alpauna/TritonECU/hardware/scp-rig/README.md

# Phase 0 SCP capture rig

Receive-only J1850 PWM listener for the DLC. **No transmit stage** — the OEM PCM
is live on that bus. See [`../../docs/phase0-rig.md`](../../docs/phase0-rig.md)
for why, and [`../../docs/phase0-capture-protocol.md`](../../docs/phase0-capture-protocol.md)
for what to record.

**Micro: Raspberry Pi Pico (RP2040).** PIO gives deterministic sub-microsecond
edge timing on a ~24 µs bit, it is 3.3 V native so it shares the comparator's
rail with no level shifting, and this repo already runs PIO on an RP2040 in
`hardware/vr-test-rig/firmware`.

**The RX network below is the corrected one** from
[`../../docs/f150-1999-target.md`](../../docs/f150-1999-target.md) §5.3 — not the
upstream reference, which has two known traps (a 10 k : 100 k divider that puts
4.5 V on a 3.6 V input, and a bias resistor returned to 3.3 V instead of ground).
Building the rig with the shipping values means Phase 0 validates the board.

## Schematic

```
  DLC (OBD-II, under dash)                            RASPBERRY PI PICO
  ┌───────────────────────┐                        ┌────────────────────┐
  │ pin 2   SCP+  914 TAN/ORG ──┐                  │                    │
  │ pin 10  SCP−  915 PNK/LT BLU ─┐                │  GP2   RX in       │
  │ pin 4,5 GND ──────────────┐ │ │               │  GP3   loopback    │
  │ pin 16  +12V (variant B)  │ │ │               │  GP0/1 GPS (opt)   │
  └───────────────────────────┼─┼─┼───────────────│  3V3   OUT (pin36) │
                              │ │ │               │  GND               │
                              │ │ │               └────────────────────┘
        SCP+ ────[ R1 100k ]──┼─┼─┴──┬──────────┬─────────► IN+
                              │ │    │          │
                              │ │  [R2 100k]  [D1 MM3Z3V3BW]
                              │ │    │          │
                              │ │   GND        GND
                              │ │
        SCP− ────[ R3 100k ]──┼─┴───────┬──────────┬──────► IN−
                              │         │          │
                              │      [R4 100k]  [D2 MM3Z3V3BW]
                              │         │          │
                              │        GND        GND
                             GND
                                    ┌──────────────────┐
                              IN+ ──┤                  │
                              IN− ──┤    TLV7031       ├── OUT
                              3V3 ──┤  (SOT-23-5)      │
                              GND ──┤                  │
                                    └──────────────────┘
                                             │
              hysteresis  OUT ──[ R5 4.7M ]──┴──► IN+      ≈ ±35 mV

                    OUT ──[ R6 100R ]──┬───────────────────► Pico GP2
                                       │
                                   [D3 SMF3.3]
                                       │
                                      GND

              3V3 ──[ C1 100n ]── GND                 (at the TLV7031)

  BENCH LOOPBACK ONLY — remove before connecting to a vehicle:
        Pico GP3 ──[ R7 1k ]──► the SCP+ node, ahead of R1
        and SCP− ──[ 220k ]──► 3V3     (NOT to GND - see Build order, 2)
```

## Where to connect — DLC, not the 104-pin

The bus is the same net at both ends: EEC-V **pin 16 = SCP+ (914 `TAN/ORG`)** and
**pin 15 = SCP− (915 `PNK/LT BLU`)** are DLC **pins 2 and 10**. Back-probing
C174 would work. **Do not.**

| | DLC | Back-probe at C174 |
|---|---|---|
| Access | designed to be plugged into | behind the kick panel, awkward |
| Ground and 12 V | pins 4/5 and 16, right there | separate wires |
| Terminal risk | none | **a spread terminal causes intermittent faults later** — the worst kind to chase, and you will chase it believing it is your ECU |
| Neighbours | none that matter | **coil and injector drivers**. Pins 78 and 79 are coils 7 and 8 |
| Engine running | fine | coil driver pins carry clamped flyback spikes. Keep probes away from them |

**Both jobs exist and they are different measurements:**

- **Bus capture → the DLC.** It is a bus, not point-to-point, so everything the
  PCM, GEM and cluster say is visible there. Probing at the PCM adds risk and
  shows exactly the same traffic.
- **Pin identification → back-probe at C174.** Which pin sinks the MIL, or
  confirming the TCIL on pin 12 — those are pin-level questions the DLC cannot
  answer. This is the method that already settled pins 12 and 79.

### Check the connector before wiring it

⚠ **Many OBD-II cables and breakouts omit pins 2 and 10.** They are the J1850
PWM pair, and a CAN-era cable has no use for them — cheap ones populate only
4, 5, 6, 14 and 16. A bare connector shell is fine; a moulded cable may simply
not have the terminals. **Check before building anything around it**: continuity
from the pin-2 cavity to its wire, and the same for 10. A missing terminal looks
exactly like a quiet bus.

**Ground: use pin 5, not pin 4.** Pin 5 is *signal* ground and is the correct
reference for a bus measurement; pin 4 is *chassis* ground. If the rig is
powered from pin 16 (variant B), return that current on **pin 4** and keep the
comparator referenced to **pin 5** — otherwise the supply current shares a return
with the signal reference and puts its own drop into what you are measuring.

**Confirm the numbering with a meter before trusting it.** The 16-pin shell is
two rows and the numbering flips depending on which side you are looking at.
Find **+12 V — that is pin 16** — and orient from there. Ten minutes of checking
against an unplugged connector beats debugging a rig that was correct all along.

## Why each part is the value it is

| | | |
|---|--:|---|
| R1–R4 | **100 k : 100 k** | Symmetric 1:1. A 5 V bus HIGH lands at **2.5 V**, inside the TLV7031's V<sub>CC</sub>+0.3 ≈ 3.6 V limit. The reference's 10 k : 100 k puts 4.5 V there **during ordinary reception** |
| R2/R4 return | **to GND** | The reference returns the bias to 3.3 V. Harmless at 10:1, destructive at 1:1 — it pulls half the node |
| D1, D2 | MM3Z3V3BW | 3.3 V clamp, **after** the divider |
| R5 | **4.7 MΩ** | Hysteresis, ≈ ±35 mV against a 2.5 V swing — the bus idles at 0 V differential, so without it the comparator chatters on noise |
| R6 + D3 | 100 Ω + SMF3.3 | Output protection into the Pico |
| Bus loading | **200 kΩ per line** | Genuinely non-invasive — the rig is a voltmeter, not a node |

## Pico pin map

| Pin | Use |
|---|---|
| **GP2** | Comparator output — PIO edge capture |
| **GP3** | Loopback generator. **Set to INPUT whenever connected to a vehicle** |
| GP0 / GP1 | UART0 to the GPS — NMEA in |
| **GP4** | **GPS 1PPS** — the edge that ties GPS time to the capture timebase |
| **GP5** | **GPS ON/OFF** — with a **10 k pull-up to 3V3**. See below |
| **GP6** | **GPS nRESET** — with a **10 k pull-up to 3V3**. See below |
| GP16–19 | SPI0 to the SD card (variant B) |
| GP25 | Onboard LED, frame activity |
| 3V3 (pin 36) | Supplies the TLV7031 |
| GND (pin 38) | **Common with vehicle ground** |

## GPS — use the 1PPS, not the sentence timestamps

**ATGM336H-5NR32** (AT6558R) fits without an adapter: 2.7–3.6 V so it runs off
the Pico's 3V3, NMEA 0183 over UART, <26 mA at 3.3 V, TCXO, built-in LNA and SAW,
and — the part that matters — **1PPS with the rising edge aligned to UTC**
(§1.7).

### Why PPS rather than the NMEA timestamp

An NMEA sentence *describes* a fix that was taken at the second boundary, but it
**arrives late and by a variable amount** — the sentence has to be composed and
then clocked out of a UART. At 9600 baud a burst of sentences takes tens of
milliseconds, and the delay changes with how many satellites are in view.

Timestamping the *sentence arrival* therefore aligns GPS to the capture with an
error of tens to hundreds of milliseconds. At 45 mph that is **up to 10 m of
position error**, and worse, it is error that varies through the recording.

**PPS inverts the problem.** Capture the PPS rising edge with the *same*
microsecond counter used for bus frames, and let the NMEA sentence say only
*which second that edge was*. The sentence can then arrive whenever it likes.
Alignment goes from ~100 ms to **sub-millisecond**, and the drifting component
disappears.

### Practicalities

| | |
|---|---|
| Wiring | UART on GP0/GP1, **PPS on GP4** — treat PPS as another timestamped event and put it in the same log |
| Cold start | **TTFF 32 s**. Power it up a minute before recording, not as the engine starts |
| Antenna | See below. In a truck, on the dash or against the windscreen — a steel roof is a very good GNSS shield |
| Speed | Take it from RMC/VTG (Doppler-derived), not from differencing positions. 2.5 m CEP50 position does not imply poor speed |
| Rate | 1 Hz is plenty — the capture script marks speeds at held points rather than sweeping |

### Antenna — the module supplies the bias, you do not

**Do not inject 3.3 V into the RF path.** Pin **14 `VCC_RF` is an output**, 3.3 V,
made for exactly this — *"+3.3V，可给天线供电"*. It carries the module's antenna
diagnostics with it:

| | |
|---|--:|
| `VCC_RF` | 3.3 V typ |
| Antenna **short** protection | **50 mA** |
| Antenna **open** detection current | **1 mA** |
| Supported antenna gain | **15–30 dB** |

Feeding an external rail up the coax bypasses the short protection *and* defeats
the open/short detection, which is one of the few things that tells you the
antenna fell off the windscreen.

| Antenna | Wiring |
|---|---|
| **Passive patch** | RF_IN (pin 11) and ground. Leave `VCC_RF` unconnected. The module has its own LNA and SAW, and tracks to −162 dBm |
| **Active** | `VCC_RF` → the antenna side of the RF trace through a bias network (RF choke / ferrite, high-Z at 1.6 GHz), with a DC block ahead of RF_IN if the module does not provide one |

⚠ **Check the gain.** 15–30 dB is the supported window. A 40 dB active antenna
can overload the front end, and under 15 dB may read as *open* to the detector.

> **[CONFIRM]** whether RF_IN is internally DC-blocked, and whether the datasheet's
> later pages carry a reference bias network. Pages 1–9 do not.

### Control pins — ON/OFF is a shutdown input, active low

| Pin | Datasheet | Meaning | Wire it |
|--:|---|---|---|
| 5 `ON/OFF` | *模块关断控制，低电平有效* — shutdown control, **active low** | **LOW = shut down**, HIGH = running | **Tie HIGH**, or drive from a GPIO |
| 9 `nRESET` | *模块复位输入，低电平有效* — reset, active low, *不用时悬空* | LOW = reset | Leave floating — the datasheet says so explicitly |

The name reads like a switch; it is really a shutdown line. **LOW turns it off.**

**Do not float `ON/OFF`.** The datasheet says "leave floating when unused" for
`nRESET` and says **nothing of the kind** for `ON/OFF`, whose electrical column
is blank — so there is no documented internal pull-up to rely on. A floating CMOS
input is the classic works-on-the-bench, fails-in-a-truck fault, and here it
fails as "the GPS stopped logging somewhere on the highway".

#### The resistors set the safe state, not the firmware

**GP5 → ON/OFF with a 10 kΩ pull-up to 3V3. GP6 → nRESET with the same.**

A Pico GPIO comes out of reset as an **input with no pull**, so between power-on
and firmware configuring it, anything driven only by the MCU is floating. Strap
the safe state in copper and let the GPIO override it:

| | Resistor holds | GPIO as input | GPIO output LOW |
|---|---|---|---|
| ON/OFF | **HIGH — module runs** | runs | **shuts down** |
| nRESET | HIGH — not in reset | not in reset | **held in reset** |

The module is then alive from the instant it has power, whether or not the Pico
ever boots, and the GPIOs are pure overrides. This is the same discipline as the
DRV8837's `nSLEEP` being pulled **low** so the SCP bus is released before
firmware runs — a rig that holds a bus down or a GPS off while it boots is a rig
that fails in ways nobody thinks to look for.

Drive them **open-drain**: GPIO as input for the idle state, output-low to
assert. Never drive them high — the pull-up already does that, and it keeps the
lines safe if the Pico is removed.

The pin spend still earns itself, but **not for the reason first written here**
— see VBAT below. A commanded shutdown gives a **hot** start, not a cold one.

V<sub>IH</sub> is 0.7 × V<sub>CC</sub> = **2.31 V** at 3.3 V, so the pull-up
drives it with margin.

### VBAT — tied to 3V3, which forfeits warm starts by design

**As built: VBAT (pin 6) to 3V3 with a 100 nF cap.** In spec — the range is
1.5–3.6 V and it draws **8 µA** — and it is the simple, correct choice. It just
has one consequence worth knowing rather than discovering.

VBAT exists to keep the RTC and the ephemeris SRAM alive **when VCC is gone**,
which is what turns a 32 s cold start into a few-second hot one. Tied to the same
rail as VCC, it dies with it:

| Event | VBAT | Result |
|---|---|---|
| **ON/OFF shutdown** (GP5 low) | still powered | RTC + ephemeris retained → **hot start** |
| **Rig power cycle** | dies with VCC | everything lost → **cold start, 32 s** |

> **Correction to the ON/OFF note above.** Commanding a shutdown on GP5 and
> bringing the module back gives a **hot** start, not a cold one, precisely
> because VBAT survives it. To time a genuine 32 s cold TTFF, power-cycle the
> whole rig. The GPIO is still worth having — it is how you get a *fast*
> reacquisition mid-session without losing the fix.

**Is a backup source worth adding?** Probably not here. The capture protocol
already powers the rig up a minute before recording, and 32 s fits inside that.
For reference if it ever matters:

| Backup | Holds the RTC for |
|---|--:|
| CR2032 (220 mAh) | ~3 years |
| 1 F supercap, 3.3 → 1.5 V | ~62 hours |
| 0.1 F supercap | ~6 hours |

A supercap is the tidy version — no battery to replace, and hours of hot-start
capability covers several runs in one day.

### Antenna selection — three numbers to check

Candidate: **Bingfu vehicle waterproof active GPS antenna, SMA male**
([listing](https://www.amazon.com/Bingfu-Waterproof-Navigation-Connector-Tracking/dp/B07R7RC96G)).
Magnetic vehicle mount and waterproof is the right shape for this. Its being
**SMA male** — centre pin, internal-threaded nut — makes the connector check
below decisive rather than academic: the board side must be **standard SMA
female with a centre socket.**

Three numbers decide whether it works with this module, and none of them were
readable from the listing page:

| Check | Against | Wanted |
|---|---|---|
| **Gain** | module supports **15–30 dB** | ≤ 30 dB. These are sold at 28 dB (fine) and at 38 dB (over the window) |
| **Supply voltage** | `VCC_RF` is **3.3 V** | must accept 3.3 V — many automotive GPS antennas are 5 V-only |
| **Current** | short protection trips at **50 mA** | typically 10–20 mA, but confirm |

### ✅ The SMA connector is standard SMA female — checked

**BWSMA-KWE-Z001**, PCB-end right-angle, 0–6000 MHz. Electrically fine for
1.6 GHz GNSS, and **inspected on the bench: hole in the middle**, i.e. a centre
**socket**. Standard SMA female, which mates with the antenna's SMA male centre
pin. ✔

The datasheet's own wording — *"With External Thread and Internal Pin"* — reads
like RP-SMA female (external thread **plus a centre pin**), which would not have
mated: pin against pin. It was describing the contact being *recessed inside the
body*, not a reversed polarity.

> **Worth keeping as a habit rather than a scare.** Connector gender is the
> cheapest thing to verify and among the more annoying to discover late. Looking
> down the barrel takes two seconds; a mismating pair takes a return and a week.

## Powering it

| Source | Logging | Survives cranking? | Ground |
|---|---|---|---|
| Laptop USB | USB serial | n/a — engine off or idling | laptop ↔ vehicle |
| **Truck USB adapter** | **must be SD** — no host, so no serial | ⚠ **no** | second path to vehicle ground |
| **USB power bank** ⭐ | SD | ✅ **yes** | **single reference, through DLC pin 5 only** |
| DLC pin 16 + buck | SD | with holdup | single, if returned on pin 4 |

**The truck's USB adapter is fine for idle, the RPM sweep and the drive — and
wrong for two of the seven capture steps.** Step 1 is *key off → on* and step 2
is *crank*. Anything fed from vehicle 12 V sags during cranking, and a cheap
adapter will brown the Pico out at precisely the moment being recorded. If the
socket is switched rather than always-hot, step 1 cannot be captured at all.

**A USB power bank solves it outright**, and it is the cheapest answer:

- Immune to cranking sag, so the crank frames actually get recorded.
- No second path to vehicle ground — the rig then references the bus **only**
  through DLC pin 5, which is what the comparator wants.
- No mains-adjacent noise from a cheap switching adapter riding on the same 12 V
  the bus lives on.

**Also note: powering from a charger means no USB host, so there is no serial
log.** SD becomes mandatory the moment the laptop goes away. That is variant B's
logging with variant A's simplicity.

Whatever the source, put **bulk plus ceramic decoupling at the Pico** — a few
hundred µF and 100 nF. The rig is a measuring instrument sharing a vehicle with
injectors and coils.

## Logging to SD — yes, and throughput is not the problem

A decoded frame is small, so the card is never the bottleneck:

| Record | Rate at 500 frames/s | 10 min | 1 hour |
|---|--:|--:|--:|
| **Binary**, 8 B µs-timestamp + len + flags + 12 B payload = **22 B** | **10.7 KB/s** | 6.6 MB | 40 MB |
| CSV, ~60 B/line | 29 KB/s | 18 MB | 108 MB |

An SD card over SPI sustains hundreds of KB/s at worst, so there is roughly
**27× headroom**. Log **binary and convert offline** — a four-hour session is
158 MB, and CSV costs 3× that for nothing the converter cannot give back.

### The real risk is stall latency, not bandwidth

Cheap cards pause **100–250 ms** for internal housekeeping — wear levelling, block
erase — and during that pause the writer blocks. Without somewhere to put frames,
they are simply lost, and a dropped frame in the middle of a MIL transition is
the one you needed.

**Fix it with RAM, which the Pico has plenty of** (264 KB). Built and tested —
[`firmware/include/FrameRing.h`](firmware/include/FrameRing.h):

| | |
|---|--:|
| Frames arriving in a 250 ms stall, busy bus | **125** |
| Ring as built, 2048 slots × 24 B | **48 KB** |
| **Occupancy at that worst stall** | **6.1 %** |

The measured number is ~16× smaller than the earlier estimate, which had assumed
a longer stall. The margin stays anyway: it is nearly free on 264 KB, a tired
card can stall longer than its datasheet says, and a bursty bus can exceed 500
frames/s briefly.

Capture writes into the ring from the PIO side; a second loop drains it to the
card. **Count and log ring overflows** — a capture that silently dropped frames
is worse than no capture, because nothing tells you the gap is there. `highWater()`
reports the deepest it ever got, so the sizing is a measurement after the first
session rather than an article of faith.

### Four things that bite on a vehicle

- **Flush on a timer, not just on close.** The key gets cut, the plug gets
  pulled. Sync every second — 10 KB at this rate — and preallocate the file so
  FAT metadata is not being rewritten constantly.
- **DLC pin 16 is permanent 12 V**, unswitched. The rig runs whenever it is
  plugged in. Add a switch, or accept a flat battery.
- **That 12 V is vehicle 12 V**, with everything that implies — so the buck needs
  the same input protection as anything else on this truck: reverse-polarity
  diode and a TVS that stands off above 16 V and clamps below the buck's rating.
  See [`../../docs/harness-protection.md`](../../docs/harness-protection.md).
- **Log GPS time as well as the µs counter.** The µs timer restarts every boot,
  so a multi-session capture has no common timebase without it — and the GPS
  fix is what ties road speed to the frames.

### File naming

One file per session, rotated at a size that stays manageable, named from GPS
date/time when a fix is available and a boot counter when it is not. A directory
of `capture_0007.bin` with no timestamps is a capture you will not be able to
put back in order later.

## Reading the console

Use the helper, not `cat`:

```bash
./tools/read-rig.py            # follow
./tools/read-rig.py -s 20      # 20 seconds and stop
```

`cat /dev/ttyACM0` prints **nothing from a perfectly healthy rig**. The
arduino-pico USB-CDC stack throws away writes until the host asserts DTR, and
`cat` never asserts it. `stty` is worse: it can bounce DTR and reset the board
mid-read. Both look exactly like dead firmware.

The rig prints a report every 5 s *unconditionally*, with no bus activity
required. So if the helper shows nothing, the fault is in `setup()` — not in the
signal you are trying to capture.

## Build order

1. **Assemble RX only.** Confirm with a meter: 2.5 V at IN+ when SCP+ is held at
   5 V on the bench, and that both clamps are the right way round.
2. **Loopback.** Fit R7, tie **SCP− to 3V3 through 220 k**, generate PWM
   patterns on GP3, decode on GP2. *If the decoder cannot read a frame it just
   generated, it will not read the truck.*

   **Not SCP− to GND — that latches the comparator.** Found on the bench
   2026-10-07: one edge, then GP2 stuck at 3.3 V. With the Bus− divider grounded
   IN− is 0 V, and `R5`'s ±35 mV of hysteresis puts the *falling* threshold at
   IN+ < −35 mV — which GP3, swinging IN+ from 0 to 1.64 V, can never reach. The
   first pulse switches the output high and it stays there. The earlier
   8.000/16.000 µs validation jumpered GP3 straight to GP2, so it never went
   through the comparator and could not have caught this.

   220 k sets IN− = 3.3 × 100k / 420k = **0.79 V**, near the middle of the
   0–1.64 V swing: both thresholds clear by ~0.75 V. **The middle matters, not
   just "above zero":** the 1.15 µs front-end RC delays every edge, and only a
   crossing near 50 % delays rising and falling edges equally (RC·ln 2 each) so
   the delays cancel out of a pulse width. An off-centre reference would read
   the 8 µs pulses long or short.

   **Measured with 220 k, 2026-10-07 — PASS.** 2.9 M edges through the
   comparator, clusters balanced to 0.06 %:

   | | expected | measured | error | span |
   |---|---|---|---|---|
   | high | 8.000 µs | **8.058 µs** | +58 ns | 7.625–8.375 µs |
   | low | 16.000 µs | **15.877 µs** | −123 ns | 15.500–16.250 µs |

   8 FIFO overruns in 2.9 M edges (~3 ppm) under the loopback's continuous
   83 k edges/s — far denser than a real bus.

   **The ~90 ns bias is the reference sitting 34 mV under mid-swing**, and the
   model predicts it: with ±35 mV of hysteresis, 0.786 V puts the rising
   crossing at 50.0 % of the swing and the falling one at 45.8 %, which
   through the 1.15 µs RC delays the falling edge ~100 ns more — highs read
   long. Irrelevant to decoding (an 8-vs-16 µs decision with ~4 µs of margin);
   **a known offset for Phase 0 measurements**, so subtract it or use the
   alternative: **200 k sets IN− = 0.825 V, on the midpoint**, predicted within
   a count of 8.000/16.000. Kept at 220 k for the bench as good enough; 200 k
   is the value for the next board revision's `H1` reference.

   *On the truck none of this arises:* the bus idles with Bus− high and Bus+
   low, a large negative differential, so the output falls cleanly.
3. **Remove R7, the `H3` strap and the 220 k. Flash the vehicle image** —
   `pio run -t upload`, the default, which leaves GP3 an input. **Read the rig
   before the DLC:** every report must say `mode=VEHICLE   GP3 input`. The
   loopback image (`-e pico_loopback`) says `mode=LOOPBACK  GP3 DRIVING` and must
   never reach a vehicle. Then plug into the 2003.
4. Capture per [`phase0-capture-protocol.md`](../../docs/phase0-capture-protocol.md).

## BOM

| Ref | Part |
|---|---|
| U1 | Raspberry Pi Pico (RP2040) |
| U2 | TLV7031 comparator, SOT-23-5 — **check the pinout against the datasheet; this drawing labels by function** |
| R1–R4 | 100 kΩ 1 % |
| R5 | 4.7 MΩ |
| R6 | 100 Ω |
| R7 | 1 kΩ — bench only |
| D1, D2 | MM3Z3V3BW |
| D3 | SMF3.3 |
| C1 | 100 nF |
| J1 | OBD-II male connector or breakout — **verify pins 2 and 10 are populated**, see below |
| opt. | **ATGM336H-5NR32** GNSS module (AT6558R) — 2.7–3.6 V, UART NMEA 0183, **1PPS**, <26 mA at 3.3 V |
| opt. | microSD breakout |
| R8, R9 | 10 kΩ — pull-ups on GPS ON/OFF and nRESET |
