alpauna/TritonECU/hardware/fan-controller/README.md

# Enclosure fan controller — ATtiny

A thermostat for the [PSU enclosure](../psu-enclosure) fan. Sensor on the board
on a thermally isolated tongue, setpoint on a pot, and an OLED on a tail showing
the exhaust temperature.

**v1 closed out 2026-10-01** — built, flashed, fused (BOD level 7, 4.2 V typ.) and verified
on the bench: OLED, wake button, setpoint pot, fan switching, and the one- and
two-flash heartbeats all behave as specified. Two items stand before any
re-order: open the M2 holes, and the `Status` LED needs its series resistor
off-board (both under [As built](#as-built)). Next is [v2](#v2--3--and-4-wire-intel-fans).

`Schematic/` carries the EasyEDA schematic,
gerbers and BOM as fabricated: **54.86 × 16.13 mm**, 3 × M2. See
[As built](#as-built) for what differs from the sketch and why. Replaces the ESP32 bench rig in
[`../psu-enclosure/fan-controller`](../psu-enclosure/fan-controller), which
proved the control law and the driver but wants a whole dev board and a USB
cable to do it.

## Schematic

Logic runs on **5 V**, fed in on `H2`. The fan's 12 V never touches this board —
`Q1` only switches its low side out through `H1`.

```
   +5V o--+--[C2 10u]--[C1 100n]--+-- U1 VDD (ATTINY1614-SSN, SOIC-14)
          |                       |
       [R6 6k8]           [R3 NTC 10k B3950]      <- on the isolated tongue
          |                       |
        o 3 RV1 10k               +-- PA3  (pin 13)
        o 1 --+-- PA4 (pin 2)     |
        o 2 --+              [R4 10k 1%]
              |                   |
          [R7 20k]               GND
              |
             GND

   PA7 (pin 5) --[R1 220R]--+-- gate  Q1 AO3400A
                            |
                         [R2 10k]  PULL-UP, not pulldown - see As built
                            |
                           +5V

   H1  1 Load (drain)   2 Flyback   3 GND      D1 1N4148W: drain -> Flyback pin
   H2  GND  +5V  Status(PA6)  Wake(PA2)  UPDI(PA0)  SCL(PB0)  SDA(PB1)
```

`PA5`, `PA1`, `PB2`, `PB3` are deliberately unconnected. `PA5` is the one worth
keeping free — a fan tach input if a 3-wire fan is ever fitted.

### The flyback is opt-in, which is the right call

`D1` is fitted, but its cathode lands on `H1` pin 2 rather than on a supply. Wire
that pin to +12 V and the diode sits across the fan; leave it and it does nothing.

For this fan it does nothing worth having. A 2-wire brushless fan commutates its
windings internally behind its own input capacitor, so switching the supply does
not break inductive current the way a relay coil does. What is left is roughly
0.5 µH of lead inductance at 100 mA — about **2.5 nJ** — turned off over
microseconds by `R1`, into a 30 V part on a 12 V rail. Connect pin 2 if the load
ever becomes a relay, a solenoid or a brushed motor.

## The FET

`Q1` is an **AO3400A**: 30 V, 5.7 A, `Rds(on)` ~30 mΩ specified down to 2.5 V.
At 100 mA it drops 3 mV.

**Do not substitute a 2N7002.** It characterises `Rds(on)` at 10 V and 5 V and
**nothing below**, and `Id` falls from 115 mA to 75 mA at 100 °C — against a
~100 mA fan, in a box that is hot precisely when the fan is needed. `L2N7002LT1G`
is the same part; the leading `L` is Leshan Radio, the manufacturer, not a
logic-level suffix. See [`../2N7002 Driver`](../2N7002%20Driver/README.md).

## As built

The fabricated board differs from the sketch above it in three ways. Two are
improvements; one is a fault.

### ✅ R2 is a pull-up, and the board says why

`R2` 10 kΩ runs from the gate to **+5 V**, so a floating `PA7` — during reset,
during boot, after a watchdog trip — pulls the gate *high* and **runs the fan**.

V1.0 had it to GND, which is the same part in the same place doing the exact
opposite thing, and it would have passed any check that only asked whether a
10 k gate resistor was fitted. The schematic now carries the reason next to the
part:

> *Pull up not pull down — fan runs if something wrong*

That note is worth more than the fix. A pulldown is what a gate resistor
normally is, so without it written down this gets "corrected" back the next time
someone tidies the sheet.

The watchdog is part of the same chain: a hung MCU resets, reset floats `PA7`,
and the pull-up runs the fan.

### ⚠ The M2 mounting holes are 2.00 mm — open them before ordering

EasyEDA's stock `Screw-Hole-M2` footprint drills **2.00 mm**, and an M2 screw
will not pass it:

```
M2 major diameter      1.98 mm
2.00 drill, plated     finishes ~1.90
ISO 273 clearance      2.2 close / 2.4 normal
```

Read 2.00 as the finished size instead and it is 0.02 mm on a 1.98 screw — an
interference fit rather than a clearance hole.

**Open to 2.2 minimum before the order goes out.** Five boards is fifteen holes
to drill by hand otherwise, in a part that is 54 mm long and awkward to clamp.
The [SCP rig](../scp-rig/SCP-schematic-review.md) has the same footprint and the
same problem.

### ⚠ `Status` has no series resistor

`PA6` goes raw to `H2` pin 3 and there is no pad for one. An LED straight onto it
kills the pin or the LED. Put it in the tail or the LED module, and note it on
the silkscreen.

**v2 fixes this: `R12` 1 k sits between `PA6` and `H2` pin 3.**

**The LED is active-low: +5 V → resistor → LED → `Status`.** That is how both
built boards are wired, and the firmware sinks it. Through reset the pin floats,
so the LED is dark rather than lit.

### ✅ No LDO — and that is better

The board takes 5 V in rather than regulating 12 V down. The LDO would have been
the largest heat source on a board whose entire problem is self-heating beside
its own sensor, so removing it helps rather than hurts. The enclosure already has a fixed 5 V rail.

### ✅ AO3400A rather than the SS8050

An SS8050 NPN was the earlier plan, because a BJT is current-driven and the
gate-threshold question disappears. But that was the better answer to a *3.3 V
gate*, not the better part: the BJT needs continuous base current and drops
~0.15 V where the AO3400A drops 0.003 V. `R1` is now a gate resistor rather than
base drive, which is fine — it damps the edge and nothing here switches fast.

### ✅ The thermal tongue is real

Verified in the gerbers rather than assumed:

```
slot 1   x 18.50..19.16   y 0.40..4.54     0.66 x 4.14 mm
tongue         1.64 mm wide, NTC 0805 at x 19.94, y 1.29 / 3.29
slot 2   x 20.80..21.46   y 0.40..4.54
```

Nothing else sits on it — the next components are at y ≥ 6.1, past the slot ends.

One floor that no isolation removes: the NTC dissipates about **0.6 mW**, which
on an 0805 is 0.15–0.3 °C of self-heating. That is inside the thermistor's own
tolerance and not worth chasing, but it is the accuracy limit.

## The sensor is on the board, which decides two things

**The board lives in the exhaust, at END B.** The sensor's position *is* the
board's position. Intake air is room air and says nothing about the supply;
this has to sit where air has already crossed the heatsink.

**The board's own heat biases its own sensor.** An LDO dropping 7 V plus a
transistor plus an MCU is 50–70 mW on a small board, which is several °C of
local rise measured by the part whose job is measuring °C. Two answers, and the
second matters more than the first:

- **A routed thermal slot**, most of the way around `R1`, leaving a narrow neck.
  Free at fab, and it cuts the conduction path so the sensor sees air rather
  than copper. Put `U1` and `Q1` at the far end of the board from it.
- **No regulator.** The as-built board takes 5 V in, which removes what would
  have been the largest standing heat source of the lot.

> **The MCU does not sleep.** Sleeping between readings was the original plan,
> to cut self-heating further. The firmware waits awake instead (~10–15 mW at
> 5 MHz), at the far end of the board from the tongue. For an on/off enclosure
> fan with 6 °C of hysteresis that error does not matter, and in use it has not
> been a problem. Revisit only if this board ever has to measure rather than
> switch.

## Why an NTC and not a DHT22 or a DS18B20

Because **the ATtiny never needs to know what a degree is.** A bang-bang
thermostat only has to know which side of a line it is on, so the thresholds
live in ADC counts and the Beta equation is done here, once, at design time:

| T (°C) | R_ntc | ADC (10-bit) |
|---|---|---|
| 30 | 8037 | 567 |
| **32** | 7379 | **589** ← OFF |
| 35 | 6506 | 620 |
| **38** | 5749 | **650** ← ON |
| 50 | 3588 | 753 |

61 counts of hysteresis, and 10.1 counts/°C — one LSB is 0.10 °C, far finer
than the sensor is accurate. No float, no `log()`, no lookup table: two integer
comparisons on an 8-bit part.

**It is ratiometric, and that is not an accident.** The divider is fed from VCC
and the ADC references VCC, so a sagging rail moves both ends and cancels
exactly. Use VCC as the reference, **not** the internal 1.1 V bandgap — against
a bandgap, every millivolt of rail droop becomes a temperature error.

A 10 k 0805 NTC is about two cents, has almost no thermal mass, and needs no
2 s conversion floor like the DHT22.

## The display pushes the part up, and sits somewhere else

**The sensor wants the exhaust; the display wants your eye line.** Those are not
the same place. The board stays at END B with `R1` in the airstream, and the
OLED goes on a **4-wire I2C tail** to the front panel next to the DC-DC's
screen. 200 mm at 100 kHz is untroubled.

That split is not just ergonomics. At ~15 mA the OLED dissipates more than
everything else on this board combined, and sat next to the thermistor it would
undo the thermal tongue. On a tail, its heat goes to the panel.

**2 KB is not enough for a display.** An ATtiny202 has 2 KB of flash and any
SSD1306 driver with a font spends most of it before your code exists. So the
display forces the part up to an **ATtiny1614** — 16 KB, 2 KB RAM, same UPDI
toolchain, SOIC-14. Without a display the 202 is the right part and this BOM
would not need changing.

> Keeping the 202 is possible if the display is a **TM1637 4-digit** module
> instead: two wires, no font, a driver in a few hundred bytes. Less pleasant to
> read, much smaller to drive.

### The display converts. The control law does not.

Thresholds stay in raw ADC counts. Only the display turns counts into degrees,
through a 16-entry LUT at 5 °C spacing with integer interpolation:

```
  0 C -> 234      35 C -> 620      70 C -> 870
```

**32 bytes of flash, 0.09 °C worst-case interpolation error** — an order of
magnitude below what the thermistor is accurate to, and still no float and no
`log()`. Keeping the conversion on the display side means a presentation bug
cannot reach the thermostat.

### Blank it

The display times out after a few minutes and wakes on the button. An OLED left
showing a static number burns its pixels in, and an always-on 15 mA is 75 mW
that has to leave the box somehow.

## Setpoint pot — compared against the sensor, not converted

`RV1` on PA4 sets the trip temperature. **It is not mapped into degrees and it
is not calibrated.** The pot is simply another divider on the same ADC against
the same reference, so the firmware compares the two readings directly and the
fan trips wherever they cross:

```
    ntc >= pot          -> fan on
    ntc <= pot - HYST   -> fan off
```

No conversion, no constants, no LUT anywhere in the control path. And the
comparison is immune to the supply in a way a mapped setpoint would not be:
**both** dividers are ratiometric off VCC, so a sagging rail moves the sensor
and the setpoint together and the crossing does not shift.

### Wire it as a rheostat, and mind which end the wiper goes to

Specified part: **ALPS RK09K11300DR** — 9 mm vertical, 10 kΩ, taper `1B`
(linear), 280° travel, 3 × Ø1 mm pins on a 10.6 × 7 pattern.

```
   +5V --[R8 6k8]--o 3
                     RV1 10k        terminal 2 is the WIPER (datasheet p.315)
                   o 1 --+-- PA4    tie it to terminal 1, the ADC side
                   o 2 --+
                         |
        GND --[R9 20k]---+
```

Span is **556–763 counts, about 29–51 °C**, and clockwise **raises** the
setpoint. That falls out of feeding R8 into terminal 3 rather than 1: ALPS
increase R(1→2) clockwise, so R(3→2) *decreases* clockwise, the node rises, and
the knob reads the way a knob should.

### ±20 %, and why it does not matter

The pot is ±20 %, so the bottom of the span moves — 26.4 °C on a +20 % part,
31.9 °C on a −20 % one. The **top does not move at all**: at 0 Ω the pot
contributes nothing to the divider, so 51.4 °C is tolerance-free.

**For setting it, this is irrelevant.** You turn the knob watching the display,
not reading the dial — which is the dividend from putting the setpoint through
the same LUT as the measurement. A ±20 % part just shifts where in the travel a
given temperature lands.

It matters in exactly one place: the fault window has to clear 527, not 556.

**A rheostat beats a 3-terminal divider here, and the reason is the failure
mode.** If the wiper contact goes open, the track is still intact, so the
resistance goes to full scale and the node lands at 556 counts — the lowest
setpoint, fan earliest. It degrades *toward cooling by construction*, with
nothing to detect and no firmware involved. A 3-terminal pot would leave the
node floating and the reading anyone's guess.

**Tie the wiper to terminal 3, the ADC side.** On terminal 1 an open wiper
disconnects the node from the supply, it is pulled to ground through R9, reads
0 counts, and is caught by the fault window as a fallback to the compiled
default. Safe — but by detection rather than by construction, which is weaker.

It also spends the whole knob on settings worth having. A divider across the
same resistors would have reached 62 °C, and a third of the travel would have
been setpoints nobody would choose for this box.

**R8 and R9 still earn their place**, because the wiring cannot catch a broken
*lead*: R8 open pulls the node to ground, R9 open pulls it to the rail, and a
missing pot leaves it grounded through R9. All three land near 0 or 1023, so the
window sits at **450–850** — wide enough for a +20 % pot at full travel, and
still nowhere near a real fault. On that fault the firmware falls back to the compiled default rather
than to fan-on — a known-good threshold beats a fan that runs forever — and the
display flags that the pot is being ignored.

### One pot, not two

There is deliberately no second pot for the release point.

**Two independent pots can be set to a state that cannot work** — nothing stops
OFF being placed above ON, and a quarter turn gives you a fan that trips and
immediately releases, or never releases at all.

**And the hysteresis width is a property of the plant, not a preference.** The
thing being controlled is a box of air with a long time constant; a narrow band
only cycles the fan without moving the average temperature. A knob for it is a
control whose sole available use is to make the system worse. It stays fixed at
61 counts, which rides across the range as:

| setpoint | releases at | band |
|---|---|---|
| 30 °C | 24.5 | 5.5 |
| 38 °C | 32.0 | 6.0 |
| 45 °C | 38.3 | 6.7 |
| 60 °C | 50.7 | 9.3 |

A fixed count band widens in degrees as it gets hotter, because the NTC's
counts-per-degree falls. That is the right direction to drift: a higher setpoint
means a hotter box, where you want the fan to run on longer rather than trip
in and out.

**PA5 stays free** — a tach input if a 3-wire fan is ever fitted.

## Fail-safe

Same reasoning as the ESP32 version: this box's airflow depends entirely on this
fan and it holds a warm supply and a mains connection, so *off* is the expensive
way to be wrong.

- `R2` pulls the gate high, so a floating pin runs the fan — covering reset,
  boot, and a watchdog trip
- Boot drives the fan on before anything else, and exercises it for 3 s
- **An open NTC is the dangerous fault and is caught explicitly.** Open the top
  leg and the divider reads ~0 counts, which looks like *very cold* and would
  switch the fan off forever. A short reads ~1023, which looks like very hot and
  fails safe by luck. Only the first one needs catching, and it is.
- Brown-out at **BODLEVEL7: 4.2 V typical, 3.9–4.5 V across parts** (datasheet
  Table 36-10; PlatformIO calls the setting `4.3v`). A sagging rail stops the
  part rather than letting it run the comparison on a bad conversion. The
  4.5 V worst case still leaves 0.25 V under a 5 V rail at −5 %. Fuse byte
  `BODCFG = 0xF4`: level 7, enabled in active mode, **disabled in sleep** —
  which costs nothing, since the firmware never sleeps

What this still **cannot** cover is losing 12 V while the supply runs hot. That
wants a **KSD9700 60 °C normally-open** across `Q1`, which closes when hot
whatever the firmware is doing, including when it is unpowered.

## Silkscreen

**Back — the explanation.** Too long for the front of a 54.86 × 16.13 mm board,
and nothing here is needed while you are wiring:

- **Setpoint range `32–51 °C`**, and it is deliberately *not* the nominal 29–51.
  The top end cannot move — at 0 Ω the pot contributes nothing to the divider —
  but a **−20 % pot bottoms out at 31.9 °C**. Print 29 and one day a board that
  will not turn down that far gets diagnosed as faulty. 32 is true for every
  part that can be fitted.
- **`CW = HOTTER`**, which falls out of R6 feeding pot terminal 3 rather than 1
  and cannot be inferred by looking at the board.
- The pull-up note, mirroring the schematic: *pull up not pull down, fan runs if
  something wrong*.

**Front — what you need with your hands on the connector.** The back is
unreadable once the board is mounted face-up:

```
H1   1 LOAD   2 FLYBACK   3 GND
H2   GND  5V  STATUS  WAKE  UPDI  SCL  SDA
```

`H1` puts a live drain on pin 1 and ground on pin 3. The unlabelled two-pin
headers on [`../2N7002 Driver`](../2N7002%20Driver/README.md) are exactly what
produced a reversed In/GND that took an hour to find, on a board with no 12 V
anywhere near it. This one has.

## The 5 V rail is an interlock — if you wire it that way

The case firmware cannot cover is losing the MCU's power while the supply keeps
running hot. In this enclosure that case can be designed out instead of guarded
against, because **the same 5 V that runs this board can be the 5 V that holds
the 36 V supply on**:

```
mains ─► 5V always-on module ─► latch ─► relay coil ─► mains ─► 36 V PSU
                │                                                   │
                └──────────► THIS BOARD                      DC-DC ─► fixed 5V
```

Lose that rail and the relay drops, the supply dies, and there is nothing left
to cool. No thermal switch required.

**It only works under two conditions, and both are easy to get wrong.**

**1. An ordinary relay, not a bistable latching one.** See the table in
[`../latching-relay`](../latching-relay/README.md#or-use-an-ordinary-5-v-relay):
a latching relay's off position is *stable*, which is its whole appeal — zero
holding current — and it means a 5 V loss leaves the contacts exactly where they
were, with the supply still running. The fail-safe-off behaviour is free on an
ordinary relay and absent on a latching one. **Populating the latching version
silently removes this interlock**, and nothing in that folder currently says so.

**2. This board fed from the ALWAYS-ON module, not the DC-DC's 5 V.** The DC-DC
is fed *from* the 36 V, so its rail can fail while the always-on module keeps
the relay held and the supply running. Feeding this board from the rail that
holds the relay is what ties the two together; feeding it from the DC-DC leaves
the hole open and looks identical on the bench.

**Fit the KSD9700 if either condition is not met** — and fit it anyway if you
want cover for a failed-open `Q1` or a gate stuck low, which no rail interlock
reaches.

## v2 — 3- and 4-wire Intel fans

**Re-laid out and reviewed 2026-10-02 with the ATtiny1616-MNR and serial —
ready to order, not yet built.** Schematic checked pin for pin (`U2`, exposed
pad to GND with four vias into the pour); `H3` pins 8/9 reach `R13`/`R14`. See
[The MCU is an ATtiny1616](#the-mcu-is-an-attiny1616-vqfn-20) and
[`Schematic/ATTINY1616-MNR-Datasheet.pdf`](Schematic/ATTINY1616-MNR-Datasheet.pdf).

`Schematic/` carries the V2 schematic, gerbers
(`FanTempController-Gerber-V2.zip`) and BOM (`FanTempController-BOM-V2.csv`):
**56.26 × 20.45 mm**, 3 × M2 at **2.20 mm** (the v1 hole fixed). Checked on
the copper, not just the symbol: `CN2` pad 1 reaches `Q1`'s drain (Load), pad 2
reaches `H1` pin 2 (FAN+), pad 3 `R8`/`R9`, pad 4 `Q2`'s drain. Both fan-current
paths — `H1`→`CN2` FAN+ and `CN2`→`Q1` Load — are **1.0 mm**, ~2.5 A at a
10 °C rise on 1 oz; the return is the ground pour. The v2 firmware has still
never run on hardware.

The changes are larger than "add a PWM pin".

### The MCU is an ATtiny1616, VQFN-20

**Decided 2026-10-02:** cheaper and smaller than the 1614 in SOIC-14, and the
same part as far as anything here can tell. Same 16 KB / 2 KB, same
peripherals, and the datasheet's Table 5-1 gives **every pin the same
functions** and TCD0 still runs `millis()`. The `attiny1614_v2` environment
builds for `board = ATtiny1616`.

**Its spare pins bought a serial port (2026-10-02).** The PWM moves from PB2
to **PB5**, TCA0 WO2's *alternate* pin (`PORTMUX.CTRLC` bit `TCA02`; the
datasheet confirms it works in the normal 16-bit mode — only `TCA03`–`05` are
split-mode only). That hands USART0 its default pins, **TX on PB2 and RX on
PB3**, with no remapping. See [Serial status](#serial-status).

Pin numbers, v1 against v2:

| signal | port | SOIC-14 (v1) | **VQFN-20** |
|---|---|--:|--:|
| VDD | — | 1 | **4** |
| GND | — | 14 | **3** + exposed pad |
| Wake | PA2 | 12 | **1** |
| NTC | PA3 | 13 | **2** |
| Setpoint | PA4 | 2 | **5** |
| Tach | PA5 | 3 | **6** |
| Status | PA6 | 4 | **7** |
| Fan gate | PA7 | 5 | **8** |
| PWM | PB2 → **PB5** | 7 | **9** |
| Serial TX | PB2 | — | **12** |
| Serial RX | PB3 | — | **11** |
| SDA | PB1 | 8 | **13** |
| SCL | PB0 | 9 | **14** |
| UPDI | PA0 | 10 | **19** |

Unused on VQFN-20: PA1 (20), PB4 (10), PC0–PC3 (15–18).

**The exposed pad goes to GND.** The datasheet's package drawing shows a
1.7 mm pad but does not say where to connect it; ground is the standard
practice for these Microchip QFNs, and it is also the pad that anchors a 3 mm
part mechanically. Give it vias into the pour. The V2 sheet ties it (`U2`
pin 21) to GND.

**Hand assembly is the cost.** 0.4 mm pitch with no visible leads wants a
stencil and hot air, or fab assembly — the SOIC-14 could be done with an iron.
The thermal tongue is unaffected: the MCU sits at the far end of the board
either way.

### Q1 stops being the control element

A 3- or 4-wire fan keeps **+12 V and GND connected permanently**; its own
controller does the speed control. Switching the ground — which is all v1 does —
kills that controller and garbages the tach every time it opens. So `Q1` demotes
from *the* control to a **hard off**, held on whenever a 3/4-wire fan is fitted.

That is a topology change, not an addition, and it is why this is v2.

### The PWM output must be OPEN DRAIN — a second AO3400A

The fan pulls its PWM line up internally, to **3.3 V or 5 V depending on the
fan**, and Intel caps it at **5.25 V**. Drive it push-pull from a 5 V part and a
3.3 V-pull-up fan gets back-fed. The spec says open drain, so the MCU sinks the
line through a small N-FET and never sources it — the high level is always the
fan's own pull-up, inside its own rating by definition. **No pull-up on this
board's side**, ever.

**`Q2` is an AO3400A, the same part as `Q1`** — decided 2026-10-01, one part on
the BOM instead of two. A 2N7002 would have done this job (it sinks a few
milliamps, well inside the region its datasheet characterises), but nothing
about the job needs it:

| | need | AO3400A |
|---|---|---|
| `Vds` | ~13 V when the fan ground floats | 30 V |
| `Vgs(th)` | on from a 5 V pin | 0.65–1.45 V |
| gate charge at 25 kHz | edges ≪ 40 µs period | ~630 pF `Ciss`; 0.14 µs behind 220 Ω |

**It wants a 220 Ω gate resistor (`R10`), like `R1`.** `Ciss` is ~12× a 2N7002's, and
charging it straight from the pin is a current spike every edge, 50 000 times a
second. 220 Ω holds the peak to ~23 mA and still switches in a fraction of a
microsecond.

### `analogWrite()` cannot produce 25 kHz

Intel wants **25 kHz**, 21–28 acceptable. `analogWrite()` uses `PER = 255`:

| f_cpu | PER=255 | PER=199 |
|---|---|---|
| 5 MHz | 19.53 kHz ✗ | **25.000 kHz ✓** |
| 10 MHz | 39.06 kHz ✗ | 50.00 kHz ✗ |
| 20 MHz | 78.13 kHz ✗ | 100.0 kHz ✗ |

8-bit `analogWrite` misses the window at **every** clock — 255 is outside the
usable `PER` range each time:

| f_cpu | usable PER | `analogWrite` |
|---|---|---|
| 5 MHz | 177–237 | 255 ✗ |
| 10 MHz | 356–475 | 255 ✗ |
| 20 MHz | 713–951 | 255 ✗ |

`TCA0.PER = 199` at the existing 5 MHz gives exactly 25.000 kHz with 200 duty
steps — far more resolution than a thermostat can use, and no clock change.

**And no crystal.** The 21–28 kHz window is **±14 % wide**; the ATtiny's
internal oscillator is **±4 % worst case** over 0–70 °C (±2 % relative to its
factory-stored value; datasheet Table 36-12). That puts 25 kHz at
24.0–26.0 kHz, comfortably inside. Worth writing down before someone adds a crystal footprint
"to be safe" to a board with no room for one.

### The spec's fail-safe is already this project's

Intel requires that a fan with **its PWM line undriven runs at full speed**. So
an open-drain buffer that fails open gives 100 % fan, which is the same
behaviour the whole v1 design was built around — and strictly better than the
low-side switch, where the equivalent failure *stops* the fan.

### Tach turns the boot self-test into continuous monitoring

`PA5` was left free for this. Open collector, **2 pulses per revolution**, rated
to 5.25 V so it pulls up to 5 V and feeds a 5 V ATtiny directly. `RPM = pulses/s
× 30`.

v1 exercises the fan for 3 s at boot because *"a controller that has never
proven the fan turns is one that finds out about a seized bearing during the
event it was installed to prevent."* Tach makes that check continuous: commanded
to run and reporting 0 RPM **is** a seized bearing, and the controller can say so
rather than waiting for the temperature to climb.

### Control law: one step per degree, from setpoint to full speed

**Decided 2026-10-01.** v1 is on/off around the setpoint. v2 keeps the same
on and off points and fills the band above the setpoint with speed:

```
  counts  <= setpoint - HYST          Q1 off            fan stopped
  setpoint - HYST .. setpoint         hold last state   (v1's hysteresis, unchanged)
  >= setpoint                         Q1 on, 30 % duty  floor
  each STEP counts above setpoint     +10 % duty
  >= setpoint + 7 x STEP              100 %
```

Eight levels, 30 % to 100 % in 10 % steps. With `STEP = 10` counts that is
**about one step per °C, reaching full speed ~7 °C above the setpoint**.

| | value | why |
|---|---|---|
| `STEP` | 10 counts | ~1.0 °C at 38 °C, ~1.2 °C at 50 °C — the NTC's counts per degree fall as it warms |
| floor | 30 % (`CMP = 60` of `PER = 199`) | most fans will not start below 20–30 %; below it behaviour is undefined |
| per-step hysteresis | 4 counts (~0.4 °C) | step **up** at a boundary, step **down** only 4 counts below it |
| off point | `setpoint - HYST`, 61 counts | v1's band, unchanged — below the floor the fan stops via `Q1`, not 0 % duty |
| kick | 100 % for 300 ms | on every stopped → running transition, then drop to the computed step |

**Still counts, not degrees.** "A degree" is ~10 counts across the pot's
range rather than an exact °C, which keeps the rule that the control law never
touches the display's LUT. A step of 1.0–1.2 °C is well inside what an
enclosure fan cares about.

**Why per-step hysteresis.** ADC noise is a count or two. Without a dead band,
a temperature sitting on a step boundary toggles between two speeds every pass —
audible as the fan hunting. 4 counts is twice the noise and under half a step.

**Why stop on `Q1`, not 0 % duty.** Intel leaves duty below the floor
undefined: some fans stop, some hold minimum speed. Opening `Q1` stops every fan
the same way, and `Q1` was already demoted to the hard off in v2.

**3-wire fans get the on/off half only.** No PWM input, so they run v1's law on
`Q1` and keep the tach monitoring below.

#### Stall detection

Commanded running for 2 s with **zero tach pulses** is a seized or unplugged
fan. Response: force 100 %, show `FAN STALL`, three-flash LED — the same
fail-to-cooling as the sensor fault. Ignored for the 300 ms kick and the first
2 s after it, while the fan spins up.

#### Pin and timer

- **PWM: TCA0 WO2**, single-slope, `PER = 199` at 5 MHz for 25.000 kHz — see
  the table above. On the v2 board's 1616 it is routed to its alternate pin,
  **PB5**, to leave PB2 for serial TX. On the bench 1614, which has no PB5, it
  stays on **PB2** at its default position (Table 5-1, SOIC-14 pin 7). The
  firmware picks by MCU; the compiled 1616 image carries the `TCA02` write and
  the 1614 image does not.
- **TCA0 is free.** This build runs `millis()` on TCD0 (`MILLIS_USE_TIMERD0` in
  the compile flags), so taking TCA0 over does not touch timekeeping. Call
  `takeOverTCA0()` first so `analogWrite()` cannot reconfigure it.
- **Tach: `PA5`**, as reserved, counted by pin interrupt; 2 pulses per
  revolution.
- **Display line 2** gains the duty: `FAN 60%` replaces `FAN ON`.

### Serial status

**v2 prints one line per loop pass, 115200 8N1, on `H3` pin 8 (TX).** Counts
*and* degrees, because the control law runs on counts and tuning wants them:

```
boot fan=4W full_rpm=2400 slow_rpm=900 oled=1
adc=652 t=38.2 set=640 fan=1 duty=40 rpm=1380 stall=0 fault=0 pot=0
```

The boot line carries the detection *evidence* — both RPM readings, not just
the verdict — so a misread fan shows by how much.

- **Transmit only.** RX is wired (`H3` pin 9) but this firmware never reads it.
  Its **internal pull-up** is on, so an unplugged header idles high rather than
  floating noise into the receiver.
- **No external pull-ups.** TX is driven high by the USART between bytes; it
  floats only through reset, costing at most one junk character at power-up.
- **`R13`/`R14`, 1 k in series at the chip.** An adapter plugged into an
  unpowered board would otherwise drive 5 V through PB3's protection diode
  and half-power the MCU; 1 k holds that to ~4 mA, inside the datasheet's
  15 mA for pins at or below 5.5 V. It also turns a TX-to-TX miswire into a
  few milliamps. At 115200 baud the RC is nanoseconds against an 8.7 µs bit.
- **5 V logic**, straight into the FT232 used for UPDI — move one wire.
- **Bench 1614:** TX moves to **PA1** (USART0's alternate pin); its alternate
  RX would be PA2, the wake button, so the receiver is switched off there.

### The board detects its fan from the tach, at boot

**Decided 2026-10-01: auto-detect, no jumper.** Nothing to fit, nothing to set,
and the fan can be swapped without touching the board. It folds into the
self-test that already runs at boot:

```
 1. Q1 on, PWM 100 %, 3 s      (v1's self-test, unchanged)
    count tach pulses over the last 1 s
      none         ->  2-WIRE   done: v1's on/off law
      pulses       ->  record RPM_full, go to 2
 2. PWM 30 %, 2 s
    count pulses over the last 1 s
      RPM < 70 % of RPM_full  ->  4-WIRE   speed steps
      otherwise               ->  3-WIRE   on/off law + stall detection
```

Self-test grows from 3 s to about 5 s, and the OLED shows the result —
`FAN 4W 2400` — so a wrong guess is visible at the first power-up.

**Every misdetection fails toward more cooling**, which is why this is safe to
automate:

| actual | detected as | effect |
|---|---|---|
| 4-wire | 3-wire | on/off at full speed — louder, never hotter |
| 3-wire | 4-wire | PWM line goes nowhere, fan runs full whenever on — same |
| 3/4-wire, **stalled or unplugged at boot** | 2-wire | on/off as v1, **no stall detection** — v1's behaviour, not worse |

The last row is the one real limit: a fan that is dead at power-up cannot be
told from a 2-wire fan. The 2-wire result is the safe default, so it costs the
stall alarm and nothing else.

**Detection runs once per boot and is not stored.** A fan swapped while powered
is picked up at the next power cycle — and with no EEPROM involved there is no
stale setting to clear.

**Hardware: none beyond the tach line.** `PA5` with its internal pull-up
(20–50 kΩ, datasheet Table 36-16 — ample for a tach of a few hundred Hz) reads
an open-collector tach directly; a 2-wire fan leaves it pulled high and pulse-
free, which *is* the 2-wire signature. A footprint for an external 10 k
pull-up is cheap insurance if a fan's tach edges look slow on the scope.
`PA1` and `PB3` stay free.

### Connector and the parts behind it

**Decided 2026-10-01.** The fan plugs straight into the board on the standard
PC fan header, and 12 V comes onto the board to feed it. Designators follow
[`Schematic/FanTempController-Schematic-V2.png`](Schematic/FanTempController-Schematic-V2.png).

```
 CN2 fan, Molex 47053-1000 (4-pin PC fan header, 2.54 mm, fan-keyed ramp)
     1 Load   switched GND - Q1 drain
     2 FAN+   +12V from H1
     3 SENSE  tach: R8 10k pull-up to +5V -> R9 10k series -> PA5 (TACH)
                    at PA5: D2 BZT52C5V1 5.1V zener to GND, C3 1 nF to GND
     4 PWM    Q2 AO3400A drain (open drain); gate <- R10 220R <- PB5,
              R11 10k gate PULL-DOWN

 H1  12 V in, PZ254V-11-02P     1 GND   2 FAN+
 H3  10-pin, PH2.54-1X10P-H25   1 GND  2 +5V  3 Status  4 Wake  5 UPDI
                                6 SCL  7 SDA  8 TX  9 RX  10 GND
 R13 1k, PB2 -> TX              series: limits back-powering and a TX-TX miswire
 R14 1k, PB3 -> RX              same; no pull-ups on either line - see Serial
 D1  1N4148W, Q1 drain -> FAN+, now permanently across the fan
 R12 1k, PA6 -> Status          the LED's series resistor, on board at last
                                (v1's H2 is v2's H3; Status is still pin 3)
```

**CN2 is the Molex 47053-1000, not a generic 2510 header.** The first draft
used an M2510V-04P-N3: same 2.54 mm pitch and 0.64 mm pins, but its datasheet
([`Schematic/M2510V-04P-N3-Datasheet.pdf`](Schematic/M2510V-04P-N3-Datasheet.pdf))
shows one 5.08 mm locking ramp centred on **pin 3**. A 3-pin fan plug sits on
pins 1–3 with its latch over pin 2, so it lands on the ramp instead of over
it. The 47053's ramp is shaped for PC fan plugs, 3- and 4-pin both.

**Pin 1 is the switched ground and pin 2 is +12 V — the fan standard.** The
first draft had them the other way round, which reverse-powers every fan
plugged in. Check this on the footprint as well as the symbol before ordering.

**It takes every fan this board supports.** A 3-pin plug fits pins 1–3 of the
same header, which is what the ramp is shaped for, and a 2-wire fan uses pins
1–2. Detection (above) works out which one is fitted, so there is no jumper and
no second footprint.

**12 V now crosses the board**, which v1 deliberately avoided. It has to: the fan
needs +12 V on pin 2 of a standard header, and running it through the board is
what lets `D1` sit permanently across the fan instead of being opt-in. The fan
current returns through `Q1`, so `H1`'s ground and the 5 V ground are one ground
on this board — tie the 12 V supply's ground to it. Route `FAN+`, `CN2` pin 1
and `Q1` for 2 A; `Q1` is rated 5.7 A.

#### Q2's gate is pulled DOWN — the opposite of Q1, for the same reason

The PWM line is inverted by `Q2`: PB5 high pulls the fan's PWM input low. So a
floating PB5 must leave `Q2` **off**, the line released, and the fan at **full
speed** — which is a gate pull-down. `Q1` gets a pull-up and `Q2` a pull-down,
and both fail to the fan running. Put that on the schematic next to both parts,
or the next tidy-up "corrects" one to match the other.

**That risk is higher now that both are AO3400As.** Two identical FETs, each
with a 220 Ω gate resistor and a 10 k gate resistor, look like a copy-paste —
and the one difference that matters is which rail the 10 k goes to. Label it
on both: *`Q1` pull-UP — fan on if PA7 floats*, *`Q2` pull-DOWN — fan full
speed if PB5 floats*. The V2 sheet carries both: *pull up not pull down* on
`R2`, *pull down, typical low side switch configuration* on `R11`.

#### The tach input is built for a fan ground that floats

**When `Q1` is off, the fan's ground is disconnected and floats up toward
+12 V**, and the tach line becomes the fan electronics' only path back to
ground. A tach wired straight to `PA5` would then drive the pin above the rail,
and the ATtiny allows only **1 mA** of injection above 5.5 V (datasheet
Table 36-1).

- **`R8`, 10 k pull-up at the connector**, holds the line at 5 V in normal
  running.
- **`R9`, 10 k in series into `PA5`**, limits whatever the fan drives in.
- **`D2`, a 5.1 V zener at the pin**, clamps it below the 5.5 V where injection
  starts, so the ATtiny's own clamp diodes never conduct. The series 10 k
  limits the zener to (12.6 − 5.1) / 10 k = **0.75 mA** — trivial for a
  SOD-123 part. At the bottom of its tolerance (4.8 V) it holds a high at
  4.8 V, well above the 3.5 V input-high threshold, and leaks ~10 µA through
  the 20 k path, which costs nothing.
- **`C3`, 1 nF at the pin**, filters edges; with 10 k that is 10 µs, against a tach
  period of milliseconds.
- **`PA5`'s internal pull-up stays off.** With it on, the series 10 k and the
  internal 20–50 k form a divider when the tach pulls low, and the pin can sit
  at 1.7 V — above the 1.5 V low threshold. The external pull-up is on the
  fan's side of the series resistor, so it does not have that problem.

The same floating ground is why **the PWM line is released whenever the fan is
stopped**: with `Q2` on and `Q1` off, `Q2` would offer the fan a ground path
through its PWM input. The firmware releases PWM before it opens `Q1`.

#### Bench path on a v1 board

v1's `H1` already switches the fan's ground through `Q1` — the same topology. A
v1 board with wires bodged to **PB2 (SOIC-14 pin 7)**, **PA5 (pin 3)** and,
for serial, **PA1 (pin 11)**, the
tach network and `Q2` on a scrap of protoboard, and a 4-wire fan on a bench
12 V, runs the v2 firmware before any v2 board exists. That board still has a
1614, so it uses its own environment: `pio run -e attiny1614_v2_bench -t upload`.
Flashing `attiny1614_v2` onto it fails at avrdude's signature check rather than
writing the wrong image.

## Staging: fit two boards, turn the knobs

The setpoint pot turns one board into a stage. Fit a second board with a higher
setpoint and it waits, engaging its own fans only when the first cannot cope —
**no firmware change, same binary, different knob**.

```
stage 1   set 38   releases 32     one fan,  light load
stage 2   set 45   releases 38.3   two more, heavy load
```

**It self-regulates, and that is not luck.** Stage 2's NTC sits downstream of
stage 1's airflow, so once fan 1 runs, stage 2 sees *cooled* air and stays off.
It only trips when the exhaust keeps climbing despite fan 1 — which is the
definition of stage 1 being out of capacity. Two thermostats in the same
airstream measure each other's effect.

### Put stage 2's RELEASE at stage 1's SET point

Not the set points — the release. Each stage should own a distinct regime:

| setpoint | releases | band |
|---|---|---|
| 38 | 32.0 | 6.0 |
| 42 | 35.6 | 6.4 |
| **45** | **38.3** | 6.7 |
| 48 | 40.9 | 7.1 |

With stage 1 at 38, stage 2 belongs at **45** — it hands back exactly where
stage 1 takes over. Put it at 42 and it stays on down to 35.6, *below* where
stage 1 even engages, so three fans run in a regime one could handle. Both
values sit inside the pot's 32–51 span.

The band widens with setpoint (5.8 °C at 36, 7.6 °C at 51) because the NTC's
counts-per-degree falls. The higher stage therefore gets more run-on, which is
the direction you want.

### A second board probably wants no display

Pot and LED are enough on stage 2 — you set it once. **It did hang, and is
fixed.** `oled.begin()` on a bus with no display waits forever — the pull-ups
live on the OLED module, so SDA and SCL float — and the watchdog was armed only
at the end of `setup()`. The second v1 board sat with its fan on and the loop
never running. The firmware now checks both lines for a pull-up and probes
0x3C before touching the display, runs headless if it is absent, and arms the
watchdog straight after turning the fan on. Verified on that board 2026-10-01.
Nothing else differs: same firmware, same BOM minus the display and its tail.

Electrically there is room. `Q1` is rated 5.7 A; stage 2 driving two 100 mA fans
is 200 mA.

## Tune the thresholds before you build this

650/589 come from the Beta equation, not from the box. Run the ESP32 rig in the
assembled enclosure first, watch what the exhaust actually idles at under load,
and set these from that. If idle sits at 35 °C the fan will never stop, and the
thresholds should move rather than the box run hot.

On v1 that was the trade for the small board: no serial, no telemetry. `LED1`
gives heartbeat, fan state and sensor fault, which is enough to *diagnose* but
not enough to *tune*. **v2 has [serial status](#serial-status)** — tune from
that.

## Status LED

Flashed briefly once a second, so it is a heartbeat rather than a load — always
low duty, negligible dissipation next to the sensor. Wired active-low, from +5 V
into `Status` (see As built); a firmware older than this note drove it
active-high, and the LED then sat lit with brief dark blinks.

| pattern | meaning |
|---|---|
| one flash / s | alive, fan off |
| two flashes / s | alive, fan running |
| three fast flashes | sensor fault, fan forced on |
| dark | not running — check 5 V |
