alpauna/TritonECU/hardware/oil-pressure/README.md

# Oil pressure board — reconstruction of V 1.0

**AMPED Oil Pressure V 1.0**, alshowto.com. JLC panel `5363411A_Y1`, date code
**230106** — the boards were made January 2023. The design files are gone, so
this is being rebuilt from the physical boards.

Purpose: replace the truck's oil pressure *switch* with a real pressure sender,
show the reading on an LCD, **and keep the original dash lamp working** — lamp on
below 12 psi, the stock default.

> **Status: partial.** Everything below is marked ⬤ confirmed or ○ inferred.
> Nothing here has been verified by continuity yet.

## Identified so far

| Ref | Part | How |
|---|---|---|
| ⬤ U1 | **ATtiny85-20SU**, SOIC-8, lot 2233 (week 33, 2022) | Top marking: ATMEL / TINY85 / 20U |
| ⬤ Q1 | **KIA2803A** — N-ch MOSFET, 30 V, 150 A, 2.2 mΩ, TO-263 | Datasheet read |
| ⬤ R1 | **10 MΩ**, gate pull-down for Q1 | Marking `01F` (EIA-96), confirmed by the builder |
| ⬤ R2 | **1.2 kΩ**, gate series to Q1 | Marking `122`; role by elimination once R3 was placed |
| ⬤ R3 | **1.2 kΩ**, series into the ADC from `Sensor` | Builder |
| ⬤ D1 | **A TVS on the 12 V input — value not recorded.** Removed from the board | Builder |
| ⬤ D2 | **A 5 V clamp protecting the ADC node**, on the R3 / `Sensor` side. Removed from the board | Builder |
| ⬤ Sender | **100 PSI, 0.5–4.5 V ratiometric transducer** (what it was tested with) | Builder |
| ○ U2 | A 78xx regulator, DPAK | Marking legibly starts `78…`, rest degraded |
| ⬤ C1, C3 | **7.9 µF in-circuit** — almost certainly 10 µF MLCCs; regulator input and output | Meter |
| ⬤ C2 | **100 nF** — the ADC filter at the `Sensor` node | Meter |

> ⚠ **D1 and D2 are off the board as it sits.** It currently has *no* input
> transient protection and *no* ADC clamp. Fine on a bench supply; do not put it
> back in a vehicle in this state.

## Connectors, from the silkscreen

| Ref | Type | Pins |
|---|---|---|
| ⬤ **J1** | 2×3 | `12+`, `Sensor`, `GND` / `Dash`, `5v` (one unlabelled) — the vehicle harness |
| ⬤ **J2** | 2×3 | `GND`, `5v` marked — the footprint and labels say **AVR ISP** |
| ○ **J3** | 1×4 | Almost certainly the I²C LCD: GND / VCC / SDA / SCL |

`5v` appearing on the *vehicle* connector means the sender is powered from the
board — so a **3-wire ratiometric sender** (0.5–4.5 V), not a resistive one.

## Reconstruction

```
   J1 12+ ──┬──[ D1 TVS ]── GND
            └── U2 (78xx) IN     OUT ──┬── 5V ── U1 VCC, J2, J3, and J1 5v
               C1 ──┴── GND          C3 ──┴── GND        (the sender's supply)

   J1 Sensor ──[ R3 1k2 ]──┬── U1 ADC (PB3 or PB4)
                           ├──[ D2 5V clamp ]── GND
                           └──[ C2 ? ]── GND

   U1 PB? ──[ R2 1k2 ]──┬── GATE  Q1 KIA2803A ── DRAIN ── J1 Dash
                R1 10M ──┴── GND                 SOURCE ── GND

   U1 PB0/PB2 (USI) ── J3 SDA/SCL
```

## The sender path, in numbers

100 PSI over 0.5–4.5 V, read against V<sub>CC</sub> as the ADC reference:

| PSI | Volts | ADC count |
|--:|--:|--:|
| 0 | 0.50 | 102 |
| **12** (the lamp threshold) | **0.98** | **201** |
| 50 | 2.50 | 512 |
| 100 | 4.50 | 921 |

**0.122 PSI per count** — resolution is nowhere near the limiting factor. R3's
1.2 kΩ source impedance is well inside the AVR ADC's 10 kΩ guidance.

**Ratiometric is doing more work than it looks.** The transducer is fed from the
same 5 V that is the ADC reference, so regulator error cancels in the ratio —
*including while the 78xx is in dropout during cranking*, since the sensor and
the reference sag together. The reading stays honest right down to the MCU's
brown-out threshold. That is the single best decision in this design.

**D2's headroom was the flaw in that path — and it was seen on the bench.** The
clamp got in the way and **skewed the high-pressure readings**, which is why it
is off the board. The arithmetic says the same thing: the signal legitimately
reaches 4.50 V and the clamp sits at 5 V.

| | |
|---|--:|
| Signal maximum | 4.50 V |
| A 5.1 V ±5 % zener, worst case | **4.85 V** |
| Margin | **0.35 V**, into a soft knee |

10 µA of leakage at full scale costs 12 mV across R3 — 0.3 PSI, reading *low* at
high pressure, and climbing with temperature.

### Replacing it

The pin is bare now, which is fine on a bench transducer and not fine in a
vehicle, where the sender wire can find battery. Options, against a 35 V fault:

| Clamp | R3 | Error at full scale | 35 V fault current | |
|---|--:|--:|--:|---|
| 5.1 V zener | 1k2 | **12 mV — 0.30 PSI** | 24.9 mA | what was fitted, and what skewed the readings |
| 5.6 V zener | 1k2 | 1.2 mV — 0.03 PSI | 24.5 mA | knee moved clear, but there is still a knee |
| **BAT54S to the rails** | **10k** | **0.5 mV — 0.01 PSI** | **3.0 mA** | Schottky reverse-biased 0.5 V at full scale; no knee to sit on |
| **Internal clamps only** | **47k** | **0** | **0.63 mA** | no part at all — R3 alone limits pin injection |

⚠ **Rail clamping has a catch worth knowing**: a fault pushes current *into* the
5 V rail, and a 78xx cannot sink. At R3 = 1k2 that is 25 mA, which would drag
the rail up and take the ATtiny with it. At 10k it is 3 mA, comfortably absorbed
by the ATtiny's own ~5 mA draw. **So the clamp and the resistor have to be
chosen together** — fitting a BAT54S while leaving R3 at 1.2 kΩ would be worse
than no clamp at all.

Either of the bottom two rows wants **C2 = 100 nF** at the pin: the cap feeds the
ADC's sample-and-hold, so the 10 kΩ guidance on source impedance stops applying
and a 10k or 47k series resistor is fine. τ is 1–4.7 ms, which for oil pressure
is instant.

## Still to establish

1. **The regulator's full marking** — which 78xx, and its absolute maximum,
   which is what sets D1's clamping ceiling.
2. **C1's voltage rating** — the value is now known, the rating is not, and on
   the input side that is the number that matters.
3. **Reverse polarity** — a TVS does not protect against it. Is there a series
   diode anywhere, or was the harness simply trusted?
4. Continuity: U1 pins → J2 (confirms ISP and the part's orientation); U1 pin →
   Q1 gate; U1 pin → sender divider; J3 → U1; `12+` → regulator input, and what
   is in between; Q1 drain → `Dash`, source → GND.

## The capacitors

C1 and C3 read **7.9 µF** in circuit, which is what a 10 µF MLCC measures on a
typical meter once tolerance, test conditions and ageing are accounted for. C2
is **100 nF**, sitting at the ADC node — which happens to be exactly what the
replacement clamp options want, so that part of the re-spin is already fitted.

With C2 at 100 nF the sender filter is:

| R3 | τ | Corner |
|--:|--:|--:|
| 1k2 (as built) | 0.12 ms | 1326 Hz |
| 10k | 1.0 ms | 159 Hz |
| 47k | 4.7 ms | 34 Hz |

All three are instant against oil pressure. The higher two also do useful noise
rejection in an engine bay, which the 1.3 kHz corner does not.

### Two things the value does not tell us

**C1's voltage rating matters more than its value.** A 10 µF X5R 0805 rated 16 V
loses 60–80 % of its capacitance at 12 V bias, so C1 may be **2–4 µF in service**
even though it measures 7.9 at zero bias on the bench. On a 12 V automotive net
the part wants a **50 V** rating — for the derating as much as for the survival.

**There is no cold-crank ride-through, and capacitance cannot buy it.** At a
30 mA load with 3 V of allowed droop, 10 µF holds the input up for **1 ms**:

| Dip | Capacitance needed |
|--:|--:|
| 10 ms | 100 µF |
| 100 ms | 1 000 µF |
| 400 ms | 4 000 µF |

A 7805 needs ~7 V in, and cranking dips last tens to hundreds of milliseconds, so
this is not a capacitor problem. The two real answers are a **wide-input buck**
that keeps regulating down to 6 V, or **accept the reset and stop letting the
lamp depend on the MCU** — which is the High finding below, reached from a
different direction.

## The stock circuit is inverted — correcting an earlier finding

`docs/1999-Ford-F150-4wd-5.42v/InstramentCluster2.png` settles how this circuit
actually works on this truck, and it is the opposite of what the audit below
originally assumed:

> **ENGINE OIL PRESSURE SWITCH — "CLOSED WITH NORMAL OIL PRESSURE"**, circuit
> **31 WH/RD**, C101 → C120M/F → C158M/F → **instrument cluster C236 pin 20**,
> into the cluster's microprocessor. The sheet's own note: *"Closes with normal
> oil pressure, causing a gauge reading of NORMAL. With low oil pressure, switch
> opens and causes a LOW gauge reading."*

Three consequences, and they run through everything else here:

1. **The switch never reaches the PCM.** It is a cluster input. That is why the
   board's `Dash` pin works at all — it intercepts a sender-to-cluster wire, not
   anything the PCM owns.
2. **Grounded means NORMAL — confirmed by the builder as well as the sheet.**
   Q1 is **on** while pressure is fine and **off** to warn. Note this is the
   opposite of the board's original design intent, which was "ground the line to
   turn the light on" — that is the *lamp*-type circuit Ford used on other
   trucks, not the gauge-type cluster in this one. The polarity is a one-line
   firmware flip, and the symptom of having it backwards is an indicator that is
   simply always wrong.
3. **Ford already made it fail-safe.** An open wire, a dead board, a FET that
   never turns on — all read LOW. **The audit's High finding is withdrawn**: a
   hung ATtiny releases the line through R1's gate pull-down and the cluster
   shows LOW, which is the correct, loud direction.

### What the watchdog is actually for now

Not "light the lamp when the ECU dies" — the pull-down does that by itself. The
remaining hole is narrower and real: **an MCU that hangs with its output stuck
HIGH** holds the line grounded and reports NORMAL forever.

So the heartbeat circuit inverts too. Instead of a second FET asserting the lamp,
it **shunts Q1's gate to ground** when the heartbeat stops:

```
   HOLD node ──[10k]── b  Q_a (NPN)   c ──┬──[100k]── +5V
                          e ── GND        │
                                          └──[10k]── b  Q_b (NPN)
                                                        e ── GND
                                                        c ── Q1 GATE
```

Heartbeat alive → Q<sub>a</sub> on → Q<sub>b</sub>'s base held low → gate free,
the ECU drives it. Heartbeat stops → the hold node decays → Q<sub>a</sub> off →
the pull-up turns Q<sub>b</sub> on → **Q1's gate is shunted to ground**, the line
is released, the cluster reads LOW. One transistor more than the original
sketch, and it now covers the only failure the pull-down does not.

The pump sizing from that section is unchanged: 220 nF at 100 Hz, 150k bleed,
1 µF hold, 276 ms timeout.

> **The O/D OFF lamp needs this same question asked before its plan is trusted.**
> `docs/dash-indicators.md` assumes a discrete, ground-to-illuminate lamp. These
> cluster sheets show the cluster's only PCM connection is **SCP**, and the MIL
> lives *inside* the cluster with no wire to it. If O/D OFF is the same, there is
> no wire for a watchdog to grab and the whole approach there changes.

## Folding it into the ECU

The plan is to move this function into the ESP32 ECU and let config decide
whether a **switch** or a **sender** is fitted. Reading the ECU's existing code,
almost none of that needs new firmware — `SensorDescriptor`, `FaultRule` and
`CustomPin`/`OutputRule` already express it.

### Sender mode

| Field | Value | Why |
|---|---|---|
| `sourceType` | `SRC_MCP3204` | **0–5 V native**, 12-bit, on SPI — so a 4.5 V signal needs no divider, and it sidesteps the ESP32's ADC2/WiFi conflict entirely |
| `calType` | `CAL_LINEAR` | `calA`/`calB` = 0.5 / 4.5 V, `calC`/`calD` = 0 / 100 PSI. That *is* a ratiometric transducer, exactly |
| `unit` | `"PSI"` | already an example in the header |
| `emaAlpha`, `avgSamples` | ~0.2, 4 | the filtering C2 used to do in hardware |
| `errorMin` / `errorMax` | **−5 / 105 PSI** (built) | **the feature the old board never had**: a healthy transducer never leaves 0.5–4.5 V, so anything outside reads as an impossible pressure and is a *wiring fault*, not 0 PSI. A broken sender wire on V1.0 looks exactly like no oil pressure |
| `faultBit`, `faultAction` | → `FAULT_ACT_CEL` | |
| `activeStates` | see below | |

#### The plausibility band, as built

`configureOilPressure()` sets the limits from `maxPsi`, so they scale with the
transducer: **±5 % of full scale**, which is ±0.2 V either side of the sensor's
own 0.5–4.5 V range.

| Condition | Volts | PSI | |
|---|--:|--:|---|
| Sender wire open | 0.00 | −12.5 | **sensor fault** |
| Shorted to ground | 0.05 | −11.2 | **sensor fault** |
| `errorMin` | 0.30 | **−5.0** | |
| Bottom of range | 0.50 | 0.0 | plausible |
| 12 PSI threshold | 0.98 | 12.0 | plausible |
| Top of range | 4.50 | 100.0 | plausible |
| `errorMax` | 4.70 | **105.0** | |
| Shorted to 5 V | 5.00 | 112.5 | **sensor fault** |

**Two faults with different consequences**, which is the point of separating
them:

| | Raises | Action |
|---|---|---|
| Implausible reading | the **descriptor's** fault | **CEL steady, no limp** — a wiring fault is not an engine fault |
| Genuinely low pressure | the **OIL_LOW rule** | CEL steady **+ limp mode** |

And **a rule never fires on a sensor that is already `inError`**. Without that,
a broken sender reading −12.5 PSI would trip OIL_LOW and put the engine in limp
mode — blaming the engine for a wiring fault and hiding the real cause.

Two supporting changes were needed to make the limits mean anything: the
descriptor's `faultBit`/`faultAction` were persisted and editable but **never
consumed**, so plausibility raised nothing; and the oil descriptor's action moved
from `LIMP` to `CEL`.

The dash output needs no change — with a broken sender the reading fails the
`ORULE_GT 12` test, so the line is released and the cluster reads LOW, which is
exactly right.

### Switch mode

The same slot, two fields changed: `sourceType` = `SRC_GPIO_DIGITAL` (or
`SRC_EXPANDER`), `calType` = `CAL_NONE`. Value becomes 0/1, and switch polarity
is handled by picking `OP_LT` vs `OP_GT` in the rule — no invert flag needed.

**So "switch or sender" is two fields in one sensor slot, not a firmware branch.**

### The dash output — and it is inverted

Because grounded means NORMAL, the ECU's output is **asserted when everything is
fine**, not when it is wrong. In `OutputRule` terms that inversion is free: pick
`ORULE_GT` with `thresholdA` = 12 instead of `ORULE_LT`, so the rule activates —
and the line is grounded — while pressure is *above* the threshold.

Three things follow, and all of them are the behaviour you want:

- **A sensor fault releases the line.** `errorMin`/`errorMax` firing means the
  rule cannot be satisfied, the output drops, and the cluster reads LOW. An open
  sender wire, a shorted one, or a reading outside 0.5–4.5 V all warn.
- **The prove-out is free.** From key-on until the ECU has booted, read the
  sender and satisfied the rule, nothing grounds the line — so the cluster reads
  LOW, exactly as it does on a stock truck with the engine not yet running.
- **`requireRunning` is not needed for the indicator.** Oil pressure genuinely is
  low before the engine starts, and the stock display says so. Let it.

Keep a separate `FaultRule` with `debounceMs` ≈ 2000 and `requireRunning` = true
for the *logged* fault, so a hot idle dipping briefly does not fill the log.

### Two things that are not free

**1. Ratiometric cancellation is a hardware requirement, not a config one.**
`MCP3204Reader::begin(spi, cs, vRef = 5.0f)` scales against a *number*. The
cancellation only actually happens if the chip's **VREF pin is tied to the same
5 V that feeds the transducer** — then a sagging rail moves signal and reference
together and the ratio holds, which is the property that keeps the reading honest
through cranking. Wire VREF to a separate precision reference and you lose it
silently: the number still looks plausible, it is just wrong whenever the rail
moves.

**2. The fail-silent problem gets *worse*, not better.** On the old board a hung
ATtiny meant no lamp. In the ECU the lamp now depends on a far larger system —
WiFi, SD, the web server — any of which can wedge the thing that is supposed to
warn you about oil pressure. Moving the function in does not fix the High finding
below; it raises the stakes on it.

### The heartbeat-gated lamp

**Adopted.** The lamp is held *off* by a diode pump that the ECU has to keep
feeding. Stop feeding it — hang, crash, reset, brown-out, watchdog loop — and the
lamp lights itself. The failure inverts from silent to loud, for about eight
parts.

```
  ECU GPIO ──[C_pump 220n]──┬──|<|── +5V        (D_a, returns the pump)
           100 Hz square    │
                            └──|>|──┬── HOLD ──[R_base 10k]── b  Q_h (MMBT3904)
                              (D_b) │                             e ── GND
                        C_hold 1u ──┤                             c ──┐
                        R_bleed150k─┘                                 │
                                                                      │
              +5V ──[R_pu 100k]──┬─────────────────────────────────────┘
                                 │
                                 └── GATE  Q_wd ── DRAIN ──┬── J1 Dash
                                          SOURCE ── GND    │
       ECU "pressure low" ── GATE  Q_lamp ── DRAIN ────────┘
                                   SOURCE ── GND
```

Two low-side FETs with their drains tied together are a **wired-OR**: the lamp
lights if *either* the ECU asks for it, or the watchdog gives up on the ECU.

**Sizing**, at 100 Hz with BAT54 Schottkys (hold node charges to 4.4 V):

| | | |
|---|--:|---|
| Pump current, C<sub>pump</sub> 220 nF | 97 µA | |
| Bleed current, R<sub>bleed</sub> 150k | 29 µA | **3.3× margin** — comfortable |
| Timeout, C<sub>hold</sub> 1 µF into an NPN's 0.7 V | **276 ms** | lamp lights this long after the last pulse |

Slower heartbeats want a bigger pump or a weaker bleed: 50 Hz with 100 nF into
150k gives **0.7×** and never holds the node up at all. 470k moves the timeout to
864 ms with 10× margin if a longer fuse is preferred.

**Why a pump rather than a 555 or a monostable:** a hung MCU usually leaves its
pin *static*, and a static pin — high or low — transfers no charge. The pump
therefore fails safe on a stuck output as well as a stopped one, which a level-
triggered design does not. Every other failure it sees goes the same way: if
C<sub>pump</sub> opens, Q<sub>h</sub> dies, or the 5 V rail sags, the pull-up
raises Q<sub>wd</sub>'s gate and the lamp comes **on**.

**It gives the bulb check back for free.** From key-on until the ECU boots and
starts pulsing, there is no heartbeat — so the lamp is lit, exactly as the stock
circuit behaves, without needing a rule for it.

**The firmware rule that makes it mean anything:** emit the heartbeat *only from
the code path that has just read the sender and evaluated the rule* — never from
a timer ISR or the scheduler. A heartbeat from a timer proves the CPU is alive.
A heartbeat from the bottom of the oil-pressure routine proves **the function
that protects the engine ran**, which is the thing actually being claimed.

| Failure | Result |
|---|---|
| ECU hangs, pin left high or low | no charge transferred → **lamp on** in 276 ms |
| ECU resets or brown-outs | **lamp on**, and stays on until it boots and pulses |
| Sensor read throws or the rule is skipped | heartbeat not emitted → **lamp on** |
| Pump cap, diode, or Q<sub>h</sub> fails | pull-up wins → **lamp on** |
| ECU alive and pressure genuinely low | its own FET → **lamp on** |
| ECU alive, pressure fine | held off, 97 µA of pump current |

An alternative worth pricing: a **TPS3823-class supervisor** (SOT-23-5, ~$0.50)
has a WDI pin and a fixed ~200 ms window, which does the same job more
deterministically and can supervise the 3.3 V rail at the same time. Fewer parts,
one more line item, and a timeout you cannot tune.

## Audit against automotive reality

What is known so far, worst first:

| Finding | Severity | Notes |
|---|---|---|
| ~~The lamp path depends on the MCU~~ | **Withdrawn** | See "The stock circuit is inverted" below. On *this* truck the wire is grounded for NORMAL, so a dead MCU releases it and the cluster shows LOW. The failure is already in the safe direction, and the High finding was based on my assumption rather than the schematic |
| **A stuck-HIGH output holds the line grounded** | Medium | The one bad case that survives the inversion: an MCU that hangs with the pin asserted keeps saying NORMAL forever. This is what the watchdog is actually for — see below |
| **Q1 is 30 V** on a net tied to battery through the bulb | Medium, on paper | Clamped load dump is ~35 V. *But* the bulb is ~78 Ω hot, so the FET avalanches at 30 V passing only ~64 mA — ~1.9 W in a 160 W part that is explicitly avalanche-rated. It likely clamps the dump itself. A 60 V part costs the same and retires the question |
| **R1 = 10 MΩ** gate pull-down | Low | 100 nA worst-case leakage × 10 MΩ = 1.0 V against a 0.8 V minimum threshold; and C<sub>rss</sub> 355 pF couples ~8.8 % of any drain step onto the gate, bled with τ = R × C<sub>iss</sub> = **40 ms**. 10 kΩ gives 40 µs and clears both by 1000×. In practice harmless here: real leakage at 1 V is picoamps and a lamp's drain does not slew fast. Fails toward lamp-on, which is the forgiving direction |
| **D1's TVS value was never recorded** | Medium | There *was* a TVS, which is the right instinct. But the window is narrow and easy to miss: it must stand off **> 16 V** (charging system plus margin) and clamp **< 35 V** (a 78xx's absolute maximum). SMAJ/SMBJ **18A** clamps at 29.2 V ✓ and **20A** at 32.4 V ✓, while a **24A** clamps at 43 V ✗ — above the regulator's abs max, so it would protect nothing. If the original was a 24 V part it was decorative |
| **Cold crank** | Medium | A 78xx needs ~2 V of headroom and the rail dips to 6 V and below while cranking. C1 gives **1 ms** of ride-through where the dip is 10–400 ms, and no practical capacitor closes that gap — see above. The *reading* survives, because ratiometric sensing cancels a sagging rail; the **MCU** does not, and with it goes the lamp |

## What was right

Worth recording alongside the faults, because the re-spin keeps these:

- **Q1 is logic-level** — R<sub>DS(on)</sub> is specified at V<sub>GS</sub> = 4.5 V
  and V<sub>GS(th)</sub> is 2.0 V max, so a 5 V pin drives it fully on. No linear-region
  problem.
- **Ratiometric sender fed from the board's own 5 V.** If the ATtiny uses V<sub>CC</sub>
  as its ADC reference, regulator error cancels exactly. That is the correct
  architecture, not a lucky accident.
- ISP broken out on a proper 2×3, and a ground pour on the back.
