alpauna/TritonECU/hardware/latching-relay/firmware/README.md

# Latching relay firmware — ATtiny202

The relay remembers its own state, so this firmware never holds anything. It
emits a **30 ms pulse** on one coil to set and on the other to reset, and spends
the rest of its life watching a button.

```bash
pio run                 # build
pio run -t upload       # flash over UPDI
pio run -t fuses        # write the fuses — INCLUDING the BOD level, see below
```

## Three switches at the top of `src/main.cpp`

| | |
|---|---|
| `LATCHING 1` | A latching relay: pulses, and it remembers. Zero holding current — but it holds through a blackout, so `setup()` has to decide what "off" means. |
| `LATCHING 0` | **An ordinary 5 V relay from the drawer.** The coil is *held* while on: 70–90 mA and ~0.4 W for as long as the supply runs, and only leg A is populated. Fail-safe off by construction — no power, no coil, no contact — so `setup()` has nothing to decide and `DUAL_COIL` is ignored. |
| `DUAL_COIL 1` | Two coils, two low-side FETs. Asserting a leg pin energises that coil. |
| `DUAL_COIL 0` | One coil across the bridge. Each leg is a CMOS pair with its gates tied, so the pin is **inverting**: LOW = midpoint HIGH, and idle (both LOW) puts both midpoints high so the coil sees no differential. |
| `SENSE_FITTED 0` | State is tracked in RAM. |
| `SENSE_FITTED 1` | State is read from the relay's spare pole, so the board knows where the relay *is* rather than where it thinks it put it. |

## Pins — ATtiny202 SOIC-8

Five usable I/O, which is exactly what this needs.

| Pin | Signal |
|---|---|
| PA6 | leg A — SET coil, or bridge leg A |
| PA7 | leg C — RESET coil, or bridge leg C |
| PA1 | button, to GND, internal pull-up |
| PA2 | state sense from the relay's spare pole |
| PA3 | ECU line — the ESP32 pulls it low briefly to toggle |

**ATtiny85 on ISP is a supported target**, not just a claim: `src/main.cpp`
switches its own pin defines on `__AVR_ATtiny85__`, and `platformio.ini` carries
an `[env:attiny85]`. Build it with `pio run -e attiny85`.

| Signal | ATtiny202 | ATtiny85 |
|---|---|---|
| leg A | PA6 | **PB1** |
| leg C | PA7 | **PB4** |
| button | PA1 | **PB3** |
| state sense | PA2 | **PB0** |
| ECU line | PA3 | **PB2** |

PB5 stays RESET on the tiny85 — claiming it needs the reset-disable fuse and
then HV programming to recover, which is never worth one more pin. The 4.3 V
brown-out ports across unchanged: the tiny85's BODLEVEL fuse offers exactly
1.8 / 2.7 / 4.3 V.

## Two behaviours that are the point of building this

**Fail-safe off at boot.** A latching relay holds through a blackout, so without
this the 36 V supply comes back on by itself when the mains returns. `setup()`
fires RESET unconditionally — on an already-reset relay that costs one pulse.

**The brown-out interlock is a fuse, not code.** `board_hardware.bod = 4.3v` in
`platformio.ini`. Below that the part stops, so it cannot emit a half-length
pulse and leave the armature stranded between positions — the failure that makes
latching relays look unreliable. Verify the key name against megaTinyCore's
PlatformIO docs and confirm with `pio run -t fuses`; code cannot do this job,
because code needs a running CPU.

## Timing constants

| | | |
|---|--:|---|
| `PULSE_MS` | 30 | Datasheet set times are usually 10–15 ms, so this is a comfortable 2×. Tune to the relay you have. |
| `COIL_REST_MS` | 150 | Minimum between pulses — stops a held or chattering input hammering the coil. |
| `DEBOUNCE_MS` | 25 | Bounce is 1–5 ms. 25 is lazy and free, since nothing else is happening. |
| `LONGPRESS_MS` | 1000 | Long press forces OFF whatever the state. |

## Test it without hardware

```bash
g++ -std=c++17 -Wall -Wextra -o /tmp/sim test/sim.cpp && /tmp/sim
```

`test/sim.cpp` stubs the Arduino API, includes `src/main.cpp` and drives the
state machine on a PC — boot, short presses, long press on and off, a bouncing
contact, and the ECU line. It checks which coil fired and what state resulted,
and exits non-zero on failure.

**All six builds pass** — three switch combinations × two MCUs. Flip the switches and re-run: `DUAL_COIL 0` should
swap the legs and keep the pulses at 30 ms, and `LATCHING 0` should emit no
pulse at boot and leave the coil pin *high* after a press rather than returning
it low.

```
boot             Chi@50ms Clo@80ms        relayOn=0  ok
short press      Ahi@291ms Alo@321ms      relayOn=1  ok
short press      Chi@831ms Clo@861ms      relayOn=0  ok
long press on    Chi@2851ms Clo@2881ms    relayOn=0  ok
long press off                            relayOn=0  ok
bounce+press     Ahi@5715ms Alo@5745ms    relayOn=1  ok
ECU line         Chi@6255ms Clo@6285ms    relayOn=0  ok
all pass
```
