alpauna/TritonECU/docs/schematic-review-power-v2.md

# POWER sheets review — 2026-09-13

Review of `Schematics/TritonECU_Power_2026-09-13.zip` (POWER1, POWER2), V1.0.
Supersedes [`schematic-review-power.md`](schematic-review-power.md), which
reviewed the 2026-09-08 single sheet.

## Corrections from the previous review that landed

| | |
|---|---|
| R1 2.2 kΩ → **220 Ω**, C1 100 nF → **470 nF** | ✓ |
| D3 (CMZ5945B zener) **deleted** | ✓ |
| OV/UV divider → **249 kΩ / 86.6 kΩ / 10 kΩ** (43.2 V / 4.47 V) | ✓ |
| Q2 → **IRF540NSTRLPBF** (D2Pak), Q1 stays **YJQ40G10A** | ✓ exactly as specified |
| PPTCs **removed**, external 5 A fuse noted | ✓ |
| TVS → **SMDJ43A** | ✓ (see §5 on quantity) |
| SPS strapped to **VCC** via R21, not to 5 V | ✓ the pin that kills the part |
| SYNC **10 kΩ to GND** plus M_SYNC to the header | ✓ |
| PGOOD → **3.3 V** on both converters (5_GOOD, 3.3_GOOD) | ✓ |
| Output bank **4 × 22 µF** | ✓ |
| MCU shutdown via BSS123 pulling SHDN# low | ✓ the retry-latch path |

## 1. ~~BLOCKING~~ RESOLVED 2026-09-13 — U11 was the 400 kHz variant

```
U11 = MAX25239AFFB/VY+
```

From the ordering table:

| Part | I<sub>LIM</sub> | Fixed V<sub>OUT</sub> | Adj | **f<sub>SW</sub>** |
|---|---|---|---|---|
| MAX25239AFF**A**/VY+ | 8.2 A | 5 V | <6.5 V | **2100 kHz** |
| MAX25239AFF**B**/VY+ | 8.2 A | 5 V | <6.5 V | **400 kHz** |

**The B suffix is 400 kHz.** Two independent consequences, either one blocking:

**It puts harmonics straight into the AM band** — the single reason the switching
frequency was pushed up in the first place:

```
400 kHz × 3 = 1.20 MHz     AM band = 530–1710 kHz
400 kHz × 4 = 1.60 MHz     both inside it
```

**And L2 = 2.2 µH is the 2.1 MHz value.** At 400 kHz the same inductor gives:

```
ΔIL = Vout(Vin − Vout)/(fsw · L · Vin)

at 2.1 MHz, 13.8 V in    0.69 A pk-pk    ← what 2.2 µH was chosen for
at  400 kHz, 13.8 V in   3.62 A pk-pk
at  400 kHz,   27 V in   4.63 A pk-pk
```

**Fixed: U11 is now MAX25239AFFA/VY+.** ✓ The 400 kHz part would need ~4.7 µH — the
datasheet's own 400 kHz application value — and would still be in the AM band.
Everything else on the sheet (L2, the output bank, the compensation) is already
sized for 2.1 MHz.

## 2. ~~BLOCKING~~ RESOLVED 2026-09-13 — R19 was 78.7 Ω

```
R19 = 78.7 Ω        drawn
Rc  = 78.7 kΩ       calculated
```

**Fixed: R19 is now 78.7 kΩ.** ✓ It was a factor of **1000** out. With 78.7 Ω the error amplifier has essentially no gain at
crossover and the zero sits at `1/(2π·78.7·2.2 nF)` = **919 kHz** instead of
919 Hz — above the intended crossover rather than a decade below the power-stage
pole.

C22 = 2.2 nF is correct. C23 = 3.3 pF is the low-stray option discussed for
C<sub>p</sub> and is fine.

## 3. ~~BLOCKING~~ RESOLVED in the 2026-09-18 revision — ENOUT is level shifted

R3 pulls ENOUT to **VIN**, which is correct and necessary: ENOUT must enable the
MAX25239 before any downstream rail exists, so it cannot be pulled to 3.3 V or
5 V. That part is right.

**But ENOUT is also on U8 pin 8**, alongside SCL, SDA, U_SHDN, M_SYNC and the
three GOOD signals — a header that is otherwise entirely 3.3 V logic. During a
clamped overvoltage that pin carries **27 V into the MCU.**

**Fixed by option 2** — the *Level Shifted Enable Out for MCPU* block:

```
ENOUT -> Q4 BSS123 -> R16 10k pull-up to +3.3V -> 3.3_ENOUT -> header pin 8
```

The header carries `3.3_ENOUT`, not `ENOUT`, and measures **3.3 V** on the built
board. `ENOUT` keeps its job driving the MAX25239's EN at V<sub>IN</sub> where it
belongs; the MCU sees an open-drain copy.

The original options were:

1. Remove ENOUT from the header. It has a job on this board and the MCU does not
   need it.
2. A divider or small open-drain level shift to 3.3 V, sized so the MAX25239's
   EN still sees its logic threshold. ← **taken**

Worth a check across every header pin: **U8 is otherwise safe** (VIN-ALERT,
5_GOOD, 3.3_GOOD are pulled to 3.3 V; M_SYNC and U_SHDN are MCU-driven).

### v3: Fault does NOT need the same treatment

The v3 board adds `Fault` from the LTC4364's FLT# pin, level-shifted on the
pattern above. **Delete the shifter — FLT# needs only a pull-up.** The datasheet
is quoted in [`schematic-review-power.md`](schematic-review-power.md) §*Drive
capability confirmed*:

> *The internal FET is capable of sinking up to **2 mA** and can withstand up to
> **80 V**. Connect to GND if unused.*

Open-drain, confirmed rather than assumed. It has no high-side drive, so whatever
it is pulled up to *is* its logic high — FLT# is not "at" any voltage of its own,
and the 80 V withstand is what makes the choice free.

**Why ENOUT differed.** ENOUT's pull-up *has* to sit at V<sub>IN</sub>, because
its primary job is driving the MAX25239's EN. A 3.3 V copy therefore needed a
separate stage, and Q4/R16 is the right answer there. **FLT# has no second job** —
it goes nowhere but the MCU. Pull it to 3.3 V directly and there is nothing left
to shift.

```
FLT#  ──[ 10k to 3.3V ]──  MCU     330 uA, 6x inside the 2 mA sink rating
      ──[ 1 nF at the MCU pin ]    RC = 10 us, invisible against a 44 ms event
```

**Keep the 1 nF.** This board low-side switches eight ignition coils and a 10 kΩ
pull-up is a high-impedance line running past them; the filter is there so a coil
event cannot trigger a spurious shutdown sequence.

**And a resistor cannot glitch.** A shifter powered from 3.3 V dies with the rail
exactly as the pull-up does, but on the way down its output can go indeterminate,
and it adds an OE pin to get right. The pull-up simply stops pulling. The case
that matters is the **44 ms early warning**, when the rail is still up and FLT#
reads correctly.

### Why ENOUT cannot also move to 3.3 V — and why Q4 stays

Asked during v3: since Fault brings the 3.3 V rail next to the chip, could ENOUT
pull up there too and save the BSS123? **No — it is a bootstrap deadlock.**

```
LTC4364 ─ ENOUT ─► MAX25239 EN ─► 5 V ─► TLV62085 ─► 3.3 V
   ^                                                    │
   └──────────── pull-up from here? ◄───────────────────┘
```

EN could never assert, so the 5 V never comes up, so the TLV62085 never runs, so
the 3.3 V meant to pull EN high never exists. **V<sub>IN</sub> is the only rail
alive at the moment ENOUT has a job.**

Reinforcing it: ENOUT is **latched**, resetting when OUT falls below 2.2 V, so its
whole value lies in startup and brownout — precisely when 3.3 V is absent or
marginal. And the pull-up value is tied to V<sub>IN</sub> operation anyway: §*9*
sizes it at 100 kΩ because 27 V through 10 kΩ draws 2.7 mA and exceeds the 2 mA
sink rating.

**The test for whether a shifter earns its place:**

| | only consumer | must work before 3.3 V exists? | verdict |
|---|---|---|---|
| **FLT#** | the MCU | no — the MCU is not alive either | **pull up to 3.3 V, no shifter** |
| **ENOUT** | MAX25239 EN, at V<sub>IN</sub> | **yes** | **V<sub>IN</sub> pull-up + shifted copy** |

Same part, same open-drain structure, opposite answer.

### RETRACTED: "the MCU does not need ENOUT"

Option 1 above proposed removing ENOUT from the header, on the grounds that the
MCU "would always read good" since it only exists once the converter is running.

**That was wrong, and the 2026-09-26 bring-up disproved it.** Its steady state is
indeed useless, but its **falling edge** is the most valuable diagnostic signal on
the board:

```
>>> EDGE  3.3_ENOUT  FALL
>>> EDGE      3.611 us  5_GOOD  FALL
```

That ordering is what proved the protector faulted first and the MAX25239 was
innocent — see [`firmware/power-diag/README.md`](../firmware/power-diag/README.md).
Without `3.3_ENOUT` on a header pin the dropout would still be unexplained.

**Net for v3: delete the Fault shifter, keep Q4.**

> **Designator note — RESOLVED, and against this document.** Where this review says
> `U8` for a header it means **`U7`**. The v3 netlist puts every signal attributed
> to "U8" — VIN-ALERT, 5_GOOD, 3.3_GOOD, M_SYNC, U_SHDN — on `U7`, and `U8` is the
> INA238 exactly as the BOM says. **The BOM was right; this document was wrong.**

## v3 verification against the netlist — one change needed

Checked `FlyingProbeTesting.json` from the v3 gerbers.

### ✅ Confirmed

| | |
|---|---|
| **Fault shifter deleted** | `FLT` = `U1_13` → `R5` → `+3.3V` → `U7_13`. No BSS123 |
| **ENOUT keeps Q4** | gate `+3.3V`, source `3.3_ENOUT`, drain `ENOUT` — correct topology |
| **`R4` = 100 kΩ to VIN** | right value for ENOUT, per §9 |
| **U7 = 2×7, grounds interleaved** | GND on **2, 8, 14** — start, middle, end. Both `+3.3V` pins (1, 3) have a ground neighbour at 2; 8 lands in the I²C/status group; 14 anchors the FLT end |
| **PGND still isolated** | `{C1_1, CN1_2, D1_2}` + pads, against **128** GND nodes. Fault plane intact |
| **five header grounds** | `U6` 2× GND / 2× VIN / 2× +5V, plus `U7`'s three |
| **third 560 µF** | `C3, C4, C29` |

### ❌ `R5` is 100 kΩ where it must be 10 kΩ

It appears to have inherited `R4`'s value. The two pull-ups need *different* values,
for reasons this review already gave in the opposite direction at §9:

| pull-up | to | correct | why |
|---|---|---|---|
| `R4` ENOUT | **VIN**, 27 V at the clamp | **100 kΩ** | 10 kΩ draws 2.7 mA, past the 2 mA sink limit |
| `R5` FLT# | **+3.3 V** | **10 kΩ** | only 330 µA, and low impedance *is* the point |

§9 warned that *"10 kΩ — the correct value for FLT# into a 3.3 V MCU — is wrong
here"* for ENOUT. Both ended up at ENOUT's value.

**This is not a sink-current problem** — 33 µA is harmless. It is **noise immunity**.
`schematic-review-power.md` §*FLT# wiring* chose 10 kΩ because this board low-side
switches **eight ignition coils** and FLT# is a high-impedance line running past
them. At 100 kΩ it is **10× more susceptible**, on a signal whose false assertion
triggers a shutdown sequence. No 1 nF sits on the net either, though that review
put it "at the MCU pin", so the carrier is its proper home.

**Fix is BOM-only:** same 0402, move `R5` from the 100 kΩ line to the 10 kΩ line.
No layout change.

### ❌ Standoff hole and pad are both under the Sinhoo minimum

The four 4.2 mm holes sit exactly at `U2`–`U5` (delta 0.000 mm), so they are the
standoffs' locating bosses, not separate mounting holes.

| | board | Sinhoo M3 spec | |
|---|--:|--:|---|
| locating hole | **4.20 mm** | **4.22 mm** (+0.08 → 4.22–4.30) | 0.02 under |
| solder pad OD | **6.00 mm** | **6.2 mm min** | 0.20 under |

Small individually, but this joint is **the primary ground return, the mechanical
mount, and uninspectable after assembly**, all at once — see
[`grounding-architecture.md`](grounding-architecture.md).

**The hole is the one that matters.** If it lands on the small side of tolerance the
boss will not seat, and a standoff sitting proud gives a gapped solder joint *and* a
wrong board-to-board height, so the screw may not reach the thread. Drill wear only
ever makes holes smaller.

**Set the hole to 4.25 mm** (mid-range of the allowed 4.22–4.30) and **the pad to
6.2 mm**, which also recovers ~11 % of solder area:

```
6.00 pad / 4.20 hole  ->  14.4 mm2
6.20 pad / 4.25 hole  ->  16.0 mm2
```

Both are footprint edits, one re-export.

### Two items the netlist cannot settle — check in CAD

Both are the ones §*Three layout items that are hard to fix later* named.

**`Q1` copper.** The tab pad is **88.8 mm² = 0.138 in²**, against a spec of ~1 in² of
*pour*. Pad area is only a lower bound — the `B+` pour extends past it and carries
several vias, suggesting inner-layer spreading. **Measure the `B+` pour area around
`Q1`.** Not determinable from the netlist, and an error-prone polygon computation
from raw Gerber.

**`R1` Kelvin routing.** Both sense pairs share the nets, which is normal — Kelvin is
a routing property, not a netlist one. But note what `VIN` is:

```
VIN: 36 nodes - C3, C4, C29, C5, C6, C7, C27, C28, U10_2, U10_3,
     U6_3, U6_4, R3_2, R4_2, U1_1, U8_8, U8_9, + vias
```

Full load current, bulk caps, converter input and header pins all sit on the copper
that `U1_1` and `U8_8`/`U8_9` sense from. Whether those taps leave from the **inner
edges of the shunt pads** or off the current-carrying pour is geometry — and at the
measured 4.96 A limit, **1 mΩ of tap error is 9 % of the current limit**.

### ✅ Also reconciled

Drill counts match exactly: **20 × 1.0 mm** = `U6`'s 6 plus `U7`'s 14 pins, and
**2 × 1.7 mm** at `CN1`. Board is roughly 76 × 45 mm. `R5` is now **10 kΩ** with
`R4`/`R7` correctly left at 100 kΩ.

### ⚠ Silkscreen pin labels are wrong on the v3 gerber

Reported by the board owner. Connectivity is unaffected — the netlist is
authoritative and was used for everything above — but the silk is what gets read
during assembly and while probing the carrier. Fix before the order.

## 4. ~~HIGH~~ RESOLVED in the 2026-09-18 revision — the TMR cap is now 2.2 µF

Sized for the 400 ms ISO 7637 load dump, which has to survive X7R tolerance:

```
capacitance tolerance ±10 %, X7R tempco ±15 %  →  worst case ≈ −23 %

1.5 µF → 405 ms nominal → 312 ms worst case      short of 400 ms ✗
2.2 µF → 594 ms nominal → 457 ms worst case      ✓
```

Specify **X7R or C0G, 16 V, 0805** — the TMR pin charges at 5 µA, and tantalum
leakage is specified in microamps, the same order as the charging current.

**Fixed: the TMR cap is `C8 = 2.2 µF`.** It changed designator from C7 to C8 in
the revision, which is why the change is easy to miss when diffing by reference.

## 5. Items to confirm

### R<sub>SNS</sub> is 8 mΩ, giving a 5.6 A limit

Not the 11 mΩ / 4.1 A discussed, but **acceptable as drawn** — the IRF540NS
absorbs it:

```
short:  14 V × 5.6 A = 78 W  for tOC = 54 ms (with C7 = 2.2 µF) = 4.2 J
        Zθ(54 ms) ≈ 0.35 °C/W  →  ΔTj ≈ 27 °C
```

The consequence is that the supply is sized for more output than the 2 A decided
in [`power-supply.md`](power-supply.md). Leave it or change it deliberately; do
not change it by accident.

### FB is tied to M_VCC — the fixed 5 V option

Valid, and it gives ±2 % with no divider current. **But it removes the
loop-injection point**, which matters more here than it did in the abstract:
with §2 outstanding, the compensation network cannot be verified in circuit
without cutting into the board.

Either accept that the loop goes unmeasured, or move to adjustable mode
(53.6 kΩ / 10.2 kΩ for 5.004 V, 78 µA) and keep a 10–20 Ω injection resistor in
the divider.

### TLV62085 feedback divider is 672 kΩ

R17 = 510 kΩ, R18 = 162 kΩ → 3.32 V ✓, but only **4.9 µA** of divider current.
That is deliberate for the sleep budget and defensible, with two things to check
against the TI datasheet:

- **FB leakage** against 4.9 µA — at 50 nA it is a 1 % output error.
- **Whether a feedforward capacitor across R17 is required.** High-value
  dividers usually need one for loop stability, and a high-impedance FB node
  beside a 2.4 MHz switcher is also a noise-pickup risk.

### L1 = 500 nH on the TLV62085

At 2.4 MHz, 5 V → 3.3 V that gives **0.94 A pk-pk** — about 94 % ripple at a 1 A
load. Check TI's recommended value; 1 µH would halve it.

### Two SMDJ43A in parallel

Breakdown-voltage tolerance means the lower-V<sub>br</sub> device takes most of
the surge and fails first, so two do not give 2× capability. **One SMDJ43A is
3000 W and is enough** — that is why the part was chosen over the SMCJ. Harmless
to keep, but it is not buying what it appears to.

### PGND pins

The symbol shows PGND1 on pin 5 and PGND2 on pin 9. The datasheet assigns
**PGND1 = 5, 6** and **PGND2 = 9, 10**. Confirm all four are connected.

## Summary

> ⚠ **This table was stale.** It was written 2026-09-13 against the schematic of
> that date; **POWER1 and POWER2 were both revised 2026-09-18** and items 3 and 4
> were fixed then. The status column was not updated, so the review read as
> blocking for a board that had already been corrected — and was corrected here
> only after the built board measured 3.3 V on the pin the review said carried
> V<sub>IN</sub>. Check the schematic date against this file's before trusting it.

| # | Sheet | Change | Status |
|---|---|---|---|
| 1 | POWER2 | U11 → MAX25239AFF*A*/VY+ (2100 kHz) | **✓ fixed** |
| 2 | POWER2 | R19 → 78.7 kΩ | **✓ fixed** |
| 3 | POWER1 | ENOUT level shifted via Q4/R16 to `3.3_ENOUT` | **✓ fixed 09-18** |
| 4 | POWER1 | TMR cap → 2.2 µF, now `C8` | **✓ fixed 09-18** |
| 5 | Confirm R<sub>SNS</sub> 8 mΩ is intentional (5.6 A limit) | medium |
| 6 | Fixed FB loses the loop-injection point | medium |
| 7 | TLV62085: check FB leakage vs 4.9 µA, and feedforward cap | medium |
| 8 | TLV62085: check L1 = 500 nH against TI's recommendation | medium |
| 9 | One SMDJ43A is enough | low |
| 10 | Confirm PGND pins 6 and 10 connected | low |

---

# Before the BOM and layout

## R<sub>SNS</sub> = 11 mΩ — what moves and what does not

```
ILIM(min) = 45 mV / 11 mΩ = 4.09 A        (was 5.6 A at 8 mΩ)
inrush    = 1236 µF × 12 V / 4.09 A = 3.63 ms
tOC       = 2.2 µF × 1.35 V / 55 µA = 54 ms        15× margin ✓
```

**C7 stays at 2.2 µF** — the timer was sized by the 400 ms load dump, not by
inrush, and 54 ms still clears 3.63 ms by 15×. Q1's worst case improves:
`14 V × 4.09 A = 57 W` for 54 ms = 3.1 J, ΔTj ≈ 20 °C on the IRF540NS.

### Specify the shunt properly — and power is not what sizes it

```
running, 13.8 V, 0.33 A          1.2 mW
cold crank, real load, 0.9 A     8.9 mW
2 A out at the 4.4 V floor       113 mW    ← realistic worst case, and transient
at the 4.09 A current limit      184 mW    ← absolute ceiling, 54 ms before shutdown
auto-retry average (4.3 % duty)    8 mW
```

**1 W is ~5× the absolute peak and ~800× the continuous figure — keep it
anyway.** The power rating is not the binding spec here. Three other things are:

| | Why |
|---|---|
| **Tolerance 1 %** | it sets the current limit *directly* |
| **TCR ≤ 100 ppm/°C**, prefer ≤ 50 | it sets the INA238's battery-current accuracy too |
| **Kelvin routability** | 2512 leaves room to bring both sense pairs off the inner pad edges; 4-terminal parts start at 2512 |

TCR is the one worth spending on. A thick-film 1206 at 200 ppm/°C drifts
**3.3 %** over −40 to +125 °C, and that error lands in the reported battery
current as well as the trip point. A metal-element 2512 at 15–50 ppm/°C drifts
0.25–0.8 %.

Self-heating favours the larger part slightly as well: at the 184 mW ceiling a
2512 rises 5–9 °C against 15–22 °C for a 1206, which with the TCR above is a
further 0.07 % versus 0.2 %. Small, but it points the same way.

**So the 1 W part is already the right choice, for reasons other than its
wattage.**

### DECIDED 2026-09-13: 10 mΩ, 1 W, 2512

11 mΩ is E96 and the selection in good tolerance and TCR is thinner. The
datasheet's own worked example picks **10 mΩ** for a 4 A target:

| R<sub>SNS</sub> | I<sub>LIM(min)</sub> | I<sub>LIM(typ)</sub> | Q1 short-circuit |
|---|---|---|---|
| 10 mΩ | 4.50 A | 5.00 A | 63 W |
| **11 mΩ** | **4.09 A** | **4.55 A** | **57 W** |
| 12 mΩ | 3.75 A | 4.17 A | 53 W |

All three clear the 3.2 A needed at the 4.4 V floor, and all three are
comfortable for the IRF540NS. **ADCRANGE = 0 is required at any of them** — the
narrow range saturates below the limit in every case.

**Settled on 10 mΩ**, the datasheet's own value, moved from 1206 to **2512** for
Kelvin routing. Everything downstream holds:

```
ILIM(min)          45 mV / 10 mΩ            =  4.50 A
inrush             1236 µF × 12 V / 4.50 A  =  3.3 ms   vs 54 ms timer   ✓
C7                 unchanged at 2.2 µF                                    ✓
Q1 short-circuit   14 V × 4.50 A = 63 W for 54 ms = 3.4 J → ΔTj ≈ 22 °C   ✓
shunt dissipation  10 mΩ × 4.50² = 203 mW on a 1 W 2512, ~20 % of rating  ✓
INA238 ADCRANGE=0  ±163.84 mV / 10 mΩ = ±16.4 A, 0.50 mA/LSB              ✓
```

The 1206 → 2512 move is the right call for a second reason beyond routing room:
**thick-film 1206 shunts are typically 200 ppm/°C**, which would have put 3.3 %
of drift into both the trip point and the reported battery current over the
temperature range.

| Terminals | **4-terminal (Kelvin) if available** — see layout below |

### INA238: ADCRANGE = 0

```
ADCRANGE = 1   ±40.96 mV  →  ±3.72 A at 11 mΩ    saturates BELOW the 4.09 A limit ✗
ADCRANGE = 0  ±163.84 mV  →  ±14.9 A             0.45 mA/LSB                      ✓
```

A firmware constant, not a schematic change — but it has to be right for the
FLT# disambiguation in [`always-on-domain.md`](always-on-domain.md), which
distinguishes an overcurrent fault from an overvoltage warning by reading
whether the current is at the limit.

## Three layout items that are hard to fix later

### 1. Kelvin the shunt — it is sensed twice

**Both** the LTC4364 (SENSE/OUT) and the INA238 (IN+/IN−) measure across the
same 11 mΩ. At the 4 A limit, **1 mΩ of trace error is 4 mV against a 45 mV
threshold — 9 % of the current limit**, and a direct error in the battery
current reading.

Route both sense pairs from the **inner edges of the shunt pads**, symmetric,
each pair kept together. Do not tap them off the current-carrying copper.

### 2. Copper under Q1 is a specified requirement, not a preference

From the auto-retry analysis: a persistent short averages **2.5 W** in Q1 at a
4.3 % duty cycle that cannot be tuned away, because it is fixed by the ratio of
the TMR charge and discharge currents.

```
required   RθJA ≤ (175 − 85) / 2.5 = 36 °C/W
D2Pak on minimum pad          40 °C/W   →  Tj = 185 °C  ✗
D2Pak on ~1 in² of 2 oz Cu    25–30     →  Tj ≈ 147 °C  ✓
```

### 3. The COMP node is small and high-impedance

C23 is **3.3 pF** and board stray is 2–5 pF — the same order. R20 is **78.7 kΩ**
sitting beside a 2.1 MHz switching node. Keep R20/C22/C23 tight to the pin and
away from LX1/LX2.

## BOM cautions

- **C7 must be X7R or C0G, never tantalum or electrolytic.** TMR charges at
  5 µA; tantalum leakage is specified in microamps.
- **The 560 µF input electrolytics must stay electrolytic.** Their ESR is the
  input filter's damping — a low-ESR polymer "upgrade" raises Q from 1.7 to
  about 14. See [`power-supply.md`](power-supply.md).
- **4 × 22 µF output: check DC bias derating.** The compensation assumes ~66 µF
  effective from 88 µF nominal; a 6.3 V part at 5 V bias would fall well short.
- **One SMDJ43A is enough** — two in parallel do not share.
