alpauna/TritonECU/docs/grounding-architecture.md

# Grounding architecture: the fault plane is not a ground

Three distinct return domains, meeting only outside the board.
[`harness-protection.md`](harness-protection.md) covers the OEM precedent — three
signal returns and four power grounds, star point in the box. This document adds
the domain above those: **PGND, which is not a ground at all.**

| domain | carries | reaches the vehicle via |
|---|---|---|
| **PGND** — fault plane | D1 clamp current, only when D1 fires | **dedicated twisted pair with B+**, direct to battery negative |
| **GND** — real ground plane | the board's DC return | four M3 standoffs + three header pins → carrier board → 104-pin |
| signal returns | sensor and reference returns | separate 104-pin pins, star point in the box |

## PGND is a two-node net and is deliberately not tied to GND

```
GND    118 pins
PGND     2 pins  --  D1_2 and CN1_2, that is the entire net
```

**Confirmed on hardware 2026-09-26: no copper tie exists.** This closes
`schematic-review-power.md` §8, which asked to confirm the two were joined at
exactly one point and was carried unresolved through v1 and v2. The answer is
zero points, and that is correct.

Clamp current enters at `CN1_1`, crosses D1, and leaves at `CN1_2` without ever
touching the board's ground reference. **Do not "fix" this by merging the nets.**
Tying GND to PGND would turn a fault path into the board's DC trunk and put
operating current through it permanently — the opposite of its purpose.

## Why PGND gets its own wire and not a 104-pin pin

Two threats with opposite physics, both pointing the same direction.

**Load dump** (ISO 16750-2 test B) — high energy, *slow*: 5–10 ms rise in a 12 V
system, tens of amps until the 5 A fuse clears. **Current capacity** is the
constraint; inductance is irrelevant, since 40 A in 5 ms is 8000 A/s and even
1 µH develops millivolts.

**Fast transients** (ISO 7637-2 pulse 3a/3b) — nanosecond edges, low energy, a
few amps from a ~50 Ω source. **Inductance is the whole story.** At roughly
1 nH/mm unpaired, a metre of wire is ~1 µH, which against a 5 ns edge is an
impedance the transient simply will not take. It goes into the board instead.

> **A TVS on a long ground lead stops being a TVS.** It stays in the schematic
> and does nothing for the threat that arrives fastest.

Three reasons the main connector is the wrong route:

1. **Lead inductance decouples D1 from what it protects** — above.
2. **Pin rating.** EEC-V pins are good for single-digit amps; a load-dump clamp
   pushes tens through. Pin erosion from repeated arcing is cumulative and
   invisible until it isn't.
3. **It would drag surge current across the ECU.** The worst of the three. The
   entire reason PGND is isolated is so clamp current never traverses the board;
   routing its return through the 104-pin runs that current the length of the
   module, coupling into every adjacent conductor by mutual inductance.

**Route `CN1_1` and `CN1_2` as a twisted pair, as short as practical, to the
battery negative or the main engine ground stud** — the same reference the
charging system uses, because that is where a load dump originates. Twisting is
the highest-value single measure: paired go-and-return cancels most of the loop
inductance, which is exactly what the fast pulses see.

### The cost of the isolation, stated plainly

With PGND and GND separate, what the board sees during a clamp is D1's clamp
voltage **plus whatever PGND rises relative to GND**. Negligible for load dump;
for fast edges it is the inductance term above. Same argument for the short
twisted pair, arriving from the protected side instead of the source side.

## GND return: four standoffs and three header pins, in parallel

GND reaches the carrier board by two routes at once:

| route | what it is |
|---|---|
| **four M3 standoffs** (`U2`–`U5`, SMTSO30100CTJ) | soldered to the GND plane on the **backside**, screwed to the carrier's ground plane. **Primary — 30 A each, 120 A total** |
| **five header ground pins** | two on the power header, **three on U7** (2×7, v3). ~3 A per 2.54 mm post, so ~15 A. Parallel backup |

**The two paths are an order of magnitude apart**, which is what makes "primary"
and "backup" the right words rather than a guess about impedance.

**v3 raised U7 to 2×7 with three grounds**, taking the header total to five. That
matters for more than capacity: at ~15 A the header alone carries the board's
output, so a missing or degraded standoff bond is no longer a single point of
failure. It de-risks the one item still unverified on the carrier side.

The loads are **off-board**: 5 V and 3.3 V leave through the headers and their
return comes back, so the total is the **sum of the off-board rail currents**,
not the input current.

**DC sharing follows resistance, and a 30 A brass standoff beats a 3 A post by
more than a decade.** The standoffs therefore carry nearly all of it.

### With three grounds on U7, placement matters more than count

U7 now carries **two 3.3 V feeds** out and the reference for **five signals** —
three status lines, I²C, and Fault. Three grounds is ample capacity, but they are
one net, so current division cannot be forced electrically. **Pin order does it
geometrically:**

- **Pair each 3.3 V pin with an adjacent GND.** A tight go/return loop lowers
  inductance, cuts radiated noise, and steers that feed's return into the pin
  beside it rather than through the signal reference.
- **Put the third GND inside the signal group**, ideally between I²C and the
  status lines — SCL is a clock edge in a bay with eight coils firing.
- **Do not cluster the three grounds together.** Interleaved beats adjacent for
  exactly the same reason a twisted pair beats two parallel wires.

```
3V3_1  GND   3V3_2  GND   Fault  ENOUT  5_GOOD
GOOD3  SCL   GND    SDA   ...    ...    ...
```

One arrangement, not the only one — the principle is that every power pin has a
return neighbour and the signal group has its own local reference.

### Standoff and screw specification

From the Sinhoo datasheet, `SMTSO`-`30`-`100` decodes as **M3×0.5, 10.0 mm long**:

| | |
|---|---|
| rated current | **30 A** |
| **max tightening torque** | **5 kgf·cm = 0.49 N·m ≈ 4.3 lbf·in** |
| material | **brass C3604 (H59)** — stated because a current is rated |
| min. solder pad OD | **6.2 mm** |
| hole size in sheet | 4.22 mm (+0.08) |
| min. sheet thickness | 1.53 mm |
| process | **reflow only — wave soldering is not applicable** |

> **The torque is a maximum, not a target.** The datasheet is explicit that
> exceeding it destroys the element *and the PCB*. At 0.49 N·m this is finger-tight
> with a driver, not a wrench — and it is the one assembly step that can crack the
> board it is supposed to be grounding.

**The four M3 screws belong in the BOM** — they are not incidental hardware, they
are what closes the primary ground return.

| | |
|---|---|
| thread | M3×0.5 |
| length | **6 mm** (≈4 mm engagement through a 1.6 mm carrier plus a washer). 8 mm is better engagement and still safe |
| **never** | ≥10 mm — the screw would bottom against the POWER board and jack the joint apart, prying on the solder fillet |
| head | pan or socket cap, with a flat washer to spread clamp load |
| plating | nickel-plated steel or brass mates with brass C3604 better than bare stainless. [`enclosure.md`](enclosure.md) puts the ECU in the cabin, so this is modest — but one end straddles the firewall |

### Reflow: paste the annulus, not the pad

The soldered face is a **tube, not a disc**. With a 5.56 mm OD over an M3 bore the
contact annulus is only about **19 mm²**, and the 6.2 mm pad exists to leave a
fillet outside it.

**Cut the aperture as a segmented annulus, not a solid circle.**

| why | |
|---|---|
| **flux has to escape** | a flat brass face on a flat pad is the QFN thermal-pad voiding problem at 5.5 mm scale — volatiles trapped mid-joint have nowhere to go. Arc segments give them channels |
| **volume control** | a full-disc deposit floats the part and squeezes out |
| **keep paste out of the bore** | the datasheet warns that solder wicking blocks the inner hole. Wick into the M3 thread and the screw will not enter — discovered at final assembly, on the joint that *is* the ground return. Make the aperture ID comfortably larger than the thread |

### Reflow: the brass lags, and you cannot see the joint

~1.5 g of C3604 on a 6.2 mm pad is a large mass beside 0402s and a VSON-7. It
reaches liquidus late, or not at all on a profile tuned for the small parts.

**Put a thermocouple on a standoff pad** and confirm it clears liquidus +20–30 °C
while peak on the smallest parts stays in limits. The joint is hidden under the
part, not reworkable without removing it, and a partly-wetted joint still holds
mechanically while carrying a fraction of its rated current.

### Reflow: double-sided order

Backside standoffs mean two passes, and whichever side goes first is inverted and
remelted during the second.

```
standoff inverted:  6.2 mm pad = 0.047 in^2
                    ~30 g/in^2 retention  ->  ~1.4 g held
                    part                  ->  ~1.5 g
```

**Marginal** — verify against the actual part weight. The topside has its own
heavy parts, the two `HV1V567M1010PZ` 560 µF cans at 10.3×10.3 mm and `Q1` in
TO-263, so neither order is free.

**Bolt the standoffs to a scrap plate with the four M3 screws for the
standoff-down pass.** A bolted standoff cannot fall off its pad, and the plate's
mass helps the brass come up to temperature instead of lagging. Watch that it does
not heatsink the board enough to shift the profile — another reason for the
thermocouple.

### Acceptance test

**Milliohm-check each standoff body to the GND plane after reflow.** Four readings
that agree is the pass; one outlier is a joint that did not wet. This is the only
point at which that defect is visible. Undetected, it diverts return current onto
the three header pins — including the one the status lines and the INA238
reference against.

### The electrical joint is compression, not solder

Current crosses **brass end face against the carrier's ground pad**; the screw
supplies clamp force. So the carrier side has to be built for it:

- **Bare exposed metal, ENIG preferred** — flatter and oxide-free, which matters
  for a compression joint in a way it does not for solder.
- **Pad ≥6.2 mm diameter**, matching the datasheet's solder-pad figure. Take the
  exact contact annulus off the dimensional drawing before committing.
- **No soldermask under the contact area**, and plenty of vias into the plane.

### Why both paths matter

A standoff is a **mechanical** joint. Torque relaxation, plating wear, corrosion
and engine-bay vibration degrade it in ways a solder joint does not. The header
pins in parallel are what make the arrangement robust: **lose a standoff and the
return survives.** Neither path alone would be a good design; together they are
redundant by construction.

The four corner bonds also tie the two ground planes together with low inductance
at four distributed points — good for return current, and good for any signal
crossing between boards, which then has a short return path near it.

### Bench caution

**An unmounted board has no standoff return.** Bench measurements therefore run on
a different return topology than the installed board — whatever ground wire is
clipped on at the time. This is structural to testing off the carrier, not a
mistake in any one setup, and it is worth stating before every session.

## Open items

- [ ] **Confirm which header carries the two ground pins.** The BOM has `U8` as
      the INA238 and the 6-pin power header as `U6`; the three-ground split was
      described as "U8 has two, U7 has one". Reconcile the designators before
      this is treated as settled.
- [ ] **Confirm the 104-pin connector allocates multiple pins to GND.** Three
      ground pins on the board accomplish nothing if they funnel into one harness
      pin downstream.
- [ ] **Confirm the carrier has matching ground pads at all four standoff
      positions.** [`carrier-board.md`](carrier-board.md) does not mention them,
      so the primary return path is currently unspecified on the other side —
      bare ENIG, ≥6.2 mm, no mask, well stitched.
- [ ] **Add the four M3×6 screws and washers to the assembly BOM.** No mechanical
      hardware list exists yet; `enclosure.md` has no hardware section.
- [ ] **Measure the return split** between standoffs and header pins under load,
      to confirm the status header's ground is not carrying power current.
