alpauna/TritonECU/hardware/scp-rig/SCP-schematic-review.md

# SCP scanner schematic — review

Against `schematics/SCP-Schematic-V1.zip`, three pages, 2026-09-25.

## Fixed since the first draft

**The front-end RC was comparable to the bit time.** `100k/100k` gives a 50 kΩ
Thevenin source, and the original `MM3Z3V3BW` clamps are *high-capacitance*
parts — a 3.3 V zener runs 200–600 pF:

| | RC | 8 µs pulse reaches | 16 µs reaches |
|---|---|---|---|
| MM3Z3V3BW, ~350 pF | 17.5 µs | **37 %** | 60 % |
| **BAT54S, ~23 pF total** | **1.15 µs** | **99.9 %** | 100 % |

The differential arrangement survives *symmetric* filtering — both inputs are
filtered alike and a matched delay cancels. What it does not survive is the two
pulses settling to **different amplitudes**, which puts the comparator crossing
at different fractions of full swing and distorts exactly the widths the rig
exists to measure.

Fixed with BAT54S rather than by dropping the divider, which keeps the
high-impedance tap: **35 µA** of bus loading instead of the 625 µA a 5.6k/5.6k
divider would have drawn. That matters on a live vehicle bus you do not own.

**The loopback sense was ambiguous and is now correct.** `H1` grounds the Bus−
divider, `H3` injects `LOOP` into Bus+ through 1 kΩ. Driving `LOOP` high puts
`+` above `−` and the output goes high — non-inverting, so the firmware's
8.000/16.000 µs calibration carries over unchanged.

> **⚠ Correction 2026-10-07 — `H1` to GND latches the comparator.** The sense
> is right but the threshold is not: with IN− at 0 V, `R5`'s ±35 mV hysteresis
> puts the falling threshold below 0 V, out of `LOOP`'s reach. On the bench the
> output went high on the first pulse and stayed (GP2 a steady 3.3 V). This
> review checked polarity and missed the threshold. Bench fix: leave `H1` open
> and tie SCP− to 3V3 through **220 k** (IN− = 0.79 V). **Verified: loopback
> passes at 8.058 / 15.877 µs**, the ~90 ns bias from 0.79 V sitting 34 mV under
> mid-swing. Next revision: make `H1` select a **200 k** reference to 3V3
> (IN− = 0.825 V, centred) instead of ground. See the README, Build order
> step 2.

**And it says so on the drawing:**

> *Strapped on Bench but must be removed when connected to vehicle. Both H1 and
> H3 should be open when on vehicle!!!*

That is the failure worth annotating — injecting a test pattern onto a live SCP
bus while the PCM is talking on it.

## C15 — confirmed on the clamp rail

**Confirmed: clamp-rail decoupling for transients**, which is the right place
for it and settles the only blocking question on this page.

It matters because an **LDO can only source, never sink**. When a transient
arrives down the 100 kΩ and the BAT54S upper diode dumps it into the 3.3 V rail,
that current has nowhere to go but the rail's capacitance. `C7` 22 µF and `C8`
10 µF have the *charge* to absorb it — 367 µA of injection for 100 µs moves a
32 µF rail by about 1 mV — but they are across the board with trace inductance
between, so they do not have the *bandwidth* for the edge. `C15` local to the
clamp takes the fast part; the bulk takes the energy.

The alternative was the one worth ruling out. On an **input** node instead:

```
50k Thevenin x 100 nF = 5 ms.  An 8 us pulse reaches 0.16%.
```

Not a degraded signal — no signal, presenting as a dead comparator rather than
as a filter.

## Verified correct

- **`GP2 = RX`, `GP3 = LOOP`** match the firmware. The loopback that validated at
  8.000/16.000 µs runs on this board unchanged.
- **Differential Bus+ vs Bus−** into the comparator, not a single-ended tap.
- **SD in SPI mode**: SPCS→CD/DAT3, MOSI→CMD, MISO→DAT0, SCLK→CLK, pull-ups on
  all five including the unused DAT1/DAT2.
- **`R10` 100 Ω + `D7` SMF3.3** on RX — series limit plus clamp into the Pico.
- **`D2` STTH112A** reverse protection on the OBD feed, and a buck + LDO so the
  Pico's own switcher is not sitting beside the GNSS front end.

## Gerber review — clean

90.55 × 37.34 mm, 2 layer, one outline contour, 51 vias at 0.305, no slots.

**Mounting holes fixed to 2.200 mm.** They were 2.00 — EasyEDA's stock
`Screw-Hole-M2` footprint — which an M2 does not pass:

```
M2 major diameter      1.98 mm
2.00 drill, plated     finishes ~1.90
ISO 273 clearance      2.2 close / 2.4 normal
```

The re-export changed that one entry and nothing else, drill table verified
line by line.

> ⚠ **The [fan controller](../fan-controller) still has 2.00 mm holes** from the
> same footprint, and is the board about to be ordered five up. Worth fixing the
> library part rather than each board.

## Still open

- ~~`3V3_EN` on the Pico socket.~~ **Withdrawn — it is already grounded.** `U3`
  pin 1 lands on Pico pin 40, so the header runs 40, 39, 38, 37: pins **3 and 4
  are GND and `3V3_EN`**, both tied to ground. The internal regulator is
  disabled and 3.3 V is fed into `3V3(OUT)`, which is exactly right. The
  schematic was clear; the reviewer was not.
- **`D3` SMAJ3.3A on the 3.3 V rail.** Its standoff is 3.3 V, i.e. exactly the
  rail, so it sits at the top of its leakage curve. Not wrong, but a 3.6 V part
  would idle cooler.
