alpauna/TritonECU/docs/adc-front-end.md

# Analog front end — AD7606B

> **Corrected 2026-09-09.** This document was headed "AD7606C-16" while its own
> §"Verdict at a 10× price difference" concludes the opposite — *"the ECU should
> take the B-series part now"*, at roughly $5.60 against $55, with the C-series
> reserved for the scope project. The title and the build-facing references were
> wrong; the analysis was right. References to the AD7606C in the comparison
> tables below are deliberate and stay.
>
> **Nothing electrical changes.** Both use a **2.5 V** reference, so the
> MAX6070AAUT25 selected in [`always-on-domain.md`](always-on-domain.md) is
> correct either way, as is the ±10 V scaling and the ±16.5 V clamp assumption.

The part is already on hand, wired to the Teensy 4.1 in
`~/Claude/LxScanner/firmware-teensy` as a bench scope. The driver here is a
port of that bench-validated code (checked against a known ±1.24 V reference,
2026-08-27/28), with the conversion sequence and SPI mode carried over
unchanged because they were proven on hardware.

## Moving it from the Teensy to the P4

Eleven signals plus power. The Teensy build runs VDRIVE at 3.3 V, and the P4 is
also 3.3 V, so **no level shifting is needed** — this is a wire-for-wire move.

| AD7606B signal | Teensy 4.1 | → ESP32-P4 | Notes |
|---|---|---|---|
| SCLK | 13 | **27** | Teensy 13 is also its onboard LED |
| DOUTA (MISO) | 12 | **33** | |
| CS | 16 | **46** | software-driven, not hardware SPI CS |
| CONVST | 14 | **26** | also drives WR on the usual breakouts |
| BUSY | 17 | **28** | |
| RESET | 15 | **29** | |
| FRSTDATA | 18 | **30** | optional — pass −1 if not wired |
| OS0 | 19 | **31** | |
| OS1 | 20 | **47** | |
| OS2 | 21 | **48** | |
| RANGE | 22 | **2** | one setting shared by all 8 channels |
| VDRIVE | 3.3 V | 3.3 V | |
| GND | GND | GND | common ground |

MOSI is not wired. In hardware mode range and oversampling are set by pins
rather than registers, so the P4 opens SPI with MOSI as −1.

~~**In the final ECU, six of these move to the MCP23S17 expander chain**~~ — **the chain is dropped; they take native pins.** Which also removes the DVDD conflict that made them illegal there. Six static lines —
RESET, FRSTDATA, OS0, OS1, OS2 and RANGE are static or near-static, so they do
not deserve native pins. *(Right about which pins; the chain they move to was
specified at 5 V, and DVDD + 0.3 V is 3.6 V —
[`review-expander-chain.md`](review-expander-chain.md) §2.)* That leaves SCK, MISO, CS, CONVST and BUSY, which is
the five the pin budget in `f150-1999-target.md` assumes. The mapping above is
the *bench* mapping, using native pins because nothing else is connected yet.

> **A pre-schematic review of this chain is in
> [`review-analog-chain.md`](review-analog-chain.md).** The eight precision
> channels came out clean; the findings are all on the **internal** ADC, whose
> running demand is **~22 channels** and had never been counted.

## Channel allocation

Eight channels, and they are all spoken for:

| Ch | Signal | Why here |
|---|---|---|
| 0 | MAF signal (+) / return (−) | **differential** — the whole reason for this part |
| 1 | TPS | fast, and ratiometric to VREF |
| 2 | O2 upstream bank 1 | **buffered** — [`review-o2-chain.md`](review-o2-chain.md) §5 |
| 3 | O2 upstream bank 2 | **buffered** — same. These two are what a wideband conversion would reuse for CJ125 `UA` |
| 4 | CHT — cylinder head temperature | |
| 5 | IAT — intake air temperature | |
| 6 | Battery voltage | via **150 k / 33 k** divider — see below; injector dead-time compensation |
| 7 | **VREF sense** | sensors are ratiometric, and this ADC is not — see below |

Moved to the **STM32's own ADC** because they are slow and not fuelling-critical:
DPFE, TFT, downstream O2 ×2, fuel pump monitor. *(The "P4" here is stale — the
platform moved to the STM32F767ZI.)*

**This document owns the channel allocation** — for both converters. Where
[`f150-1999-target.md`](f150-1999-target.md) §3 lists signals, it is an
inventory; the allocation lives here.

## The internal ADC budget

Not "plentiful". Counted:

| | |
|---|--:|
| ADC1/2/3 shared inputs, PA0–PA7 / PB0–PB1 / PC0–PC5 | 16 |
| ADC3-only inputs, PF3–PF10 | 8 |
| **Total ADC-capable pins** | **24** |
| Consumed by **Ethernet RMII** — PA1, PA2, PA7, PC1, PC4, PC5 | **−6** |
| **Available** | **18** |

The Ethernet collision is real and already visible in the firmware:
`Board.h` lists the RMII pins, and six of them are `ADC123_IN1`, `IN2`, `IN7`,
`IN11`, `IN14`, `IN15`.

> **[CONFIRM]** the 24 against the F767ZI datasheet's pinout for this package,
> and against anything else already claiming those pins.

### Demand, after the reduction below

| Demand | Ch |
|---|--:|
| DPFE, TFT, downstream O2 ×2, fuel pump monitor | 5 |
| **TR3A** — three-state, 4R100 codes it with an internal 270 Ω ([`4r100-deltas.md`](4r100-deltas.md)) | **1** |
| VREF `CS` current sense | 1 |
| VREF feed short-to-battery sense — **one feed, not two** | 1 |
| Output drain sense — **six, not thirteen** | 6 |
| 1138 / 391 solenoid supply sense | 2 |
| **Total** | **16** |

**23 before, 16 after, against 18 available** — two spare.

### Which outputs get drain sense, and what replaces it on the rest

The first count put drain sense on all thirteen NCV8405A/NCV8408B channels.
**Most of them already have better feedback than a drain voltage**, so sensing
the drain was buying a second opinion at the cost of a channel and a pin:

| Load | Drain sense | Why |
|---|:--:|---|
| **HO2S heaters ×4** | **yes** | OBD-II heater circuit monitor. Nothing else sees the heater |
| **EVAP purge** | **yes** | OBD-II EVAP monitor |
| **Canister vent** | **yes** | OBD-II EVAP monitor |
| EGR regulator | no | **DPFE is the feedback** — measuring EGR flow is what it is for |
| SSA, SSB | no | gear-ratio mismatch: commanded gear vs RPM vs OSS |
| TCC | no | converter slip: RPM vs OSS |
| EPC | no | the **NCV8408B's gate-current flag**, which needs no PWM-synchronised sample |
| IAC | no | idle speed error is the feedback |
| IMCC | no | no OBD requirement, and no cheap alternative — accepted, not solved |

Only IMCC loses diagnosis outright, and it is the one load with neither a
regulatory requirement nor a natural feedback path.

**Four O2 sensors, and the split matches what each is for.** Ford's diagrams
confirm four: **#11 / #21 upstream** on 391 RD/YE, **#12 / #22 downstream** on
1138 VT/WH. The upstream pair is fuelling and sits on this converter; the
downstream pair is catalyst monitoring and is slow enough for the internal ADC.

> **All four need a unity-gain buffer**, which the split above does not change
> but does not provide either — a zirconia cell is high-impedance and both
> converters load it, the internal one worse because it is switched-capacitor.
> [`review-o2-chain.md`](review-o2-chain.md) §1.
>
> **If the upstream pair goes wideband**, channels 2 and 3 carry CJ125 `UA`
> instead, and `UR` ×2 comes out of the internal spare below — 17 of 18, one
> spare. Recorded here because **this document owns both allocations**.

Knock (C103) is **not** on this ADC as a routine channel — it is a piezo
needing a charge amplifier and windowed sampling around each combustion event.
See `1999-Ford-F150-4wd-5.42v/oem-connectors.md`.

## Why channel 7 is spent on VREF

The AD7606B measures against a 2.5 V reference. Every
three-wire sensor on the truck is **ratiometric to VREF** — a TPS reports a
*fraction* of VREF, not an absolute voltage. The two references are unrelated,
so a 1 % VREF error reads as a 1 % throttle error.

Sampling VREF on channel 7 and dividing in software cancels it exactly, because
simultaneous sampling means VREF and the sensor are captured at the *same
instant* — a sequential ADC would leave a residual error whenever VREF moved
between the two conversions. That property is worth the channel.

## Scaling

| Range | Volts per count |
|---|---|
| ±10 V | 305.18 µV |
| ±5 V | 152.59 µV |

**±10 V is forced, not chosen.** `RANGE` is one setting for all eight channels
and **channel 7 carries VREF at 5.00 V** — on a ±5 V range that is exactly full
scale, so any tolerance or overshoot clips the one signal that must never clip.
Recorded so it is not later "optimised" to ±5 V.

±10 V takes 0–5 V sensors directly with headroom for overshoot. ±5 V doubles
the resolution but leaves no margin — worth switching to only once every input
is known to be well-behaved.

Battery voltage exceeds both ranges and needs a divider regardless.

## SPI mode: MODE2 on the ESP32, not MODE0

**The SPI mode did not carry over from the Teensy**, and this is the one thing
in the port that could not have been assumed.

The Teensy build validated **SPI_MODE0** against a known ±1.24 V reference,
after first trying MODE1 and finding a consistent ~2× error. Ported unchanged to
the ESP32-P4, MODE0 produced exactly the same 2× error — modes 0, 1 and 3 all
read double.

Swept against two independently known signals on 2026-09-06:

| Mode | V1 (true ±1.22 V) | V8 (true 0–2 V) |
|---|---|---|
| MODE0 | −2.61 … +2.56 | −0.14 … +4.00 |
| MODE1 | −2.61 … +2.57 | −0.14 … +4.00 |
| **MODE2** | **−1.30 … +1.29** | **−0.07 … +2.00** |
| MODE3 | −2.61 … +2.57 | −0.13 … +4.00 |

**The mode is a property of the host/ADC pairing, not of the AD7606.** A wrong
CPHA shifts every sampled bit by one clock edge, which is mathematically a
doubling — smooth, stable, repeatable and completely wrong, which is what makes
it dangerous. Re-establish it against a known signal on any new host rather than
carrying it over.

`pio run -e spisweep -t upload` sweeps all four and prints each channel's
envelope.

## Why a square wave reads lower than a scope shows

A 1 kHz square measured at 2.23 V peak on a scope reads about 2.00 V here. That
is the ADC being right, not wrong: the **second-order anti-aliasing filter at
−3 dB / 22 kHz is permanently in circuit**, and a square wave's overshoot and
ringing live in harmonics well above that. The filter rounds the corners and the
ADC never sees the spike a wide-bandwidth scope captures.

In a truck this is the point — it is what stops injector and coil transients
aliasing down into the fuelling signal. Do not calibrate it out.

**Calibrate against DC**, not a square wave: a sampled square gives no guarantee
of catching the true peak.

## Bench verification before it goes near the truck

1. Short an input to ground — expect 0 counts ±noise.
2. Apply a known bench voltage to each channel in turn and confirm within 1 %.
3. Check the differential pair: drive both inputs from the same source and
   confirm the reading collapses to near zero. This is the property the MAF
   depends on, and it is the one that silently does not work if a −IN is
   accidentally grounded.
4. Confirm BUSY actually rises and falls.

**Correction, from the bench.** An earlier version of this document claimed
`begin()` would fail on a BUSY timeout rather than reporting zeros. It did not.
With nothing connected, BUSY floats **low**, so the wait-for-BUSY-to-fall
returned immediately; MISO floated high, every channel read `0xFFFF`, and the
firmware cheerfully announced "AD7606 responding" with a plausible −0.0003 V on
all eight channels.

Two checks now guard it, and both were added because the obvious one failed:

- **BUSY must be seen to RISE** after CONVST, not merely be low. The probe runs
  at ×64 oversampling so the conversion takes ~255 µs instead of ~3 µs, making
  the high period impossible to miss.
- **All eight channels reading an identical `0x0000` or `0xFFFF`** is treated as
  a floating DOUTA rather than data. Real inputs, even grounded ones, disagree
  in the low bits from noise alone.

---

## Does the ECU need 1 MSPS? No — 200 kSPS is enough

The AD7606C-16 and -18 are **1 MSPS on all channels** (verified from the
datasheets). The original **AD7606 is 200 kSPS** and cheaper. That is still
comfortably more than this application needs, for both the routine channels and
knock.

### Routine sensor channels

At 6000 rpm on an eight-cylinder four-stroke:

```
combustion events/s = (6000 / 60) x 8 / 2 = 400 /s
```

One sample set per event is 400 Hz. Sampling four times per event for decent
transient resolution is 1.6 kHz. Call it **2 kHz per channel**, generously.

Every one of these is simultaneous on this part, so 2 kHz of all eight channels
is 2 kSPS of the ADC's 200 kSPS — about **1 % utilisation**. The temperatures
and O2 sensors want a tenth of that. There is no argument for 1 MSPS here.

### Knock

Knock rings around **6–8 kHz** on a 3.55″ bore. Nyquist is 16 kSPS; a usable
FFT wants 4–10× the frequency of interest, so **40–80 kSPS**. At 200 kSPS that
is 25× oversampling of an 8 kHz signal — ample.

The knock window is short. At 6000 rpm a 30° window is about 0.8 ms, so 100
kSPS yields ~80 samples per window per cylinder. Workable.

### The real bottleneck is SPI, not the ADC

At 200 kSPS × 8 channels × 16 bits the bus would have to carry **25.6 Mbit/s**.
The current 8 MHz SPI cannot do that, and it does not have to — the two jobs
run at different rates:

| Job | Rate | Channels read | Bus load at 8 MHz |
|---|---|---|---|
| Routine sensors | 2 kHz | all 8 | 256 kbit/s — 3 % |
| Knock burst | 100 kHz | **1** | 1.6 Mbit/s — 20 % |

The AD7606 family clocks its channels out sequentially on DOUTA, so a knock
burst reads **one** 16-bit word and raises CS rather than clocking all eight.
That is what keeps a 100 kSPS knock window affordable on a modest SPI clock.
It does mean **knock should sit on channel 0**, so its word arrives first.

## Which part — and a naming trap worth knowing about

Three generations share one footprint:

| | AD7606 | AD7606**B** | AD7606**C**-16 |
|---|---|---|---|
| Throughput | 200 kSPS | 800 kSPS | 1 MSPS |
| Operating temp | **−40 to +85 °C** | −40 to **+125 °C** | −40 to +125 °C |
| Input clamp | ±16.5 V | **±21 V** | ±21 V |
| Input impedance | 1 MΩ | 5 MΩ | 5 MΩ (lower drift) |
| VDRIVE floor | 2.3 V | 1.71 V | 1.71 V |
| Software/register mode | no | yes | yes |
| Per-channel range | no | no | **yes** |
| On-chip diagnostics | no | yes | yes |

### The trap: "AD7606BSTZ" is not "AD7606B"

The `B` in **AD7606BSTZ** is a *grade letter* in the original AD7606's ordering
code (B grade, ST = LQFP-64, Z = RoHS). The **AD7606B** is a different, newer,
faster part. The two look almost identical in a parts listing.

The Tokmas datasheet on file (`~/Documents/Tokmas AD7606B-Datasheer.pdf`) is
headed **AD7606BSTZ**, and its specifications are the original AD7606's:

- 16-bit, **200 kSPS** on all channels
- **±16.5 V** input clamp
- **1 MΩ** input impedance
- **−40 °C to +85 °C**
- VDRIVE 2.3–5 V, AVDD 4.75–5.25 V

So this is an AD7606-class part at an AD7606B-sounding part number. That is not
necessarily misrepresentation — it is the correct ordering code for what it is
— but it is easy to read as the 800 kSPS part.

ADI themselves warn about the sharper version of this: because all three are
**footprint-identical**, a re-marked 200 kSPS AD7606 can be sold as an 800 kSPS
AD7606B and pass visual inspection. If throughput ever actually mattered, it
would need measuring rather than trusting the marking. Here it does not.

### Verdict at a 10× price difference

**Use the cheap part.** At roughly $5.60 against $55, and with the throughput
analysis above showing ~1 % utilisation, the AD7606C's advantages do not come
close to justifying ten times the price for this build.

The clamp question raised earlier is **resolved in its favour**: ±16.5 V is
present, along with 1 MΩ input impedance, 8 kV ESD protection on the analog
inputs, and a second-order anti-aliasing filter at −3 dB / 22 kHz. That is the
protection package that makes this family suit an automotive harness, and the
cheap part has it.

Two things to weigh before ordering:

1. ~~**Temperature: −40 to +85 °C, not +125 °C.**~~ **Wrong — struck.** The
   ADS8588H specifies min/max over **T<sub>A</sub> = −40 to +125 °C**, and
   Recommended Operating Conditions gives the same. The only 85 °C limit is a
   condition on I<sub>AVDD_PWR_DN</sub>, the power-down leakage spec. The
   **AD7606B bench part** is the 85 °C device, which is the likely source of the
   mix-up. **This ADC does not rule out an under-hood enclosure** —
   [`review-expander-chain.md`](review-expander-chain.md) §8. **[CONFIRM]** the
   intended mounting location anyway, because the MCP23S17 was 125 °C-rated only
   at V<sub>DD</sub> ≥ 4.5 V and the review recommends running it at 3.3 V.
2. **1 MΩ input impedance, not 5 MΩ.** It loads the source slightly. Irrelevant
   for low-impedance sensors, but the battery-voltage divider should be stiff
   enough that 1 MΩ across it does not shift the ratio — keep the divider
   resistances well under 100 kΩ.

Neither is a reason to spend the extra $50.

### The battery-sense divider

**This document owns the divider value: ~~150 kΩ / 33 kΩ~~ 180 kΩ / 30 kΩ,
and it now hangs on the battery lead, not the protected rail.**

> ⚠ **Both the value and the node changed**, and the node moved twice. **It now
> hangs on EEC-V pin 55** — circuit 729 RD/WH, Central Junction Box, hot at all
> times — not on the always-on lead. A sense-only divider draws 67 µA, at which
> the CJB path that ruled pin 55 out as a *power* source costs 11 µV. See
> [`1999-Ford-F150-4wd-5.42v/schematic-findings.md`](1999-Ford-F150-4wd-5.42v/schematic-findings.md) §19.
> The headroom sizing below is unchanged and still governs. See [`always-on-domain.md`](always-on-domain.md#the-kapwr-feed-where-the-constant-12-v-comes-from).
> Placed downstream of the always-on feed's blocking diode and 470 Ω, this
> divider read **0.51 V low when parked, with a load-dependent correction** — an
> error that reads as a weak battery for a year. Moved **upstream**, to the
> battery lead itself, it reads true battery voltage and the correction vanishes.
> But upstream also means it **leaves the LTC4364's 27 V clamp behind**, and the
> sizing below was done against that clamp.

It has two masters that pull opposite ways, and neither document could see both.
It sits on a **permanently powered** node, so its current is pure parasitic drain
and [`always-on-domain.md`](always-on-domain.md) wants it high-impedance. It
feeds a **1 MΩ resistive** ADC input, so its source impedance becomes a gain
error and the paragraph above wants it low-impedance. The value belongs here,
next to the R<sub>IN</sub> spec that decides it.

R<sub>IN</sub> is **0.85 / 1 / 1.15 MΩ** — ±15 %. That tolerance is what matters.
The nominal loading error is a fixed gain term and can be calibrated out; the
±15 % spread cannot, because it varies part to part:

**The new constraint is headroom.** On the protected rail the worst case was the
LTC4364's **27 V** clamp. On the battery lead it is the **SMDJ43A's clamping
voltage, 69.4 V** — and the channel is on the forced **±10 V** range:

| Divider | Ratio | At 14 V | **At 69.4 V** | Sleep at 14 V | Z<sub>src</sub> | **Spread** | at 14 V |
|---|--:|--:|--:|--:|--:|--:|--:|
| ~~150 k / 33 k~~ | 5.545 | 2.525 V | **12.52 V — over range** | 76.5 µA | 27.0 kΩ | ±0.79 % | ±110 mV |
| 160 k / 27 k | 6.926 | 2.021 V | **10.02 V — over range** | 74.9 µA | 23.1 kΩ | ±0.68 % | ±95 mV |
| **180 k / 30 k** | **7.000** | **2.000 V** | **9.914 V ✓** | **66.7 µA** | **25.7 kΩ** | **±0.75 %** | **±105 mV** |
| 200 k / 30 k | 7.667 | 1.826 V | 9.052 V ✓ | 60.9 µA | 26.1 kΩ | ±0.76 % | ±106 mV |
| 220 k / 33 k | 7.667 | 1.826 V | 9.052 V ✓ | 55.3 µA | 28.7 kΩ | ±0.83 % | ±116 mV |

**180 k / 30 k, ratio exactly 7.000.** Unusually, it beats the incumbent on
*every* axis rather than trading one against another — more headroom, less drain,
lower Z<sub>src</sub> and therefore a smaller uncalibratable spread.

The headroom column is the one that decides it. **At 150 k / 33 k the channel
would go over range at 12.5 V during a load dump — losing the measurement during
exactly the event you would want it for.** The old value was not wrong; it was
sized against a 27 V worst case that no longer applies.

It also **clips at 70 V, just above where the SMDJ43A clamps** — so the ADC range
covers the whole survivable envelope and nothing beyond it.

Two things follow from the choice:

- **Ratio is exactly 7.000**, which is a pleasant calibration constant, and one
  LSB is **2.1 mV** referred to the battery against a **0.1 V** resolution
  target — not close to binding.
- **This channel stays unbuffered**, so unlike the four O2 channels it keeps the
  ADS8588H's **9 kV input clamp**. The 180 kΩ top leg limits the harness to
  ≤ 0.5 mA at any plausible transient, so the clamp is never stressed —
  [`o2-input-stage.md`](o2-input-stage.md) §2 had to add a BAT54S only because a
  buffer moved that boundary.
- **Reverse battery reads as −1.71 V**, inside the bipolar range. The ±10 V
  setting, chosen for other reasons, makes a reversed-battery condition
  *diagnosable* rather than merely survivable.
- **Do not add a filter capacitor here.**
  [`review-ignition-injection.md`](review-ignition-injection.md) requires
  battery voltage to be **sampled away from injection events, not averaged
  through them**. A cap at a 27 kΩ node defeats exactly that. The ADC's own
  22 kHz anti-aliasing filter is already present and is enough.

> **Note the shape of this.** `review-power-chain.md` §2 proposed 470 k / 100 k,
> and the "well under 100 kΩ" sentence ruling it out was already written in this
> document. One more number that was correct where it lived and wrong where it
> was spent. Hence the ownership line at the top of this section.

> **And it happened again, one level up.** This section then sized the divider
> against *"the LTC4364's 27 V clamp"* — correct for where the divider sat, and
> wrong the moment the always-on feed moved it to the battery lead. **The
> ownership line does not protect a value whose *node* changes underneath it.**

---

## Oversampling is global, so do the averaging in software

The hardware oversampling pins trade throughput for noise, and the conversion
time scales with the ratio (typical values from the datasheet):

| OS | Conversion time | Max throughput |
|---|---|---|
| off | 2.9 µs | 200 kSPS (spec limit) |
| ×2 | 7 µs | ~143 kSPS |
| ×4 | 15 µs | ~67 kSPS |
| ×8 | 31 µs | ~32 kSPS |
| ×16 | 63 µs | ~16 kSPS |
| ×32 | 127 µs | ~7.9 kSPS |
| ×64 | 255 µs | ~3.9 kSPS |

**OS0–2 are one setting shared by all eight channels.** There is no way to
oversample the slow sensors while sampling knock fast — at ×16 the whole part
drops to ~16 kSPS, which is at Nyquist for an 8 kHz knock signal and useless
for an FFT.

So: **run with oversampling off and average in software.** Averaging N samples
gives the same √N noise reduction as hardware oversampling, applied per channel
at whatever depth each one deserves — heavy on coolant temperature, none on
knock. The cost is SPI traffic and a little CPU, both of which there is plenty
of.

Nothing is lost in anti-aliasing by doing this: the second-order analog filter
at 22 kHz is always in circuit and is independent of the OS setting. The
digital filter was only ever noise averaging, and software does that just as
well with far more control.

---

## Which part is actually on the bench? Measure BUSY.

The part bought for the Teensy scope turned out to be a **B-series, not a C**.
For the scope that is a real setback — a scope's whole value is bandwidth, and
200 kSPS against 1 MSPS is a fivefold cut. For this ECU it changes nothing: the
throughput analysis above puts utilisation around 1 % either way.

**So the ECU should take the B-series part now**, rather than waiting behind a
new C-series board. The scope gets the C when that PCB exists. The part that
disappointed one project is the correct choice for the other.

### Identifying it without buying anything

There is still a question worth answering: is it a genuine 800 kSPS AD7606B, or
an AD7606-class 200 kSPS part in AD7606B-looking clothing? The Tokmas datasheet
on file is headed `AD7606BSTZ` but specifies 200 kSPS — and ADI warn that all
three generations are footprint-identical, so a re-marked part passes visual
inspection.

**Conversion time settles it, and the Teensy rig can already measure it.** Time
the BUSY pulse — CONVST rising to BUSY falling — with oversampling off:

| Part | Conversion time, OS off | Implied throughput |
|---|---|---|
| AD7606 (200 kSPS) | **~2.9 µs** typ (2.6–3.2) | 200 kSPS |
| AD7606B (800 kSPS) | **~1.25 µs** | 800 kSPS |

More than a 2× separation, far wider than any measurement error on a Teensy 4.1
with `micros()` — or better, capture BUSY on a scope channel directly.

Two supporting checks that need no instrumentation, both from the datasheet
differences:

- **Input impedance.** 1 MΩ (AD7606) vs 5 MΩ (AD7606B). Measurable with a known
  series resistor and a DC input: the divider ratio reveals which.
- **VDRIVE floor.** The AD7606B runs down to 1.71 V, the AD7606 only to 2.3 V.
  Not worth testing deliberately, but relevant if 1.8 V logic were ever wanted.

Whatever it turns out to be, **both are adequate here**. The measurement matters
for knowing what was actually bought — and for deciding whether the same
supplier is worth using again for the scope's C-series part, where the
difference is the whole point.

### The ADS8588S is a verified pin-for-pin second source

TI's **ADS8588S** was checked against the Tokmas AD7606-class datasheet on file,
pin by pin across all 64. **They are identical** — the only differences are
naming:

| Pin | AD7606 | ADS8588S |
|---|---|---|
| 3, 4, 5 | OS0, OS1, OS2 | same |
| 6 | PAR/SER/BYTE SEL | same |
| 7, 8 | STBY, RANGE | same |
| **9, 10** | **CONVSTA, CONVSTB** | **same** |
| 11–15 | RESET, RD/SCLK, CS, BUSY, FRSTDATA | same |
| 16–22 | DB[6:0] | same |
| 23 | DVDD | same |
| 24, 25 | DB7/DOUTA, DB8/DOUTB | same |
| 27–33 | DB[13:9], DB14/HBEN, DB15/BYTE SEL | same |
| 34 | REF_SELECT | REFSEL *(name only)* |
| 36, 39 | REGCAP1, REGCAP2 | same |
| 42–46 | REFIN/REFOUT, REFGND, REFCAPA/B | same |
| 49–64 | V1…V8 + V*GND | AIN_1P…AIN_8P + AIN_*GND *(name only)* |

**Note pins 9 and 10 are CONVSTA/CONVSTB**, matching the original AD7606 rather
than the AD7606C's CONVST/WR. So the shorting advice below applies unchanged and
the WR hazard does not arise at all.

### What it adds

| | AD7606 (200 kSPS) | ADS8588S |
|---|---|---|
| Resolution / channels | 16-bit, 8 simultaneous | same |
| Throughput | 200 kSPS | 200 kSPS |
| Input | ±10 V / ±5 V, 1 MΩ | same |
| Internal reference | 2.5 V | 2.5 V, 7.5 ppm/°C |
| Package | LQFP-64, 10 × 10 mm | same |
| **Operating temp** | **−40 to +85 °C** | **−40 to +125 °C** |
| Input ESD | clamp | clamp + **7 kV** |
| Vendor | ADI (and clones) | **TI** |

It is **not** a substitute for the AD7606B on throughput — both are 200 kSPS —
but the throughput analysis above puts utilisation near 1 %, so that is not a
axis that matters here.

### Why this is worth having: it is not about temperature

The ECU is **cabin-mounted**, so +125 °C buys nothing today, and the genuine
AD7606B already reaches it. The value is elsewhere:

- **Second source from a different vendor.** For a controller meant to outlive
  the PCM it replaces, having ADI *and* TI able to supply the centre of the
  analog front end is worth more than any spec on the list.
- **It sidesteps the `AD7606BSTZ` naming trap entirely.** TI's part number means
  one thing. No grade-letter collision, and none of the re-marking exposure ADI
  themselves warn about on footprint-identical parts.
- **7 kV ESD specified on the inputs**, which is the right direction for
  something wired to a 104-pin harness.

### The ADS8588H too — and it is the better of the two

Same check, same result. **ADS8588H is pin-identical**: CONVSTA 9, CONVSTB 10,
FRSTDATA 15, REFSEL 34, REGCAP2 39, AGND 40, in **LQFP-64, 10 × 10 mm**. And it
improves on the S in two places that matter:

| | ADS8588S | **ADS8588H** |
|---|--:|--:|
| Throughput | 200 kSPS | **500 kSPS** |
| Input ESD clamp | 7 kV | **9 kV** |
| Operating temp | −40…+125 °C | −40…+125 °C |

The extra throughput is irrelevant to the ECU at ~1 % utilisation, but **9 kV of
input clamp is not** — these pins run to a 104-pin harness in a vehicle.

### The ADS9324 is NOT a drop-in — it is a different part

It was suggested as "same pinout." **It is not**, and the difference is
structural rather than a pin or two:

| | AD7606 / ADS8588x | **ADS9324** |
|---|---|---|
| Channels | 8 | **16**, differential pairs (AIN1P/AIN1M …) |
| Package | **LQFP-64, 10 × 10 mm** | **VQFN-64, 8 × 8 mm** |
| Analog supply | 5 V | **5 V *and* 1.8 V** |
| Digital I/O | 2.3–5 V | 1.8–3.3 V |
| Signal names | REFIN/REFOUT, BUSY | REFIO, REFCAP, DRDY/ALARM |

Sixty-four pins on both is a coincidence of count, not of arrangement. Different
package *type*, different body size, twice the channels, and **an AVDD_1V8 rail
this board does not generate**. Designing the footprint expecting it to drop in
would not be a rework — it would be a new board.

**It is genuinely interesting for the scope board though**: 16 channels at
1 MSPS, ±12.5 V differential with ±12.5 V common mode, selectable 25 kHz/325 kHz
analog bandwidth, and open-wire detection that drives floating inputs to near-zero
code. That is a data-acquisition part, and the scope board is a data-acquisition
project. Just not this footprint. *(Datasheet is December 2025 — check
availability.)*

### Decision: do not choose — the footprint already takes four parts

Since they are pin-for-pin, this is a **populate-time decision, not a layout one**.
One LQFP-64 footprint now accepts:

| Part | Vendor | Throughput | Temp |
|---|---|--:|---|
| AD7606 | ADI | 200 kSPS | −40…+85 °C |
| AD7606B | ADI | 800 kSPS | −40…+125 °C |
| AD7606C-16/18 | ADI | 1 MSPS | −40…+125 °C |
| **ADS8588S** | **TI** | 200 kSPS | −40…+125 °C |
| **ADS8588H** | **TI** | 500 kSPS | −40…+125 °C |

**Five parts, two vendors, 200 kSPS to 1 MSPS, on one layout.** Draw it once and
buy whatever is available and cheapest that week. That is genuine supply
resilience at zero cost, which is the best kind there is.

### Settled: ADS8588H in production, AD7606BSTZ on the bench

| | part | why |
|---|---|---|
| **Production** | **ADS8588H** | 9 kV input clamp — the best of the set, on pins wired to a 104-pin harness. 500 kSPS and +125 °C come free at the same pinout |
| **Bench** | **Tokmas AD7606BSTZ** | already in hand and already verified working. 200 kSPS and +85 °C are irrelevant on a bench |

**This costs nothing to maintain**, which is the point of having done the pin
verification. The footprint is identical, the serial interface is identical, and
the driver does not change — so development continues on the part already on the
desk while production gets the better clamp.

Two things to carry into the first production build:

- **[VERIFY] `REF_SELECT` polarity** between the two, as flagged above. The
  ADS8588H selects the internal reference on logic **high**.
- **Do not chase throughput.** The ADS8588H's 500 kSPS changes nothing here —
  utilisation stays near 1 %. It was chosen for the clamp.

**[VERIFY] before first populate:** `REF_SELECT` polarity. The ADS8588S is
explicit — logic **high** selects the internal reference. Confirm the AD7606 uses
the same sense before assuming a strap serves both parts, because getting it
backwards powers down the reference rather than failing loudly.

### One footprint, but not identical pin functions

All three generations are **LQFP-64 and footprint-compatible**, so one PCB
layout can serve both projects — the ECU board populating a B, the scope board a
C. Worth drawing once, properly, with the input protection and decoupling the
datasheets ask for.

But **footprint-compatible is not function-identical**. Comparing the Tokmas
AD7606-class datasheet against the AD7606C-16 datasheet:

| Pin | AD7606 (200 kSPS) | AD7606C-16 | Matters? |
|---|---|---|---|
| **9, 10** | **CONVSTA, CONVSTB** — two conversion-start inputs | **CONVST (9), WR (10)** — WR is the parallel write strobe | **Yes — see below** |
| 3–5 | OS0–OS2, oversampling only | OS0–OS2, and one code **selects software mode** | Yes |
| 6 | PAR/SER/**BYTE** SEL | PAR/SER SEL — no byte mode | Minor |
| 7 | STBY (with RANGE, selects power-down mode) | STBY **ignored in software mode**; tie high | Minor |
| 8 | RANGE | RANGE **ignored in software mode**, but must still be tied | Minor |
| 19–22 | DB3–DB6 / DOUTE–DOUTH in serial | same | No |
| 23 | VDRIVE 2.3–5 V | VDRIVE **1.71**–5.25 V | No |

**The pin 9/10 difference is the one to get right.** Standard AD7606 practice is
to short CONVSTA and CONVSTB together so all eight channels sample
simultaneously — which is what the existing breakout does (the Teensy driver
notes CONVST "also drives WR via the breakout's own tie").

On an AD7606C those same two pads are CONVST and WR. That is **safe**: the C's
datasheet explicitly permits WR to be "tied high, tied low, or shorted to
CONVST" in hardware mode, and WR is unused entirely over the serial interface.

So a board that shorts 9 and 10 works with either part — as long as it is
driven over SPI, or in hardware mode. It would only break if a C were later run
in **software mode over the parallel interface**, where WR becomes an active-low
register write strobe and shorting it to CONVST would corrupt every write.

Since this design uses the serial interface throughout, shorting them is fine.
Worth a jumper or a 0 Ω link rather than a hard trace, so the scope board keeps
the option of software mode later.

**AD7606C-16 and AD7606C-18 are pin-identical to each other**, so an 18-bit
upgrade on the scope board is a populate-different-part change with no layout
work.

### If it is the 200 kSPS part, the only constraint that bites

Operating temperature: **−40 to +85 °C**, against −40 to +125 °C for the
AD7606B and C. That decides mounting location, not performance. The OEM PCM on
this truck sits in the cabin, so 85 °C is very likely fine — but it rules out an
under-hood enclosure. **[CONFIRM]** where the ECU will live before committing
to an enclosure design.

---

## PCB notes: serial mode, and why the pull-downs matter

### Serial data outputs differ substantially

| | AD7606 (200 kSPS) | AD7606C-16 |
|---|---|---|
| Serial outputs | **DOUTA (24), DOUTB (25)** — two lines | **DOUTA (24), DOUTB (25), DOUTC (27), DOUTD (28), DOUTE (19), DOUTF (20), DOUTG (21), DOUTH (22)** — eight |
| Serial data **input** | none | **DB11/SDI (29)** — register writes in software mode |
| Byte-mode pins | DB14/**HBEN** (32), DB15/**BYTE SEL** (33) | plain DB14, DB15 — byte mode dropped |

The C can stream all eight channels on eight separate lines simultaneously,
which is how it sustains 1 MSPS. Reading a single DOUTA works on both parts, so
a design that uses only DOUTA is portable — it just leaves the C's throughput
on the table, which for this ECU is fine.

**Byte mode is the pin reuse on the AD7606:** with `PAR/SER/BYTE SEL` high and
`DB15/BYTE SEL` high, the part enters parallel *byte* mode and `DB14/HBEN`
selects whether the **high byte or the low byte** of the 16-bit result comes out
first on DB[7:0]. The C drops this entirely — those pins are plain data bits.

### Pins that must be tied in serial mode — and the hazard

The AD7606C-16 datasheet is explicit: *"When using the serial interface, tie the
DB0 to DB2 pins to AGND."* (pins 16–18).

On the **AD7606**, those same pads are DB0–DB2, plain **parallel data outputs**.
A board that hard-grounds pins 16–18 for the C, then has an AD7606 populated,
is shorting three digital outputs to ground any time they drive high.

**The 10 kΩ resistor arrays are the correct fix.** A 10 kΩ pull-down satisfies
the C's requirement — it is a logic-level tie, not a current path — while
limiting fault current to about 0.5 mA if an AD7606 ever drives that pin high.
Safe with either part populated, and it keeps one layout genuinely usable for
both projects.

Worth extending the same treatment to every pin whose function differs:

| Pin | Treat how | Why |
|---|---|---|
| 16–18 (DB0–DB2) | **10 kΩ to AGND** | C requires grounding in serial mode; AD7606 drives them |
| 29 (DB11/SDI) | 10 kΩ, and route to MCU MOSI | SDI on the C in software mode; a data output on the AD7606 |
| 19–22 (DB3–DB6 / DOUTE–H) | leave routed, no hard tie | serial outputs on the C, parallel outputs on the AD7606 |
| 9/10 (CONVST, WR) | 0 Ω link, not a hard trace | see the pin 9/10 note above |
| 32, 33 | no hard tie | HBEN / BYTE SEL on the AD7606, plain data on the C |

### Two pins to get right regardless of part

- **REF SELECT (34)** — identical on both. **High selects the internal 2.5 V
  reference.** Tied low, the internal reference is *disabled* and an external
  2.5 V must be supplied on REFIN/REFOUT (42). Leaving this floating or low by
  accident produces a part that converts, but against nothing.
- **REFCAPA (44) / REFCAPB (45)** — must be shorted together and decoupled to
  AGND with a low-ESR 10 µF. They sit at about 4.5 V. REFIN/REFOUT wants its own
  10 µF to REFGND.

### The VxGND pins are what make the MAF measurement work

Each analog input is a **pair**: V1 (49) and V1GND (50), V2 (51) and V2GND, and
so on. The block diagram shows both going into the front-end amplifier as `+`
and `−` through separate input clamps.

The datasheets advise connecting VxGND to the AGND plane, which is right for an
ordinary single-ended sensor. **The MAF is the exception, and the reason this
part was chosen:** MAF signal (circuit 967) to V1, and MAF *signal return*
(circuit 968) to V1GND — not to AGND. That is what cancels the ground drop
caused by the hot-wire's own supply current. See
`1999-Ford-F150-4wd-5.42v/oem-connectors.md`.

~~**[CONFIRM]** the allowable VxGND voltage range relative to AGND before relying
on this.~~ **Confirmed, ADS8588H datasheet SBAS843A §6.5 and §7.3.1:** AIN_nGND
operating range is **±0.3 V** to AGND, both RANGE settings. Each pin is a 1 MΩ
input (0.85–1.15 MΩ), and TI recommends matching any series resistance on
AIN_nP with the same resistance on AIN_nGND to cancel the offset it adds.

- **SIGRTN legs** (TPS, CHT, IAT, VREF sense): SIGRTN is tied to AGND at NT801,
  so the AIN_nGND voltage is board copper drop only. Microvolts.
- **MAF_RTN (968)** is the one that uses the range: it sits at the MAF's ground
  (circuit 570) minus the ECU's. Tens of millivolts expected; **measure the
  968-to-ECU-ground offset while cranking** before relying on 0.3 V of margin.

**On the carrier (2026-10-18):** R853–R856 are the AIN_nGND legs for MAF, TPS,
CHT and IAT, fitted 0R; each takes the value chosen for its AIN_nP series
resistor (`review-analog-chain.md` #4). MAF_RTN additionally gets **D812**
(BAV199 to AGND / +5V_SW, the knock clamp's low-leakage part) and **R857**
(10k to AGND), so an open 968 reads 0 V instead of floating on the 1 MΩ input.
VREF sense has no series resistor, so it takes SIGRTN directly.

---

## Resolution: 18-bit is pointless here, and 16-bit is not really 16-bit

### The datasheet already concedes it

From the Tokmas AD7606 figures, converting to effective number of bits with
`ENOB = (dB − 1.76) / 6.02`:

| Datasheet figure | Value | ENOB |
|---|---|---|
| SNR typ, no oversampling, ±10 V | 87 dB | **14.16 bits** |
| SNR min | 83 dB | 13.50 bits |
| **SINAD typ** (includes distortion) | 84.5 dB | **13.74 bits** |
| SINAD min | 83 dB | 13.50 bits |
| SNR with 64× oversampling | 90 dB | 14.66 bits |

**A 16-bit part delivers about 13.7 effective bits on a lab bench**, before a
single wire is run through an engine bay. The two bits at the bottom are noise
in the part itself.

### And that is the good case

In a truck the limits are elsewhere entirely, all of them larger than
quantisation:

- **Harness pickup.** Eight coil-on-plug primaries and eight injectors switching
  inductive loads, metres from the signal wires. This dominates everything.
- **Sensor noise.** A TPS is a potentiometer with a wiper — contact noise alone
  exceeds 14-bit resolution.
- **VREF.** Every three-wire sensor is ratiometric, so sensor accuracy is capped
  by VREF accuracy. The channel-7 correction cancels VREF *drift*, but not VREF
  *noise*.
- **Ground drop**, even with the Kelvin sense on the MAF.

Realistically **11 to 12 genuinely trustworthy bits** is the target in a
vehicle, and getting there is a wiring, shielding and grounding problem — not a
converter problem.

### How much resolution the sensors actually deserve

| Signal | Useful resolution | Bits needed |
|---|---|---|
| TPS | 0.1 % throttle | ~10 |
| MAF | better than the sensor's own repeatability | ~11 |
| CHT / IAT | 0.5 °C | ~10 |
| O2 narrowband | it is a switching sensor | ~8 |
| Battery voltage | 0.1 V | ~8 |

Nothing on this truck needs more than about 11 bits. At ±10 V a 16-bit LSB is
305 µV, so 0.1 % of throttle travel already spans 16 codes — resolution is not
close to being the limiting factor.

### So why this part at all?

**The front end, not the bit count.** What is actually being bought:

- **±16.5 V input clamps** — survives a harness fault.
- **8 kV ESD** on the analog inputs.
- **1 MΩ input impedance** — does not load the sensors.
- **Second-order anti-aliasing filter at 22 kHz**, always in circuit.
- **True bipolar ±10 V inputs** — 0–5 V sensors connect directly, no scaling.
- **Simultaneous sampling** — which is what makes the VREF correction exact.
- **Paired VxGND inputs** — the only way to measure the MAF correctly.

Any of those matter more in a truck than the difference between 14 and 16 ENOB.
The 18-bit C-18 would add roughly two more bits of lab-bench SNR and nothing at
all that survives the drive home.

### What this means for the software

- **Do not chase resolution.** Software averaging is for rejecting harness
  noise, not for recovering sub-LSB detail that does not exist.
- Averaging 16 samples buys 2 bits against *uncorrelated* noise. Ignition noise
  is **not** uncorrelated — it is periodic with engine position — so averaging
  blindly across a coil event does less than the √N maths promises. Sampling
  *away from* known switching events is worth more than averaging through them.
- Treat anything below about bit 4 of a 16-bit reading as noise, and do not
  build control logic that depends on it.
