alpauna/TritonECU/docs/always-on-domain.md

# Always-on MCU domain

**Proposal:** the MCU never fully powers down. It sleeps on a constant 3.3 V
supply and brings the 5 V rails up only when the engine needs to run.

This is how production ECUs are built, and it is a better answer than anything
in [`power-supply-super-cap.md`](power-supply-super-cap.md).

## What it retires

| Open thread | Status |
|---|---|
| Graceful shutdown before the rails collapse | **gone** — nothing collapses |
| KAPWR replacement for fuel trims and DTCs | **gone** — RAM never loses power |
| Supercapacitor hold-up | **gone** — the requirement that justified it is removed |
| Boot delay at key-on | **gone** — already running |

And it fixes something the review had written off. `schematic-review-power.md`
§"auto-retry" concluded that firmware retry-limiting "cannot be the primary fix,
because the MCU loses its rail." **With an always-on domain the MCU survives the
fault and can count retries, latch SHDN#, and log what happened.** The auto-retry
thermal problem becomes solvable in software after all.

Same for FLT#: the 44 ms warning stops being a race against the MCU's own death
and becomes an ordinary interrupt with plenty of time to shed loads and record
the event.

### NARROWED: one case this does not retire — total loss of both feeds

"Nothing collapses" holds because **KAPWR joins the protected rail**, so an
LTC4364 fault leaves the converters fed and the 3.3 V up. It does **not** hold when
both feeds go at once: connector pull, battery disconnect, main fuse. Then the
1120 µF on `C3`/`C4` is all there is.

```
E = ½C(V1² − V2²)                     ~85 % converter efficiency usable
```

**v3 adds a third 560 µF**, since there is board room and this is the right place
to spend it — energy goes as V², so a µF on the 14 V protected rail is worth about
**8× the same µF on 5 V**. `C3`/`C4`'s position was already optimal.

| ECU load | 1120 µF (v2) | **1680 µF (v3)** |
|---|--:|--:|
| 2 W | 38 ms | **57 ms** |
| **5 W** | 15 ms | **23 ms** |
| 10 W | 7.6 ms | **11 ms** |

**Inrush is not the limit.** `power-supply.md` flagged that TMR must outlast it,
sized then against 1000 µF at a 2 A limit. At the measured 5 A limit:

```
t = C·dV/I = 1680 µF × 14 V / 5 A = 4.7 ms      vs 594 ms TMR
```

Two orders of margin, and Q1's inrush dissipation rises only 0.11 J → 0.165 J per
key-on — brief against the 1 in² of copper already specified.

**The real tradeoff is filter Q.** The v2 review requires these parts stay
electrolytic because their ESR *is* the input filter's damping. Three in parallel
cut ESR to ⅔ while raising C by 1.5×, and both push the same way:

```
Q = (1/R)·sqrt(L/C)   with  C -> nC,  R -> R/n   gives   Q proportional to sqrt(n)
n: 2 -> 3   =>   Q x 1.22
```

**About 22 % more peaking** — near Q ≈ 2.1 if the two-cap figure is 1.7. Still
damped, but it is the one thing that gets worse, so re-run it rather than assume.

**Size the emergency save against the holdup, not against FLT#.** The three fault
modes give completely different warning, and the worst gives none:

| case | warning before the rail falls |
|---|---|
| FLT# overcurrent / TMR timeout | 44 ms — *and the MCU survives anyway, via KAPWR* |
| FLT# overvoltage | **1.12 ms** (`schematic-review-power.md`) |
| **total loss of both feeds** | **none** |

### Do not trigger it from PGOOD

`5_GOOD` **rose again 18.3 ms into the 2026-09-26 fault**, with ENOUT still low and
VBUS at 2.86 V. Open-drain PGOOD releases when the converter loses its own bias and
the pull-up takes it high, so a detector built on PGOOD reads *recovered* partway
through dying. See [`firmware/power-diag/README.md`](../firmware/power-diag/README.md).

The upstream signal is the INA238's VBUS on the protected node — it falls first and
monotonically, and `ADCCFG = 0xB000` already gives 50 µs conversions.

### The threshold cannot discriminate cranking from dying

Both feeds come from the same battery, so a crank dip pulls VBUS down exactly as a
disconnect does. The LTC4364's UV sits at 4.47 V specifically so the board rides
cranking through, and the converters drop out around 6 V — which leaves almost no
room between "cranking, do not panic" and "actually dying."

**So do not try to separate them by voltage.** Make the save cheap and idempotent —
a small record, safe to write on every start — and fire it generously. A false
trigger then costs nothing, which is what buys the freedom to set the threshold
high enough to be useful.

## DECIDED: 3.3 V stays cascaded off 5 V, not fed from VIN

Asked during v3: since the always-on domain keeps **both** converters running with
the key off, would a separate 3.3 V rail direct from VIN be better — letting the
MAX25239 shut down when parked?

**No.** Three reasons, none close:

| | |
|---|---|
| **parked saving** | the MAX25239's 95 µA is ~half the parked total, but the total is 184 µA against a 25 mA vehicle budget. Shutting it off saves **0.34 %** |
| **cranking** | the 5 V rail is a MAX25239 **buck-boost** — it *holds* through a crank sag rather than dropping out, so the TLV62085 always sees a solid input. See [`review-ignition-injection.md`](review-ignition-injection.md) |
| **UV consistency** | the LTC4364's 4.47 V UV is set below the sag on purpose, and the buck-boost is what makes that threshold meaningful |

A cascade off a *regulated* 5 V is a **better** input condition for the TLV62085
than a direct feed off a sagging VIN would be. There is no weakness to fix.

> The table below reads as though it is fighting a constraint. It is not — it was
> written to kill the LTC4364's 750 µA, which **was** 80 % of the total, and that is
> already done. Do not re-optimise the remainder.

**The one genuine cost:** with a cascade, a MAX25239 failure takes 3.3 V and the MCU
with it, so nothing logs which converter died. Independent rails would keep it alive
to report. Not worth another converter, inductor and area for a fault that already
stops the engine.

## The number that decides it: parasitic drain

A parked vehicle tolerates roughly **25–50 mA** total, and the truck has its own
draws before ours.

| Item | Sleep current |
|---|---|
| ~~LTC4364 quiescent~~ | **0 µA** — **unpowered when parked**, see [§ The KAPWR feed](#the-kapwr-feed-where-the-constant-12-v-comes-from) |
| **MAX25239, standby in skip mode** | **95 µA** |
| TLV62085, quiescent | ~17 µA |
| STM32F767 Standby + RTC + backup SRAM | **3 µA** |
| INA238 in shutdown | ~2 µA |
| ADC battery-sense divider, **180 k / 30 k**, **on the battery lead** | **67 µA** |
| **TJA1042T/3 CAN transceiver, Standby** | **≈ 20 µA** (10 µA `VCC` + 5–14 µA `VIO`) |
| **TPS3823A-33 supervisor / watchdog** | **15 µA** typ — the price of the 125 °C grade; the 85 °C parts and the clone draw ~4 µA. Must be on the always-on rail, since an unpowered supervisor holds `NRST` low — [`output-drivers.md`](output-drivers.md#decided-tps3823a-33dbvr-reset-to-nrst-bss138-inverter-to-oe2) |
| **Total** | **≈ 219 µA** |

> ⚠ **This table omits bulk capacitor leakage.** Because KAPWR joins the
> **protected rail**, `C3`/`C4` (and the v3 third cap) sit **energised with the key
> off**. Datasheet-max aluminium leakage runs to tens of µA each — long-soak is far
> lower, but it is not zero and it is not listed.
>
> **Not a blocker:** even at 80 µA per cap this is ~0.3 % of a 25 mA vehicle
> budget. But the table reads as complete when it is not, and the third cap makes
> the missing term 50 % larger. Measure it rather than model it.
>
> **The INA238 cannot make that measurement.** It senses across `R1`, the
> LTC4364's shunt on the **input** side, while KAPWR joins the **protected rail** —
> downstream of the protector and therefore downstream of `R1`. Parked current
> never crosses the shunt, so the on-board ammeter reads **zero** for the one
> current the always-on design most needs to know.
>
> Parked drain has to be metered **in series with the KAPWR feed**, externally.
> This is the session's recurring shape once more: the instrument is on the wrong
> side of the topology to see the thing that matters — see
> [`firmware/power-diag/README.md`](../firmware/power-diag/README.md).

> ⚠ **This table read 944 µA until the feed was defined.** The LTC4364's 750 µA
> was 80 % of it, and it is now zero — with KAPWR joining the **protected rail**
> rather than the LTC4364's input, nothing powers the LTC4364 with the key off.
> **5.1× better, from moving a junction rather than adding parts.**

> **This table is the owner of the sleep budget.** Every other drain figure in
> this document and in [`power-supply.md`](power-supply.md) is working, and
> defers to this one. Two entries were found missing while closing
> [`review-power-chain.md`](review-power-chain.md) §2 — the divider, which that
> review found, and the MAX25239 itself, which it did not.

> ⚠ **The divider was missing from this table.** At the original 47 k / 10 k it
> draws **246 µA — 31 % of the whole budget**, and unlike everything else here it
> cannot be gated away by the 5 V rail going down: it is a resistor to ground on
> a live rail. Raised to ~~150 k / 33 k~~ **180 k / 30 k** it is **67 µA**. The value is chosen in
> [`adc-front-end.md`](adc-front-end.md#the-battery-sense-divider), which owns
> it — this table only spends it. See
> [`review-power-chain.md`](review-power-chain.md) §2.
>
> ⚠ **The MAX25239 was missing too**, and it is the larger of the two at 95 µA.
> The line above said *"the MCU never fully powers down"* and then costed only
> the MCU. Its 95 µA is a **skip-mode** figure — the datasheet specifies it at
> V<sub>SYNC</sub> = 0 V — which is what makes the SYNC strap a firmware
> decision rather than a pull-up. See
> [`power-supply.md`](power-supply.md#decided-keep-the-max25239--but-sync-is-a-gpio-not-a-strap).

```
219 µA × 720 h  =  0.16 Ah/month
group 65 battery ≈ 70 Ah  →  0.23 %/month,  ~1.4 % over six months
```

Comfortable, and it now survives a long lay-up rather than merely tolerating a
short one. ~~**Note what dominates: the LTC4364, at 250× the MCU's draw.**~~
**That was true of the 944 µA version. What dominates now is the MAX25239 at
95 µA and the battery-sense divider at 67 µA — 74 % of the budget between
them, and both are already at their practical floor. The next item is the
watchdog supervisor at 15 µA, accepted as the cost of its 125 °C rating.**

### Standby, not Stop

| STM32F767 mode | Current | Retained |
|---|---|---|
| Stop, RAM retained | ~350 µA | all 512 KB, instant wake |
| **Standby + backup SRAM** | **~3 µA** | 4 KB + RTC, wakes via reset |

Fuel trims, DTCs and adaptive tables are small — **4 KB is ample**, and Standby
is 100× cheaper. Waking through a reset costs milliseconds, which is nothing
against a key turn. Use Standby; keep anything larger in SD or flash.

## The part: MAX25239AFFA

Datasheet: [`Datasheets/max25239-max25240.pdf`](Datasheets/max25239-max25240.pdf).
It fits the role better than the generic requirement written above.

| | MAX25239AFFA | Why it matters here |
|---|---|---|
| Topology | **H-bridge buck-boost, one inductor** | the "not a plain buck" requirement, met |
| Input | **2 V to 36 V**, 42 V transient | 2 V is far below the 4.2 V system floor |
| Switching | **2100 kHz** | AM-clear, same rationale as the SEPIC |
| Quiescent | **95 µA** no-load, auto skip mode | the always-on number |
| Shutdown | **5 µA** typ, EN low | for the *switched* rail |
| Spread spectrum | ±6 %, SPS pin | the SEPIC design has none |
| Qualification | **AEC-Q100 Grade 1**, −40 to +125 °C | ✓ |
| Current limit | 8.2 A, 6 A continuous | 20× the MCU load |
| Extras | PGOOD, 2.5 ms soft-start, PLL SYNC | |

### Catch: AFFA's *fixed* output is 5 V — 3.3 V needs adjustable mode

From the ordering table:

```
                     ILIM    FIXED VOUT    ADJ VOUT    fSW
MAX25239AFFA/VY+     8.2 A      5 V         < 6.5 V    2100 kHz
```

The **fixed** option on this variant is 5 V. What makes it usable at 3.3 V is
the **adjustable** column: this variant covers anything **below 6.5 V** with an
external feedback divider. So wire it for adjustable mode, not the fixed option.

That same column is the interesting part — see below.

### It must sit behind the LTC4364, not on raw B+

```
MAX25239 transient rating      42 V
SMDJ43A clamp                  69.4 V      ← what raw B+ actually sees
LTC4364 regulated output       27 V        ✓
```

**42 V is below the TVS clamp**, so an always-on rail tapped ahead of the
LTC4364 would be destroyed by the first transient the TVS passes. Behind the
LTC4364 it never sees more than 27 V, and the part's 2 V minimum means the
LTC4364's 4.2 V cutoff remains the system floor — as intended.

### Revised drain budget

| Item | Sleep current |
|---|---|
| LTC4364 quiescent | 750 µA |
| MAX25239 #1, 3.3 V, skip mode | **95 µA** |
| MAX25239 #2, 6 V rail, EN low | **5 µA** |
| STM32F767 Standby + backup SRAM | 3 µA |
| **Total** | **≈ 853 µA** → 0.61 Ah/month |

Unchanged conclusion: comfortable, and still dominated by the LTC4364.

> **Superseded.** This table costs the *two*-converter sketch, which the
> all-switched decision below replaced with a single MAX25239 at 5.0 V. It also
> predates the battery-sense divider. **The budget that counts is the one at the
> top of this document**; this one is kept only for the converter comparison it
> was written for.

### Package is the practical objection

**FC2QFN, 4.25 × 4.25 mm, 22 pins** — flip-chip QFN, no visible joints, not
hand-solderable. That is a real problem for bench work.

**MAX25239EAFNA/VY+** is the same silicon and same options (8.2 A, <6.5 V adj,
2100 kHz) in an **18-pin FCQFN at 5.00 × 5.00 mm** — fewer, larger pads.
Prefer it for anything hand-assembled.

## Architecture: cascade, not two independent rails

**Decided:** MAX25239 makes the main rail, TLV62085 makes 3.3 V from it.

```
B+ ─ TVS ─ LTC4364 ─► MAX25239 ─► 5.5 V ─┬─► TLV62085 ──► 3.3 V   (MCU, SD, peripherals)
                       (always on)        ├─► LDO ───────► 5 V digital
                                          ├─► LDO ───────► 5 V analog
                                          └─► LDO ───────► 5.00 V VREF
```

This replaces the earlier "two independent 3.3 V rails" sketch. Both converters
stay powered when parked; the MCU's Standby mode does the saving.

### TLV62085RLTR

Datasheet: [`Datasheets/TLV62085RLTR-Datasheet.pdf`](Datasheets/TLV62085RLTR-Datasheet.pdf).

| | |
|---|---|
| Input | **2.5 V to 6.0 V** ← the number that sets the main rail |
| Output | 0.8 V to V<sub>IN</sub>, adjustable, **3 A** |
| Switching | 2.4 MHz (DCS-Control, load-dependent) |
| **Quiescent** | **17 µA** no load |
| Shutdown | **0.7 µA**, EN low |
| Light load | **Power Save Mode**, automatic |
| Dropout | **100 % duty cycle** capable |
| Fault | **Hiccup short-circuit protection** |
| Package | VSON-HR (RLT), **2 × 2 mm**, 7 pins |
| Temperature | −40 to +125 °C |

### All-switched settles the rail voltage: use the fixed 5.0 V option

**Decided: two switched rails, no LDOs.** That removes the constraint that
forced 6 V in the first place — [`power-supply.md`](power-supply.md) chose 6 V
purely to give the 5 V LDOs headroom, and with no LDOs there is nothing to give
headroom to.

```
6.0 V nominal → TLV62085 sees 6.12 V at +2 %   over its 6.0 V rating   ✗
5.5 V nominal → 5.61 V                          7 % margin             ✓
5.0 V fixed   → 5.10 V                          18 % margin            ✓✓
```

**Use MAX25239AFFA's fixed 5.0 V option.** It is factory-trimmed to ±2 %, needs
no feedback divider, and gives the TLV62085 real input margin. The adjustable
mode is no longer needed anywhere.

### But VREF still needs isolation — a load switch, not an LDO

Dropping the LDOs drops two things that were doing real work, and only one of
them was headroom.

**A harness short on VREF now pulls down the same 5 V rail that feeds the
AD7606 and both MAX9926s.** A chafed TPS wire would take out crank and cam
conditioning — the engine stops. That is the failure
[`vref-supply.md`](vref-supply.md) exists to prevent.

**Use a current-limited load switch** rather than an LDO. It keeps the
all-switched character — a FET at tens of milliohms, not a linear drop — while
providing an electronic current limit and a fault flag. VREF stays at the rail
voltage; the ADC and the VR conditioners stay up when the harness faults.

### And put a ferrite between the analog and digital sections

The other LDO job was keeping the AD7606 and MAX9926s off the rail that feeds
the 74HCT541 gating eight ignition coils. On one rail, replace that split with a
**ferrite bead plus local bulk** at the analog section. Switching and gate-drive
noise is above 1 MHz, where a ferrite works well, and the AD7606's own 22 kHz
anti-alias filter catches what gets through. Not as good as an LDO's PSRR, good
enough here.

## MAX25239 output capacitor and compensation

Reproducible in
[`../hardware/calc/max25239_comp.py`](../hardware/calc/max25239_comp.py), from
datasheet Equations 8–15.

Compensation is designed where the datasheet says to — **minimum input and heavy
load**, which is the deepest boost and the lowest RHP zero:

```
Vin = 4.2 V (the LTC4364 cutoff), Vout = 5.0 V, Iout = 1.0 A, L = 2.2 µH

D          = 0.160  (boost)
RHP zero   = 255.2 kHz
target fc  =  51.0 kHz     = fsw/41
```

### DECIDED: 4 × 22 µF

| Bank | C effective | Ripple | vs 15.6 µF transient need |
|---|---|---|---|
| 2 × 22 µF, 0805 16 V | 24 µF | 9.8 mV | OK, 1.5× |
| 2 × 22 µF, 1206 25 V | 33 µF | 8.9 mV | OK, 2.1× |
| **4 × 22 µF** | **66 µF** | **7.8 mV** | **OK, 4.2×** |

2 × 22 µF is genuinely sufficient on every criterion — ripple current is only
**0.44 A rms** at the boost corner and Equation 10 asks for 15.6 µF. What makes
4 the better answer is **DC bias derating**: a 22 µF 0805 X7R at 5 V loses
around 45 % of its nominal, so "44 µF" is really ~24 µF, and the margin against
the transient requirement is thinner than the label suggests. Four removes the
question, and matches the datasheet's own 2.1 MHz application circuit.

### Compensation values

```
Rc = 78.7 kΩ        (calculated 78.8 kΩ)
Cc =  2.2 nF        (calculated 2.10 nF)
Cp =  8.2 pF        (calculated 7.9 pF)
```

Check where that puts the poles and zeros:

| | Placed at | Target |
|---|---|---|
| f<sub>ZEA</sub> = 1/(2π·Rc·Cc) | **919 Hz** | f<sub>PBOOST</sub> = 965 Hz ✓ |
| f<sub>P2EA</sub> = 1/(2π·Rc·Cp) | **247 kHz** | RHP zero = 255 kHz ✓ |

Both land where the datasheet wants them.

### Two layout consequences

- **C<sub>p</sub> is 8.2 pF, and board stray on the COMP node is 2–5 pF** — a
  third of the value. Keep COMP compact and away from LX1/LX2. Stray adds to
  C<sub>p</sub>, which lowers f<sub>P2EA</sub> and is conservative, but it makes
  the placement approximate rather than designed.
- **R<sub>c</sub> = 78.7 kΩ is a high-impedance node** next to a 2.1 MHz
  switcher. Short trace, guarded if possible.

### C<sub>p</sub> is not a critical value — defer it to the bench

Deliberately left open until the board exists and board stray on COMP can be
measured rather than guessed (expected ~5 pF). It costs little either way:

| C<sub>p</sub> fitted | Total with 5 pF stray | f<sub>P2EA</sub> | Phase margin at 51 kHz |
|---|---|---|---|
| 8.2 pF | 13.2 pF | 153 kHz | **≈ 59°** |
| 3.3 pF | 8.3 pF | 244 kHz | **≈ 66°** |
| none | 5.0 pF | 404 kHz | ≈ 69°, less HF rolloff on COMP |

Seven degrees, and every option is comfortably above the 45° that matters. The
second pole sits 3–8× above crossover in all three cases, so it is doing very
little at the frequency that decides stability.

**Fit 8.2 pF as the starting value**; if stray measures near 5 pF and the loop
wants the pole back on target, **3.3 pF** puts it there. Use a 0402 footprint so
the swap is trivial.

### Design in a loop-injection point now

The measurement that settles C<sub>p</sub> is a **Bode plot, not a capacitance
reading** — stray on COMP is only interesting through its effect on the loop.
Make that measurable without cutting traces:

- **10–20 Ω in series with the top of the FB divider**, with a test point either
  side. Negligible in normal operation (FB draws ~20 nA), and it is the standard
  injection point for a transformer or isolated generator.
- Sweep 100 Hz to 500 kHz. Target **phase margin > 45°, gain margin > 10 dB**.
- **Measure in boost mode**, around 4.5 V in — that is where the RHP zero lives
  and the only place the design is actually constrained. A clean plot at 13.8 V
  proves very little.

Two resistors and two pads, decided now, save cutting into a working board later.

### One thing that shifts the numbers

The TLV62085's input capacitors sit on this same 5 V rail, so the MAX25239's
true C<sub>OUT</sub> is higher than 66 µF. That pushes the real crossover
*below* 51 kHz — slower, more stable, no action needed. Worth knowing when
the measured loop does not match the calculation.

### And why the bandwidth is conservative

51 kHz is f<sub>sw</sub>/41, well below the f<sub>sw</sub>/10–20 a buck would
allow. That is the RHP zero's doing, and it only exists in boost mode — which
this converter enters **only below 5 V input**, i.e. during severe cranking.
Designing there costs transient response at 13.8 V, and buys one compensation
network that is stable across the entire range. The datasheet's guidance, and
the right trade for a vehicle.

## SPS: yes, enable spread spectrum — but tie it to VCC, not 5 V

### ⚠ SPS is a 2.2 V pin

```
Absolute Maximum:   VCC, SPS to AGND ............ −0.3 V to +2.2 V
                    COMP, FB to AGND ............ −0.3 V to VCC + 0.3 V
```

**"Tie SPS high" means the VCC pin — the internal ~1.8 V bias regulator with its
4.7 µF cap — not the 5 V rail.** Strapping it to 5 V destroys the part. EN is
the exception in this pinout, rated to 42 V; SPS, COMP and FB are all
VCC-referenced.

Easy mistake, and there is no second chance on a flip-chip QFN.

### Why enable it

**It costs nothing on the constraint that chose 2.1 MHz in the first place:**

```
2.1 MHz ± 6 %  =  1.974 – 2.226 MHz
AM band top    =  1.710 MHz
```

The whole spread stays clear of the AM band, with 264 kHz to spare at the bottom.
Spread spectrum does not create energy below the lower edge, so nothing lands in
the band. In exchange it takes **10–20 dB off peak emissions** — which is the
entire reason the frequency was pushed to 2.1 MHz.

### And it costs nothing at the ADC either

The obvious objection is that smearing the ripple spectrum makes it harder to
filter deterministically. The numbers say it does not matter:

```
AD7606 anti-alias filter        22 kHz
switching                      2.1 MHz, 95× above  →  ~40 dB
10 mV rail ripple              →  ~100 µV at the ADC input
±10 V range, 16 bit            305 µV/LSB          →  0.3 LSB
```

Below a bit either way, spread or not. And the TLV62085's DCS-Control is not
fixed-frequency to begin with, so there is no clean beat tone being preserved by
leaving SPS off.

### Make it a strap, not a hard connection

A 0 Ω to VCC or to AGND, so the choice can be reversed after bench EMI
measurements without cutting the board.

### Two things to check on the bench

- **The modulation rate is not specified.** If it falls inside the 51 kHz loop
  bandwidth the loop would track it and put ripple at that rate on the output.
  For a current-mode converter, frequency modulation barely moves the DC
  transfer function, so this is normally a non-issue — but compare output ripple
  with SPS high and low during bring-up, since it is a two-minute check.
- **Internal spread spectrum is disabled when synced to an external clock.** If
  the two converters are ever PLL-synced, SPS becomes moot and the modulation
  would have to come from the driving clock instead.

## SYNC: tie it to AGND — and note it is *not* a 2.2 V pin

### SPS and SYNC are adjacent straps with completely different ratings

```
VCC, SPS to AGND ......... −0.3 V to +2.2 V     ← tie to the VCC pin
SYNC, PGOOD to AGND ...... −0.3 V to  +6 V      ← 3.3 V logic drives it directly
SUP, EN to AGND .......... −0.3 V to +42 V
```

Easy to conflate: two small strap pins next to each other, one of which dies on
anything above 2.2 V and one of which takes 6 V. **SYNC needs no level shift
from 3.3 V; SPS must never see it.**

### SYNC = 0 V, because that is how the 95 µA is specified

```
Standby Supply Current   ISUP_STANDBY = 95 µA
  conditions:  VEN = VSUP, VOUT = 5 V, no load, **VSYNC = 0 V**
```

**The quiescent figure the whole always-on architecture rests on is measured
with SYNC grounded.** Forced PWM would give that up — the converter would switch
at 2.1 MHz continuously into no load, burning gate charge for nothing.

Nothing is lost by choosing skip: **the part runs fixed-frequency PWM under load
anyway** and only skips once inductor current goes discontinuous:

```
buck mode, 13.8 V in, 5 V out, L = 2.2 µH, 2.1 MHz
ΔIL = Vout (Vin − Vout) / (Vin · L · fsw) = 0.69 A
DCM boundary  =  ΔIL / 2  =  345 mA
```

| Condition | Load | Mode |
|---|---|---|
| Asleep | ~0.1 mA | deep skip ✓ |
| Key on, engine off, MCU + ADC | 300–500 mA | **near the boundary** |
| Running | ~1 A | PWM ✓ |

Only the middle case is ambiguous, and skip-mode ripple there still lands well
under 1 LSB after the ferrite, the local bulk and the AD7606's 22 kHz filter.

**Route SYNC to a GPIO anyway**, defaulting low. It is one trace and no level
shifter, and it leaves forced PWM available if bench work shows a skip artifact
at that intermediate load.

### Polarity, from the pin table

> *Connect SYNC to **AGND to enable skip mode**. Connect SYNC to **VCC to enable
> PWM mode**. Connect SYNC to a valid external clock to synchronize…*

**Low is skip, high is PWM — so SYNC starts and stays low.** High would be the
wrong default, and "high" here means **VCC (~1.8 V)**, not the 3.3 V rail,
though the 6 V rating makes 3.3 V safe to drive.

### But the startup instinct is right, for a different reason

**The MCU is powered by this converter**, so at power-up its GPIO is in reset and
high-impedance. A GPIO alone would leave SYNC **floating** through the entire
startup — undefined mode on the converter that has to come up first.

**Fitted: 10 kΩ to AGND, with SYNC brought out to a GPIO.** Skip mode is
defined before the MCU exists, and a push-pull GPIO overrides it at 330 µA once
running — only in PWM mode, so it costs nothing in sleep.

**This works because STM32 GPIOs go high-impedance in Standby.** The pull-down
is what holds skip mode through the two states where firmware cannot: power-up
before the MCU boots, and Standby while it sleeps. Those are exactly the states
where the 95 µA quiescent matters, so the resistor is doing the load-bearing
work and the GPIO is only an override for the running case.

Driving 3.3 V into SYNC is safe and unambiguous: the pin is rated to 6 V against
AGND, not clamped to V<sub>CC</sub>, so there is no diode to forward-bias by
exceeding the 1.8 V rail.

### SPS is the opposite: hard strap only, never a GPIO

SPS is a **2.2 V** pin. A 3.3 V GPIO driving it destroys the part — the 6 V
tolerance belongs to SYNC and PGOOD, not to SPS. **Strap SPS to VCC with a
0 Ω**, and leave it out of firmware's reach entirely.

### External clock sync: no

Nothing to gain and three reasons not to:

- **There is no second device to synchronise to.** The TLV62085 uses
  DCS-Control and has no SYNC input.
- **It disables the internal spread spectrum**, which was just enabled for real
  EMI benefit.
- **It would make the converter depend on an MCU clock that must survive
  sleep** — the one state where the MCU is meant to be doing nothing.

### Incidental find: the two UVLOs nearly coincide

```
MAX25239  VUVLO_RISE  4.2 – 4.45 V      VUVLO_FALL  1.9 V
LTC4364   UV release              4.47 V
```

The converter starts just as the LTC4364 releases, and once running holds
regulation down to 1.9 V — far below where the LTC4364 disconnects. **So the
LTC4364 remains the system floor with no contention**, and the MAX25239's 2 V
minimum operating spec is backed by a real falling threshold rather than a
typical figure.

## FB: use adjustable mode, not the fixed option

The pin table gives the other half of the fixed-output story:

> *Connect FB to a resistor-divider between OUT and AGND to set the desired
> output voltage… **Connect FB to V<sub>CC</sub> for the fixed output voltage
> option**.*

So the fixed 5.0 V is selected by tying FB to VCC — no divider at all. **That
also removes the loop-injection point** designed in above, because there is no
external feedback path to inject into.

### The trade

| | Fixed (FB → VCC) | Adjustable |
|---|---|---|
| Accuracy | **±2 %** | ~±3 % worst case |
| Parts | none | 2 resistors |
| Sleep drain | 0 | **+78 µA** |
| **Loop measurable in circuit** | **no** | **yes** |
| Output trimmable | no | yes |

**Use adjustable.** The reasoning:

- **The injection point is worth more than the 1 %.** This board has an RHP zero
  in boost mode and a compensation network calculated rather than measured;
  being able to take a Bode plot on the first article is the difference between
  knowing and hoping.
- **The 5 V rail's absolute accuracy has already been made irrelevant.** VREF is
  this rail through a load switch, and the decision above is to **sample VREF on
  an ADC channel and divide** — so ratiometric sensors self-correct regardless.
  Nothing else on the rail cares about 1 %.
- **78 µA is 9 % of the sleep budget**, taking it to ~945 µA and 0.68 Ah/month.
  Still about 1 % of the battery per month.

```
Vfb = 0.800 V

R_top = 53.6 kΩ, R_bot = 10.2 kΩ   →   Vout = 0.8 × 63.8/10.2 = 5.004 V
divider current = 0.8 / 10.2 kΩ    =   78 µA
```

**Do not raise the divider impedance to save that current.** FB leakage is
0.02 µA typical but **1 µA maximum**, so at 78 µA of divider current the
worst-case error is 1.3 %; at 20 µA it would be 5 %.

### PGOOD

> *Pull up PGOOD with an external resistor to V<sub>CC</sub> or a positive
> voltage lower than 5.5 V.*

So **3.3 V is a legal pull-up rail** — take PGOOD straight to an MCU input, no
level shifting. It asserts low below 93 % of regulation and releases above 94 %,
which is a cheap independent check on the rail the MCU is running from.

## The 2.5 V ADC reference

Right call — an external reference on the AD7606's REFIN beats the internal one
on drift, which is the term that matters over a −40 to +125 °C ECU:

```
AD7606 internal   ~10 ppm/°C  →  ~1650 ppm over range  =  16 mV on ±10 V
ADR4525            2 ppm/°C   →  ~330 ppm              =   3.3 mV
```

16 mV is nothing on a MAP sensor and **3.5 % on a narrowband HO2S switching
around 450 mV** — which lands directly in fuel trim. That is what buys the part.

### It fixes absolute accuracy, not ratiometric accuracy

Worth being precise, because this is easy to conflate:

| Measurement | Tracks | Improved by a 2.5 V reference? |
|---|---|---|
| HO2S, absolute voltages | ADC reference | **yes** |
| TPS, MAP, three-wire sensors | **VREF** | **no** |

Ratiometric sensors report a fraction of VREF, so their accuracy depends on
VREF, not on the ADC's reference. **Sample VREF on an ADC channel and divide** —
with the AD7606 sampling simultaneously, VREF and the sensor are captured at the
same instant, so supply ripple cancels exactly. That is worth more than any
regulator on VREF, and it is free.

### Filtering the reference — RC beats an LC pi here

Filtering its input is correct: a reference's PSRR is strong at DC and poor by
2 MHz, which is exactly where both switchers live.

But at 950 µA of supply current with 2.5 V of headroom to spare, **a series
resistor outperforms a ferrite**:

```
R = 100 Ω, C = 10 µF ∥ 100 nF

corner        1 / (2π × 100 × 10 µF)          =  159 Hz
attenuation   at 2.1 MHz, ESL-limited          ≈  78 dB
cost          950 µA × 100 Ω                   =  95 mV
headroom left 5.0 − 0.095 = 4.9 V, against ~3.0 V needed   ✓
```

**No resonance, no ferrite to characterise, two components.**

The 100 nF matters: a 10 µF ceramic self-resonates near 1.6 MHz, so above that
it is inductive and its own ESL sets the floor. The small cap carries the high
end.

**Firmware consequence: allow ~10 ms after enabling the reference** before the
first valid conversion. `5 × RC = 5 ms` for the input to settle, plus the
reference's own turn-on time. Since the reference is gated for sleep (below),
that delay lands at key-on, where 10 ms is nothing against an engine start.

### If a pi filter is used instead, check its resonance

A ferrite is the right choice over a wound inductor there — it is lossy, so the
LC is damped rather than peaking. But it is not fully damped:

```
typical bead ≈ 1 µH at low frequency, with C = 1 µF
f0 = 1 / (2π √(1 µH × 1 µF))  =  159 kHz
```

**That is inside the range both converters actually visit.** The MAX25239 in
skip mode and the TLV62085 in Power Save Mode both drop their switching
frequency at light load, which is precisely the always-on sleep condition. A
filter that peaks where the supply is noisiest is worse than no filter.

Fix either way: **put 10 Ω in series with the bead**. It damps the resonance,
costs 9.5 mV, and adds attenuation. Or move `f0` well below the PSM range with a
larger output capacitor.

### The output side matters more than the input

The AD7606 is a SAR converter, so **REFIN sees charge kicks on every
conversion**, not a steady load. Two things follow:

- Put **10 µF + 100 nF right at the REFIN pin**, short traces. This is the
  decoupling that actually sets reference settling between samples, and no
  amount of input filtering substitutes for it.
- **Confirm the reference is stable driving that capacitance.** Some precision
  references oscillate into large ceramic loads, and the ones that do not
  usually say so explicitly. Check before committing to the part.

Place the reference, its RC and its output caps all on the **analog side** of
the section ferrite, so this filtering cascades with that rather than duplicating
it.

### DECIDED: MAX6070AAUT25+T — supersedes both the ADR431 and the ADR4525

Datasheet: [`Datasheets/max6070-max6071.pdf`](Datasheets/max6070-max6071.pdf).

| | ADR431B | ADR4525B (TOKMAS) | **MAX6070A** |
|---|---|---|---|
| Initial accuracy | ±0.04 % | ±0.05 % | **±0.04 %** |
| Tempco | 3 ppm/°C | 3.6 typ / 5 max | **1.5 typ** / 6 max |
| Noise, 0.1–10 Hz | 3.5 µV p-p | 15 µV p-p | **4.8 µV p-p** |
| **Quiescent** | 800 µA max | 950 µA max | **130 typ / 260 max** |
| Shutdown | none | 33 µA max | **6 µA max** |
| Dropout | 2 V | 300 mV | **200 mV** |
| Ripple rejection | −70 dB @ 1 kHz | not specified | **85 dB** |
| **Cap-load stability** | not specified | not specified | **0.1–10 µF, specified** |
| Package | SOIC-8 | SOIC-8 | **SOT23-6** |
| Vendor | ADI | TOKMAS 2nd source | **ADI, AEC-Q100 available** |

It wins on every axis that has been argued over in this section, and settles two
open concerns outright:

- **Capacitive-load stability is specified: 0.1 µF to 10 µF at I<sub>OUT</sub>
  ≤ 10 mA.** Both previous parts were characterised only at 0.1 µF, leaving the
  10 µF at REFIN outside documented territory. Here it is inside the range — at
  the top of it, so **4.7 µF is the safer value** if the AD7606 does not
  genuinely need 10 µF.
- **5× lower quiescent.** 260 µA max against 950 µA, which changes the sleep
  arithmetic even before gating.

### Power it from 3.3 V, not the 5 V rail

Two independent reasons, and the second one is a hard stop:

**1. V<sub>IN(MAX)</sub> is 5.5 V.** The 5 V rail's worst-case high is 5.18 V
from the divider tolerance, and the MAX25239's output OVP does not trip until
106–110 % of regulation — around 5.5 V. That is no margin at all.

**2. EN is ratiometric: V<sub>IH</sub> = 0.7 × V<sub>IN</sub>.**

```
from 5.0 V rail   →  VIH = 3.50 V   a 3.3 V GPIO CANNOT drive it high  ✗
from 3.3 V rail   →  VIH = 2.31 V   3.3 V GPIO drives it directly      ✓
                     VIL = 0.99 V   pull-down holds it low             ✓
```

From 3.3 V: V<sub>IN</sub> range 2.7–5.5 V gives 600 mV of headroom over the
200 mV dropout, EN works from a plain GPIO, and the 5.5 V ceiling stops being a
question. **The EN threshold decides the supply rail.**

### Filter and passives

```
220 Ω + 10 µF + 100 nF   from the 3.3 V rail
CFILTER = 0.1 µF         on pin 1

drop at 360 µA (260 µA max quiescent + ~100 µA REFIN)  =  79 mV
3.3 V worst-case low 3.234 V − 79 mV = 3.155 V  vs 2.7 V minimum  →  455 mV ✓
```

220 Ω carries over unchanged. Note the filter matters less here than it did:
**85 dB of built-in ripple rejection** already puts 8 mV of rail ripple at
0.45 µV, ten times under the part's own 4.8 µV noise. **[verify]** the frequency
that 85 dB is specified at — it will be far lower than 2.4 MHz — but the RC is
belt-and-braces for 79 mV either way.

### Output capacitance: 4.7 µF **and** 100 nF

```
Capacitive-Load Stability Range, IOUT ≤ 10 mA .... 0.1 µF to 10 µF
```

**0.1 µF is the minimum, not a nominal.** 100 nF alone technically satisfies the
part, but it puts the design on the boundary — and a 100 nF 0603 X7R at 2.5 V
bias is not 100 nF, so the real value could land under it. 4.7 µF + 100 nF gives
4.8 µF, comfortably mid-range and well under the 10 µF ceiling.

Each capacitor is doing a different job:

| | Job |
|---|---|
| **4.7 µF** | stability margin, and the charge reservoir for the AD7606's SAR demand |
| **100 nF** | the decade above the 4.7 µF's self-resonance, where the bulk part is inductive |

**Why the bulk is needed at all.** A reference has to hold within ½ LSB *during*
a conversion and recover between them. ½ LSB at 16 bits is 7.6 ppm of 2.5 V =
**19 µV**, so the charge the ADC pulls has to move the rail less than that. In
the microfarad range it does; at 100 nF it would not. This is the same reasoning
ADI gives for the ADR43x — *"large capacitors, in the microfarad range, reduce
the change in reference voltage to less than one-half LSB"* — and it is why
every reference-to-ADC application note lands on microfarads rather than the
0.1 µF a regulator would want.

**Placement:** put both at the **AD7606's REFIN pin**, not at the reference,
with a short trace back to OUTF. The charge demand is at the ADC end; the
reference only has to see the bank as its load capacitance, which it does either
way.

**OUTS taps after the caps** — that is what the force/sense pair is for. OUTF
carries the current, OUTS senses at the load, and the reference regulates out
whatever the OUTF trace drops. Two consequences:

- **The OUTF trace is now inside the feedback loop.** Keep the reference
  physically close to REFIN. A 30 mm run is roughly 20 nH, which with 4.8 µF
  resonates at `1/(2π√LC)` = **514 kHz** — potentially inside the reference's
  own loop bandwidth. **Target under 10 mm**, and tap OUTS at the capacitor node
  itself rather than partway along a trace carrying load current.
- **The gain is small here but free.** At ~100 µA of average REFIN current a
  short trace drops microvolts. Kelvin sensing earns its keep if REFIN turns out
  to draw milliamps; until then it costs one pin and no parts.

**There is no ground-side Kelvin on this part.** That is the MAX6070 /
MAX6071 split:

```
MAX6070:  1 FILTER   2 GND     3 EN   4 IN   5 OUTS   6 OUTF
MAX6071:  1 GNDF     2 GNDS    3 EN   4 IN   5 OUTS   6 OUTF
```

**You get the noise filter or the ground force/sense, not both.** With a solid
plane and a short return the filter is the better trade — but it does mean the
ground-side drop is uncompensated, so the reference's GND and the AD7606's
reference return want to be tight and on the same plane, not routed.

**Do not confuse this with C<sub>FILTER</sub>.** The 0.1 µF on pin 1 sets the
part's internal noise filter and is a separate component with a separate job.

Use a **16 V or 25 V X7R** for the 4.7 µF — at 2.5 V bias a 6.3 V part can lose
30 %, and while 3.3 µF effective is still inside the stability range, there is no
reason to spend the margin.

**[verify] the AD7606 datasheet's own REFIN decoupling recommendation.** If ADI
specifies a value for that part it governs, and 4.7 µF here is reasoned from the
½ LSB argument rather than read from the converter's own datasheet.

### Pinout and settling

```
SOT23-6:   1 FILTER   2 GND   3 EN   4 IN   5 OUTS   6 OUTF
```

Turn-on and enable settling are both **6 ms to 0.01 %** with
C<sub>FILTER</sub> = 0.1 µF. The 220 Ω / 10 µF input RC still dominates at 11 ms,
so **the 25 ms firmware wait after releasing EN is unchanged.**

### Still gate it, and still fit the pull-down

260 µA max is 28 % of the sleep budget for a part only useful while converting,
and EN costs nothing:

| | Sleep total |
|---|---|
| Ungated | 1205 µA |
| **Gated (6 µA)** | **951 µA** |

**Fit a 10 kΩ pull-down on EN**, the same pattern as SYNC and the ADR4525's
SHDN — the resistor holds shutdown through power-up and MCU Standby, the GPIO
overrides when running. EN input current is ±1 µA, so 10 kΩ is unambiguous.

### [verify] whether this part number is the AEC-Q100 one

The datasheet says *"AEC-Q100 Qualified (Refer to Ordering Information)"*, which
means only some variants are. **MAX6070AAUT25+T** is most likely the industrial
part. Worth checking, because it would be the **only automotive-qualified
reference** considered — and everything else in this rail chain (TLV62085, and
previously the TOKMAS part) has been a deliberate non-automotive compromise.

### Settling: the 10 ms guidance holds

```
input RC        5 × 220 Ω × 10 µF       = 11.0 ms   ← dominant
10 µF at ~15 mA source                  =  1.7 ms
reference turn-on, 0.1 %, CL = 0.1 µF   = 100 µs
```

About 13 ms, so **wait 25 ms after releasing SHDN** before the first valid
conversion. A firmware constant tied to a real RC rather than a guess — and it
moves with the filter resistor, so the two have to change together.

### Filtering the reference — RC beats an LC pi here

Filtering its input is correct: a reference's PSRR is strong at DC and poor by
2 MHz, which is exactly where both switchers live.

But at 950 µA of supply current with 2.5 V of headroom to spare, **a series
resistor outperforms a ferrite**:

```
R = 100 Ω, C = 10 µF ∥ 100 nF

corner        1 / (2π × 100 × 10 µF)          =  159 Hz
attenuation   at 2.1 MHz, ESL-limited          ≈  78 dB
cost          950 µA × 100 Ω                   =  95 mV
headroom left 5.0 − 0.095 = 4.9 V, against ~3.0 V needed   ✓
```

**No resonance, no ferrite to characterise, two components.**

The 100 nF matters: a 10 µF ceramic self-resonates near 1.6 MHz, so above that
it is inductive and its own ESL sets the floor. The small cap carries the high
end.

**Firmware consequence: allow ~10 ms after enabling the reference** before the
first valid conversion. `5 × RC = 5 ms` for the input to settle, plus the
reference's own turn-on time. Since the reference is gated for sleep (below),
that delay lands at key-on, where 10 ms is nothing against an engine start.

### If a pi filter is used instead, check its resonance

A ferrite is the right choice over a wound inductor there — it is lossy, so the
LC is damped rather than peaking. But it is not fully damped:

```
typical bead ≈ 1 µH at low frequency, with C = 1 µF
f0 = 1 / (2π √(1 µH × 1 µF))  =  159 kHz
```

**That is inside the range both converters actually visit.** The MAX25239 in
skip mode and the TLV62085 in Power Save Mode both drop their switching
frequency at light load, which is precisely the always-on sleep condition. A
filter that peaks where the supply is noisiest is worse than no filter.

Fix either way: **put 10 Ω in series with the bead**. It damps the resonance,
costs 9.5 mV, and adds attenuation. Or move `f0` well below the PSM range with a
larger output capacitor.

### The output side matters more than the input

The AD7606 is a SAR converter, so **REFIN sees charge kicks on every
conversion**, not a steady load. Two things follow:

- Put **10 µF + 100 nF right at the REFIN pin**, short traces. This is the
  decoupling that actually sets reference settling between samples, and no
  amount of input filtering substitutes for it.
- **Confirm the reference is stable driving that capacitance.** Some precision
  references oscillate into large ceramic loads, and the ones that do not
  usually say so explicitly. Check before committing to the part.

Place the reference, its RC and its output caps all on the **analog side** of
the section ferrite, so this filtering cascades with that rather than duplicating
it.

### Budget the reference's supply current — it can double the parked drain

Precision references are not low-power parts:

| Part | Drift | Supply current |
|---|---|---|
| ADR4525 | 2 ppm/°C | **950 µA** |
| ADR3425 | 8 ppm/°C | 100 µA |
| REF3025 | 75 ppm/°C | 42 µA |

**950 µA would more than double the 875 µA sleep budget** for a part that is
only useful while the engine runs. **Gate it** — a GPIO-driven load switch, or a
reference with a shutdown pin — and keep the good drift spec. Do not compromise
to 75 ppm/°C to save current that switching off saves anyway.

### Revised drain budget

| Item | Sleep current |
|---|---|
| LTC4364 quiescent | 750 µA |
| MAX25239 #1, 3.3 V, skip mode | **95 µA** |
| MAX25239 #2, 6 V rail, EN low | **5 µA** |
| STM32F767 Standby + backup SRAM | 3 µA |
| **Total** | **≈ 853 µA** → 0.61 Ah/month |

Unchanged conclusion: comfortable, and still dominated by the LTC4364.

> **Superseded.** This table costs the *two*-converter sketch, which the
> all-switched decision below replaced with a single MAX25239 at 5.0 V. It also
> predates the battery-sense divider. **The budget that counts is the one at the
> top of this document**; this one is kept only for the converter comparison it
> was written for.

### Package is the practical objection

**FC2QFN, 4.25 × 4.25 mm, 22 pins** — flip-chip QFN, no visible joints, not
hand-solderable. That is a real problem for bench work.

**MAX25239EAFNA/VY+** is the same silicon and same options (8.2 A, <6.5 V adj,
2100 kHz) in an **18-pin FCQFN at 5.00 × 5.00 mm** — fewer, larger pads.
Prefer it for anything hand-assembled.

## Architecture: cascade, not two independent rails

**Decided:** MAX25239 makes the main rail, TLV62085 makes 3.3 V from it.

```
B+ ─ TVS ─ LTC4364 ─► MAX25239 ─► 5.5 V ─┬─► TLV62085 ──► 3.3 V   (MCU, SD, peripherals)
                       (always on)        ├─► LDO ───────► 5 V digital
                                          ├─► LDO ───────► 5 V analog
                                          └─► LDO ───────► 5.00 V VREF
```

This replaces the earlier "two independent 3.3 V rails" sketch. Both converters
stay powered when parked; the MCU's Standby mode does the saving.

### TLV62085RLTR

Datasheet: [`Datasheets/TLV62085RLTR-Datasheet.pdf`](Datasheets/TLV62085RLTR-Datasheet.pdf).

| | |
|---|---|
| Input | **2.5 V to 6.0 V** ← the number that sets the main rail |
| Output | 0.8 V to V<sub>IN</sub>, adjustable, **3 A** |
| Switching | 2.4 MHz (DCS-Control, load-dependent) |
| **Quiescent** | **17 µA** no load |
| Shutdown | **0.7 µA**, EN low |
| Light load | **Power Save Mode**, automatic |
| Dropout | **100 % duty cycle** capable |
| Fault | **Hiccup short-circuit protection** |
| Package | VSON-HR (RLT), **2 × 2 mm**, 7 pins |
| Temperature | −40 to +125 °C |

### Set the main rail at 5.5 V, not 6.0 V

The TLV62085's **6.0 V absolute input maximum** collides with the 6 V main rail
that [`power-supply.md`](power-supply.md) chose for LDO headroom:

```
6.0 V nominal ± 2 % regulation  →  6.12 V     over the TLV62085's rating ✗
5.5 V nominal ± 2 % regulation  →  5.61 V     7 % margin                ✓
```

**5.5 V satisfies both constraints:**

- TLV62085 input stays inside 2.5–6.0 V with real margin
- The 5 V LDOs keep **0.5 V of headroom** — enough for low-dropout parts at the
  25–150 mA these rails draw, where 1 V was never actually required
- MAX25239AFFA's adjustable range is "< 6.5 V", so 5.5 V is in range

Do **not** use the part's fixed 5.0 V option: it leaves the 5 V LDOs no headroom
at all, and VREF in particular has to be a regulated 5.00 V isolated from the
switcher.

### This largely defuses MAX25239 Note 5

[`power-supply.md`](power-supply.md) flags *"output short circuit not allowed"*
as the blocking question for using the MAX25239 more widely. In **this**
topology it matters much less: the MAX25239's output faces **three LDOs and one
buck, every one of them internally current-limited**, and never a connector,
harness or anything a fault can reach. The TLV62085 brings its own hiccup
protection, and VREF's harness exposure sits behind an LDO plus a PTC.

The question still needs answering before the MAX25239 drives anything external.
It is no longer blocking for this arrangement.

### Revised drain budget

| Item | Sleep current |
|---|---|
| LTC4364 quiescent | 750 µA |
| MAX25239, 5.5 V, skip mode | 95 µA |
| **TLV62085, Power Save Mode** | **17 µA** |
| 5 V LDO quiescents (or disabled) | ~10 µA |
| STM32F767 Standby + backup SRAM | 3 µA |
| **Total** | **≈ 875 µA** → 0.63 Ah/month |

Cascading costs 17 µA over the parallel arrangement. Irrelevant against the
LTC4364's 750 µA.

### Two notes, neither blocking

- **Not AEC-Q100.** Every other part in this chain is automotive-qualified —
  LTC4364, MAX25239 Grade 1, LM5155-Q1. The TLV62085 is rated −40 to +125 °C,
  which is the Grade 1 *temperature* range, but without the qualification,
  PPAP or change control. For a one-vehicle build that is a reasonable trade;
  it should be a stated choice rather than an oversight.
- **2.1 MHz and 2.4 MHz beat at 300 kHz**, which is inside CISPR 25's band. It
  mostly stays internal — the TLV62085 is a point-of-load, so its switching
  appears as load modulation that the MAX25239's output capacitors absorb rather
  than as harness current. DCS-Control is also not rigidly fixed-frequency, so
  there is no clean tone to beat against. Worth a look on the bench, not worth
  designing around.
- Power Save Mode drops the switching frequency at light load, potentially into
  the AM band — but that only happens with the MCU asleep and the vehicle
  parked, when the radio is off too.

## Tapping point: after the LTC4364, not before

Simplest and protected. ~~The cost is the LTC4364's 750 µA running permanently,
which the budget above absorbs.~~ **There is no such cost — see below. Taking
this sentence literally for the *input* as well as the output is what removed
it.**

~~The alternative — tapping raw B+ so the MCU can shut the LTC4364 down via
SHDN# — would cut the parasitic to tens of microamps, but it needs a **second
transient-protection chain** for a rail that must survive load dump and reverse
battery on its own. **Not worth it at 0.56 Ah/month.**~~

> ⚠ **That paragraph weighed the wrong thing, and it nearly cost the design its
> power source.** It priced a second protection chain against a *drain saving*
> and found the trade not worth making. But this document never said where the
> constant 12 V arrives from at all, and the rest of the board has only one
> input — **VPWR, which is key-switched**. The second chain does not buy a lower
> parasitic. **It buys the existence of the always-on rail.** And because that
> branch carries microamps rather than amps, it is a resistor and a TVS, not a
> second LTC4364.

---

## The KAPWR feed: where the constant 12 V comes from

**This was undefined until now**, and three documents disagreed about it:

| Document | Said |
|---|---|
| [`Schematics/schematic-ecu-v1.txt`](Schematics/schematic-ecu-v1.txt) §1 | *"Battery, **key-switched**, through the EEC-V connector"* — **since confirmed at the relay coil**, which is energised from "hot in start or run" and grounded at G104 with no PCM output on it ([`schematic-findings.md`](1999-Ford-F150-4wd-5.42v/schematic-findings.md) §17) |
| [`review-ignition-injection.md`](review-ignition-injection.md), [`output-drivers.md`](output-drivers.md) | The only input is **VPWR = circuit 361 RD at pins 71 and 97**, fed from the **EEC power relay** |
| **this document** | *"the LTC4364's 750 µA running **permanently**"* |
| [`1999-Ford-F150-4wd-5.42v/oem-connectors.md`](1999-Ford-F150-4wd-5.42v/oem-connectors.md) §5 | *"**KAPWR is not required**"* |

With the board as drawn, **the EEC relay opens at key-off, VPWR dies, and the
always-on domain has nothing to be on from.** The 944 µA was budgeted against a
rail that did not exist. The always-on decision **revives KAPWR rather than
retiring it** — `oem-connectors.md` §5 retired A-44 before this domain existed,
and A-44 is exactly the pin that supplies it.

Numbers below are reproduced by [`calc/kapwr_feed.py`](calc/kapwr_feed.py).

### The topology, and why the junction point is the whole design

```
  VPWR 71,97 ──[F1]──[SMDJ43A]──┤ LTC4364-2        ├──┐
  circuit 361 RD, EEC relay     │ pass FET         │  │
  DIES AT KEY-OFF               │ ideal-diode FET ─┼──┴──┬──► PROTECTED RAIL
                                                         │
  BATTERY POST                                           ├──► MAX25239 → 5 V
      │                                                  └──► NCV8772 → VREF
  [F2 2A, within 150-300 mm of the post]                  
      │                                                  
      ╎ 18 AWG, loomed, grommeted                        
      │                                                  
   [SMDJ43A]──┬──[D3]──[R7 470R]──┬───────────────────────┘
      │       │                   │
     PGND  [180k/30k]          [SMBJ30A]
              │  └──► ADC ch      │
             PGND                PGND
```

**Two independent changes, and each fixes something the other exposed:**

**1. The source is a dedicated lead off the battery post**, not an EEC-V pin.

> **This truck does have a keep-alive pin — 55, circuit `729 RD/WH`**, Central
> Junction Box, hot at all times, 5 A. It was in the pinout all along as *"B+
> KAM"*, and nothing connected **K**eep **A**live **M**emory to **KAPWR**. See
> [`1999-Ford-F150-4wd-5.42v/schematic-findings.md`](1999-Ford-F150-4wd-5.42v/schematic-findings.md) §18.
>
> **DECIDED: pin 55 becomes the battery-voltage sense pin**, and the dedicated
> lead becomes power-only. The CJB objection applied to carrying *supply*
> current; a sense-only divider draws 67 µA, at which even a corroded ohm of path
> costs 67 **micro**volts. Power and measurement now sit on separately fused
> wires — see
> [`1999-Ford-F150-4wd-5.42v/schematic-findings.md`](1999-Ford-F150-4wd-5.42v/schematic-findings.md) §19,
> including the failure mode it creates and the cross-check that handles it.
That retires the `[CONFIRM]` that was blocking the drawing — A-44 has no number
in the 1–104 scheme, because two numbering systems coexist in this repo with no
mapping. **A dedicated lead uses no EEC-V pin, so the question never has to be
answered to build the board.** It also means the feed shares nothing with the
truck's other keep-alive loads, and reads battery voltage without the BJB's drops
in the way.

**2. The battery-sense divider is not on this lead at all — it is on pin 55.**
Downstream of D3 and R7 it read **0.48 V low when parked, with a load-dependent
correction**. Upstream it read true battery. **On pin 55 it reads true battery
*and* leaves this lead carrying nothing but supply current**, on a separate fuse.
The value is **180 k / 30 k**, owned by
[`adc-front-end.md`](adc-front-end.md#the-battery-sense-divider); §19 of the
findings covers the move.

**KAPWR joins the protected rail, downstream of the ideal-diode FET** — not the
LTC4364's input. Three things follow, and the first is the argument:

- **The LTC4364 is unpowered when parked.** 750 µA, 80 % of the old budget, gone.
- **Back-feed into VPWR is blocked for free** by the ideal-diode FET already in
  the design. Joining at the LTC4364's *input* would push KAPWR back out through
  pins 71/97 into an open relay contact and whatever else shares that branch.
- **The "second transient chain" is two parts**, because this branch carries
  microamps.

### R7 = 470 Ω does three jobs

**a) It makes the OR asymmetric without an OR controller.** This matters more
than it looks, and **a direct battery lead makes it matter more, not less** — a
lead off the post has *less* drop than the OEM keep-alive circuit would have, so
it sits even further above VPWR, which arrives through a relay contact. A plain diode-OR would therefore run the whole ECU off
the keep-alive fuse. R7 is 23 500× the LTC4364 path's ~20 mΩ:

| Rail sags | KAPWR contributes |
|---|---|
| 10 mV at 0.5 A | **21 µA** |
| 20 mV at 1.0 A | **43 µA** |

**Run current can never flow through the keep-alive fuse.**

**b) It limits fault current** to 30 mA at 14 V into a dead short — which is now
what lets the board carry no fuse of its own, the lead's 2 A at the post being
the only one needed.

**c) It makes TVS3 work** — a shunt clamp with no series impedance has to absorb
the whole surge.

The cost is **91 mV** of drop when parked. The MAX25239 runs down to 2 V, so this
is irrelevant to operation — and *not* irrelevant to the voltmeter, below.

### TVS3: the window is narrower than it looks

| Must | |
|---|---|
| Stand **off** a jump start / the LTC4364's regulated output | **27 V** |
| Clamp **below** the MAX25239's transient absolute maximum | **42 V** |

| Part | Standoff | V<sub>BR</sub> min | |
|---|--:|--:|---|
| SMBJ24A | 24 V | 26.7 V | **no** — conducts at a 27 V jump start |
| SMBJ26A | 26 V | 28.9 V | **no** — same |
| **SMBJ30A** | **30 V** | **33.3 V** | ✓ |
| SMBJ33A | 33 V | 36.7 V | ✓, less margin to 42 V |

| Case | At the pin | Through R7 | R7 | TVS3 |
|---|--:|--:|--:|--:|
| ISO 7637-2 pulse 5b, **suppressed alternator** | 35 V | 1.1 mA | ~0 W | 0.04 W |
| SMDJ43A clamping at full current, **unsuppressed** | 69.4 V | 74.3 mA | 2.59 W | 2.56 W |

400 ms of the worst case is **1.04 J in R7** — a 1206, or two 1 kΩ in parallel.

**Note the realistic case does nothing at all.** A modern alternator's
centralised suppression holds pulse 5b to 35 V, which is already inside the
MAX25239's own 42 V rating. **TVS3 exists for the unsuppressed case**, and R7 is
what makes that case survivable.

**Decided: SMBJ30A, R7 = 470 Ω 1206, D3 silicon (not Schottky).**

### ⚠ Why the divider is upstream — the offset it avoids

Had the divider stayed on the protected rail, it would read **KAPWR minus D3
minus R7** whenever the key was off:

```
  D3 forward drop at 184 µA    0.42 V
  R7 drop                      0.06 V
  ---------------------------------
  total offset                 0.48 V    low, and only when parked
```

The low-battery self-disable below trips at 11.5 V. **Uncorrected it would have
tripped at ~11.98 V of real battery — giving up on a healthy battery** — and the
offset is **load-dependent, not a constant**, because R7's drop tracks the sleep
current. That is the kind of error that reads as a weak battery for a year before
anyone questions the ECU.

**Putting the divider on the battery side of D3 and R7 removes it by
construction**, which is better than correcting for it in firmware. R7 then
carries only the converter chain — **117 µA, 55 mV** — and that drop is
downstream of the measurement, so it no longer appears in any reading.

### The diagnostic that falls out of it

Once the divider is on the battery and the INA238 is on the protected rail,
**the two readings straddle the EEC relay**:

| Reads | |
|---|---|
| 180k/30k divider on **pin 55** | **battery voltage** |
| INA238 | **protected rail**, after F1, the relay contact and the 361 RD run |

Their difference, under whatever load the ECU is drawing, is **the drop across
the relay contact and the harness**. Corroded contacts and a tired feed become
*measurable* rather than inferred. Neither reading gave that before, because both
sat on the same side of the relay.

### The lead itself is a safety item

It is **always hot, and it bypasses every switch in the vehicle.**

| | |
|---|---|
| **Fuse** | **2 A blade, within 150–300 mm of the battery post.** The fuse protects the *wire*; the run between post and fuse is unprotected by definition, so it must be short |
| **No board fuse** | Once that fuse exists, a second one on the board protects nothing — **R7 already caps fault current at 30 mA** |
| **Gauge** | Set by **mechanical durability, not ampacity** — the lead carries 184 µA. **18 AWG minimum**, loomed, grommeted at the firewall, clear of heat and edges |
| **Ground** | **Stays single-point on the EEC-V PWRGND pins.** Do *not* run a second ground to the battery negative — that makes a loop with PWRGND |

The ground choice has one visible consequence: the reading includes the
ground-path drop, so it **reads low while cranking**. That is the right thing to
measure — it is what the ECU's own supply actually sees.

## The new requirement this creates: low-battery self-disable

An always-on load is a permanent path to a flat battery. The design has to be
able to give up.

**Firmware does this for free**, using the INA238 already on the shunt:

```
bus voltage < ~11.5 V for N seconds
  → write learned state to SD
  → enter Standby (3 µA)
  → wake only on ignition, never on the RTC
```

Below that threshold the battery is already too weak to be worth defending, and
3 µA is close enough to nothing that it cannot be what fails to start the truck.
The LTC4364's UV pin cannot serve here — it is set at 4.47 V, which is a
brownout threshold, not a battery-protection one.

**This is not optional.** Without it, a slow parasitic drain plus a marginal
battery becomes a no-start that looks like a dead ECU.

## Open questions

- ~~**Wake source wiring.**~~ **Closed** — VPWR through 33k/15k + 100 nF + BAT54J
  to 3.3 V into PC13 / WKUP4. Carrier Inputs sheet.
- ~~**Whether the SD card stays on the switched rail.**~~ **Closed** — there is no
  switched rail to stay on: the 5 V rail stays up parked because it feeds the 3.3 V
  buck. The carrier therefore makes its own:
  - **SD card** behind a TPS22917 on `SD_PWR_EN` (PG11).
  - **`+5V_SW` / `+3.3V_SW`**, two TPS22917 load switches on `SW_RAIL_EN` (PG12,
    100k down), for everything that only matters while running: the three
    74HCT541s and their OE pull-ups, 3 × MAX9926 and their output pull-ups, the
    ADS8588H (AVDD, DVDD, straps), both OPA2376, the O2 bias divider, the knock
    block, the 74HC4051, the TPS2H160B FAULT pull-up, and the **TFT pull-up —
    2.2k into a thermistor, up to 1.5 mA by itself**.
  - **Left always-on:** MCU, watchdog, CAN transceiver (bus wake), SCP receiver,
    the input clamps, both load switches' inputs.
  - Off at reset by the pulldown; every driver input then has its own pulldown,
    so an unpowered buffer leaves every output off.
- ~~**Watchdog behaviour in Standby**, so a hung MCU cannot sit awake drawing
  hundreds of milliamps in a parked truck.~~ **Closed.** The TPS3823A-33
  self-services when its WDI pin is high-impedance, and STM32 GPIOs go high-Z
  in Standby, so the watchdog disables itself the moment the MCU sleeps and
  never wakes it. This depends on **no pull resistor on the WDI net** — 1 kΩ
  to ground is TI's method for defeating the detection. A hung MCU that is
  *awake* still gets reset every ~1.6 s and re-enters Standby from its boot
  path. Costs 15 µA on the always-on rail, in the table above —
  [`output-drivers.md`](output-drivers.md#decided-tps3823a-33dbvr-reset-to-nrst-bss138-inverter-to-oe2).
- ~~**[CONFIRM] A-44's number in the 1–104 scheme.**~~ **Closed, twice over.**
  A dedicated battery lead uses no EEC-V pin — and **there is no mapping to
  find**: the A-xx chart describes a **three-connector PCM**, and this truck has
  one 104-pin connector. See
  [`1999-Ford-F150-4wd-5.42v/oem-connectors.md`](1999-Ford-F150-4wd-5.42v/oem-connectors.md#-eec-v-pcm--power-ground-and-reference-pins--not-this-trucks-pcm).
- **[CONFIRM] the LTC4364 tolerates `OUT` held at battery while `IN` sits at 0 V.**
  That is the parked state *by construction* here. The ideal-diode FET blocks the
  current; what is unverified is the part's own rating for a reverse IN–OUT
  differential with the die unpowered.
- ~~**[CONFIRM] the keep-alive fuse rating on this truck.**~~ **Retired** — the
  lead carries its own 2 A fuse at the post and shares nothing with the vehicle.
- **[CONFIRM] D3 reverse leakage at 125 °C.** It is reverse-biased only with the
  key on and the MCU awake, so it costs nothing in the sleep budget — but a
  Schottky would leak tens of µA and is the wrong part here for exactly that
  reason. **Silicon, and take the 0.42 V.**
