alpauna/TritonECU/docs/adc-daughterboard.md

# ADC daughterboard

> ⚠ **Superseded 2026-10-17: the ADC goes back on the carrier** (user decision).
> The ADS8588H, the MAX6070 reference and the analog front end are placed on the
> main board, in their own ground region away from the coil and injector
> drivers. The two arguments below still decide the layout, not the board count:
> keep the analog return currents out of the driver section, and do not route
> analog signals through it. The board-to-board connector this doc sized is not
> needed.

**Decided 2026-09-09.** The AD7606B, its reference and the analog front end
move to a separate board, joined to the carrier by a board-to-board connector.

## Be honest about which argument justifies it

**Not proximity.** "The MAX6070 must be close to REFIN" is solved by placing
them next to each other on one board. That constraint is real — a 30 mm OUTF run
puts a 514 kHz resonance inside the reference's feedback loop, see
[`always-on-domain.md`](always-on-domain.md) — but it does not need a second
board.

**Two things do justify it:**

1. **Analog ground plane control.** This board low-side switches **eight
   ignition coils**. Sharing a plane between that and a 16-bit converter is the
   hardest mixed-signal problem in the design, and physical separation is the
   most reliable answer available — more reliable than plane splits, guard
   traces or careful placement, all of which depend on getting the return paths
   right by inspection.
2. **Iteration.** [`carrier-board.md`](carrier-board.md) already makes this
   argument for the carrier: *"most first-board mistakes are in the analog and
   driver sections anyway."* The analog front end is the part most likely to
   need revision and the part where mistakes are subtle rather than obvious —
   a bad reading looks like a bad sensor. Respinning a small board beats
   respinning the main one.

## The trap: the analog signals must not traverse the noisy board

**A daughterboard buys nothing if the sensor inputs still run past the coil
drivers to reach it.** That would add a connector without removing the noise
path.

So the layout question that decides whether this works is **where the analog
harness pins land**:

| Arrangement | Verdict |
|---|---|
| Harness → carrier connector → long traces past the drivers → daughterboard | **defeats the purpose** |
| Harness → carrier connector, **daughterboard mounted directly over that region** | **the practical answer** |
| Harness → daughterboard's own connector | cleanest electrically, two harness entries |

**Place the analog input pins of the EEC-V connector and the daughterboard
footprint adjacent**, so the traverse on the carrier is a few millimetres of
short, direct trace on the far side from the drivers. Decide this before the
carrier's placement is fixed — it is not something to retrofit.

## What goes on it

| On the daughterboard | Why |
|---|---|
| **AD7606B** + REFIN caps | the reason for the board |
| **MAX6070** + C<sub>FILTER</sub>, input RC, OUTS tap | must be within ~10 mm of REFIN |
| **Input scaling and protection** for every analog channel | the dividers and clamps belong with the converter, not across a connector |
| **MAX9926 ×2** (crank and cam VR) | small differential signals; losing them stops the engine. Their outputs are comparator-level and cross a connector safely |
| Local analog rail decoupling, after the ferrite | |

| Stays on the carrier | Why |
|---|---|
| MCU, SD, buses | digital |
| All switchers | the noise source |
| Injector and coil drivers | the other noise source |
| 74HCT541 ×3 | digital, and part of the driver chain |

## What crosses the connector, and what it costs

| Signal class | Risk |
|---|---|
| SPI + CONVST / BUSY / RESET / FRSTDATA | low — digital, moderate rate |
| MAX9926 outputs to timer inputs | low — comparator-level |
| 5 V analog, 3.3 V | low — DC, decoupled locally at both ends |
| **Analog sensor inputs** | **this is the one that matters** — see above |

**The ground tie is now connector inductance, not a plane stitch.** A single pin
is 5–20 nH. **Use many ground pins, interleaved between signals**, not a row of
grounds at one end — the return path wants to be adjacent to its signal.

## Connector split: 3.3 V digital on one, 5 V analog on the other

**Decided.** Connector 1 carries digital signals and DGND; connector 2 carries
the 5 V rail, AGND and the analog inputs. Grouping by voltage domain keeps 3.3 V
logic edges physically away from 0–5 V sensor signals, which is the crosstalk
that matters.

### Having separated physically, do not split the plane internally

**One solid ground plane on the daughterboard**, with the ground pins of *both*
connectors tied to it. The temptation after splitting the connectors is to split
AGND and DGND on the board too and join them at one point — **that re-creates
the exact problem the daughterboard exists to avoid.**

The daughterboard *is* the analog domain. Return current from the SPI lines will
find its way back through connector 1's ground pins because that is the
lowest-inductance path adjacent to those signals, and analog return through
connector 2's, without anyone designing it. A split plane forces both through
one tie and puts digital return current under the analog section to get there.

**Interleave ground pins between signals on both connectors**, not grouped at
one end.

## Do not take the MAX6070's supply from VDRIVE

**VDRIVE is the AD7606B's digital output driver supply** — it powers DOUT,
BUSY and the rest of the SPI interface. Every clock edge is a current spike into
trace capacitance, which makes it **by definition the noisiest 3.3 V node on the
daughterboard.** Powering a precision reference from it is starting at the worst
available point.

### But it does not need a separate connector pin

Both come from the same TLV62085 anyway, so a second pin buys isolation only as
far back as the carrier's own distribution. The fix is a **routing rule, not a
part**:

```
3.3 V connector pin
        │
        ├──► VDRIVE, with its own local decoupling
        │
        └──[ 220 Ω ]──┬── MAX6070 IN
                   10 µF ∥ 100 nF
```

**Star-split at the connector entry.** VDRIVE's switching current then never
flows through the reference's supply trace, which is the whole mechanism being
avoided.

The **220 Ω + 10 µF filter is already doing this job** — at ~85 dB it would
probably survive being tapped off VDRIVE directly. Starting from the quiet point
instead costs a routing choice and nothing else, so there is no reason not to.

## Model the layout on the per-channel-return board

Two breakout layouts are in circulation: one that ties every VxGND to a common
plane, and one that routes each return separately. **The second is the right
model, and for a reason that does not depend on the unresolved differential
question below.**

**Board layout cannot make the chip differential.** If VxGND is internally tied
to AGND, no routing changes that. But routing each return separately is still
worth it:

- A **common-plane board ties all VxGND together permanently.** Whatever
  per-channel capability the silicon has is thrown away in copper.
- A **per-channel-return board preserves the option**, and independently gives
  each sensor a defined return path instead of a shared wire.

That second benefit is real regardless. Eight three-wire sensors drawing ~3 mA
each through a shared 50 mΩ return is **1.2 mV appearing on every channel** —
and worse than the offset, it is *cross-coupling*: a change in one sensor's
current shifts every other reading. Separate returns remove it whether or not
the inputs reject common mode.

## Differential sensor returns

Carrying **+ and − all the way to the sensor** is right, and it is what the OEM
does — Ford's circuit 570 is a dedicated PCM signal-return network, not a power
ground, and three-wire sensors get VREF, signal and return rather than grounding
through their housing.

The payoff is rejecting the **ground offset between the ECU and the sensor**,
which in a vehicle is tens to hundreds of millivolts under starter, coil and
alternator current — easily larger than the measurement resolution.

### ⚠ [verify] how differential the AD7606B's VxGND pins actually are

This decides how much the second wire buys:

| If VxGND is… | The return wire gives |
|---|---|
| a **true differential** input | real common-mode rejection of harness ground offset |
| a **Kelvin return internally tied to AGND** | a defined return path, but harness ground offset appears directly as signal error |

Worth reading before assuming the offset is handled. If it is the second case,
the offset has to be managed by grounding topology instead — which is a
different design, not a smaller one.

### And watch for ground loops

A sensor that grounds **both** through its body to the block **and** through the
return wire to the ECU forms a loop, and chassis current induces a voltage in
it. Three-wire sensors are fine by construction. Check any two-wire sensor whose
return might be its housing before running a dedicated return to it.

## Sense VREF at the harness connector, not at the load switch

[`adc-front-end.md`](adc-front-end.md) spends channel 7 on VREF so ratiometric
sensors self-correct. **Take that sense connection at the harness connector**,
downstream of the load switch and the VREF distribution.

The correction is only exact if the ADC measures the same VREF the sensor sees.
Sensing at the load switch output measures VREF before its distribution drop and
before the PTC, which is precisely the error the measurement exists to cancel —
see [`vref-supply.md`](vref-supply.md), where the same argument places the
regulator's feedback on the far side of the PTC.

## Mechanical

**A vehicle vibrates.** A daughterboard supported only by its connector is a
fatigue failure waiting to happen, and an intermittent ADC reads as a bad
sensor. **Standoffs at minimum two corners**, and prefer a connector rated for
vibration over a plain 0.1" header.

## What this defers

Nothing on the carrier. The power design in
[`always-on-domain.md`](always-on-domain.md) is unaffected — the 3.3 V and 5 V
rails simply appear on the connector instead of at a local pin. The reference's
placement constraint moves onto the daughterboard, where it is easy to satisfy.
