alpauna/TritonECU/docs/carrier-board.md

# Carrier board for the Nucleo-144

The Nucleo plugs into the carrier via the **ST morpho headers** (2 × 2×35,
0.1" pitch). The carrier holds everything else.

## Why this before a raw-chip board

- **The MCU section stops being a risk.** No flash, crystal, power sequencing or
  boot straps to get right on a first spin.
- **Programming and debug come free** — the on-board ST-Link, plus the USB VCP
  for console.
- **Ethernet comes free** — PHY, magnetics and RJ45 are already on the Nucleo.
- **The carrier can be iterated** without touching the MCU. Most first-board
  mistakes are in the analog and driver sections anyway.
- If the carrier proves out, a raw-F767 respin reuses the same schematic blocks.

## The rail tree changes

The earlier tree assumed a bare ESP32-P4 fed at 3.3 V. The Nucleo wants **5 V
into E5V** and makes its own 3.3 V, and it draws far more than the 30 mA the
old 5 V digital rail was sized for — roughly **150 mA, or ~300 mA with Ethernet
active**.

> ⚠ **The tree below is superseded.** It predates the **2026-09-08** decision that
> replaced the LM5155-Q1 SEPIC with the **MAX25239 buck-boost at 5.0 V**. There is
> no 6 V main rail any more, and the consequence is a simplification:
>
> ```
>  12 V ─[fuse]─[TVS]─[LTC4364-2]─► MAX25239 buck-boost ──► 5.0 V ──┬─► Nucleo E5V
>                                                                   ├─► AD7606 AVDD,
>                                                                   │   MAX9926, 74HCT541
>                                                                   └─► TLV62085 ─► 3.3 V
> ```
>
> **The carrier's 5 V buck is redundant.** The POWER board already delivers
> regulated 5.0 V, which is exactly what E5V wants — so E5V connects to it
> directly with nothing in between.
>
> **VREF does not come off the 5 V rail** — an LDO cannot make 5.00 V from 5.0 V.
> See [`vref-supply.md`](vref-supply.md), which already handles this.

Superseded tree, kept for the reasoning:

```
 12 V ─[fuse]─[TVS]─[LTC4364-2]─► LM5155-Q1 SEPIC ──► 6.0 V main
                                                          │
        ┌─────────────────────────────────────────────────┤
   Buck → 5.0 V                                    LDO → 5.00 V VREF
   Nucleo E5V (~300 mA)                            ~25 mA, limited ~150 mA
   AD7606 AVDD, MAX9926, 74HCT541 (~80 mA)         harness-facing
   ~400 mA total
```

- **A buck, not an LDO, for the 5 V rail.** 400 mA across 1 V of headroom is
  0.4 W in a linear — survivable but needlessly warm in a sealed box.
- **VREF stays a linear from the 6 V rail.** 25 mA at 1 V is 25 mW, and the
  LDO's PSRR is what keeps switcher ripple off a reference every sensor is
  ratiometric to.
- **The 6 V main rail is unchanged**, so the SEPIC design and its calculator
  still apply.

### Powering the Nucleo — confirmed on the bench

**Feed E5V with 5 V. Do not use VIN.**

| Pin | Accepts | Notes |
|---|---|---|
| **E5V** | **5 V** | what the carrier's 5 V buck provides |
| VIN | **7–12 V** | its regulator will not start below ~7 V |
| U5V | — | ST-Link USB, the default |

Verified the hard way: **VIN fed with 5 V leaves the board dark.** The 6 V main
rail is also below VIN's minimum, so VIN is not an option for this design at
all — E5V is the only sensible feed, and the 5 V buck in the rail tree exists
precisely for it.

**RESOLVED against UM1974 Rev 11** — the remembered designation was right. `JP3`
selects the source, and **E5V is CN11 pin 6, rated 500 mA** (Table 7):

| JP3 | source |
|---|---|
| **pins 1–2** | **E5V** ← what this design uses |
| pins 3–4 | U5V, ST-LINK VBUS — the factory default |
| pins 5–6 | VIN |

At ~150 mA (Ethernet off) the 500 mA limit is comfortable; ~300 mA with Ethernet
active leaves less margin.

### The power-up order is mandatory, not advisory

The earlier note here — that the carrier supply and the ST-LINK USB are simply
independent — is true but incomplete. **UM1974 §7.4.2 specifies an order**, and
violating it puts the *PC* at risk, not the board:

```
1. JP3 on pins 1-2 (E5V)
2. Check JP1 is REMOVED
3. Connect the carrier's 5 V to E5V
4. Power on
5. Confirm green LD6 lights
6. THEN connect USB to the PC
```

> If USB comes first, the board enumerates on U5V and then has an external supply
> applied on top. The manual's stated risks: **the PC may be damaged** or current
> limited, and since JP1 must be off the board requests **300 mA at enumeration**,
> which a host may refuse — leaving LD6 dark and the board unpowered.

`JP1` declares the USB current budget: **OFF = 300 mA**, ON = 100 mA. Leave it off.

**Bench rule: power the ECU first, plug USB second.** Every time.

## Pins to avoid on the morpho headers

Some Nucleo-144 pins are already committed and must not be reused:

| Function | Pins |
|---|---|
| Ethernet RMII | PA1, PA2, PA7, PB13, PC1, PC4, PC5, PG11, PG13 |
| ST-Link VCP | PD8 (TX), PD9 (RX) |
| USB OTG FS | PA8–PA12 |
| LEDs | PB0, PB7, PB14 |
| User button | PC13 |

**RESOLVED against UM1974 Rev 11 — every entry above is correct.** The list was
from memory and it verified exactly, Ethernet included (Table 11 lists those same
nine pins).

### But none of them are permanently lost

This is the part that changes carrier pin assignment: **each is committed only by a
solder bridge or jumper**, and clearing it returns the pin to the morpho header.

| Pin | Committed to | Free it by |
|---|---|---|
| PA1 | RMII Ref Clock | SB13 **OFF** |
| PA2 | RMII MDIO | SB160 **OFF** |
| PC1 | RMII MDC | SB164 **OFF** |
| PA7 | RMII RX Data Valid | **JP6 OFF** — a jumper, no rework |
| PC4 | RMII RXD0 | SB178 **OFF** |
| PC5 | RMII RXD1 | SB181 **OFF** |
| PG11 | RMII TX Enable | SB183 **OFF** |
| PG13 | RMII TXD0 | SB182 **OFF** |
| PB13 | RMII TXD1 | **JP7 OFF** — a jumper, no rework |
| PA9 | USB VBUS | SB127 **OFF** |
| PA10 | USB ID | SB125 **OFF** |
| PA11 | USB DM | SB133 **OFF** |
| PA12 | USB DP | SB132 **OFF** |
| PA8 | USB SOF | **no bridge** — already on the Zio as D70 |
| PB0 | LD1 green | SB120 OFF / SB119 ON |
| PD8 | VCP TX (USART3) | SB5 OFF **and** SB7 ON |
| PD9 | VCP RX (USART3) | SB6 OFF **and** SB4 ON |

**So "pins to avoid" is really "pins to avoid unless a bridge is cleared."**

### The Ethernet decision is worth making explicitly

Dropping Ethernet buys **two things at once**: it frees **nine pins**, and it halves
the E5V draw from ~300 mA to ~150 mA against the 500 mA limit. Two of the nine are
jumpers (JP6, JP7); the other seven are solder-bridge rework.

**Decide before the carrier is laid out**, because assigning those nine to carrier
functions is the commitment — not the bridges, which can be cleared at any time.

Even after all of that, ~114 I/O leaves the assignment unconstrained. That is the
point of the platform change.

> **Correction: the requirement is 80, not 37.** 37 was the ESP32-era figure.
> Going native — dropping the MCP23S17 expander chain — is what took it to
> **80 of ~114, 32 spare after SWD** ([`pin-budget.md`](pin-budget.md)). Freeing
> the nine Ethernet pins takes that to **41 spare**.

## DECIDED: no Ethernet, and the Nucleo-144 stays

> ⚠ **Superseded 2026-10-16 for the carrier:** the Nucleo-144 was too large for the
> 158 × 174 envelope, so the carrier takes a compact **STM32F767ZIT6 module**
> instead, at 7.47 mm (Samtec FTSH/FLE stack): a 5 mm Würth SMT spacer on the module, a PEM SMTSO-M3-2ET 2 mm SMT standoff on the carrier, and a 0.5 mm M3 washer between them. See [`mcu-module.md`](mcu-module.md).
> The Nucleo remains the bench board. The no-Ethernet decision stands, and it is
> what lets the module be small.

Ethernet is dropped — USB is sufficient for tuning. That prompted the reasonable
question of whether a smaller STM32 board would now do. **It will not.**

| package | ~GPIO | vs 80 needed |
|---|--:|---|
| LQFP64 (Nucleo-64) | ~50 | **short by 30** |
| LQFP100 | ~82 | 2, and **0 after SWD** |
| **LQFP144 (F767ZI)** | **~114** | **32 spare** ✓ |

A smaller footprint is not a trim, it is unbuildable. LQFP100 counts to 80 on
paper and leaves nothing for a test point, a mistake, or the future-proofing
[`platform-decision.md`](platform-decision.md) names as an explicit goal.

**Nor is an Ethernet-free Nucleo-144 worth switching to.** Seven solder bridges
and two jumpers free all nine pins on the board already in hand; moving to, say,
an F446ZE to skip that rework would cost 216 → 180 MHz, 2 MB → 512 KB flash and
512 KB → 128 KB RAM.

**Where dropping Ethernet pays is the raw-chip board:** no PHY, no magnetics, no
RJ45, less area. Record it as a requirement for that stage — it costs nothing now
and is a real BOM saving later.

> ⚠ **Consequence to confirm.** With no radio *and* no Ethernet, the tuning and
> telemetry path is **USB only** — a laptop physically connected. Fine for tuning,
> but the ESP32 design's web UI, WebSocket and MQTT do not survive without a
> network interface. If anything must reach a dash or a phone with the engine
> running, that is the gap, and it wants naming now rather than at integration.
>
> **RESOLVED — add one CAN channel.** 2 pins, a transceiver, and the externals bus
> problem is solved properly rather than through a laptop. See
> [`can-bus.md`](can-bus.md). A 1999 F-150 has no factory CAN, so it is a private
> bus; and the prior MegaSquirt build on this truck already ran one.

## Setting up a Nucleo from scratch

See [`nucleo-setup.md`](nucleo-setup.md) — the full runbook, including the one
thing that actually blocks a first-time bring-up (the ST-Link udev rule) and
the two quirks that waste time if you meet them unprepared.

## SD card — SPI4 on Port E

The Nucleo has no SD socket, so a module is wired to the morpho headers.

| SD module | Nucleo | Function |
|---|---|---|
| CLK / SCK | **PE2** | SPI4_SCK |
| MISO / DO | **PE5** | SPI4_MISO |
| MOSI / DI | **PE6** | SPI4_MOSI |
| CS | **PE4** | software chip select |
| 3V3 | 3V3 | **3.3 V modules only** |
| GND | GND | |

**Why Port E.** It carries no fixed function on the Nucleo-144 — no Ethernet,
no ST-Link, no USB, no LEDs — so nothing is displaced. It also leaves the
Arduino-header SPI alone, which matters because **PA7 is RMII_CRS_DV** on this
board and the conventional SPI1 trio is already broken by Ethernet.

**Why SPI rather than SDMMC.** Four signals instead of six, and the card holds
config and logs where bandwidth is not the constraint. SDMMC1 (PC8–PC12 + PD2)
stays available if high-rate logging later needs it.

**Bus speed starts at 4 MHz**, deliberately. Flying leads to an SD module are
not a controlled-impedance environment, and a card that enumerates at 4 MHz but
corrupts at 25 MHz is a miserable fault to chase. Raise it once the card is on
a PCB — same discipline as the AD7606's 1 MHz start.

The firmware distinguishes the two failure modes rather than reporting a
generic error:

| Report | Means |
|---|---|
| `card did not initialise (err 0x01…)` | nothing responded — wiring, CS, or 5 V module |
| `filesystem is unreadable` | card is there; wrong filesystem (FAT16/32 only) |

## AD7606 — SPI2, its own bus

| Signal | Nucleo | Note |
|---|---|---|
| SCK | **PB10** | SPI2_SCK |
| DOUTA | **PC2** | SPI2_MISO |
| *(MOSI)* | PC3 | unused in hardware mode; wired for a later software-mode part |
| CS | **PB12** | |
| CONVST | **PB11** | tie CONVSTA and CONVSTB together |
| BUSY | **PB1** | |
| RESET | **PB2** | active high — must sit low to run |
| FRSTDATA | **PB15** | optional |
| OS0 / OS1 / OS2 | **PB3 / PB4 / PB5** | oversampling off for now |
| RANGE | **PB6** | ±10 V high, ±5 V low |

**A separate bus from the SD card**, which is on SPI4. The ADC is sampled at
engine rate and must never wait behind a card write — sharing a bus would put
filesystem latency directly into the sampling interval.

Avoids PB0/PB7/PB14 (LEDs) and PB13 (Ethernet RMII_TXD1).

**The SPI mode must be re-established on this host.** The same AD7606 needed
MODE0 on the Teensy and MODE2 on the ESP32-P4 — it is a property of the
host/ADC pairing, not of the ADC. The driver's default is inherited from the P4
and is a placeholder until swept. A wrong CPHA reads **exactly 2× high while
looking perfectly stable**, which is the failure mode that cost time on the P4
and would cost it again.

## Using an external ST-Link

The Nucleo's on-board ST-Link failed during bring-up: first dropping characters
on its VCP, then refusing to enumerate at all. The same cable and the same USB
port enumerated a Teensy without trouble, which isolates it to the ST-Link.

To drive the on-board MCU from an external ST-Link:

1. **Remove both CN4 jumpers** — these connect the on-board ST-Link to the
   target MCU. Leaving them in puts two debuggers on one SWD bus.
2. Connect the external probe to morpho **CN11 pin 13 = SWDIO (PA13)**,
   **pin 15 = SWCLK (PA14)**, **pin 14 = NRST**, plus **GND**, and VTREF to a
   real 3V3 pin (UM1974 §7.2).
3. An STLINK-V3 needs the `upload_protocol = custom` OpenOCD command — the
   board file's hla transport rejects it. See `docs/nucleo-setup.md` §3b.

Confirmed against UM1974 Rev 11 (MB1137): the jumper block is **CN4**, not CN2.
The bench currently uses the other working route — V3 on CN6 with CN4
*fitted* — documented in `docs/nucleo-setup.md` §3b.

**Bring SWD out to a header on the carrier.** Four pins, and it means a failed
on-board debugger never blocks the project again. This session is the argument
for it.

## Order of work

1. ~~M0 on the Nucleo~~ **Done 2026-09-07.** Device ID 0x451 rev 0x1001,
   216 MHz, 2048 KB flash, all read from the chip's own registers.

   Two bench notes worth keeping: the ST-Link needed a **udev rule** before
   OpenOCD could claim it (`LIBUSB_ERROR_ACCESS`), and its **VCP and SWD share
   one USB device** — so resetting over SWD disconnects the console. The
   firmware reprints its identity on receiving `i`, which sidesteps that. The
   VCP also drops the occasional byte on a long burst at 115200; fine for a
   console, not something to base datalogging on.
2. **Pin map** — assign the 37 signals to real morpho pins, avoiding the list
   above.
3. **AD7606 on flying leads** — port the driver, **re-sweep the SPI mode**, and
   verify against the same known signals used on the P4.
4. **MAX9926 + crank sync** — the milestone everything else waits on.
5. **Carrier schematic**, once the interfaces are proven rather than assumed.

Steps 1–4 need no PCB at all.
