alpauna/TritonECU/docs/roadmap.md

# Rebuild roadmap

Starting again, deliberately small. The rule: **nothing enters the tree until it
has been proven on hardware**, and each milestone proves exactly one thing.

## Why restart rather than port

The existing firmware is ~14,500 lines carrying a web UI, FTP server, MQTT,
tar.gz log rotation, a six-chip SPI expander chain and a custom-pin subsystem —
all written against an ESP32-S3 that was never in a truck. It works, but it was
built before any of the vehicle facts in `1999-Ford-F150-4wd-5.42v/` were
known, and one of its core decisions is now known to be wrong:

> Coils and injectors are on MCP23S17 SPI expanders (`coilPins` 264–271,
> `injectorPins` 280–287).

At 6000 rpm one crank degree is **27.8 µs**. An SPI transaction to an expander
is several microseconds *at best*, is not deterministic, and cannot be driven
from a hardware timer. Spark timing cannot live behind a port expander. That is
not a bug to patch; it is a structural assumption that has to change, and it
touches ignition, injection and the pin map together.

The old tree stays in git history and on the `esp32-p4` branch. Proven pieces
get ported forward deliberately — `TuneTable`, `CJ125Controller` and the sensor
maths are worth keeping. Everything else earns its place again.

## Scope

**[`v1-scope.md`](v1-scope.md) is the build list.** Anything not on it is
deferred, regardless of how good an idea it is.

## Principles

1. **Hard real-time is physically separate.** Spark and injection timing run
   from hardware timers on a dedicated core, touching nothing that can block.
   No SPI, no heap, no logging in that path.
2. **One milestone, one proof.** Each step ends with a specific bench
   observation, not "it compiles".
3. **Wi-Fi and the web UI come late.** They are the least risky and the most
   distracting part. An ECU that runs without them is worth more than a pretty
   dashboard that cannot sync a crank.
4. **Every vehicle fact is cited.** The `1999-Ford-F150-4wd-5.42v/` documents
   are the source of truth; assumptions get tagged, not buried.

## Milestones

| # | Milestone | Proves | Done when |
|---|---|---|---|
| **M0** ✅ | Board bring-up | toolchain, upload path, board identity | **Done on both targets.** ESP32-P4 2026-09-06; **STM32F767ZI 2026-09-07** — device ID 0x451 rev 0x1001, 216 MHz, 2048 KB flash |
| **M1** ✅ | Storage + config | SD, JSON config, persistence | **Done on both targets.** ESP32-P4 (SDMMC) 2026-09-06; **STM32 (SPI4) 2026-09-07** — reads back the same card the P4 wrote |
| **M2** ✅ | Analog front end | AD7606 | **Done on both targets.** ESP32-P4 2026-09-06; **STM32 2026-09-07** — same two known signals, SPI_MODE2 correct on both. See [`adc-front-end.md`](adc-front-end.md) |
| **M3** ◐ | **Crank sync** | VR conditioning + 36-1 decode | Decode logic **done** — 10 native tests pass, 200 to 6000 rpm including a degraded cranking gap ratio. Electrical half still needs the MAX9926 |
| **M4** ◐ | Cam sync | full engine position | Logic **done** — 6 native tests. Rejects implausible cam pulses and drops 720° sync with crank sync. Needs hardware |
| **M5** ◐ | Spark output | timed output | Scheduler **done** — 12 native tests, incl. the rpm at which dwell overlaps. Needs coil drivers |
| **M6** | Injection output | timed output | Scope shows pulse width and phasing; 8 channels sequential |
| **M7** | Sensors → fuel | the maths | MAF/TPS/CHT/IAT feed a fuel calculation; open-loop numbers sane |
| **M8** | Wi-Fi + status page | ESP32-C6 hosted link | Serves live engine state over Wi-Fi |
| **M9** | Knock | piezo channel + DSP | Detects a tap on the block, windowed per cylinder |
| **M10** | Closed loop | CJ125 / wideband | AFR correction converges |
| **M11** | SCP bus | J1850 PWM | Reads the OEM PCM's traffic on the bench first, then the truck. **Hardware is on the v1 board** — DRV8837 + TLV7031; without it the truck has no tach, speedo or MIL. **Phase 0 must transmit into live traffic, not only listen** — see [`review-scp-chain.md`](review-scp-chain.md) §2 |
| **M12** | Transmission | same board, same MCU — shift solenoids, TCC, EPC, OSS, TR | 4R70W shifts under command on the bench; the board is built for the 4R100 in the truck ([`4r100-deltas.md`](4r100-deltas.md)). **Not a second board** — see [`v1-scope.md`](v1-scope.md#correction-there-is-no-separate-transmission-node) |

M3 is the one that matters. It is the highest-risk item in the whole project —
VR amplitude is weakest at cranking, which is exactly when sync must be
established — and nothing downstream is testable until it works.

## Testing

```bash
pio test -e native          # decoder logic, no hardware
pio run -e selftest -t upload    # header shorts and bridges
pio run -e spisweep -t upload    # SPI mode against a known signal
pio run -e rangecheck -t upload  # is the RANGE pin connected
pio run -e noisefloor -t upload  # achieved noise floor and noise-free bits
```

## Layout

```
firmware/ecu/          self-contained PlatformIO project
  src/                 implementation
  include/             headers
  test/                native unit tests where the maths allows
```

The old tree at the repository root is untouched for now, so both can be built
and compared. It gets removed once the rebuild passes it.
