alpauna/TritonECU/docs/output-drivers.md

# Output driver parts — ignition, injection, relays and solenoids

Both loads are dumb and low-side switched: permanently at 12 V on one side, the
driver grounds the other. See `custom-board.md` for why their clamping
strategies are opposite.

---

## Ignition: onsemi **ISL9V3040** (EcoSPARK)

Purpose-built ignition IGBT with the clamp integrated — which is the whole
point, because an ignition primary must be *allowed* to fly back to a few
hundred volts, then stopped short of destroying the device.

| Parameter | Value |
|---|---|
| Clamp voltage | **400 V** |
| Collector current | **17 A** |
| V<sub>CE(sat)</sub> | 1.58 V |
| Self-clamped inductive switching energy | **300 mJ** |
| Packages | TO-220 (`P3`), TO-263/D²PAK (`S3S`), TO-252/DPAK (`D3ST`), TO-262 |
| Automotive temp variant | `-F085C` suffix |

Against a coil drawing **6–10 A peak**, the 17 A rating is comfortable.

### Check the energy margin against your actual coil

This is the number that decides whether the part survives, and it depends on
the coil rather than the driver:

```
E = ½ · L · I²
```

### ✅ MEASURED: **L = 1.5 mH** (LCR meter, 2026-09-18)

> ~~A COP primary of ~5 mH at 8 A stores 160 mJ — about 1.9× margin. But 6 mH at
> 10 A is 300 mJ, exactly at the limit and therefore not acceptable.~~
> **That was a guess, and it was about 3.3× too high.** Energy goes as L, so the
> whole concern evaporates. Numbers below from [`calc/coil_dwell.py`](calc/coil_dwell.py).
>
> Read **1.48 mH** first and **1.50 mH** on a second pass with better leads. The
> difference is **1.35 %**, nothing here is remotely that sensitive, and 1.48
> implied three significant figures the measurement does not support. **1.5 mH**,
> which also makes τ = L/R exactly **3.0 ms** and puts 300 mJ at exactly **20 A**.

| Peak current | At 5 mH *(assumed)* | **At 1.5 mH *(measured)*** | Margin |
|--:|--:|--:|--:|
| 8 A | 160 mJ | **48 mJ** | **6.3×** |
| **10.3 A** — 80 mJ, a healthy COP spark | 265 mJ | **80 mJ** | **3.75×** |
| 12 A | 360 mJ | 108 mJ | 2.8× |
| 16 A | 640 mJ | 192 mJ | 1.6× |
| **20.0 A** | 1000 mJ | **300 mJ** | **1.0× — the rating** |

**The 300 mJ rating is reached at exactly 20.0 A.** The operating point sits **3.75×
under it**. The ISL9V3040 is comfortably the right part and there is no need to
reach for a higher-energy EcoSPARK member.

### Dwell — and it barely depends on the primary resistance

`I(t) = (V/R)(1 − e^(−tR/L))`. Early in the charge curve the rise is set by **L,
not R**: `di/dt = V/L = ` **9.0 A/ms** at 13.5 V.

| Target | Dwell at 13.5 V, R = 0.3 → 0.7 Ω |
|---|---|
| 8.2 A — 50 mJ | **1.01 → 1.18 ms** |
| **10.3 A — 80 mJ** | **1.31 → 1.65 ms** |
| 20.0 A — *the rating* | 2.95 → 5.54 ms |

That sweep was made before R was known, and its conclusion held: **spread across
the whole plausible range of R is ~10 % at the operating point** (all at 13.5 V),
so the dwell was decided to within ten percent without the second measurement.
It is ~60 % at the *rating*, which is why R still mattered for the fault margin —
and that is what the measurement below settles.

**Note what dominates instead: battery voltage.** Across 9 → 14.4 V the dwell
moves **1.9×**, against 10 % for the whole range of R. See the dwell table below.

### ✅ MEASURED: **R = 0.5 Ω** (DCR, good leads)

> ⚠ **A first 2-wire reading gave 1.8 Ω, and that was the leads.** At half an ohm
> the test leads *are* most of a 2-wire reading. 0.5 Ω is also what published
> DG508-family figures predict, and it mattered: 1.8 Ω would have meant the coil
> current-limited itself at 8 A and could never reach the IGBT's rating.
>
> **Why the inductance survived the same bad leads and the resistance did not** —
> leads add roughly 1 mΩ/cm and tens of nH:
>
> | | Lead contribution | Effect on the reading |
> |---|---|---|
> | R = 0.5 Ω | ~1.3 Ω | **3.6× high** |
> | L = 1.5 mH | ~50 nH | **0.003 % high** |
>
> A series error that swamps half an ohm is invisible against 1.5 mH. Worth
> carrying as a habit: **under an ohm, null the leads or use four wires; for
> millihenries, do not bother.**

| At 14.4 V | |
|---|---|
| I<sub>sat</sub> = V/R | 28.8 A |
| τ = L/R | **3.00 ms** |
| Stuck-on energy | **622 mJ — 2.07× the rating** |
| Dwell to reach the rating | **3.56 ms**, ~2.7× nominal |

**The operating point is comfortable.** We charge to **10.3 A for 80 mJ**, which
is **3.75× under** the rating, and τ = 3.00 ms means the ramp is still in its
near-linear region — so dwell is predictable and insensitive to small errors in R.

### The dwell table — this is the deliverable

Target **10.3 A / 80 mJ**. Dwell must track battery voltage:

| V<sub>batt</sub> | Dwell for 80 mJ | Dwell for 50 mJ |
|--:|--:|--:|
| 9.0 V — cranking | **2.56 ms** | 1.81 ms |
| 10.0 V | 2.18 ms | 1.57 ms |
| 12.0 V | 1.69 ms | 1.25 ms |
| 12.6 V | 1.58 ms | 1.17 ms |
| 13.5 V | 1.45 ms | 1.08 ms |
| **14.4 V** | **1.33 ms** | 1.00 ms |
| 15.0 V | 1.27 ms | 0.95 ms |

**2.56 ms at 9 V against 1.33 ms at 14.4 V — a 1.9× span.**

> **And the truck already tells us when it is cranking.** EEC-V **pin 64** —
> `199 LB/YE`, **TR3A** — carries 12 V while cranking, because the DTR sensor is
> also the neutral safety switch and feeds 199 from the start circuit *through*
> the range switch. So it means **cranking in Park or Neutral**, which is a
> better gate for cranking enrichment than a bare start signal would be.
> [`1999-Ford-F150-4wd-5.42v/schematic-findings.md`](1999-Ford-F150-4wd-5.42v/schematic-findings.md) §21. A fixed dwell would
either waste energy and heat the driver at high line, or miss the target while
cranking — which is exactly when spark energy matters most. **The dwell-vs-voltage
table is not optional.**

> This is what `battery voltage` on the ADC is *for*, beyond diagnostics — and
> [`review-ignition-injection.md`](review-ignition-injection.md) already requires
> it to be **sampled away from injection events, not averaged through them**,
> which is why [`adc-front-end.md`](adc-front-end.md) forbids a filter capacitor
> at the divider.

### Part-to-part spread is larger than the measurement — and it self-cancels

**One coil was measured; eight are fitted.** At the nominal 1.33 ms dwell:

| Coil L | Peak current | Energy | vs 300 mJ |
|--:|--:|--:|--:|
| 1.35 mH (−10 %) | 11.22 A | 84.9 mJ | 3.5× |
| **1.50 mH** | **10.33 A** | **80.0 mJ** | **3.8×** |
| 1.65 mH (+10 %) | 9.57 A | 75.5 mJ | 4.0× |

**±10 % of coil spread moves delivered energy by only ~2 %**, because a
higher-inductance coil charges more slowly and the two effects oppose. Margin
stays above 3.5× throughout.

So the 1.48-vs-1.50 question is noise inside noise. **What the dwell calibration
needs margin for is battery voltage — a 1.9× span — not the coil.**

**Overlap is not a constraint anywhere the engine runs.** At the 14.4 V dwell the
90° event spacing collides above **11 300 rpm**. The 2.56 ms cranking dwell would
collide at 5880 rpm — at 9 V, where the engine is turning 200.

### ⚠ The fault case is stuck-on, and it exceeds the rating at any R

A stuck-on output does not climb forever — current saturates at `V/R`:

| R | I<sub>sat</sub> at 14.4 V | Stored | vs 300 mJ | Coil dissipates |
|--:|--:|--:|--:|--:|
| 0.3 Ω | 48.0 A | 1728 mJ | **5.8×** | 691 W |
| **0.5 Ω** *(measured)* | 28.8 A | **622 mJ** | **2.07×** | 415 W |
| 0.7 Ω | 20.6 A | 317 mJ | **1.1×** | 296 W |

**At any plausible resistance a stuck-on coil stores more than the IGBT's
avalanche rating**, and turning it off then dumps that into the device — by which
point the coil is cooking at hundreds of watts anyway. **The measured 0.5 Ω is
the middle row: 622 mJ, 2.07×.**

**This is the number behind the `OE2` watchdog.** At the measured 0.5 Ω a
stuck-on coil is **2.07× the IGBT's rating** and reaches it after 3.56 ms — about
2.7× the nominal dwell. The firmware dwell limit is the first line; the hardware
watchdog is what covers a firmware hang.
[`v1-scope.md`](v1-scope.md) carries it as *"footprint yes, strap OE2 low for
v1"* — that is still the right call for v1, but it is now a quantified risk
rather than a principle.

### Scheduler: dwell overlap is not a constraint

At 8 cylinders the spark events are 90° apart — **2.50 ms at 6000 rpm** against
the measured **1.33 ms** dwell at 14.4 V, so **no overlap below ~11 300 rpm**. With COP each coil has its
own driver so overlap would be legal anyway; it would only mean two coils
charging at once, ~21 A from the harness for a few hundred microseconds.
`SparkScheduler::maxRpmForDwell()` already exposes this end of the trade.

### Gate drive — resolved, and simpler than expected

The datasheet leads with **"Logic Level Gate Drive"**, and the part has its own
gate network built in:

| Parameter | Value |
|---|---|
| **R1, internal series gate resistance** | **70 Ω** |
| **R2, internal gate-to-emitter resistance** | **10 kΩ – 26 kΩ** |
| Gate charge Q<sub>G(ON)</sub> | **17 nC** at 10 A, V<sub>GE</sub> = 5 V |
| Gate threshold V<sub>GE(TH)</sub> | 1.3–2.2 V at 25 °C |
| **Gate plateau V<sub>GEP</sub>** | **3.0 V** |
| Datasheet switching conditions | V<sub>GE</sub> = 5 V, **R<sub>G</sub> = 470 Ω** |

**The 10 kΩ gate pulldown is already inside the device** (R2). The boot-state
protection discussed in `custom-board.md` is therefore built in for the
ignition side — an external pulldown is belt-and-braces rather than essential.

**But do not drive it from 3.3 V.** The gate plateau is **3.0 V**, so a 3.3 V
GPIO leaves only 0.3 V of overdrive. Every V<sub>CE(sat)</sub> figure is
characterised at V<sub>GE</sub> = 4.0–4.5 V. At 3.3 V the device conducts but
does not saturate, and the failure is **heat, not a fault** — 6–10 A through an
IGBT that is only partly on.

**No dedicated gate driver IC is needed either.** Gate charge is only 17 nC and
70 Ω of the series resistance is already internal. A plain **5 V logic buffer**
is sufficient.

#### Recommended: one 74HCT541 for all eight coils

- **HCT, not HC.** HCT inputs accept 3.3 V as a valid high (V<sub>IH</sub> =
  2.0 V at V<sub>CC</sub> = 5 V); HC would want 3.15 V minimum and be marginal.
- Powered from **5 V**, so the gate sees a full 5 V — comfortably above the
  3.0 V plateau and matching the datasheet's characterisation.
- Octal, so **one package drives all eight channels**.
- **Two output-enables, and they are a two-key interlock.** The '541 has
  **`OE1` (pin 1) and `OE2` (pin 19), both active-low and ANDed internally** —
  *either* one high forces all eight outputs to high-impedance. Pull both up to
  5 V with 10 kΩ so the outputs are disabled at power-on. Combined with the
  IGBT's internal 10–26 kΩ gate-to-emitter resistor, no coil can be energised
  before something actively permits it.

#### Use the two enables independently

Tying them together works, but wastes the more useful arrangement:

| Enable | Driven by | Meaning |
|---|---|---|
| **`OE1`** | firmware GPIO | "engine position is known and ignition is armed" |
| **`OE2`** | **hardware watchdog** | "firmware is still alive" |

The second one addresses a failure the first cannot. If firmware hangs *while a
coil is charging*, that coil stays energised — 6–10 A continuously into a
primary designed for a few milliseconds of dwell. The coil cooks, and quite
possibly the IGBT with it. No amount of software care helps, because the
software is what stopped.

A supervisor IC with a watchdog input driving `OE2` fixes it in hardware:
firmware must kick it periodically, and if it stops, the buffer goes
high-impedance and every gate is pulled down by the IGBT's own internal
resistor. It costs one part and one GPIO, and it is the difference between a
hung ECU being an inconvenience and a hung ECU being a destroyed coil.
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
