alpauna/TritonECU/docs/custom-board.md

# Custom ECU board — raw ESP32-P4

Replaces the Waveshare carrier. Everything the truck needs, nothing it does not.

## GPIO0–15 are usable — question resolved

An earlier concern: ESP-IDF's `SOC_GPIO_VALID_DIGITAL_IO_PAD_MASK` for the P4
is `0x007FFFFFFFFF0000`, which excludes GPIO0–15 and looked like it might halve
the usable pin count.

It does not. `SOC_RTCIO_PIN_COUNT = 16` — **GPIO0–15 are the RTC/LP IO pins**.
They are dual-domain: ordinary digital I/O through the HP GPIO matrix, *and*
reachable by the LP core. The mask means "digital-only pads", and these have an
extra function rather than a missing one. The Waveshare board runs an I2S codec
on GPIO9–13, which settles it empirically.

One useful consequence: RTC/LP pins support **hold** — they retain their state
across resets and sleep. For an ECU that is worth having on outputs that must
stay in a known state, though it also means hold has to be explicitly released
on wake or the pin appears stuck.

## Pin assignment

55 GPIOs. Committed first:

| GPIO | Reserved for |
|---|---|
| 14–19 | SDIO to the ESP32-C6 — D0 14, D1 15, D2 16, D3 17, CLK 18, CMD 19 |
| 54 | ESP32-C6 reset |
| 35, 36 | boot strapping — BOOT_MODE, BOOT_MODE2 |
| 37, 38 | UART0 — console and flashing |
| 39–41, 45 | SD card, **SDMMC 1-bit** — CLK, CMD, D0, card power |

That is **15 committed, leaving 40**.

### Engine control

| Function | GPIO | Notes |
|---|---|---|
| Coil 1–8 | **46, 47, 48, 49, 50, 51, 52, 53** | contiguous, no strapping pins |
| Injector 1–8 | **26, 27, 28, 29, 30, 31, 32, 33** | contiguous |
| CKP (VR ch1) | **20** | MAX9926 COUT1 |
| CMP (VR ch2) | **21** | MAX9926 COUT2 |
| OSS (VR ch3) | **22** | second MAX9926, or the same one if CMP is Hall |

TSS is not fitted on the 4R70W, so only three VR channels are needed.

### Buses and analog

| Function | GPIO |
|---|---|
| SPI SCK | 34 |
| SPI MOSI | 23 |
| SPI MISO | 2 |
| AD7606 CS | 3 |
| AD7606 CONVST | 4 |
| AD7606 BUSY | 5 |
| MCP23S17 chain CS | 6 |
| I2C SDA / SCL | 1 / 24 |

### Timed outputs and the bus

| Function | GPIO |
|---|---|
| J1850 TX_P / TX_N / RX | 7 / 8 / 9 |
| TCC PWM | 10 |
| EPC PWM | 11 |
| IAC PWM | 12 |
| Tach out | 13 |
| VSS out (to cruise) | 0 |
| **Ignition arm — 74HCT541 `OE1`** | **25** |

**37 assigned, 0 spare** — verified by [`../hardware/pinmap.py`](../hardware/pinmap.py),
which checks for duplicates and clashes rather than relying on hand-counting.
That count found a real omission: **SPI MOSI was missing**, which the MCP23S17
chain requires to be written to at all.

Zero spare is tight but it is a genuine fit, and there is slack available if
needed:

| Lever | Frees |
|---|---|
| SD card in 1-bit SDMMC | **+3** |
| Semi-sequential injection (8 → 4 drivers) | +4 |
| Tach and VSS over SCP instead of discrete outputs | +2 |

**Decided: 1-bit SDMMC on v1.** D1–D3 (GPIO42–44) are freed. The card carries
config and logs only, so 4-bit bandwidth buys nothing, and three spare pins turn
a zero-margin layout into one that can absorb a mistake found at assembly.

Final: **37 assigned of 40, 3 spare (GPIO42, 43, 44).**

Levers still in reserve if they are ever needed: semi-sequential injection
(8 → 4 drivers, +4) and moving tach and VSS onto SCP (+2).
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
