alpauna/TritonECU/docs/1999-Ford-F150-4wd-5.42v/4R70W-Relay-Related-Modules.png

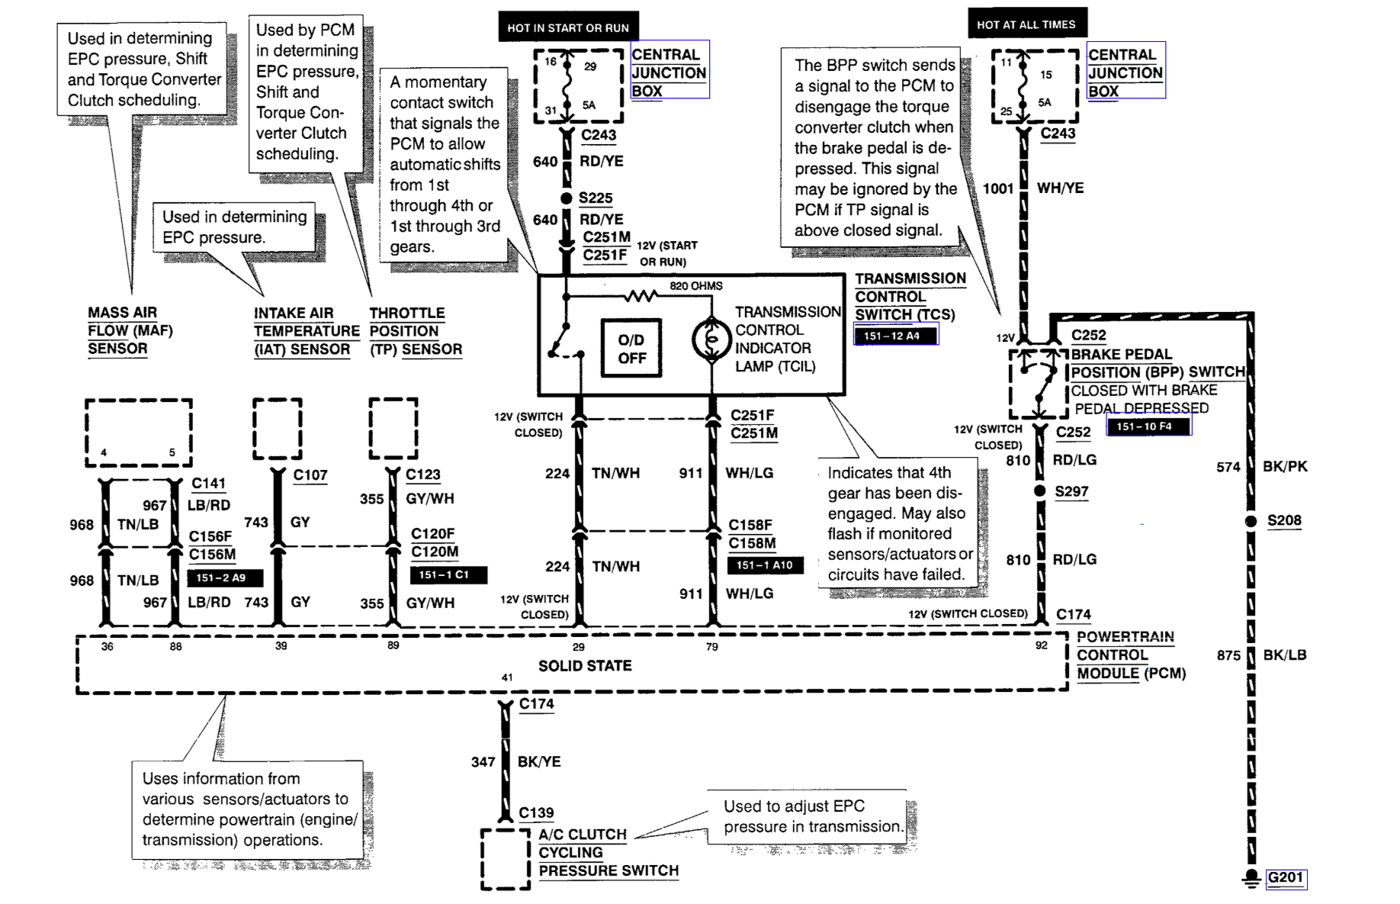
docs/1999-Ford-F150-4wd-5.42v/4R70W-Relay-Related-Modules.png
