alpauna/TritonECU/docs/1999-Ford-F150-4wd-5.42v/4R70W-Solenoid-Temp-Connector.png

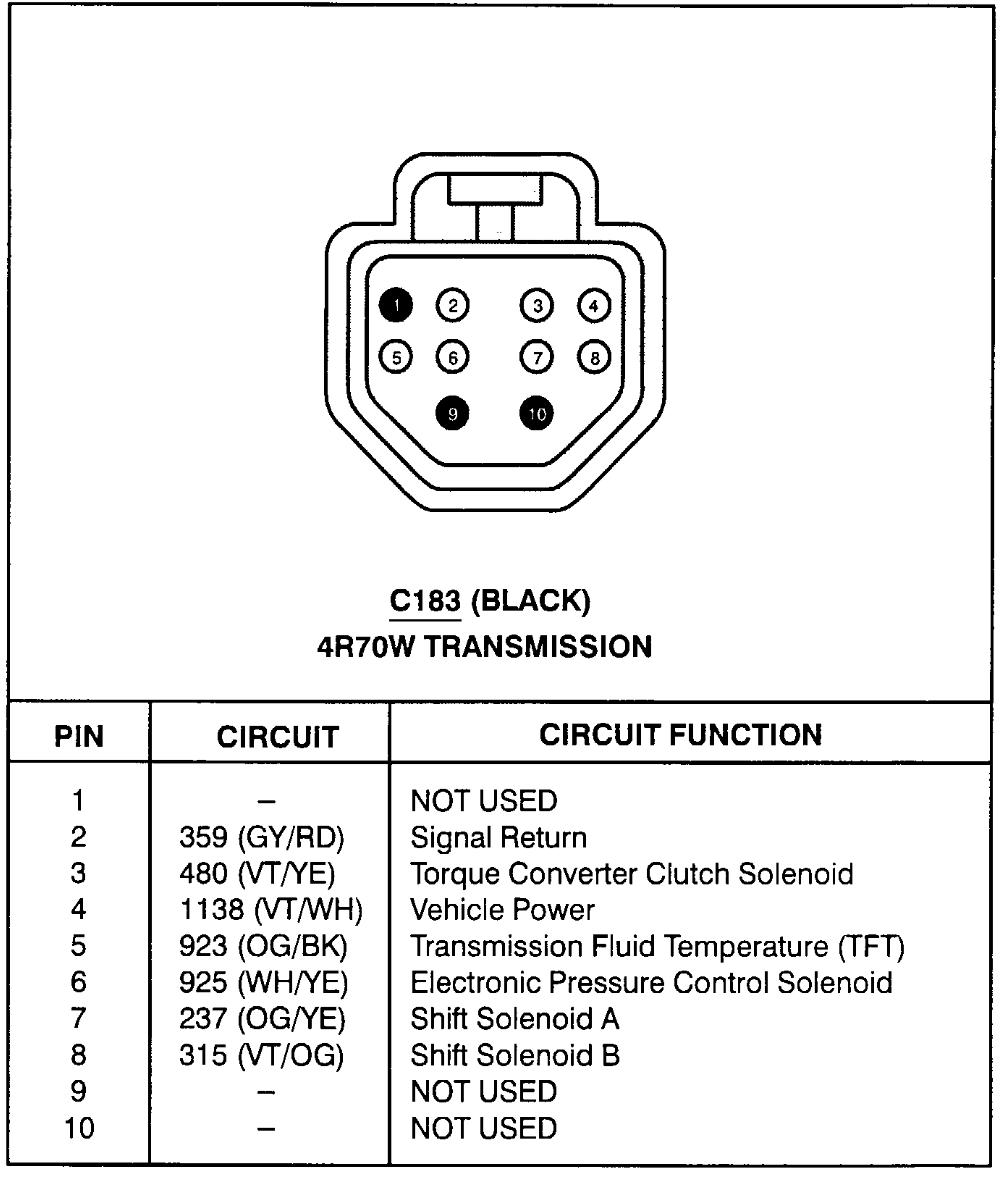
docs/1999-Ford-F150-4wd-5.42v/4R70W-Solenoid-Temp-Connector.png
