alpauna/TritonECU/docs/1999-Ford-F150-4wd-5.42v/4R70W-Transmission.png

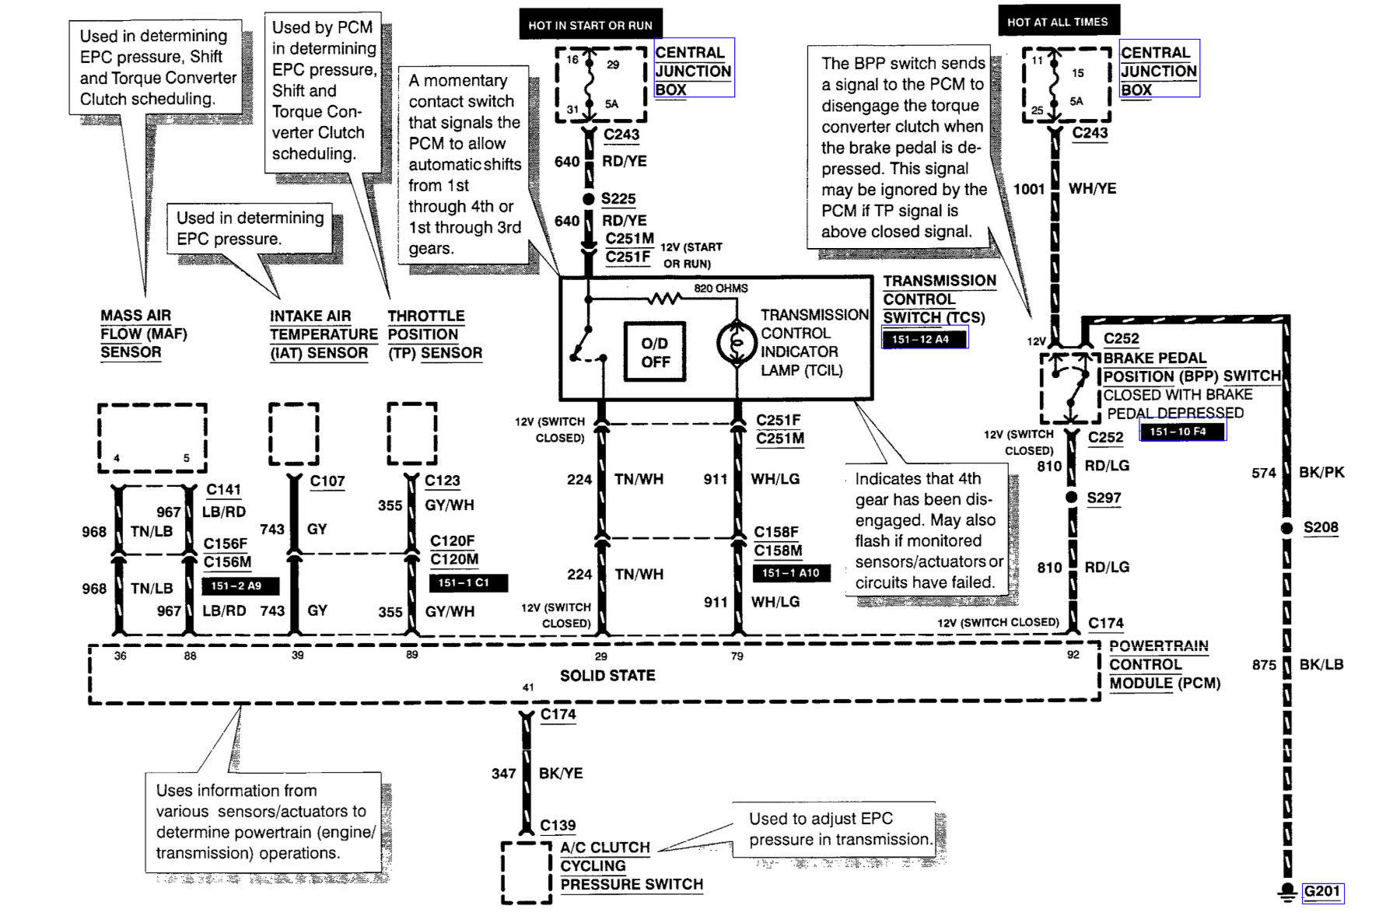
docs/1999-Ford-F150-4wd-5.42v/4R70W-Transmission.png
