alpauna/TritonECU/docs/1999-Ford-F150-4wd-5.42v/Dash-Componet-3.png

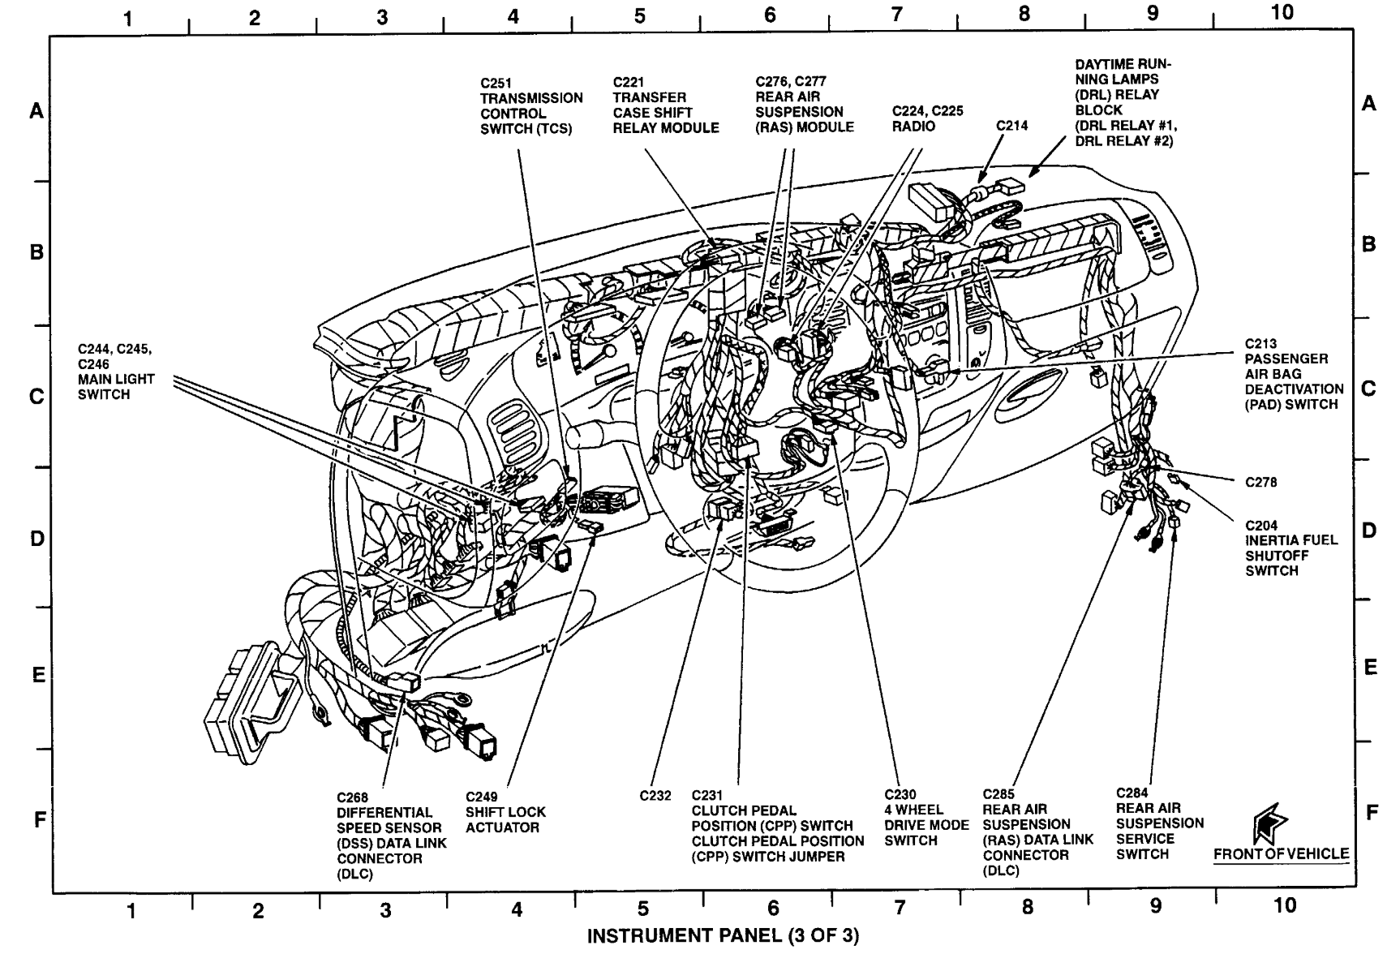
docs/1999-Ford-F150-4wd-5.42v/Dash-Componet-3.png
