alpauna/TritonECU/docs/1999-Ford-F150-4wd-5.42v/EEC-V-Power-Pins.png

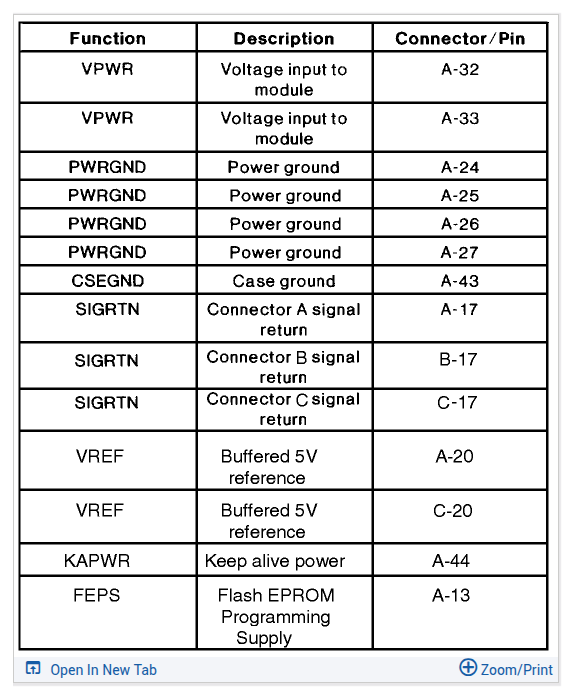
docs/1999-Ford-F150-4wd-5.42v/EEC-V-Power-Pins.png
