alpauna/TritonECU/docs/1999-Ford-F150-4wd-5.42v/EngineControls8.png

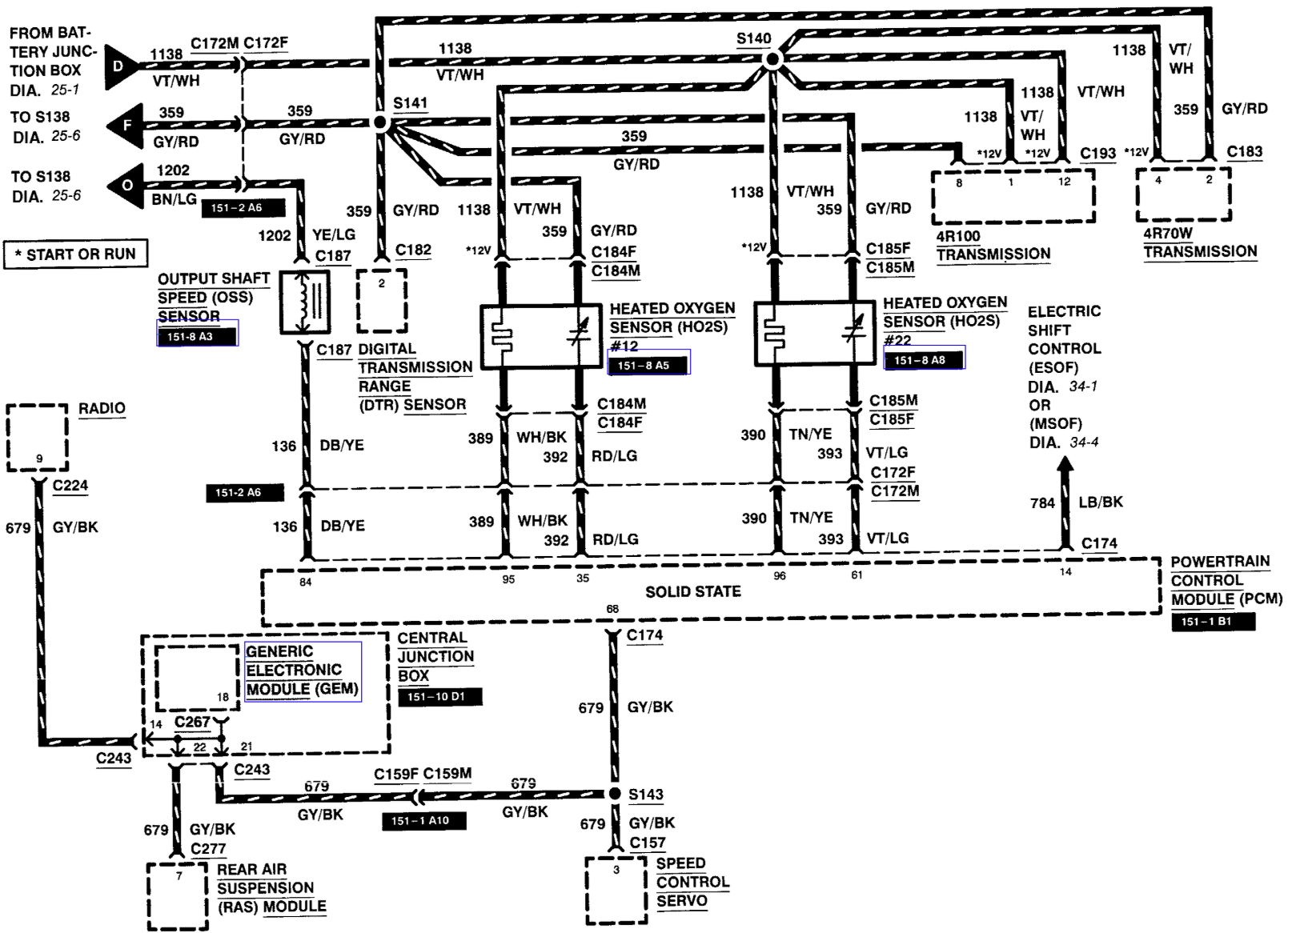
docs/1999-Ford-F150-4wd-5.42v/EngineControls8.png
