alpauna/TritonECU/docs/1999-Ford-F150-4wd-5.42v/Pin79-Question.png

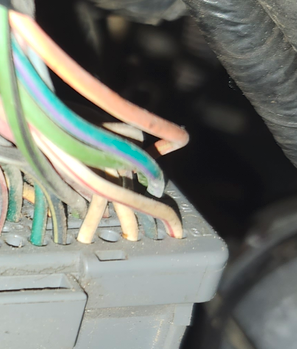
docs/1999-Ford-F150-4wd-5.42v/Pin79-Question.png
