alpauna/TritonECU/docs/1999-Ford-F150-4wd-5.42v/RegisteredOn36-1wheel.png

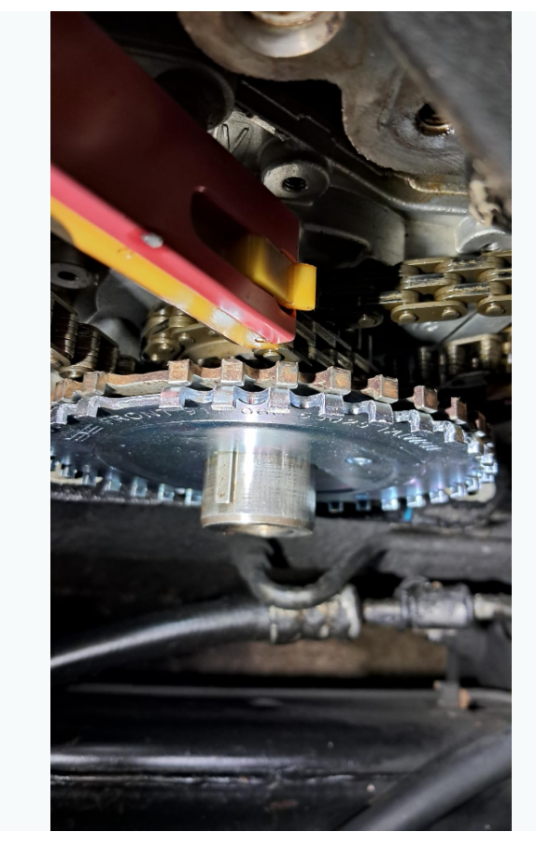
docs/1999-Ford-F150-4wd-5.42v/RegisteredOn36-1wheel.png
