alpauna/TritonECU/docs/1999-Ford-F150-4wd-5.42v/Transmission-Componet-Locations-1.png

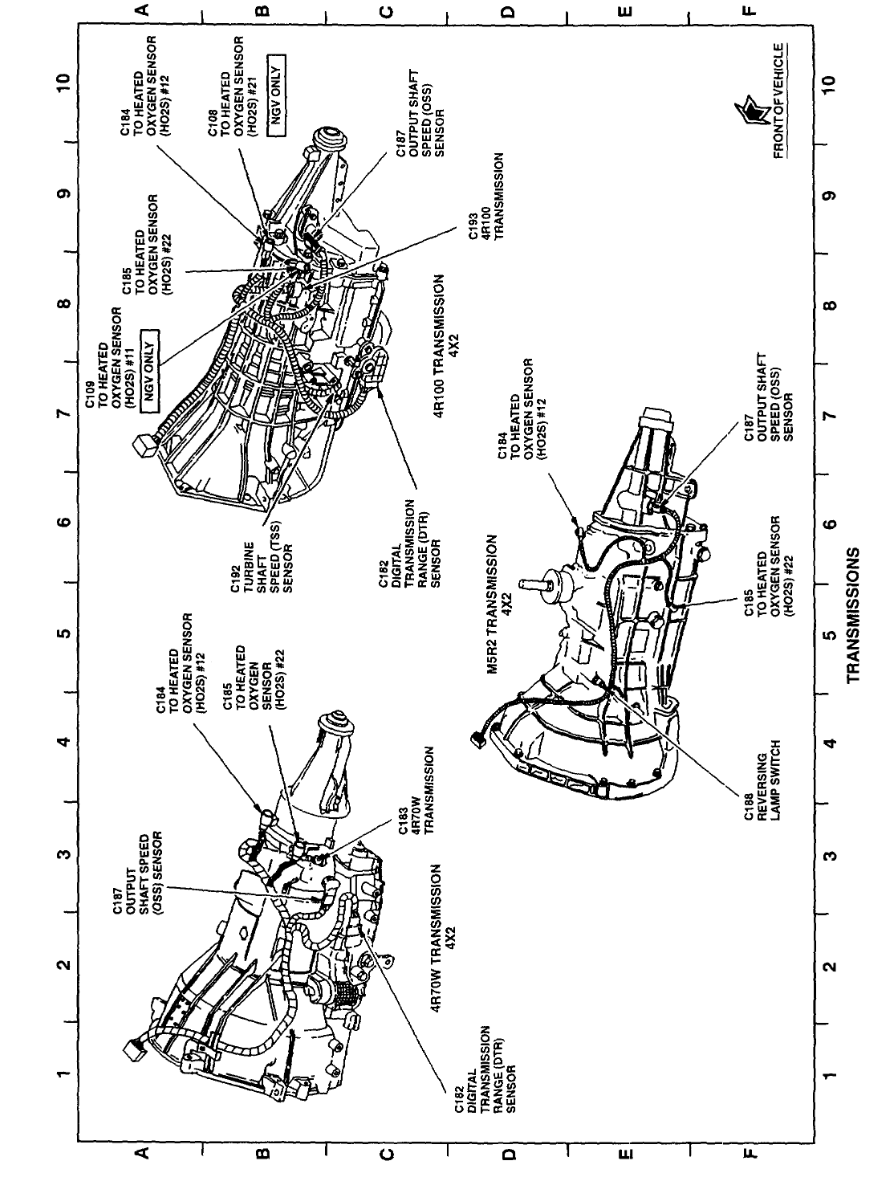
docs/1999-Ford-F150-4wd-5.42v/Transmission-Componet-Locations-1.png
