alpauna/TritonECU/docs/Schematics/POWER_2026-09-08.png

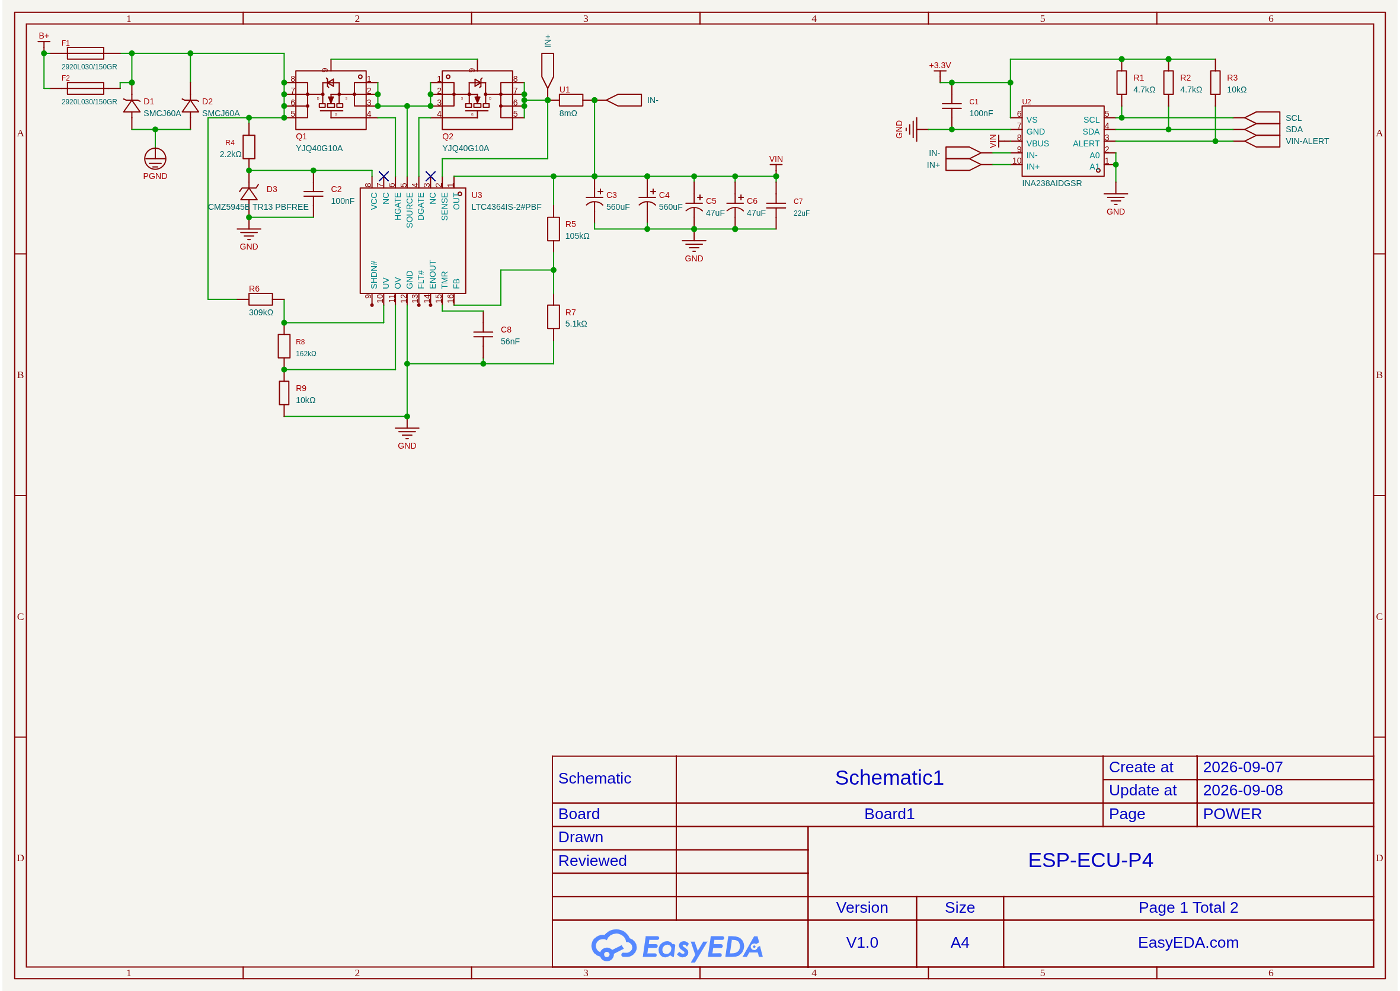
docs/Schematics/POWER_2026-09-08.png
