alpauna/TritonECU/docs/Schematics/pv2/SCH_Power_1-POWER1_2026-09-18.png

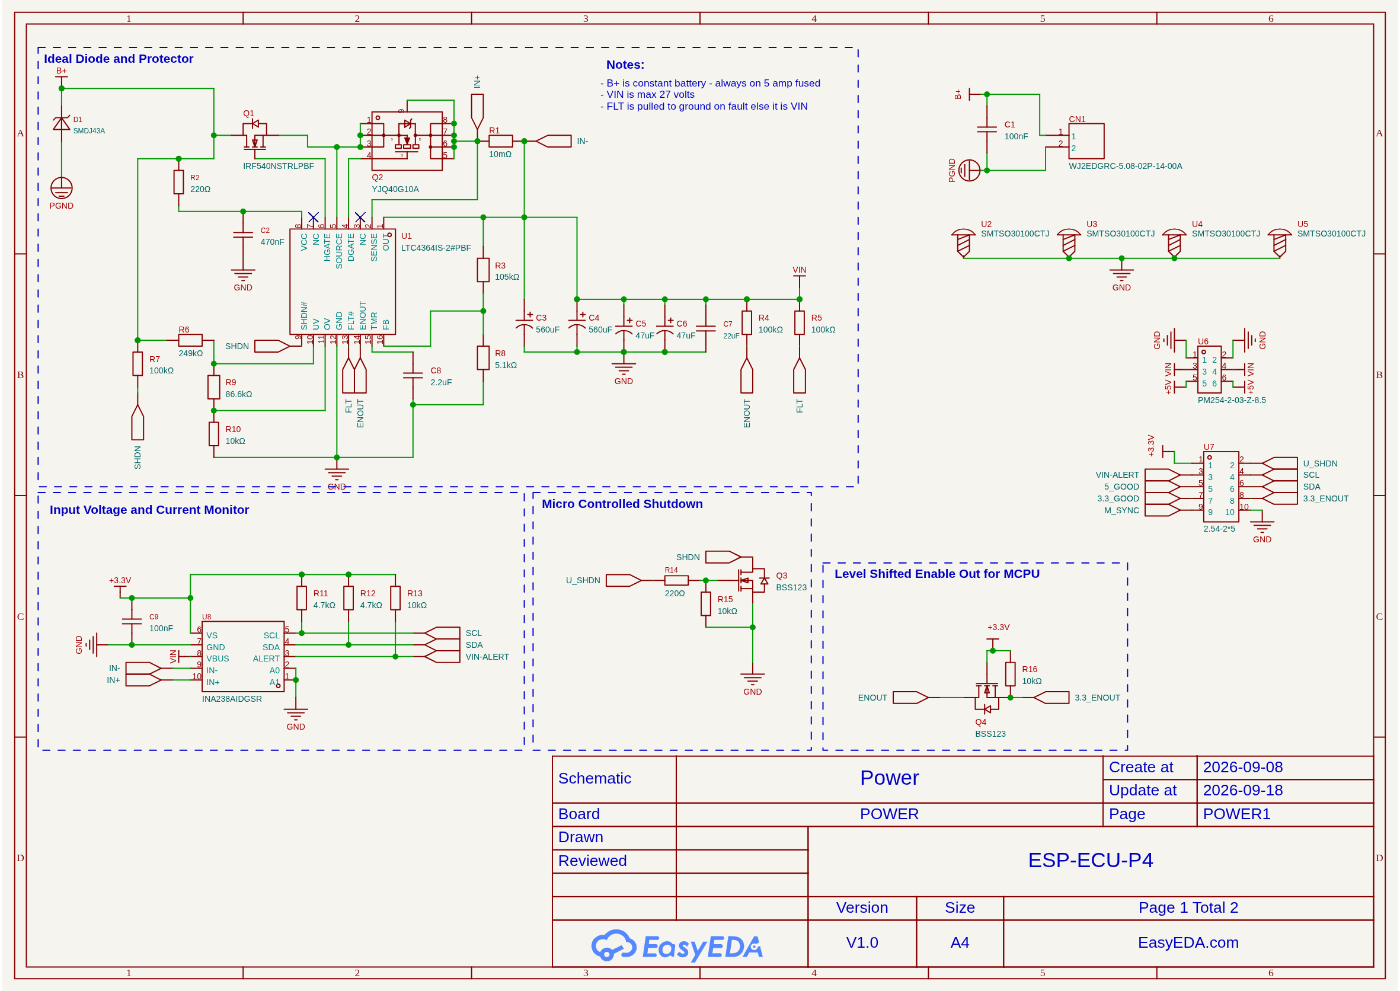
docs/Schematics/pv2/SCH_Power_1-POWER1_2026-09-18.png
