alpauna/TritonECU/docs/Schematics/pv2/SCH_Power_2-POWER2_2026-09-18.png

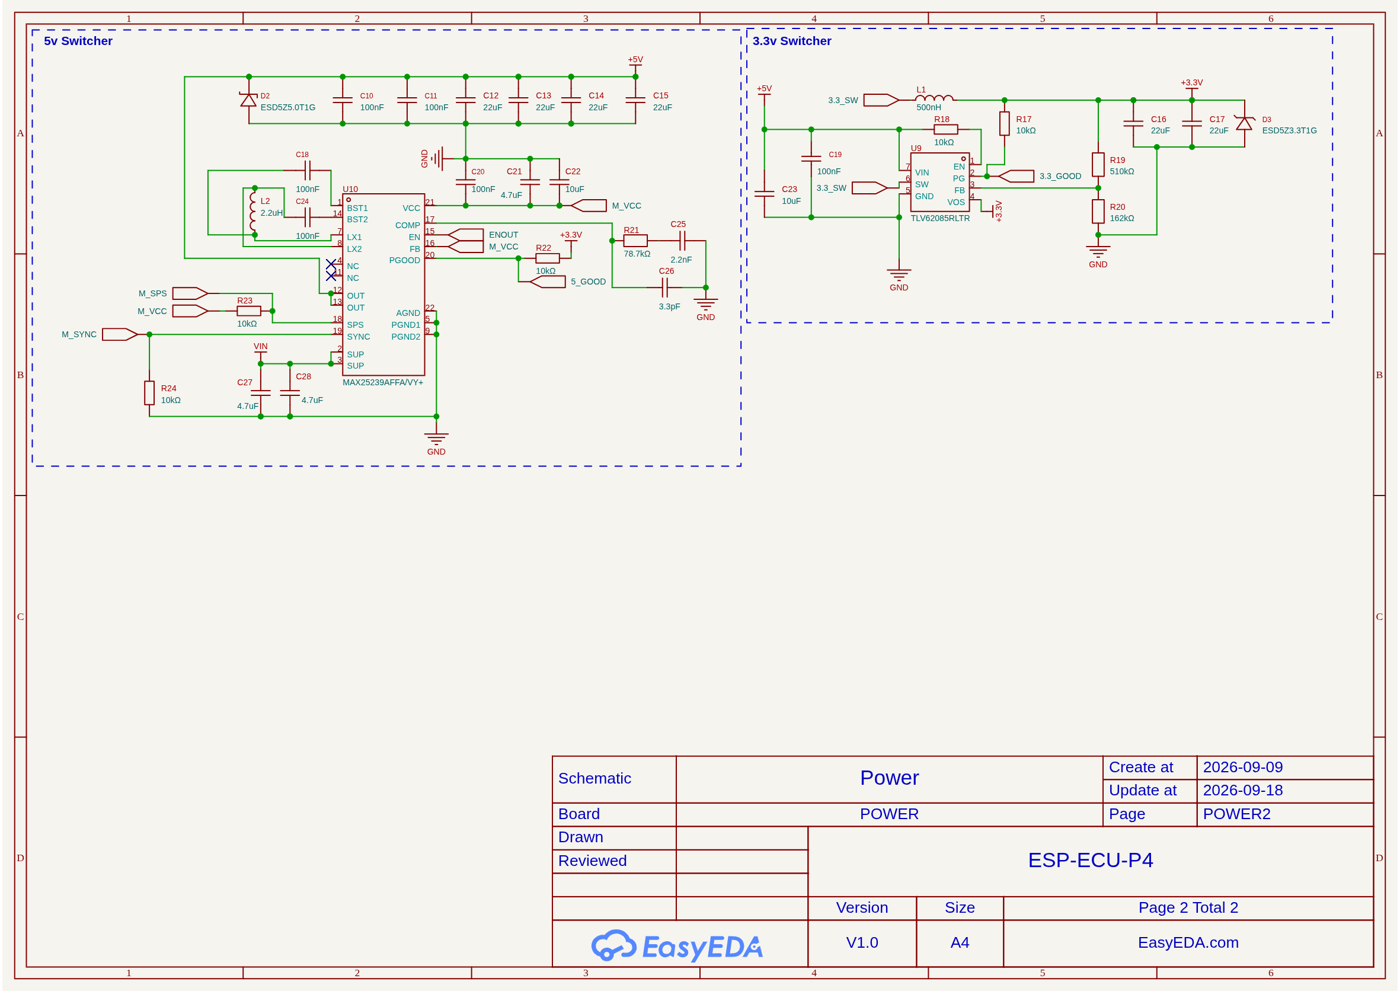
docs/Schematics/pv2/SCH_Power_2-POWER2_2026-09-18.png
