alpauna/TritonECU/docs/Schematics/TritonECU_VR_Schematic_V_1.png

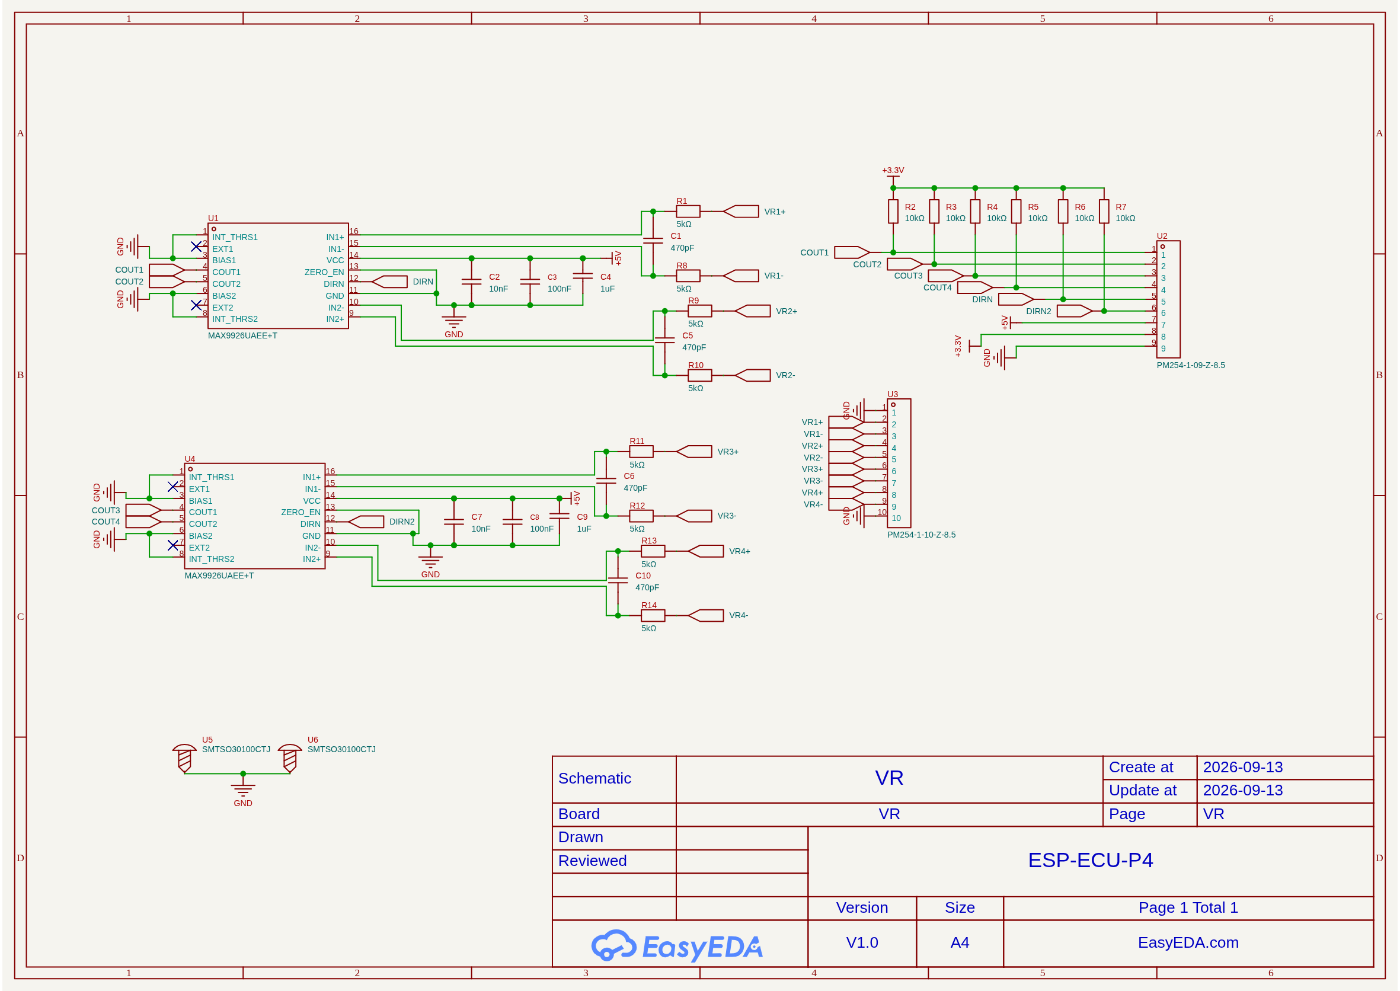
docs/Schematics/TritonECU_VR_Schematic_V_1.png
