alpauna/TritonECU/hardware/2N7002 Driver/2N2004 Driver Schematic.png

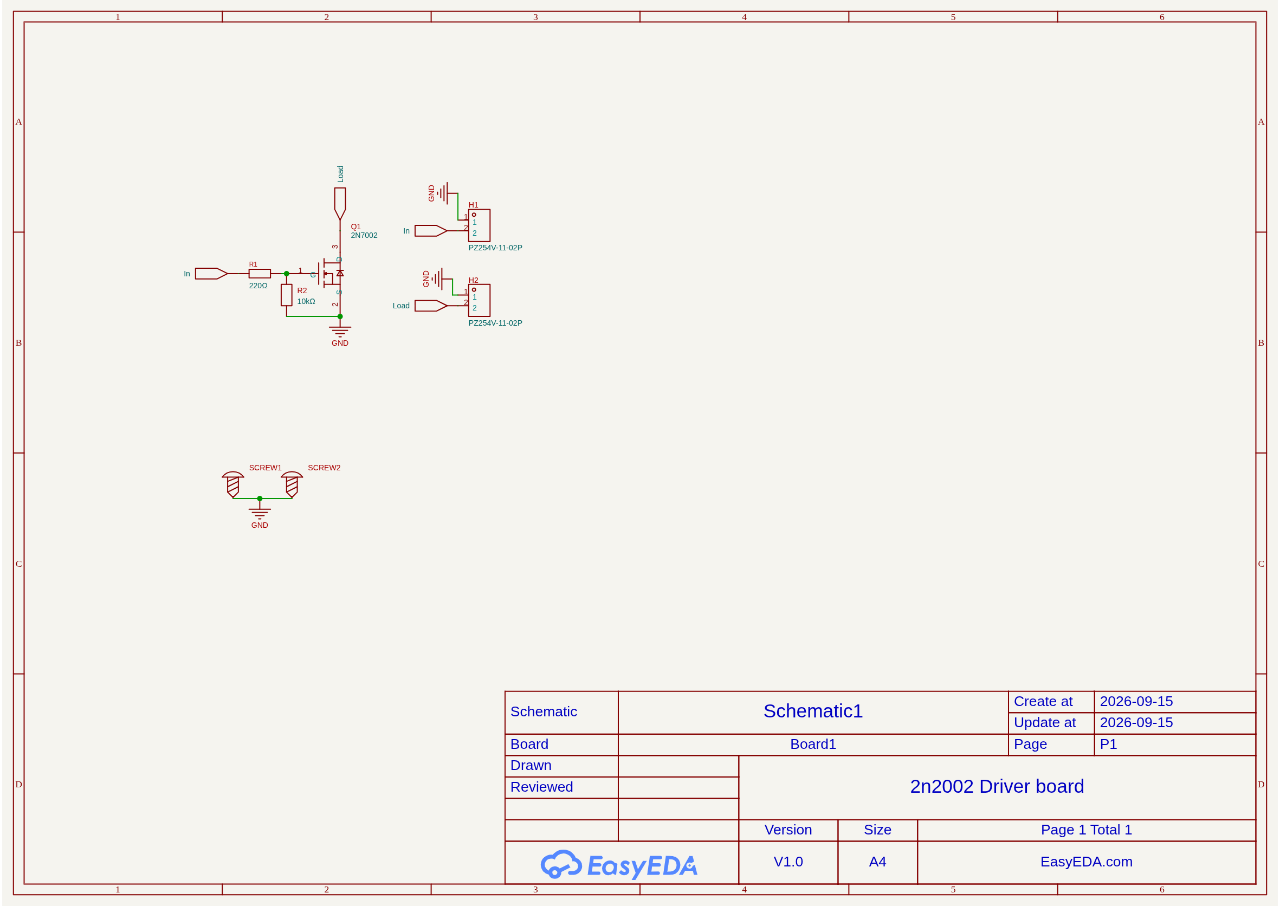
hardware/2N7002 Driver/2N2004 Driver Schematic.png
