alpauna/TritonECU/hardware/2N7002 Driver/36-1Wheel.webp

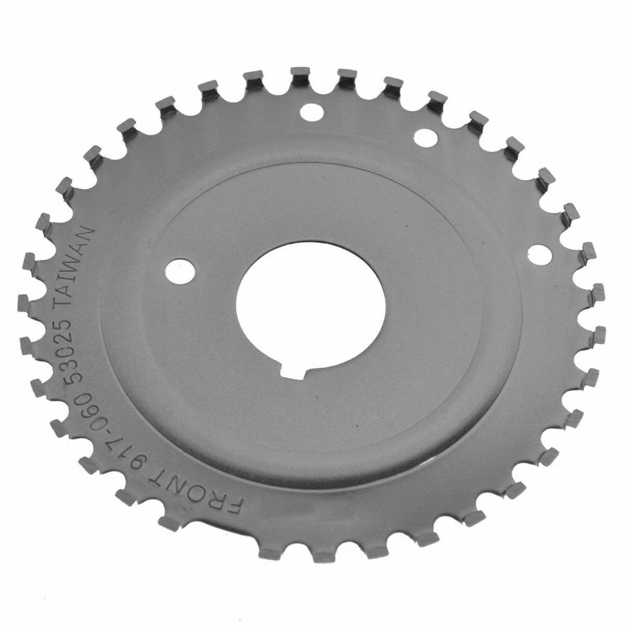
hardware/2N7002 Driver/36-1Wheel.webp
