alpauna/TritonECU/hardware/2N7002 Driver/s-l1600.webp

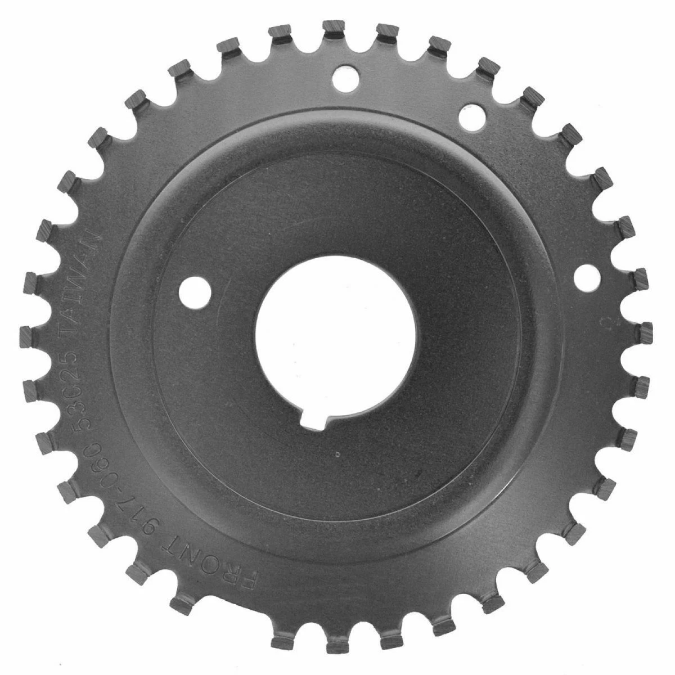
hardware/2N7002 Driver/s-l1600.webp
