alpauna/TritonECU/hardware/fan-controller/Schematic/FanTempController-Schematic-V2.png

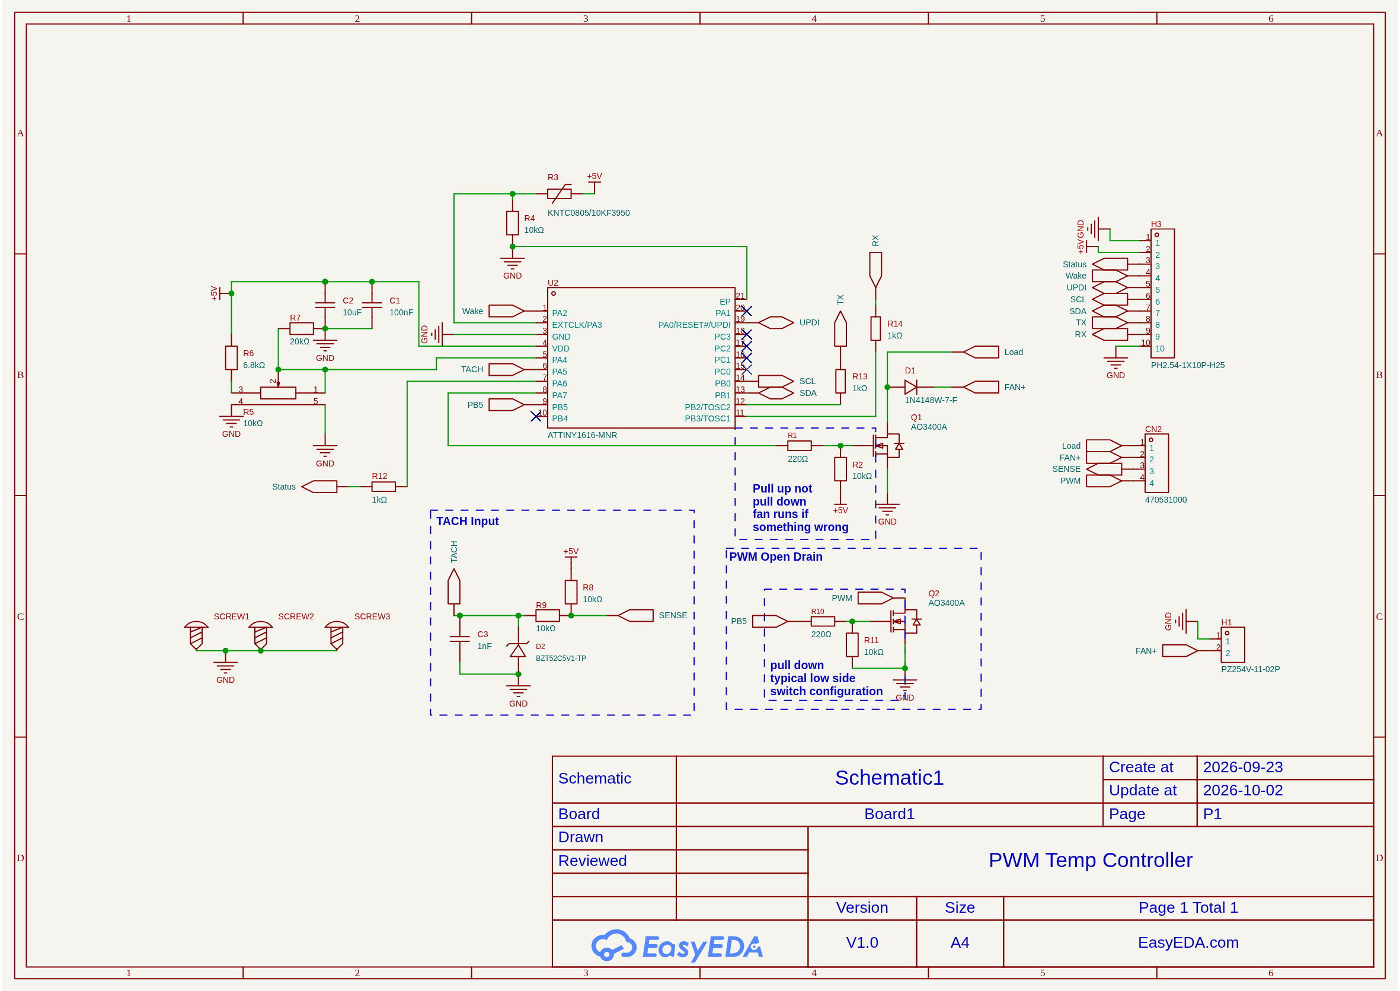
hardware/fan-controller/Schematic/FanTempController-Schematic-V2.png
