alpauna/TritonECU/hardware/fan-controller/Schematic/FanTempController-Schematic.png

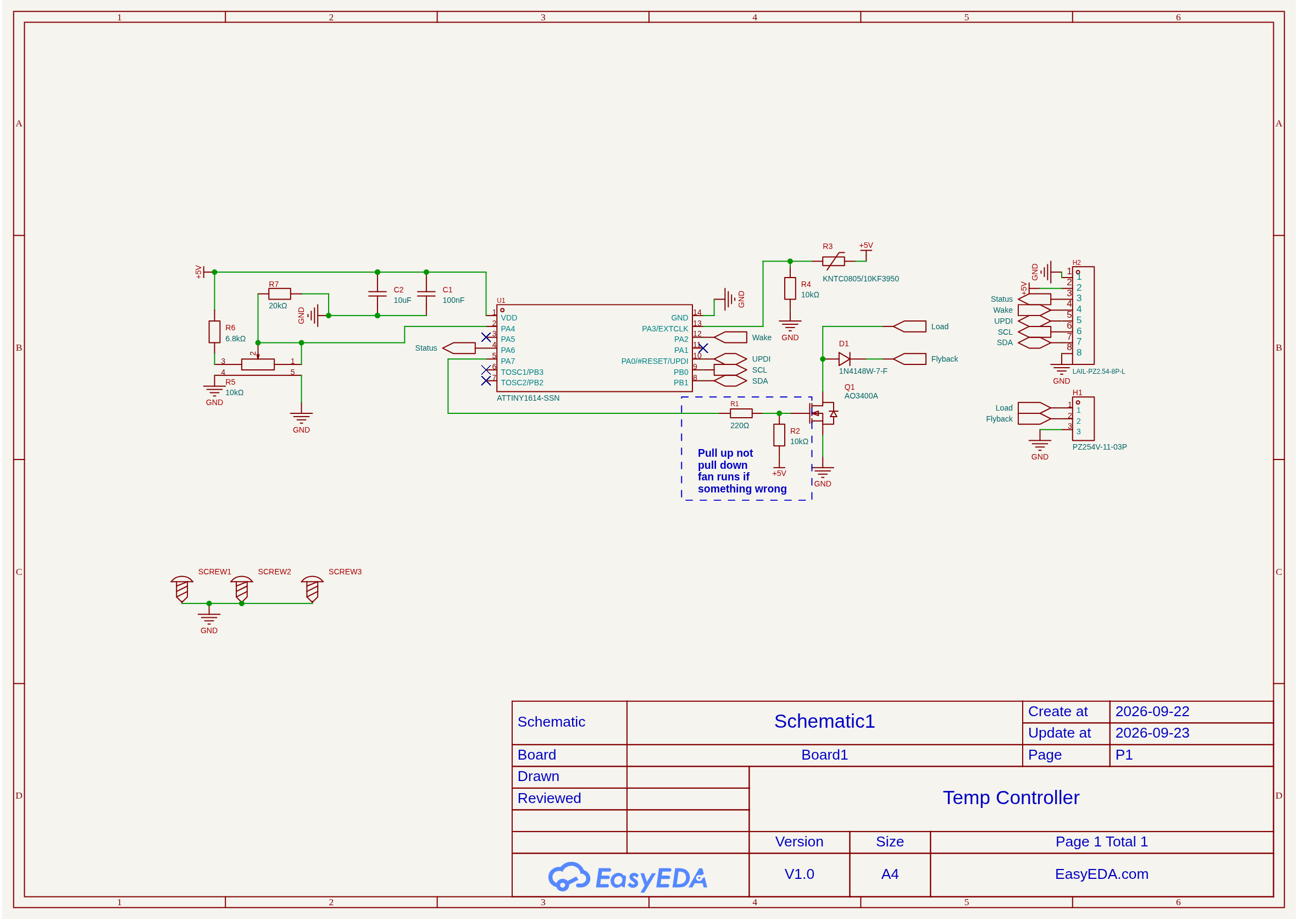
hardware/fan-controller/Schematic/FanTempController-Schematic.png
