alpauna/TritonECU/hardware/scp-rig/schematics/extracted/SCH_Schematic1_1-P1_2026-09-25.png

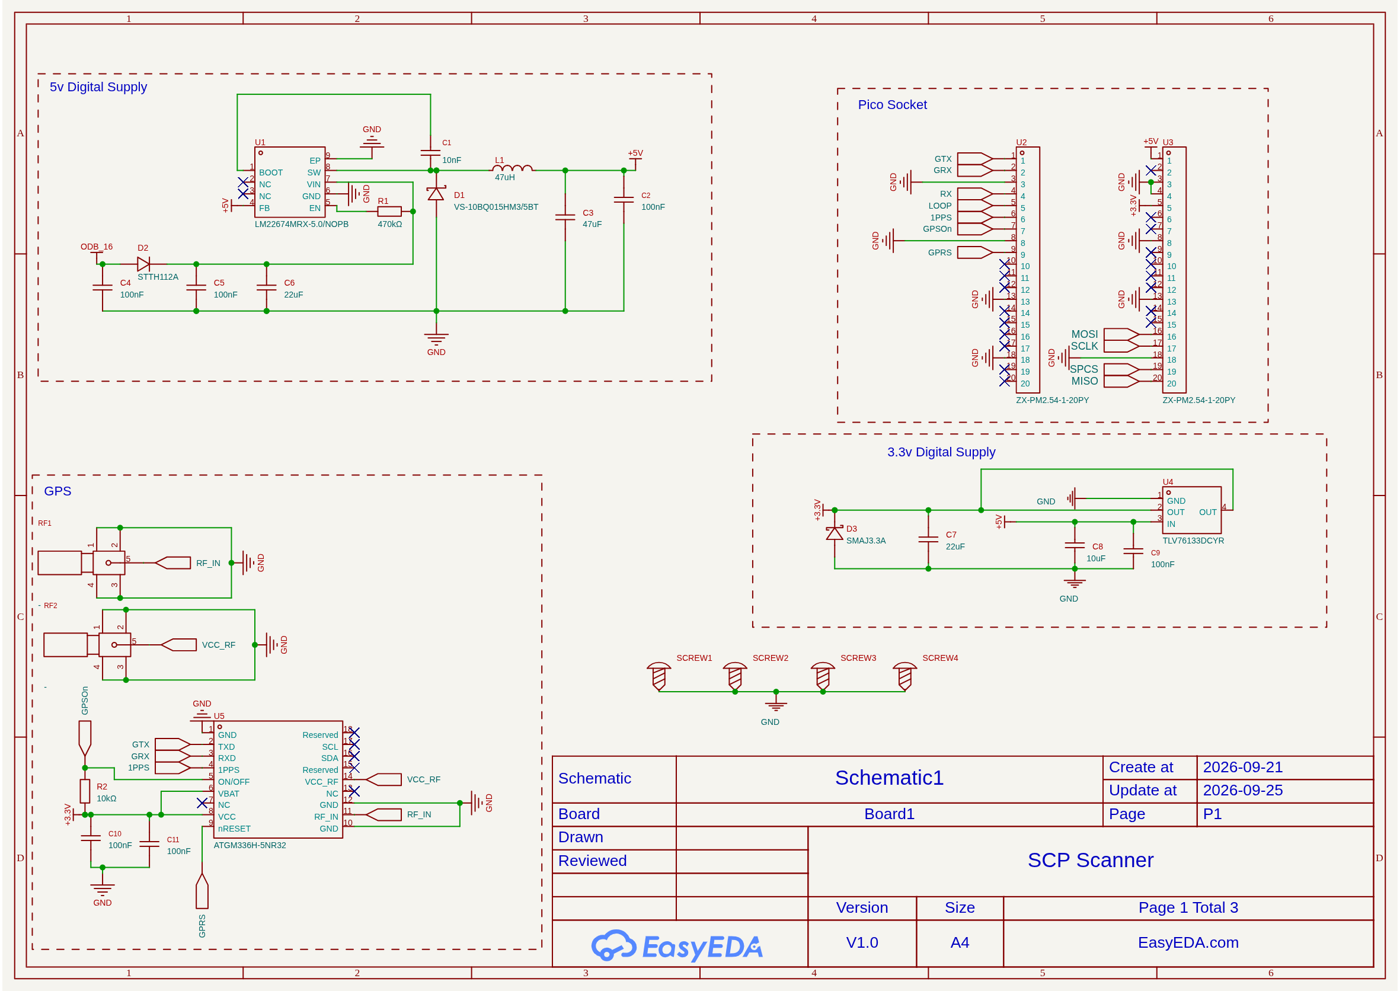
hardware/scp-rig/schematics/extracted/SCH_Schematic1_1-P1_2026-09-25.png
