alpauna/TritonECU/hardware/scp-rig/schematics/extracted/SCH_Schematic1_2-P2_2026-09-25.png

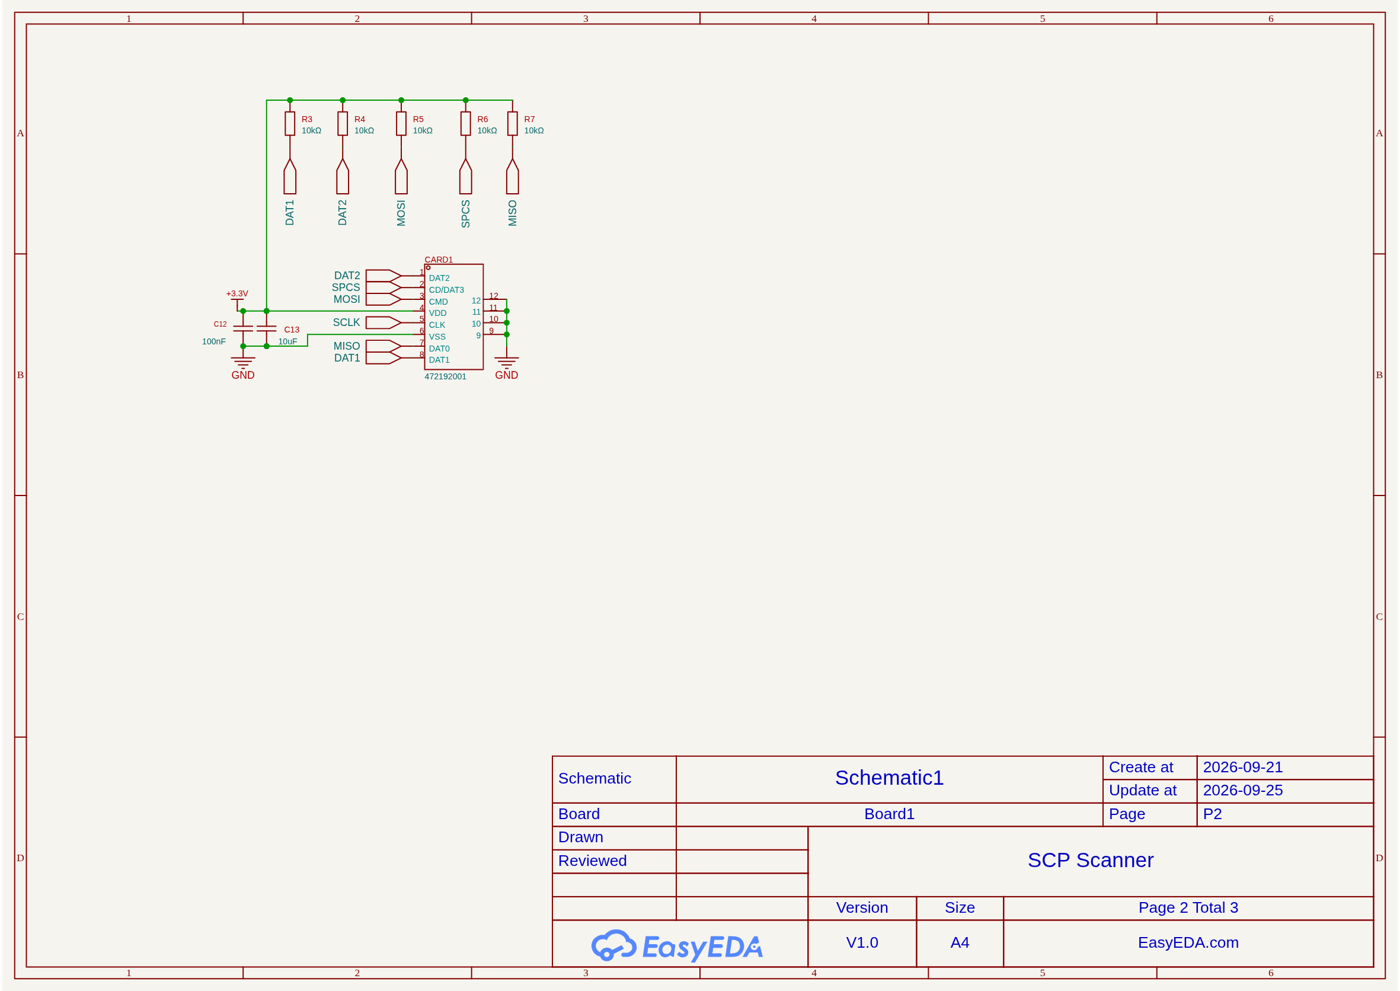
hardware/scp-rig/schematics/extracted/SCH_Schematic1_2-P2_2026-09-25.png
