alpauna/TritonECU/hardware/scp-rig/schematics/v1/SCH_Schematic1_3-P3_2026-09-25.png

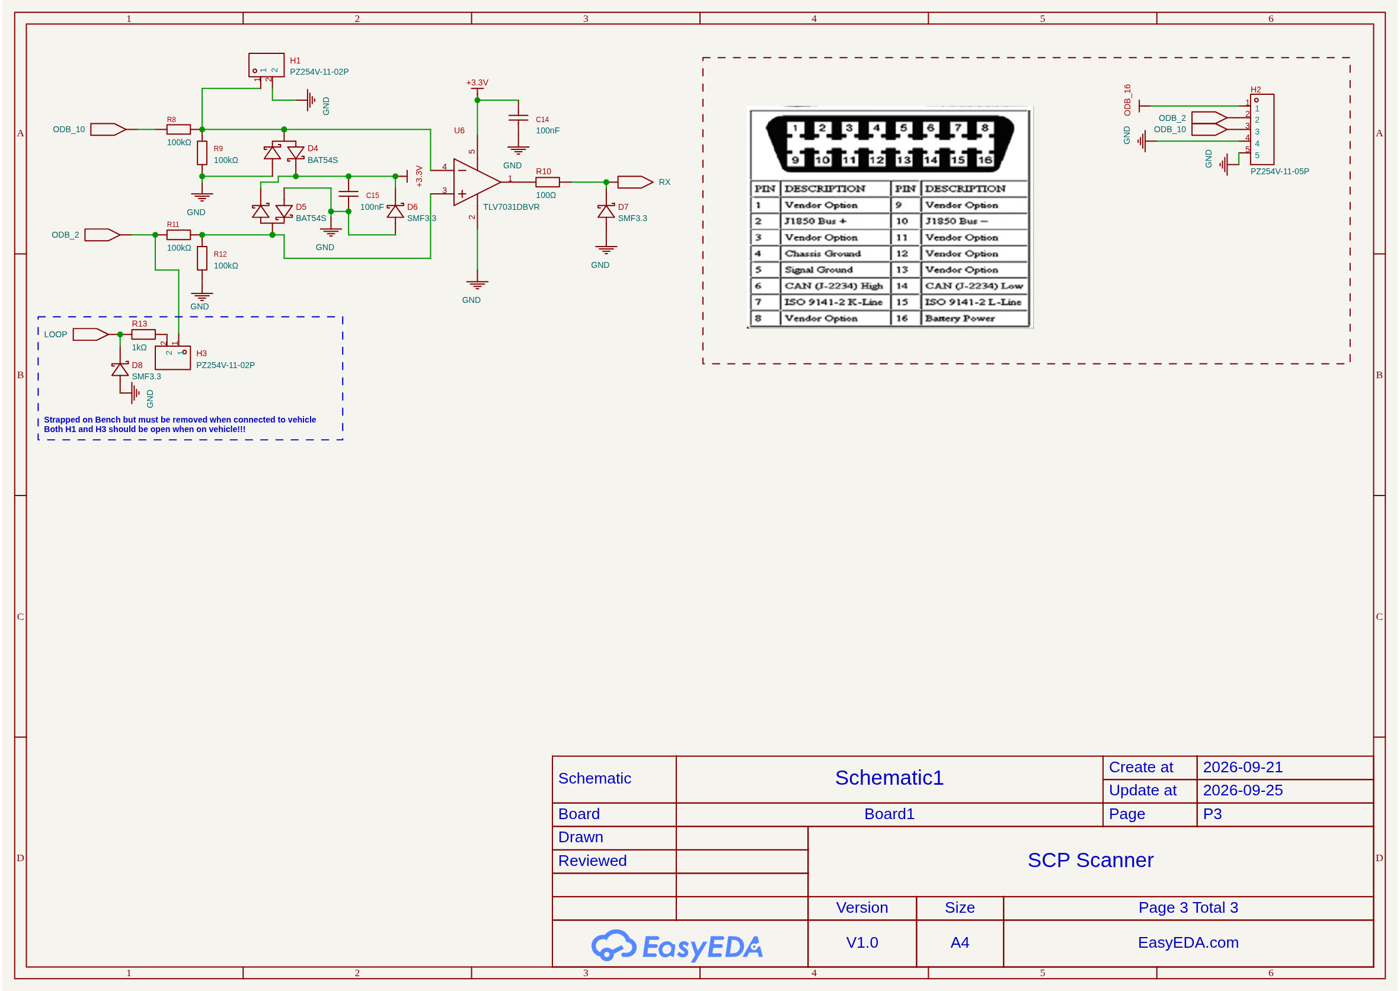
hardware/scp-rig/schematics/v1/SCH_Schematic1_3-P3_2026-09-25.png
