alpauna/TritonECU/hardware/fan-controller/Schematic/FanTempController-BOM-V2.csv

Quantity | Comment | Designator | Footprint | Value | Manufacturer Part | Manufacturer | Supplier Part | Supplier | No.
1 | 100nF | C1 | C0805 | 100nF | CC0805KRX7R9BB104 | YAGEO(国巨) | C49678 | LCSC | 1
1 | 10uF | C2 | C0805 | 10uF | CL21B106KOQNNNE | SAMSUNG(三星) | C95841 | LCSC | 2
1 | 1nF | C3 | C0402 | 1nF | GRM1555C1H102JA01D | muRata(村田) | C76947 | LCSC | 3
1 | 470531000 | CN2 | CONN-TH_47053-1000 |  | 470531000 | MOLEX | C240840 | LCSC | 4
1 | 1N4148W-7-F | D1 | SOD-123_L2.7-W1.6-LS3.7-RD-1 |  | 1N4148W-7-F | DIODES(美台) | C83528 | LCSC | 5
1 | BZT52C5V1-TP | D2 | SOD-123_L2.8-W1.6-LS3.7-RD_1 |  | BZT52C5V1-TP | MCC(美微科) | C78728 | LCSC | 6
1 | PZ254V-11-02P | H1 | HDR-TH_2P-P2.54-V-M |  | PZ254V-11-02P | XFCN(兴飞) | C492401 | LCSC | 7
1 | PH2.54-1X10P-H25 | H3 | HDR-TH_10P-P2.54-V-M |  | PH2.54-1X10P-H25 | JXTCONN(聚兴泰) | C42431810 | LCSC | 8
2 | AO3400A | Q1,Q2 | SOT-23-3_L2.9-W1.3-P1.90-LS2.4-BR |  | AO3400A | AOS | C20917 | LCSC | 9
2 | 220Ω | R1,R10 | R0805 | 220Ω | 0805W8F2200T5E | UNI-ROYAL(厚声) | C17557 | LCSC | 10
5 | 10kΩ | R2,R4,R8,R9,R11 | R0805 | 10kΩ | FRC0805F1002TS | FOJAN(富捷) | C2907219 | LCSC | 11
1 | KNTC0805/10KF3950 | R3 | R0805 |  | KNTC0805/10KF3950 | KUU | C2892549 | LCSC | 12
1 | 10kΩ | R5 | RES-TH_RK09K113004U | 10kΩ | RK09K11300DR | ALPSALPINE(阿尔卑斯阿尔派) | C3020615 | LCSC | 13
1 | 6.8kΩ | R6 | R0805 | 6.8kΩ | FRC0805F6801TS | FOJAN(富捷) | C2907276 | LCSC | 14
1 | 20kΩ | R7 | R0805 | 20kΩ | FRC0805F2002TS | FOJAN(富捷) | C2907240 | LCSC | 15
3 | 1kΩ | R12,R13,R14 | R0805 | 1kΩ | RC0805FR-071KL | YAGEO(国巨) | C95781 | LCSC | 16
3 | Screw-Hole-M2 | SCREW1,SCREW2,SCREW3 | Screw-Hole-M2 |  |  |  |  |  | 17
1 | ATTINY1616-MNR | U2 | QFN-20_L3.0-W3.0-P0.40-BL-EP1.7 |  | ATTINY1616-MNR | MICROCHIP(美国微芯) | C507118 | LCSC | 18
