alpauna/TritonECU/docs/Schematics/KiCad/TritonECU-MCU/TritonECU-MCU-Mouser.csv

Reference | Qty | Value | DNP | Exclude from BOM | Exclude from Board | Exclude from Simulation | Exclude from Position Files | Footprint | Datasheet | Manufacturer_Name | Manufacturer_Part_Number | Mouser Part Number | Mouser Price/Stock | MPN | Manufacturer | Note | Digikey Part Number | Digikey Price/Stock
C1,C2,C3,C4,C5,C6,C7,C8,C9,C10,C11,C12,C16,C19,C20 | 15 | 100n |  |  |  |  | ${EXCLUDE_FROM_POS_FILES} | Capacitor_SMD:C_0402_1005Metric_Pad0.74x0.62mm_HandSolder | https://www.mouser.com/datasheet/3/76/4/GCM155L8EH104KE07_01A.pdf | Murata Electronics | GCM155L8EH104KE07D | 81-GCM155L8EH104KE7D | https://www.mouser.com/en/ProductDetail/Murata-Electronics/GCM155L8EH104KE07D
C13 | 1 | 4.7u |  |  |  |  | ${EXCLUDE_FROM_POS_FILES} | Capacitor_SMD:C_0603_1608Metric_Pad1.08x0.95mm_HandSolder | https://www.mouser.com/datasheet/3/76/2/GRM188C71A475ME11_01A.pdf | Murata Electronics | GRM188C71A475ME11D | 81-GRM188C71A475ME1D | https://www.mouser.com/en/ProductDetail/Murata-Electronics/GRM188C71A475ME11D
C14 | 1 | 10u |  |  |  |  | ${EXCLUDE_FROM_POS_FILES} | Capacitor_SMD:C_0805_2012Metric_Pad1.18x1.45mm_HandSolder | https://www.mouser.com/catalog/specsheets/Taiyo%20Yuden_1102023_MC_mlcc_all_e.pdf | TAIYO YUDEN | MCASL21GBB7106KTNA01 | 963-MCASL21GBB7106KT | https://www.mouser.com/en/ProductDetail/TAIYO-YUDEN/MCASL21GBB7106KTNA01 |  |  | X7R, rated >= 10 V
C15 | 1 | 1u |  |  |  |  | ${EXCLUDE_FROM_POS_FILES} | Capacitor_SMD:C_0402_1005Metric_Pad0.74x0.62mm_HandSolder | https://www.mouser.com/datasheet/3/5926/1/AutoMLCCKAM.pdf | KYOCERA AVX | KAM05CR71A105KH | 581-KAM05CR71A105KH | https://www.mouser.com/en/ProductDetail/KYOCERA-AVX/KAM05CR71A105KH
C17,C18 | 2 | 2.2u |  |  |  |  | ${EXCLUDE_FROM_POS_FILES} | Capacitor_SMD:C_0603_1608Metric_Pad1.08x0.95mm_HandSolder | https://www.mouser.com/datasheet/3/5926/1/KGM_Series_e.pdf | KYOCERA AVX | KGM15BR71A225KT | 581-KGM15BR71A225KT | https://www.mouser.com/en/ProductDetail/KYOCERA-AVX/KGM15BR71A225KT |  |  | ESR < 2 ohm (DS11532)
C21,C22 | 2 | 27p |  |  |  |  | ${EXCLUDE_FROM_POS_FILES} | Capacitor_SMD:C_0402_1005Metric_Pad0.74x0.62mm_HandSolder | https://www.mouser.com/datasheet/3/72/1/KEM_C1007_X8R_ULTRA_150C_SMD.pdf | KEMET | C0402C270F4HACAUTO | 80-C0402C270F4HAUTO | https://www.mouser.com/en/ProductDetail/KEMET/C0402C270F4HACAUTO |  |  | C0G
C23,C24 | 2 | 18p |  |  |  |  | ${EXCLUDE_FROM_POS_FILES} | Capacitor_SMD:C_0402_1005Metric_Pad0.74x0.62mm_HandSolder | https://www.mouser.com/datasheet/3/508/1/UPY_AC_NP0X7RX7S_6_3V_TO_2KV.pdf | YAGEO | AC0402GRNPO9BN180 | 603-AC0402GRNPO9BN18 | https://www.mouser.com/en/ProductDetail/YAGEO/AC0402GRNPO9BN180 |  |  | C0G
FB1 | 1 | 220R@100MHz |  |  |  |  | ${EXCLUDE_FROM_POS_FILES} | Inductor_SMD:L_0603_1608Metric_Pad1.05x0.95mm_HandSolder | https://www.mouser.com/datasheet/3/203/1/BBPY_Series.pdf | Pulse Electronics | BBPY00201209221Y00 | 603-BBPY201209221Y00 | https://www.mouser.com/en/ProductDetail/Pulse-Electronics/BBPY00201209221Y00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
J5 | 1 | STDC14 SWD+VCP |  |  |  |  | ${EXCLUDE_FROM_POS_FILES} | Connector_PinHeader_1.27mm:PinHeader_2x07_P1.27mm_Vertical_SMD | https://www.mouser.com/datasheet/3/85/1/a_ftsh_smt.pdf | Samtec | FTSH-107-01-L-DV-K-A-TR | 200-FTSH10701LDVKATR | https://www.mouser.com/en/ProductDetail/Samtec/FTSH-107-01-L-DV-K-A-TR?qs=LW8h5wBZGrFFWB%2FoEC5IXw%3D%3D | FTSH-107-01-L-DV-K | Samtec | ST-Link V3 STDC14; footprint generic 2x07 1.27 SMD - check vs Samtec
R1 | 1 | 10k |  |  |  |  | ${EXCLUDE_FROM_POS_FILES} | Resistor_SMD:R_0402_1005Metric_Pad0.72x0.64mm_HandSolder | https://www.mouser.com/datasheet/3/508/1/PYU_AT_51_ROHS_L.pdf | YAGEO | AT0402FRE0710KL | 603-AT0402FRE0710KL | https://www.mouser.com/en/ProductDetail/YAGEO/AT0402FRE0710KL
Y1 | 1 | 8MHz |  |  |  |  | ${EXCLUDE_FROM_POS_FILES} | Crystal:Crystal_SMD_3225-4Pin_3.2x2.5mm_HandSoldering | https://www.mouser.com/datasheet/3/184/1/ABM8AIG.pdf | ABRACON | ABM8AIG-8.000MHZ-1Z-T | 815-M8AIG-8-1ZT | https://www.mouser.com/en/ProductDetail/ABRACON/ABM8AIG-8.000MHZ-1Z-T?qs=uwxL4vQweFM9%2FeRu4wQgCQ%3D%3D
Y2 | 1 | 32.768kHz |  |  |  |  | ${EXCLUDE_FROM_POS_FILES} | Crystal:Crystal_SMD_2012-2Pin_2.0x1.2mm_HandSoldering | https://www.ecsxtal.com/store/pdf/ECX-12Q.pdf | ECS | ECS-.327-12.5-12QS-TR | 520-.327-12.5-12QST | https://www.mouser.com/en/ProductDetail/ECS/ECS-.327-12.5-12QS-TR?qs=Mv7BduZupUhlMCNRrl40kw%3D%3D
