alpauna/TritonECU/docs/Schematics/KiCad/TritonECU/TritonECU.csv

Reference | Qty | Value | DNP | Exclude from BOM | Exclude from Board | Exclude from Simulation | Exclude from Position Files | Footprint | Datasheet | Manufacturer_Name | Manufacturer_Part_Number | Mouser Part Number | Mouser Price/Stock
C1,C2,C3 | 3 | 680uF |  |  |  |  | ${EXCLUDE_FROM_POS_FILES} | Samacsys:EEHZU1E102UV | https://industrial.panasonic.com/cdbs/www-data/pdf/RDD0000/ast-ind-280898.pdf | Panasonic | EEH-ZU1V681UV | 667-EEH-ZU1V681UV | https://www.mouser.co.uk/ProductDetail/Panasonic/EEH-ZU1V681UV?qs=HoCaDK9Nz5duEjH7y2oWyg%3D%3D
C4 | 1 | 100nF |  |  |  |  | ${EXCLUDE_FROM_POS_FILES} | Capacitor_SMD:C_1808_4520Metric_Pad1.72x2.30mm_HandSolder |  | Vishay / Vitramon | VJ1808Y104KXCAT | 77-VJ1808Y104KXCAT | https://www.mouser.com/en/ProductDetail/Vishay-Vitramon/VJ1808Y104KXCAT
C5,C6 | 2 | 22uF |  |  |  |  | ${EXCLUDE_FROM_POS_FILES} | Capacitor_SMD:C_1210_3225Metric_Pad1.33x2.70mm_HandSolder |  | Samsung Electro-Mechanics | CL32B226KLV6PNE | 187-CL32B226KLV6PNE | https://www.mouser.com/en/ProductDetail/Samsung-Electro-Mechanics/CL32B226KLV6PNE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
C7 | 1 | 2.2uF |  |  |  |  | ${EXCLUDE_FROM_POS_FILES} | Capacitor_SMD:C_0603_1608Metric_Pad1.08x0.95mm_HandSolder | https://pim.murata.com/asset/pim4/ceramicCapacitorSMD/GRM188Z71C225KE43-01A-EN_PDF_CERAMICCAPACITORSMD | Murata Electronics | GRM188Z71C225KE43D | 81-GRM188Z71C225KE3D | https://www.mouser.com/en/ProductDetail/Murata-Electronics/GRM188Z71C225KE43D
C8 | 1 | 100nF |  |  |  |  | ${EXCLUDE_FROM_POS_FILES} | Capacitor_SMD:C_0402_1005Metric_Pad0.74x0.62mm_HandSolder | https://www.mouser.com/catalog/specsheets/Taiyo%20Yuden_04-28-2025_MMR01_e.pdf | TAIYO YUDEN | MMASL105SB7104MFNA18 | 963-MASL105SB7104MF | https://www.mouser.com/en/ProductDetail/TAIYO-YUDEN/MMASL105SB7104MFNA18
C9,C10,C14,C18,C19,C25 | 6 | 100nF |  |  |  |  | ${EXCLUDE_FROM_POS_FILES} | Capacitor_SMD:C_0402_1005Metric_Pad0.74x0.62mm_HandSolder |  | TDK | CGA2B3X7R1H104K050BD | 810-CGA2B3X7R1H104BD | https://www.mouser.com/en/ProductDetail/TDK/CGA2B3X7R1H104K050BD
C11,C12 | 2 | 4.7uF |  |  |  |  | ${EXCLUDE_FROM_POS_FILES} | Capacitor_SMD:C_0805_2012Metric_Pad1.18x1.45mm_HandSolder | https://www.mouser.com/datasheet/3/76/4/GRM21BZ7YA475KE15_01A.pdf | Murata Electronics | GRM21BZ7YA475KE15K | 81-GRM21BZ7YA475KE5K | https://www.mouser.com/en/ProductDetail/Murata-Electronics/GRM21BZ7YA475KE15K
C13 | 1 | 4.7uF |  |  |  |  | ${EXCLUDE_FROM_POS_FILES} | Capacitor_SMD:C_0603_1608Metric_Pad1.08x0.95mm_HandSolder | https://www.mouser.com/datasheet/3/76/4/GRM21BZ7YA475KE15_01A.pdf | Murata Electronics | GRM188Z71A475ME15J | 81-GRM188Z71A475ME5J | https://www.mouser.com/en/ProductDetail/Murata-Electronics/GRM188Z71A475ME15J
C15,C24 | 2 | 10uF |  |  |  |  | ${EXCLUDE_FROM_POS_FILES} | Capacitor_SMD:C_0805_2012Metric_Pad1.18x1.45mm_HandSolder | https://www.mouser.com/datasheet/3/76/4/GRM21BZ7YA475KE15_01A.pdf | KYOCERA AVX | 0805YC106MAT2A | 581-0805YC106MAT2A | https://www.mouser.com/en/ProductDetail/KYOCERA-AVX/0805YC106MAT2A?qs=%252BdQmOuGyFcH53ptYvPBwhQ%3D%3D
C16 | 1 | 2.2nF |  |  |  |  | ${EXCLUDE_FROM_POS_FILES} | Capacitor_SMD:C_0402_1005Metric_Pad0.74x0.62mm_HandSolder | https://pim.murata.com/asset/pim4/ceramicCapacitorSMD/GRM1555C1H222JA01-01A-EN_PDF_CERAMICCAPACITORSMD | Murata Electronics | GRM1555C1H222JA01D | 81-GRM1555C1H222J01D | https://www.mouser.com/en/ProductDetail/Murata-Electronics/GRM1555C1H222JA01D
C17 | 1 | 3.3pF |  |  |  |  | ${EXCLUDE_FROM_POS_FILES} | Capacitor_SMD:C_0402_1005Metric_Pad0.74x0.62mm_HandSolder | https://pim.murata.com/asset/pim4/ceramicCapacitorSMD/GCM1555C2A3R3BE02-01A-EN_PDF_CERAMICCAPACITORSMD | Murata Electronics | GCM1555C2A3R3BE02D | 81-GCM1555C2A3R3BE2D | https://www.mouser.com/en/ProductDetail/Murata-Electronics/GCM1555C2A3R3BE02D
C20,C21,C22,C23 | 4 | 22uF |  |  |  |  | ${EXCLUDE_FROM_POS_FILES} | Capacitor_SMD:C_1206_3216Metric_Pad1.33x1.80mm_HandSolder |  | TAIYO YUDEN | EMK316BB7226ML-T | 963-EMK316BB7226ML-T | https://www.mouser.com/en/ProductDetail/TAIYO-YUDEN/EMK316BB7226ML-T
C26,C27 | 2 | 22uF |  |  |  |  | ${EXCLUDE_FROM_POS_FILES} | Capacitor_SMD:C_1206_3216Metric_Pad1.33x1.80mm_HandSolder | https://www.mouser.com/datasheet/3/76/4/GRM21BZ7YA475KE15_01A.pdf | TAIYO YUDEN | MAASL31LAB7226MTNA01 | 963-MAASL31LAB7226MT | https://www.mouser.com/en/ProductDetail/TAIYO-YUDEN/MAASL31LAB7226MTNA01
D1 | 1 | SMDJ43A |  |  |  |  | ${EXCLUDE_FROM_POS_FILES} | Samacsys:DIOM7959X262N | https://www.littelfuse.com/assetdocs/littelfuse-tvs-diode-smdj-datasheet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 | LITTELFUSE | SMDJ43A | 652-5.0SMDJ43A | https://www.mouser.com/en/ProductDetail/Bourns/5.0SMDJ43A?qs=YCa%2FAAYMW01y4uK1iR5wdw%3D%3D
D2 | 1 | SZESD5Z5.0T5G |  |  |  |  | ${EXCLUDE_FROM_POS_FILES} | Samacsys:SODFL1608X70N | https://www.onsemi.com/pub/Collateral/ESD5Z2.5T1-D.PDF | onsemi | SZESD5Z5.0T5G | 863-SZESD5Z5.0T5G | https://www.mouser.com/en/ProductDetail/onsemi/SZESD5Z5.0T5G?qs=P19jvy6W2mdQ3RyPQdpdcg%3D%3D
D3 | 1 | ESD5Z3.3T5G |  |  |  |  | ${EXCLUDE_FROM_POS_FILES} | Samacsys:SODFL1608X70N | https://www.onsemi.com/pub/Collateral/ESD5Z2.5T1-D.PDF | onsemi | ESD5Z3.3T5G | 863-ESD5Z3.3T5G | https://www.mouser.co.uk/ProductDetail/onsemi/ESD5Z3.3T5G?qs=tCMd4XlZ%2FiC1HG%2Fi9P8V3A%3D%3D
H1,H2,H3,H4 | 4 | SMTSO-M3-10ET |  |  |  |  | ${EXCLUDE_FROM_POS_FILES} | Samacsys:SMTSOM310ET | https://catalog.pemnet.com/item/uts-and-spacers-standoffs-surface-mount-type-smtso/nt-nuts-and-spacers-standoffs-br-type-smtso-metric/smtso-m3-10et | PennEngineering | SMTSO-M3-10ET | 153-SMTSO-M3-10ET | https://www.mouser.co.uk/ProductDetail/PEM/SMTSO-M3-10ET?qs=l4Gc20tDgJIdPAZs8PHzLg%3D%3D
IC1 | 1 | LTC4364HDE-2#PBF |  |  |  |  | ${EXCLUDE_FROM_POS_FILES} | Samacsys:SON50P300X400X80-15N-D | https://datasheet.datasheetarchive.com/originals/distributors/Datasheets-SFU4/DSASF4000-3547.pdf | Analog Devices | LTC4364HDE-2#PBF | 584-LTC4364HDE-2#PBF | https://www.mouser.co.uk/ProductDetail/Analog-Devices/LTC4364HDE-2PBF?qs=hVkxg5c3xu9JP25OFN%252B7tA%3D%3D
IC2 | 1 | INA238AQDGSRQ1 |  |  |  |  | ${EXCLUDE_FROM_POS_FILES} | Samacsys:SOP50P490X110-10N | https://www.ti.com/lit/gpn/ina238-q1 | Texas Instruments | INA238AQDGSRQ1 | 595-INA238AQDGSRQ1 | https://www.mouser.co.uk/ProductDetail/Texas-Instruments/INA238AQDGSRQ1?qs=QNEnbhJQKvZaH3%2FajejFPA%3D%3D
IC3,IC4 | 2 | BSS123 |  |  |  |  | ${EXCLUDE_FROM_POS_FILES} | Samacsys:SOT95P230X110-3N | https://datasheet.preprod.pas.partquest.com/images/VipMasterIC/IC/NEXP/NEXP-S-A0002912336/NEXP-S-A0002912336-1.pdf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 | Nexperia | BSS123 | 512-BSS123 | https://www.mouser.com/en/ProductDetail/onsemi/BSS123?qs=FOlmdCx%252BAA2Kf8SEB3qLYA%3D%3D
J1 | 1 | EL021252000AG |  |  |  |  | ${EXCLUDE_FROM_POS_FILES} | Samacsys:RHDR2W100P0X350_1X2_840X750X1130P | https://media.digikey.com/pdf/Data%20Sheets/Amphenol%20PDFs/ELxx12x2xxxxG.pdf | Amphenol | EL021252000AG | 523-EL021252000AG | https://www.mouser.co.uk/ProductDetail/Amphenol-Anytek/EL021252000AG?qs=T3oQrply3y8P54dysNDlxQ%3D%3D
J2 | 1 | SSW-107-01-T-D |  |  |  |  | ${EXCLUDE_FROM_POS_FILES} | Samacsys:SAMTEC_SSW-107-01-T-D | https://www.samtec.com/partnumber/SSW-107-01-T-D | SAMTEC | SSW-107-01-T-D | 200-SSW10701TD | https://www.mouser.co.uk/ProductDetail/Samtec/SSW-107-01-T-D?qs=rkdpAy2aP%2F8WM%2FmqqlIzKw%3D%3D
J3 | 1 | SSW-103-06-L-D |  |  |  |  | ${EXCLUDE_FROM_POS_FILES} | Samacsys:SSW-103-XX-YYY-D | http://suddendocs.samtec.com/prints/ssw-1xx-xx-xxx-x-xx-xxx-xx-mkt.pdf | SAMTEC | SSW-103-06-L-D | 200-SSW10306LD | https://www.mouser.com/c/?q=SSW-103-06-L-D
L1 | 1 | SPM6545VT-2R2M-D |  |  |  |  | ${EXCLUDE_FROM_POS_FILES} | Samacsys:SPM6545VT | https://product.tdk.com/system/files/dam/doc/product/inductor/inductor/smd/catalog/inductor_automotive_power_spm6545vt-d_en.pdf | TDK | SPM6545VT-2R2M-D | 810-SPM6545VT-2R2M-D | https://www.mouser.co.uk/ProductDetail/TDK/SPM6545VT-2R2M-D?qs=vmHwEFxEFR8qXWta79FcoA%3D%3D
L2 | 1 | IHLP1212BZEZR56M1Z |  |  |  |  | ${EXCLUDE_FROM_POS_FILES} | Samacsys:IHLP1212BZEZR56M1Z | https://www.vishay.com/docs/34671/ihlp-1212-ez-1z.pdf | Vishay | IHLP1212BZEZR56M1Z | 70-IHLP1212BZEZR56M | https://www.mouser.com/en/ProductDetail/Vishay-Dale/IHLP1212BZEZR56M1Z?qs=sqEgtWRSLJ0uG4%2F7%252BO18vw%3D%3D
Q1 | 1 | IRF540NSTRLPBF |  |  |  |  | ${EXCLUDE_FROM_POS_FILES} | Samacsys:IRF2804STRLPBF | https://www.infineon.com/dgdl/irf540nspbf.pdf?fileId=5546d462533600a4015355e3a72819a3 | Infineon | IRF540NSTRLPBF | 942-IRF540NSTRLPBF | https://www.mouser.co.uk/ProductDetail/Infineon-Technologies/IRF540NSTRLPBF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
Q2 | 1 | IAUZ40N10S5N130ATMA1 |  |  |  |  | ${EXCLUDE_FROM_POS_FILES} | Samacsys:IAUZ40N10S5N130ATMA1 | https://www.infineon.com/assets/row/public/documents/10/49/infineon-iauz40n10s5n130-datasheet-en.pdf | Infineon | IAUZ40N10S5N130ATMA1 | 726-IAUZ40N10S5N130A | https://www.mouser.co.uk/ProductDetail/Infineon-Technologies/IAUZ40N10S5N130ATMA1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
R1,R15 | 2 | 220 |  |  |  |  | ${EXCLUDE_FROM_POS_FILES} | Resistor_SMD:R_0402_1005Metric_Pad0.72x0.64mm_HandSolder | https://www.mouser.com/datasheet/3/203/1/PYU_RT_1_TO_0_01_ROHS_L.pdf | YAGEO | RT0402BRE07220RL | 603-RT0402BRE07220RL | https://www.mouser.com/en/ProductDetail/YAGEO/RT0402BRE07220RL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
R2 | 1 | 10mΩ |  |  |  |  | ${EXCLUDE_FROM_POS_FILES} | Samacsys:RESC6432X90N | https://www.te.com/commerce/DocumentDelivery/DDEController?Action=srchrtrv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 | TE Connectivity | TLRP3A20WR010FTE | 279-TLRP3A20WR010FTE | https://www.mouser.co.uk/ProductDetail/TE-Connectivity-Holsworthy/TLRP3A20WR010FTE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
R3,R8,R9 | 3 | 100k |  |  |  |  | ${EXCLUDE_FROM_POS_FILES} | Resistor_SMD:R_0402_1005Metric_Pad0.72x0.64mm_HandSolder |  | YAGEO | RC0402JR-7D100KL | 603-RC0402JR-7D100KL | https://www.mouser.com/en/ProductDetail/YAGEO/RC0402JR-7D100KL
R4 | 1 | 249k |  |  |  |  | ${EXCLUDE_FROM_POS_FILES} | Resistor_SMD:R_0402_1005Metric_Pad0.72x0.64mm_HandSolder | https://www.te.com/commerce/DocumentDelivery/DDEController?Action=showdoc | TE Connectivity / Holsworthy | RP73PF1E249KBTDF | 279-RP73PF1E249KBTDF | https://www.mouser.com/en/ProductDetail/TE-Connectivity-Holsworthy/RP73PF1E249KBTDF
R5 | 1 | 86.6k |  |  |  |  | ${EXCLUDE_FROM_POS_FILES} | Resistor_SMD:R_0402_1005Metric_Pad0.72x0.64mm_HandSolder | https://4donline.ihs.com/images/VipMasterIC/IC/PANA/PANA-S-A0028463698/PANA-S-A0028463689-1.pdf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 | Panasonic Industry | ERJ-2RHD8662X | 667-ERJ-2RHD8662X | https://www.mouser.com/en/ProductDetail/Panasonic-Industry/ERJ-2RHD8662X
R6,R7,R13,R14,R16,R17,R18,R19,R21,R22 | 10 | 10k |  |  |  |  | ${EXCLUDE_FROM_POS_FILES} | Resistor_SMD:R_0402_1005Metric_Pad0.72x0.64mm_HandSolder | https://www.mouser.com/datasheet/3/40/1/CRT.pdf,https://www.te.com/commerce/DocumentDelivery/DDEController?Action=showdoc | Bourns | CRT0402-BY-1002GLF | 652-CRT0402BY1002GLF | https://www.mouser.com/c/
R10 | 1 | 4.81k |  |  |  |  | ${EXCLUDE_FROM_POS_FILES} | Resistor_SMD:R_0402_1005Metric_Pad0.72x0.64mm_HandSolder |  | YAGEO | RT0402BRD074K81L | 603-RT0402BRD074K81L | https://www.mouser.com/c/?q=RT0402BRD074K81L
R11,R12 | 2 | 4.7k |  |  |  |  | ${EXCLUDE_FROM_POS_FILES} | Resistor_SMD:R_0402_1005Metric_Pad0.72x0.64mm_HandSolder | https://www.te.com/commerce/DocumentDelivery/DDEController?Action=showdoc | Kamaya | RMC1/16S-472JTH | 791-RMC1/16S-472JTH | https://www.mouser.com/en/ProductDetail/Kamaya/RMC1-16S-472JTH
R20 | 1 | 78.7k |  |  |  |  | ${EXCLUDE_FROM_POS_FILES} | Resistor_SMD:R_0402_1005Metric_Pad0.72x0.64mm_HandSolder | https://www.mouser.com/datasheet/3/826/1/n_catalog_partition01_en.pdf | Susumu | RG1005P-7872-D-T10 | 754-RG1005P-7872DT10 | https://www.mouser.com/en/ProductDetail/Susumu/RG1005P-7872-D-T10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
R23 | 1 | 162k |  |  |  |  | ${EXCLUDE_FROM_POS_FILES} | Resistor_SMD:R_0402_1005Metric_Pad0.72x0.64mm_HandSolder | https://www.mouser.com/datasheet/3/508/1/RC0402DR_07162KL.pdf | YAGEO | CRT040RC0402DR-07162KL2-BY-1002GLF | 603-RC0402DR-07162KL | https://www.mouser.com/en/ProductDetail/YAGEO/RC0402DR-07162KL?qs=sShpsBQxExEXR6vmCeAUzQ%3D%3D
R24 | 1 | 510k |  |  |  |  | ${EXCLUDE_FROM_POS_FILES} | Resistor_SMD:R_0402_1005Metric_Pad0.72x0.64mm_HandSolder | https://4donline.ihs.com/images/VipMasterIC/IC/PANA/PANA-S-A0028463698/PANA-S-A0028463689-1.pdf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 | Panasonic Industry | ERJ-2RKD5103X | 667-ERJ-2RKD5103X | https://www.mouser.com/en/ProductDetail/Panasonic-Industry/ERJ-2RKD5103X
TP1 | 1 | +BATT_Test |  |  |  |  | ${EXCLUDE_FROM_POS_FILES} | TestPoint:TestPoint_Pad_D1.5mm
TP2 | 1 | -BATT_Test |  |  |  |  | ${EXCLUDE_FROM_POS_FILES} | TestPoint:TestPoint_Pad_D1.5mm
TP3 | 1 | +VIN_Test |  |  |  |  | ${EXCLUDE_FROM_POS_FILES} | TestPoint:TestPoint_Pad_D1.5mm
TP4 | 1 | GND_Test |  |  |  |  | ${EXCLUDE_FROM_POS_FILES} | TestPoint:TestPoint_Pad_D1.5mm
TP5 | 1 | ENOUT_Test |  |  |  |  | ${EXCLUDE_FROM_POS_FILES} | TestPoint:TestPoint_Pad_D1.5mm
TP6 | 1 | FLT_Test |  |  |  |  | ${EXCLUDE_FROM_POS_FILES} | TestPoint:TestPoint_Pad_D1.5mm
TP7 | 1 | FB_Test |  |  |  |  | ${EXCLUDE_FROM_POS_FILES} | TestPoint:TestPoint_Pad_D1.5mm
TP8 | 1 | UV_Test |  |  |  |  | ${EXCLUDE_FROM_POS_FILES} | TestPoint:TestPoint_Pad_D1.5mm
TP9 | 1 | OV_Test |  |  |  |  | ${EXCLUDE_FROM_POS_FILES} | TestPoint:TestPoint_Pad_D1.5mm
TP10 | 1 | Source_Test |  |  |  |  | ${EXCLUDE_FROM_POS_FILES} | TestPoint:TestPoint_Pad_D1.5mm
TP11 | 1 | IN+_Test |  |  |  |  | ${EXCLUDE_FROM_POS_FILES} | TestPoint:TestPoint_Pad_D1.5mm
TP12 | 1 | IN-_Test |  |  |  |  | ${EXCLUDE_FROM_POS_FILES} | TestPoint:TestPoint_Pad_D1.5mm
U1 | 1 | MAX25239AFFA/VY+T |  |  |  |  | ${EXCLUDE_FROM_POS_FILES} | Snapeda:21-100399_90-100137_ADI | MAX25239AFFA/VY+T | Analog Devices / Maxim Integrated | MAX25239AFFA/VY+ | 700-MAX25239AFFA/VY+ | https://www.mouser.com/en/ProductDetail/Analog-Devices-Maxim-Integrated/MAX25239AFFA-VY%2b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
U2 | 1 | TLV62085RLTR |  |  |  |  | ${EXCLUDE_FROM_POS_FILES} | Samacsys:RLT0007A | http://www.ti.com/lit/gpn/tlv62085 | Texas Instruments | TLV62085RLTR | 595-TLV62085RLTR | https://www.mouser.co.uk/ProductDetail/Texas-Instruments/TLV62085RLTR?qs=9xotKOP9MLbR8%2FP8SbZCeQ%3D%3D
