alpauna/TritonECU/docs/Schematics/TritonECU_VR_Schematic_V_1.xlsx

Quantity | Comment | Designator | Footprint | Value | Manufacturer Part | Manufacturer | Supplier Part | Supplier | No.
4 | 470pF | C1,C5,C6,C10 | C0805 | 470pF | 0805CG471J201NT | FH(风华) | C1322379 | LCSC | 1
2 | 10nF | C2,C7 | C0201 | 10nF | GRM033R71C103KE14D | muRata(村田) | C161481 | LCSC | 2
2 | 100nF | C3,C8 | C0402 | 100nF | CC0402KRX7R7BB104 | YAGEO(国巨) | C60474 | LCSC | 3
2 | 1uF | C4,C9 | C0603 | 1uF | CL10B105KO8NNNC | SAMSUNG(三星) | C59782 | LCSC | 4
8 | 5kΩ | R1,R8,R9,R10,R11,R12,R13,R14 | R0805 | 5kΩ | ARG05DTC5001 | Viking(光颉) | C2828783 | LCSC | 5
6 | 10kΩ | R2,R3,R4,R5,R6,R7 | R0402 | 10kΩ | RC0402FR-0710KL | YAGEO(国巨) | C60490 | LCSC | 6
2 | MAX9926UAEE+T | U1,U4 | QSOP-16_L4.9-W3.9-P0.64-LS6.0-BL-1 |  | MAX9926UAEE+T | ADI(亚德诺)/MAXIM(美信) | C970723 | LCSC | 7
1 | PM254-1-09-Z-8.5 | U2 | HDR-TH_9P-P2.54-V-F |  | PM254-1-09-Z-8.5 | HCTL(华灿天禄) | C2897372 | LCSC | 8
1 | PM254-1-10-Z-8.5 | U3 | HDR-TH_10P-P2.54-V-F |  | PM254-1-10-Z-8.5 | HCTL(华灿天禄) | C2897373 | LCSC | 9
2 | SMTSO30100CTJ | U5,U6 | SCREW-SMD_BD5.6-D4.1-H10 |  | SMTSO30100CTJ | Sinhoo(雄和远景) | C2916370 | LCSC | 10
