alpauna/TritonECU/docs/1999-Ford-F150-4wd-5.42v/Engine-Component-Locations.png

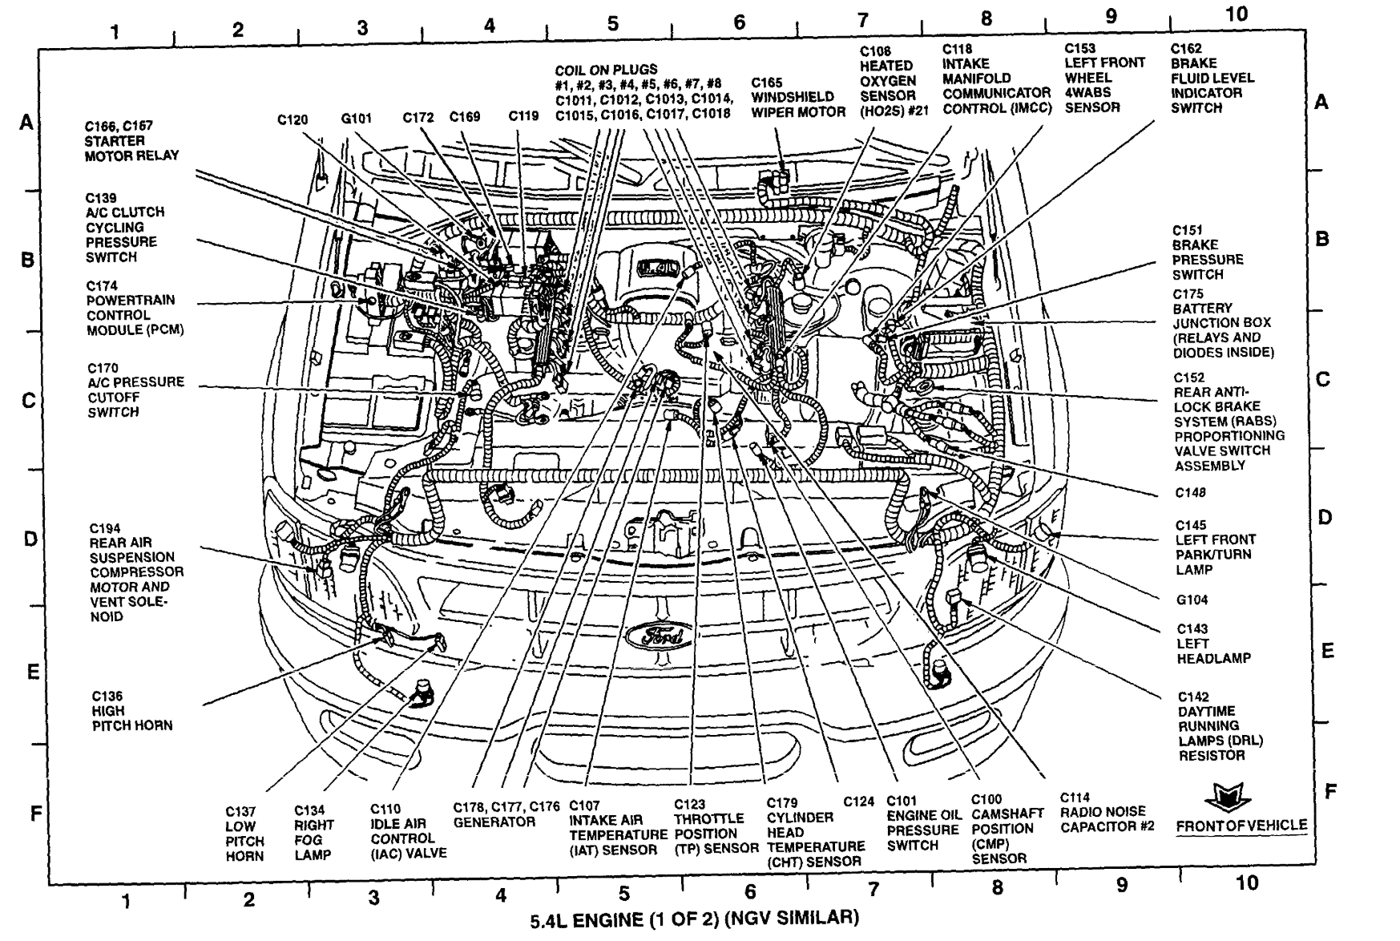
docs/1999-Ford-F150-4wd-5.42v/Engine-Component-Locations.png
