alpauna/TritonECU/hardware/carrier-template/stl/conn_gauge.stl

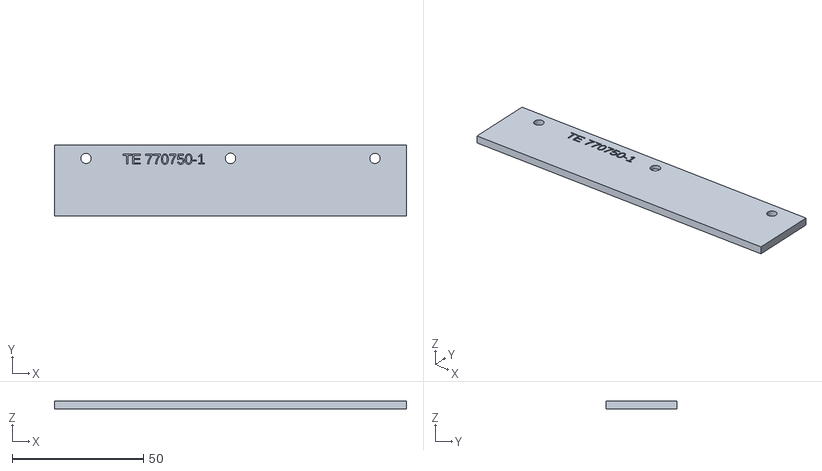
[picture p77: CAD file, 2026-09-19]
hardware/carrier-template/stl/conn_gauge.stl
134.0 x 27.2 x 3.00
