alpauna/TritonECU/hardware/harness-label/stl/text.stl

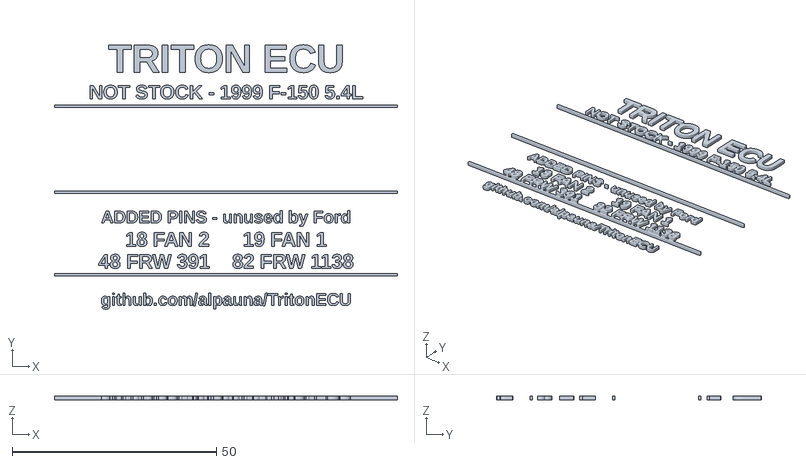
[picture p78: CAD file, 2026-09-19]
hardware/harness-label/stl/text.stl
84.0 x 64.8 x 1.00
