alpauna/TritonECU/hardware/l-bracket/stl/bracket.stl

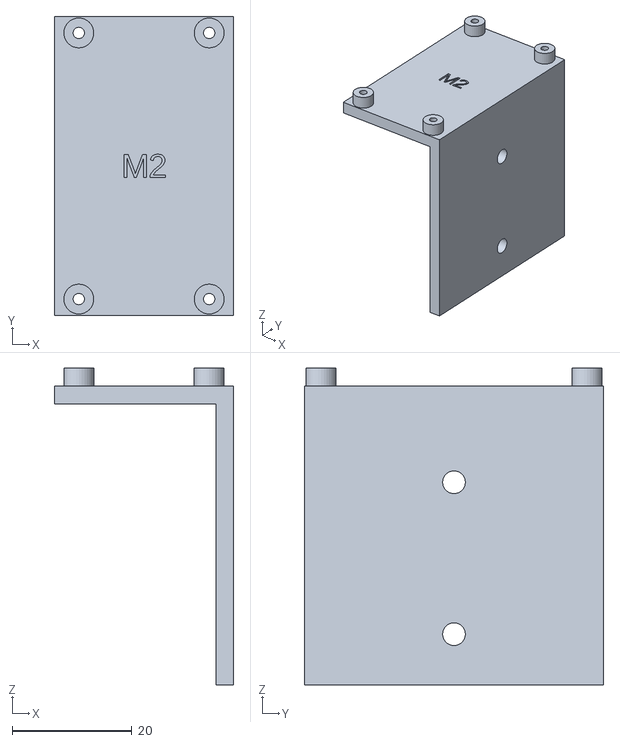
[picture p79: CAD file, 2026-09-22]
hardware/l-bracket/stl/bracket.stl
30.0 x 50.0 x 53.0
