alpauna/TritonECU/hardware/psu-enclosure/stl/lid.stl

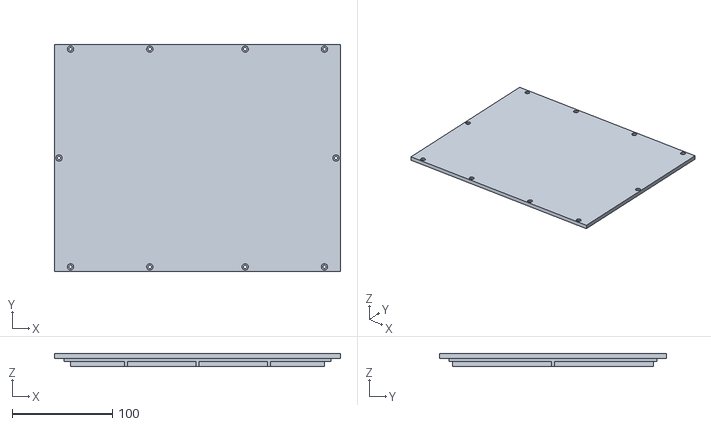
[picture p80: CAD file, 2026-09-23]
hardware/psu-enclosure/stl/lid.stl
285.0 x 226.0 x 13.0
