alpauna/TritonECU/hardware/psu-pad/stl/pad.stl

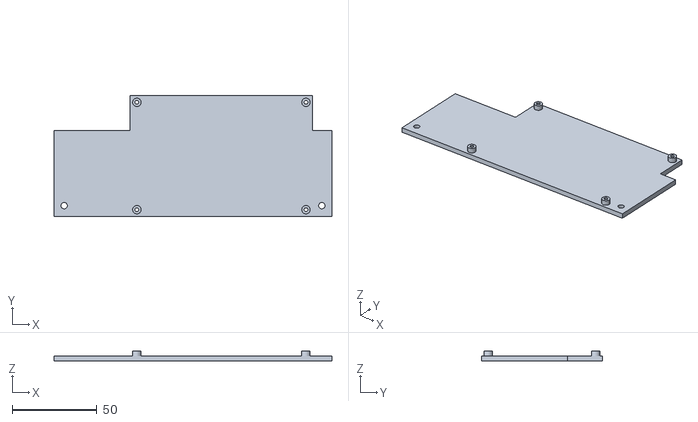
[picture p81: CAD file, 2026-09-20]
hardware/psu-pad/stl/pad.stl
164.4 x 71.5 x 6.00
