alpauna/TritonECU/hardware/psu-platform/stl/platform.stl

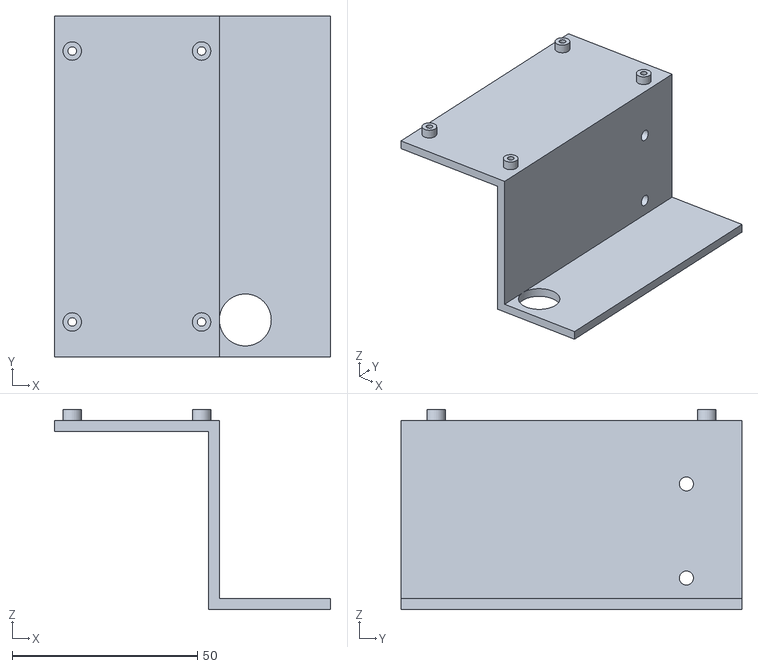
[picture p82: CAD file, 2026-09-20]
hardware/psu-platform/stl/platform.stl
74.5 x 92.0 x 54.0
