alpauna/TritonECU/hardware/vr-test-rig/stl/crank_gear.stl

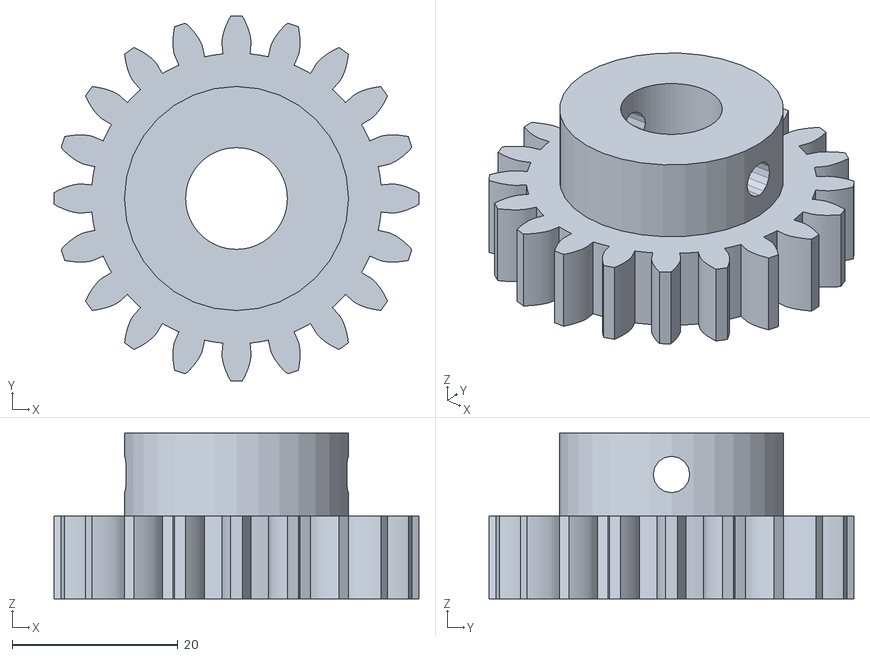
[picture p83: CAD file, 2026-09-27]
hardware/vr-test-rig/stl/crank_gear.stl
44.0 x 44.0 x 20.0
