alpauna/TritonECU/hardware/carrier-template/stl/template.stl

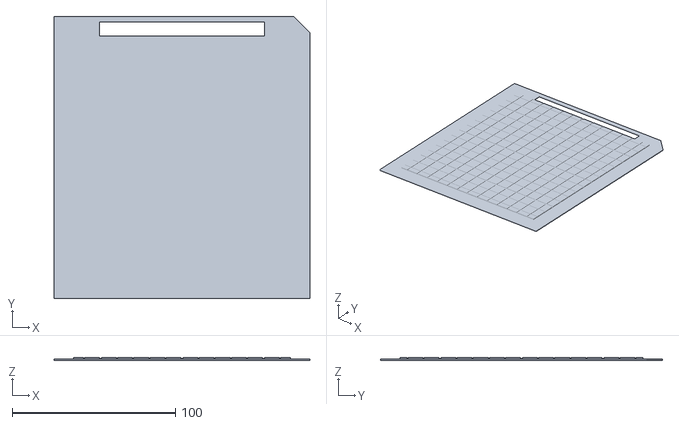
[picture p84: CAD file, 2026-09-19]
hardware/carrier-template/stl/template.stl
157.0 x 173.0 x 2.00
