alpauna/TritonECU/hardware/harness-label/stl/warn.stl

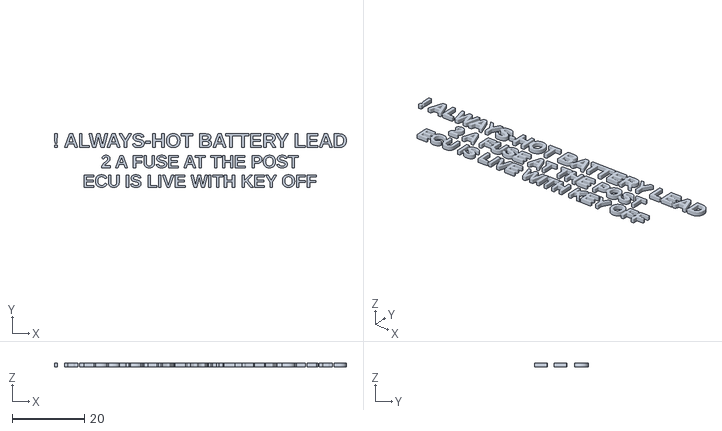
[picture p85: CAD file, 2026-09-19]
hardware/harness-label/stl/warn.stl
80.8 x 14.9 x 1.00
