alpauna/TritonECU/hardware/psu-enclosure/stl/tub.stl

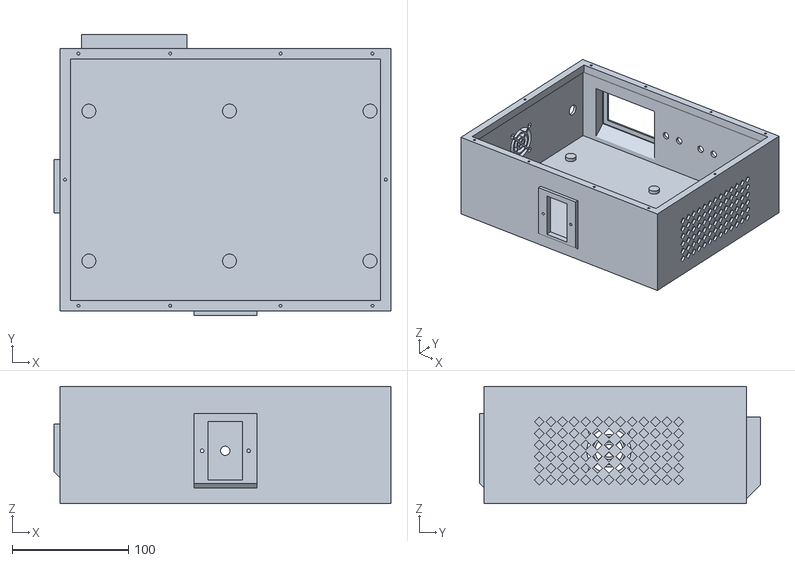
[picture p86: CAD file, 2026-09-23]
hardware/psu-enclosure/stl/tub.stl
290.0 x 242.0 x 101.0
