alpauna/TritonECU/hardware/vr-test-rig/stl/base_a.stl

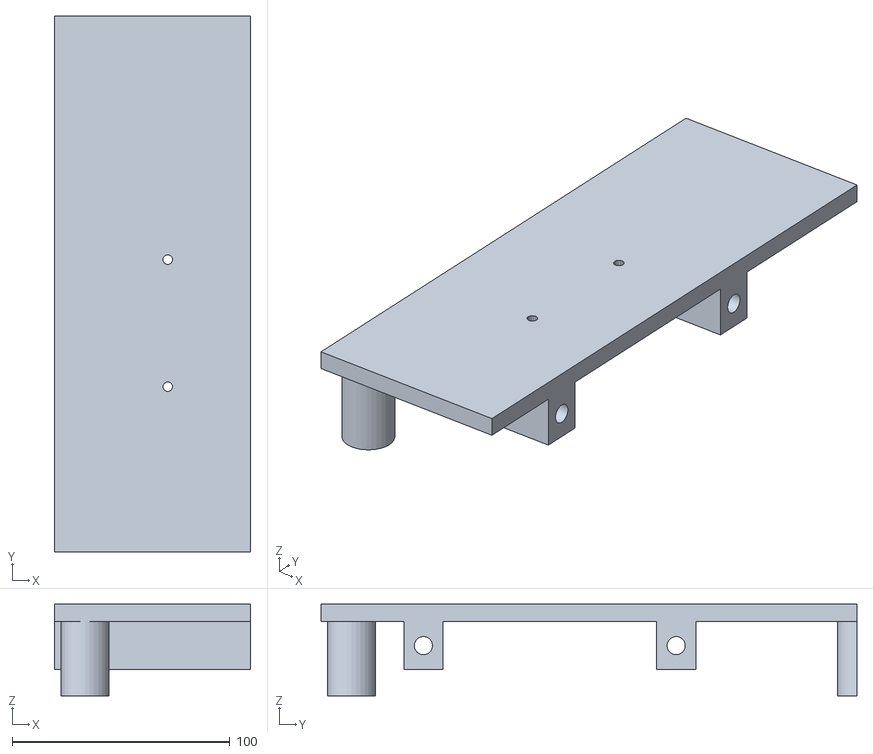
[picture p87: CAD file, 2026-09-27]
hardware/vr-test-rig/stl/base_a.stl
90.0 x 246.0 x 42.0
