alpauna/TritonECU/hardware/carrier-template/stl/ring.stl

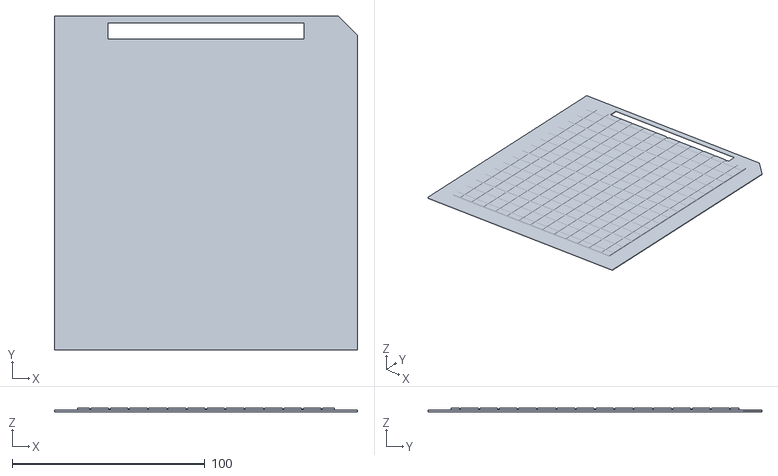
[picture p88: CAD file, 2026-09-19]
hardware/carrier-template/stl/ring.stl
157.0 x 173.0 x 2.00
