alpauna/TritonECU/hardware/harness-label/stl/plate.stl

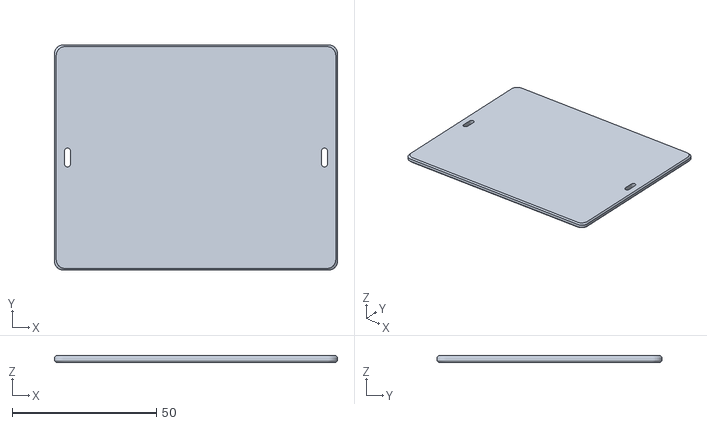
[picture p89: CAD file, 2026-09-19]
hardware/harness-label/stl/plate.stl
98.0 x 78.0 x 2.40
