alpauna/TritonECU/hardware/vr-test-rig/stl/cam_gear.stl

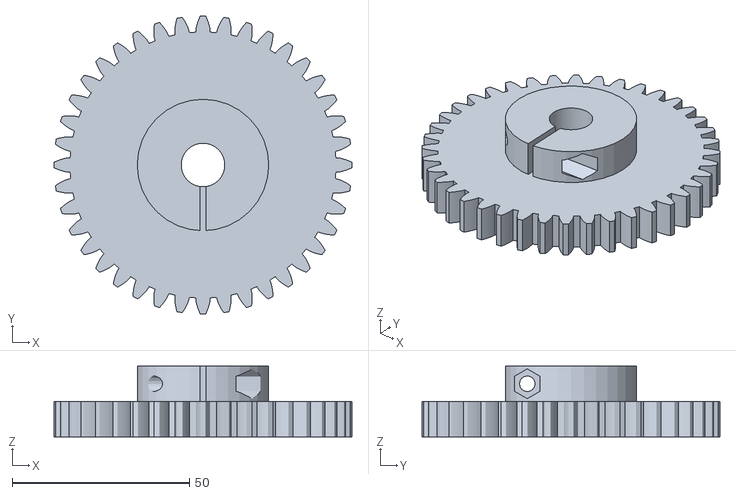
[picture p90: CAD file, 2026-09-27]
hardware/vr-test-rig/stl/cam_gear.stl
84.0 x 84.0 x 20.0
