alpauna/TritonECU/hardware/harness-label/stl/label.stl

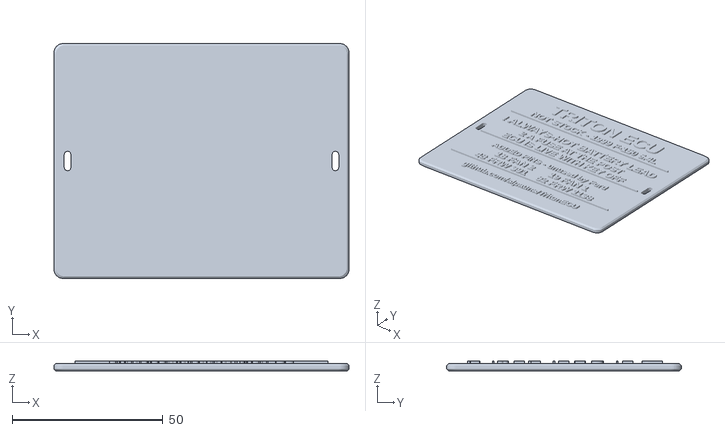
[picture p91: CAD file, 2026-09-19]
hardware/harness-label/stl/label.stl
98.0 x 78.0 x 3.20
