alpauna/TritonECU/hardware/vr-test-rig/stl/sensor_mount.stl

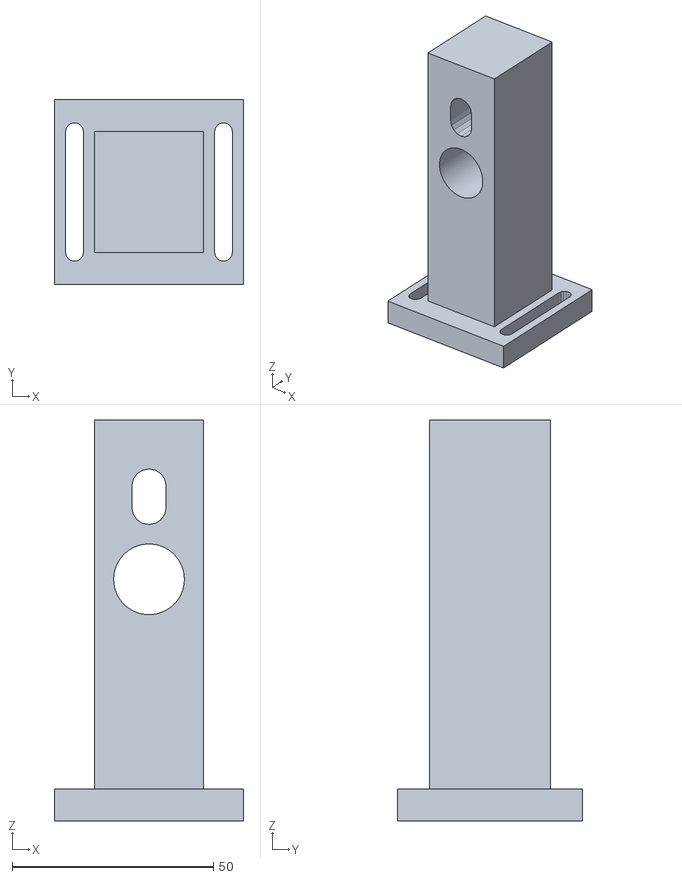
[picture p92: CAD file, 2026-09-27]
hardware/vr-test-rig/stl/sensor_mount.stl
47.0 x 46.0 x 99.6
