alpauna/TritonECU/hardware/vr-test-rig/stl/base_b.stl

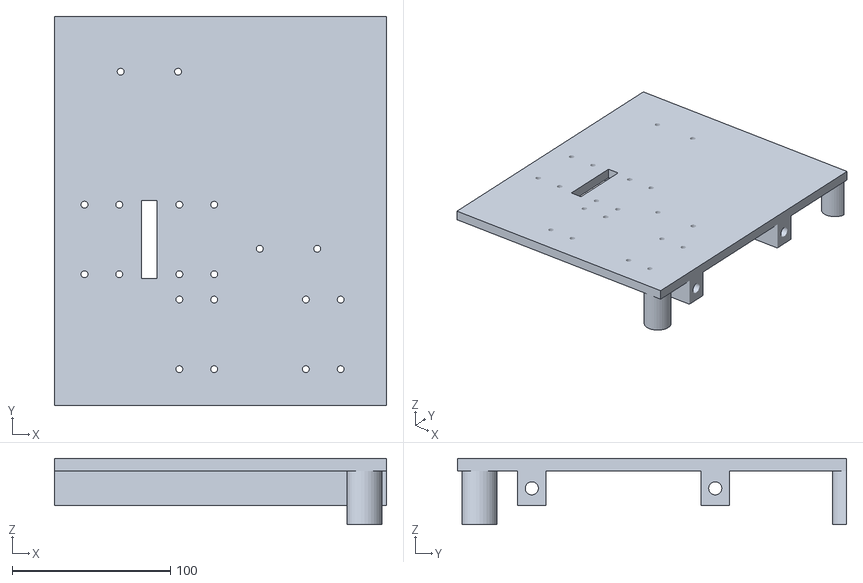
[picture p93: CAD file, 2026-09-27]
hardware/vr-test-rig/stl/base_b.stl
210.0 x 246.0 x 42.0
