alpauna/TritonECU/hardware/vr-test-rig/stl/hole_jig.stl

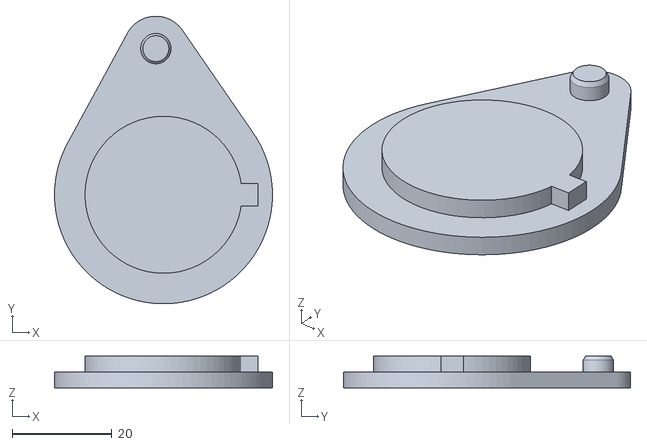
[picture p94: CAD file, 2026-09-27]
hardware/vr-test-rig/stl/hole_jig.stl
43.8 x 57.7 x 6.35
