alpauna/TritonECU/hardware/vr-test-rig/stl/fit_gauge.stl

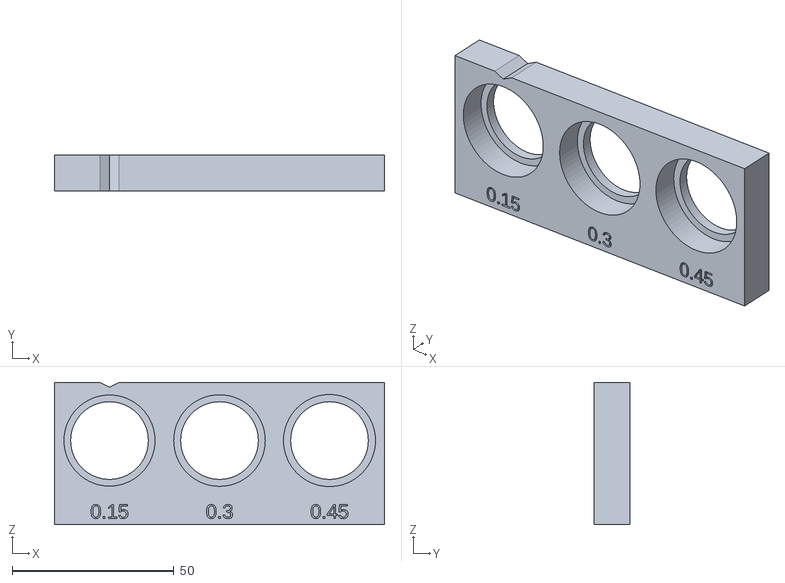
[picture p95: CAD file, 2026-09-27]
hardware/vr-test-rig/stl/fit_gauge.stl
102.0 x 11.0 x 44.0
