alpauna/TritonECU/hardware/vr-test-rig/stl/cam_target.stl

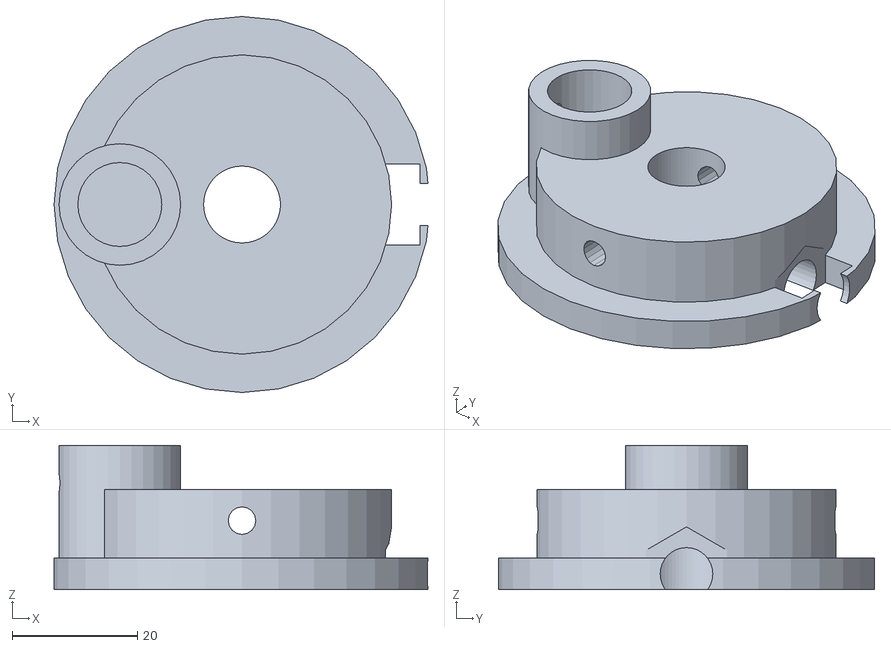
[picture p96: CAD file, 2026-09-27]
hardware/vr-test-rig/stl/cam_target.stl
59.7 x 60.0 x 23.0
