alpauna/TritonECU/hardware/vr-test-rig/stl/wheel_hub.stl

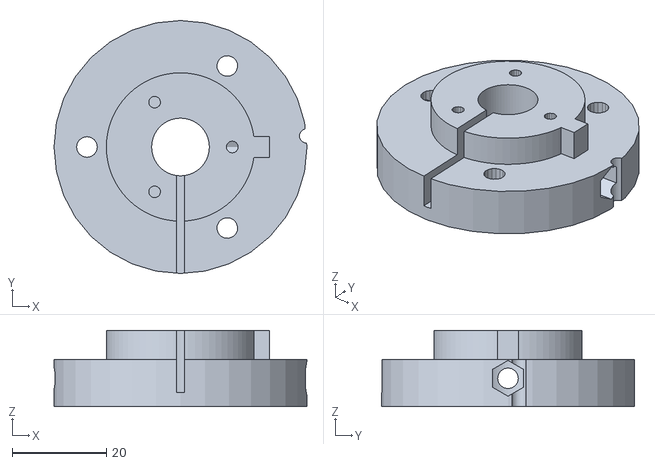
[picture p97: CAD file, 2026-09-27]
hardware/vr-test-rig/stl/wheel_hub.stl
53.8 x 53.8 x 16.2
