alpauna/TritonECU/hardware/vr-test-rig/stl/sensor_cmp.stl

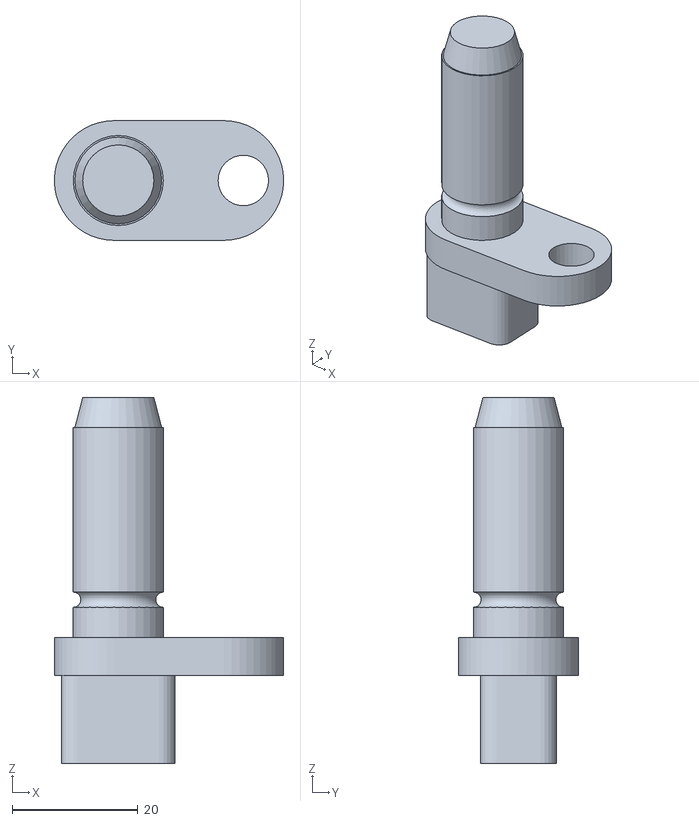
[picture p98: CAD file, 2026-09-27]
hardware/vr-test-rig/stl/sensor_cmp.stl
36.4 x 19.0 x 58.1
