alpauna/TritonECU/hardware/vr-test-rig/stl/base.stl

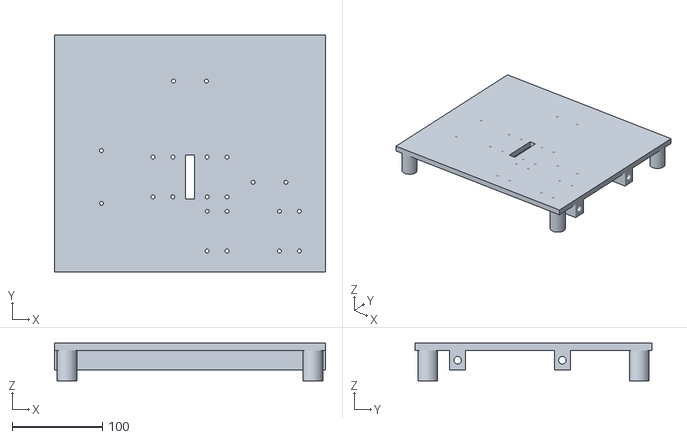
[picture p99: CAD file, 2026-09-27]
hardware/vr-test-rig/stl/base.stl
300.0 x 262.0 x 42.0
