alpauna/TritonECU/hardware/vr-test-rig/stl/clamp_plate.stl

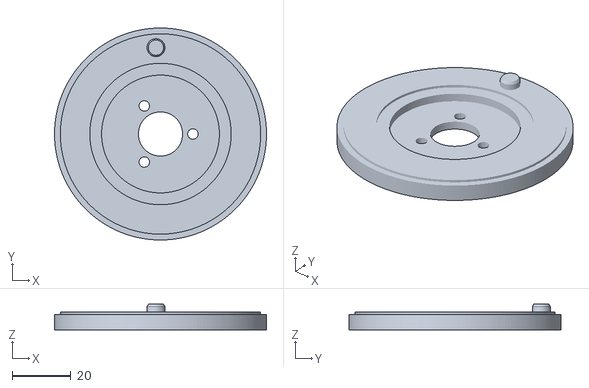
[picture p100: CAD file, 2026-09-27]
hardware/vr-test-rig/stl/clamp_plate.stl
72.0 x 72.0 x 8.68
