alpauna/TritonECU/hardware/vr-test-rig/stl/hub.stl

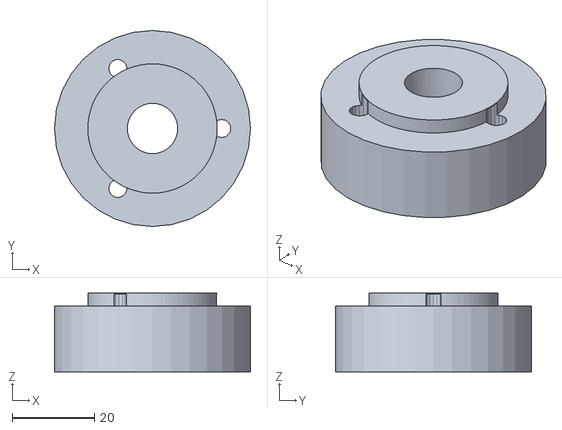
[picture p101: CAD file, 2026-09-27]
hardware/vr-test-rig/stl/hub.stl
47.8 x 47.8 x 19.2
