alpauna/TritonECU/hardware/vr-test-rig/stl/motor_mount.stl

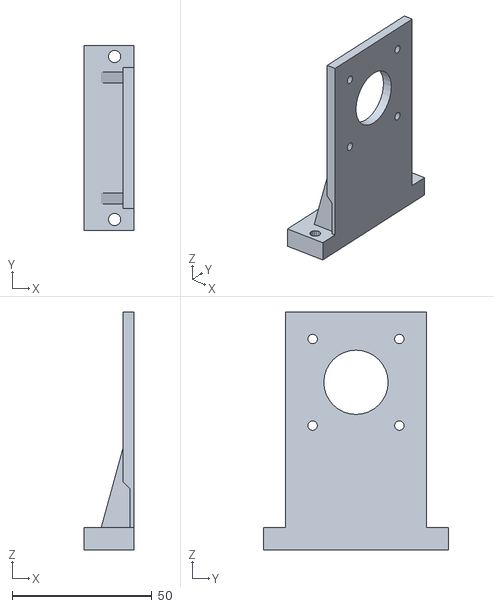
[picture p102: CAD file, 2026-09-24]
hardware/vr-test-rig/stl/motor_mount.stl
18.0 x 66.3 x 85.2
