alpauna/TritonECU/hardware/vr-test-rig/stl/sensor_ckp.stl

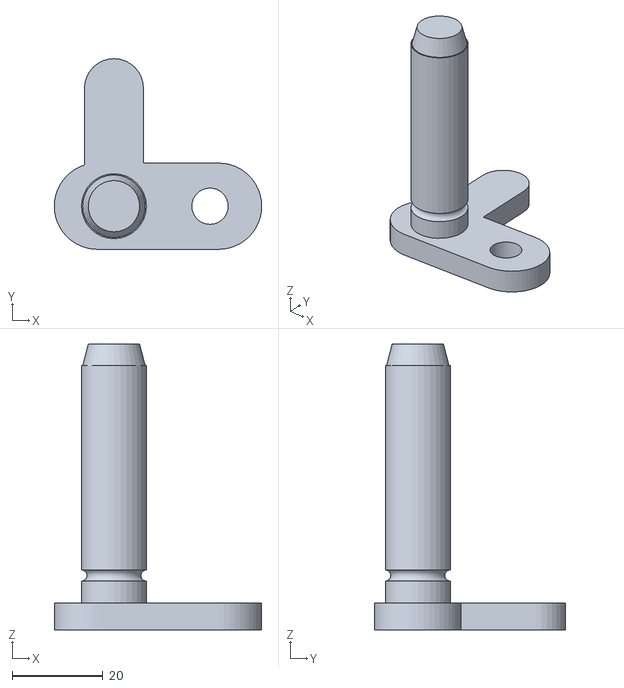
[picture p103: CAD file, 2026-09-22]
hardware/vr-test-rig/stl/sensor_ckp.stl
45.7 x 42.0 x 63.0
