alpauna/TritonECU/hardware/psu-platform/psu_platform.scad

// TritonECU — PSU mounting platform
// A Z-bracket. The module bolts down onto the UPPER flange (the one carrying
// the four 2 mm holes); the LOWER flange is the foot that fixes the bracket to
// whatever it stands on. Built from the hand drawing of 2026-09-19.
//
//   render one part at a time:  part = "platform"
//
//                     up_w 44.5
//            |<------------------------>|
//            +---------------------------+   ---
//            |  o                     o  | |  t     <- upper flange, holes here
//            +------------------------+--+   ---
//                                     |##|
//                                     |##|         <- web, t thick
//                              height |##| 51
//                                     |##|
//                                  +--+--+--------------+   ---
//                                  |                    | |  t  <- lower flange
//                                  +--------------------+   ---
//                                  |<------------------>|
//                                        lo_w 30
//
//   Total width  = up_w + lo_w = 74.5.  The web is the last t of up_w, which is
//   the only reading under which the two rectangles in the top view meet at one
//   line AND sum to the outside width. See README.md.

part = "platform";

/* Tessellation. Chord error is r*(1-cos(180/n)); a 2 mm hole at fn 32 is off by
   0.0024 mm, which is three orders below what the printer resolves. Holes are
   the only curved feature in the part, so there is nothing to economise on. */
$fn      = 32;
hole_fn  = 32;

/* ---------------------------------------------------------------------------
   FROM THE DRAWING — every number here is dimensioned on the sketch
   --------------------------------------------------------------------------- */
up_w    = 44.5;  // upper flange: outer tip to the OUTER face of the web
lo_w    = 30.0;  // lower flange: outer face of the web to its outer tip
height  = 51.0;  // OVERALL: top of the upper flange to the bottom of the lower
deep    = 92.0;  // both flanges, the depth of the extrusion

hole_d  =  2.0;  // "2 mm holes", dimensioned to hole CENTRES
hole_dx = 34.9;  // centre-to-centre, across the upper flange
hole_dy = 73.1;  // centre-to-centre, along the 92

/* ---------------------------------------------------------------------------
   NOT ON THE DRAWING — decisions, change them freely
   --------------------------------------------------------------------------- */

/* Plate and web thickness. The drawing shows a ribbon of constant thickness but
   never says how thick. 3 mm is the same as this repo's other printed plate.
   The web is the part that carries load: as a 92 x 3 plate its section modulus
   is b*t^2/6 = 138 mm^3, and a load on the middle of the upper flange acts at
   22.25 mm, so at a conservative 20 MPa for printed PETG it takes 124 N — about
   12 kg. The height does not enter that: a vertical load's moment at the root is
   set by the offset, not by how tall the web is. 3 mm is not the weak part. */
t         = 3.0;

/* Printed holes come out undersize by 0.2-0.4 mm on diameter — the first layer
   of the bore squashes inward. Same compensation as hardware/carrier-template.
   Set this to 0 if you want the model to carry the nominal 2.0 and intend to
   drill. A 2.0 mm hole modelled at 2.0 prints at roughly 1.7 and a 2 mm screw
   will not pass it. */
hole_comp = 0.30;

/* Hole pattern origin — the centre of the hole nearest the origin. The default
   centres the 34.9 x 73.1 pattern in the 44.5 x 92 flange, which is what the
   sketch shows to the accuracy a sketch has. If the real module's pattern is not
   centred, set these two and nothing else changes. */
hole_x0   = (up_w - hole_dx) / 2;   // 4.80
hole_y0   = (deep - hole_dy) / 2;   // 9.45

/* Standoffs on the four holes. The module bolts down onto the UPPER flange, so
   these sit on its TOP face and lift the module clear of it — the usual reason
   being solder tails or components on the underside of the module's board.

   HEIGHT is the defining dimension: "3 mm standoff" means 3 mm of lift. It is
   not the diameter — a 3 mm OD boss around a 2.3 mm bore would leave a 0.35 mm
   wall, which is under two extrusion widths and would neither print nor hold.
   5 mm OD gives a 1.35 mm wall and a proper seat for an M2 head (~3.8 mm A/F). */
standoff   = true;
standoff_h = 3.0;   // lift above the upper flange
standoff_d = 5.0;   // OD; see the wall-thickness check in the echoes

/* Clearance for the module's own ~13 mm standoff. The sketch of 2026-09-19 puts
   a circle in the LOWER flange (the foot), tangent to the fold line and near one
   end of the 92 — that is the plan position of a boss on the module's underside,
   so the foot has to be holed to clear it rather than sit on it.

   x is derived, not dimensioned: the drawn circle touches the fold line, so the
   centre is one radius outboard of it. y was scaled off the sketch at about 8 mm
   from the end, which would leave ~1 mm of plate; it is set to 10 here so the
   margin is 3. Set psu_cut_y from the real module and read the margin echo. */
psu_cut       = true;
psu_cut_d     = 13.0;   // the standoff itself, as measured off the module
psu_cut_clear =  1.0;   // added to DIAMETER: the hole is 14.0
psu_cut_y     = 10.0;   // centre, from the y = 0 end of the 92
psu_cut_x     = 0;      // 0 = derive it, tangent to the fold; else an absolute x
cut_fn        = 64;     // a 14 mm bore at 32 is 0.034 mm off; at 64 it is 0.008

/* The Ø3.5 pair in the WEB — the same holes hardware/l-bracket carries in its
   upright, and the same 25.4 between centres. Two differences, both asked for:
   they are NOT on the midline of the 92, and the lower one is measured from the
   bottom of the FOOT rather than from a free end, because this web has no free
   end — it lands on the lower flange.

   side_y is "15 mm from the right side, looking at the face straight on".
   CONFIRMED 2026-09-20: the face is the web seen from the UPPER FLANGE's side,
   and the right-hand end of the 92 is y = deep, so the holes are 15 from THAT
   end — the far end from the Ø14 standoff cut in the foot, not the near one. */
side_holes = true;
side_d     =  3.5;   // nominal; modelled at 3.80 with the same compensation
side_dz    = 25.4;   // centre to centre, up the web
side_z0    =  8.5;   // LOWER centre, up from z = 0 — the underside of the foot
side_edge  = 15.0;   // from the RIGHT-hand end of the 92, looking at the face
side_y     = deep - side_edge;   // 77.0

/* Optional corner ribs. OFF by default because the drawing has none and the
   web does not need them (see the 12 kg above). Turn them on if the load is
   ever sideways rather than down — that is the case the flat web is poor at. */
gusset    = false;
gusset_n  = 2;      // ribs per corner, spread along the 92
gusset_t  = 2.4;    // 3 perimeters at 0.4 mm line width, solid
gusset_l  = 12;     // how far the rib reaches along each leg

/* ---------------------------------------------------------------------------
   Geometry
   --------------------------------------------------------------------------- */
hole_r = (hole_d + hole_comp) / 2;
web_x  = up_w - t;          // inner face of the web
total_w = up_w + lo_w;

/* The fold line — where the two rectangles of the top view meet — is at up_w.
   The web hangs BELOW the upper flange from web_x to up_w, so a cut tangent to
   the fold does not touch it. */
cut_d  = psu_cut_d + psu_cut_clear;
cut_x  = (psu_cut_x > 0) ? psu_cut_x : up_w + cut_d / 2;
side_r = (side_d + hole_comp) / 2;

module ribs(x, z, dx, dz) {
    // A right triangle in X-Z, extruded along Y, repeated along the depth.
    for (i = [0 : gusset_n - 1]) {
        y = deep * (i + 0.5) / gusset_n - gusset_t / 2;
        translate([x, y, z])
            rotate([90, 0, 0])
                rotate([0, 0, 0])
                    translate([0, 0, -gusset_t])
                        linear_extrude(gusset_t)
                            polygon([[0, 0], [dx, 0], [0, dz]]);
    }
}

module platform() {
    difference() {
        union() {
            // upper flange — overlaps the web, so the union is solid, not a
            // pair of coincident faces
            translate([0, 0, height - t])   cube([up_w, deep, t]);
            // web, full height: it has to reach z=0, or its joint to the lower
            // flange is a line of zero area
            translate([web_x, 0, 0])        cube([t, deep, height]);
            // lower flange — starts at the web's INNER face for the same reason
            translate([web_x, 0, 0])        cube([lo_w + t, deep, t]);

            // standoffs, on TOP of the upper flange, bored through below
            if (standoff)
                for (i = [0, 1], j = [0, 1])
                    translate([hole_x0 + i * hole_dx,
                               hole_y0 + j * hole_dy, height])
                        cylinder(h = standoff_h, d = standoff_d, $fn = hole_fn);

            if (gusset) {
                // under the upper flange, reaching inboard along its underside
                ribs(web_x, height - t, -gusset_l, -gusset_l);
                // above the lower flange, reaching outboard
                ribs(up_w, t, gusset_l, gusset_l);
            }
        }
        // the four 2 mm holes — through the upper flange AND any standoff on it
        for (i = [0, 1], j = [0, 1])
            translate([hole_x0 + i * hole_dx, hole_y0 + j * hole_dy, height - t - 1])
                cylinder(h = t + (standoff ? standoff_h : 0) + 2, r = hole_r,
                         $fn = hole_fn);

        // clearance for the module's ~13 mm standoff — through the LOWER flange
        if (psu_cut)
            translate([cut_x, psu_cut_y, -1])
                cylinder(h = t + 2, d = cut_d, $fn = cut_fn);

        // the Ø3.5 pair — through the WEB, axis along X
        if (side_holes)
            for (k = [0, 1])
                translate([web_x - 1, side_y, side_z0 + k * side_dz])
                    rotate([0, 90, 0])
                        cylinder(h = t + 2, r = side_r, $fn = hole_fn);
    }
}

if (part == "platform") platform();

/* ---------------------------------------------------------------------------
   Checks — these print on every render, so they follow the parameters rather
   than the README
   --------------------------------------------------------------------------- */
echo(str("outside              ", total_w, " x ", deep, " x ", height, " mm"));
echo(str("upper flange         ", up_w, " x ", deep, ", holes in this one"));
echo(str("lower flange         ", lo_w, " x ", deep, " (", lo_w + t, " incl. web)"));
echo(str("plate/web thickness   ", t));
echo(str("hole modelled dia     ", hole_d + hole_comp, "  (nominal ", hole_d,
         " + ", hole_comp, " print compensation)"));
echo(str("hole centres  x       ", hole_x0, " and ", hole_x0 + hole_dx));
echo(str("hole centres  y       ", hole_y0, " and ", hole_y0 + hole_dy));
echo(str("edge margin to tip    ", hole_x0 - hole_r, " mm"));
echo(str("edge margin in y      ", hole_y0 - hole_r, " mm"));
echo(str("CLEARANCE, inboard hole to web face  ",
         web_x - (hole_x0 + hole_dx + hole_r),
         " mm  <-- a screw HEAD will not fit here, see README"));
echo(str("bed footprint, printed on end  ", total_w, " x ", height,
         "  and ", deep, " tall"));
if (side_holes) {
    echo(str("Ø", side_d, " pair in the web   modelled dia ", side_d + hole_comp,
             "  (", side_d, " + ", hole_comp, ")"));
    echo(str("  centres  z         ", side_z0, " and ", side_z0 + side_dz,
             "  up from the underside of the foot,  y ", side_y));
    echo(str("  ", side_edge, " from the RIGHT-hand end of the ", deep,
             " looking at the web from the upper flange's side, so y = ",
             side_y, ".  Mirror is y = ", deep - side_y, "."));
    echo(str("  web either side of them  ", side_y - side_r, " and ",
             deep - side_y - side_r, " mm"));
    echo(str("  lower bore clears the foot's TOP face by ",
             side_z0 - side_r - t, " mm",
             ((side_z0 - side_r - t) < 0)
               ? "  <-- BREAKS INTO the foot" : "  (ok)"));
    echo(str("  an M3.5 washer on the lower hole reaches down to z ",
             side_z0 - 3.75, ";  the foot's top face is at ", t,
             ((side_z0 - 3.75) < t) ? "  <-- washer fouls the foot" : "  (clears)"));
    echo(str("  upper bore to the underside of the upper flange  ",
             (height - t) - (side_z0 + side_dz + side_r), " mm"));
    echo(str("  same end as the standoff cut? cut y = ", psu_cut_y,
             ", holes y = ", side_y,
             (abs(psu_cut_y - side_y) < 20) ? "  (yes, same end)" : "  (opposite ends)"));
}
if (psu_cut) {
    echo(str("standoff clearance    ", cut_d, " dia through the LOWER flange  (",
             psu_cut_d, " standoff + ", psu_cut_clear, " on diameter)"));
    echo(str("  centre              x ", cut_x, "  y ", psu_cut_y));
    echo(str("  gap to the fold     ", cut_x - cut_d / 2 - up_w, " mm",
             ((cut_x - cut_d / 2 - up_w) < 0)
               ? "  <-- EATS INTO the upper flange / web" : "  (tangent = 0)"));
    echo(str("  plate left to the y=0 end   ", psu_cut_y - cut_d / 2, " mm",
             ((psu_cut_y - cut_d / 2) < 2)
               ? "  <-- UNDER 2 mm, a sliver: move psu_cut_y out or open the"
                 + " cut to the edge" : "  (ok)"));
    echo(str("  plate left to the outer tip ", total_w - (cut_x + cut_d / 2),
             " mm"));
    echo(str("  the foot's joint to the web is interrupted for ", cut_d,
             " of the ", deep, " — the other ", deep - cut_d, " still carry it"));
    if (gusset && abs(psu_cut_y - (deep * 0.5 / gusset_n)) < cut_d / 2 + gusset_t)
        echo("  <-- a GUSSET rib lands on this cut; move one or the other");
}
if (standoff) {
    echo(str("standoffs             4 x ", standoff_d, " dia x ", standoff_h,
             " tall, on the upper flange's TOP face"));
    echo(str("  wall around bore    ", (standoff_d - (hole_d + hole_comp)) / 2,
             " mm",
             ((standoff_d - (hole_d + hole_comp)) / 2 < 0.8)
               ? "  <-- UNDER 2 extrusion widths, raise standoff_d" : "  (ok)"));
    echo(str("  screw length now    module thickness + ", standoff_h + t,
             " mm before any thread engages (was ", t, ")"));
    echo(str("  overall height      ", height + standoff_h,
             " mm to the standoff tips (part itself is still ", height, ")"));
    echo(str("  outboard standoff to flange tip  ",
             hole_x0 - standoff_d / 2, " mm",
             (hole_x0 - standoff_d / 2 < 0) ? "  <-- OVERHANGS the edge" : ""));
    echo(str("  inboard standoff to web outer face  ",
             (up_w) - (hole_x0 + hole_dx + standoff_d / 2), " mm",
             ((up_w) - (hole_x0 + hole_dx + standoff_d / 2) < 0)
               ? "  <-- OVERHANGS the edge" : ""));
    echo("  NOTE: standoffs do not change the 124 N / 12 kg web figure — a");
    echo("        vertical load's moment is set by the 22.25 mm X offset, not");
    echo("        by height. They also do NOT clear the inboard-hole nut clash");
    echo("        below, which is on the UNDERSIDE.");
}
