alpauna/TritonECU/(list of files, cad)

Other CAD files:
hardware/vr-test-rig/stl/bearing_block.3mf
docs/Schematics/KiCad/TritonECU-MCU/3d/9774050982R.stp
hardware/vr-test-rig/stl/bearing_block.stl
