alpauna/TritonECU/docs/nucleo-setup.md

# Getting a Nucleo-144 (STM32F767ZI) live on Linux

Written from an actual first-time bring-up, including the two things that
stopped it. Total time once you know them: a few minutes.

The only genuine blocker is **step 3**. Everything else works first try.

---

## 1. Prerequisites

PlatformIO Core. If `pio` is not on your PATH it usually lives at
`~/.platformio/penv/bin/pio`.

```bash
~/.platformio/penv/bin/pio --version
```

The STM32 platform installs itself on first build — no separate step. For
reference, this bring-up used `ststm32 19.7.1`.

## 2. Minimal `platformio.ini`

```ini
[env:nucleo]
platform = ststm32
board = nucleo_f767zi
framework = arduino

upload_protocol = stlink
debug_tool = stlink
monitor_speed = 115200

build_flags = -Wall
```

`nucleo_f767zi` ships with the platform; nothing to add.

First build pulls the toolchain and framework (~50 s, one time):

```bash
pio run -e nucleo
```

Downloads `toolchain-gccarmnoneeabi`, `framework-cmsis`, `framework-cmsis-dsp`
and `framework-arduinoststm32`.

## 3. The udev rule — this is the one that stops you

Out of the box, uploading fails with:

```
Error: libusb_open() failed with LIBUSB_ERROR_ACCESS
Error: open failed
** OpenOCD init failed **
```

That is **not** a board or wiring fault. The ST-Link enumerates fine, but its
raw USB device is owned `root:root` with mode `crw-rw-r--`, so OpenOCD cannot
claim it for SWD:

```bash
lsusb | grep 0483:374b          # ST-LINK/V2.1 is present
ls -la /dev/bus/usb/001/0NN     # ...but crw-rw-r-- root root
```

Note the **serial port works from the start** if you are in `dialout` — only
the SWD interface is blocked. That is what makes the failure confusing.

### Fix

```bash
tools/setup-usb-permissions.sh
```

It reports which attached probes are blocked, writes the rules, reloads udev,
and tells you whether a replug is needed. Covers ST-Link V2/V2.1/V3, the CH343
and CH340, CP2102, FT232, Espressif USB-Serial-JTAG and Teensy — so it also
covers the other boards on this bench.

Check without changing anything, and without sudo:

```bash
tools/setup-usb-permissions.sh --check
```

Doing it by hand instead:

```bash
echo 'SUBSYSTEM=="usb", ATTR{idVendor}=="0483", ATTR{idProduct}=="374b", MODE="0666"' \
  | sudo tee /etc/udev/rules.d/99-stlink.rules >/dev/null
sudo udevadm control --reload-rules && sudo udevadm trigger
```

**Then unplug and replug the board.** udev applies rules on device *add*, so an
already-enumerated ST-Link keeps its old permissions. Skipping the replug is
the most common reason the fix "does not work".

Verify:

```bash
ls -la /dev/bus/usb/001/0NN     # should now be crw-rw-rw-
```

## 3b. If the on-board ST-Link fails — using an external probe

The on-board ST-Link on this board degraded during bring-up: dropping console
characters first, then refusing to enumerate. An external **STLINK-V3** works,
but three things have to be right and none are obvious.

### Wiring: CN6, with the CN4 jumpers **fitted**

Counter-intuitive, and the thing that cost the most time. **CN6 sits on the
ST-Link side of the CN4 jumpers.** Removing them isolates the MCU from the
on-board ST-Link *and* from CN6 — the opposite of what "disconnect the broken
debugger" suggests. (UM1974 Table 4: CN4 OFF is the mode where the *on-board*
ST-Link drives an *external* target through CN6.)

| STLINK-V3 | Nucleo |
|---|---|
| **VTREF / VDD_TARGET** | **a real 3V3 pin** (Arduino or morpho header) |
| SWCLK | CN6 pin 2 |
| SWDIO | CN6 pin 4 |
| GND | GND |

**VTREF must come from an actual 3.3 V rail.** CN6 pin 1 is labelled
`VDD_TARGET` but it is a *sense input* for the on-board ST-Link to read an
external target's voltage — it reads 0 V with nothing attached, which is
correct, not a fault.

CN6 pinout per UM1974 Table 5: 1 VDD_TARGET, 2 SWCLK, 3 GND, 4 SWDIO,
5 NRST, 6 SWO (reserved).

UM1974 §7.3.3 says CN6 "must not be used" with CN4 fitted, because the on-board
ST-Link's F103 still sits on the same SWD lines. Here that F103 is dead, so it
works — but if running-core reads ever turn flaky again, suspect contention
from a half-alive F103 before the probe.

**The cleaner alternative** is UM1974 §7.2's own route: pull the CN4 jumpers
and wire straight to the target on morpho **CN11 — pin 13 = PA13 (SWDIO),
pin 15 = PA14 (SWCLK), pin 14 = NRST**. That takes the on-board ST-Link off
the bus entirely.

**What a bad VTREF actually looks like** — because it is *not* an upload
failure, which is why it went unnoticed for a while. With VTREF unconnected the
probe reports `Target voltage: 0.0016`, warns `target voltage may be too low
for reliable debugging`, and then **programs and verifies the flash anyway**.
What breaks is everything with the core *running*: memory reads fail
intermittently with `Fail reading CTRL/STAT register. Force reconnect` and
`Polling failed, trying to reexamine`, while the same reads succeed after a
`halt`. Fixed on 2026-09-29 by wiring VTREF to a real 3V3 pin; the probe now
reads `Target voltage: 3.284631` and running-core reads are clean.

Success looks like:

```
Info : SWD DPIDR 0x5ba02477
Info : [stm32f7x.cpu] Cortex-M7 r1p0 processor detected
Info : [stm32f7x.cpu] Examination succeed
```

### The board file assumes the wrong transport

`nucleo_f767zi` targets the on-board V2.1, which uses OpenOCD's **hla**
transport. An STLINK-V3 speaks plain SWD and is rejected outright:

```
Debug adapter doesn't support 'hla_swd' transport
```

So the upload is driven directly rather than through the board file:

```ini
upload_protocol = custom
upload_command = $PROJECT_PACKAGES_DIR/tool-openocd/bin/openocd
  -s $PROJECT_PACKAGES_DIR/tool-openocd/openocd/scripts
  -f interface/stlink.cfg -c "transport select swd"
  -f target/stm32f7x.cfg
  -c "init; reset halt; program {$SOURCE}; reset run; shutdown"
```

### Program the ELF, and keep `verify` on

**`program firmware.bin` writes nothing and reports success.** A raw `.bin`
carries no address information, so without an explicit `0x08000000` OpenOCD
happily does nothing — the board resets and runs the *previous* image. The
symptom is maddening: correct build, `Programming Finished`, clean reset, and
firmware that is silently one version old.

Program the **ELF**, which carries its own load addresses:

```
-c "init; reset halt; program {$BUILD_DIR/${PROGNAME}.elf} verify; reset run; shutdown"
```

**Keep `verify`.** Earlier CRC verify failures looked like a nuisance to work
around; they were in fact the symptom of nothing having been written. Turning
verify off removed the only signal that anything was wrong. `** Verified OK **`
is the line to look for.

### `%f` prints nothing

STM32duino links **newlib-nano**, whose `printf` omits float support to save
space. `%f` does not error — it prints *nothing at all*, leaving gaps in
otherwise correct output.

```ini
build_flags = -Wl,-u,_printf_float
```

Easy to misread as a data problem when every voltage in a table comes out
blank.

## 4. Upload

```bash
pio run -e nucleo -t upload
```

Expect `Programming Finished` / `Verified OK` in about 2.5 s.

## 5. Serial console

The ST-Link provides a USB CDC virtual COM port. **Address it by its by-id
path**, not `/dev/ttyACMn` — the numbering shifts when other boards are
plugged in:

```bash
ls /dev/serial/by-id/ | grep STLink
# usb-STMicroelectronics_STM32_STLink_<serial>-if02
```

Add to `platformio.ini`:

```ini
monitor_port = /dev/serial/by-id/usb-STMicroelectronics_STM32_STLink_<serial>-if02
```

The `-if02` suffix matters: the ST-Link is a composite device and `if02` is the
VCP interface.

---

## Two quirks worth knowing before they confuse you

### The VCP and SWD share one USB device

Resetting the target over SWD — `openocd ... reset`, or a debugger connect —
**disconnects the serial port**. So a boot banner is genuinely hard to catch:
by the time the port re-enumerates, the message has been printed.

Do not fight it. **Give the firmware a command that reprints on demand:**

```cpp
while (Serial.available()) {
    if (Serial.read() == 'i') reportIdentity();
}
```

Then the host opens the port at leisure and asks. Useful on a bench anyway.

### The VCP drops bytes — use a separate UART instead

Initially this looked like a burst-length problem. It is worse than that: on
this board the VCP **drops characters on a five-second heartbeat with no host
traffic at all**, at 115200 and again at 57600. Flushing and pausing between
lines did not fix it.

The same firmware over **USART2 to a CH340 adapter is byte-perfect**, long
separator lines included. So it is the ST-Link, not the application.

**Wire a USB-UART adapter to a spare UART and treat the VCP as a fallback:**

| Nucleo | Adapter |
|---|---|
| **PD5** (USART2_TX) | RX |
| **PD6** (USART2_RX) | TX |
| GND | GND |

USART3 (PD8/PD9) is the ST-Link's own, hence USART2. Writing to both ports and
reading from either means nothing has to be reconfigured.

*Also worth knowing: a host-side reconnect loop makes any serial problem look
far worse than it is, because each reopen discards the kernel buffer. Hold the
port open before concluding anything.*

*ST's `STLinkUpgrade` tool sometimes fixes VCP flakiness on older ST-Link
firmware — worth trying, but a separate UART is independent of the debugger,
which is what you want when the debugger is the thing misbehaving.*

---

## Troubleshooting

| Symptom | Cause | Fix |
|---|---|---|
| `LIBUSB_ERROR_ACCESS` on upload | no udev rule for ST-Link | `tools/setup-usb-permissions.sh`, **and replug** |
| Fix applied but still fails | board not replugged | unplug/replug |
| Serial works, upload does not | VCP is unprivileged, SWD is not | step 3 |
| Garbled serial | host reconnecting on every error | hold the port open |
| Still garbled on a held port | ST-Link VCP is unreliable | use USART2 (PD5/PD6) + USB-UART |
| Board dark on external power | VIN fed below 7 V, or jumper not moved | use **E5V with 5 V**; move the supply-select jumper |
| Console silent after debugging | SWD reset dropped the VCP | reopen the port; use the `i` command |
| `pio device monitor` crashes | needs a TTY, not a pipe | read the port directly, or run interactively |
| Wrong `/dev/ttyACMn` | numbering shifts between boards | use the `by-id` path |
| `Debug adapter doesn't support 'hla_swd'` | external V3 vs. a board file written for V2.1 | drive OpenOCD directly — §3b |
| `target voltage may be too low` | VTREF not on a real 3.3 V rail | CN6 pin 1 is a *sense input*, not a supply |
| Upload verifies, but live reads fail (`Fail reading CTRL/STAT`) | same — VTREF at 0 V; only running-core access suffers | wire VTREF to 3V3; expect `Target voltage: 3.28` |
| `mdw` prints nothing in a `-c` batch | command output is a Tcl return value here | `echo "[read_memory 0x40021414 32 1]"` |
| `unable to connect to the target` | wrong connector or jumper state | CN6 **with** CN4 jumpers fitted, or CN11 13/15 with CN4 pulled |
| `error executing cortex_m crc algorithm` | usually: nothing was written | program the **ELF**, not the `.bin` |
| Upload succeeds, old firmware runs | `.bin` has no load address | program the **ELF**; keep `verify` on |
| `%f` prints nothing | newlib-nano printf | `-Wl,-u,_printf_float` |
| Enumeration errors `-110` / `-62` | cascaded bus-powered hubs | plug directly into the PC |

## Verifying it actually works

Have the firmware read its own identity registers rather than trusting the
build configuration:

| What | Where | Expected on an F767ZI |
|---|---|---|
| Device ID / revision | `DBGMCU->IDCODE` | **0x451**, rev 0x1001 |
| Flash size | `*(uint16_t*)0x1FF0F442` | **2048** (KB) |
| Unique ID | `0x1FF0F420`, 96-bit | non-zero |
| Core clock | `SystemCoreClock` | **216 MHz** |
| Reset cause | `RCC->CSR` | power-on, pin, watchdog… |

`0x451` is the STM32F76x/F77x family. Anything else means the board file and
the silicon disagree — worth catching before trusting a pin assignment.

`SystemCoreClock` reading 216 MHz confirms the PLL is configured; **16 MHz
would mean it fell back to HSI**, which is a silent and very confusing failure
mode because everything still runs, just slowly and with wrong baud rates.
