alpauna/TritonECU/hardware/scp-rig/schematics/gerb2/How-to-order-PCB.txt

How to Order PCB

Please refer to:
https://prodocs.easyeda.com/en/pcb/order-order-pcb/index.html
