alpauna/TritonECU/hardware/vr-test-rig/README.md

# 36-1 VR trigger wheel test rig

A motor-driven bench rig for **M3 crank sync** — real VR sensor, real trigger
wheel, known shaft position.

`vr_rig.scad` holds every printed part. Set `part = "..."` at the top and render
one at a time.

---

## ⚠ Bearing blocks: print the fit gauge first

**The first PETG set split.** Bearings pressed in, and all but one delaminated
within the hour.

`brg_press` was **−0.05**, which looks like 0.05 mm of interference and is
harmless at 2.8 MPa. **But an FDM bore prints undersize** — extrusion overlaps
on the inside of a curve, and a horizontal bore sags at its crown, so 0.2–0.4 mm
on diameter is routine. That turns 0.05 into 0.25–0.45, and the hoop stress with
it:

| Real interference | Hoop stress | |
|--:|--:|---|
| 0.05 mm | 2.8 MPa | fine |
| 0.35 mm | 19.3 MPa | marginal |
| **0.45 mm** | **24.9 MPa** | **past PETG's ~22 MPa interlayer** |

**And interlayer is the number that matters.** At the 3 and 9 o'clock positions
of a *horizontal* bore the hoop stress runs in **Z**, and the radial crack plane
there contains the bore axis and the radius — **which is the layer plane**. The
block doesn't crack, it **delaminates**, splitting out through the 4 mm side wall
at bore mid-height, right where the gusset root sits as a stress riser.

**The one that survived is bore-diameter lottery, not margin** — it printed
perhaps 0.05 mm looser than its siblings.

### A thicker wall is the wrong fix

Everyone reaches for it first. It doesn't work: a thicker hub is a **stiffer**
hub and develops proportionally more contact pressure for the same interference.

| Wall | Block width | Hoop stress |
|--:|--:|--:|
| 4 mm | 36 mm | 19.3 MPa |
| 8 mm | 44 mm | **18.2 MPa** |

Doubling the wall buys **6 %**, for 8 mm of extra width.

### The fix: clearance plus retaining compound

`brg_press` is now **+0.30** — the pocket is modelled *oversize*, aiming at a
small clearance once the print shrinks it. The bearing is held by **Loctite
638/609**, which wants 0.05–0.25 mm of gap and puts **zero hoop stress** into the
plastic. The shoulder still locates it axially.

```bash
openscad --export-format binstl -o stl/fit_gauge.stl -D 'part="fit_gauge"' vr_rig.scad
```

**Print `fit_gauge` first.** Three pockets at +0.15 / +0.30 / +0.45, in the *same
orientation* as the real block — horizontal and vertical bores do not shrink
alike. Try a 6001 in each, and set `brg_press` to whichever slides in with a
whisker of play. **Printers differ by more than the failure margin does.**

**The pockets run smallest → largest, and the smallest end is the notched one.**
The V notch in the top face is over +0.15. Hold the coupon with the numbers
upright and they read left to right.

> ⚠ **The first coupon's labels were unreadable, and that was a modelling bug —
> fixed 2026-09-20.** The text sat at baseline z 3.5 with the bore centred at
> z 18, so the bore mouth opened at **z 3.93** directly above it: everything but
> the bottom 0.4 mm of every digit was inside the hole. All three were lost the
> same way, which is why it looked like a printing problem. The coupon now
> carries an 8 mm **plain label band** below the bores — it is 44 mm tall
> instead of 36 — with the numbers 0.8 mm deep in it and the notch as a backup.
> **A coupon printed before that date has good pockets and useless labels: the
> pockets are still in order, so count from the end, don't squint.**

### Result of the first gauge print (2026-09-20)

**+0.15 took the bearing with no play. +0.30 and +0.45 were both loose.**

That is the measurement the gauge exists for: a pocket modelled at **28.15** that
finishes snug on a **28.00** bearing means this printer shrinks a horizontal bore
by **≈0.15 mm on diameter** — mid-range of the 0.2–0.4 this page predicted.

> ⚠ **The pocket that felt best is the wrong one to build.** The bearing is not
> held by the bore, it is held by the compound, and the compound needs a gap.

| Pocket | Finishes at | Gap on the bearing | |
|--:|--:|--:|---|
| +0.15 | ~28.00 | ~0.00 | felt perfect. No room for adhesive, and a block that prints a tenth tighter is back in interference — **this is the first PETG set's failure** |
| **+0.30** | ~28.15 | **~0.15** | felt loose, and is the middle of the 0.05–0.25 window |
| +0.45 | ~28.30 | ~0.30 | past what 638 will fill |

**`brg_press` stays at +0.30** — unchanged in value, but no longer a guess. Even
if the shrink wanders ±0.05 between blocks, the gap stays inside 0.10–0.25.

**Use Loctite 638, not 609.** At a 0.15 mm gap 609 is marginal — it is rated for
about 0.10 mm diametral — while 638 fills to 0.25.

The "loose" feel is the design working. Anyone re-running this gauge on another
printer should pick **the pocket one or two steps above the one that feels
right**, not the one that feels right.

### The rule this leaves behind

Swept the rest of the rig: **every other fit is clearance** (`shaft_dia + clr`,
`wheel_bore − clr`), and **every other load-carrying bore prints with its axis
vertical** — hub, wheel hub, cam target, and the hub's split clamp all put their
hoop or bending stress *in-layer*. The bearing block was the only part that got
**both** wrong at once, which is why it was the only one that failed.

> **Two questions for any new part that takes a bearing, a bush or a pressed pin:**
> 1. Is the load **across layers**? A bore's hoop stress is in Z at its 3 and 9
>    o'clock positions whenever the **bore axis is horizontal**.
> 2. Is the interference **real**, or is it the modelled number? They are not the
>    same, and the gap between them is bigger than the margin.

> **The other lever, if you want belt and braces:** print the block with the
> **bore axis vertical**. The hoop stress then lies entirely in-layer — ~50 MPa
> instead of ~22, a **2.3× gain** — at the cost of support under the foot flange.

## ⚠ The wheel cannot be printed

A VR sensor is a permanent magnet and a coil. It produces voltage from the
**change in magnetic reluctance** as ferromagnetic teeth pass the pole piece.
PLA, PETG and ABS are magnetically indistinguishable from air.

**A printed wheel produces zero output.** Not a weak signal — nothing.

Iron-filled filaments do not rescue it either: the particles are discontinuous,
giving a relative permeability of a few against **~1000+ for mild steel**. The
magnetic circuit needs a continuous path.

So the rig is *printed*, the wheel is *bought*:

- an aftermarket **36-1 steel trigger wheel** (the Megasquirt/aftermarket world
  is full of them, commonly 5–7" diameter), **mild steel — not austenitic
  stainless**, which is non-magnetic, or
- the **actual Ford reluctor** off a spare damper, which has the advantage of
  being exactly what the ECU will see in the truck.

## Motor: a stepper, and the reason is ground truth

A bench rig beats a signal generator for two reasons. One is the **real VR
waveform** — amplitude that scales with speed, real edge shapes, real noise. The
other is **knowing exactly where the wheel is**.

A signal generator gives the second but not the first. A drill gives the first
but not the second. **A stepper gives both.**

| | Stepper | BLDC + ESC | Drill |
|---|---|---|---|
| Known speed | **exact** | needs a sensor | no |
| **Known position** | **exact** | no | no |
| Cranking speed (150–300 rpm) | **excellent** | poor, cogs | no |
| Top speed | ~1200 rpm | thousands | thousands |

### Why ~1200 rpm is enough

**The electrically hard case is cranking, not redline.** A VR sensor puts out
perhaps 0.5–1 V at 200 rpm and 50–100 V at 6000 — Mode A2's adaptive threshold
exists precisely for the bottom of that range. A motor that is excellent from
150 to 1200 rpm covers the entire difficult region.

High rpm stresses *firmware timing* rather than the sensor, and the 10 native
tests in `test_crank` already cover 200–6000 rpm logically. **The bench rig's job
is the analog end**, which is the half that cannot be tested in software.

If high-rpm timing later needs proving on real hardware, a GT2 belt at 3:1 gets
3600 rpm from the same motor without redesigning anything.

### Drive it from the STM32 under test

The elegant version: **generate the step pulses from the same MCU that is
decoding the VR signal.** One timer produces steps, another captures COUT edges,
and firmware compares its own commanded position against what the decoder
reports — in one program, with no external reference to trust.

That turns the rig from "does it look right on a scope" into an assertion.

## Bought parts

| | |
|---|---|
| **36-1 steel trigger wheel** | mild steel, see above |
| **Ford CKP sensor**, 1999 5.4L | the real sensor, not a substitute — the point is the real waveform |
| NEMA 17 stepper | 1.5–2 A, 5 mm shaft |
| Stepper driver + 24 V supply | TMC2209 or DRV8825; 24 V is what buys the top of the speed range |
| 8 mm ground steel rod | ~150 mm |
| 2 × **608ZZ** bearings | 22 × 8 × 7 mm |
| 5 → 8 mm flexible coupling | jaw or helical — a printed rig will have misalignment |
| M4 hardware, M3 × 4 for the motor | |
| **Feeler gauges** | the air gap is the experiment |

## Measure these three before printing

The `.scad` is parametric but it cannot guess:

```
wheel_od      trigger wheel outside diameter
wheel_thk     wheel thickness
wheel_bore    centre bore
sensor_dia    VR sensor barrel diameter
```

Also check the wheel's bolt pattern against `hub()` — it assumes 3 × M4 on a
circle, which is a guess.

## Printing

**PETG or ABS, not PLA.** PLA creeps under sustained load and softens near a
stepper that has been running.

- **Bearing blocks and sensor mount: 5 perimeters, ≥40 % infill.** These carry
  load and set the air gap.
- **Print the bearing blocks lying on their backs**, bore axis vertical. That
  keeps the bore round and puts the shaft load into layer *shear* rather than
  pulling layers apart.
- ⚠ ~~Bearing pocket is sized at `brg_od - 0.05` for a light press. If it will
  not seat, open `brg_press` toward `+0.10`.~~ **STALE — and this is the exact
  setting that split the first PETG set.** `brg_press` is now **`+0.30`**, a
  *clearance* fit held with retaining compound, for the reasons at the
  [top of this file](#-bearing-blocks-print-the-fit-gauge-first). **Print
  `fit_gauge` first and let it choose the number.** Do not reach for a press
  fit; the whole point of the correction is that there isn't one.

## The air gap is the experiment, not a setting

Ford's CKP gap is around 1.0–1.5 mm, but the slotted feet on `sensor_mount()`
exist so it can be **swept**. Sweeping it is most of the value of the rig:

- how VR amplitude scales with gap, at fixed rpm
- the gap at which the adaptive threshold stops finding teeth at cranking speed
- whether the missing-tooth gap is still unambiguous at the extremes

## Safety

A 150 mm × 5 mm mild steel wheel is about **0.7 kg**, and at 1200 rpm it stores

```
E = ½Iω²  =  ½ × 1.94e-3 × 125.7²  ≈  15 J
```

Not lethal; it will still take a fingertip. The hub is a **split clamp with
through-bolts, not a grub screw**, for exactly this reason. Do not stand in the
plane of the wheel while it spins, and fit a guard before running it unattended.

## What this rig actually answers

1. **VR amplitude versus rpm** — including the peak, which settles the one open
   hardware question on the VR board: whether 5 kΩ in 0805 (good to ~150 V of
   sensor output) needs a second resistor per leg. See
   [`../../docs/review-vr-v1.md`](../../docs/review-vr-v1.md).
2. **Does the zero crossing land mid-tooth?** Scope COUT against a known shaft
   angle. This is the claim Mode A2 is chosen for.
3. **Minimum rpm at which sync holds**, and how the 85 ms watchdog behaves when
   it does not.
4. **Missing-tooth detection** against commanded position, not against itself.

---

# Add the cam channel — and drive it with gears

**Yes, include CMP.** Not as a convenience: the crank/cam *relationship* is the
thing that cannot be tested any other way.

## Why the cam has to be on the same rig

Crank sync tells you where you are **within a revolution**. Cam sync tells you
**which revolution** — compression or exhaust for a given cylinder. On a 4-stroke
the cam turns at half crank speed, and everything sequential depends on that
relationship being right.

**Two signal generators cannot test this.** They can each produce a correct
waveform, but not one that is *mechanically phase-locked* to the other with real
jitter and real drift. A rig with a 2:1 gear pair produces exactly what the
engine produces, including the imperfections.

[`sensors-to-run.md`](../../docs/1999-Ford-F150-4wd-5.42v/sensors-to-run.md)
already records that with coil-on-plug and sequential injection **CMP is
mandatory, not optional**. Building the rig crank-only means building it twice.

It also unlocks the failure modes that only exist with both present:

- cam signal lost mid-run, and whether sync recovers or limps
- **cam pulse landing on or near the missing tooth** — the nastiest case, and
  one you can only find by sweeping the phase
- sync-loss and re-sync behaviour from an arbitrary starting position

## Gears, yes — but the reason is compliance, not slip

**A properly tensioned GT2 toothed belt does not actually slip.** The slippage
instinct applies to friction drives. What a belt *does* have is **compliance**,
and under the torque ripple of a microstepping motor that shows up as **phase
jitter between crank and cam** — which is precisely the quantity being measured.

**Gears are the right call**, and their usual drawback does not apply here:
backlash matters at reversals, and this rig only ever turns one way, so it is
taken up once and stays taken up.

```
crank gear  20T          cam gear  40T          exactly 2:1
module 1 → 30 mm centre distance
```

**Printed spur gears are fine.** The load is two spinning discs. Tooth-to-tooth
error on a printed gear is well under a degree, against a cam-phase accuracy
requirement of perhaps ±5 crank degrees for correct stroke decisions.

### Layout note

At a 30 mm centre distance the cam shaft passes through the plane of a 150 mm
crank wheel. **Separate them axially** — gears meshing at one end, the two
targets on different stations along their shafts. Parallel shafts, two bearing
pairs, one motor on the crank shaft.

## The cam target is much easier than the crank wheel

CMP produces **one pulse per cam revolution** — a single feature, not 35.

So while the crank wheel must be a bought steel 36-1, the **cam target can be a
printed disc carrying one steel insert**: a bolt head, a dowel pin, a cut tab.
Only that one feature has to be ferromagnetic.

**That halves the bought-parts problem.** One steel wheel, not two.

## Make the cam phase adjustable — this is the point of the rig

Mount the cam target on a **hub that can be loosened, rotated and re-clamped.**

Fixed phase proves the decoder works at one relationship. **Adjustable phase lets
you sweep it**, which is how you find the case where the cam pulse coincides with
the missing tooth — a real engine has exactly one such relationship, and whether
your decoder survives it should not be discovered in the truck.

## What this makes the rig

M3 *and* M4 on one fixture, with the mechanical relationship the engine actually
has. The VR board has four channels; crank and cam use two, leaving room to add
an OSS target on the same shaft later for the transmission work.

---

# Bench notes for when the sensors arrive

## Measure both coils first

Before anything is wired, **measure resistance across each sensor's two pins**
and write it down.

- It confirms VR rather than Hall — a coil reads a few hundred ohms to ~2 kΩ.
- It is the **source impedance in series with the VR board's 5 kΩ legs**, which
  sets how much signal actually reaches the MAX9926.

Mode A2's adaptive threshold absorbs the gain effect either way, but the number
is worth having when a reading later looks wrong.

## Label them now, not later

CKP and CMP use the **same two-cavity connector**, which is convenient for wiring
and a trap on a bench. Once both are off the desk and into the rig they are
indistinguishable at a glance.

Mark the sensors and both pigtails **before** the first one gets plugged in.

## Two sensor mounts, independently adjustable

Print `sensor_mount()` twice. The crank and cam air gaps are separate
experiments and their specs may differ — each mount bolts to the base on its own
slots, so they can be set and swept independently.

## The measurement that closes an open hardware question

With a real sensor on a driven wheel, **measure VR peak voltage against rpm**.

That answers the one item left open on the VR board: whether 5 kΩ in 0805 — good
to about **150 V of sensor output** — needs the second resistor per leg before
the board goes in the truck. See
[`../../docs/review-vr-v1.md`](../../docs/review-vr-v1.md).

Extrapolate from whatever speed the rig reaches to 6000 rpm; VR output scales
with tooth speed, so a measurement at 1200 rpm scales to a defensible estimate
for redline.

---

# The cam trigger bolt — two things to get right

A bolt is the right idea. Two adjustments before drilling.

## Captive head plus a nut is right — but point the head inward

**The captive arrangement is the correct call.** A hex pocket puts the plastic in
**compression between head and nut** instead of relying on threads cut into
printed plastic, and the pocket gives anti-rotation for free.

**Flip which end faces the sensor, though.** Two independent reasons point the
same way:

**Mechanically, the head belongs on the inside.** Centripetal force pushes the
bolt *outward*. With the head in an inner pocket it bears against that load and
**cannot pull through** — the retention is geometric rather than relying on the
nut. A head on the outside means the nut is the only thing holding it in.

**Magnetically, it halves the feature width:**

```
M8 hex head, outward    13.0 mm across flats   ← ~2× the sensor pole
M8 shank end, outward    8.0 mm                ← matches a 5–8 mm pole
```

So: **head in a hex pocket on the inside, shank protruding outward, nut on the
inside as a jam nut.** Nothing steel on the outside except the 8 mm shank end
— which is exactly the feature you want.

**Keep the outside clear of other steel.** A nut or washer on the sensor side
adds a second, wider feature right where the measurement happens.

Air gap is then set by protrusion — bolt length and washers under the head give
the coarse setting, and the sensor mount's slots do the rest.

## Why width matters at all

A VR sensor's pole piece is roughly **5–8 mm**. A feature much wider than the
pole does not give a stronger pulse — it gives **two**.

The output is `-N·dΦ/dt`. A feature about the width of the pole produces one
bipolar swing with a single zero crossing at its centre. A **wide** feature
produces a positive pulse as the leading edge arrives, a **flat region with no
output** while it fully covers the pole, then a negative pulse as the trailing
edge leaves — and Mode A2 arms on each peak and triggers on each crossing.

**M8 is fine once the shank faces out** — the 8 mm end lands right in the pole's
range. It is only the 13 mm head that would have given two edges.

Two edges per revolution is survivable in any case: a real engine's cam target
is often a large vane and the decoder picks one edge consistently. But one clean
pulse is simpler to reason about on a bench where the decoder is what you are
trying to prove, not work around.

## Check the bolt is actually magnetic

**A2 and A4 stainless is austenitic and non-magnetic** — the same trap as the
trigger wheel. Plain, zinc-plated or black-oxide steel is fine.

**Touch a magnet to it before fitting.** Thirty seconds, and the failure mode
otherwise is a cam channel that produces nothing while everything looks correct.

## Mount it radially, in the rim

Thread it **radially into the rim with the head facing outward**, not axially
into the face. Two reasons:

- The crank sensor looks radially at the wheel's teeth. A radial cam bolt means
  **both sensor mounts are the same part in the same orientation.**
- **Threading the bolt in or out trims the cam air gap** directly, independently
  of the sensor mount.

Retain it with a locknut or thread-lock. The loads are trivial — a 5 g bolt at
30 mm radius and 600 rpm cam speed is about **0.6 N** — but a fastener working
loose in a spinning disc is not worth the risk for the cost of a nut.

## If you balance it, use a non-ferrous counterweight

The obvious fix for the imbalance is an identical bolt opposite. **Do not** — it
is also steel, and the sensor will see it. **One pulse per cam revolution
becomes two**, and it will look exactly like a decoder fault.

Brass or aluminium if you balance it at all. At these speeds the imbalance does
not need correcting.

---

# The wheel is 24 mm keyed — hub, and what the keyway is really for

A 24 mm bore is a **shaft size, not a bearing size** — common bearing IDs step
8, 10, 12, 15, 17, 20, **25**. So the wheel does not go on its own bearings; it
goes on an adapter.

`wheel_hub()` does that: **24 mm keyed spigot → 8 mm clamped bore**, with a bolt
circle on the flange so the 20T crank gear mounts to the same part.

## The keyway is an angular datum, not a torque path

The torque is trivial. Accelerating a 0.7 kg wheel to 1200 rpm in two seconds is

```
T = Iα = 1.94e-3 × 62.8 = 0.12 N·m      →  10 N at the 12 mm bore radius
```

A printed key carries that without thinking about it.

**What the keyway actually buys is repeatability.** Remove the wheel and refit
it, and it returns to *the same angle*. On a rig whose entire purpose is
comparing decoded position against commanded position, that is the difference
between a datum and a guess.

### ~~On this wheel the keyway is inline with the gap — the offset is zero~~

> **Falsified by the part.** `key_to_gap = 0` came from a vendor product photo.
> With the wheel in hand the keyway lines up with **the gap between the missing
> tooth and the next tooth** — the midpoint between two tooth centres, so
> **5.00° exactly, whatever the tooth width.** See
> [the correction below](#corrected-the-keyway-sits-half-a-pitch-from-the-missing-tooth).

The hub cuts its index flute at `key_to_gap`, so the flute on the flange OD
points at the missing tooth. Once the wheel is bolted on the teeth all look
alike; the flute is how you find the gap by eye.

The stepper drives the crank shaft 1:1, so steps map straight to crank degrees —
1.8°/step full, 0.1125° at 16× microstep. Home the stepper with the flute at the
sensor and **every commanded step count is a known crank angle**. The decoder can
then be checked on *absolute* position, not merely on whether it counts teeth and
finds *a* gap. That is the strongest test this rig can perform.

---

## The truck measures the same — so the rig is a calibration bench

Measured on the engine: the factory 5.4L puts the gap at TDC #1 as well. Rig and
truck share one datum, so `CKP_GAP_TO_TDC_DEG = 0` for both.

> ⚠ **This claim does not survive the wheel being identified.** The rig's wheel
> is a Dorman **917-060**, cast into the part. It *is* a modular V8 reluctor —
> Dorman lists **2002-2010 F-150 5.4** among others — but two things still break
> the shared datum: the applications **start at 2001 and the truck is a 1999**,
> and a customer review of this exact part reports that **its teeth do not match
> the OEM wheel**, causing timing codes and rough running.
>
> What the rig still is: the best available test of *decoder behaviour* — sync
> acquisition, cranking profiles, tooth counting, noise. What it is **not**, until
> the truck is measured separately, is the instrument that calibrates the truck's
> timing. And the older half of this claim has the same problem it always had:
> **how the engine figure was derived is not written down anywhere**, so it
> cannot be audited now that one of its inputs has moved.

It stays a **named constant rather than a disappeared zero** — not out of caution
about the measurement, but because the decoder needs somewhere to put the sensor
and conditioner offsets below, and they are not zero.

What this buys is bigger than skipping a calibration step. Because the rig's
absolute angle now *is* the engine's absolute angle, anything measured on the
bench transfers directly. **The rig stops being a functional check and becomes
the instrument that calibrates the truck's timing**, with no engine running.

### Still to pin down: which edge of the gap

A 36-1 wheel has 10° tooth pitch, so the missing tooth leaves a **20° span**
between the tooth before it and the tooth after. "The gap is at TDC" is therefore
ambiguous by up to 20° until the convention is stated:

- centre of the gap, or
- last tooth before it, or
- first tooth after it

Worth writing down which one the measurement used, since the decoder never fires
on the gap anyway — it *syncs* on the gap and then counts teeth to the spark
angle, so the count has to start from a named tooth.

### The conditioner's switch point is not the tooth edge

A VR sensor outputs dΦ/dt, so flux peaks — and the output crosses zero — when a
tooth is **centred on the pole piece**, not when its edge arrives.

Mode A2 switches at exactly that zero crossing. Table 1 of the MAX9924–MAX9927
datasheet: **ZERO_EN = GND, INT_THRS = GND → zero crossing enabled, adaptive peak
threshold enabled.** Both blocks are live. The adaptive threshold (33 % of the
previous peak) only decides *whether* the channel arms; the edge itself comes from
the zero-crossing detector at **−6.5 / +10 mV**.

**So the trigger point is the tooth centre, and nothing moves it.** Not amplitude,
not rpm, not acceleration — scaling a waveform cannot shift where it crosses zero.
There is no amplitude-dependent timing term to calibrate out.

*(An earlier revision of this file claimed Mode A2 switched at ⅓ of peak and that
the rig would need to characterise the resulting offset against rpm. That was
wrong — the 33 % is the arming threshold, and there is no such offset.)*

Propagation delay is **50 ns** on the zero-crossing path. At 6000 rpm that is
**0.0018°** — three orders of magnitude below anything that matters, and below
what the rig could measure. It needs no sweep and no correction.

What the rig should still measure is **amplitude against rpm**, because that
decides whether the 5 kΩ series resistors are right and whether the ±40 mA input
limit is approached. That is a signal-integrity question, not a timing one.

---

# Rendering the model

`vr_rig.scad` is plain OpenSCAD — no libraries, and nothing newer than 2015-era
language features, so the distro package is sufficient.

```sh
sudo apt install openscad          # Mint 22.3 ships 2021.01, which is fine here
```

The Flathub build (`flatpak install flathub org.openscad.OpenSCAD`) is newer if
you want it, but this file asks nothing of it.

## GUI

Open the file, then **Design → Preview (F5)** to look at it and **Render (F6)**
before exporting. Edit `part =` at the top to choose what is shown; `"assembly"`
is a clearance check, not something to print.

## Batch — every printable part to STL

`render.sh` does the lot — `-D` overrides the `part` variable per invocation and
`xargs -P` spreads them across cores (`base` is the slow one at ~25 s):

```sh
cd hardware/vr-test-rig
./render.sh        # all 8 parts, binary STL, one per core
```

Note the quoting: `part` is a *string*, so the inner quotes have to survive the
shell. `-D part=wheel_hub` without them passes an undefined variable and renders
the assembly instead — silently, which is the annoying part.

**The committed STLs churn on every render.** OpenSCAD 2021.01 is not
byte-deterministic — rendering the same unchanged file twice produces different
files. So a git diff on `stl/` means nothing, and "are these current?" cannot be
answered by hash. **`vr_rig.scad` is the source of truth**; the STLs are a
convenience so the parts can be printed without installing OpenSCAD. Re-run
`render.sh` after any change and do not read anything into the diff.

Print quantities: **4 × bearing_block** (two shafts), **2 × sensor_mount** (crank
and cam), 1 each of the rest. **`base` is not printed** — it is a 320 × 240 board,
and the module is its drilling template. See [BOM.md](BOM.md). `hub` is the superseded 25.4 mm plain-bore version, kept only
for reference — **`wheel_hub` is the one that fits the wheel you bought.**

## The gears

`spur_gear(z)` generates real involute teeth — no library, no bought gears
needed to start. `part = "crank_gear"` and `"cam_gear"`.

The involute is built from `inv(a) = tan(a) - a`: at radius `r` the flank sits at
polar angle `inv(acos(rb/r))`, offset so it crosses the pitch circle at half a
tooth thickness. Below the base circle the involute does not exist, so the flank
runs radially to the root — correct here because at 20° PA the root is inside the
base circle for any `z < 41`, and both gears qualify.

Checked before committing: **20T clears the undercut limit** (17.1 teeth at 20°
PA, so no profile shift needed), and tip thickness is **1.39 mm on the 20T,
1.52 mm on the 40T** — teeth, not knife edges.

The split clamp's slit **stops at the gear face** so it never cuts through a
tooth; the boss grips the shaft and the gear body just goes along.

Print **teeth flat on the bed**, for the same reason the hub prints bore-up: the
profile is then an X-Y path rather than a layer stack.

See [BOM.md](BOM.md) for why module 2 and not module 1, and for the printed-now,
steel-later path.

---

# Rendered and checked

All eight parts export clean on OpenSCAD 2021.01 — no warnings, no errors — and
the gear geometry was verified against the numbers rather than eyeballed:

```
crank_gear   tip radius 22.000 mm   20 teeth   18.000 deg pitch
cam_gear     tip radius 42.000 mm   40 teeth    9.000 deg pitch
```

Bounding boxes match design intent to 0.02 mm, and `cam_target` was checked to
confirm the counterweight boss stays inside the 30 mm rim — it must never
protrude toward the sensor across a 1 mm air gap.

## The bearing bore was 90 degrees off the shaft

Found during assembly, which is an expensive place to find it and still far
cheaper than after the shaft went in.

```
base    blocks at x -30 and +30, both y 0   -> shaft on X
base    wheel slot narrow in x, long in y   -> shaft on X
wheel   rotate([0,90,0]) disc               -> axis on X
block   rotate([-90,0,0]) bore              -> bore on Y   <-- wrong
```

The block was not internally wrong. `blk_t` is sized to the bearing's **width**
and `blk_w` to its **diameter**, so its body is correct for a Y bore. What never
matched was its orientation on the base — and nothing in the model compared the
two, so both halves rendered cleanly and looked right for as long as nobody
tried to put a shaft through them.

**Blocks printed before this fix are still good.** The part did not change, only
how it sits: turn one 90° and the bore lands on X. What moves is the **base's**
bolt pattern — ±22 x / ±11 y becomes **±11 x / ±22 y**.

On an already-printed base that is 16 new holes, four per station. The old ones
foul nothing: the rotated foot spans ±17 in x, so the old ±22 holes sit just
outside it.

Verified by sweeping a rod along each axis through the bearing centre — clear on
X, solid on Y, and solid on X at two heights *below* the bearing so the test had
a way to fail.

### The motor mount had it too

Spur gears will not mesh unless their axes are parallel, and the gears are
placed `rotate([0,-90,0])` — axes on X. The motor mount bored on Y like the
bearing block, so the motor would have driven at 90° to the gears it turns. It
also couples **directly** to the crank shaft (`x_motor = -95`, gears at
`x_gear = 70`), so its bore has to be not merely parallel but coaxial.

Same fix, same consequence: printed mounts are fine, and the base's two motor
bolts move from `(x_motor ±29.15, 3)` to `(x_motor − 3, ±29.15)`.

### The invariant that would have caught both

Every part that turns about the shaft is placed with `rotate([0,±90,0])`:

| part | placement | axis |
|---|---|---|
| `wheel_hub`, wheel disc | `rotate([0,90,0])` | X ✓ |
| `crank_gear`, `cam_gear`, `cam_target` | `rotate([0,-90,0])` | X ✓ |
| ~~`bearing_block`~~, ~~`motor_mount`~~ | *placed unrotated* | **Y ✗** |

> Those are *placements*, not quantities. `crank_gear` and `cam_gear` are both
> rendered by the `spur_gear` module with different tooth counts, and you print
> **one of each** — 20T on the crank, 40T on the cam. An earlier revision of this
> table said "`spur_gear` ×2", which reads as a print quantity and is not one.

The two that were wrong are exactly the two placed without a rotation, and an
audit of the assembly block finds them in one pass. The sensor mounts are
brackets rather than bearings, so they have no axis to get wrong.

## Two things that check caught

**The key was not a key.** It spanned `wheel_bore/2 - key_d` to `wheel_bore/2`,
which is *inside* the spigot — it stood proud by 0.13 mm and would have engaged
nothing. The key has to run outward from the spigot surface into the slot cut in
the wheel's bore. Now 3.33 mm proud, as a DIN 6885 key on a 24 mm bore should be.

**`Volumes: 2` is not a fault.** Every split-clamp part reports it. CGAL counts
the unbounded outer volume alongside the solid, so a healthy single body reports
two. Confirmed by walking the mesh: one connected component. Worth knowing before
it sends you hunting for a stray fragment.

## Tessellation is deliberate, not default

`$fn = 64` everywhere cost minutes — the base's 192-hole M4 grid alone is 12 288
facets of subtraction. Chord error is `r(1 - cos(180/n))`, so a 4.4 mm clearance
hole at `$fn = 16` is off by 0.04 mm, under what the printer resolves. The
facets are now spent only where a fit depends on them:

| | | |
|---|--:|---|
| `hole_fn` | 16 | M3/M4 clearance |
| `$fn` | 32 | general |
| `fit_fn` | 64 | bearing pocket, shaft and sensor bores |
| `root_fn` | 120 | gear root circle |

`base` went from over two minutes to 26 s, with nothing given up that a 0.4 mm
nozzle could reproduce.

---

# Before the parts arrive

Four things, none of which need a single bought component.

## 1. Print it — this is the long pole

Twelve pieces from eight files. Orientation matters more than usual on two of
them (`wheel_hub` bore-axis vertical, gears teeth-flat) — see the table above.

## 2. Order the rest of the BOM

The wheel and both sensors are ordered. Everything in
[BOM.md](BOM.md) under **Drive** and **Shafts, bearings, hardware** is not.

## 3. Write the step generator

RP2040 PIO, and it can be written and tested with a logic analyser before any of
the rig exists. **Deceleration ramps are a firmware requirement, not a nicety** —
see [BOM.md](BOM.md): the wheel's 15 J has nowhere to go on a switching supply,
and no practical bulk capacitor absorbs a hard stop. **The valuable part is not constant-speed stepping** — it is a
programmed *cranking* profile, with the engine slowing against each compression
stroke and surging after it. A rig that only spins smoothly never tests the
regime where sync acquisition actually fails.

## 4. Measure the wheel BEFORE printing the base or brackets

The product photo (Dorman **917-060**, square-on so the ratios are trustworthy)
was measured, and it settles two things and unsettles a third.

### Confirmed: it is genuinely 36-1, and the keyway is on the gap

| | |
|---|---|
| Tooth pitch | **10.00°** → 36 positions |
| One wide space | **2.00× pitch** — the missing tooth |
| Missing tooth at | 102.7° |
| **Keyway at** | **105.0°** |
| **Apart** | **2.3°** — inside the measurement's own precision |

~~**So the datum holds.** The keyway really is on the missing tooth, which is what
makes `CKP_GAP_TO_TDC_DEG = 0` and the whole absolute-position method work.~~

> **Superseded — and the 2.3° was the clue, not the noise.** The part says the
> keyway sits in the gap *after* the missing tooth, **5.00°** from its centre —
> half a pitch. The photo said 2.3°. Both readings sighted a radius outward from
> the keyway, which is the noisy end of the wheel by a factor of 3–5. See
> [the correction](#corrected-the-keyway-sits-half-a-pitch-from-the-missing-tooth).

It is also **already drilled** — four holes are visible. Wheel retention is
answered; the hub's bolt circle just has to match whatever they actually are.

### Corrected: the keyway sits half a pitch from the missing tooth

**Measured on the physical wheel, 2026-09-19**, and corrected the same day after
the first look turned out to be *from the back of the wheel*:

> The keyway lines up with **the gap between the missing tooth and the next
> tooth**.

#### 5.00°, and this time the tooth width does not matter

That gap runs from the missing tooth's edge to the next tooth's edge, so its
centre is the **midpoint between two tooth centres** — one at the missing
position, one a pitch away. Midpoint of 0° and 10.00° is **5.00°**, and the tooth
width cancels:

```
gap spans   w/2  ..  pitch - w/2          (w = tooth width)
centre    = (w/2 + pitch - w/2) / 2 = pitch/2 = 5.00 deg   for any w
```

`key_to_gap = 5.0` is therefore **exact and duty-free**, where the first reading
— "the rear edge of the tooth just forward" — gave 7.5° *and needed the tooth
width to say so*. The rear edge is the far boundary of this very gap, so the two
readings are the same feature described twice; the second one is simply the
better description, because the centre of a gap is a stronger datum than its
edge.

The remaining uncertainty is the **width of the gap the keyway sits in**: 10 − w,
so **±2.5°** at 50 % duty. That is now the *only* thing tooth width is needed
for, and it bounds the answer rather than setting it.

> **TDC falls between two tooth positions, not on one.** 5.00° is half a pitch,
> so if the keyway is the crank's TDC datum then TDC lands exactly midway between
> tooth centres — the furthest point from any edge. That is a sensible thing to
> design on purpose, and a strange thing to happen by accident.
>
> ✅ **This instinct was right**, and the file then spent several sections
> arguing against it. [Resolved in its
> favour](#-and-500-was-never-a-measurement--the-exactly-half-a-pitch-alarm-was-circular).
> ⚠ But note what the box below makes explicit: **5.00° is the midpoint of the
> observed interval, not a reading.** The true value is somewhere in 2–8°, so
> "exactly half a pitch" cannot itself be used as evidence of anything.

#### Sign, settled — by the engine rather than by the wheel

The rig's own convention was ambiguous and the first reading got it backwards
(the wheel was face-down). The fix is to stop defining it geometrically:

> **`key_to_gap` is the crank rotation from the gap passing the sensor until the
> keyway passes the sensor.** Always positive. **+5.00°.**

That is operational — it names two events in the order they happen, so it cannot
be mirrored by picking up the wheel the other way round. It is also exactly how
the part was read: *the missing tooth goes by, and TDC is coming up.*

⚠ The `.scad` still needs a geometric sense for the index flute, and **that one
does depend on which way the rig spins.** It is flagged in the file.

#### The part is marked — it IS the Dorman, and the inference above was wrong

The front face is cast **`FRONT 917-060 53025 TAIWAN`**. It is the Dorman
917-060, exactly the part the `.scad` was dimensioned from.

> ~~*"A keyway that falls on the crank's TDC datum is a factory part. This is the
> Ford 5.4L crank trigger wheel, not the Dorman."*~~ **Wrong, and the flaw was in
> the premise:** it equated *aftermarket* with *universal*. The 917-060 is an
> **OE-replacement reluctor for a named application**, not a blank broached to
> fit a shaft — so its keyway is cut to put the gap where that engine's ECU
> expects it. The keyway relating to TDC is exactly what a direct-fit replacement
> part does, and it needed no Ford casting to explain.

**It is not a Small Block Ford part either — that was the listing's third error.**
Dorman's own catalogue puts 917-060 on **modular V8s**: 2001-2010 F-150 4.6,
**2002-2010 F-150 5.4**, Crown Victoria, Mustang, Explorer, Expedition,
Navigator, Mountaineer. **35 teeth**, steel, cross-referenced to OE
**XW1Z-12A227-AC**. The ~135 mm we measured is a modular reluctor's size, and it
agrees.

So the engine-family objection is withdrawn. **Two better ones replace it.**

| | |
|---|---|
| **5.00° is the rig's `key_to_gap`** | ✅ measured, and it is this wheel's |
| **5.00° is the truck's `CKP_GAP_TO_TDC_DEG`** | ❌ **still no** — for the two reasons below |

**First — and this one mostly dissolves on inspection.** Dorman's listed years all
start at 2001 while the truck is a 1999, which looked like a design boundary.
**The OE number it supersedes says otherwise.**

`XW1Z-12A227-AC`, read with the same scheme this project used on the donor PCM's
`1L2F-12A650-ANC` ([`DonorECU/README.md`](../../docs/DonorECU/README.md), where
`1` = 2001):

| | |
|---|---|
| **`X`** | **1999 model year** — `X` = 1999 and `Y` = 2000, before Ford went numeric at `1` = 2001 |
| `W1` | vehicle line |
| `Z` | service part |
| `12A227` | the pulse ring — same `12A…` ignition family as the PCM's `12A650` |
| `-AC` | third revision: `AA`, `AB`, `AC` |

A prefix dates when the *number* was created, not the years it serves. But a
**1999-created base number, revised twice, still cataloged for 2001-2010**, means
one reluctor design spans 1999→2010 — so **the 2001 start is a cataloging
artifact, not a design change.**

##### Read the casting on the OEM wheel *before* reading the teeth

This is the ordering that matters, because the same tooth observation means two
opposite things depending on it:

| the OEM wheel is cast… | then a stagger at the rim means |
|---|---|
| **`XW1Z-12A227`** (or supersedes to it) | The Dorman is the **correct** part — so any stagger is a **manufacturing defect**, exactly what the review alleges |
| **a different base number** | The Dorman is simply the **wrong part** for a 1999 — a stagger is **expected**, and says nothing about Dorman's quality |

~~The OEM wheel has casting text around its hub face in [the photo], so that
number is worth having first.~~ ⚠ **Struck — that photo is the reviewer's, and
the OEM wheel is not in hand.** The casting is behind the timing cover, and the
whole ordering question below is [moot for a different
reason](#-and-this-is-what-makes-the-retraction-cheap): the constant is measured
directly, not inferred from which wheel it is.

**Second, and this is the one that matters:** a customer review of this exact
part reports

> *"The teeth on the wheel don't exactly match up to the OEM one, this matters
> because this is where the computer reads off the crank sensor. Use this
> pulsator ring and your engine will have timing codes and run rough."*

#### ~~That review may be describing the number we measured~~ — withdrawn

> ⚠ **This section is kept for the record and is no longer believed.** It rests
> on `key_to_gap(OEM) ≈ 0`, which was never verified, and on a photograph whose
> [artefact budget exceeds the whole disputed
> quantity](#-the-drift-is-there-in-the-photo--and-the-camera-can-manufacture-all-of-it).
> Worse, its headline number is
> [a midpoint read back as evidence](#-and-500-was-never-a-measurement--the-exactly-half-a-pitch-alarm-was-circular).

The README's prior belief was that **the factory wheel puts the gap at TDC** —
`key_to_gap ≈ 0`. This Dorman measures **5.00°**. That is **exactly half a tooth
pitch**, and half a pitch of crank-angle error is precisely the magnitude that
makes an engine *run badly and set codes* rather than *not start*:

| error | symptom |
|---|---|
| a whole pitch, 10° | gross; likely no-start or violent misfire |
| **half a pitch, 5.00°** | **runs, runs rough, sets timing codes** ← the review |
| a degree or two | probably unnoticed |

**This is a hypothesis, not a conclusion** — "the teeth don't match" could also
mean tooth width, profile or runout. ~~But it is testable in one reading: measure
the OEM wheel's key-to-gap.~~ ⚠ **Not that way** — the OEM wheel is behind the
timing cover. **The genuine Ford ring tests it instead**, on a bench, and answers
the same question: if `key_to_gap(Ford)` comes back near 0 while this one is
5.00°, the review is explained and this project measured a documented defect
without knowing the defect existed.

#### ⚠ RETRACTED — the photographs are the reviewer's engine, not this truck

**The timing cover on this truck has never been off.** Both PNGs in
`docs/1999-Ford-F150-4wd-5.42v/` came from the customer review, not from here,
and three commits read them as if they were ours. What this project has in its
hands is **one wheel: the Dorman**. The OEM wheel has never been seen except in
somebody else's photograph.

| claimed | actually |
|---|---|
| ~~"Both wheels are on the crank on one key — the test is already rigged"~~ | **The reviewer's crank.** Nothing is rigged here |
| ~~"Both wheels are in hand"~~ | **One is.** The Dorman |
| ~~"The OEM wheel has casting text around its hub face … the wheel is in hand"~~ | **It is not in hand**, and that casting read is not available short of pulling the cover |
| ~~"⏳ The front cover is off — that is the window"~~ | **The cover is on.** No window, no urgency |

**The tell was in the file the whole time.** The two review images are `.png` —
screenshots — while every photograph taken here is `.jpg` off a camera
(`36-1Wheel.jpg`, `36-1Wheel-Front.jpg`).

> ⚠ **Record provenance when an image lands.** A photograph is evidence about
> *that* part on *that* vehicle. Three commits turned on an implicit "ours" that
> nothing in the file ever actually said.

##### What the reviewer's photo is still worth — and what it cannot settle

It is not worthless. It is **the very test this file then went on to design**,
already performed by someone else: two wheels, one crank, cover off. But as
second-hand evidence it carries unknowns that no amount of looking will close.

| unknown | why it bites |
|---|---|
| **What year is the reviewer's truck?** | If a 2003, 917-060 *is* the cataloged part, their stagger is a Dorman defect, and it says nothing about a 1999. If a 1999, defect and wrong-year are **confounded** and the photo cannot separate them |
| **Is their Dorman keyed, or just held up?** | A pry tool is in frame and the new wheel sits bright and proud of the chains. **Two wheels free to rotate on a shared bore say nothing** — this file's own warning, and it applies to other people's photos first |
| **Which row of teeth is which?** | Assumed from the filename, never established |

So the review's *claim* now has a photograph beside it, which is more than it had
before. It is still a claim about somebody else's parts.

##### ⚠ The drift is there in the photo — and the camera can manufacture all of it

**Observed:** the Dorman's teeth run out of register with the OEM row, worst
around **120°**, and back into register at the missing tooth. *"There may be a
degree of variance."* Both tooth rows are genuinely visible — the OEM's rusty
square tops behind the Dorman's bright ones — and the offset genuinely varies
along the rim. **The observation is real. The attribution is the problem.**

**Two coaxial tooth rings at different depths, photographed off-axis, produce
exactly this signature from projection alone.** The far ring's projected centre
is displaced from the near ring's by `Δz·sin α`, so a tooth at radius `r` picks
up an apparent angular shift

```
δ(θ) ≈ (Δz · sin α / r) · sin(θ − φ)
```

— **a once-per-revolution sinusoid with two nulls 180° apart.** Drift out, come
back in. There is no defect in that equation.

**And the magnitudes are not small.** At `r ≈ 65 mm`:

| axial separation `Δz` | α = 20° | 30° | 40° | 55° |
|--:|--:|--:|--:|--:|
| 6 mm | 1.8° | 2.6° | 3.4° | 4.3° |
| **10 mm** | 3.0° | 4.4° | **5.7°** | 7.2° |
| 12 mm | 3.6° | 5.3° | 6.8° | 8.7° |

> ⚠ **At a 10 mm axial separation, a 35° camera angle manufactures exactly the
> 5.00° half-pitch stagger the Dorman is being blamed for.** That shot is at
> least that oblique. **Parallax can account for the whole effect**, nulls and
> all.

##### A second artefact, and it is the one that does the damage

**The camera is not looking down the axis, so it never sees the two tooth rows'
side faces in the same plane.** That is a distinct error from the centre-offset
parallax above, and it adds to it.

A tooth has axial thickness `t`. Viewed at `α` off the axis, its near-face edge
and far-face edge project to different angular positions, smeared by `t·sin α/r`
— and **the OEM row is partly occluded by the Dorman**, so which of its edges is
visible changes around the rim. You are not comparing the same feature to
itself:

| tooth thickness | α = 20° | 30° | 40° | 55° |
|--:|--:|--:|--:|--:|
| 3 mm | 0.9° | 1.3° | 1.7° | 2.2° |
| **5 mm** | 1.5° | **2.2°** | **2.8°** | 3.6° |
| 6 mm | 1.8° | 2.6° | 3.4° | 4.3° |

**Artefact budget, added up:** 3–7° of centre parallax **plus** 2–3° of
edge-selection. **That is the whole disputed quantity several times over**, on a
5.00° question. There is no headroom left in this photograph for a real signal.

> ⚠ **And oblique photography is a *biased* instrument, not just a noisy one.**
> Both terms **add** apparent offset; neither cancels a real one except at the
> two nulls. So an off-axis view is systematically biased **toward finding a
> defect** — it cannot manufacture agreement, only disagreement.
>
> **Which may be the whole story of the review.** A reviewer looking at their own
> oblique view, seeing teeth not line up, and blaming the part is the same
> mechanism that fooled this file twice. That is not proof they were wrong. It is
> a quantified, sufficient explanation for what they reported, and it needs no
> defect in it.

##### ⚠ And 5.00° was never a measurement — the "exactly half a pitch" alarm was circular

This is the one that matters most, and it is a mistake in this file rather than
in a photograph. Re-read
[the derivation](#500-and-this-time-the-tooth-width-does-not-matter): what was
*observed* is that **the keyway sits somewhere in the gap** between the missing
tooth's edge and the next tooth's edge. **5.00° is the midpoint of that
interval**, computed, not read:

```
tooth width w ≈ 5 mm at OD 135  →  4.2° of arc
interval          2.1° .............. 7.9°
midpoint          ^^^^^ 5.00° ^^^^^     ± 2.9°
```

**So "exactly half a pitch" is arithmetic, not a coincidence.** *Any* keyway
observed to lie in that gap returns exactly half a pitch as its midpoint
estimate. The file then treated that exactness as suspicious — *"half a pitch is
precisely the magnitude that makes an engine run rough"* — and that reasoning is
**circular**: the value came from the midpoint, and was then read back as
evidence.

**The true figure is somewhere in 2–8°.** Which resolves a contradiction this
file has been carrying:

| claim | verdict |
|---|---|
| `key_to_gap ≈ 0` is **falsified** | ✅ **Stands.** Zero is outside the observed interval — the keyway is not on the gap |
| The Dorman is **half a pitch out vs OEM** | ⛔ **Withdrawn.** This needs `key_to_gap(OEM) ≈ 0`, which was **assumed and never verified**. The only evidence ever offered for it was the photograph |
| *"TDC midway between tooth centres is sensible by design, strange by accident"* | ✅ **This was the right instinct**, and it contradicted the defect reading. Resolve in its favour |

> **The defect hypothesis rests entirely on an assumption about a wheel nobody
> here has seen.** Written down plainly it does not survive. **Downgrade it: the
> Dorman is not suspect until something that is not a camera says so.**

**Nothing in the plan changes** — count the teeth, log the wheel, let the Ford
ring arbitrate at the end. Only the prior changes, and it changes a lot: this
file should stop writing as though it is holding a defective part.

> ⚠ The [rule barring the Dorman from the truck](#the-operational-rule-either-way)
> now rests on a stranger's unquantified sentence and nothing else. It is still
> free to obey — the cover is on and nothing is being fitted — so it stays. But
> it is a precaution now, not a finding.

##### The arithmetic that settles it without any photograph

**On a closed circle, mean pitch is fixed by tooth count: 360/N.** Two wheels
with the same number of teeth have identical average spacing *by construction*
and **cannot accumulate drift over a revolution**. Only a constant offset is
possible between them.

So a stagger that **varies** around the rim has exactly two explanations, and
they are very far apart:

| | |
|---|---|
| **Different tooth counts** | Real, gross, and **countable in ten seconds** on parts in hand |
| **Not real** | Projection, i.e. the camera |

Dorman publishes **35**. If the OEM row is also 35, **a varying stagger is
arithmetically impossible** and the photo is showing parallax. That is a
one-line test that needs no rig, no calipers and no datum.

**And if the drift were real, 120° is a very loud number.** One pitch of slip
per 120° is **three pitches per revolution** — a 3-tooth difference, 36 vs 33 or
39. Nobody would need a photograph.

> ⚠ **Beware the aliasing.** *"Comes back in phase"* is ambiguous: teeth are
> identical, so the rows look aligned at **every whole pitch of slip**, not only
> at zero. Apparent re-registration is consistent with 0°, 10°, 20°… and the
> photo cannot tell them apart. Only the **gap** is a unique feature — which is
> why it is the only landmark in that image worth trusting.

##### What *"a degree of variance"* would mean, if it is the real number

One degree is **a tenth of a tooth pitch**. Placed against everything else in
this file:

| | |
|---|---|
| This photograph | ⛔ **cannot resolve it** — 1° is ~5 native pixels at that rim, and the parallax term is 3–7× larger |
| The parallax term | **3–7°**, so 1° is buried inside the artefact |
| Keyway slop on the rig | **±0.2°** — resolvable |
| A tooth log | **0.002°** — trivially resolvable |

**And a 1° result would kill the half-pitch hypothesis rather than support it.**
This file's own table puts *"a degree or two"* at **probably unnoticed**, against
*"half a pitch → runs rough, sets timing codes"*. If the true figure is ~1°, the
review's complaint is not a phase complaint and we should stop reading it as one.

##### The VR sensor is immune to this entire class of error

Worth stating plainly, because it is the strongest argument yet for
[the tooth log](#-better-than-looking-spin-each-wheel-and-diff-the-tooth-logs):
**a sensor occupies one fixed point and time-stamps teeth as they arrive.** There
is no projection, no camera angle, no axial separation and no foreshortening —
the entire parallax term is structurally absent, not merely small.

**Every wheel reading this project has got wrong, it got wrong from a
photograph**: the keyway on the gap, the 171.45 mm OD, the face it was looking
at, whose engine it was, and now very probably this. **Stop measuring wheels with
cameras.**

> ✅ **If a photo is taken anyway, square-on is not a style preference.** `α = 0`
> makes `sin α = 0` and the parallax term vanishes *identically*, not
> approximately. That is the reason the [photo
> spec](#the-decisive-test-stack-the-two-wheels-do-not-measure-either-one) asks
> for it.

**The stack *method* survives** — it loses its parts, not its logic. Whatever
stagger a registered rim shows IS `key_to_gap(A) − key_to_gap(B)`, and
[the procedure is written out
below](#the-decisive-test-stack-the-two-wheels-do-not-measure-either-one). It
runs the day a second wheel is on the bench.

> **And it is a look, not a photograph** — which is precisely the rule that was
> just broken. I have now misread this wheel from photos three times: twice on
> which face I was seeing, once on whose engine it was.

*(Worth keeping from the reviewer's photo, since it is a claim about the part
rather than about their truck: it is installed **`FRONT` facing forward** — the
same face the clockwise sign convention above is written against.)*

#### ~~⏳ The front cover is off — that is the window~~ — it is on, and the constant never needed it off

The cover-off look was never available here. **And it costs almost nothing**,
because the route that works with the cover on is better on the merits, not just
on access. ~~*Piston stop on #1, bring it to TDC, read where the gap sits
relative to the CKP sensor.*~~

##### ⭐⭐ Trigger a timing light off the sync gap

Everything that reading needed is reachable from outside the engine:

1. **Piston stop on #1 — cover on, one plug out.** This half never needed the
   cover off at all. Mark true TDC on the damper and lay a degree tape from it.
2. **Trigger a timing light from the decoder's sync-gap event** instead of from a
   plug wire. TritonECU already finds the gap; a GPIO pulse on gap-detect into
   the light's trigger input is the whole modification.
3. **Read the damper.** The light flashes as the gap passes the sensor, so the
   tape reads `CKP_GAP_TO_TDC_DEG` off the real crank, at speed, in one look.

**Why this is better than the cover-off eyeball it replaces:**

| | cover off, by eye | timing light off the gap |
|---|---|---|
| Resolution | a wheel rim down a dark hole | a degree tape at **damper radius**, strobed |
| What it includes | wheel + sensor angle | wheel + sensor angle **+ the conditioner** — the chain the firmware actually times off |
| Engine state | static | **running**, so any rpm-dependent term shows itself |
| Access | damper, accessories, cover | one spark plug and a jumper |

And the conditioner term comes for free rather than as a worry: Mode A2 switches
at the **tooth centre** on a zero crossing, with [50 ns of propagation
delay](#the-conditioners-switch-point-is-not-the-tooth-edge) — 0.0018° at
6000 rpm. The strobe therefore fires on a defined wheel feature, and the tape
gives the number the firmware wants, not a proxy for it.

> This is the same argument as [the rig measuring its own flute
> offset](#the-rig-can-measure-this-on-itself-to-01): **the constant belongs in
> firmware, measured by the thing that consumes it.** The truck deserves what the
> bench was already getting.

##### ⭐ And this is what makes the retraction cheap

`CKP_GAP_TO_TDC_DEG` measured this way **does not care what wheel is on the
crank.** It reads the truck's own fitted wheel, whatever it is, through the
truck's own sensor and conditioner. The entire wheel-identification thread above
— Dorman or Ford, XW1Z or not, 1999 or 2001 — was only ever a way to *predict*
this number. **The prediction route died with the photographs; the direct route
was always the better one, and it was never behind the cover.**

> **Whichever wheel stays on the engine, the calibration belongs to that wheel.**
> Mark it. `CKP_GAP_TO_TDC_DEG` is measured *with the fitted wheel*, and swapping
> wheels later — in either direction — invalidates it.
>
> ✅ **And no swap is in prospect.** The cover is on, the truck keeps its own
> wheel, and the strobe reads that wheel directly. The rule stands but has
> nothing to bite on — which is the comfortable way for a rule to stand.

#### The decisive test: stack the two wheels, do not measure either one

⚠ **One wheel is in hand, not two** — the OEM-under-Dorman photo is the
reviewer's. This section is written for the day a second wheel arrives, and the
[genuine `XW1Z`](#-the-ford-ring-is-the-final-validation--the-dorman-builds-the-rig)
is that wheel. **Stacking beats measuring**, for the reason this
whole thread keeps running into: every attempt so far sighted a radius outward
*from the keyway*, which is the innermost feature on the wheel and therefore the
noisiest — 2.6–4.1° per millimetre of slip. Comparing two rims directly moves the
reading to r ≈ 65 mm, where the same slip is **0.7–0.9°**. It also needs no
absolute angular reference at all: the question becomes *"do these edges
coincide?"*, which has no datum in it.

> ⚠ **It only works if the keyways are registered.** Two wheels free to rotate on
> a shared bore tell you nothing. Put a key, or a close-fitting bar, through both
> keyways — or thread both onto a shaft with a key — before reading the rim.

**Four signatures, and they are distinguishable at a glance:**

| what the rim shows | what it means |
|---|---|
| **Uniform stagger all the way round**, gap included | **Phase error.** Read it at the rim in tooth-widths. **Half a pitch confirms the 5.00° and explains the review** |
| Gap in a *completely different place* | Phase error of a whole number of pitches — grosser, and a no-start rather than rough running |
| Aligned somewhere, **walking apart** as you go round | Different **pitch** — tooth count or pitch-circle mismatch. Would be a blatant defect |
| Centres aligned, one set's teeth **fatter** | **Duty/width difference.** Shifts *edges* by half the difference while leaving centres alone — a smaller effect, and it only bites if the decoder times off a single edge |
| **Stagger that grows and shrinks smoothly, nulling twice per revolution** | ⚠ **Your camera.** [Parallax between two axially separated rings](#-the-drift-is-there-in-the-photo--and-the-camera-can-manufacture-all-of-it) — 3–7° of pure artefact at a typical oblique angle. **Not a wheel property.** Shoot square-on and it vanishes identically |

**Compare the two ODs in the same shot while they are stacked.** A diameter
difference changes the sensor **air gap** as well, which is an independent fault
mode and would not show up in any angular measurement.

**What a readable photo needs:** square-on to the faces, with the rim filling the
frame. The tooth edges are the measurement, and they need more than the ~15 px
they get in a three-quarter view of the whole wheel.

#### ⭐⭐ Better than looking: spin each wheel and diff the tooth logs

**Don't read the stack by eye — read it through the sensor.** `startToothLog()`
already exists, the rig already spins a wheel past a real VR sensor, and a
period log is a *number* where a stacked rim is a judgement call. This upgrades
the test above rather than replacing it.

##### What the existing log already gives, with no datum of any kind

`CrankSensor` logs `periodUs` per edge into a **720-entry** buffer — 35 events
per revolution, so **20.6 revolutions** per capture — and tags each with
`toothNum`, which resets at the gap. **That tag is the physical tooth index**,
so periods can be averaged per-tooth across all 20 revs for a **4.5×** noise
reduction, straight out of the existing format.

| what falls out | how it appears in the log |
|---|---|
| **Per-tooth pitch error** ⭐ | Group by `toothNum`, average, compare against 10.000°. This is a **fingerprint of the wheel**, and two wheels' fingerprints subtract |
| **Runout / eccentricity** ⭐ | A **once-per-revolution sinusoid** in the intervals. An independent fault mode, and no angular datum is needed to see it |
| **Tooth count and gap width** | Directly. Confirms 36-1 rather than something adjacent |
| **Tooth width / duty** | Only if both edges are captured — the ISR is `FALLING` only, so **this one needs a change** or it is not measured |
| **OD / air-gap mismatch** | Amplitude, not timing. Zero crossings do not move with amplitude |

**And the timebase is not the limit.** `esp_timer_get_time()` is 1 µs, and one
microsecond is a very small angle:

| rig speed | tooth period | 1 µs as crank angle | capture length |
|--:|--:|--:|--:|
| 300 rpm | 5556 µs | **0.0018°** | 4.1 s |
| 600 rpm | 2778 µs | 0.0036° | 2.1 s |
| 1200 rpm | 1389 µs | 0.0072° | 1.0 s |

That is **60× finer than the stepper's 0.1125°** at 300 rpm, so the microstep
figure bounds only the *index* reading, never the tooth data. **Slower is
better** for angular resolution — but VR output scales with speed and the
conditioner's 33 % adaptive threshold has to arm, so there is a floor. The real
limit is the fixture and ISR jitter, not the clock.

> ⚠ The ISR is `attachInterrupt` + `esp_timer_get_time()`, **not** hardware timer
> capture as `CLAUDE.md` claims. It is on core 1 with no WiFi, so jitter should
> be ~1 µs — but that is an assumption, and the repeatability run below measures
> it rather than trusting it.

##### ⚠ But a self-referenced log is blind to phase — which is the thing alleged

This is the catch, and it is worth being blunt about: **a pure phase offset
produces a perfect tooth log.** Every pitch reads 10.000°, the gap is exactly
where a 36-1's gap belongs, and there is nothing anomalous anywhere in the file.

**The log resets `toothNum` at the gap, so the gap is the origin by
construction** — and you cannot measure an origin against itself. A wheel whose
keyway is half a pitch out logs *identically* to one that is perfect.

**And phase is the most likely reading of the review.** *"Teeth don't match up"*
plus *runs rough and sets codes* is the signature of the gap being in the wrong
place, not of the teeth being unevenly spaced. So the log as it stands would
**pass the very wheel the review is complaining about**.

##### The fix costs nothing: stack them and log the union

Same setup as the eyeball stack — both wheels keyed on one shaft — but read
through the sensor instead of by eye. **One sensor sees both tooth sets at
once**, and the phase offset is no longer a judgement call:

| stagger | what the log looks like |
|---|---|
| **0 — in phase** | 35 events, one gap. Indistinguishable from one wheel |
| **δ, small** | **70 events in close pairs**, alternating `δ` and `10−δ`. The pair spacing **is** the answer, read in µs |
| **5.00° — half a pitch** | **70 evenly spaced events.** The log becomes a clean **72-2**, and it is unmistakable at a glance in the data |
| **whole pitches** | Two gaps in different places |

**Nothing needs writing for this.** The logging block sits *after* the sync state
machine and runs on `_toothLogCapturing` alone, so **periods are captured even
when the decoder cannot sync** — which is exactly the stacked case. Better
still, call `begin(pin, 72, 2)` for the stacked run and the decoder syncs
properly, restoring `toothNum` labelling and per-tooth averaging.

> ⚠ **This needs the two ODs to match.** Different diameters mean different air
> gaps, and the conditioner's **33 % adaptive arming threshold** may simply reject
> the weaker set — one wheel's teeth vanishing from the log. That is a finding in
> its own right (it is the air-gap fault mode), but it is not the phase
> measurement. **Caliper both ODs before stacking**, and set the gap to split the
> difference.

##### Or add an index pulse — and get absolute `key_to_gap`, not just a difference

The stack gives `key_to_gap(A) − key_to_gap(B)`. An index reference gives each
wheel's own value, and it is a small change: **on an index ISR, record the
current `_toothLogIdx` and the µs elapsed since the last tooth.** Two fields and
one handler. The gap's position relative to the shaft then falls out of every
capture, for any wheel, singly mounted.

**Either way the accuracy floor is the keyway, not the electronics.** The slot is
[≈3.6 × 2.3 mm](#corrected-the-keyway-is-not-a-din-8-mm-key) at a 24 mm bore, so
0.05–0.1 mm of side clearance is **0.24–0.48°** of rock at r = 12 mm. Both wheels
are driven the same direction by the same key, so most of it is common-mode — but
call the phase floor **±0.2°** and not 0.002°.

> **Against a 5.00° question that is 25× margin, and it does not touch the pitch
> and runout numbers at all** — those live inside one revolution and never
> reference the key.

##### Measurement discipline, because this is a comparison

| | |
|---|---|
| ⭐ **Run the same wheel twice, *remounting* between runs** | This is the repeatability floor, and it includes fixture error rather than just electrical noise. **Anything smaller than the A-vs-A difference is not real.** Same lesson as [nulling the leads](../../docs/measurements-wanted.md) |
| **Run at two speeds** | A geometric error is the same *angle* at any rpm; compliance, resonance and torque ripple are not. Identical patterns at 300 and 1200 rpm means geometry |
| **Separate wheel runout from fixture runout** | Both are a once-per-rev sinusoid. **Check where the high spot sits on the shaft**: if it stays put when the wheel is swapped, it is the hub bore; if it travels with the wheel, it is the wheel |
| **The hub bore fit now matters more** | It is the fixture for a comparative measurement, and `wheel_bore` is still derived from a photo grid. **Caliper it** before trusting a runout number |

##### What this still does not reach

The truck's own wheel, which is behind the timing cover. This compares **Dorman
against genuine Ford**, on the bench — which is the arm that
[survived the retraction](#-retracted--the-photographs-are-the-reviewers-engine-not-this-truck),
and the one that decides whether 5.00° is an OE value or a defect.

**And this is exactly what makes validating last cheap.** The Dorman is the build
article — it is on the shaft the whole time, so **log it at two speeds, twice
with a remount, the first day the rig turns**, and log it again whenever anything
about the fixture changes. By the time the Ford ring comes off the shelf the
reference is captured, the repeatability floor is known, and the validation is
**one run and a subtraction** rather than a session.

#### ⭐ The Ford ring is the *final* validation — the Dorman builds the rig

**Decided: order `XW1Z-12A227-AC` now, validate with it last.** The Dorman gets
the rig running; the genuine ring checks the Dorman at the end. Everything in
this thread so far has been **inference** — a casting number, a date-code prefix,
a catalogue's year range, a stranger's review — and a genuine Ford pulse ring is
the geometry all of it was reaching for. It does not reach all of it. It reaches
the half that is on the shelf.

##### Why validating last is better than validating first

Not a compromise — **the deferral upgrades the measurement.** Today the
comparison would be two wheels stacked on a bar and a hard look at the rim. By
the time the rig runs it is
[a tooth log at 0.002°](#-better-than-looking-spin-each-wheel-and-diff-the-tooth-logs)
with an established repeatability floor, on the real sensor, at two speeds.

| | validate now | validate at the end |
|---|---|---|
| Instrument | eye, at r ≈ 65 mm | **the rig, through the real VR sensor** |
| Phase resolution | a fraction of a tooth-width | **±0.2°**, keyway-limited |
| Also yields | nothing else | **per-tooth pitch, runout, duty, amplitude** |
| Blocks the build? | — | **no** |

**And nothing in the build is waiting on it.** The `.scad` is already dimensioned
from the Dorman, so the hub, bore, key and bolt circle are cut to the part that
will actually be on the shaft. That was luck; it is now the plan.

> ⚠ **The one real risk in this ordering: the hub is cut to the Dorman.** If the
> Ford ring's bore, keyway or bolt circle differ, the validation run is blocked
> by a printed part at the worst possible moment. **Caliper the Ford wheel the
> day it arrives**, months before it is needed, purely to find out whether the
> hub needs a second variant. That is the one early task the late-validation plan
> creates.

> ⭐ **And order it now even though it is needed last.** `XW1Z-…` is a
> **1999-prefix number revised to `-AC`** — a part Ford has already superseded
> once and can take NLA at any time. Build time is months; part availability is
> not guaranteed over months. **A part on the shelf is an option that cannot
> expire; a part in a catalogue can.** If it goes NLA mid-build, the validation
> arm dies with it and there is no recovering it.

##### It is the only second wheel this project will ever have

⚠ **Revised** — this section first assumed the truck's OEM wheel was in hand. It
is not; [the photographs are the
reviewer's](#-retracted--the-photographs-are-the-reviewers-engine-not-this-truck).
That kills one of the two arms and leaves the other **completely intact**:

| stack | answers | status |
|---|---|---|
| **Ford vs Dorman** | Is 917-060 a faithful copy? **Is the review real?** | ✅ **Fully available** — two parts, a bar through the keyways, no truck, no cover, no engine |
| ~~**Ford vs the truck's own wheel**~~ | Does a 1999 5.4 use the XW1Z design at all? | ⛔ **Deferred behind the timing cover.** Damper, accessory drive, front cover — and the cover carries the oil pump and front seal. Not a measurement, a job |

**And the surviving arm is the one that mattered.** It is a pure bench test
between two parts that will both be on the shelf, and it decides whether the rig
wheel's 5.00° is an OE design value or somebody's defect.

##### ⛔ The 1999 question stays open, and that is now permanent-ish

The *`X` = 1999, so one design spans 1999→2010* argument
[above](#the-part-is-marked--it-is-the-dorman-and-the-inference-above-was-wrong)
is **a reading of a part number, not a measurement**, and there is no longer any
way to test it — the only 1999 wheel in the story is bolted inside this truck's
timing cover.

**Mark it as an argument and leave it.** It is not load-bearing any more: it was
propping up a *prediction* of `CKP_GAP_TO_TDC_DEG`, and
[the strobe measures that directly](#-and-this-is-what-makes-the-retraction-cheap)
without caring which wheel is on the crank.

##### ~~⏳ Take `CKP_GAP_TO_TDC_DEG` before it arrives~~ — there is no deadline

⚠ **Struck.** This urged a piston-stop reading *"while the cover is off"*. The
cover is not off and never was. There is no perishable window on either side:
the truck is not open, and the part is not going anywhere.

The transfer arithmetic it was built on is still true and still worth keeping,
for whenever a wheel does come off:

```
CKP_GAP_TO_TDC_DEG(new wheel) = CKP_GAP_TO_TDC_DEG(fitted wheel) + rim stagger
```

— because the sensor term belongs to **where the sensor bolts to the block** and
survives any wheel change. It simply has no occasion to be used right now.

##### It does not put a wheel on the truck either

The [rule below](#the-operational-rule-either-way) bars the Dorman from the
truck, and a genuine Ford ring looked like the part that could take its place.
**It cannot, at a sane price** — fitting anything means pulling the cover.

So the honest scope of this purchase is narrower than it looked yesterday, and
worth stating plainly:

| | |
|---|---|
| ✅ **Is the Dorman a faithful copy of the OE ring?** | **Yes, this answers it** — on a bench, with a bar through two keyways |
| ✅ **Is the rig's 5.00° an OE value or a defect?** | **Yes** — same reading, and it is what the bench actually needs to know |
| ✅ **An independent OD and tooth-count check** | **Yes** — against a photo-grid number and a listing that was wrong by 25 % |
| ⛔ Does a 1999 use this design? | No. Needs the truck's wheel |
| ⛔ `CKP_GAP_TO_TDC_DEG` | No — and it never did. [The strobe does that](#-trigger-a-timing-light-off-the-sync-gap) |

**That is still worth the money**, because the first two rows are the ones the
rig is blocked on, and nothing else in the building can answer them.

**Ford vs Dorman, and what each outcome means now:**

| the stacked rim shows | then |
|---|---|
| **coincide** | The Dorman is a faithful copy. **5.00° is the OE `key_to_gap`**, this file's old `key_to_gap ≈ 0` belief was simply mistaken, and the reviewer's stagger means *their* engine wanted a different wheel — a wrong-application complaint wearing a defect's clothes |
| **half a pitch apart** | The Dorman is phase-defective, the review is confirmed on parts we can actually hold, and the rig wheel carries a **known-wrong** offset — harmless on a bench, [arguably useful](#the-rig-does-not-care--and-is-arguably-better-off) |
| **walking apart round the rim** | Pitch or tooth-count mismatch. Grosser than the review describes, and blatant |

##### ⚠ Four things to do the moment it is out of the box — then shelf it

Validation is months away, but **these are the ones that cannot wait**, because
each can invalidate the plan while there is still time to react.

| | why it cannot wait |
|---|---|
| ⭐ **Caliper the bore, keyway and bolt circle** | **Against the `.scad` hub, which is cut to the Dorman.** A mismatch found now is a reprint; found at validation it is a blocked measurement at the end of the build |
| **Caliper the OD** | An independent check on **~135 mm**, currently a photo-grid reading against [a listing wrong by 25 %](#the-od-is-135-mm-not-17145--the-vendor-listing-is-wrong-by-25-). Two parts agreeing at the calipers closes it — **and the hub is blocked on exactly this number** |
| **Read the casting**, and record it beside `FRONT 917-060 53025 TAIWAN` | A Ford box is not a measurement. A *different* base number means XW1Z superseded and this is the successor's geometry — still useful, but no longer the part the Dorman cross-references. **And it is the window for a return** |
| **Count the teeth** | 35 plus the gap. Free, and it is how a wrong part announces itself before anything is built around it |

> **Then put it away.** Its job is to be the reference at the end, and the
> cheapest way for it to fail at that job is to get used as a bench part in the
> meantime. **Do not mount it, do not spin it, do not lend it to the rig.**

> ⚠ **The receipt does not settle the 1999 question.** `XW1Z-12A227-AC` is
> cataloged from 2001; a genuine one proves the *number* is real, not that the
> *design* fits a 1999. That is exactly what the stack against the truck's own
> wheel is for — **do not let the Ford box substitute for the reading.**

**Stacking three is not required.** The crank snout may not take them, and it
does not have to: **the key registers each wheel independently**, so two separate
readings against the Ford reference are worth one three-high stack, in either
order, with the crank free to turn in between. Off the engine, a close-fitting
bar through the keyways does the same job.

#### The operational rule, either way

> ⚠ **Do not fit this wheel to the truck.** It is a bench part. Whatever the
> cause, a part with a user-reported timing defect does not belong on the vehicle
> the ECU is being developed against — a wheel that makes the *factory* PCM run
> rough would contaminate every comparison against it.
>
> ✅ **Free to obey, as it turns out.** Fitting anything means pulling the cover,
> and the cover is staying on. The Dorman goes to the rig because there is
> nowhere else for it to go.

**And TritonECU is immune to the defect in a way the factory PCM is not**, which
is worth noticing. The OEM PCM has gap-to-TDC baked in; ours has
`CKP_GAP_TO_TDC_DEG` as a **named, calibratable constant** — the decision
[recorded above](#the-truck-measures-the-same--so-the-rig-is-a-calibration-bench)
to keep it a named constant rather than a disappeared zero. Calibrate to whatever
wheel is actually fitted and a 5° offset is a number, not a fault. That immunity
is exactly why the constant must be **measured on the truck, with the truck's own
wheel**, and never inherited from the bench.

#### The rig does not care — and is arguably better off

A wheel whose gap sits half a pitch from where the factory puts it is **still a
perfectly good 36-1 wheel**. The rig tests *decoder behaviour*: sync acquisition,
cranking profiles, tooth counting, noise. None of that depends on where TDC is.

In fact a non-zero offset makes the **better** test article. A bench that always
calibrates to zero never exercises the offset at all, so any code path that
silently assumes `CKP_GAP_TO_TDC_DEG == 0` would pass every test and fail on the
truck. **This wheel forces the constant to be real.**

#### `FRONT` closes the mirroring problem permanently

The face-down reading happened because nothing on the wheel said which way it
faced. **Something does** — `FRONT` is cast into it. Every future reading has an
unambiguous reference, and the geometric sense can finally be written down.

**Given: the marked FRONT face, and the engine turns clockwise seen from the
front.** A fixed sensor meets features in *counter-clockwise* order — with the
wheel turning clockwise, the feature that arrives next is the one currently
counter-clockwise of the sensor. The gap arrives first and the keyway 5.00°
later, so the keyway is 5.00° **counter-clockwise** of the gap:

> **On the face marked `FRONT`, sweeping clockwise, the keyway comes first and
> the missing tooth 5.00° after it.**

That is a one-glance check, and it is the form the `.scad` needs for the index
flute.

#### What 5.00° is *not*: it is not `CKP_GAP_TO_TDC_DEG`

This is the wheel's half of the answer, and it is worth being precise about the
other half:

```
CKP_GAP_TO_TDC_DEG  =  key_to_gap  +  angle( sensor , keyway-at-TDC )
                       ^^^^^^^^^^     ^^^^^^^^^^^^^^^^^^^^^^^^^^^^^^^
                       5.00 deg,      set by where the sensor BOLTS TO
                       the wheel      THE BLOCK. Not a wheel property.
```

The gap is detected when the gap passes **the sensor**; TDC happens when the
crank reaches a particular orientation. Those coincide only if the sensor is
mounted exactly where the keyway points at TDC, which would be luck. So the
sequencing claim — *gap first, TDC second* — is right and is the useful half,
but the magnitude still needs the engine.

**And the engine settles it in one measurement, with no protractor:** bring #1 to
TDC on a piston stop, then look at what is in front of the CKP sensor. If the gap
has just gone past by about 5°, the whole chain is consistent and
`CKP_GAP_TO_TDC_DEG` is confirmed small. If the gap is somewhere else entirely,
the second term above is not zero and this is exactly how you find out.

#### Why the old photo said 2.3° — the keyway is the noisy end

Both the photo reading and the first physical reading sighted a radius *from the
keyway out to the rim*, and **that is backwards.** A radial line's angular error
is `δ/r`, so a linear error costs angle in inverse proportion to how far out the
feature sits — and the keyway is the innermost feature on the wheel:

| feature | radius | 1 mm error costs |
|---|--:|--:|
| **keyway** | ~14–22 mm | **2.6–4.1°** — up to 0.41 pitch |
| tooth at the rim | ~64–86 mm | 0.7–0.9° — under 0.09 pitch |

**3–5× noisier at the keyway end**, which is where both readings started. It also
explains how a wheel could be read face-down without the error being obvious: at
that noise level, 2.3° and 5.0° and 7.5° all look like "about on the gap".

#### The rig can measure this on itself, to 0.1°

None of the above needs a protractor, and none of it needs the flute to be right
first. `key_to_gap` only has to be *known*, not *correct*:

1. Cut the flute at 5.00° and print the hub.
2. Mount the wheel, home the stepper against the flute.
3. Spin it and take a tooth log — `CrankSensor::startToothLog()` already exists.
4. The gap's position relative to home falls out at **0.1125°** per step at 16×
   microstepping.

That is **23× finer than sighting it by eye**, and it turns a printed feature
into a measured constant. Which is the real lesson:

> **The index flute should never have been the datum.** It is an eyeball aid for
> finding the gap on a wheel whose teeth all look alike. The moment the decoder's
> absolute-angle check inherits its zero from a printed flute, a systematic error
> in that flute is subtracted out of every test the rig runs — the rig would
> confirm its own mistake. The constant belongs in firmware, measured.

### The OD is **~135 mm**, not 171.45 — the vendor listing is wrong by 25 %

A third photo put the **whole template** in frame on a light background, which is
what the first two were missing. Two independent scales now sit in the same
image:

| scale reference | | |
|---|--:|--:|
| Plate outline | 157 × 173 mm | known |
| **Pin-field slot** | **101.4 mm** | known, and *local* to the plate rather than at its edges |
| **The wheel** | **~13.5 grid squares** | **≈ 128–141 mm** |

`wheel_od = 171.45` would be **17.1 squares.** It is not close.

> Two earlier attempts at this got it wrong in opposite directions and both are
> struck: *"the template proves it without measuring anything"* assumed a plate
> width that ran off frame, and the ratio that replaced it leaned on a pixel
> estimate of that same bad frame. **The fix was not better arithmetic, it was a
> better photograph** — put the whole reference in the picture.

**135 is still an estimate.** Caliper it before printing any rig part: this one
number now drives the bore and keyway as well as the geometry.

### The photo's *ratios* survived what its absolute dimension did not

The product photo gave bore/OD = **0.253**, and `wheel_bore` was set to
0.253 × 171.45 = **43.4**. The ratio was never the problem — **a ratio is
scale-free, so it cannot be wrong about size.** It was multiplied by the wrong
number.

The `.scad` now derives them, so measuring the OD propagates by itself:

```
wheel_bore = 0.253 * wheel_od        43.4  ->  34.2
key_w      = 0.15  * wheel_bore       6.5  ->   5.1
key_d      = 0.19  * wheel_bore / 2   4.1  ->   3.25
```

⚠ **The old `wheel_hub` spigot would not have entered the wheel** — 43.4 against
a ~34 mm bore is 9 mm of interference on the diameter. That part must be
re-rendered, not just re-checked.

### And the rig's geometry inverts — the wheel no longer reaches the base

| | at 171.45 | **at 135** |
|---|--:|--:|
| Wheel dip below shaft height | 25.7 mm | **7.5 mm** |
| Rim to ground | 16.3 mm | **34.5 mm** |
| **Base wheel slot** | 114.4 mm | **0 — not needed at all** |

The slot is gone. [Below](#two-consequences-and-one-of-them-is-not-obvious) this
file argues at length that the wheel is *bigger* than assumed, so the shaft had
to be **dropped** until the wheel ran *through* a slot in the base — and that the
slot was "the plate's weakest section". **All of that was reasoning from the bad
OD.** At 135 mm a 60 mm shaft holds the rim 34.5 mm clear of the ground with the
base untouched, and `shaft_h` can now come *down* for a shorter, stiffer upright
rather than being held up to clear a slot that does not exist.

### RESOLVED — it is a modular part, and the listing was wrong twice

Dorman's catalogue: **917-060**, steel, **35 teeth**, OE cross
**XW1Z-12A227-AC**, fitting 2001-2010 F-150 4.6, **2002-2010 F-150 5.4**, Crown
Victoria, Mustang, Explorer, Expedition, Navigator, Mountaineer. The ~135 mm we
measured is a modular reluctor's size and **corroborates the catalogue against
the listing** — which had both the OD and the engine family wrong.

**But the calibration-bench claim does not come back**, for two reasons that have
nothing to do with engine family: the applications begin at **2001** and the
truck is a **1999**, and a review of this part reports its teeth do not match
OEM. Both are covered
[above](#that-review-may-be-describing-the-number-we-measured--withdrawn).

> **It is the Dorman**, and the part says so: `FRONT 917-060 53025 TAIWAN` is
> cast into the front face. So the photo above is a photo of *this* wheel, the
> 2.3° and the 5.00° are two readings of one part, and the part wins.

### Corrected: the keyway is NOT a DIN 8 mm key

The slot measures **15 % of the bore diameter** wide and 19 % of the bore radius
deep. At a 24 mm bore that is **≈3.6 × 2.3 mm** — less than half the DIN 6885
8 × 3.3 this file previously assumed for a 24 mm shaft.

**A printed 8 mm key would simply not have entered the slot.** `key_w` and
`key_d` now carry the photo-derived figures, still marked MEASURE.

### ~~Settled: the vendor's own listing~~ — the listing does not describe the part

> **Struck.** Measured against the carrier-template grid the OD is **~135 mm**,
> not the listed 6-3/4" / 171.45 — wrong by 25 %. See
> [the measurement](#the-od-is-135-mm-not-17145--the-vendor-listing-is-wrong-by-25-).
> The bore and keyway derived from it were wrong by the same factor, and the
> listing's *"Small Block Ford"* application was wrong too — Dorman's own
> catalogue puts this part on **modular V8s**, not an SBF.

~~**6-3/4" OD and .120" thick** — a Small Block Ford 36-1 that sits between the
harmonic balancer and the crank pulley. In millimetres:~~ *(Neither figure nor
the engine family survived. Dorman's catalogue: a **modular V8** reluctor,
**35 teeth**, OE **XW1Z-12A227-AC**.)*

| | was assumed | ~~"actual"~~ | **measured** |
|---|--:|--:|--:|
| OD | 150 | ~~171.45~~ | **~135** |
| Thickness | 5.0 | 3.05 | still from the listing |
| Bore | 38 (guess) | ~~43.4~~ | **~34.2** — 0.253 × OD, the ratio was fine |

**The lesson is which number to trust.** The photo gave *ratios* and the vendor
gave an *absolute*, and it was the absolute that failed. A ratio is scale-free,
so it cannot be wrong about size — and multiplying a good ratio by a bad
dimension is precisely how 43.4 happened.

### Two consequences, and one of them is not obvious

**The wheel is bigger, so it dips deeper.** An 85.7 mm radius against a 60 mm
shaft height puts the rim **25.7 mm below the base top** — leaving barely **6 mm
to the ground** on the old 24 mm feet.

**The fix is taller feet, not a taller shaft.** Both would clear it, but
`shaft_h` is what every upright is cut to, and bracket stiffness goes as `1/h³`:
raising the shaft from 60 to 70 would cost **~30 % of the brackets' stiffness**
for nothing. Raising the feet costs nothing at all. `foot_h` is now **34 mm**,
giving 16 mm of clearance.

**The slot and the plate both grew** — a 114 mm slot, and the crank sensor now
stands off at y = 109, so `plate_w` goes 240 → **260**. Still 300 × 260, which a
320 mm bed takes whole.

### What that means for print order

> ⚠ **The table that was here is struck.** It opened *"with OD and thickness now
> published"* — and both were then withdrawn. The OD came from the vendor
> listing that turned out to be [wrong by
> 25 %](#the-od-is-135-mm-not-17145--the-vendor-listing-is-wrong-by-25-), and
> `wheel_thk = 3.05` is still that same listing. **135 is a photo-grid estimate,
> ±7 mm.** Current order below.

**`shaft_h` is now a fixed 60 mm, not `wheel_od/2 + 12`** — which is what makes
most of the rig printable today. The parts that still track the wheel are the
ones that touch it or aim at it.

| ✅ print now | why it is safe |
|---|---|
| **`fit_gauge`** ⭐ **first, before anything** | Chooses `brg_press`. The first PETG set split because this step was skipped |
| `bearing_block` ×4 | `shaft_h` only — **after** the gauge sets the pocket |
| `motor_mount` | `shaft_h` only |
| `crank_gear`, `cam_gear` | Gear parameters only |
| `cam_target` ✅ | Was briefly held: the "no wheel dependency" claim was wrong, since `cam_target` is built on `hub_od = max(wheel_bore + 16, 46)`. `wheel_bore` is now a caliper 31.75, so `hub_od` is 47.75 and it is clear |
| `sensor_ckp`, `sensor_cmp` | Check models — their whole job is to be held up against the real thing |

| ⛔ hold | gated on |
|---|---|
| **`base` / `base_a` / `base_b`** | **`wheel_od`.** The slot length and the sensor bolt holes both scale with it — ±7 mm of OD moves `y_ck` by ±3.5 mm, past a 4.4 mm clearance hole. **And see the bug below** |
| **`hub`, `wheel_hub`** | `wheel_bore`, `key_w`, `key_d`, `wheel_thk` — **all four are photo ratios or the bad listing.** The previous spigot was [9.2 mm oversize](#corrected-the-keyway-is-not-a-din-8-mm-key) and would not have entered |
| `sensor_mount` ×2 | Sensor barrel length — the module itself is clean, only its station on the base moves |

#### 🐛 Fixed before this print run: the base cut no wheel slot at all

`slot_y` tested `shaft_h + base_t < wheel_od/2` — *"does the wheel punch out the
**bottom** of the plate"* — and sized the slot on the chord at that bottom face.
**Both are the wrong question.** A slot is needed the moment the wheel reaches
below the base **top**, and it must be as long as the chord *there*, which is the
widest section of the intersection rather than the narrowest.

| `wheel_od` | wheel dips | old `slot_y` | corrected |
|--:|--:|--:|--:|
| 132 | 6.0 mm | **0 mm** | 65.0 mm |
| **135** (nominal) | **7.5 mm** | **0 mm** ⛔ | **71.8 mm** |
| 138 | 9.0 mm | 33.4 mm | 78.1 mm |
| 141 | 10.5 mm | 47.2 mm | 84.0 mm |

**At the current nominal the base cut no slot while the wheel buried 7.5 mm into
an 8 mm plate** — a hard collision, wheel cannot turn. Where the old test did
fire it was short by ~45 mm. Fixed in `vr_rig.scad`, and the render now echoes a
**BASE GATE** line naming the dependency so it cannot be printed absent-mindedly.

> ⚠ **Note how close the cliff was.** `shaft_h + base_t = 68` against
> `wheel_od/2 = 67.5` — the old condition failed by **0.5 mm**. A wheel 1 mm
> larger would have hidden the bug completely, and a rig that had been printed
> and assembled would have found it with a stalled motor.

#### All fourteen parts render clean

`openscad` builds every `part =` target with no warnings or errors, including
both base halves — checked after the slot fix, so the geometry is sound even
where the *dimensions* are still gated.

## 5. The sensors are flange-mounted, which broke the mount design

The product photos show what these actually are: an **O-ring'd barrel that drops
into a bore, with a single bolt through an ear beside it**. Not a plain cylinder.
`sensor_mount` was a pinch clamp, and a pinch clamp is the wrong object.

**The consequence is not cosmetic — insertion depth is fixed by the flange.**
The sensor cannot be slid in or out to set the air gap, because the flange face
bottoms on the mounting surface. So:

- The mount is a **plate normal to the sensor axis**: the barrel passes through
  it, the ear lies flat on its outboard face, and the bolt goes in alongside.
- **The bolt runs PARALLEL to the barrel.** The *flange plate* is what sits
  perpendicular to the barrel, and a bolt normal to that plate is therefore
  parallel to it. An intermediate revision of this file read "90 degrees to the
  barrel" as describing the bolt and made it crosswise — that was wrong, and the
  bolt would have passed through the sensor body.
- **It is an M8**, not the M6 first assumed.
- **`gap_slot` went 14 → 30 mm.** The slotted feet are now the *only* air-gap
  adjustment, and they also have to absorb the uncertainty in barrel length.
- **The station formula was wrong.** It positioned the mount by its own width;
  with a flange sensor the tip lands `sensor_barrel_len` from the mounting face,
  so the old formula would have driven the barrel tip **8 mm inside the wheel**.

### The flange offsets are measured; one dimension is still missing

From the barrel's edge to the bolt centre: **CKP 14.0 mm, CMP 12.7 mm**. Adding
the 7.15 mm barrel radius gives the offset from the barrel *axis*:

| | edge → bolt | **axis → bolt** |
|---|--:|--:|
| CKP | 14.0 mm | **21.15 mm** |
| CMP | 12.7 mm | **19.85 mm** |

They differ by only 1.3 mm, so **one slotted mount takes both** — the bolt slot
spans 19.85 to 21.15 with room either side, and takes an **M8**.

The ear is offset straight *up* from the barrel in the model. The sensor turns
freely in its bore, so that direction is ours to pick, and up keeps the mount
narrow in X rather than widening the base.

### The pad is sized from the ear, not from its bolt

Both ears are **19 mm wide with a rounded tip**, and reach **25.4 mm (CKP)** and
**19.1 mm (CMP)** past the barrel's edge — so 32.55 and 26.25 mm from its axis.
The seating pad is sized to the larger, which makes the mount **47.0 × 46.0 ×
99.6 mm**.

**The bolt is not centred on the tip radius on either sensor**, which is why the
pad had to be sized from the reach rather than inferred from the bolt:

| | bolt from axis | ear tip from axis | ear past the bolt |
|---|--:|--:|--:|
| CKP | 21.15 | 32.55 | 11.4 mm |
| CMP | 19.85 | 26.25 | 6.4 mm |

### The crank figures cross-check; the cam's still do not

A later measurement gave **6 mm from the bolt hole's outer edge to the flange's
outer radius**. That is an independent route to the same number, and on the crank
sensor it lands:

| | bolt centre | tip via the 6 mm rule | tip as stated | differ |
|---|--:|--:|--:|--:|
| **CKP** | 21.15 | 31.15 | 32.55 | **1.4 mm** |
| CMP | 19.85 | 29.85 | 26.25 | **3.6 mm** |

So the crank ear is confirmed from two directions and the pad (sized to 32.55)
covers it. **The cam's numbers still disagree with themselves**, in the same
direction as the tip-radius check above — its stated reach is shorter than its own
bolt position implies. Worth one more look, though it changes nothing: the pad is
sized to the larger ear and the bolt slot spans both.

### A tape reading with a different datum is not a contradiction

The flange top measured **1.875″** against a tape standing on the bench. If the
sensor were resting on its *barrel*, a 32.55 mm tip would read **1.563″**. The
7.9 mm difference is the connector stalk holding it up off the table — a
different zero, not a different flange. Worth stating because it looks like a
9 mm error until you ask what the tape was measuring from.

### Flange face → sensing tip: 57 mm and 38.1 mm

Those were recorded first as "body length". They are the **barrel**, which is what
positions the mount — and 57 mm is nearly twice the 30 that was assumed.

**Two things follow, and neither is cosmetic.**

**The boss went 10 → 30 mm.** At 10 mm a 57 mm barrel would hang **47 mm into
free air** off a single thin plate. On the engine that barrel sits in a deep bore;
on a rig it has nothing. A 30 mm boss supports over half of it, costs only
plastic, and pulls the mount 10 mm inboard — which the plate width is grateful
for.

**The plate had to become asymmetric.** A 57 mm barrel puts the crank sensor's
outboard edge near **+152 mm**. A symmetric plate answers that with **334 mm**,
past a 320 bed. But the −Y side only needs 105 (the cam gear reaches −102), so:

```
        Y from -105 to +157   =  262 mm
```

**Shifting the plate rather than growing it** keeps the whole rig on a 320 bed —
300 × 262. Symmetry was costing 72 mm for nothing.

## 5. Settle two things the drawings leave open

**Wheel axial retention — answered.** The photo shows the wheel is **already
drilled**, four holes. The hub's bolt circle needs matching to them (count,
diameter and radius), which is a parameter, not a redesign.

**Cam lobe phase.** With the keyway as a datum the M8 lobe's angle can be *set*
rather than discovered. Put it well away from the crank gap so the sync window is
unambiguous, then **record the angle here** — it becomes a known constant the
decoder can be tested against, exactly like the gap-to-TDC zero.

---

# Check models: print the sensors and hold them up

`part = "sensor_ckp"` and `"sensor_cmp"` model the two VR sensors — and they are
built from **the same parameters the mount is**, on purpose.

That is the entire value. If the printed model does not match the real sensor,
then the mount is wrong *in the same way*, because both read from the same
numbers. It is a 20 g print that tests every dimension in this file at once:

| | CKP | CMP |
|---|--:|--:|
| Barrel Ø | 14.3 | 14.3 |
| Barrel length, flange face → tip | 57.0 | 38.1 |
| Flange reach from barrel axis | 32.55 | 26.25 |
| Bolt centre from barrel axis | 21.15 | 19.85 |
| Flange width | 19.0 | 19.0 |
| Bolt | M8 | M8 |
| **Printed envelope** | **70.5 × 20.3 × 63.0** | **64.2 × 20.3 × 44.1** |

**What to compare, in order of how much it costs to be wrong:**

1. **Barrel length.** It sets where the sensor stands, and through that the base
   plate width. Wrong here and the base reprints.
2. **Flange reach and bolt position.** Wrong here and only `sensor_mount`
   reprints.
3. Flange thickness and the connector tails — **these are guesses**, marked as
   such in the file. They affect nothing structural; the tail is there so the
   thing reads as a sensor when held next to one.

### Corrected before the first print, from a look at the render

Three errors, caught by comparing the model to the real part on screen rather
than in the hand — which is the cheaper end of the same idea:

**The flange does not stop at the barrel.** It carries on past it with the same
radius as the bolt end, so the paddle is rounded at *both* ends. Measured from
the barrel's outer surface to the flange's far edge: **6 mm on the crank, 3 mm on
the cam.** The first model hulled from a circle *at* the barrel, which cut that
off.

**Nothing projects behind the flange face.** The first model had a connector
block standing proud of the back. Both tails lie **flush, in the flange's own
plane**.

**The two connectors are nothing alike**, which took a couple of passes:

- **Crank** — **one straight leg at 90° to the ear**, lying flush in the flange's
  plane. The *"L" is the ear and that leg together*, not a leg that bends again.
  An intermediate version added a second leg off the first and pointed it 180°
  the wrong way.
- **Cam** — **no side tail at all.** Its connector is a **14 mm socket on the
  flange's back face, coaxial with the barrel and pointing 180° away from it**.

| | CKP | CMP |
|---|--:|--:|
| Envelope | 45.7 × 42.0 × 63.0 | 36.4 × 19.0 × 58.1 |
| Z span | −6 … 57 | **−20 … 38.1** |

On the crank the ear reaches +32.5 in X and the tail +32.5 in Y, so the L is
square and symmetric about the barrel — an easy thing to check by eye.

### The cam socket points away from the mount, which is lucky

It protrudes 14 mm behind the flange face, and the flange seats on the mount's
**outboard** face. Since the socket runs opposite the barrel, it heads *away* from
the plate into free air — so **no relief is needed**. Had it pointed the other way
it would have fouled the mount and wanted a through-hole, which is exactly the
sort of thing a check model is for.

Print flange-down, no supports needed. The barrel's O-ring groove and tapered tip
are cosmetic, included only so the shape reads correctly in the hand.
