alpauna/TritonECU/docs/1999-Ford-F150-4wd-5.42v/4r70W-Test-Key-Solenoid.png

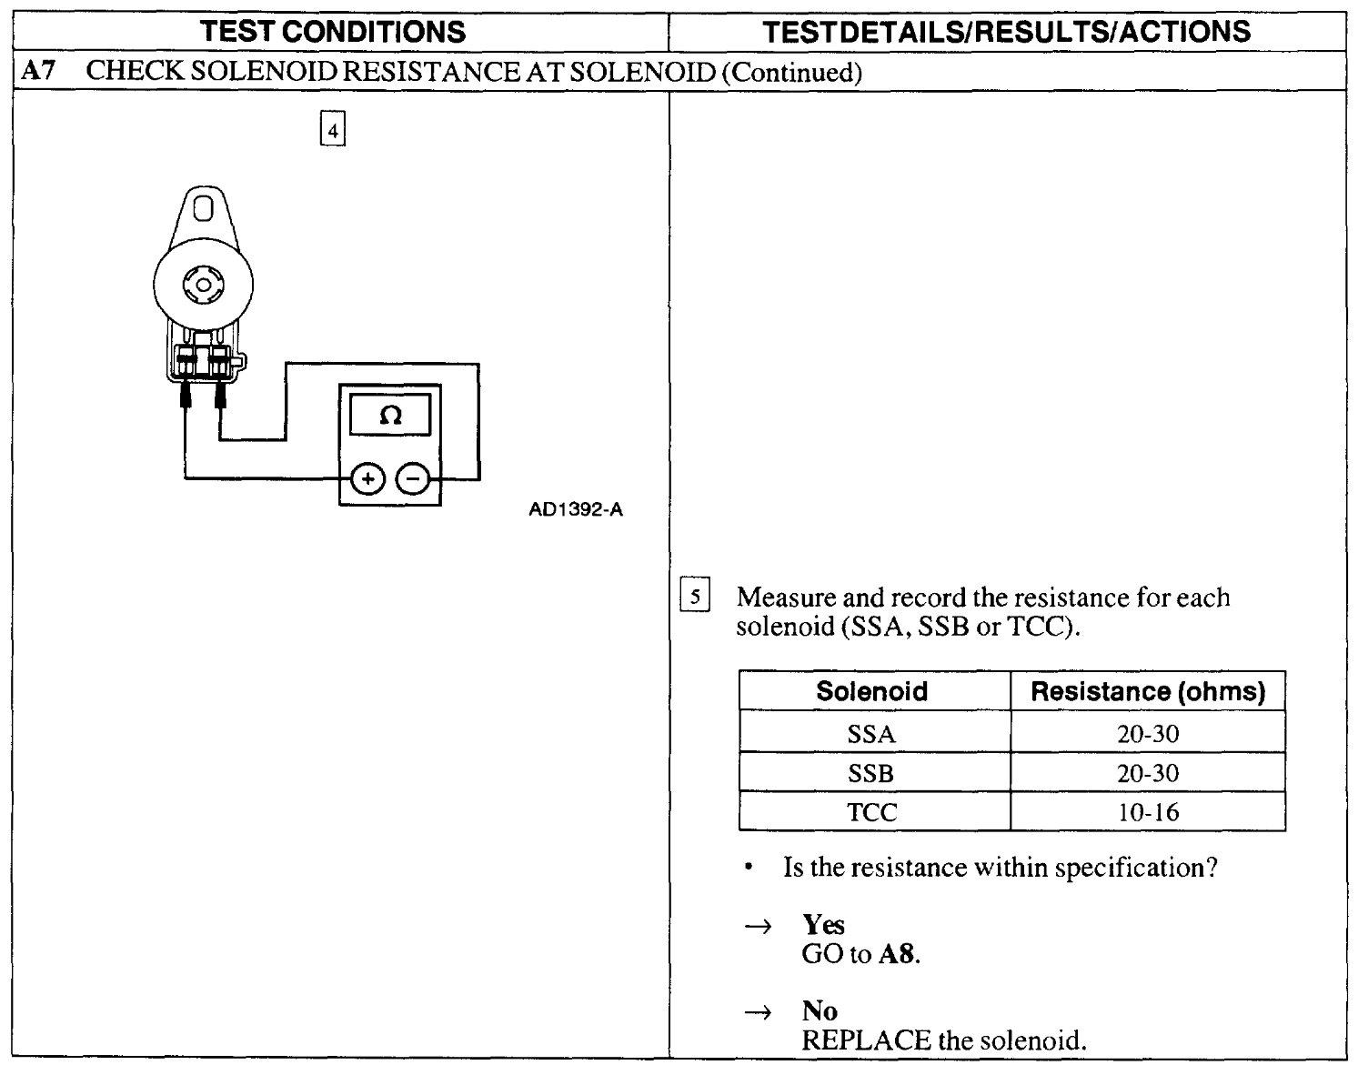
docs/1999-Ford-F150-4wd-5.42v/4r70W-Test-Key-Solenoid.png
