alpauna/TritonECU/docs/1999-Ford-F150-4wd-5.42v/ENG_CD_770750_C.pdf

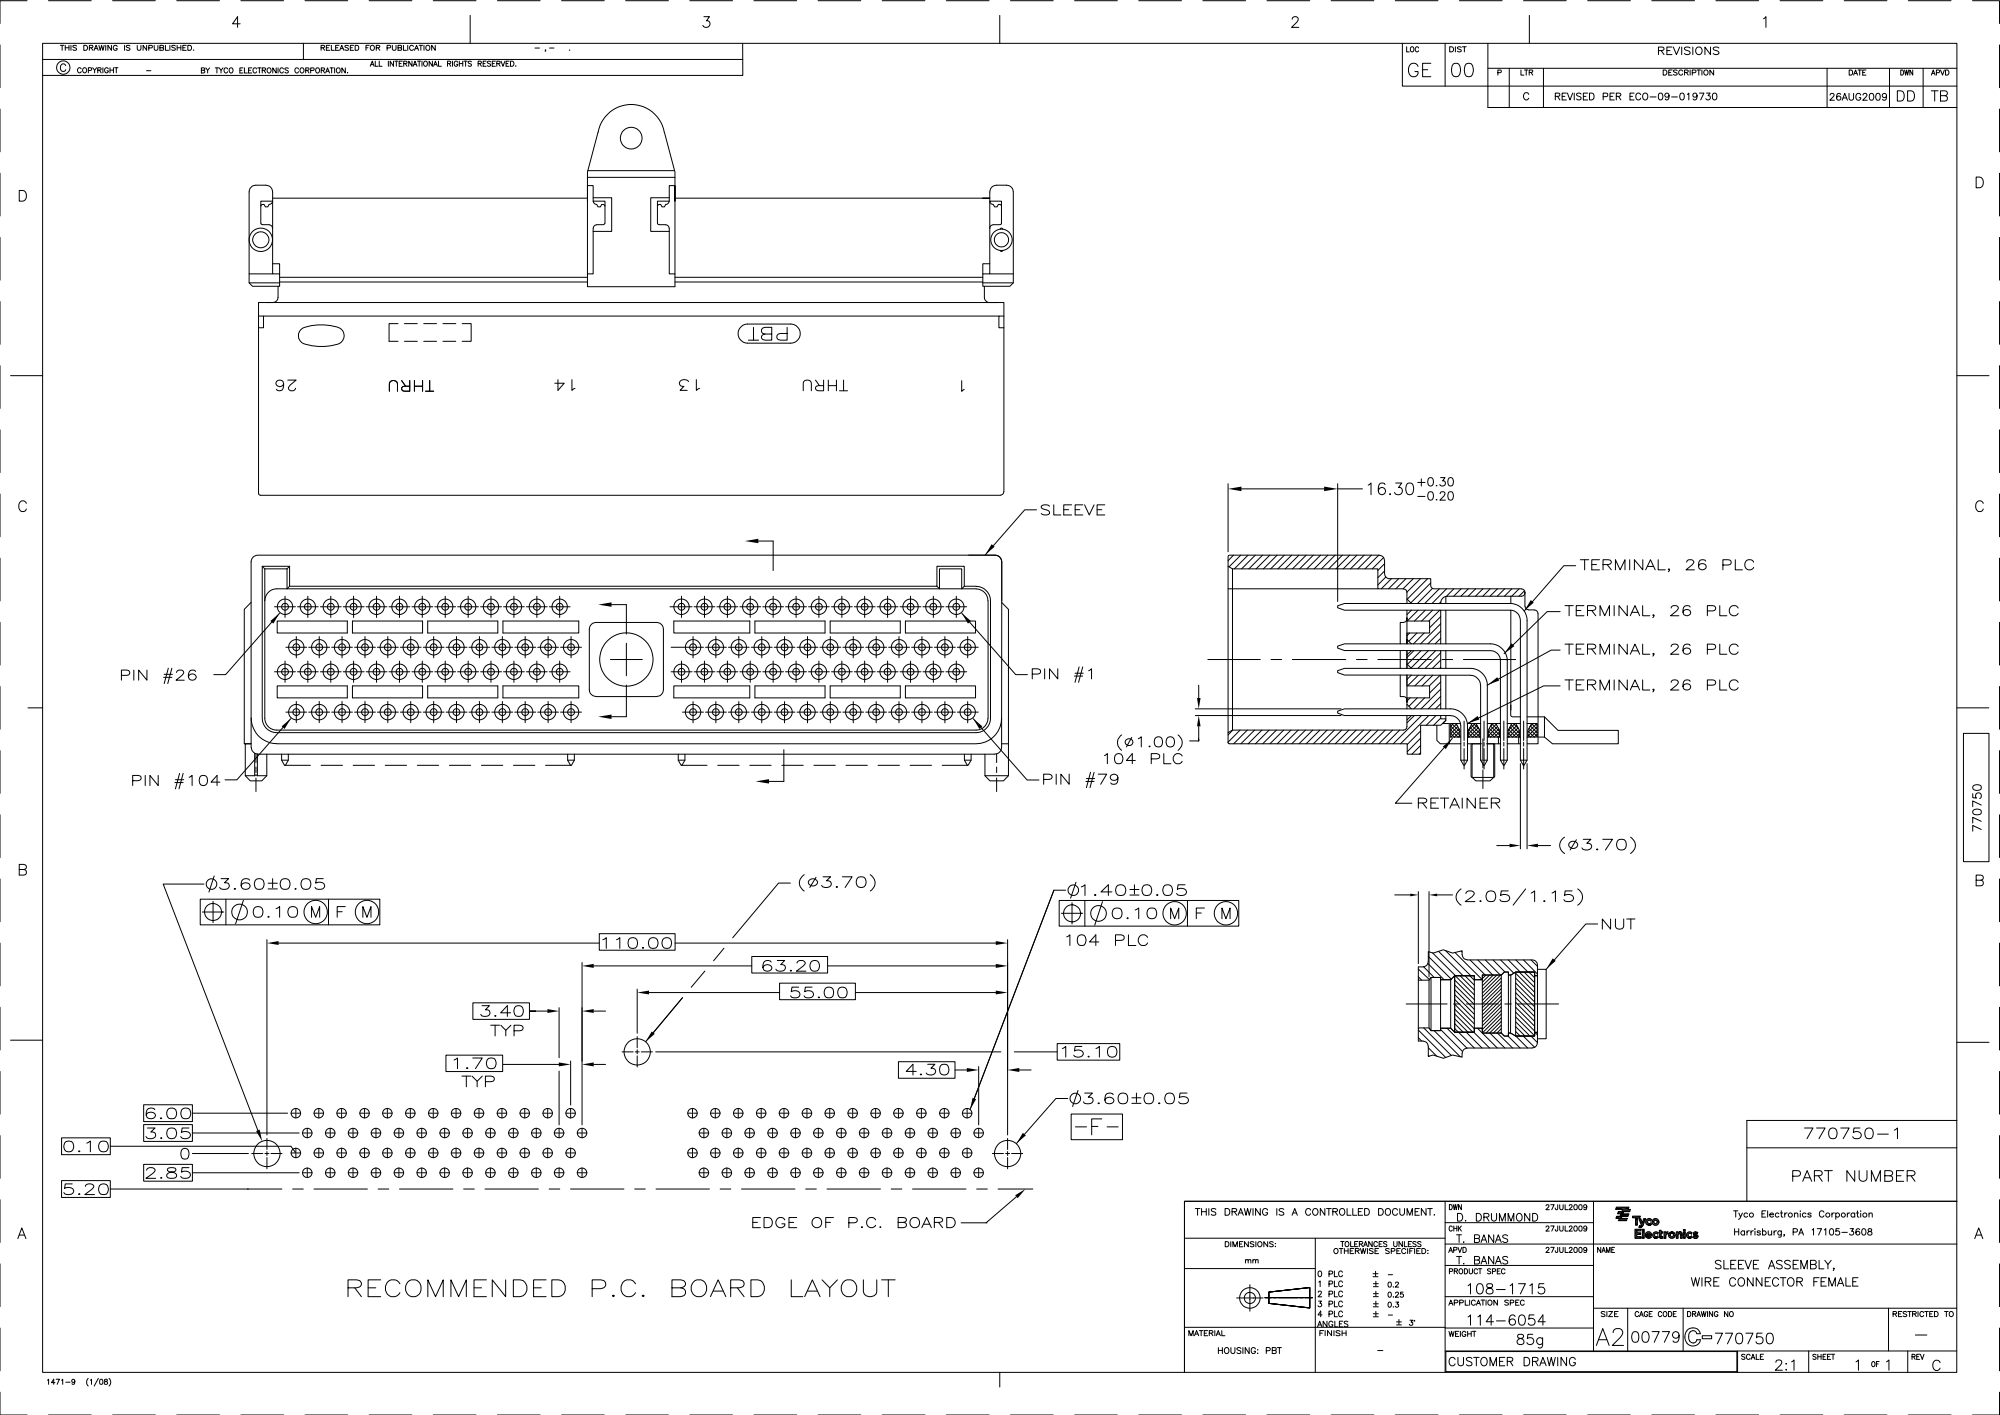
[picture p105: page 1]
