alpauna/TritonECU/docs/Schematics/KiCad/TritonECU-Main/TritonECU-Main.kicad_pcb

## KiCad design docs/Schematics/KiCad/TritonECU-Main/TritonECU-Main.kicad_pcb (2026-10-21)

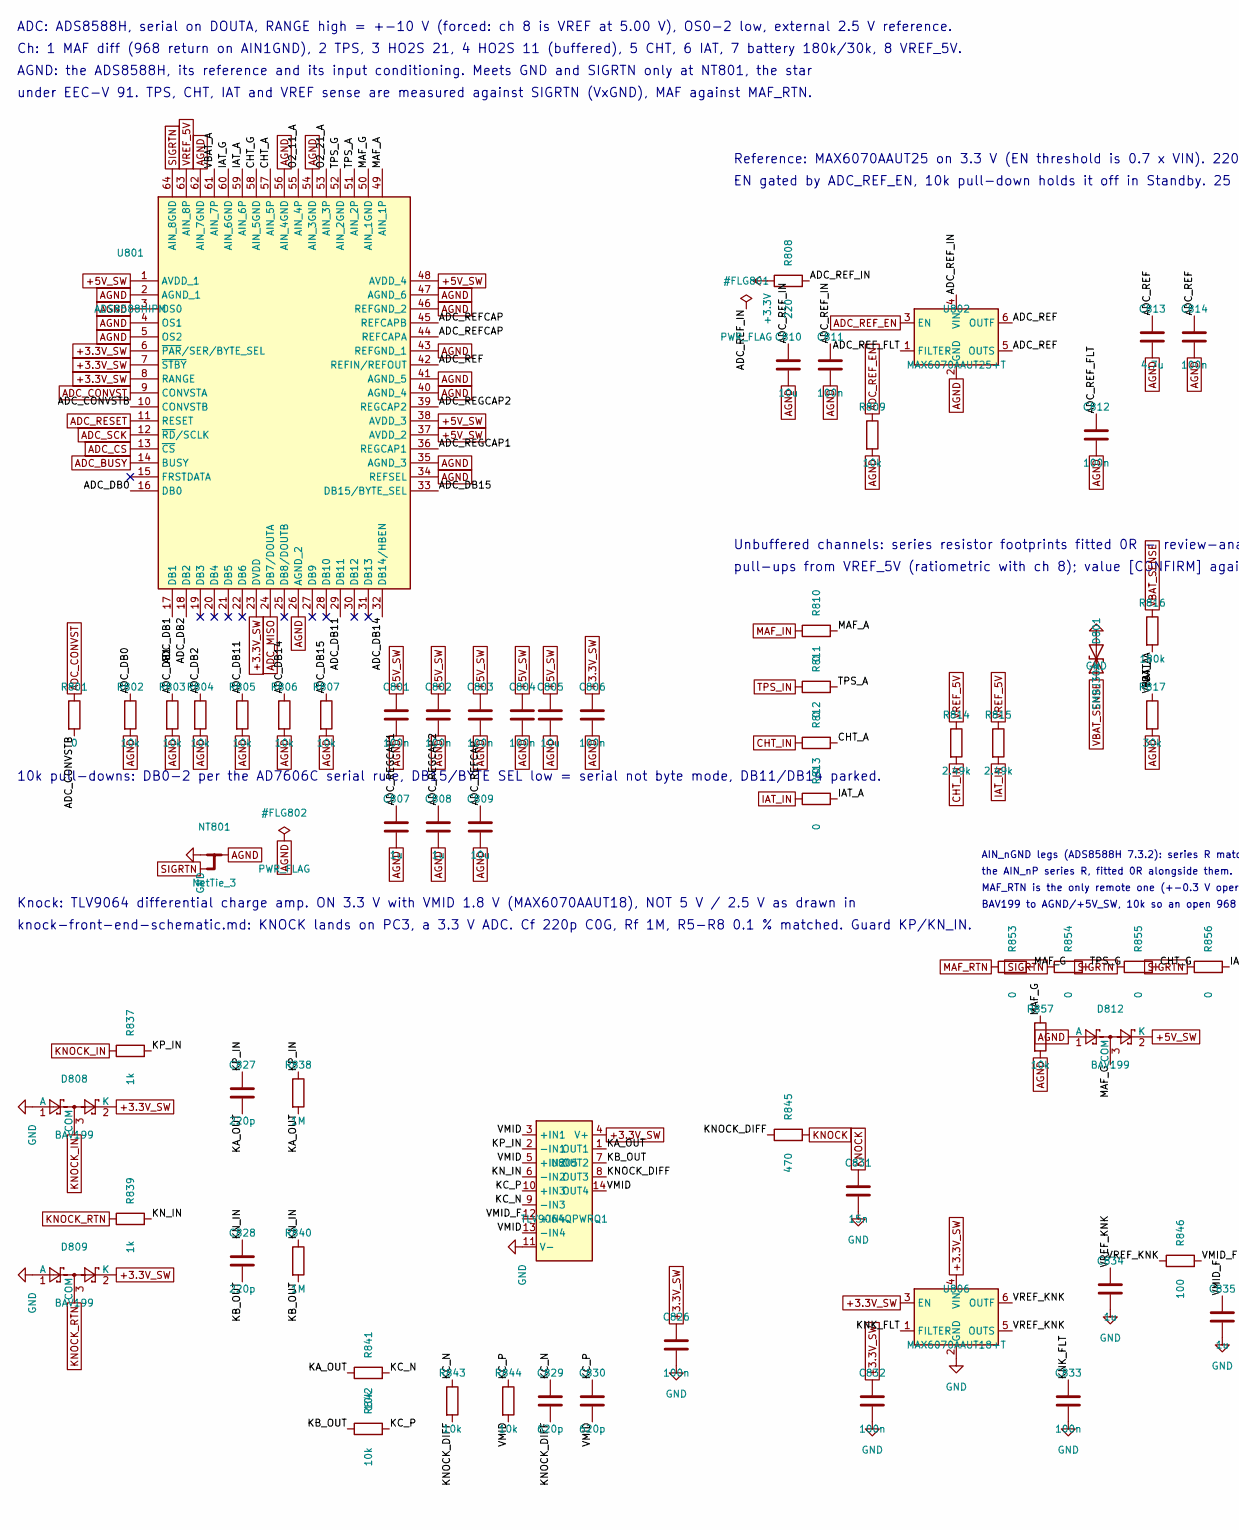
[picture p106: schematic ADC.kicad_sch, TritonECU carrier - ADC, part in row 1, column 1]

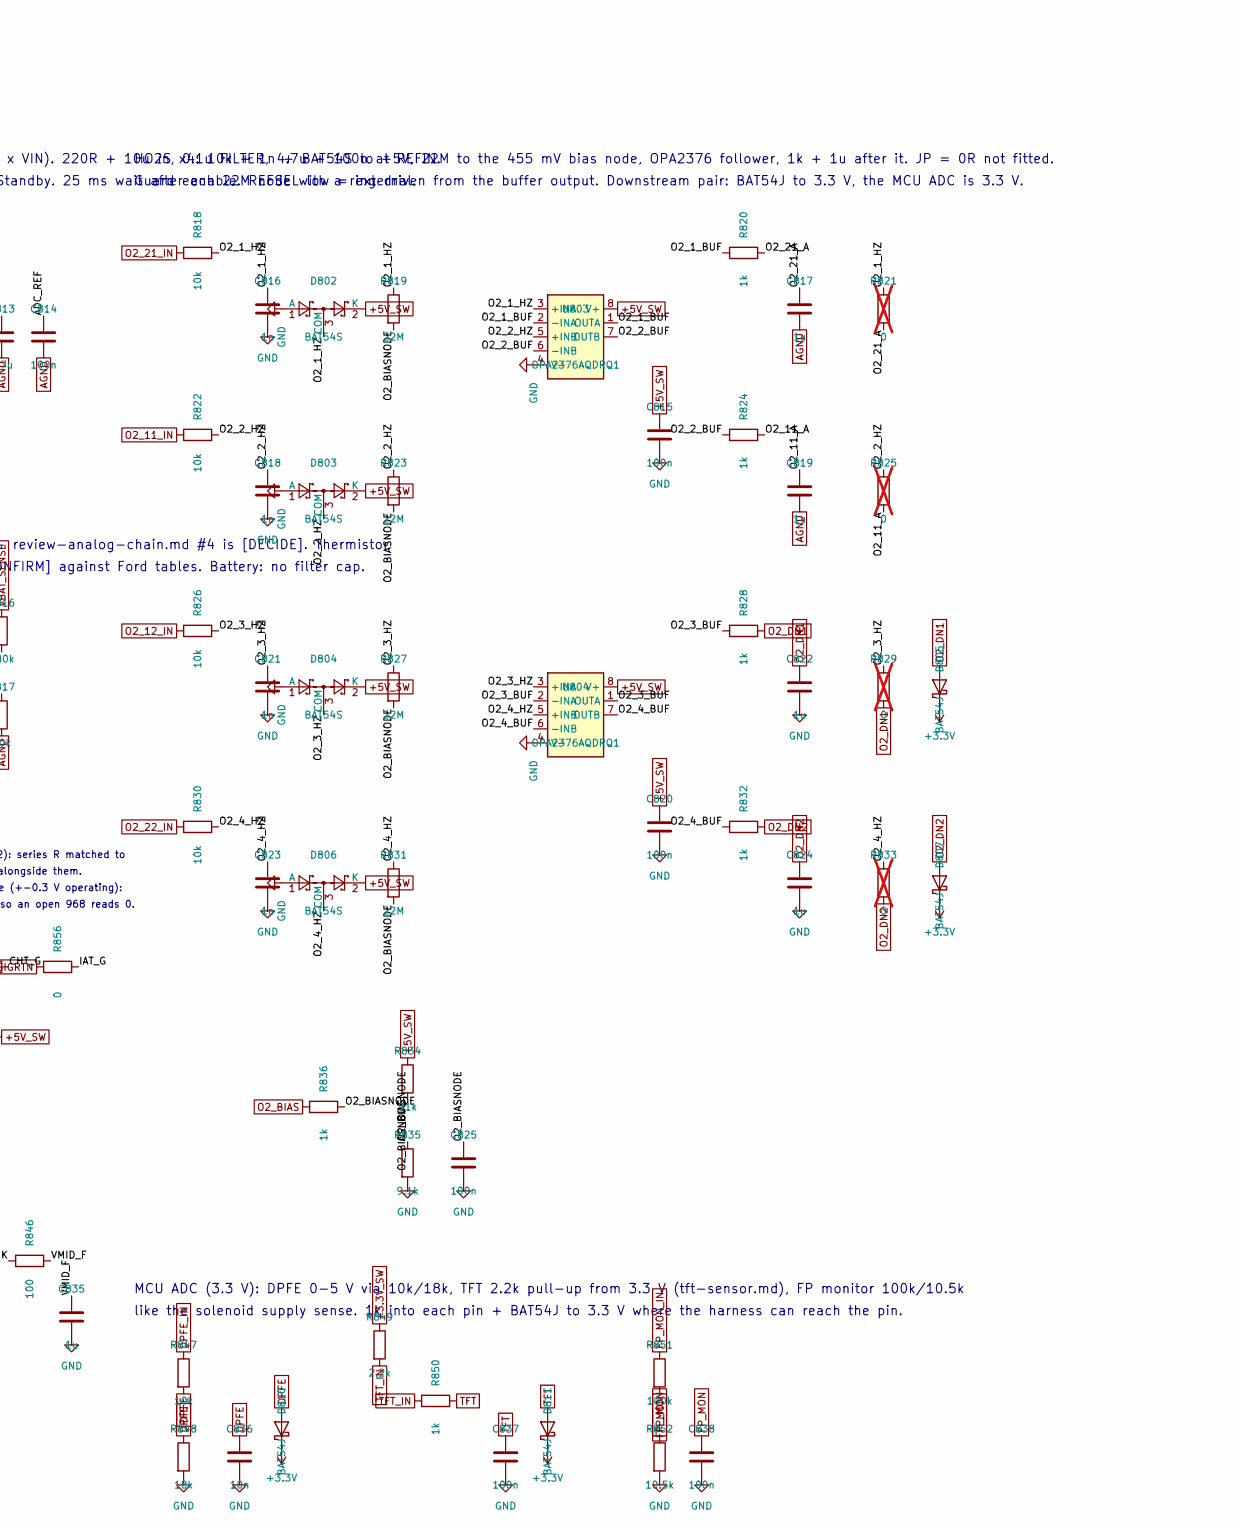
[picture p107: schematic ADC.kicad_sch, TritonECU carrier - ADC, part in row 1, column 2]

Parts:
C801, C802, C803, C804, C806, C811, C812, C814, C815, C820, C825, C826, C832, C833, C837, C838: 100n; C_0603_1608Metric_Pad1.08x0.95mm_HandSolder
C805, C809, C810: 10u; C_0805_2012Metric_Pad1.18x1.45mm_HandSolder
C807, C808, C817, C819, C822, C824, C834, C835: 1u; C_0603_1608Metric_Pad1.08x0.95mm_HandSolder
C813: 4.7u; C_0805_2012Metric_Pad1.18x1.45mm_HandSolder
C816, C818, C821, C823: 1n; C_0603_1608Metric_Pad1.08x0.95mm_HandSolder
C827, C828: 220p; C_0603_1608Metric_Pad1.08x0.95mm_HandSolder
C829, C830: 620p; C_0603_1608Metric_Pad1.08x0.95mm_HandSolder
C831: 15n; C_0603_1608Metric_Pad1.08x0.95mm_HandSolder
C836: 10n; C_0603_1608Metric_Pad1.08x0.95mm_HandSolder
D801: SMBJ30A; D_SMB
D802, D803, D804, D806: BAT54S; SOT-23
D805, D807, D810, D811: BAT54J; D_SOD-323F
D808, D809, D812: BAV199; SOT-23
NT801: NetTie_3; NetTie-3_SMD_Pad0.5mm
R801, R810, R811, R812, R813, R853, R854, R855, R856: 0; R_0603_1608Metric_Pad0.98x0.95mm_HandSolder
R802, R803, R804, R805, R806, R807, R809, R841, R842, R843, R844, R847, R857: 10k; R_0603_1608Metric_Pad0.98x0.95mm_HandSolder
R808: 220; R_0603_1608Metric_Pad0.98x0.95mm_HandSolder
R814, R815: 2.49k; R_0603_1608Metric_Pad0.98x0.95mm_HandSolder
R816: 180k; R_0603_1608Metric_Pad0.98x0.95mm_HandSolder
R817: 30k; R_0603_1608Metric_Pad0.98x0.95mm_HandSolder
R818, R822, R826, R830: 10k; R_0805_2012Metric_Pad1.20x1.40mm_HandSolder
R819, R823, R827, R831: 22M; R_0805_2012Metric_Pad1.20x1.40mm_HandSolder
R820, R824, R828, R832, R836, R837, R839, R850: 1k; R_0603_1608Metric_Pad0.98x0.95mm_HandSolder
R821, R825, R829, R833: 0; R_0603_1608Metric_Pad0.98x0.95mm_HandSolder; not fitted
R834: 91k; R_0603_1608Metric_Pad0.98x0.95mm_HandSolder
R835: 9.1k; R_0603_1608Metric_Pad0.98x0.95mm_HandSolder
R838, R840: 1M; R_0603_1608Metric_Pad0.98x0.95mm_HandSolder
R845: 470; R_0603_1608Metric_Pad0.98x0.95mm_HandSolder
R846: 100; R_0603_1608Metric_Pad0.98x0.95mm_HandSolder
R848: 18k; R_0603_1608Metric_Pad0.98x0.95mm_HandSolder
R849: 2.2k; R_0603_1608Metric_Pad0.98x0.95mm_HandSolder
R851: 100k; R_0603_1608Metric_Pad0.98x0.95mm_HandSolder
R852: 10.5k; R_0603_1608Metric_Pad0.98x0.95mm_HandSolder
U801: ADS8588HIPM; QFP50P1200X1200X160-64N
U802: MAX6070AAUT25+T; SOT-23-6
U803, U804: OPA2376AQDRQ1; SOIC-8_3.9x4.9mm_P1.27mm
U805: TLV9064QPWRQ1; TSSOP-14_4.4x5mm_P0.65mm
U806: MAX6070AAUT18+T; SOT-23-6

Connections:
+3.3V: D805.1 (K), D807.1 (K), D810.1 (K), D811.1 (K), R808.1; also elsewhere on the board
+3.3V_SW: C806.1, C826.1, C832.1, D808.2 (K), D809.2 (K), R849.1, U801.6 (~PAR/SER/BYTE_SEL), U801.7 (~STBY), U801.8 (RANGE), U801.23 (DVDD), U805.4 (V+), U806.3 (EN), U806.4 (VIN); also elsewhere on the board
+5V_SW: C801.1, C802.1, C803.1, C804.1, C805.1, C815.1, C820.1, D802.2 (K), D803.2 (K), D804.2 (K), D806.2 (K), D812.2 (K), R834.1, U801.1 (AVDD_1), U801.37 (AVDD_2), U801.38 (AVDD_3), U801.48 (AVDD_4), U803.8 (V+), U804.8 (V+); also elsewhere on the board
/ADC/ADC_CONVSTB: R801.2, U801.10 (CONVSTB)
/ADC/ADC_DB0: R802.1, U801.16 (DB0)
/ADC/ADC_DB1: R803.1, U801.17 (DB1)
/ADC/ADC_DB2: R804.1, U801.18 (DB2)
/ADC/ADC_DB11: R805.1, U801.29 (DB11)
/ADC/ADC_DB14: R806.1, U801.32 (DB14/HBEN)
/ADC/ADC_DB15: R807.1, U801.33 (DB15/BYTE_SEL)
/ADC/ADC_REF: C813.1, C814.1, U801.42 (REFIN/REFOUT), U802.5 (OUTS), U802.6 (OUTF)
/ADC/ADC_REFCAP: C809.1, U801.44 (REFCAPA), U801.45 (REFCAPB)
/ADC/ADC_REF_FLT: C812.1, U802.1 (FILTER)
/ADC/ADC_REF_IN: C810.1, C811.1, R808.2, U802.4 (VIN)
/ADC/ADC_REGCAP1: C807.1, U801.36 (REGCAP1)
/ADC/ADC_REGCAP2: C808.1, U801.39 (REGCAP2)
/ADC/CHT_A: R812.2, U801.57 (AIN_5P)
/ADC/CHT_G: R855.2, U801.58 (AIN_5GND)
/ADC/IAT_A: R813.2, U801.59 (AIN_6P)
/ADC/IAT_G: R856.2, U801.60 (AIN_6GND)
/ADC/KA_OUT: C827.2, R838.2, R841.1, U805.1 (OUT1)
/ADC/KB_OUT: C828.2, R840.2, R842.1, U805.7 (OUT2)
/ADC/KC_N: C829.1, R841.2, R843.1, U805.9 (-IN3)
/ADC/KC_P: C830.1, R842.2, R844.1, U805.10 (+IN3)
/ADC/KNK_FLT: C833.1, U806.1 (FILTER)
/ADC/KNOCK_DIFF: C829.2, R843.2, R845.1, U805.8 (OUT3)
/ADC/KN_IN: C828.1, R839.2, R840.1, U805.6 (-IN2)
/ADC/KP_IN: C827.1, R837.2, R838.1, U805.2 (-IN1)
/ADC/MAF_A: R810.2, U801.49 (AIN_1P)
/ADC/MAF_G: D812.3 (COM), R853.2, R857.1, U801.50 (AIN_1GND)
/ADC/O2_1_BUF: R820.1, U803.1 (OUTA), U803.2 (-INA)
/ADC/O2_1_HZ: C816.1, D802.3 (COM), R818.2, R819.1, R821.1, U803.3 (+INA)
/ADC/O2_2_BUF: R824.1, U803.6 (-INB), U803.7 (OUTB)
/ADC/O2_2_HZ: C818.1, D803.3 (COM), R822.2, R823.1, R825.1, U803.5 (+INB)
/ADC/O2_3_BUF: R828.1, U804.1 (OUTA), U804.2 (-INA)
/ADC/O2_3_HZ: C821.1, D804.3 (COM), R826.2, R827.1, R829.1, U804.3 (+INA)
/ADC/O2_4_BUF: R832.1, U804.6 (-INB), U804.7 (OUTB)
/ADC/O2_4_HZ: C823.1, D806.3 (COM), R830.2, R831.1, R833.1, U804.5 (+INB)
/ADC/O2_11_A: C819.1, R824.2, R825.2, U801.55 (AIN_4P)
/ADC/O2_21_A: C817.1, R820.2, R821.2, U801.53 (AIN_3P)
/ADC/O2_BIASNODE: C825.1, R819.2, R823.2, R827.2, R831.2, R834.2, R835.1, R836.2
/ADC/TPS_A: R811.2, U801.51 (AIN_2P)
/ADC/TPS_G: R854.2, U801.52 (AIN_2GND)
/ADC/VBAT_A: R816.2, R817.1, U801.61 (AIN_7P)
/ADC/VMID: C830.2, R844.2, U805.3 (+IN1), U805.5 (+IN2), U805.13 (-IN4), U805.14 (OUT4)
/ADC/VMID_F: C835.1, R846.2, U805.12 (+IN4)
/ADC/VREF_KNK: C834.1, R846.1, U806.5 (OUTS), U806.6 (OUTF)
ADC_BUSY: U801.14 (BUSY); also elsewhere on the board
ADC_CONVST: R801.1, U801.9 (CONVSTA); also elsewhere on the board
ADC_CS: U801.13 (~CS); also elsewhere on the board
ADC_MISO: U801.24 (DB7/DOUTA); also elsewhere on the board
ADC_REF_EN: R809.1, U802.3 (EN); also elsewhere on the board
ADC_RESET: U801.11 (RESET); also elsewhere on the board
ADC_SCK: U801.12 (~RD/SCLK); also elsewhere on the board
AGND: C801.2, C802.2, C803.2, C804.2, C805.2, C806.2, C807.2, C808.2, C809.2, C810.2, C811.2, C812.2, C813.2, C814.2, C817.2, C819.2, D812.1 (A), NT801.2, R802.2, R803.2, R804.2, R805.2, R806.2, R807.2, R809.2, R817.2, R857.2, U801.2 (AGND_1), U801.3 (OS0), U801.4 (OS1), U801.5 (OS2), U801.26 (AGND_2), U801.34 (REFSEL), U801.35 (AGND_3), U801.40 (AGND_4), U801.41 (AGND_5), U801.43 (REFGND_1), U801.46 (REFGND_2), U801.47 (AGND_6), U801.54 (AIN_3GND), U801.56 (AIN_4GND), U801.62 (AIN_7GND), U802.2 (GND)
CHT_IN: R812.1, R814.2; also elsewhere on the board
DPFE: C836.1, D810.2 (A), R847.2, R848.1; also elsewhere on the board
DPFE_IN: R847.1; also elsewhere on the board
FP_MON: C838.1, R851.2, R852.1; also elsewhere on the board
FP_MON_IN: R851.1; also elsewhere on the board
GND: C815.2, C816.2, C818.2, C820.2, C821.2, C822.2, C823.2, C824.2, C825.2, C826.2, C831.2, C832.2, C833.2, C834.2, C835.2, C836.2, C837.2, C838.2, D801.2 (A2), D802.1 (A), D803.1 (A), D804.1 (A), D806.1 (A), D808.1 (A), D809.1 (A), NT801.1, R835.2, R848.2, R852.2, U803.4 (V-), U804.4 (V-), U805.11 (V-), U806.2 (GND); also elsewhere on the board
IAT_IN: R813.1, R815.2; also elsewhere on the board
KNOCK: C831.1, R845.2; also elsewhere on the board
KNOCK_IN: D808.3 (COM), R837.1; also elsewhere on the board
KNOCK_RTN: D809.3 (COM), R839.1; also elsewhere on the board
MAF_IN: R810.1; also elsewhere on the board
MAF_RTN: R853.1; also elsewhere on the board
O2_11_IN: R822.1; also elsewhere on the board
O2_12_IN: R826.1; also elsewhere on the board
O2_21_IN: R818.1; also elsewhere on the board
O2_22_IN: R830.1; also elsewhere on the board
O2_BIAS: R836.1; also elsewhere on the board
O2_DN1: C822.1, D805.2 (A), R828.2, R829.2; also elsewhere on the board
O2_DN2: C824.1, D807.2 (A), R832.2, R833.2; also elsewhere on the board
SIGRTN: NT801.3, R854.1, R855.1, R856.1, U801.64 (AIN_8GND); also elsewhere on the board
TFT: C837.1, D811.2 (A), R850.2; also elsewhere on the board
TFT_IN: R849.2, R850.1; also elsewhere on the board
TPS_IN: R811.1; also elsewhere on the board
VBAT_SENSE: D801.1 (A1), R816.1; also elsewhere on the board
VREF_5V: R814.1, R815.1, U801.63 (AIN_8P); also elsewhere on the board

Notes on the sheet:
ADC: ADS8588H, serial on DOUTA, RANGE high = +-10 V (forced: ch 8 is VREF at 5.00 V), OS0-2 low, external 2.5 V reference.
Ch: 1 MAF diff (968 return on AIN1GND), 2 TPS, 3 HO2S 21, 4 HO2S 11 (buffered), 5 CHT, 6 IAT, 7 battery 180k/30k, 8 VREF_5V.
AGND: the ADS8588H, its reference and its input conditioning. Meets GND and SIGRTN only at NT801, the star
under EEC-V 91. TPS, CHT, IAT and VREF sense are measured against SIGRTN (VxGND), MAF against MAF_RTN.
10k pull-downs: DB0-2 per the AD7606C serial rule, DB15/BYTE SEL low = serial not byte mode, DB11/DB14 parked.
Reference: MAX6070AAUT25 on 3.3 V (EN threshold is 0.7 x VIN). 220R + 10u in, 0.1u FILTER, 4.7u + 100n at REFIN.
EN gated by ADC_REF_EN, 10k pull-down holds it off in Standby. 25 ms wait after enable. REFSEL low = external.
Unbuffered channels: series resistor footprints fitted 0R - review-analog-chain.md #4 is [DECIDE]. Thermistor
pull-ups from VREF_5V (ratiometric with ch 8); value [CONFIRM] against Ford tables. Battery: no filter cap.
HO2S x4: 10k + 1n + BAT54S to +5V, 22M to the 455 mV bias node, OPA2376 follower, 1k + 1u after it. JP = 0R not fitted.
Guard each 22M node with a ring driven from the buffer output. Downstream pair: BAT54J to 3.3 V, the MCU ADC is 3.3 V.
Knock: TLV9064 differential charge amp. ON 3.3 V with VMID 1.8 V (MAX6070AAUT18), NOT 5 V / 2.5 V as drawn in
knock-front-end-schematic.md: KNOCK lands on PC3, a 3.3 V ADC. Cf 220p C0G, Rf 1M, R5-R8 0.1 % matched. Guard KP/KN_IN.
MCU ADC (3.3 V): DPFE 0-5 V via 10k/18k, TFT 2.2k pull-up from 3.3 V (tft-sensor.md), FP monitor 100k/10.5k
like the solenoid supply sense. 1k into each pin + BAT54J to 3.3 V where the harness can reach the pin.
AIN_nGND legs (ADS8588H 7.3.2): series R matched to
the AIN_nP series R, fitted 0R alongside them.
MAF_RTN is the only remote one (+-0.3 V operating):
BAV199 to AGND/+5V_SW, 10k so an open 968 reads 0.

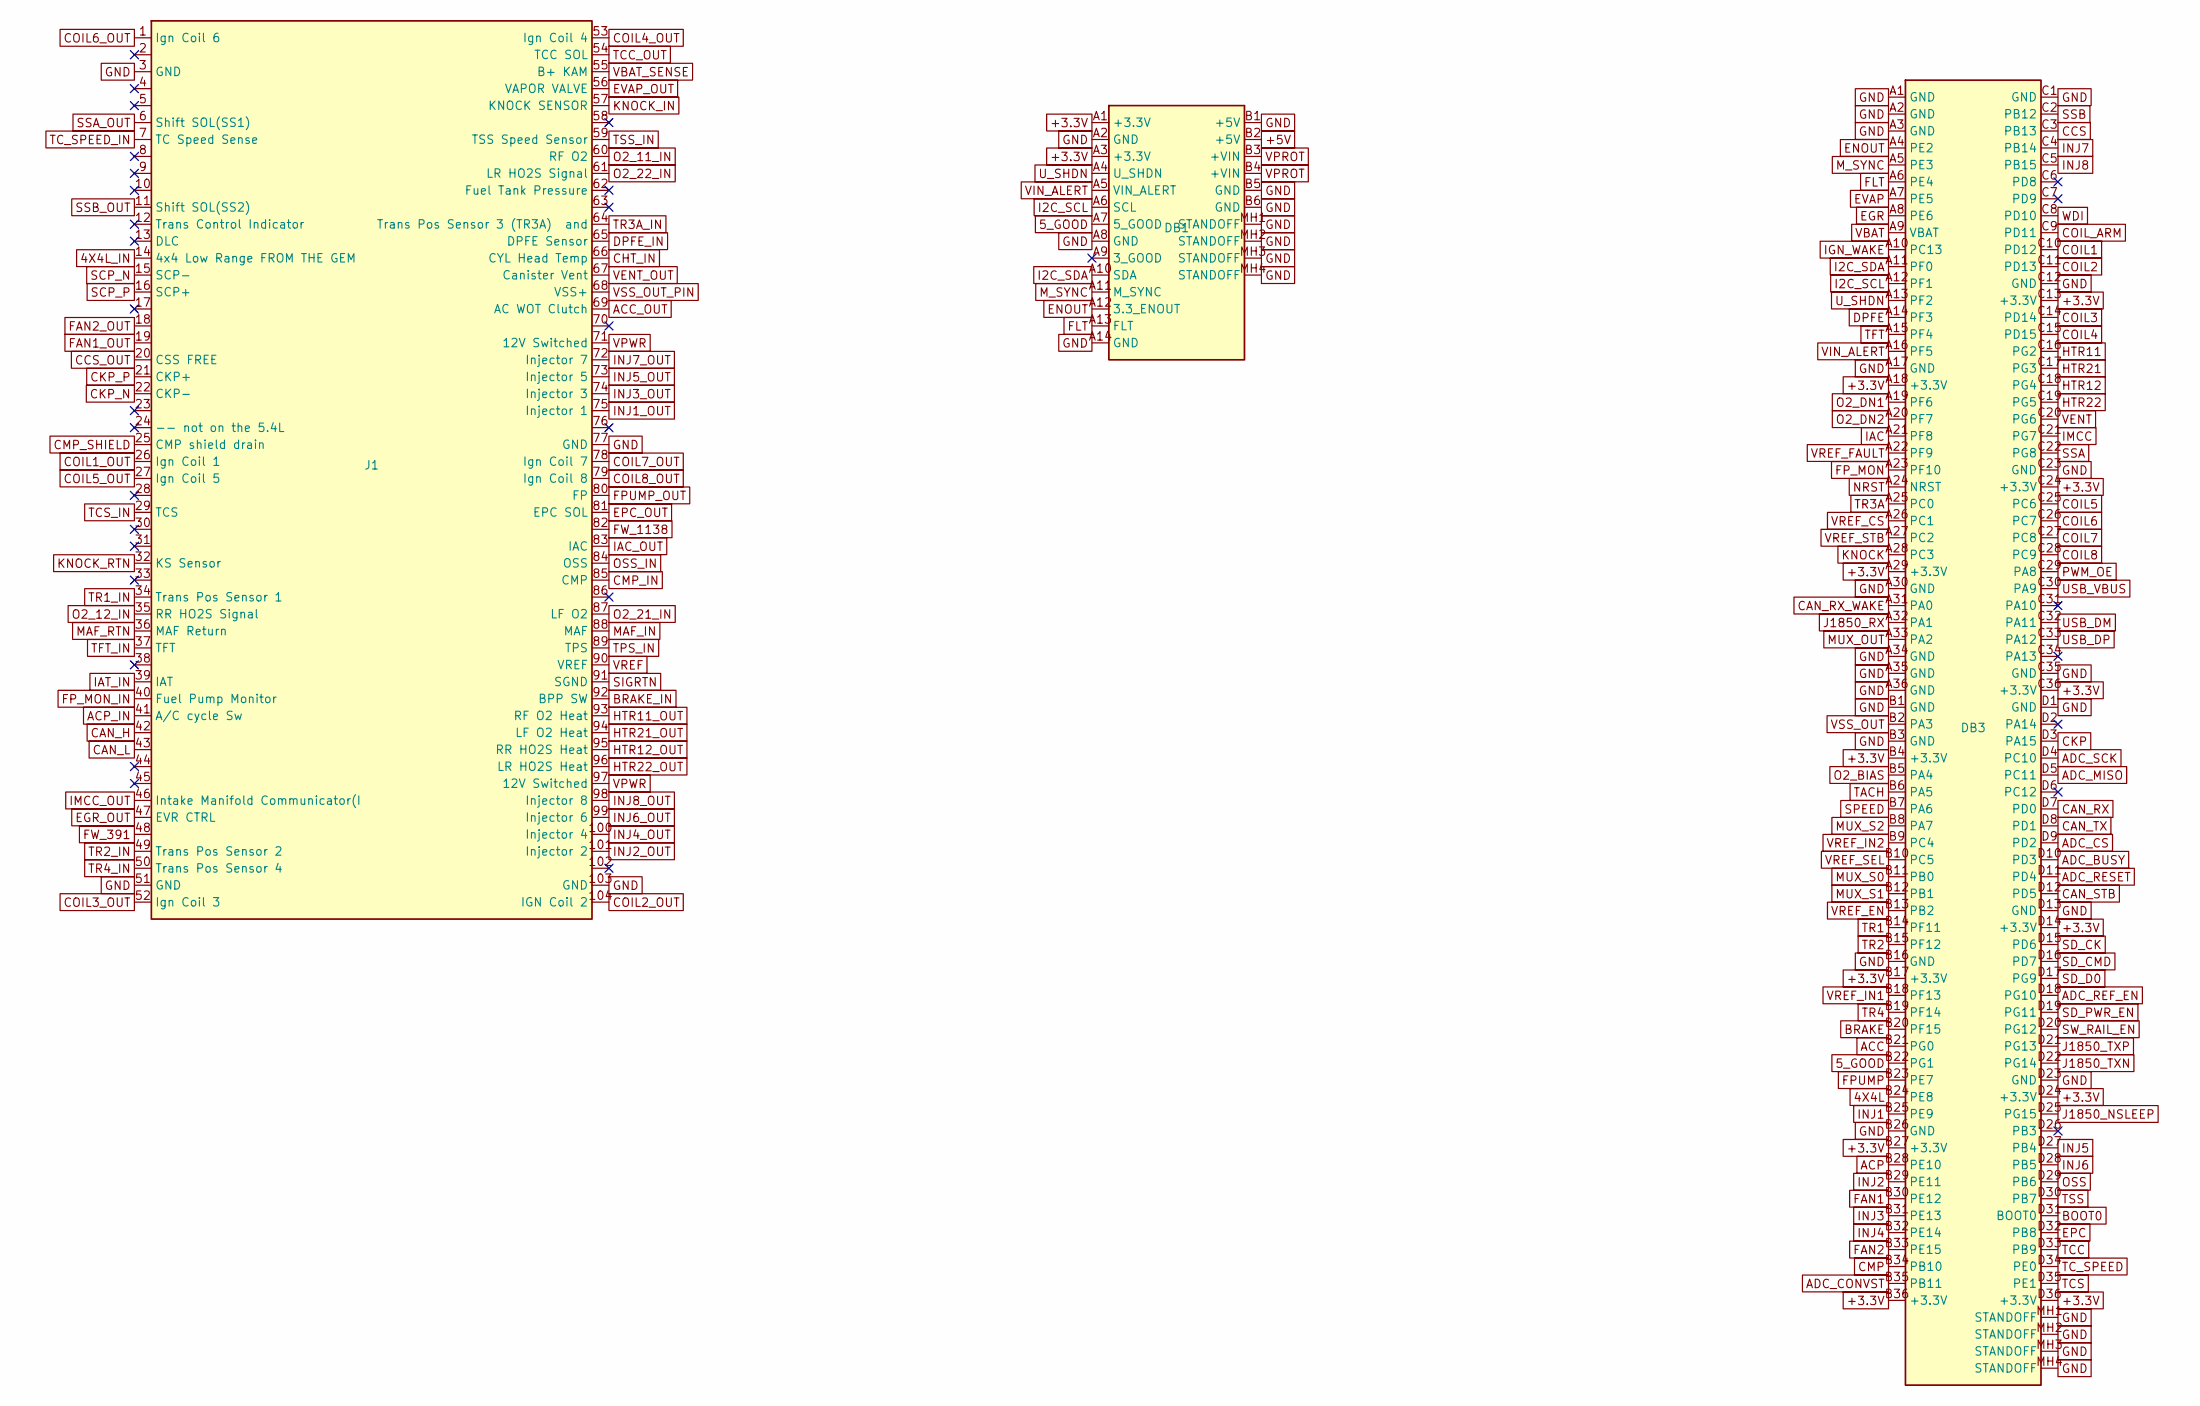
[picture p108: schematic Interconnect.kicad_sch]

Parts:
DB1: Power board V3; PowerBoard_V3_Mate
DB3: MCU module F767; MCUModule_F767_Mate
J1: EEC-V 104; EECV_104

Connections:
4X4L: DB3.B24 (PE8); also elsewhere on the board
4X4L_IN: J1.14 (4x4 Low Range FROM THE GEM); also elsewhere on the board
5_GOOD: DB1.A7 (5_GOOD), DB3.B22 (PG1)
+3.3V: DB1.A1 (+3.3V), DB1.A3 (+3.3V), DB3.A18 (+3.3V), DB3.A29 (+3.3V), DB3.B4 (+3.3V), DB3.B17 (+3.3V), DB3.B27 (+3.3V), DB3.B36 (+3.3V), DB3.C13 (+3.3V), DB3.C24 (+3.3V), DB3.C36 (+3.3V), DB3.D14 (+3.3V), DB3.D24 (+3.3V), DB3.D36 (+3.3V); also elsewhere on the board
+5V: DB1.B2 (+5V); also elsewhere on the board
ACC: DB3.B21 (PG0); also elsewhere on the board
ACC_OUT: J1.69 (AC WOT Clutch); also elsewhere on the board
ACP: DB3.B28 (PE10); also elsewhere on the board
ACP_IN: J1.41 (A/C cycle Sw); also elsewhere on the board
ADC_BUSY: DB3.D10 (PD3); also elsewhere on the board
ADC_CONVST: DB3.B35 (PB11); also elsewhere on the board
ADC_CS: DB3.D9 (PD2); also elsewhere on the board
ADC_MISO: DB3.D5 (PC11); also elsewhere on the board
ADC_REF_EN: DB3.D18 (PG10); also elsewhere on the board
ADC_RESET: DB3.D11 (PD4); also elsewhere on the board
ADC_SCK: DB3.D4 (PC10); also elsewhere on the board
BOOT0: DB3.D31 (BOOT0); also elsewhere on the board
BRAKE: DB3.B20 (PF15); also elsewhere on the board
BRAKE_IN: J1.92 (BPP SW); also elsewhere on the board
CAN_H: J1.42; also elsewhere on the board
CAN_L: J1.43; also elsewhere on the board
CAN_RX: DB3.D7 (PD0); also elsewhere on the board
CAN_RX_WAKE: DB3.A31 (PA0); also elsewhere on the board
CAN_STB: DB3.D12 (PD5); also elsewhere on the board
CAN_TX: DB3.D8 (PD1); also elsewhere on the board
CCS: DB3.C3 (PB13); also elsewhere on the board
CCS_OUT: J1.20 (CSS FREE); also elsewhere on the board
CHT_IN: J1.66 (CYL Head Temp); also elsewhere on the board
CKP: DB3.D3 (PA15); also elsewhere on the board
CKP_N: J1.22 (CKP-); also elsewhere on the board
CKP_P: J1.21 (CKP+); also elsewhere on the board
CMP: DB3.B34 (PB10); also elsewhere on the board
CMP_IN: J1.85 (CMP); also elsewhere on the board
CMP_SHIELD: J1.25 (CMP shield drain); also elsewhere on the board
COIL1: DB3.C10 (PD12); also elsewhere on the board
COIL1_OUT: J1.26 (Ign Coil 1); also elsewhere on the board
COIL2: DB3.C11 (PD13); also elsewhere on the board
COIL2_OUT: J1.104 (IGN Coil 2); also elsewhere on the board
COIL3: DB3.C14 (PD14); also elsewhere on the board
COIL3_OUT: J1.52 (Ign Coil 3); also elsewhere on the board
COIL4: DB3.C15 (PD15); also elsewhere on the board
COIL4_OUT: J1.53 (Ign Coil 4); also elsewhere on the board
COIL5: DB3.C25 (PC6); also elsewhere on the board
COIL5_OUT: J1.27 (Ign Coil 5); also elsewhere on the board
COIL6: DB3.C26 (PC7); also elsewhere on the board
COIL6_OUT: J1.1 (Ign Coil 6); also elsewhere on the board
COIL7: DB3.C27 (PC8); also elsewhere on the board
COIL7_OUT: J1.78 (Ign Coil 7); also elsewhere on the board
COIL8: DB3.C28 (PC9); also elsewhere on the board
COIL8_OUT: J1.79 (Ign Coil 8); also elsewhere on the board
COIL_ARM: DB3.C9 (PD11); also elsewhere on the board
DPFE: DB3.A14 (PF3); also elsewhere on the board
DPFE_IN: J1.65 (DPFE Sensor); also elsewhere on the board
EGR: DB3.A8 (PE6); also elsewhere on the board
EGR_OUT: J1.47 (EVR CTRL); also elsewhere on the board
ENOUT: DB1.A12 (3.3_ENOUT), DB3.A4 (PE2)
EPC: DB3.D32 (PB8); also elsewhere on the board
EPC_OUT: J1.81 (EPC SOL); also elsewhere on the board
EVAP: DB3.A7 (PE5); also elsewhere on the board
EVAP_OUT: J1.56 (VAPOR VALVE); also elsewhere on the board
FAN1: DB3.B30 (PE12); also elsewhere on the board
FAN1_OUT: J1.19; also elsewhere on the board
FAN2: DB3.B33 (PE15); also elsewhere on the board
FAN2_OUT: J1.18; also elsewhere on the board
FLT: DB1.A13 (FLT), DB3.A6 (PE4)
FPUMP: DB3.B23 (PE7); also elsewhere on the board
FPUMP_OUT: J1.80 (FP); also elsewhere on the board
FP_MON: DB3.A23 (PF10); also elsewhere on the board
FP_MON_IN: J1.40 (Fuel Pump Monitor); also elsewhere on the board
FW_391: J1.48; also elsewhere on the board
FW_1138: J1.82; also elsewhere on the board
GND: DB1.A2 (GND), DB1.A8 (GND), DB1.A14 (GND), DB1.B1 (+5V), DB1.B5 (GND), DB1.B6 (GND), DB1.MH1 (STANDOFF), DB1.MH2 (STANDOFF), DB1.MH3 (STANDOFF), DB1.MH4 (STANDOFF), DB3.A1 (GND), DB3.A2 (GND), DB3.A3 (GND), DB3.A17 (GND), DB3.A30 (GND), DB3.A34 (GND), DB3.A35 (GND), DB3.A36 (GND), DB3.B1 (GND), DB3.B3 (GND), DB3.B16 (GND), DB3.B26 (GND), DB3.C1 (GND), DB3.C12 (GND), DB3.C23 (GND), DB3.C35 (GND), DB3.D1 (GND), DB3.D13 (GND), DB3.D23 (GND), DB3.MH1 (STANDOFF), DB3.MH2 (STANDOFF), DB3.MH3 (STANDOFF), DB3.MH4 (STANDOFF), J1.3 (GND), J1.51 (GND), J1.77 (GND), J1.103 (GND); also elsewhere on the board
HTR11: DB3.C16 (PG2); also elsewhere on the board
HTR11_OUT: J1.93 (RF O2 Heat); also elsewhere on the board
HTR12: DB3.C18 (PG4); also elsewhere on the board
HTR12_OUT: J1.95 (RR HO2S Heat); also elsewhere on the board
HTR21: DB3.C17 (PG3); also elsewhere on the board
HTR21_OUT: J1.94 (LF O2 Heat); also elsewhere on the board
HTR22: DB3.C19 (PG5); also elsewhere on the board
HTR22_OUT: J1.96 (LR HO2S Heat); also elsewhere on the board
I2C_SCL: DB1.A6 (SCL), DB3.A12 (PF1)
I2C_SDA: DB1.A10 (SDA), DB3.A11 (PF0)
IAC: DB3.A21 (PF8); also elsewhere on the board
IAC_OUT: J1.83 (IAC); also elsewhere on the board
IAT_IN: J1.39 (IAT); also elsewhere on the board
IGN_WAKE: DB3.A10 (PC13); also elsewhere on the board
IMCC: DB3.C21 (PG7); also elsewhere on the board
IMCC_OUT: J1.46 (Intake Manifold Communicator(I); also elsewhere on the board
INJ1: DB3.B25 (PE9); also elsewhere on the board
INJ1_OUT: J1.75 (Injector 1); also elsewhere on the board
INJ2: DB3.B29 (PE11); also elsewhere on the board
INJ2_OUT: J1.101 (Injector 2); also elsewhere on the board
INJ3: DB3.B31 (PE13); also elsewhere on the board
INJ3_OUT: J1.74 (Injector 3); also elsewhere on the board
INJ4: DB3.B32 (PE14); also elsewhere on the board
INJ4_OUT: J1.100 (Injector 4); also elsewhere on the board
INJ5: DB3.D27 (PB4); also elsewhere on the board
INJ5_OUT: J1.73 (Injector 5); also elsewhere on the board
INJ6: DB3.D28 (PB5); also elsewhere on the board
INJ6_OUT: J1.99 (Injector 6); also elsewhere on the board
INJ7: DB3.C4 (PB14); also elsewhere on the board
INJ7_OUT: J1.72 (Injector 7); also elsewhere on the board
INJ8: DB3.C5 (PB15); also elsewhere on the board
INJ8_OUT: J1.98 (Injector 8); also elsewhere on the board
J1850_NSLEEP: DB3.D25 (PG15); also elsewhere on the board
J1850_RX: DB3.A32 (PA1); also elsewhere on the board
J1850_TXN: DB3.D22 (PG14); also elsewhere on the board
J1850_TXP: DB3.D21 (PG13); also elsewhere on the board
KNOCK: DB3.A28 (PC3); also elsewhere on the board
KNOCK_IN: J1.57 (KNOCK SENSOR); also elsewhere on the board
KNOCK_RTN: J1.32 (KS Sensor); also elsewhere on the board
MAF_IN: J1.88 (MAF); also elsewhere on the board
MAF_RTN: J1.36 (MAF Return); also elsewhere on the board
MUX_OUT: DB3.A33 (PA2); also elsewhere on the board
MUX_S0: DB3.B11 (PB0); also elsewhere on the board
MUX_S1: DB3.B12 (PB1); also elsewhere on the board
MUX_S2: DB3.B8 (PA7); also elsewhere on the board
M_SYNC: DB1.A11 (M_SYNC), DB3.A5 (PE3)
NRST: DB3.A24 (NRST); also elsewhere on the board
O2_11_IN: J1.60 (RF O2); also elsewhere on the board
O2_12_IN: J1.35 (RR HO2S Signal); also elsewhere on the board
O2_21_IN: J1.87 (LF O2); also elsewhere on the board
O2_22_IN: J1.61 (LR HO2S Signal); also elsewhere on the board
O2_BIAS: DB3.B5 (PA4); also elsewhere on the board
O2_DN1: DB3.A19 (PF6); also elsewhere on the board
O2_DN2: DB3.A20 (PF7); also elsewhere on the board
OSS: DB3.D29 (PB6); also elsewhere on the board
OSS_IN: J1.84 (OSS); also elsewhere on the board
PWM_OE: DB3.C29 (PA8); also elsewhere on the board
SCP_N: J1.15 (SCP-); also elsewhere on the board
SCP_P: J1.16 (SCP+); also elsewhere on the board
SD_CK: DB3.D15 (PD6); also elsewhere on the board
SD_CMD: DB3.D16 (PD7); also elsewhere on the board
SD_D0: DB3.D17 (PG9); also elsewhere on the board
SD_PWR_EN: DB3.D19 (PG11); also elsewhere on the board
SIGRTN: J1.91 (SGND); also elsewhere on the board
SPEED: DB3.B7 (PA6); also elsewhere on the board
SSA: DB3.C22 (PG8); also elsewhere on the board
SSA_OUT: J1.6 (Shift SOL(SS1)); also elsewhere on the board
SSB: DB3.C2 (PB12); also elsewhere on the board
SSB_OUT: J1.11 (Shift SOL(SS2)); also elsewhere on the board
SW_RAIL_EN: DB3.D20 (PG12); also elsewhere on the board
TACH: DB3.B6 (PA5); also elsewhere on the board
TCC: DB3.D33 (PB9); also elsewhere on the board
TCC_OUT: J1.54 (TCC SOL); also elsewhere on the board
TCS: DB3.D35 (PE1); also elsewhere on the board
TCS_IN: J1.29 (TCS); also elsewhere on the board
TC_SPEED: DB3.D34 (PE0); also elsewhere on the board
TC_SPEED_IN: J1.7 (TC Speed Sense); also elsewhere on the board
TFT: DB3.A15 (PF4); also elsewhere on the board
TFT_IN: J1.37 (TFT); also elsewhere on the board
TPS_IN: J1.89 (TPS); also elsewhere on the board
TR1: DB3.B14 (PF11); also elsewhere on the board
TR1_IN: J1.34 (Trans Pos Sensor 1); also elsewhere on the board
TR2: DB3.B15 (PF12); also elsewhere on the board
TR2_IN: J1.49 (Trans Pos Sensor 2); also elsewhere on the board
TR3A: DB3.A25 (PC0); also elsewhere on the board
TR3A_IN: J1.64 (Trans Pos Sensor 3 (TR3A) and); also elsewhere on the board
TR4: DB3.B19 (PF14); also elsewhere on the board
TR4_IN: J1.50 (Trans Pos Sensor 4); also elsewhere on the board
TSS: DB3.D30 (PB7); also elsewhere on the board
TSS_IN: J1.59 (TSS Speed Sensor); also elsewhere on the board
USB_DM: DB3.C32 (PA11); also elsewhere on the board
USB_DP: DB3.C33 (PA12); also elsewhere on the board
USB_VBUS: DB3.C30 (PA9); also elsewhere on the board
U_SHDN: DB1.A4 (U_SHDN), DB3.A13 (PF2)
VBAT: DB3.A9 (VBAT); also elsewhere on the board
VBAT_SENSE: J1.55 (B+ KAM); also elsewhere on the board
VENT: DB3.C20 (PG6); also elsewhere on the board
VENT_OUT: J1.67 (Canister Vent); also elsewhere on the board
VIN_ALERT: DB1.A5 (VIN_ALERT), DB3.A16 (PF5)
VPROT: DB1.B3 (+VIN), DB1.B4 (+VIN); also elsewhere on the board
VPWR: J1.71 (12V Switched), J1.97 (12V Switched); also elsewhere on the board
VREF: J1.90 (VREF); also elsewhere on the board
VREF_CS: DB3.A26 (PC1); also elsewhere on the board
VREF_EN: DB3.B13 (PB2); also elsewhere on the board
VREF_FAULT: DB3.A22 (PF9); also elsewhere on the board
VREF_IN1: DB3.B18 (PF13); also elsewhere on the board
VREF_IN2: DB3.B9 (PC4); also elsewhere on the board
VREF_SEL: DB3.B10 (PC5); also elsewhere on the board
VREF_STB: DB3.A27 (PC2); also elsewhere on the board
VSS_OUT: DB3.B2 (PA3); also elsewhere on the board
VSS_OUT_PIN: J1.68 (VSS+); also elsewhere on the board
WDI: DB3.C8 (PD10); also elsewhere on the board

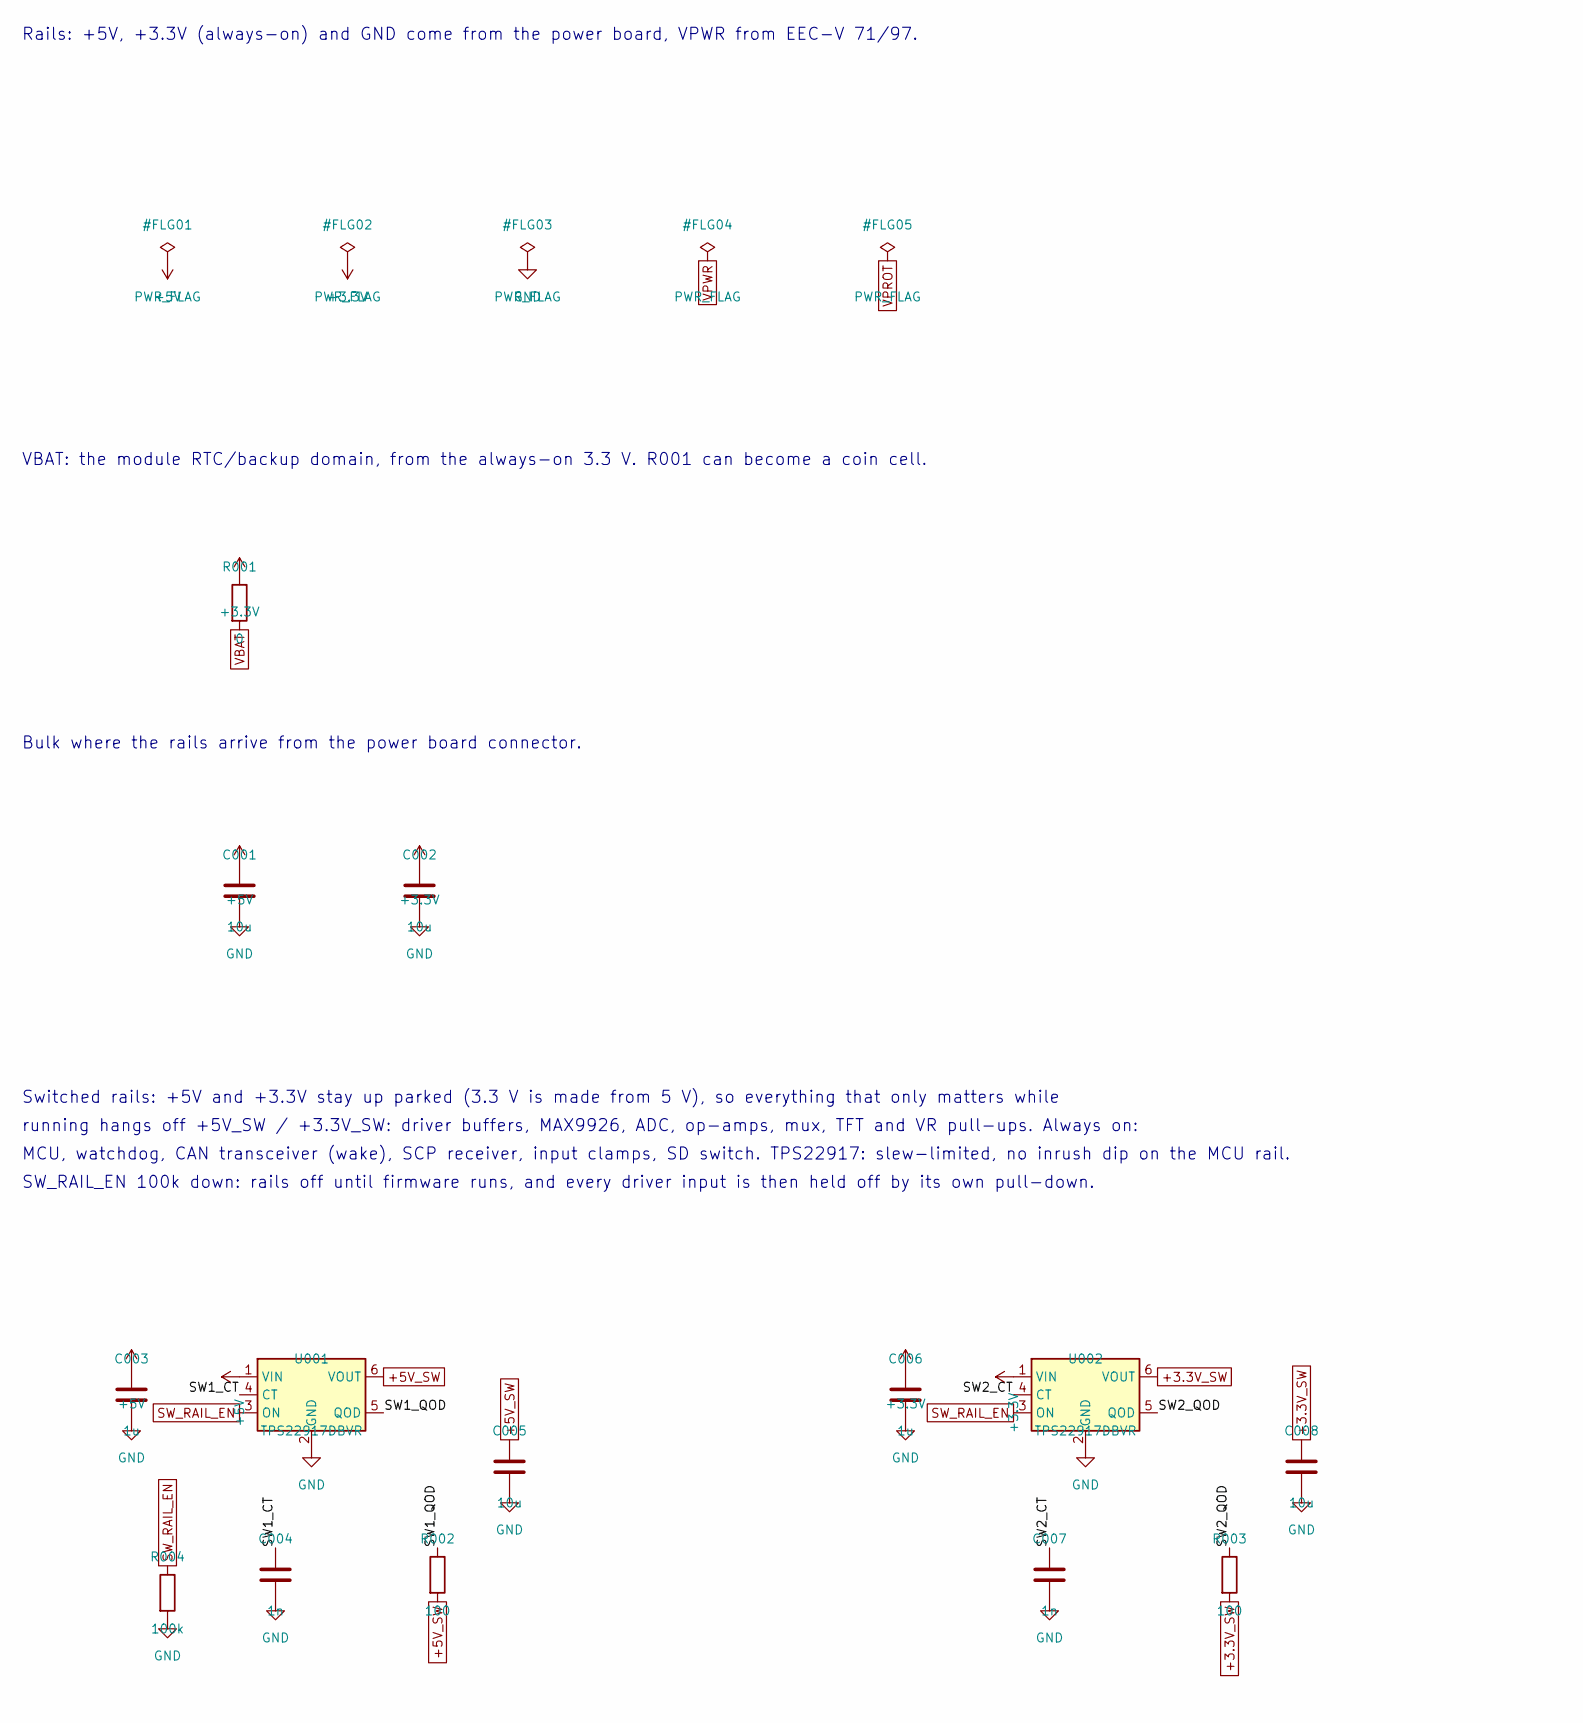
[picture p109: schematic Rails.kicad_sch, TritonECU carrier - Rails]

Parts:
C001, C002: 10u; C_1206_3216Metric_Pad1.33x1.80mm_HandSolder
C003, C006: 1u; C_0805_2012Metric_Pad1.18x1.45mm_HandSolder
C004, C007: 1n; C_0603_1608Metric_Pad1.08x0.95mm_HandSolder
C005, C008: 10u; C_0805_2012Metric_Pad1.18x1.45mm_HandSolder
R001: 0; R_0603_1608Metric_Pad0.98x0.95mm_HandSolder
R002, R003: 100; R_0603_1608Metric_Pad0.98x0.95mm_HandSolder
R004: 100k; R_0603_1608Metric_Pad0.98x0.95mm_HandSolder
U001, U002: TPS22917DBVR; SOT-23-6

Connections:
+3.3V: C002.1, C006.1, R001.1, U002.1 (VIN); also elsewhere on the board
+3.3V_SW: C008.1, R003.2, U002.6 (VOUT); also elsewhere on the board
+5V: C001.1, C003.1, U001.1 (VIN); also elsewhere on the board
+5V_SW: C005.1, R002.2, U001.6 (VOUT); also elsewhere on the board
/Rails/SW1_CT: C004.1, U001.4 (CT)
/Rails/SW1_QOD: R002.1, U001.5 (QOD)
/Rails/SW2_CT: C007.1, U002.4 (CT)
/Rails/SW2_QOD: R003.1, U002.5 (QOD)
GND: C001.2, C002.2, C003.2, C004.2, C005.2, C006.2, C007.2, C008.2, R004.2, U001.2 (GND), U002.2 (GND); also elsewhere on the board
SW_RAIL_EN: R004.1, U001.3 (ON), U002.3 (ON); also elsewhere on the board
VBAT: R001.2; also elsewhere on the board

Notes on the sheet:
Rails: +5V, +3.3V (always-on) and GND come from the power board, VPWR from EEC-V 71/97.
Bulk where the rails arrive from the power board connector.
Switched rails: +5V and +3.3V stay up parked (3.3 V is made from 5 V), so everything that only matters while
running hangs off +5V_SW / +3.3V_SW: driver buffers, MAX9926, ADC, op-amps, mux, TFT and VR pull-ups. Always on:
MCU, watchdog, CAN transceiver (wake), SCP receiver, input clamps, SD switch. TPS22917: slew-limited, no inrush dip on the MCU rail.
SW_RAIL_EN 100k down: rails off until firmware runs, and every driver input is then held off by its own pull-down.
VBAT: the module RTC/backup domain, from the always-on 3.3 V. R001 can become a coin cell.
