alpauna/TritonECU/docs/Schematics/KiCad/TritonECU-Main/TritonECU-Main.kicad_pcb

## KiCad design docs/Schematics/KiCad/TritonECU-Main/TritonECU-Main.kicad_pcb (continued)

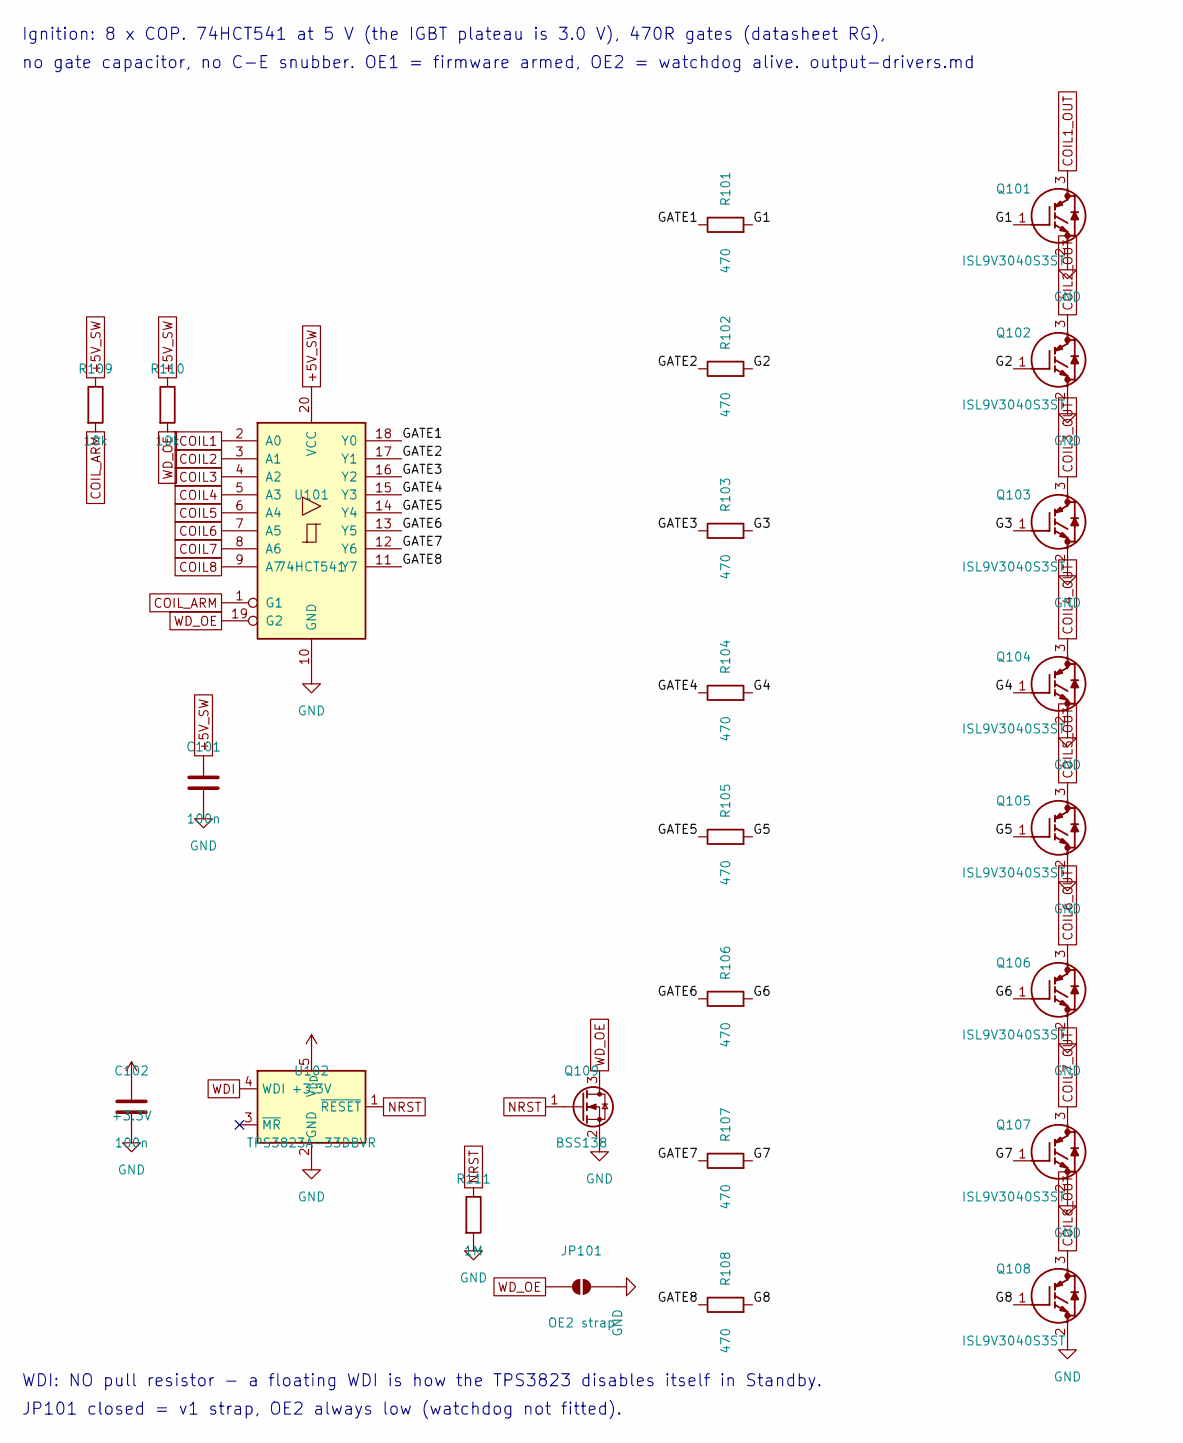
[picture p110: schematic Ignition.kicad_sch, TritonECU carrier - Ignition]

Parts:
C101, C102: 100n; C_0603_1608Metric_Pad1.08x0.95mm_HandSolder
JP101: OE2 strap; SolderJumper-2_P1.3mm_Open_RoundedPad1.0x1.5mm
Q101, Q102, Q103, Q104, Q105, Q106, Q107, Q108: ISL9V3040S3ST
Q109: BSS138; SOT-23
R101, R102, R103, R104, R105, R106, R107, R108: 470; R_0603_1608Metric_Pad0.98x0.95mm_HandSolder
R109, R110: 10k; R_0603_1608Metric_Pad0.98x0.95mm_HandSolder
R111: 1M; R_0603_1608Metric_Pad0.98x0.95mm_HandSolder
U101: 74HCT541; SOIC-20W_7.5x12.8mm_P1.27mm
U102: TPS3823A-33DBVR; SOT-23-5

Connections:
+3.3V: C102.1, U102.5 (V_{DD}); also elsewhere on the board
+5V_SW: C101.1, R109.1, R110.1, U101.20 (VCC); also elsewhere on the board
/Ignition/G1: Q101.1 (G), R101.2
/Ignition/G2: Q102.1 (G), R102.2
/Ignition/G3: Q103.1 (G), R103.2
/Ignition/G4: Q104.1 (G), R104.2
/Ignition/G5: Q105.1 (G), R105.2
/Ignition/G6: Q106.1 (G), R106.2
/Ignition/G7: Q107.1 (G), R107.2
/Ignition/G8: Q108.1 (G), R108.2
/Ignition/GATE1: R101.1, U101.18 (Y0)
/Ignition/GATE2: R102.1, U101.17 (Y1)
/Ignition/GATE3: R103.1, U101.16 (Y2)
/Ignition/GATE4: R104.1, U101.15 (Y3)
/Ignition/GATE5: R105.1, U101.14 (Y4)
/Ignition/GATE6: R106.1, U101.13 (Y5)
/Ignition/GATE7: R107.1, U101.12 (Y6)
/Ignition/GATE8: R108.1, U101.11 (Y7)
COIL1: U101.2 (A0); also elsewhere on the board
COIL1_OUT: Q101.3 (C); also elsewhere on the board
COIL2: U101.3 (A1); also elsewhere on the board
COIL2_OUT: Q102.3 (C); also elsewhere on the board
COIL3: U101.4 (A2); also elsewhere on the board
COIL3_OUT: Q103.3 (C); also elsewhere on the board
COIL4: U101.5 (A3); also elsewhere on the board
COIL4_OUT: Q104.3 (C); also elsewhere on the board
COIL5: U101.6 (A4); also elsewhere on the board
COIL5_OUT: Q105.3 (C); also elsewhere on the board
COIL6: U101.7 (A5); also elsewhere on the board
COIL6_OUT: Q106.3 (C); also elsewhere on the board
COIL7: U101.8 (A6); also elsewhere on the board
COIL7_OUT: Q107.3 (C); also elsewhere on the board
COIL8: U101.9 (A7); also elsewhere on the board
COIL8_OUT: Q108.3 (C); also elsewhere on the board
COIL_ARM: R109.2, U101.1 (G1); also elsewhere on the board
GND: C101.2, C102.2, JP101.2 (B), Q101.2 (E), Q102.2 (E), Q103.2 (E), Q104.2 (E), Q105.2 (E), Q106.2 (E), Q107.2 (E), Q108.2 (E), Q109.2 (S), R111.2, U101.10 (GND), U102.2 (GND); also elsewhere on the board
NRST: Q109.1 (G), R111.1, U102.1 (~RESET); also elsewhere on the board
WDI: U102.4 (WDI); also elsewhere on the board
WD_OE: JP101.1 (A), Q109.3 (D), R110.2, U101.19 (G2); also elsewhere on the board

Notes on the sheet:
Ignition: 8 x COP. 74HCT541 at 5 V (the IGBT plateau is 3.0 V), 470R gates (datasheet RG),
no gate capacitor, no C-E snubber. OE1 = firmware armed, OE2 = watchdog alive. output-drivers.md
WDI: NO pull resistor - a floating WDI is how the TPS3823 disables itself in Standby.
JP101 closed = v1 strap, OE2 always low (watchdog not fitted).

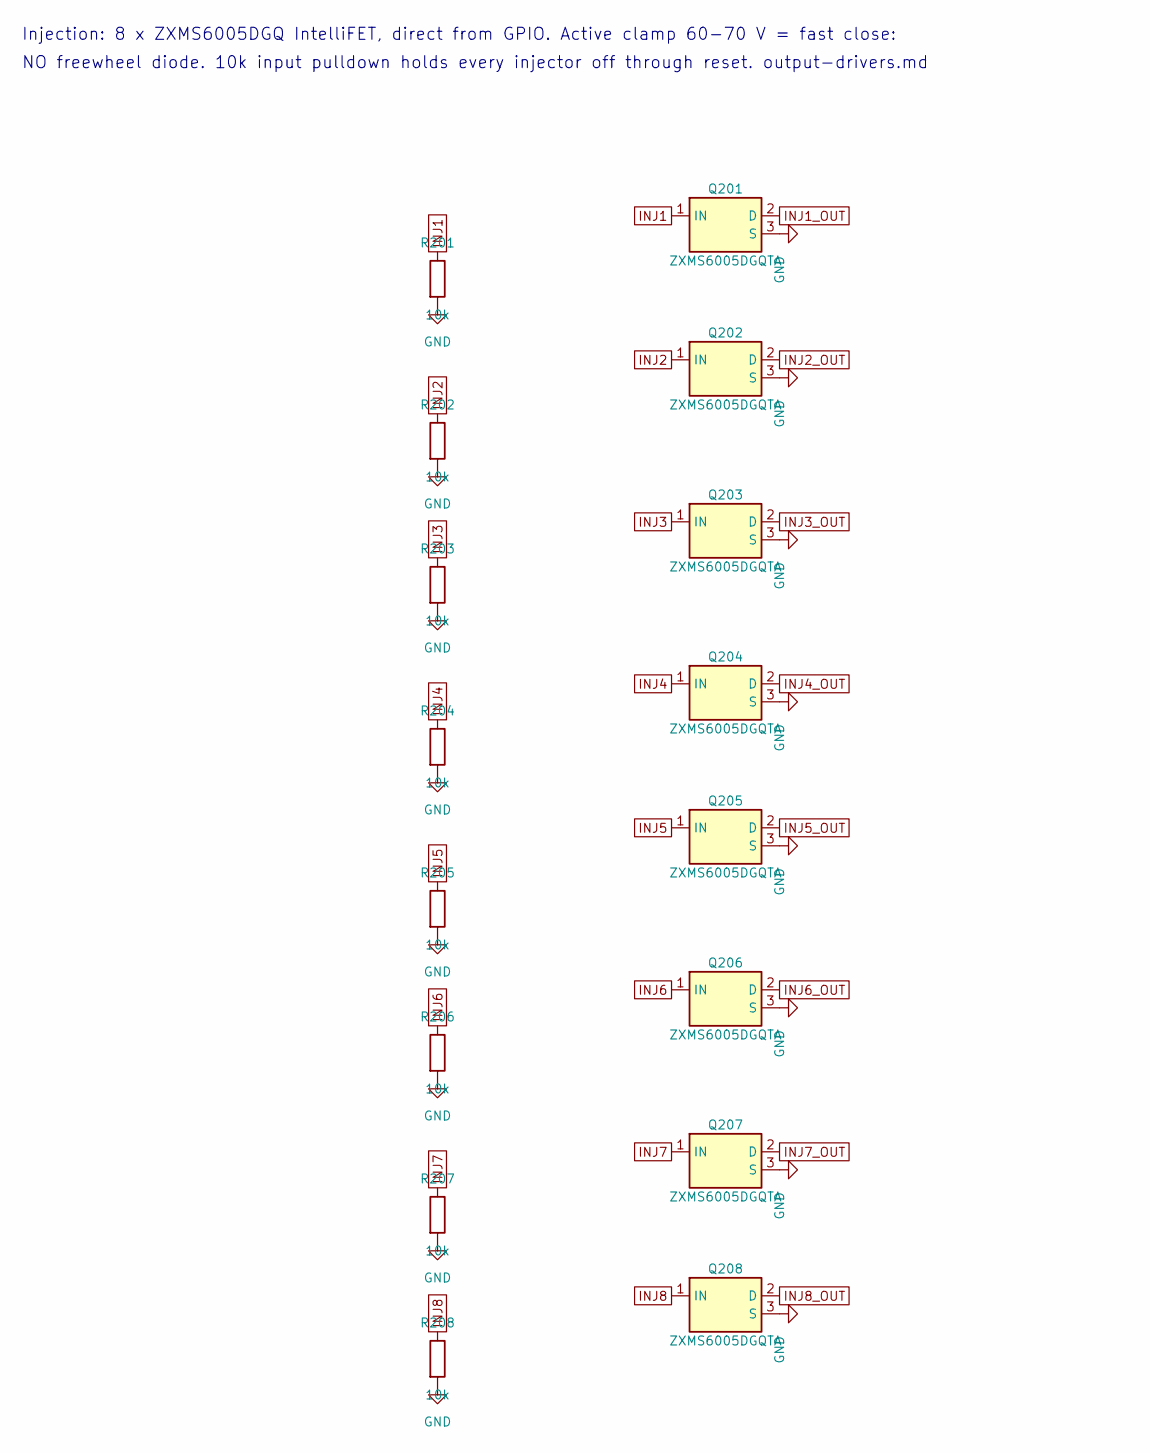
[picture p111: schematic Injection.kicad_sch, TritonECU carrier - Injection]

Parts:
Q201, Q202, Q203, Q204, Q205, Q206, Q207, Q208: ZXMS6005DGQTA; SOT-223-3_TabPin2
R201, R202, R203, R204, R205, R206, R207, R208: 10k; R_0603_1608Metric_Pad0.98x0.95mm_HandSolder

Connections:
GND: Q201.3 (S), Q202.3 (S), Q203.3 (S), Q204.3 (S), Q205.3 (S), Q206.3 (S), Q207.3 (S), Q208.3 (S), R201.2, R202.2, R203.2, R204.2, R205.2, R206.2, R207.2, R208.2; also elsewhere on the board
INJ1: Q201.1 (IN), R201.1; also elsewhere on the board
INJ1_OUT: Q201.2 (D); also elsewhere on the board
INJ2: Q202.1 (IN), R202.1; also elsewhere on the board
INJ2_OUT: Q202.2 (D); also elsewhere on the board
INJ3: Q203.1 (IN), R203.1; also elsewhere on the board
INJ3_OUT: Q203.2 (D); also elsewhere on the board
INJ4: Q204.1 (IN), R204.1; also elsewhere on the board
INJ4_OUT: Q204.2 (D); also elsewhere on the board
INJ5: Q205.1 (IN), R205.1; also elsewhere on the board
INJ5_OUT: Q205.2 (D); also elsewhere on the board
INJ6: Q206.1 (IN), R206.1; also elsewhere on the board
INJ6_OUT: Q206.2 (D); also elsewhere on the board
INJ7: Q207.1 (IN), R207.1; also elsewhere on the board
INJ7_OUT: Q207.2 (D); also elsewhere on the board
INJ8: Q208.1 (IN), R208.1; also elsewhere on the board
INJ8_OUT: Q208.2 (D); also elsewhere on the board

Notes on the sheet:
Injection: 8 x ZXMS6005DGQ IntelliFET, direct from GPIO. Active clamp 60-70 V = fast close:
NO freewheel diode. 10k input pulldown holds every injector off through reset. output-drivers.md

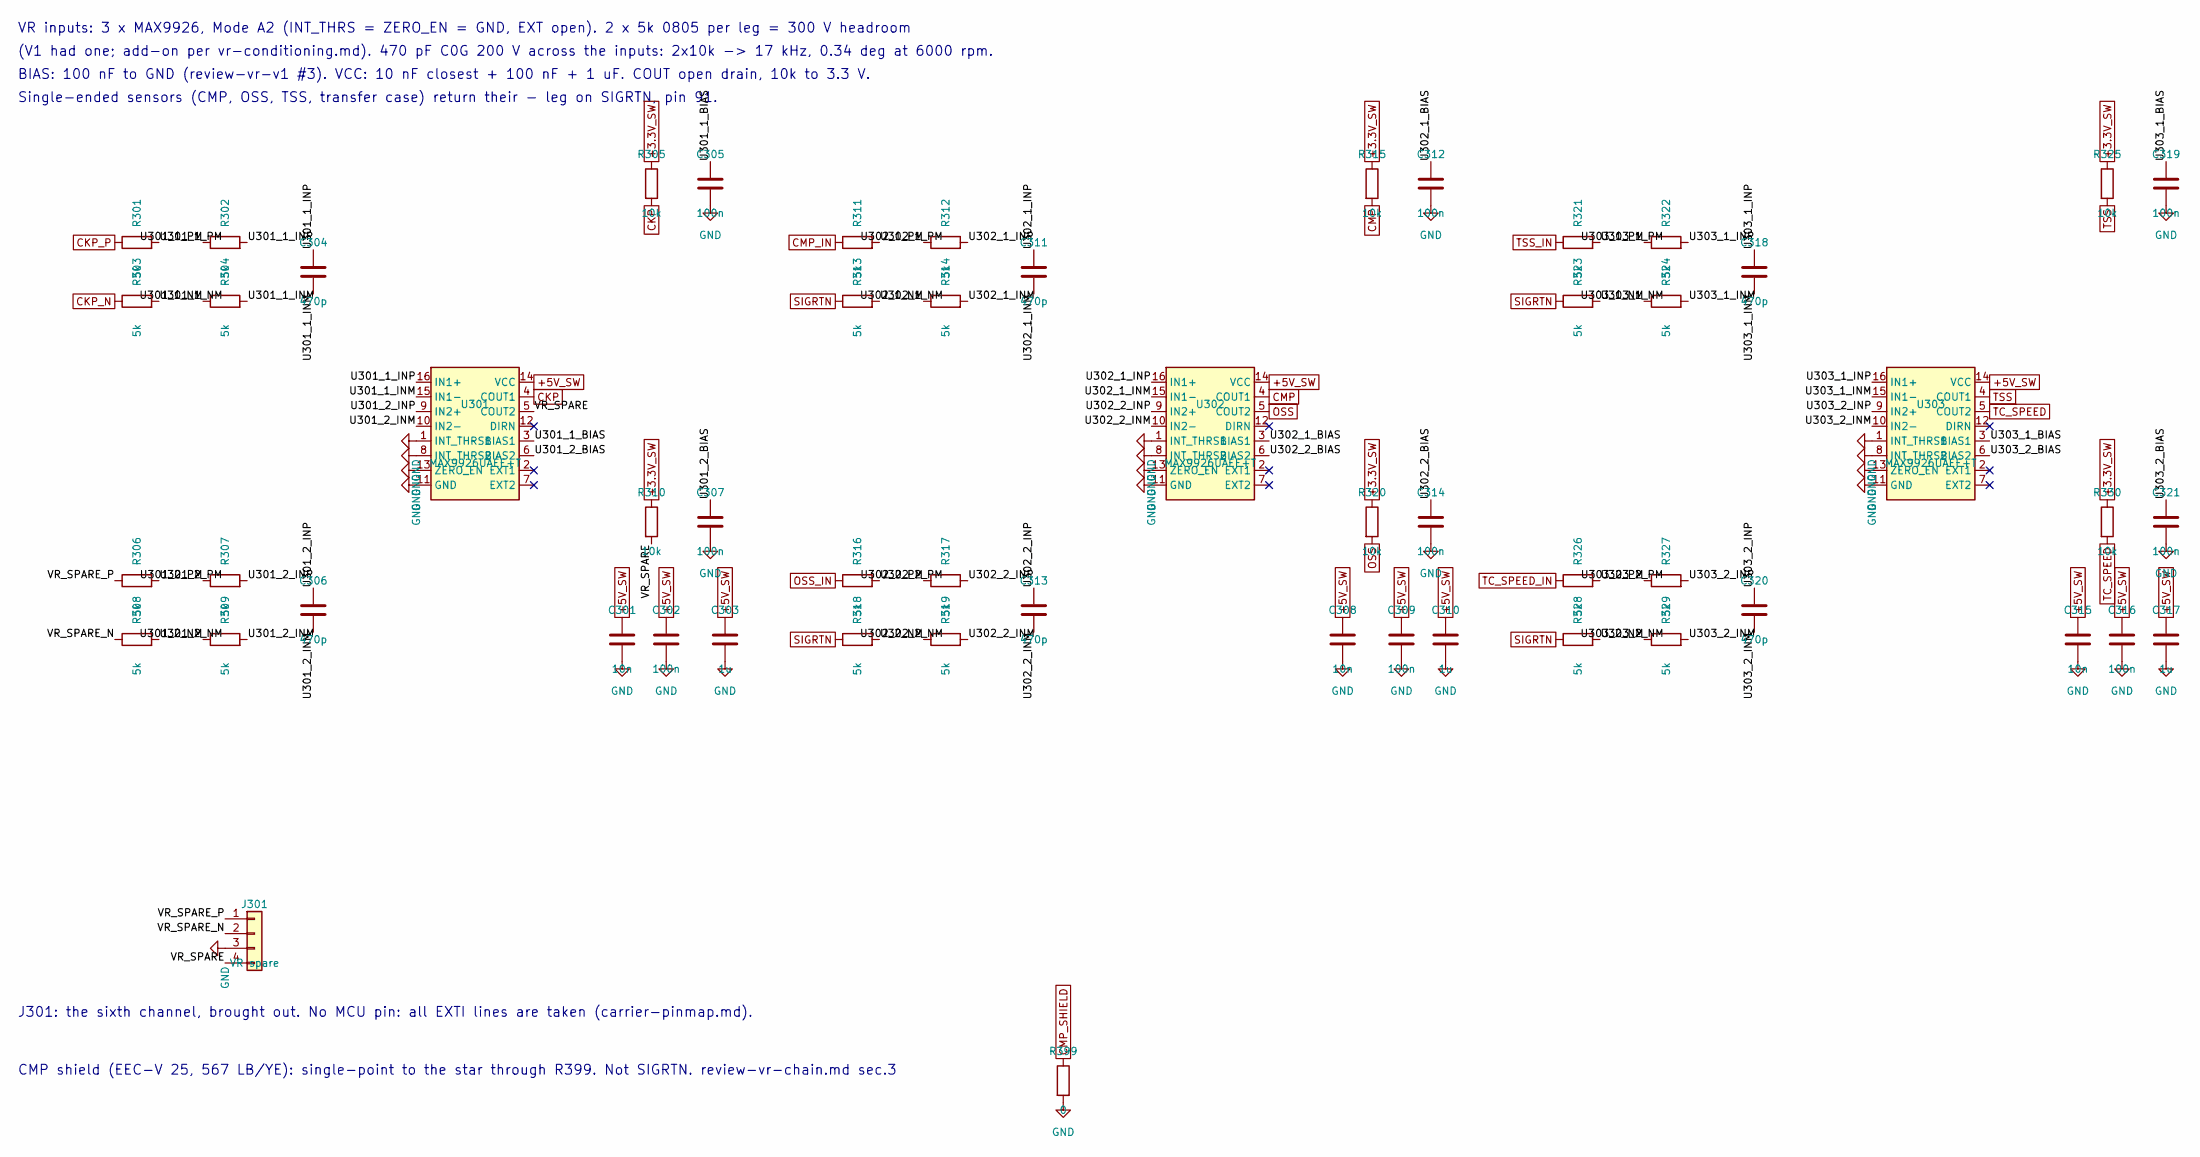
[picture p112: schematic Vr.kicad_sch, TritonECU carrier - VR]

Parts:
C301, C308, C315: 10n; C_0603_1608Metric_Pad1.08x0.95mm_HandSolder
C302, C305, C307, C309, C312, C314, C316, C319, C321: 100n; C_0603_1608Metric_Pad1.08x0.95mm_HandSolder
C303, C310, C317: 1u; C_0603_1608Metric_Pad1.08x0.95mm_HandSolder
C304, C306, C311, C313, C318, C320: 470p; C_0805_2012Metric_Pad1.18x1.45mm_HandSolder
J301: VR spare; PinHeader_1x04_P2.54mm_Vertical
R301, R302, R303, R304, R306, R307, R308, R309, R311, R312, R313, R314, R316, R317, R318, R319, R321, R322, R323, R324, R326, R327, R328, R329: 5k; R_0805_2012Metric_Pad1.20x1.40mm_HandSolder
R305, R310, R315, R320, R325, R330: 10k; R_0603_1608Metric_Pad0.98x0.95mm_HandSolder
R399: 0; R_0603_1608Metric_Pad0.98x0.95mm_HandSolder
U301, U302, U303: MAX9926UAEE+T; QSOP-16_3.9x4.9mm_P0.635mm

Connections:
+3.3V_SW: R305.1, R310.1, R315.1, R320.1, R325.1, R330.1; also elsewhere on the board
+5V_SW: C301.1, C302.1, C303.1, C308.1, C309.1, C310.1, C315.1, C316.1, C317.1, U301.14 (VCC), U302.14 (VCC), U303.14 (VCC); also elsewhere on the board
/VR/U301_1_BIAS: C305.1, U301.3 (BIAS1)
/VR/U301_1_INM: C304.2, R304.2, U301.15 (IN1-)
/VR/U301_1_INP: C304.1, R302.2, U301.16 (IN1+)
/VR/U301_1_NM: R303.2, R304.1
/VR/U301_1_PM: R301.2, R302.1
/VR/U301_2_BIAS: C307.1, U301.6 (BIAS2)
/VR/U301_2_INM: C306.2, R309.2, U301.10 (IN2-)
/VR/U301_2_INP: C306.1, R307.2, U301.9 (IN2+)
/VR/U301_2_NM: R308.2, R309.1
/VR/U301_2_PM: R306.2, R307.1
/VR/U302_1_BIAS: C312.1, U302.3 (BIAS1)
/VR/U302_1_INM: C311.2, R314.2, U302.15 (IN1-)
/VR/U302_1_INP: C311.1, R312.2, U302.16 (IN1+)
/VR/U302_1_NM: R313.2, R314.1
/VR/U302_1_PM: R311.2, R312.1
/VR/U302_2_BIAS: C314.1, U302.6 (BIAS2)
/VR/U302_2_INM: C313.2, R319.2, U302.10 (IN2-)
/VR/U302_2_INP: C313.1, R317.2, U302.9 (IN2+)
/VR/U302_2_NM: R318.2, R319.1
/VR/U302_2_PM: R316.2, R317.1
/VR/U303_1_BIAS: C319.1, U303.3 (BIAS1)
/VR/U303_1_INM: C318.2, R324.2, U303.15 (IN1-)
/VR/U303_1_INP: C318.1, R322.2, U303.16 (IN1+)
/VR/U303_1_NM: R323.2, R324.1
/VR/U303_1_PM: R321.2, R322.1
/VR/U303_2_BIAS: C321.1, U303.6 (BIAS2)
/VR/U303_2_INM: C320.2, R329.2, U303.10 (IN2-)
/VR/U303_2_INP: C320.1, R327.2, U303.9 (IN2+)
/VR/U303_2_NM: R328.2, R329.1
/VR/U303_2_PM: R326.2, R327.1
/VR/VR_SPARE: J301.4, R310.2, U301.5 (COUT2)
/VR/VR_SPARE_N: J301.2, R308.1
/VR/VR_SPARE_P: J301.1, R306.1
CKP: R305.2, U301.4 (COUT1); also elsewhere on the board
CKP_N: R303.1; also elsewhere on the board
CKP_P: R301.1; also elsewhere on the board
CMP: R315.2, U302.4 (COUT1); also elsewhere on the board
CMP_IN: R311.1; also elsewhere on the board
CMP_SHIELD: R399.1; also elsewhere on the board
GND: C301.2, C302.2, C303.2, C305.2, C307.2, C308.2, C309.2, C310.2, C312.2, C314.2, C315.2, C316.2, C317.2, C319.2, C321.2, J301.3, R399.2, U301.1 (INT_THRS1), U301.8 (INT_THRS2), U301.11 (GND), U301.13 (ZERO_EN), U302.1 (INT_THRS1), U302.8 (INT_THRS2), U302.11 (GND), U302.13 (ZERO_EN), U303.1 (INT_THRS1), U303.8 (INT_THRS2), U303.11 (GND), U303.13 (ZERO_EN); also elsewhere on the board
OSS: R320.2, U302.5 (COUT2); also elsewhere on the board
OSS_IN: R316.1; also elsewhere on the board
SIGRTN: R313.1, R318.1, R323.1, R328.1; also elsewhere on the board
TC_SPEED: R330.2, U303.5 (COUT2); also elsewhere on the board
TC_SPEED_IN: R326.1; also elsewhere on the board
TSS: R325.2, U303.4 (COUT1); also elsewhere on the board
TSS_IN: R321.1; also elsewhere on the board

Notes on the sheet:
VR inputs: 3 x MAX9926, Mode A2 (INT_THRS = ZERO_EN = GND, EXT open). 2 x 5k 0805 per leg = 300 V headroom
(V1 had one; add-on per vr-conditioning.md). 470 pF C0G 200 V across the inputs: 2x10k -> 17 kHz, 0.34 deg at 6000 rpm.
BIAS: 100 nF to GND (review-vr-v1 #3). VCC: 10 nF closest + 100 nF + 1 uF. COUT open drain, 10k to 3.3 V.
Single-ended sensors (CMP, OSS, TSS, transfer case) return their - leg on SIGRTN, pin 91.
J301: the sixth channel, brought out. No MCU pin: all EXTI lines are taken (carrier-pinmap.md).
CMP shield (EEC-V 25, 567 LB/YE): single-point to the star through R399. Not SIGRTN. review-vr-chain.md sec.3

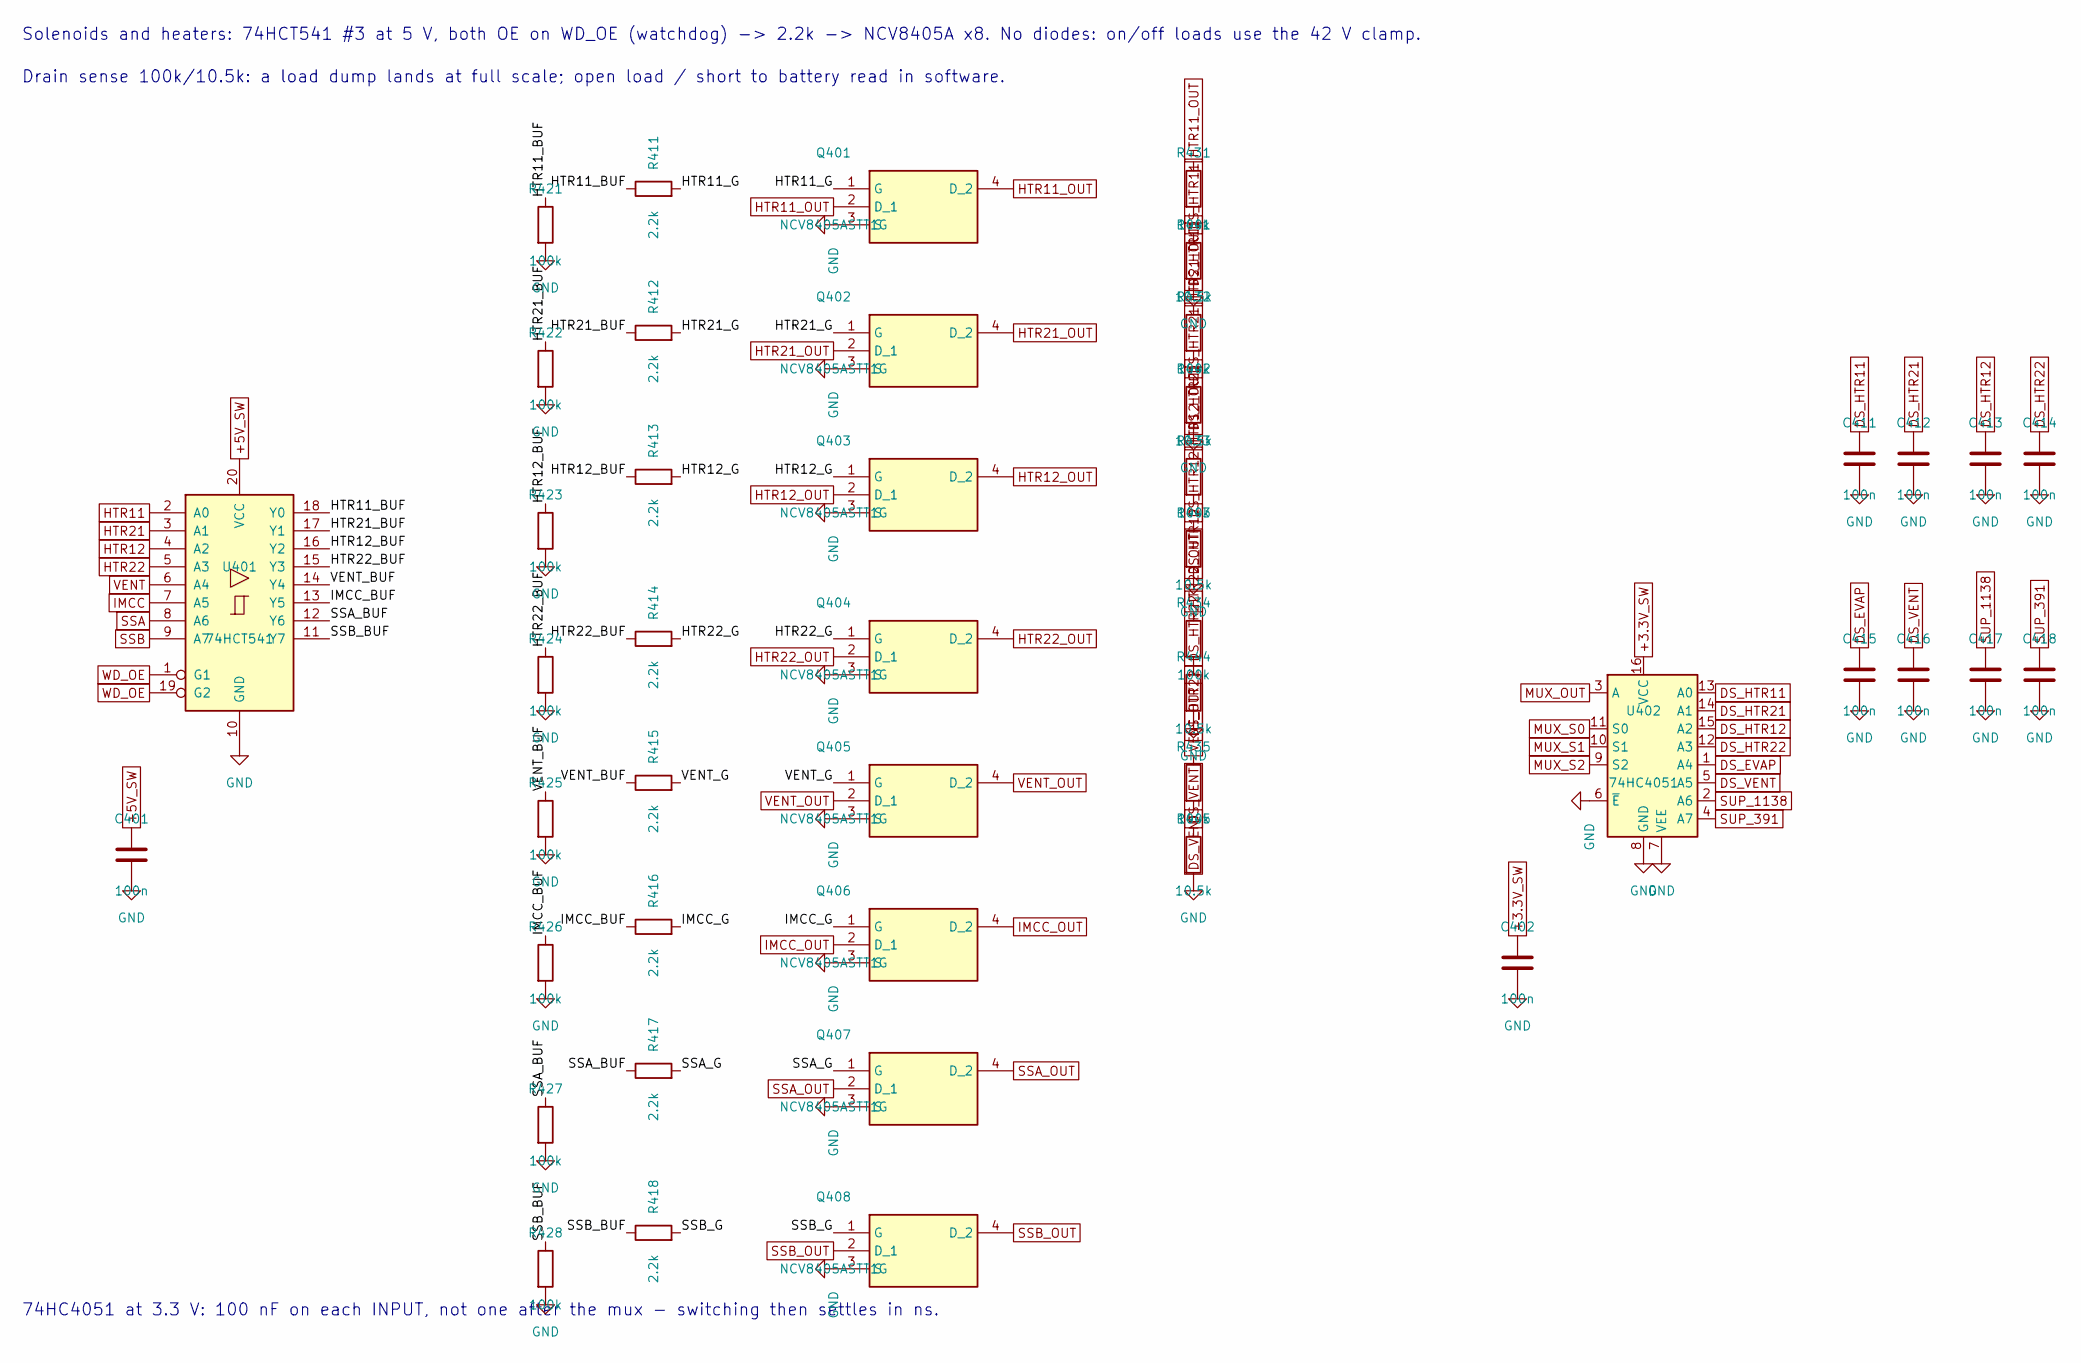
[picture p113: schematic Solenoids.kicad_sch, TritonECU carrier - Solenoids]

Parts:
C401, C402, C411, C412, C413, C414, C415, C416, C417, C418: 100n; C_0603_1608Metric_Pad1.08x0.95mm_HandSolder
Q401, Q402, Q403, Q404, Q405, Q406, Q407, Q408: NCV8405ASTT1G; SOT230P700X175-4N
R411, R412, R413, R414, R415, R416, R417, R418: 2.2k; R_0603_1608Metric_Pad0.98x0.95mm_HandSolder
R421, R422, R423, R424, R425, R426, R427, R428, R431, R432, R433, R434, R435: 100k; R_0603_1608Metric_Pad0.98x0.95mm_HandSolder
R441, R442, R443, R444, R445: 10.5k; R_0603_1608Metric_Pad0.98x0.95mm_HandSolder
U401: 74HCT541; SOIC-20W_7.5x12.8mm_P1.27mm
U402: 74HC4051; TSSOP-16_4.4x5mm_P0.65mm

Connections:
+3.3V_SW: C402.1, U402.16 (VCC); also elsewhere on the board
+5V_SW: C401.1, U401.20 (VCC); also elsewhere on the board
/Solenoids/HTR11_BUF: R411.1, R421.1, U401.18 (Y0)
/Solenoids/HTR11_G: Q401.1 (G), R411.2
/Solenoids/HTR12_BUF: R413.1, R423.1, U401.16 (Y2)
/Solenoids/HTR12_G: Q403.1 (G), R413.2
/Solenoids/HTR21_BUF: R412.1, R422.1, U401.17 (Y1)
/Solenoids/HTR21_G: Q402.1 (G), R412.2
/Solenoids/HTR22_BUF: R414.1, R424.1, U401.15 (Y3)
/Solenoids/HTR22_G: Q404.1 (G), R414.2
/Solenoids/IMCC_BUF: R416.1, R426.1, U401.13 (Y5)
/Solenoids/IMCC_G: Q406.1 (G), R416.2
/Solenoids/SSA_BUF: R417.1, R427.1, U401.12 (Y6)
/Solenoids/SSA_G: Q407.1 (G), R417.2
/Solenoids/SSB_BUF: R418.1, R428.1, U401.11 (Y7)
/Solenoids/SSB_G: Q408.1 (G), R418.2
/Solenoids/VENT_BUF: R415.1, R425.1, U401.14 (Y4)
/Solenoids/VENT_G: Q405.1 (G), R415.2
DS_EVAP: C415.1, U402.1 (A4); also elsewhere on the board
DS_HTR11: C411.1, R431.2, R441.1, U402.13 (A0)
DS_HTR12: C413.1, R433.2, R443.1, U402.15 (A2)
DS_HTR21: C412.1, R432.2, R442.1, U402.14 (A1)
DS_HTR22: C414.1, R434.2, R444.1, U402.12 (A3)
DS_VENT: C416.1, R435.2, R445.1, U402.5 (A5)
GND: C401.2, C402.2, C411.2, C412.2, C413.2, C414.2, C415.2, C416.2, C417.2, C418.2, Q401.3 (S), Q402.3 (S), Q403.3 (S), Q404.3 (S), Q405.3 (S), Q406.3 (S), Q407.3 (S), Q408.3 (S), R421.2, R422.2, R423.2, R424.2, R425.2, R426.2, R427.2, R428.2, R441.2, R442.2, R443.2, R444.2, R445.2, U401.10 (GND), U402.6 (~E), U402.7 (VEE), U402.8 (GND); also elsewhere on the board
HTR11: U401.2 (A0); also elsewhere on the board
HTR11_OUT: Q401.2 (D_1), Q401.4 (D_2), R431.1; also elsewhere on the board
HTR12: U401.4 (A2); also elsewhere on the board
HTR12_OUT: Q403.2 (D_1), Q403.4 (D_2), R433.1; also elsewhere on the board
HTR21: U401.3 (A1); also elsewhere on the board
HTR21_OUT: Q402.2 (D_1), Q402.4 (D_2), R432.1; also elsewhere on the board
HTR22: U401.5 (A3); also elsewhere on the board
HTR22_OUT: Q404.2 (D_1), Q404.4 (D_2), R434.1; also elsewhere on the board
IMCC: U401.7 (A5); also elsewhere on the board
IMCC_OUT: Q406.2 (D_1), Q406.4 (D_2); also elsewhere on the board
MUX_OUT: U402.3 (A); also elsewhere on the board
MUX_S0: U402.11 (S0); also elsewhere on the board
MUX_S1: U402.10 (S1); also elsewhere on the board
MUX_S2: U402.9 (S2); also elsewhere on the board
SSA: U401.8 (A6); also elsewhere on the board
SSA_OUT: Q407.2 (D_1), Q407.4 (D_2); also elsewhere on the board
SSB: U401.9 (A7); also elsewhere on the board
SSB_OUT: Q408.2 (D_1), Q408.4 (D_2); also elsewhere on the board
SUP_391: C418.1, U402.4 (A7); also elsewhere on the board
SUP_1138: C417.1, U402.2 (A6); also elsewhere on the board
VENT: U401.6 (A4); also elsewhere on the board
VENT_OUT: Q405.2 (D_1), Q405.4 (D_2), R435.1; also elsewhere on the board
WD_OE: U401.1 (G1), U401.19 (G2); also elsewhere on the board

Notes on the sheet:
Solenoids and heaters: 74HCT541 #3 at 5 V, both OE on WD_OE (watchdog) -> 2.2k -> NCV8405A x8. No diodes: on/off loads use the 42 V clamp.
Drain sense 100k/10.5k: a load dump lands at full scale; open load / short to battery read in software.
74HC4051 at 3.3 V: 100 nF on each INPUT, not one after the mux - switching then settles in ns.

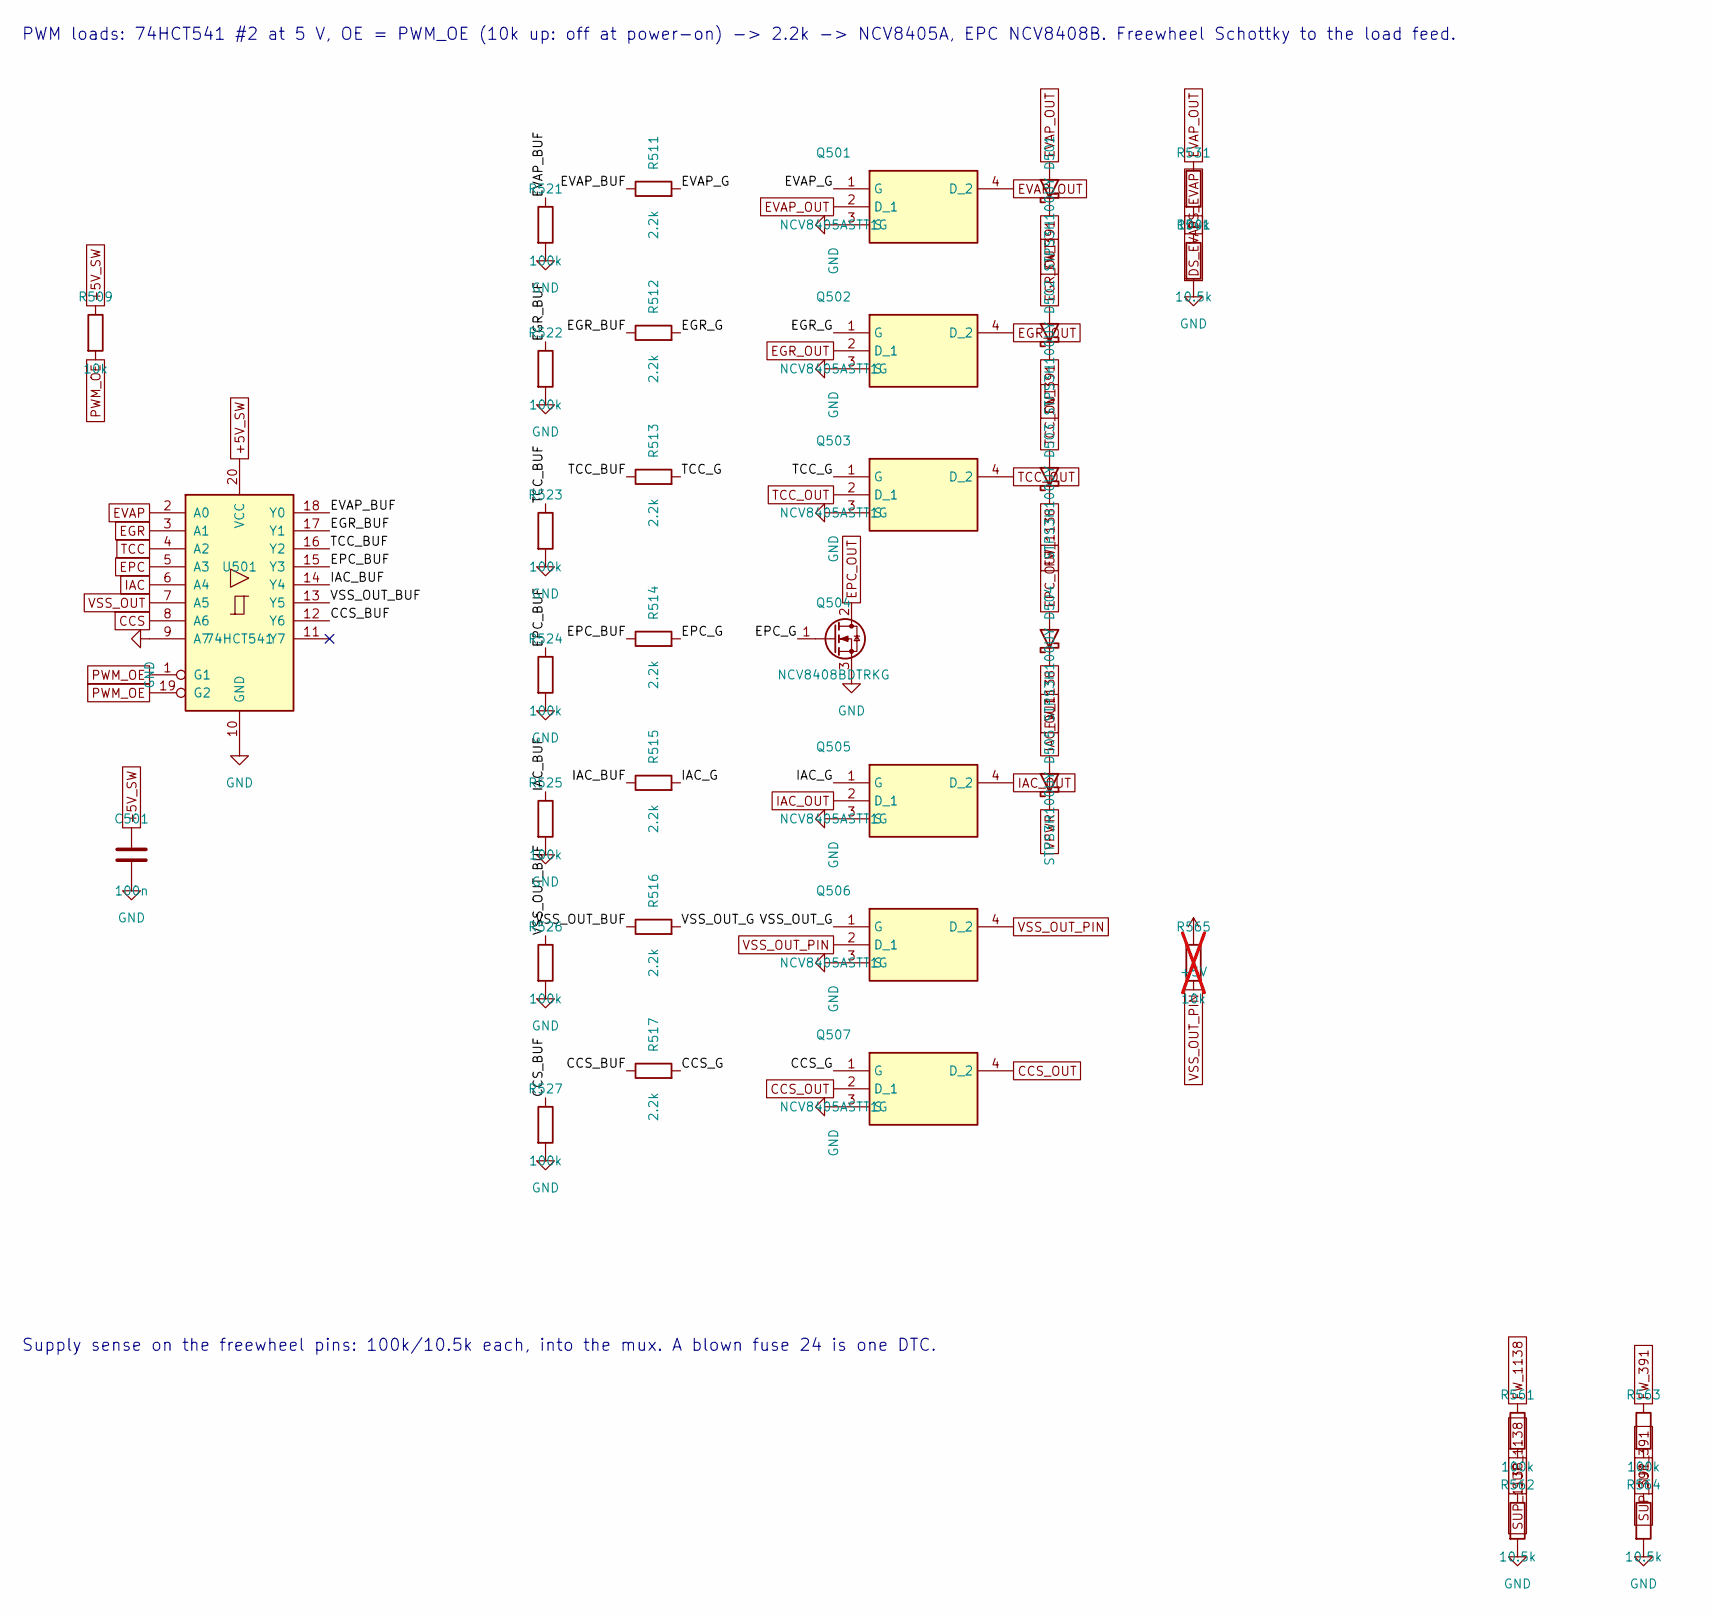
[picture p114: schematic Pwm.kicad_sch, TritonECU carrier - PWM]

Parts:
C501: 100n; C_0603_1608Metric_Pad1.08x0.95mm_HandSolder
D501, D502, D503, D504, D505: STPS3H100UY; D_SMB
Q501, Q502, Q503, Q505, Q506, Q507: NCV8405ASTT1G; SOT230P700X175-4N
Q504: NCV8408BDTRKG; TO-252-2
R509: 10k; R_0603_1608Metric_Pad0.98x0.95mm_HandSolder
R511, R512, R513, R514, R515, R516, R517: 2.2k; R_0603_1608Metric_Pad0.98x0.95mm_HandSolder
R521, R522, R523, R524, R525, R526, R527, R531, R561, R563: 100k; R_0603_1608Metric_Pad0.98x0.95mm_HandSolder
R541, R562, R564: 10.5k; R_0603_1608Metric_Pad0.98x0.95mm_HandSolder
R565: 10k; R_0603_1608Metric_Pad0.98x0.95mm_HandSolder; not fitted
U501: 74HCT541; SOIC-20W_7.5x12.8mm_P1.27mm

Connections:
+5V: R565.1; also elsewhere on the board
+5V_SW: C501.1, R509.1, U501.20 (VCC); also elsewhere on the board
/PWM/CCS_BUF: R517.1, R527.1, U501.12 (Y6)
/PWM/CCS_G: Q507.1 (G), R517.2
/PWM/EGR_BUF: R512.1, R522.1, U501.17 (Y1)
/PWM/EGR_G: Q502.1 (G), R512.2
/PWM/EPC_BUF: R514.1, R524.1, U501.15 (Y3)
/PWM/EPC_G: Q504.1 (G), R514.2
/PWM/EVAP_BUF: R511.1, R521.1, U501.18 (Y0)
/PWM/EVAP_G: Q501.1 (G), R511.2
/PWM/IAC_BUF: R515.1, R525.1, U501.14 (Y4)
/PWM/IAC_G: Q505.1 (G), R515.2
/PWM/TCC_BUF: R513.1, R523.1, U501.16 (Y2)
/PWM/TCC_G: Q503.1 (G), R513.2
/PWM/VSS_OUT_BUF: R516.1, R526.1, U501.13 (Y5)
/PWM/VSS_OUT_G: Q506.1 (G), R516.2
CCS: U501.8 (A6); also elsewhere on the board
CCS_OUT: Q507.2 (D_1), Q507.4 (D_2); also elsewhere on the board
DS_EVAP: R531.2, R541.1; also elsewhere on the board
EGR: U501.3 (A1); also elsewhere on the board
EGR_OUT: D502.2 (A), Q502.2 (D_1), Q502.4 (D_2); also elsewhere on the board
EPC: U501.5 (A3); also elsewhere on the board
EPC_OUT: D504.2 (A), Q504.2 (D); also elsewhere on the board
EVAP: U501.2 (A0); also elsewhere on the board
EVAP_OUT: D501.2 (A), Q501.2 (D_1), Q501.4 (D_2), R531.1; also elsewhere on the board
FW_391: D501.1 (K), D502.1 (K), R563.1; also elsewhere on the board
FW_1138: D503.1 (K), D504.1 (K), R561.1; also elsewhere on the board
GND: C501.2, Q501.3 (S), Q502.3 (S), Q503.3 (S), Q504.3 (S), Q505.3 (S), Q506.3 (S), Q507.3 (S), R521.2, R522.2, R523.2, R524.2, R525.2, R526.2, R527.2, R541.2, R562.2, R564.2, U501.9 (A7), U501.10 (GND); also elsewhere on the board
IAC: U501.6 (A4); also elsewhere on the board
IAC_OUT: D505.2 (A), Q505.2 (D_1), Q505.4 (D_2); also elsewhere on the board
PWM_OE: R509.2, U501.1 (G1), U501.19 (G2); also elsewhere on the board
SUP_391: R563.2, R564.1; also elsewhere on the board
SUP_1138: R561.2, R562.1; also elsewhere on the board
TCC: U501.4 (A2); also elsewhere on the board
TCC_OUT: D503.2 (A), Q503.2 (D_1), Q503.4 (D_2); also elsewhere on the board
VPWR: D505.1 (K); also elsewhere on the board
VSS_OUT: U501.7 (A5); also elsewhere on the board
VSS_OUT_PIN: Q506.2 (D_1), Q506.4 (D_2), R565.2; also elsewhere on the board

Notes on the sheet:
PWM loads: 74HCT541 #2 at 5 V, OE = PWM_OE (10k up: off at power-on) -> 2.2k -> NCV8405A, EPC NCV8408B. Freewheel Schottky to the load feed.
Supply sense on the freewheel pins: 100k/10.5k each, into the mux. A blown fuse 24 is one DTC.

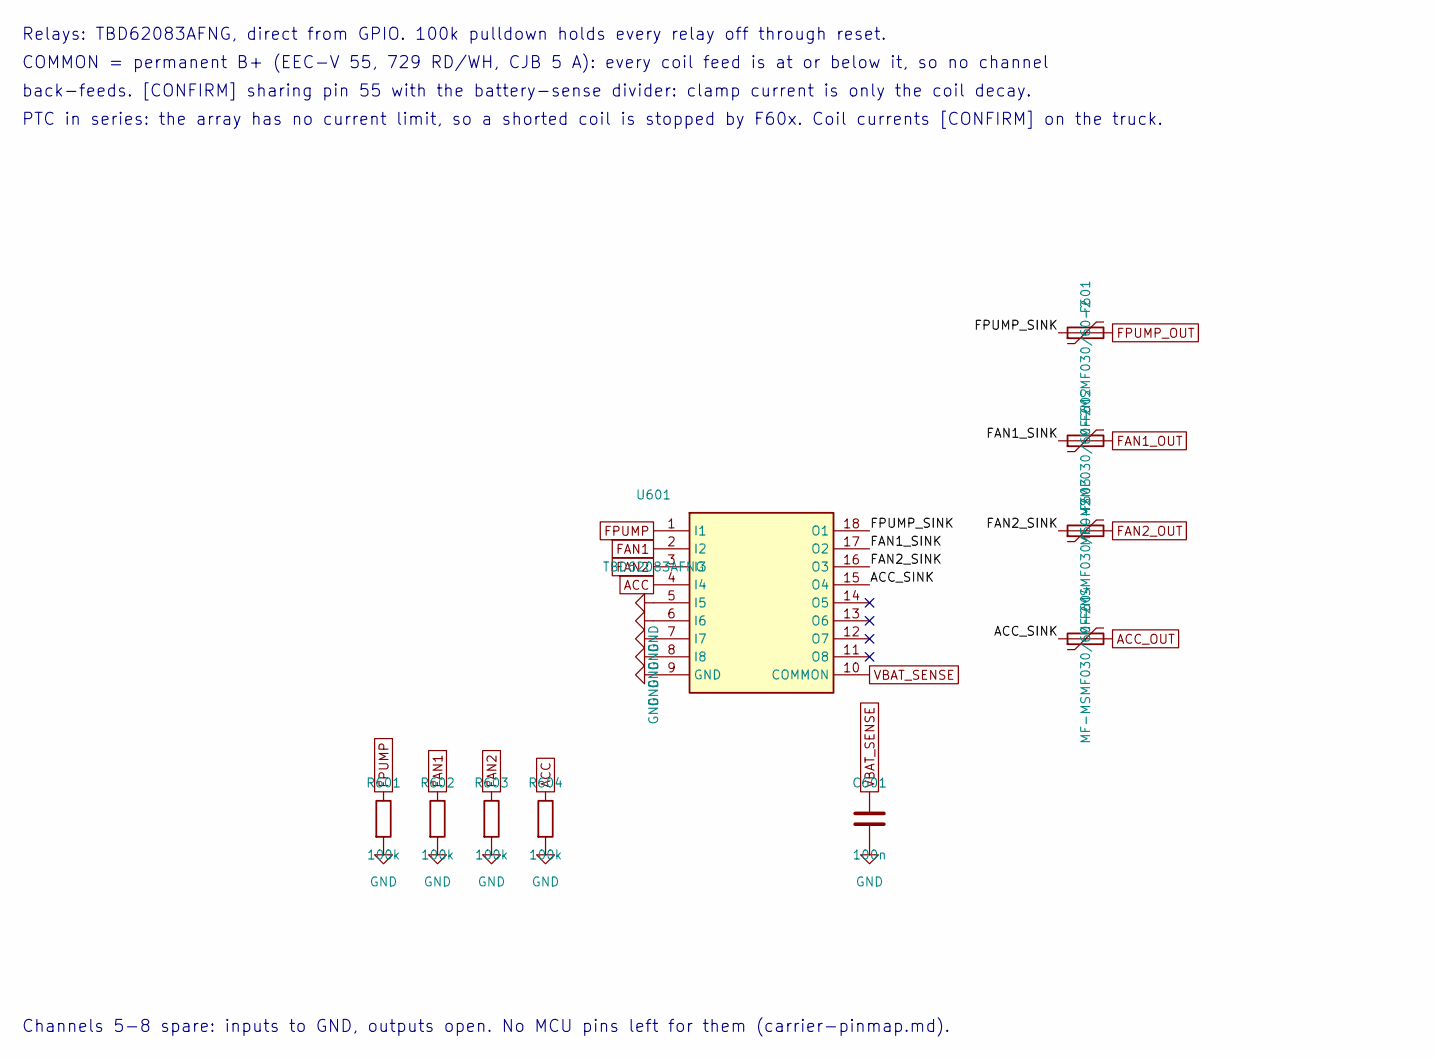
[picture p115: schematic Relays.kicad_sch, TritonECU carrier - Relays]

Parts:
C601: 100n; C_0805_2012Metric_Pad1.18x1.45mm_HandSolder
F601, F602, F603, F604: MF-MSMF030/60-2; Fuse_1812_4532Metric
R601, R602, R603, R604: 100k; R_0603_1608Metric_Pad0.98x0.95mm_HandSolder
U601: TBD62083AFNG; SOP65P640X155-18N

Connections:
/Relays/ACC_SINK: F604.1, U601.15 (O4)
/Relays/FAN1_SINK: F602.1, U601.17 (O2)
/Relays/FAN2_SINK: F603.1, U601.16 (O3)
/Relays/FPUMP_SINK: F601.1, U601.18 (O1)
ACC: R604.1, U601.4 (I4); also elsewhere on the board
ACC_OUT: F604.2; also elsewhere on the board
FAN1: R602.1, U601.2 (I2); also elsewhere on the board
FAN1_OUT: F602.2; also elsewhere on the board
FAN2: R603.1, U601.3 (I3); also elsewhere on the board
FAN2_OUT: F603.2; also elsewhere on the board
FPUMP: R601.1, U601.1 (I1); also elsewhere on the board
FPUMP_OUT: F601.2; also elsewhere on the board
GND: C601.2, R601.2, R602.2, R603.2, R604.2, U601.5 (I5), U601.6 (I6), U601.7 (I7), U601.8 (I8), U601.9 (GND); also elsewhere on the board
VBAT_SENSE: C601.1, U601.10 (COMMON); also elsewhere on the board

Notes on the sheet:
Relays: TBD62083AFNG, direct from GPIO. 100k pulldown holds every relay off through reset.
COMMON = permanent B+ (EEC-V 55, 729 RD/WH, CJB 5 A): every coil feed is at or below it, so no channel
back-feeds. [CONFIRM] sharing pin 55 with the battery-sense divider: clamp current is only the coil decay.
PTC in series: the array has no current limit, so a shorted coil is stopped by F60x. Coil currents [CONFIRM] on the truck.
Channels 5-8 spare: inputs to GND, outputs open. No MCU pins left for them (carrier-pinmap.md).
