alpauna/TritonECU/docs/Schematics/KiCad/TritonECU-Main/TritonECU-Main.kicad_pcb

## KiCad design docs/Schematics/KiCad/TritonECU-Main/TritonECU-Main.kicad_pcb (continued)

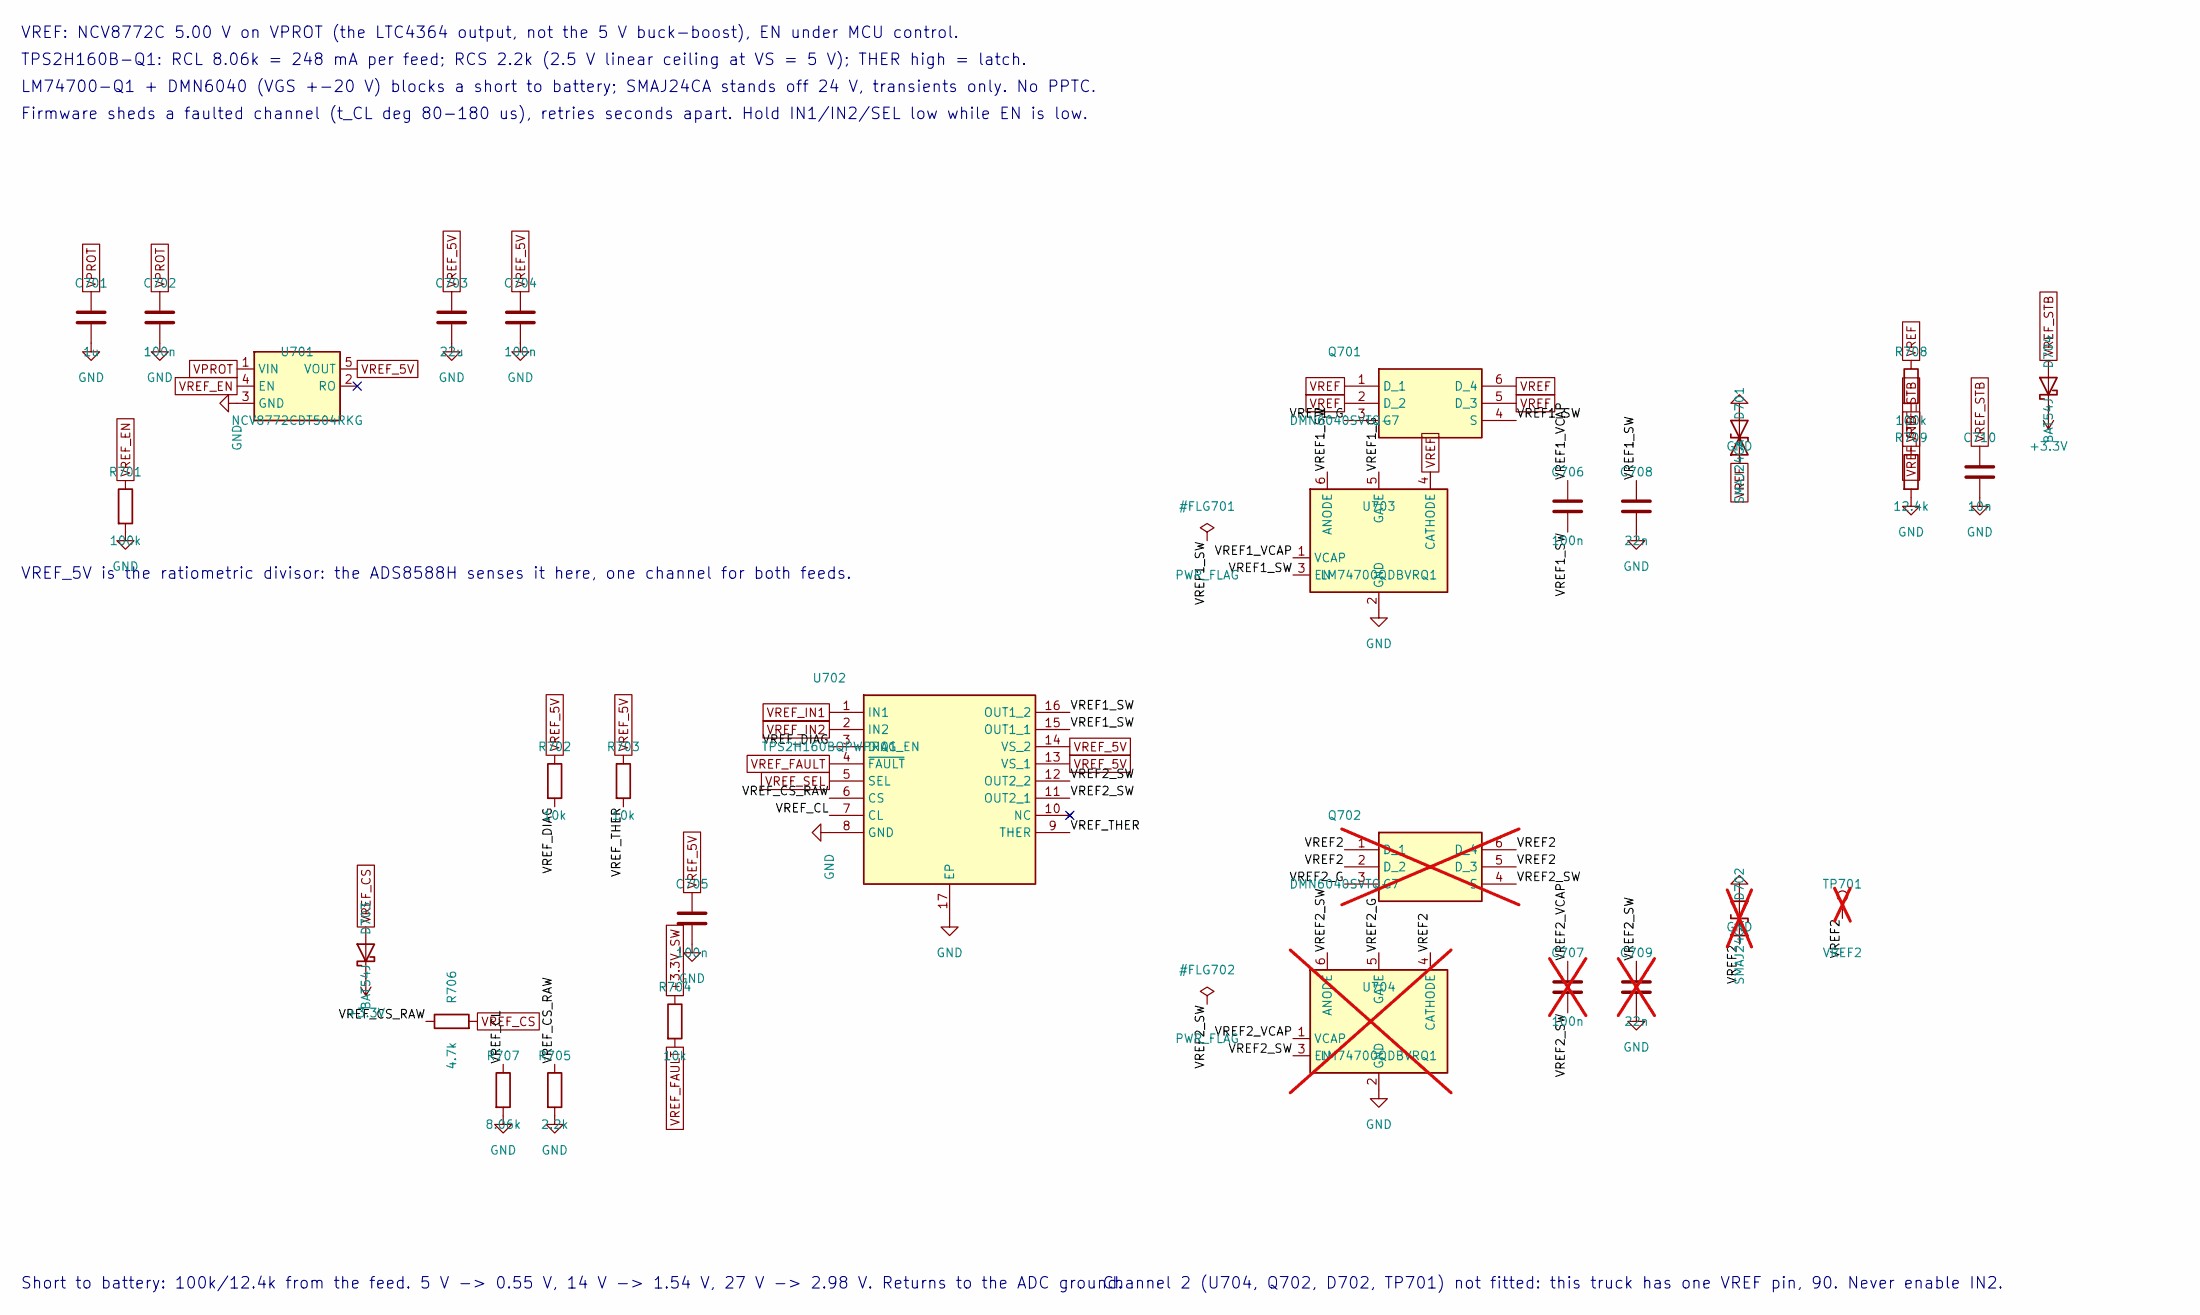
[picture p116: schematic Vref.kicad_sch, TritonECU carrier - VREF]

Parts:
C701: 1u; C_0805_2012Metric_Pad1.18x1.45mm_HandSolder
C702, C704, C705, C706: 100n; C_0603_1608Metric_Pad1.08x0.95mm_HandSolder
C703: 22u; C_1206_3216Metric_Pad1.33x1.80mm_HandSolder
C707: 100n; C_0603_1608Metric_Pad1.08x0.95mm_HandSolder; not fitted
C708: 22n; C_0603_1608Metric_Pad1.08x0.95mm_HandSolder
C709: 22n; C_0603_1608Metric_Pad1.08x0.95mm_HandSolder; not fitted
C710: 10n; C_0603_1608Metric_Pad1.08x0.95mm_HandSolder
D701: SMAJ24CA; D_SMA
D702: SMAJ24CA; D_SMA; not fitted
D703, D704: BAT54J; D_SOD-323F
Q701: DMN6040SVTQ-7; SOT95P280X100-6N
Q702: DMN6040SVTQ-7; SOT95P280X100-6N; not fitted
R701, R708: 100k; R_0603_1608Metric_Pad0.98x0.95mm_HandSolder
R702, R703, R704: 10k; R_0603_1608Metric_Pad0.98x0.95mm_HandSolder
R705: 2.2k; R_0603_1608Metric_Pad0.98x0.95mm_HandSolder
R706: 4.7k; R_0603_1608Metric_Pad0.98x0.95mm_HandSolder
R707: 8.06k; R_0603_1608Metric_Pad0.98x0.95mm_HandSolder
R709: 12.4k; R_0603_1608Metric_Pad0.98x0.95mm_HandSolder
TP701: VREF2; TestPoint_Pad_D1.5mm; not fitted
U701: NCV8772CDT504RKG; TO-252-5_TabPin3
U702: TPS2H160BQPWPRQ1; SOP65P640X120-17N
U703: LM74700QDBVRQ1; SOT-23-6
U704: LM74700QDBVRQ1; SOT-23-6; not fitted

Connections:
+3.3V: D703.1 (K), D704.1 (K); also elsewhere on the board
+3.3V_SW: R704.1; also elsewhere on the board
/VREF/VREF1_G: Q701.3 (G), U703.5 (GATE)
/VREF/VREF1_SW: C706.2, C708.1, Q701.4 (S), U702.15 (OUT1_1), U702.16 (OUT1_2), U703.3 (EN), U703.6 (ANODE)
/VREF/VREF1_VCAP: C706.1, U703.1 (VCAP)
/VREF/VREF2: D702.1 (A1), Q702.1 (D_1), Q702.2 (D_2), Q702.5 (D_3), Q702.6 (D_4), TP701.1, U704.4 (CATHODE)
/VREF/VREF2_G: Q702.3 (G), U704.5 (GATE)
/VREF/VREF2_SW: C707.2, C709.1, Q702.4 (S), U702.11 (OUT2_1), U702.12 (OUT2_2), U704.3 (EN), U704.6 (ANODE)
/VREF/VREF2_VCAP: C707.1, U704.1 (VCAP)
/VREF/VREF_CL: R707.1, U702.7 (CL)
/VREF/VREF_CS_RAW: R705.1, R706.1, U702.6 (CS)
/VREF/VREF_DIAG: R702.2, U702.3 (DIAG_EN)
/VREF/VREF_THER: R703.2, U702.9 (THER)
GND: C701.2, C702.2, C703.2, C704.2, C705.2, C708.2, C709.2, C710.2, D701.2 (A2), D702.2 (A2), R701.2, R705.2, R707.2, R709.2, U701.3 (GND), U702.8 (GND), U702.17 (EP), U703.2 (GND), U704.2 (GND); also elsewhere on the board
VPROT: C701.1, C702.1, U701.1 (VIN); also elsewhere on the board
VREF: D701.1 (A1), Q701.1 (D_1), Q701.2 (D_2), Q701.5 (D_3), Q701.6 (D_4), R708.1, U703.4 (CATHODE); also elsewhere on the board
VREF_5V: C703.1, C704.1, C705.1, R702.1, R703.1, U701.5 (VOUT), U702.13 (VS_1), U702.14 (VS_2); also elsewhere on the board
VREF_CS: D703.2 (A), R706.2; also elsewhere on the board
VREF_EN: R701.1, U701.4 (EN); also elsewhere on the board
VREF_FAULT: R704.2, U702.4 (~FAULT); also elsewhere on the board
VREF_IN1: U702.1 (IN1); also elsewhere on the board
VREF_IN2: U702.2 (IN2); also elsewhere on the board
VREF_SEL: U702.5 (SEL); also elsewhere on the board
VREF_STB: C710.1, D704.2 (A), R708.2, R709.1; also elsewhere on the board

Notes on the sheet:
VREF: NCV8772C 5.00 V on VPROT (the LTC4364 output, not the 5 V buck-boost), EN under MCU control.
TPS2H160B-Q1: RCL 8.06k = 248 mA per feed; RCS 2.2k (2.5 V linear ceiling at VS = 5 V); THER high = latch.
LM74700-Q1 + DMN6040 (VGS +-20 V) blocks a short to battery; SMAJ24CA stands off 24 V, transients only. No PPTC.
Firmware sheds a faulted channel (t_CL deg 80-180 us), retries seconds apart. Hold IN1/IN2/SEL low while EN is low.
VREF_5V is the ratiometric divisor: the ADS8588H senses it here, one channel for both feeds.
Channel 2 (U704, Q702, D702, TP701) not fitted: this truck has one VREF pin, 90. Never enable IN2.
Short to battery: 100k/12.4k from the feed. 5 V -> 0.55 V, 14 V -> 1.54 V, 27 V -> 2.98 V. Returns to the ADC ground.

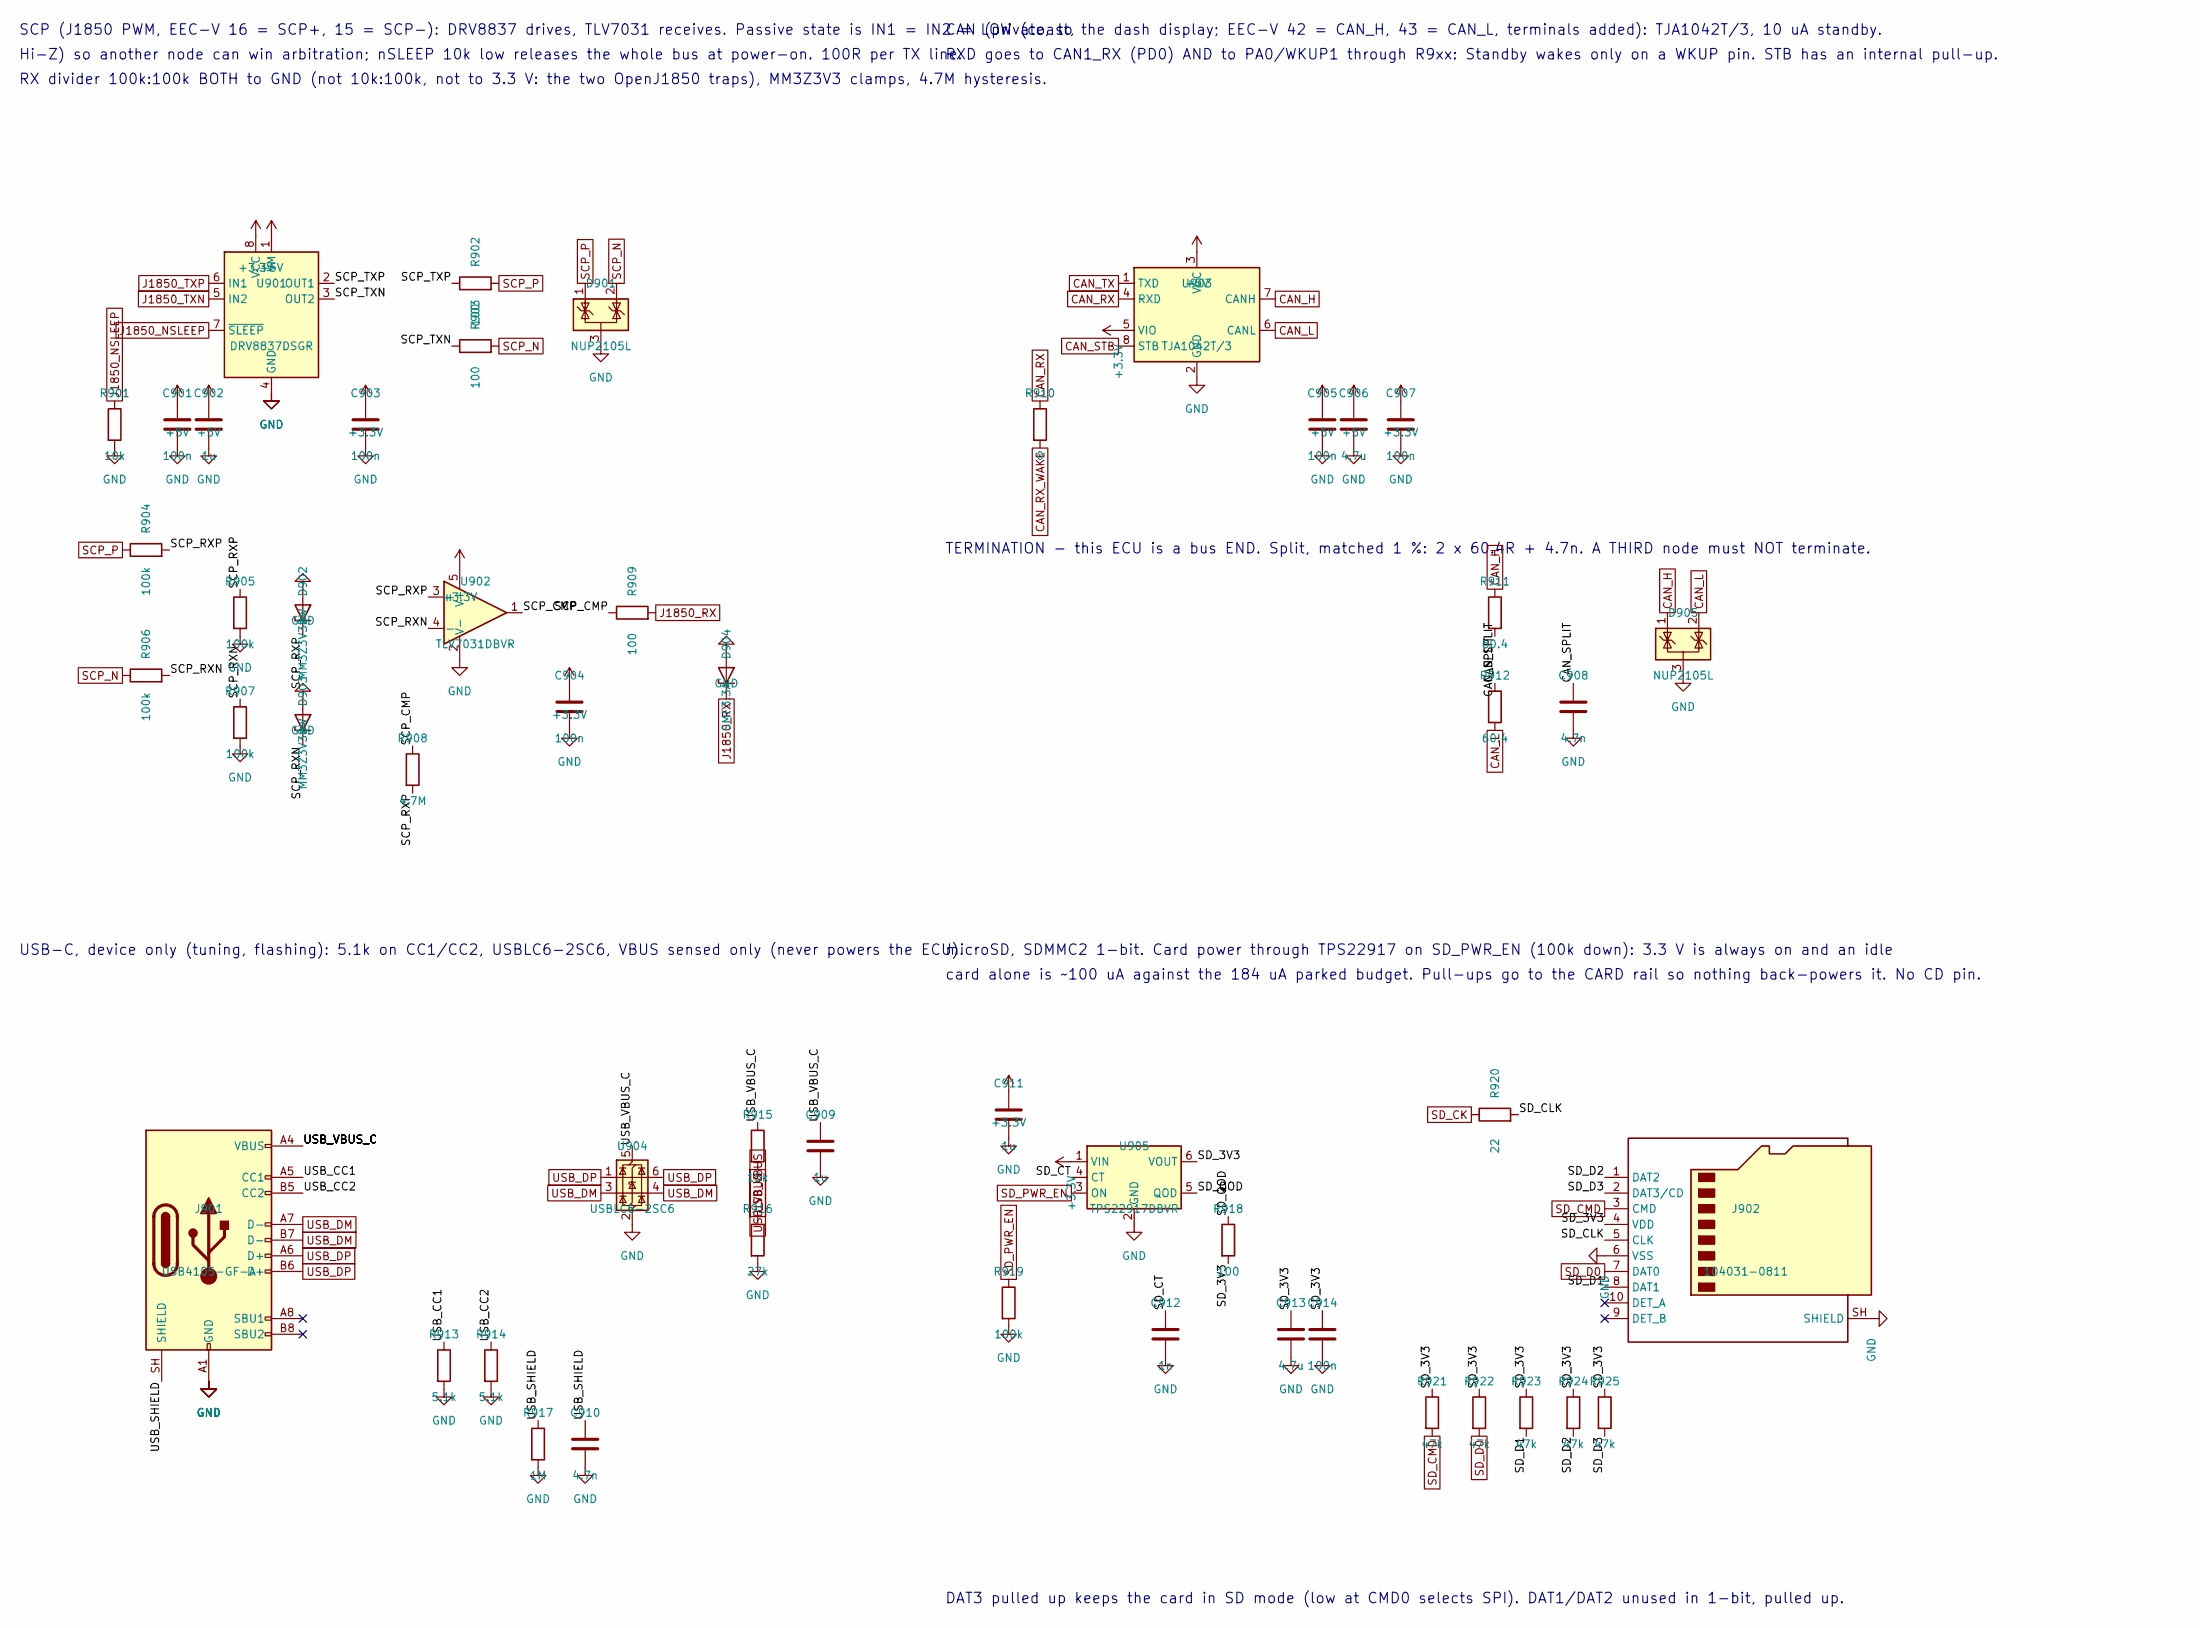
[picture p117: schematic Comms.kicad_sch, TritonECU carrier - Comms]

Parts:
C901, C903, C904, C905, C907, C914: 100n; C_0603_1608Metric_Pad1.08x0.95mm_HandSolder
C902, C909, C911: 1u; C_0603_1608Metric_Pad1.08x0.95mm_HandSolder
C906, C913: 4.7u; C_0805_2012Metric_Pad1.18x1.45mm_HandSolder
C908, C910: 4.7n; C_0603_1608Metric_Pad1.08x0.95mm_HandSolder
C912: 1n; C_0603_1608Metric_Pad1.08x0.95mm_HandSolder
D901, D905: NUP2105L; SOT-23
D902, D903: MM3Z3V3BW; D_SOD-323F
D904: SMF3.3A; D_SMF
J901: USB4105-GF-A; USB_C_Receptacle_GCT_USB4105-xx-A_16P_TopMnt_Horizontal
J902: 104031-0811; microSD_HC_Molex_104031-0811
R901: 10k; R_0603_1608Metric_Pad0.98x0.95mm_HandSolder
R902, R903, R909, R918: 100; R_0603_1608Metric_Pad0.98x0.95mm_HandSolder
R904, R905, R906, R907, R919: 100k; R_0603_1608Metric_Pad0.98x0.95mm_HandSolder
R908: 4.7M; R_0603_1608Metric_Pad0.98x0.95mm_HandSolder
R910: 0; R_0603_1608Metric_Pad0.98x0.95mm_HandSolder
R911, R912: 60.4; R_1206_3216Metric_Pad1.30x1.75mm_HandSolder
R913, R914: 5.1k; R_0603_1608Metric_Pad0.98x0.95mm_HandSolder
R915: 15k; R_0603_1608Metric_Pad0.98x0.95mm_HandSolder
R916: 27k; R_0603_1608Metric_Pad0.98x0.95mm_HandSolder
R917: 1M; R_0603_1608Metric_Pad0.98x0.95mm_HandSolder
R920: 22; R_0603_1608Metric_Pad0.98x0.95mm_HandSolder
R921, R922, R923, R924, R925: 47k; R_0603_1608Metric_Pad0.98x0.95mm_HandSolder
U901: DRV8837DSGR; Texas_DSG0008A_WSON-8-1EP_2x2mm_P0.5mm_EP0.9x1.6mm
U902: TLV7031DBVR; SOT-23-5
U903: TJA1042T/3; SOIC-8_3.9x4.9mm_P1.27mm
U904: USBLC6-2SC6; SOT-23-6
U905: TPS22917DBVR; SOT-23-6

Connections:
+3.3V: C903.1, C904.1, C907.1, C911.1, U901.8 (VCC), U902.5 (V+), U903.5 (VIO), U905.1 (VIN); also elsewhere on the board
+5V: C901.1, C902.1, C905.1, C906.1, U901.1 (VM), U903.3 (VCC); also elsewhere on the board
/Comms/CAN_SPLIT: C908.1, R911.2, R912.1
/Comms/SCP_CMP: R908.1, R909.1, U902.1
/Comms/SCP_RXN: D903.1 (K), R906.2, R907.1, U902.4 (-)
/Comms/SCP_RXP: D902.1 (K), R904.2, R905.1, R908.2, U902.3 (+)
/Comms/SCP_TXN: R903.1, U901.3 (OUT2)
/Comms/SCP_TXP: R902.1, U901.2 (OUT1)
/Comms/SD_3V3: C913.1, C914.1, J902.4 (VDD), R918.2, R921.1, R922.1, R923.1, R924.1, R925.1, U905.6 (VOUT)
/Comms/SD_CLK: J902.5 (CLK), R920.2
/Comms/SD_CT: C912.1, U905.4 (CT)
/Comms/SD_D1: J902.8 (DAT1), R923.2
/Comms/SD_D2: J902.1 (DAT2), R924.2
/Comms/SD_D3: J902.2 (DAT3/CD), R925.2
/Comms/SD_QOD: R918.1, U905.5 (QOD)
/Comms/USB_CC1: J901.A5 (CC1), R913.1
/Comms/USB_CC2: J901.B5 (CC2), R914.1
/Comms/USB_SHIELD: C910.1, J901.SH (SHIELD), R917.1
/Comms/USB_VBUS_C: C909.1, J901.A4 (VBUS), J901.A9 (VBUS), J901.B4 (VBUS), J901.B9 (VBUS), R915.1, U904.5 (VBUS)
CAN_H: D905.1 (K), R911.1, U903.7 (CANH); also elsewhere on the board
CAN_L: D905.2 (K), R912.2, U903.6 (CANL); also elsewhere on the board
CAN_RX: R910.1, U903.4 (RXD); also elsewhere on the board
CAN_RX_WAKE: R910.2; also elsewhere on the board
CAN_STB: U903.8 (STB); also elsewhere on the board
CAN_TX: U903.1 (TXD); also elsewhere on the board
GND: C901.2, C902.2, C903.2, C904.2, C905.2, C906.2, C907.2, C908.2, C909.2, C910.2, C911.2, C912.2, C913.2, C914.2, D901.3 (A), D902.2 (A), D903.2 (A), D904.2 (A), D905.3 (A), J901.A1 (GND), J901.A12 (GND), J901.B1 (GND), J901.B12 (GND), J902.6 (VSS), J902.SH (SHIELD), R901.2, R905.2, R907.2, R913.2, R914.2, R916.2, R917.2, R919.2, U901.4 (GND), U901.9 (GND), U902.2 (V-), U903.2 (GND), U904.2 (GND), U905.2 (GND); also elsewhere on the board
J1850_NSLEEP: R901.1, U901.7 (~SLEEP); also elsewhere on the board
J1850_RX: D904.1 (K), R909.2; also elsewhere on the board
J1850_TXN: U901.5 (IN2); also elsewhere on the board
J1850_TXP: U901.6 (IN1); also elsewhere on the board
SCP_N: D901.2 (K), R903.2, R906.1; also elsewhere on the board
SCP_P: D901.1 (K), R902.2, R904.1; also elsewhere on the board
SD_CK: R920.1; also elsewhere on the board
SD_CMD: J902.3 (CMD), R921.2; also elsewhere on the board
SD_D0: J902.7 (DAT0), R922.2; also elsewhere on the board
SD_PWR_EN: R919.1, U905.3 (ON); also elsewhere on the board
USB_DM: J901.A7 (D-), J901.B7 (D-), U904.3 (I/O2), U904.4 (I/O2); also elsewhere on the board
USB_DP: J901.A6 (D+), J901.B6 (D+), U904.1 (I/O1), U904.6 (I/O1); also elsewhere on the board
USB_VBUS: R915.2, R916.1; also elsewhere on the board

Notes on the sheet:
SCP (J1850 PWM, EEC-V 16 = SCP+, 15 = SCP-): DRV8837 drives, TLV7031 receives. Passive state is IN1 = IN2 = LOW (coast,
Hi-Z) so another node can win arbitration; nSLEEP 10k low releases the whole bus at power-on. 100R per TX line.
RX divider 100k:100k BOTH to GND (not 10k:100k, not to 3.3 V: the two OpenJ1850 traps), MM3Z3V3 clamps, 4.7M hysteresis.
CAN (private, to the dash display; EEC-V 42 = CAN_H, 43 = CAN_L, terminals added): TJA1042T/3, 10 uA standby.
RXD goes to CAN1_RX (PD0) AND to PA0/WKUP1 through R9xx: Standby wakes only on a WKUP pin. STB has an internal pull-up.
TERMINATION - this ECU is a bus END. Split, matched 1 %: 2 x 60.4R + 4.7n. A THIRD node must NOT terminate.
USB-C, device only (tuning, flashing): 5.1k on CC1/CC2, USBLC6-2SC6, VBUS sensed only (never powers the ECU).
microSD, SDMMC2 1-bit. Card power through TPS22917 on SD_PWR_EN (100k down): 3.3 V is always on and an idle
card alone is ~100 uA against the 184 uA parked budget. Pull-ups go to the CARD rail so nothing back-powers it. No CD pin.
DAT3 pulled up keeps the card in SD mode (low at CMD0 selects SPI). DAT1/DAT2 unused in 1-bit, pulled up.

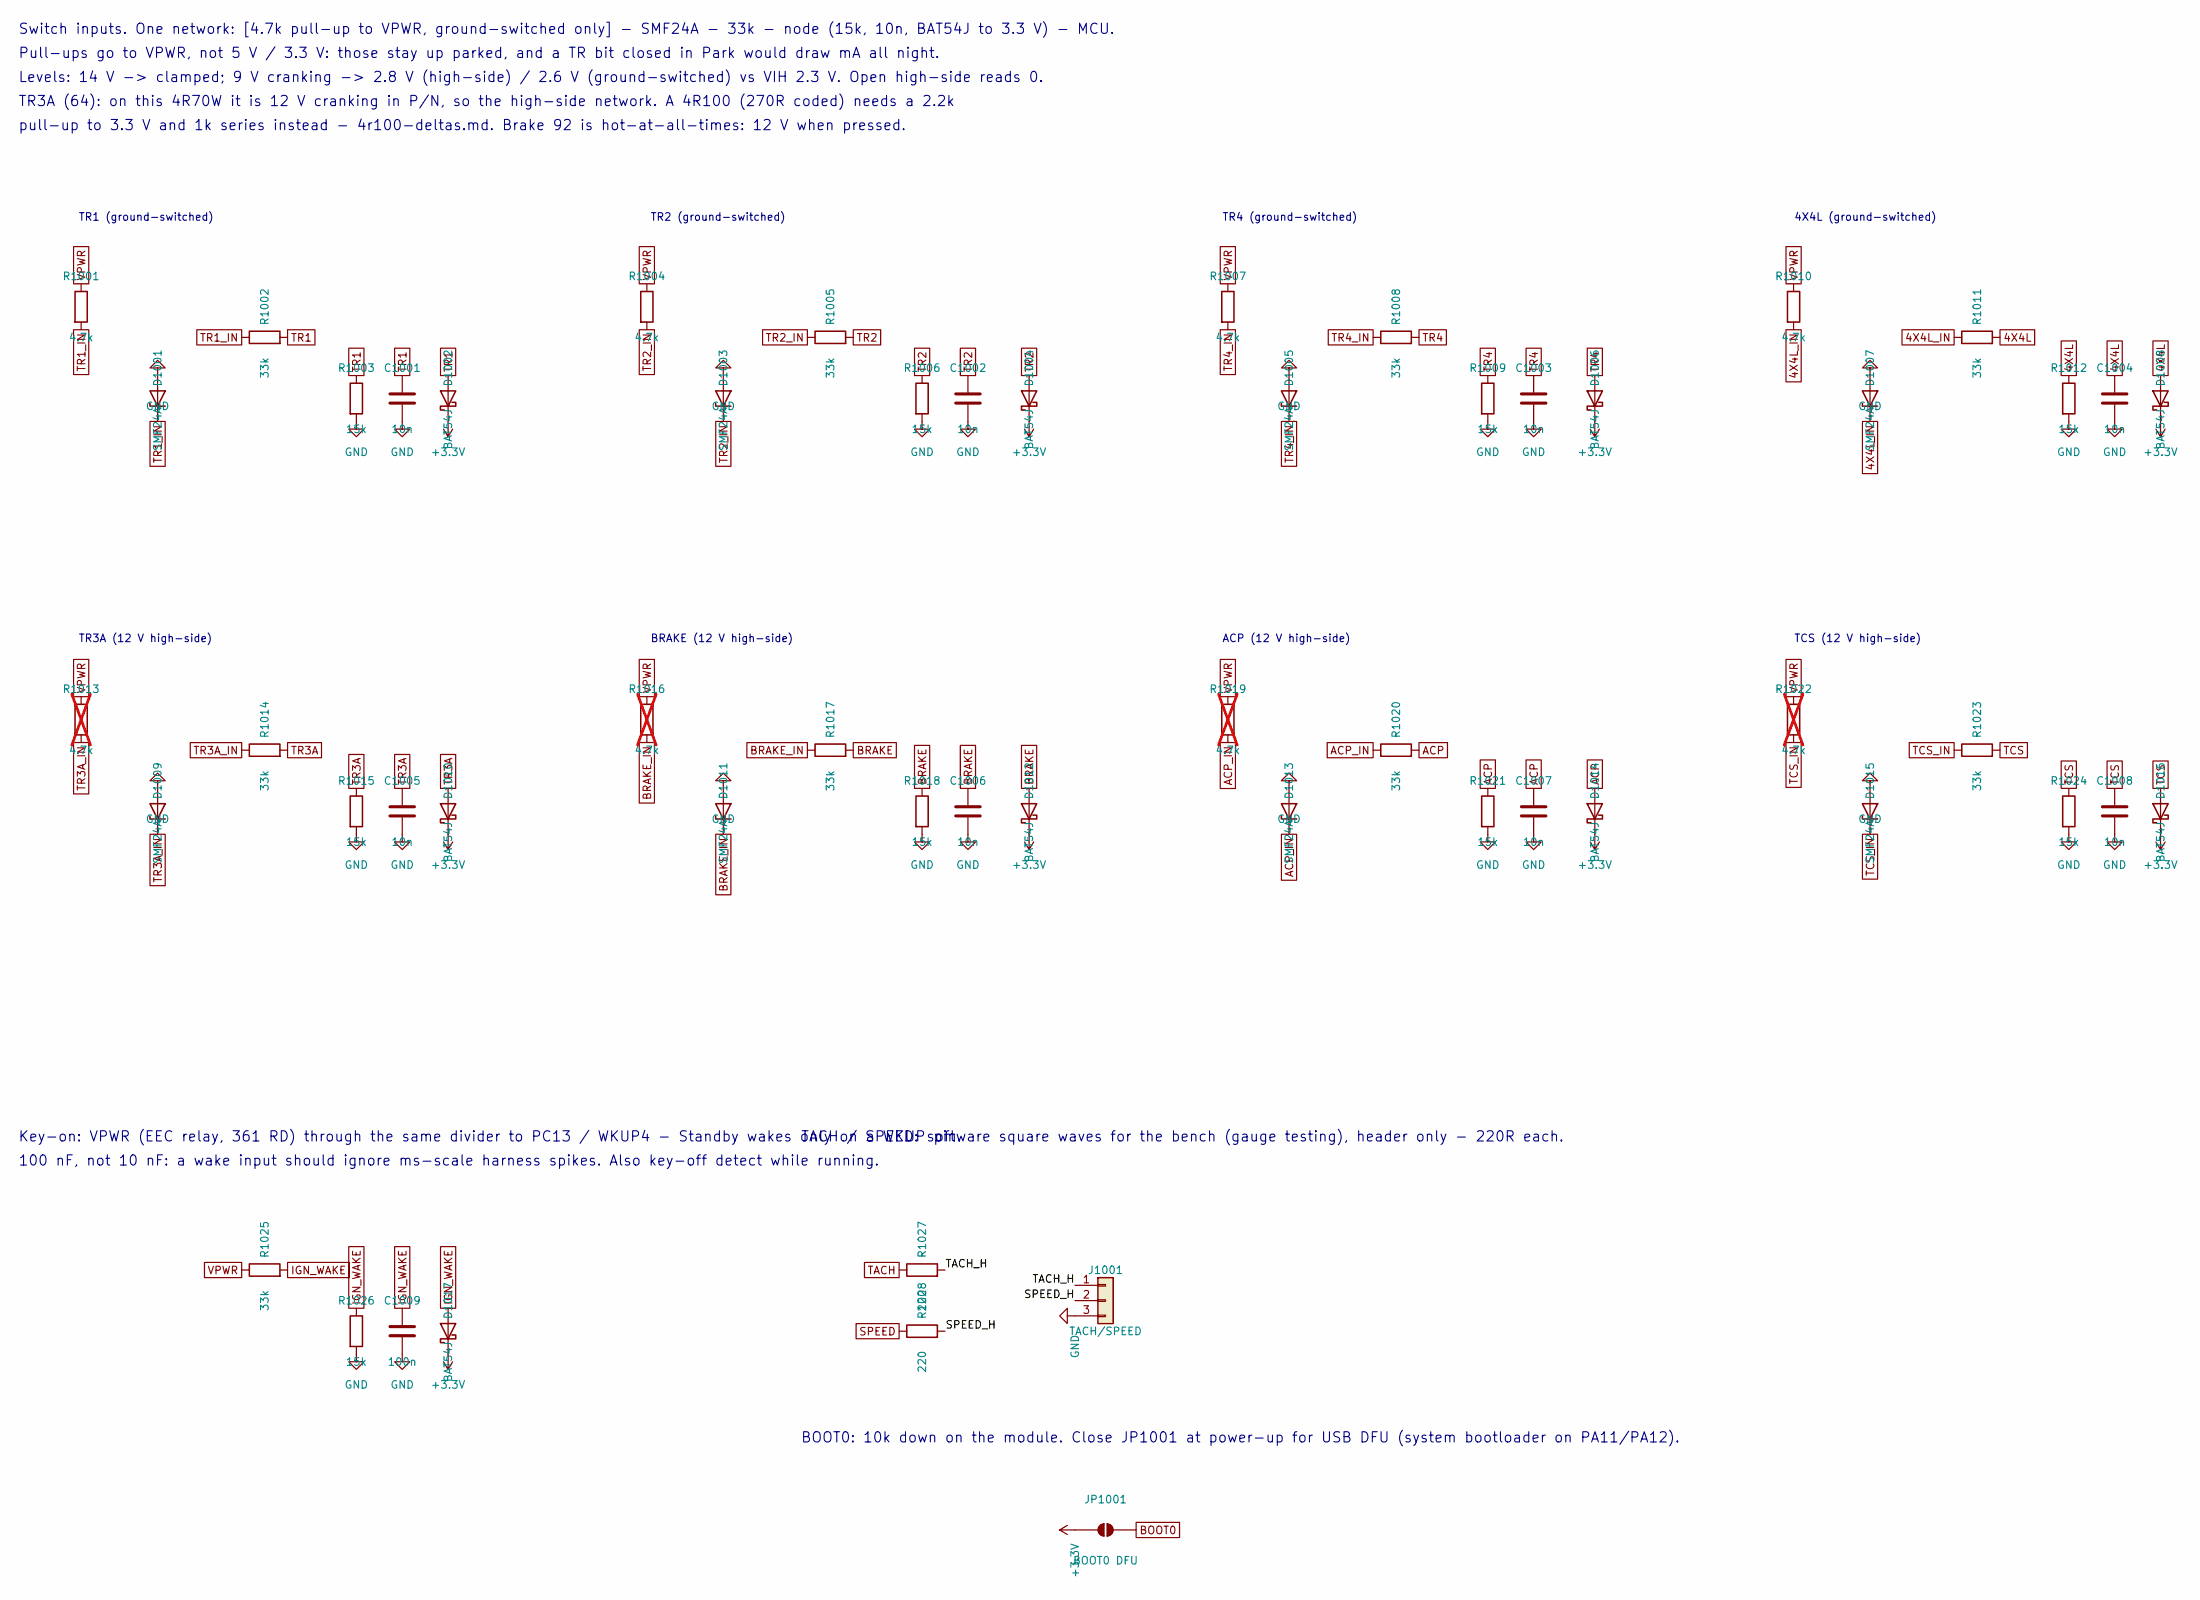
[picture p118: schematic Inputs.kicad_sch, TritonECU carrier - Inputs]

Parts:
C1001, C1002, C1003, C1004, C1005, C1006, C1007, C1008: 10n; C_0603_1608Metric_Pad1.08x0.95mm_HandSolder
C1009: 100n; C_0603_1608Metric_Pad1.08x0.95mm_HandSolder
D1001, D1003, D1005, D1007, D1009, D1011, D1013, D1015: SMF24A; D_SMF
D1002, D1004, D1006, D1008, D1010, D1012, D1014, D1016, D1017: BAT54J; D_SOD-323F
J1001: TACH/SPEED; PinHeader_1x03_P2.54mm_Vertical
JP1001: BOOT0 DFU; SolderJumper-2_P1.3mm_Open_RoundedPad1.0x1.5mm
R1001, R1004, R1007, R1010: 4.7k; R_0805_2012Metric_Pad1.20x1.40mm_HandSolder
R1002, R1005, R1008, R1011, R1014, R1017, R1020, R1023, R1025: 33k; R_0805_2012Metric_Pad1.20x1.40mm_HandSolder
R1003, R1006, R1009, R1012, R1015, R1018, R1021, R1024, R1026: 15k; R_0603_1608Metric_Pad0.98x0.95mm_HandSolder
R1013, R1016, R1019, R1022: 4.7k; R_0805_2012Metric_Pad1.20x1.40mm_HandSolder; not fitted
R1027, R1028: 220; R_0603_1608Metric_Pad0.98x0.95mm_HandSolder

Connections:
4X4L: C1004.1, D1008.2 (A), R1011.2, R1012.1; also elsewhere on the board
4X4L_IN: D1007.1 (K), R1010.2, R1011.1; also elsewhere on the board
+3.3V: D1002.1 (K), D1004.1 (K), D1006.1 (K), D1008.1 (K), D1010.1 (K), D1012.1 (K), D1014.1 (K), D1016.1 (K), D1017.1 (K), JP1001.1 (A); also elsewhere on the board
/Inputs/SPEED_H: J1001.2, R1028.2
/Inputs/TACH_H: J1001.1, R1027.2
ACP: C1007.1, D1014.2 (A), R1020.2, R1021.1; also elsewhere on the board
ACP_IN: D1013.1 (K), R1019.2, R1020.1; also elsewhere on the board
BOOT0: JP1001.2 (B); also elsewhere on the board
BRAKE: C1006.1, D1012.2 (A), R1017.2, R1018.1; also elsewhere on the board
BRAKE_IN: D1011.1 (K), R1016.2, R1017.1; also elsewhere on the board
GND: C1001.2, C1002.2, C1003.2, C1004.2, C1005.2, C1006.2, C1007.2, C1008.2, C1009.2, D1001.2 (A), D1003.2 (A), D1005.2 (A), D1007.2 (A), D1009.2 (A), D1011.2 (A), D1013.2 (A), D1015.2 (A), J1001.3, R1003.2, R1006.2, R1009.2, R1012.2, R1015.2, R1018.2, R1021.2, R1024.2, R1026.2; also elsewhere on the board
IGN_WAKE: C1009.1, D1017.2 (A), R1025.2, R1026.1; also elsewhere on the board
SPEED: R1028.1; also elsewhere on the board
TACH: R1027.1; also elsewhere on the board
TCS: C1008.1, D1016.2 (A), R1023.2, R1024.1; also elsewhere on the board
TCS_IN: D1015.1 (K), R1022.2, R1023.1; also elsewhere on the board
TR1: C1001.1, D1002.2 (A), R1002.2, R1003.1; also elsewhere on the board
TR1_IN: D1001.1 (K), R1001.2, R1002.1; also elsewhere on the board
TR2: C1002.1, D1004.2 (A), R1005.2, R1006.1; also elsewhere on the board
TR2_IN: D1003.1 (K), R1004.2, R1005.1; also elsewhere on the board
TR3A: C1005.1, D1010.2 (A), R1014.2, R1015.1; also elsewhere on the board
TR3A_IN: D1009.1 (K), R1013.2, R1014.1; also elsewhere on the board
TR4: C1003.1, D1006.2 (A), R1008.2, R1009.1; also elsewhere on the board
TR4_IN: D1005.1 (K), R1007.2, R1008.1; also elsewhere on the board
VPWR: R1001.1, R1004.1, R1007.1, R1010.1, R1013.1, R1016.1, R1019.1, R1022.1, R1025.1; also elsewhere on the board

Notes on the sheet:
Switch inputs. One network: [4.7k pull-up to VPWR, ground-switched only] - SMF24A - 33k - node (15k, 10n, BAT54J to 3.3 V) - MCU.
Pull-ups go to VPWR, not 5 V / 3.3 V: those stay up parked, and a TR bit closed in Park would draw mA all night.
Levels: 14 V -> clamped; 9 V cranking -> 2.8 V (high-side) / 2.6 V (ground-switched) vs VIH 2.3 V. Open high-side reads 0.
TR3A (64): on this 4R70W it is 12 V cranking in P/N, so the high-side network. A 4R100 (270R coded) needs a 2.2k
pull-up to 3.3 V and 1k series instead - 4r100-deltas.md. Brake 92 is hot-at-all-times: 12 V when pressed.
TR1 (ground-switched)
TR2 (ground-switched)
TR4 (ground-switched)
4X4L (ground-switched)
TR3A (12 V high-side)
BRAKE (12 V high-side)
ACP (12 V high-side)
TCS (12 V high-side)
Key-on: VPWR (EEC relay, 361 RD) through the same divider to PC13 / WKUP4 - Standby wakes only on a WKUP pin.
100 nF, not 10 nF: a wake input should ignore ms-scale harness spikes. Also key-off detect while running.
TACH / SPEED: software square waves for the bench (gauge testing), header only - 220R each.
BOOT0: 10k down on the module. Close JP1001 at power-up for USB DFU (system bootloader on PA11/PA12).

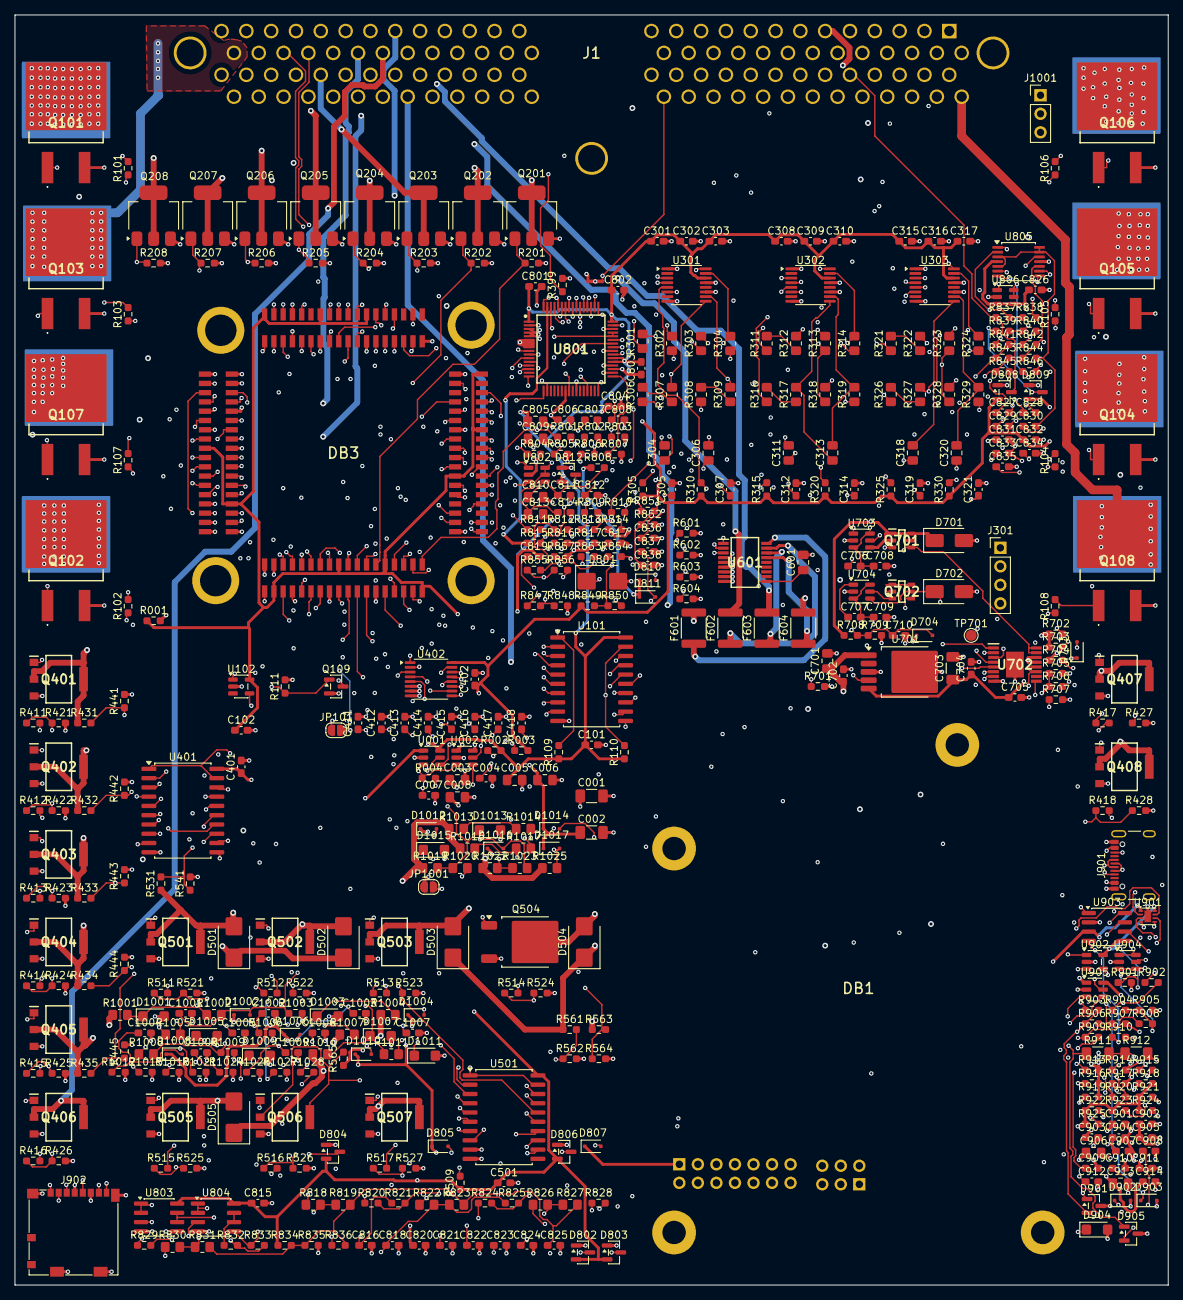
[picture p119: board TritonECU-Main.kicad_pcb from above]

Board: 6 copper layers, 158.0 x 174.0 mm, 457 parts (0 on the bottom side), 358 nets.
