alpauna/TritonECU/docs/Schematics/KiCad/TritonECU-MCU/TritonECU-MCU.kicad_pcb

## KiCad design docs/Schematics/KiCad/TritonECU-MCU/TritonECU-MCU.kicad_pcb (2026-10-17)

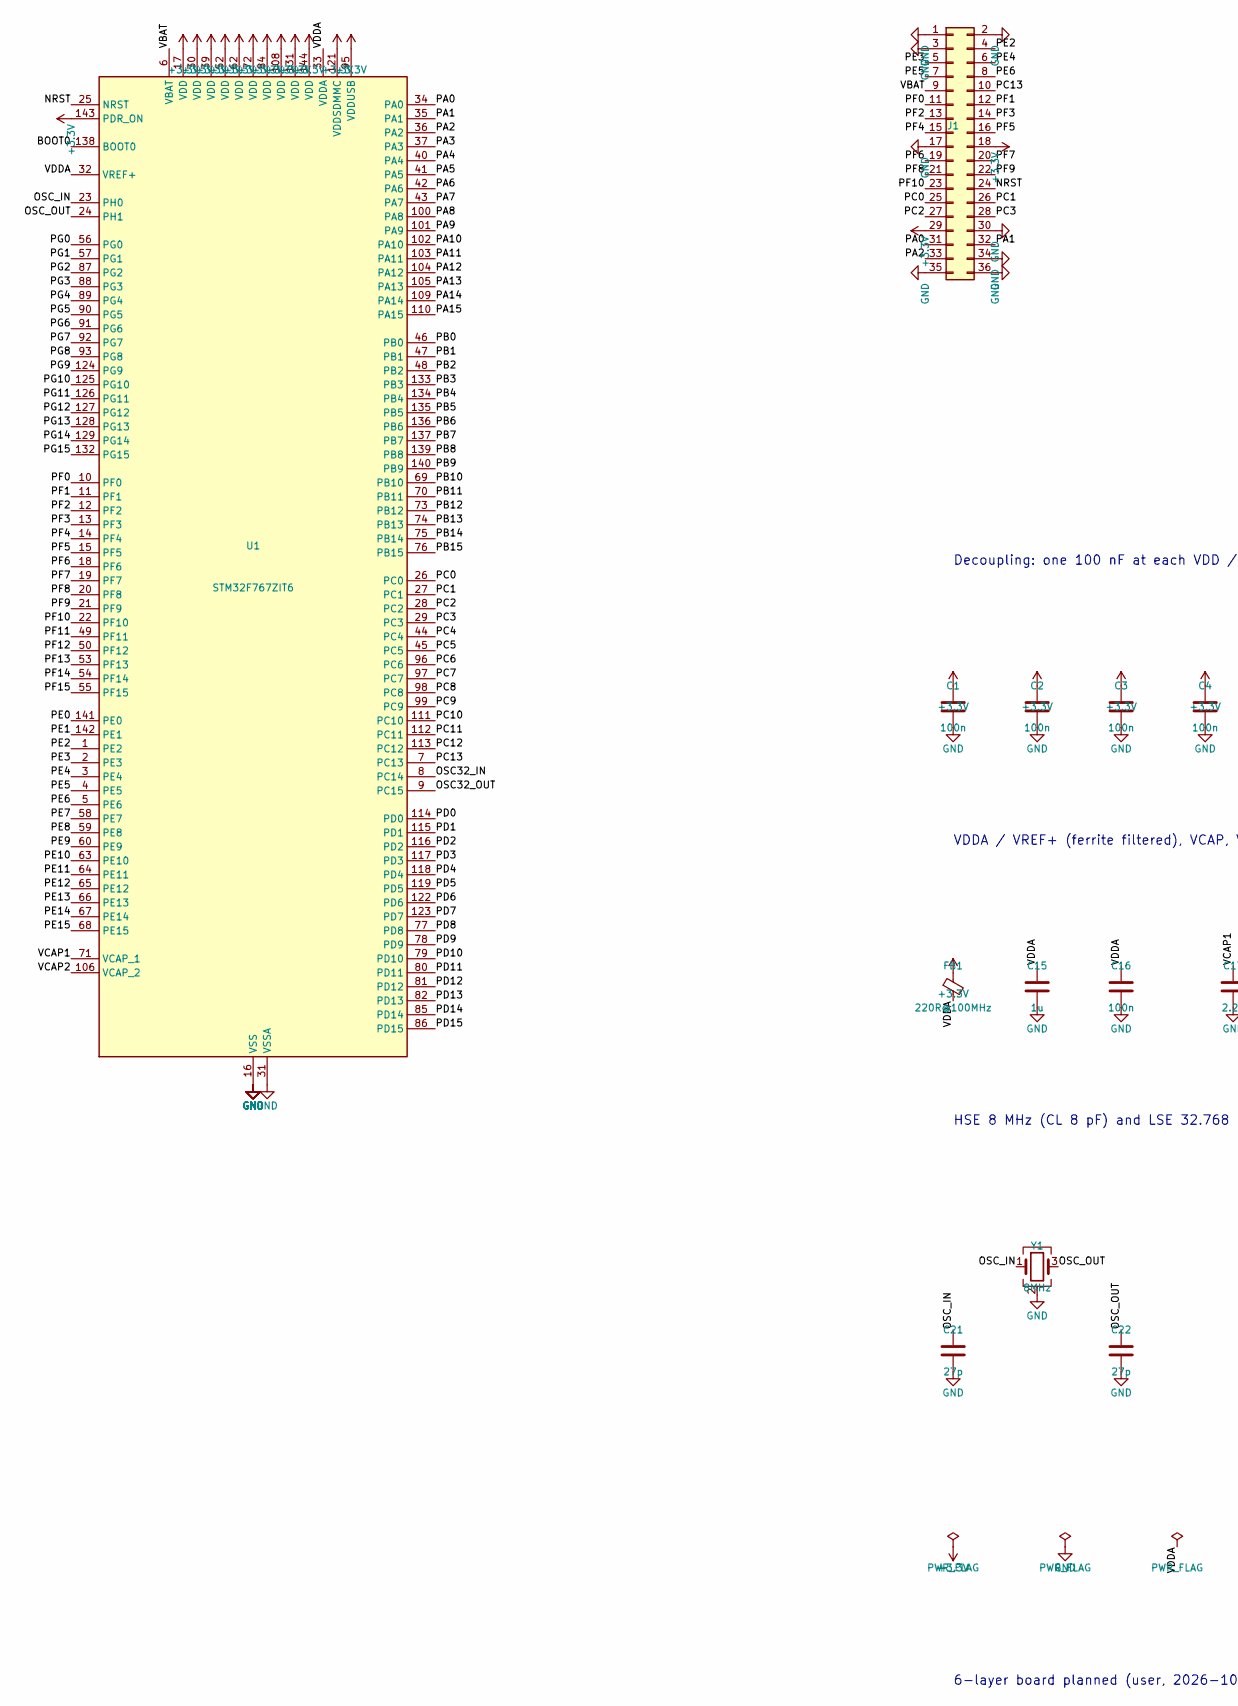
[picture p120: schematic TritonECU-MCU.kicad_sch, TritonECU MCU module - STM32F767ZIT6, part in row 1, column 1]

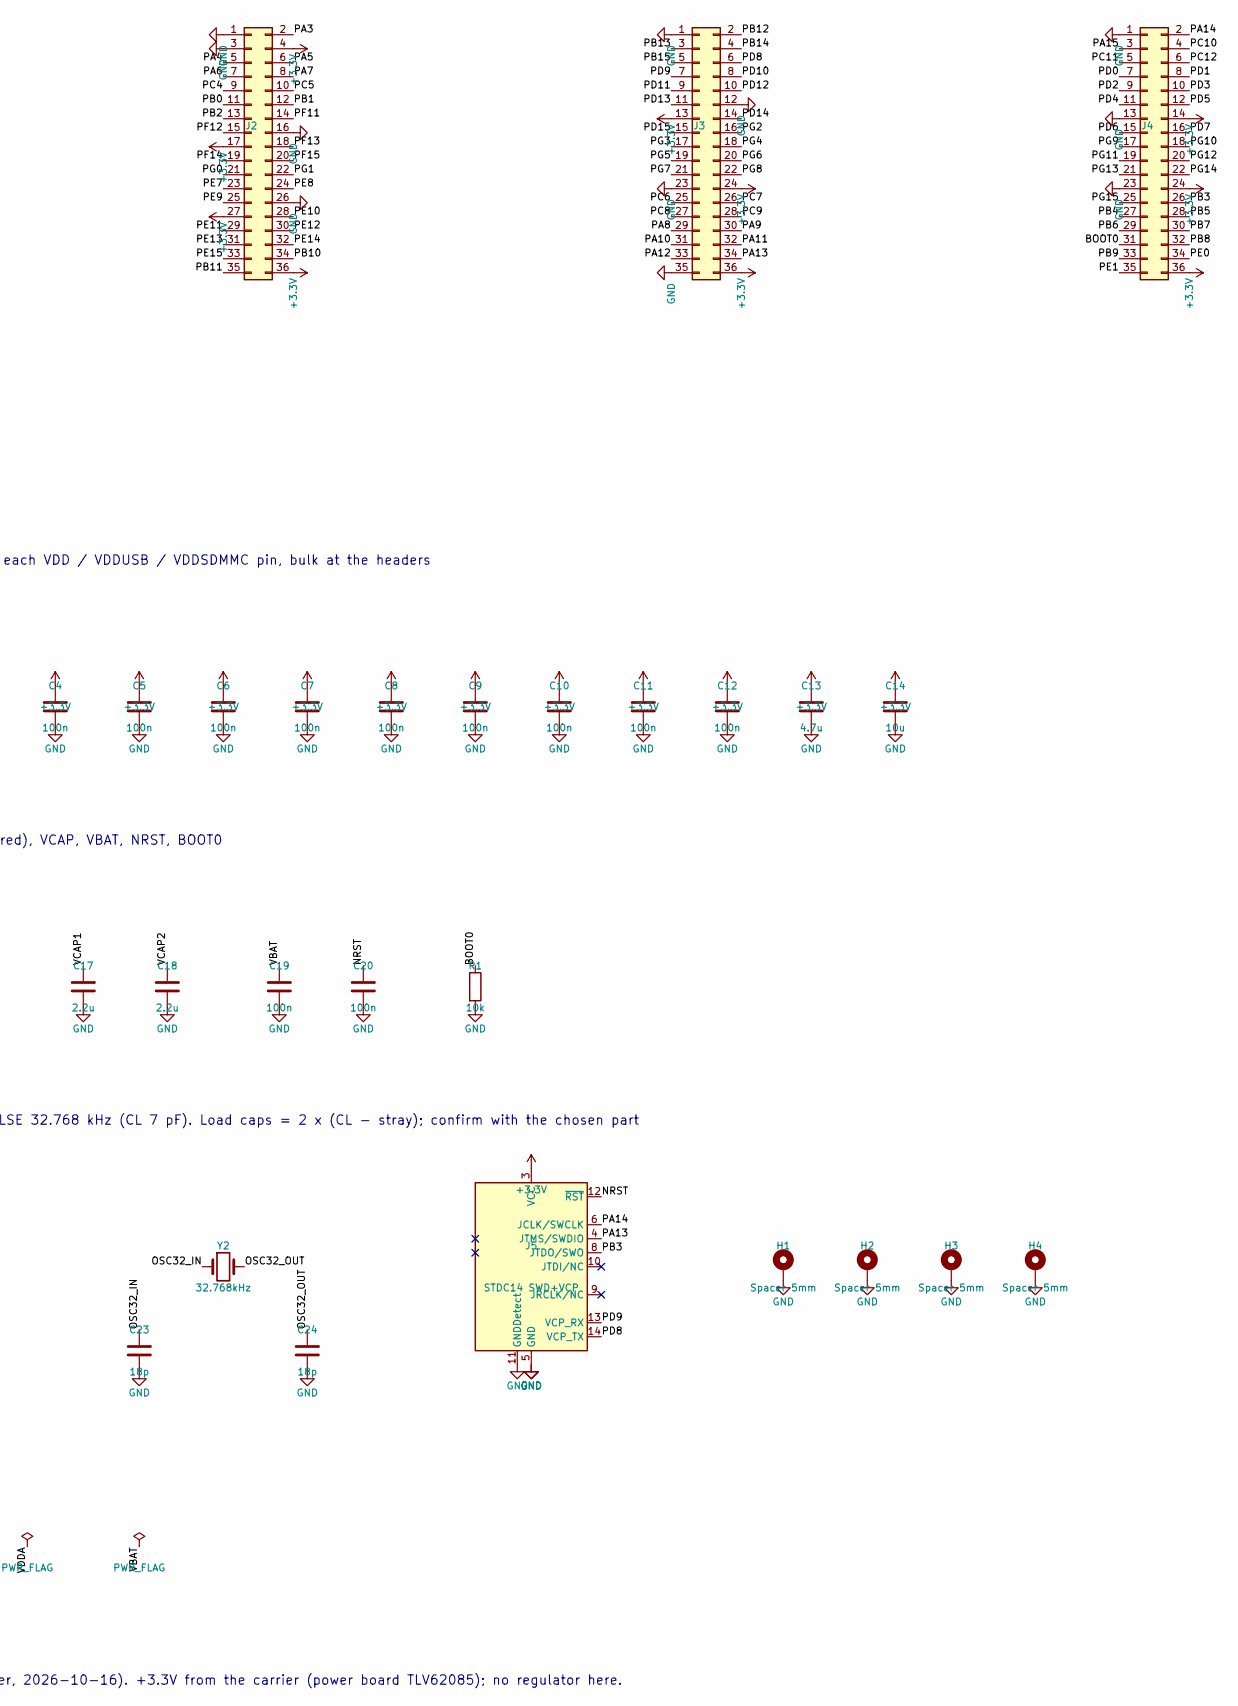
[picture p121: schematic TritonECU-MCU.kicad_sch, TritonECU MCU module - STM32F767ZIT6, part in row 1, column 2]

Parts:
C1, C2, C3, C4, C5, C6, C7, C8, C9, C10, C11, C12, C16, C19, C20: 100n; C_0402_1005Metric_Pad0.74x0.62mm_HandSolder; Manufacturer_Part_Number GCM155L8EH104KE07D; Mouser Part Number 81-GCM155L8EH104KE7D
C13: 4.7u; C_0603_1608Metric_Pad1.08x0.95mm_HandSolder; Manufacturer_Part_Number GRM188C71A475ME11D; Mouser Part Number 81-GRM188C71A475ME1D
C14: 10u; C_0805_2012Metric_Pad1.18x1.45mm_HandSolder; Manufacturer_Part_Number MCASL21GBB7106KTNA01; Mouser Part Number 963-MCASL21GBB7106KT
C15: 1u; C_0402_1005Metric_Pad0.74x0.62mm_HandSolder; Manufacturer_Part_Number KAM05CR71A105KH; Mouser Part Number 581-KAM05CR71A105KH
C17, C18: 2.2u; C_0603_1608Metric_Pad1.08x0.95mm_HandSolder; Manufacturer_Part_Number KGM15BR71A225KT; Mouser Part Number 581-KGM15BR71A225KT
C21, C22: 27p; C_0402_1005Metric_Pad0.74x0.62mm_HandSolder; Mouser Part Number 80-C0402C270F4HAUTO
C23, C24: 18p; C_0402_1005Metric_Pad0.74x0.62mm_HandSolder; Mouser Part Number 603-AC0402GRNPO9BN18
FB1: 220R@100MHz; L_0603_1608Metric_Pad1.05x0.95mm_HandSolder; Manufacturer_Part_Number BBPY00201209221Y00; Mouser Part Number 603-BBPY201209221Y00
H1, H2, H3, H4: Spacer 5mm; Wurth_WA-SMST_9774050982R; MPN 9774050982R
J1, J2, J3, J4: Samtec_FTSH-118-02-L-DV-A; MPN FTSH-118-02-L-DV-A
J5: STDC14 SWD+VCP; PinHeader_2x07_P1.27mm_Vertical_SMD; MPN FTSH-107-01-L-DV-K; Mouser Part Number 200-FTSH10701LDVKATR
R1: 10k; R_0402_1005Metric_Pad0.72x0.64mm_HandSolder; Manufacturer_Part_Number AT0402FRE0710KL; Mouser Part Number 603-AT0402FRE0710KL
U1: STM32F767ZIT6; LQFP-144_20x20mm_P0.5mm; MPN STM32F767ZIT6
Y1: 8MHz; Crystal_SMD_3225-4Pin_3.2x2.5mm_HandSoldering; Mouser Part Number 815-M8AIG-8-1ZT
Y2: 32.768kHz; Crystal_SMD_2012-2Pin_2.0x1.2mm_HandSoldering; Mouser Part Number 520-.327-12.5-12QST

Connections:
+3.3V: C1.1, C2.1, C3.1, C4.1, C5.1, C6.1, C7.1, C8.1, C9.1, C10.1, C11.1, C12.1, C13.1, C14.1, FB1.1, J1.18, J1.29, J2.4, J2.17, J2.27, J2.36, J3.13, J3.24, J3.36, J4.14, J4.24, J4.36, J5.3 (VCC), U1.17 (VDD), U1.30 (VDD), U1.39 (VDD), U1.52 (VDD), U1.62 (VDD), U1.72 (VDD), U1.84 (VDD), U1.95 (VDDUSB), U1.108 (VDD), U1.121 (VDDSDMMC), U1.131 (VDD), U1.143 (PDR_ON), U1.144 (VDD)
/BOOT0: J4.31, R1.1, U1.138 (BOOT0)
/NRST: C20.1, J1.24, J5.12 (~RST), U1.25 (NRST)
/OSC32_IN: C23.1, U1.8 (PC14), Y2.1
/OSC32_OUT: C24.1, U1.9 (PC15), Y2.2
/OSC_IN: C21.1, U1.23 (PH0), Y1.1
/OSC_OUT: C22.1, U1.24 (PH1), Y1.3
/PA0: J1.31, U1.34 (PA0)
/PA1: J1.32, U1.35 (PA1)
/PA2: J1.33, U1.36 (PA2)
/PA3: J2.2, U1.37 (PA3)
/PA4: J2.5, U1.40 (PA4)
/PA5: J2.6, U1.41 (PA5)
/PA6: J2.7, U1.42 (PA6)
/PA7: J2.8, U1.43 (PA7)
/PA8: J3.29, U1.100 (PA8)
/PA9: J3.30, U1.101 (PA9)
/PA10: J3.31, U1.102 (PA10)
/PA11: J3.32, U1.103 (PA11)
/PA12: J3.33, U1.104 (PA12)
/PA13: J3.34, J5.4 (JTMS/SWDIO), U1.105 (PA13)
/PA14: J4.2, J5.6 (JCLK/SWCLK), U1.109 (PA14)
/PA15: J4.3, U1.110 (PA15)
/PB0: J2.11, U1.46 (PB0)
/PB1: J2.12, U1.47 (PB1)
/PB2: J2.13, U1.48 (PB2)
/PB3: J4.26, J5.8 (JTDO/SWO), U1.133 (PB3)
/PB4: J4.27, U1.134 (PB4)
/PB5: J4.28, U1.135 (PB5)
/PB6: J4.29, U1.136 (PB6)
/PB7: J4.30, U1.137 (PB7)
/PB8: J4.32, U1.139 (PB8)
/PB9: J4.33, U1.140 (PB9)
/PB10: J2.34, U1.69 (PB10)
/PB11: J2.35, U1.70 (PB11)
/PB12: J3.2, U1.73 (PB12)
/PB13: J3.3, U1.74 (PB13)
/PB14: J3.4, U1.75 (PB14)
/PB15: J3.5, U1.76 (PB15)
/PC0: J1.25, U1.26 (PC0)
/PC1: J1.26, U1.27 (PC1)
/PC2: J1.27, U1.28 (PC2)
/PC3: J1.28, U1.29 (PC3)
/PC4: J2.9, U1.44 (PC4)
/PC5: J2.10, U1.45 (PC5)
/PC6: J3.25, U1.96 (PC6)
/PC7: J3.26, U1.97 (PC7)
/PC8: J3.27, U1.98 (PC8)
/PC9: J3.28, U1.99 (PC9)
/PC10: J4.4, U1.111 (PC10)
/PC11: J4.5, U1.112 (PC11)
/PC12: J4.6, U1.113 (PC12)
/PC13: J1.10, U1.7 (PC13)
/PD0: J4.7, U1.114 (PD0)
/PD1: J4.8, U1.115 (PD1)
/PD2: J4.9, U1.116 (PD2)
/PD3: J4.10, U1.117 (PD3)
/PD4: J4.11, U1.118 (PD4)
/PD5: J4.12, U1.119 (PD5)
/PD6: J4.15, U1.122 (PD6)
/PD7: J4.16, U1.123 (PD7)
/PD8: J3.6, J5.14 (VCP_TX), U1.77 (PD8)
/PD9: J3.7, J5.13 (VCP_RX), U1.78 (PD9)
/PD10: J3.8, U1.79 (PD10)
/PD11: J3.9, U1.80 (PD11)
/PD12: J3.10, U1.81 (PD12)
/PD13: J3.11, U1.82 (PD13)
/PD14: J3.14, U1.85 (PD14)
/PD15: J3.15, U1.86 (PD15)
/PE0: J4.34, U1.141 (PE0)
/PE1: J4.35, U1.142 (PE1)
/PE2: J1.4, U1.1 (PE2)
/PE3: J1.5, U1.2 (PE3)
/PE4: J1.6, U1.3 (PE4)
/PE5: J1.7, U1.4 (PE5)
/PE6: J1.8, U1.5 (PE6)
/PE7: J2.23, U1.58 (PE7)
/PE8: J2.24, U1.59 (PE8)
/PE9: J2.25, U1.60 (PE9)
/PE10: J2.28, U1.63 (PE10)
/PE11: J2.29, U1.64 (PE11)
/PE12: J2.30, U1.65 (PE12)
/PE13: J2.31, U1.66 (PE13)
/PE14: J2.32, U1.67 (PE14)
/PE15: J2.33, U1.68 (PE15)
/PF0: J1.11, U1.10 (PF0)
/PF1: J1.12, U1.11 (PF1)
/PF2: J1.13, U1.12 (PF2)
/PF3: J1.14, U1.13 (PF3)
/PF4: J1.15, U1.14 (PF4)
/PF5: J1.16, U1.15 (PF5)
/PF6: J1.19, U1.18 (PF6)
/PF7: J1.20, U1.19 (PF7)
/PF8: J1.21, U1.20 (PF8)
/PF9: J1.22, U1.21 (PF9)
/PF10: J1.23, U1.22 (PF10)
/PF11: J2.14, U1.49 (PF11)
/PF12: J2.15, U1.50 (PF12)
/PF13: J2.18, U1.53 (PF13)
/PF14: J2.19, U1.54 (PF14)
/PF15: J2.20, U1.55 (PF15)
/PG0: J2.21, U1.56 (PG0)
/PG1: J2.22, U1.57 (PG1)
/PG2: J3.16, U1.87 (PG2)
/PG3: J3.17, U1.88 (PG3)
/PG4: J3.18, U1.89 (PG4)
/PG5: J3.19, U1.90 (PG5)
/PG6: J3.20, U1.91 (PG6)
/PG7: J3.21, U1.92 (PG7)
/PG8: J3.22, U1.93 (PG8)
/PG9: J4.17, U1.124 (PG9)
/PG10: J4.18, U1.125 (PG10)
/PG11: J4.19, U1.126 (PG11)
/PG12: J4.20, U1.127 (PG12)
/PG13: J4.21, U1.128 (PG13)
/PG14: J4.22, U1.129 (PG14)
/PG15: J4.25, U1.132 (PG15)
/VBAT: C19.1, J1.9, U1.6 (VBAT)
/VCAP1: C17.1, U1.71 (VCAP_1)
/VCAP2: C18.1, U1.106 (VCAP_2)
/VDDA: C15.1, C16.1, FB1.2, U1.32 (VREF+), U1.33 (VDDA)
GND: C1.2, C2.2, C3.2, C4.2, C5.2, C6.2, C7.2, C8.2, C9.2, C10.2, C11.2, C12.2, C13.2, C14.2, C15.2, C16.2, C17.2, C18.2, C19.2, C20.2, C21.2, C22.2, C23.2, C24.2, H1.1, H2.1, H3.1, H4.1, J1.1, J1.2, J1.3, J1.17, J1.30, J1.34, J1.35, J1.36, J2.1, J2.3, J2.16, J2.26, J3.1, J3.12, J3.23, J3.35, J4.1, J4.13, J4.23, J5.5 (GND), J5.7 (GND), J5.11 (GNDDetect), R1.2, U1.16 (VSS), U1.31 (VSSA), U1.38 (VSS), U1.51 (VSS), U1.61 (VSS), U1.83 (VSS), U1.94 (VSS), U1.107 (VSS), U1.120 (VSS), U1.130 (VSS), Y1.2 (G), Y1.4 (G)

Notes on the sheet:
Decoupling: one 100 nF at each VDD / VDDUSB / VDDSDMMC pin, bulk at the headers
HSE 8 MHz (CL 8 pF) and LSE 32.768 kHz (CL 7 pF). Load caps = 2 x (CL - stray); confirm with the chosen part
VDDA / VREF+ (ferrite filtered), VCAP, VBAT, NRST, BOOT0
6-layer board planned (user, 2026-10-16). +3.3V from the carrier (power board TLV62085); no regulator here.

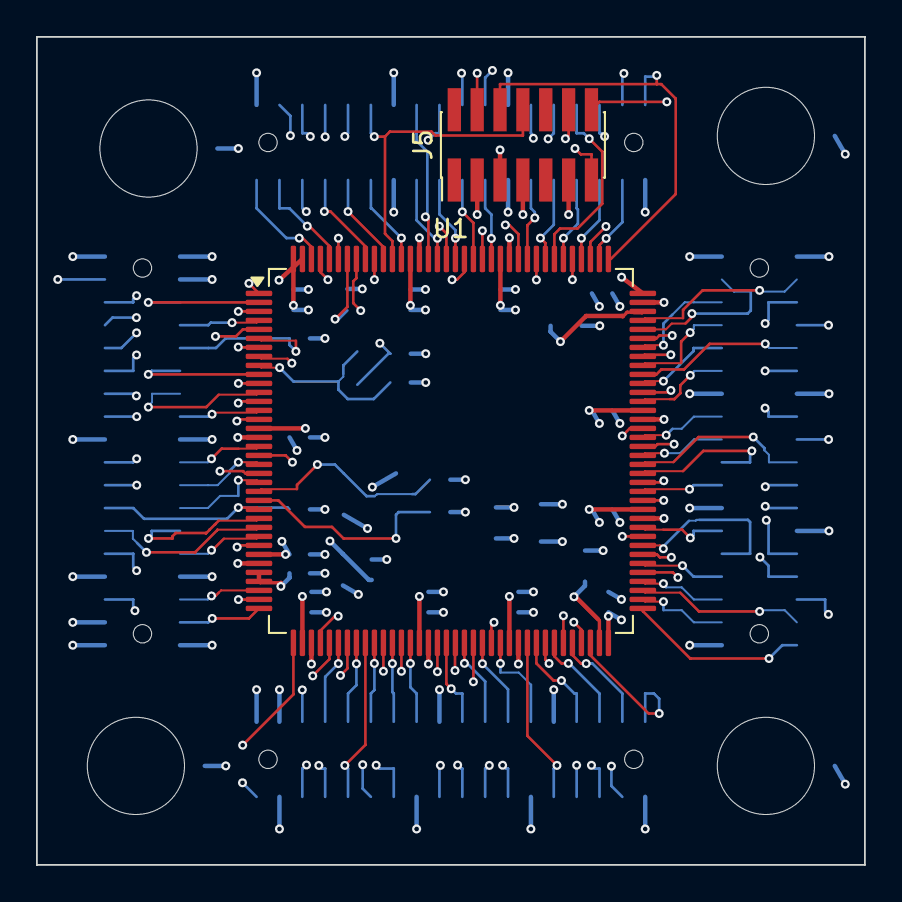
[picture p122: board TritonECU-MCU.kicad_pcb from above]

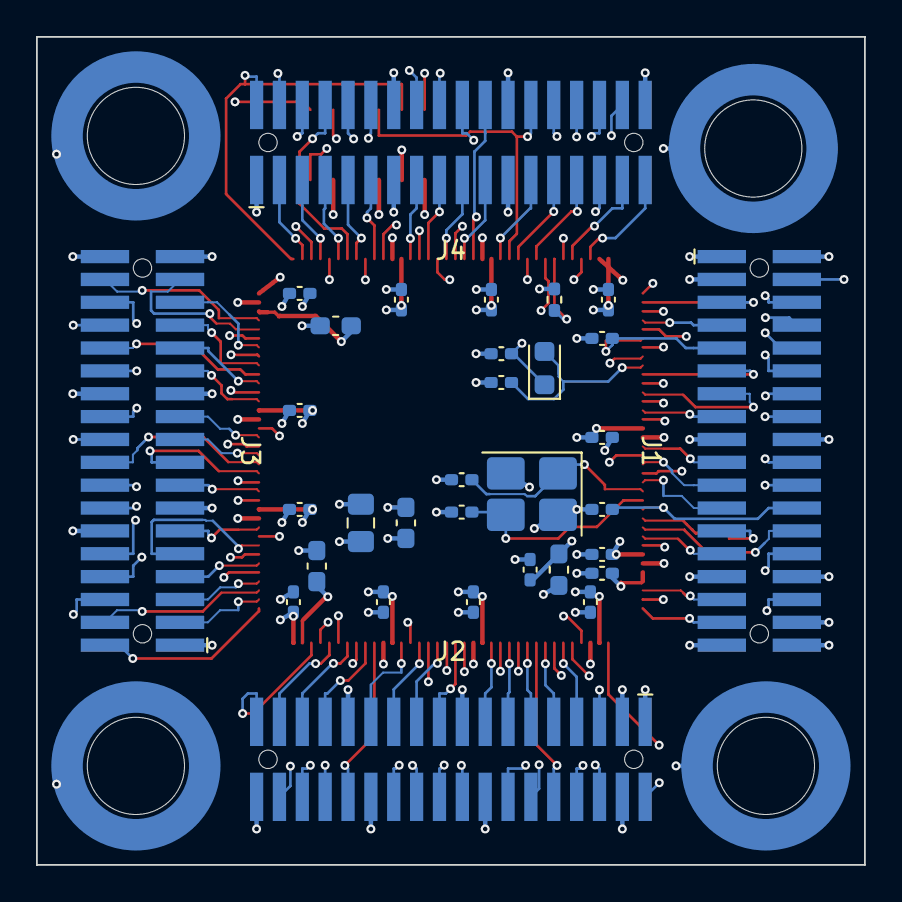
[picture p123: board TritonECU-MCU.kicad_pcb from below]

Board: 6 copper layers, 46.0 x 46.0 mm, 38 parts (36 on the bottom side), 122 nets.
