alpauna/TritonECU/docs/Schematics/KiCad/TritonECU/TritonECU.kicad_pcb

## KiCad design docs/Schematics/KiCad/TritonECU/TritonECU.kicad_pcb (2026-10-16)

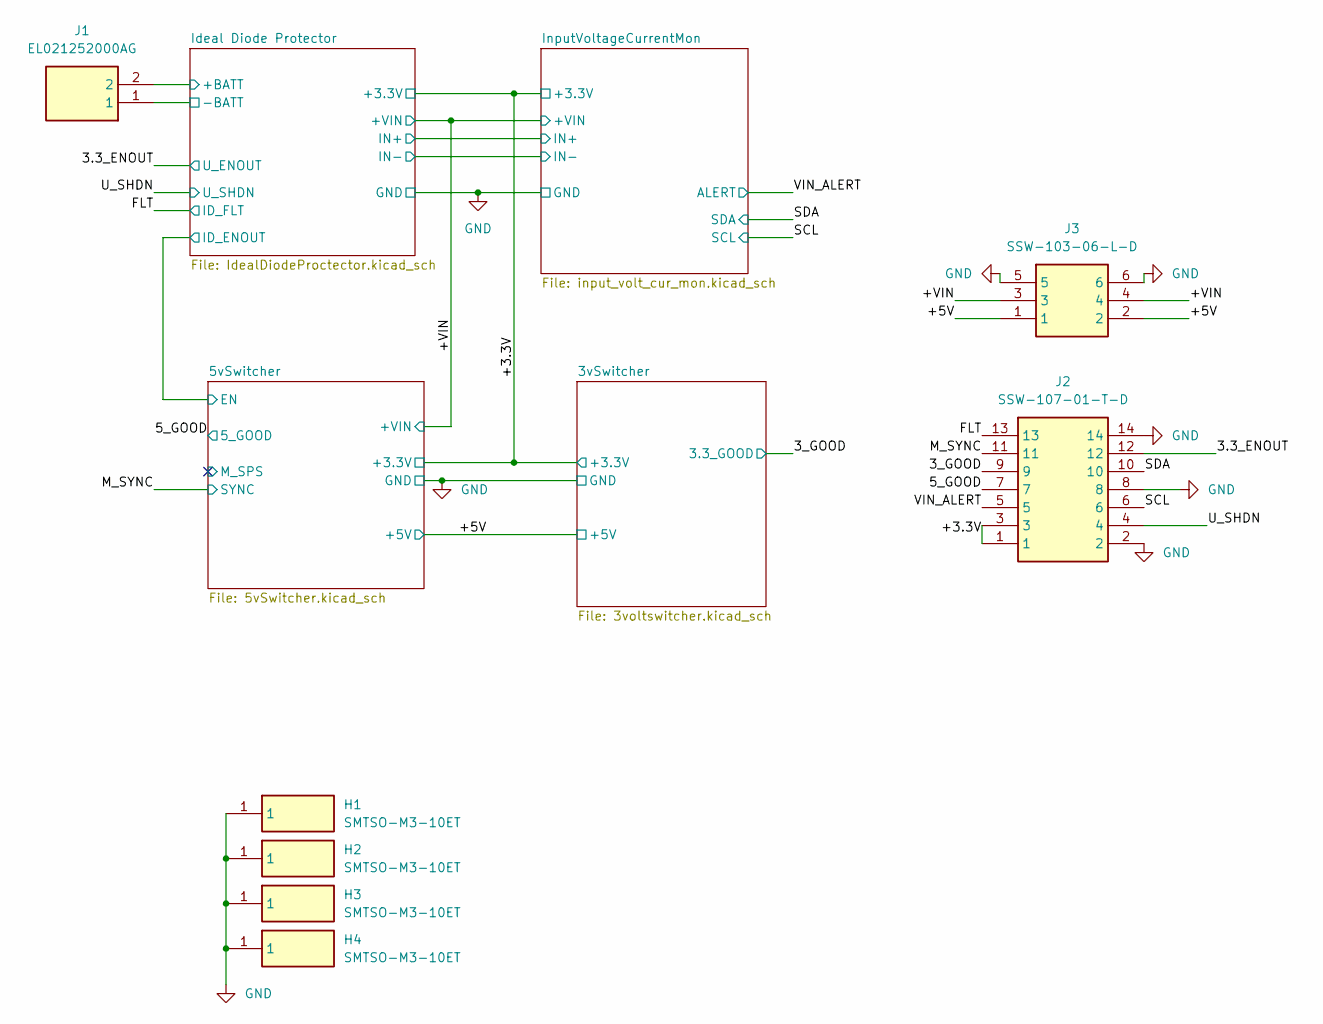
[picture p124: schematic Power.kicad_sch]

Parts:
H1, H2, H3, H4: SMTSO-M3-10ET; SMTSOM310ET; Manufacturer_Part_Number SMTSO-M3-10ET; Mouser Part Number 153-SMTSO-M3-10ET
J1: EL021252000AG; RHDR2W100P0X350_1X2_840X750X1130P; Manufacturer_Part_Number EL021252000AG; Mouser Part Number 523-EL021252000AG
J2: SSW-107-01-T-D; SAMTEC_SSW-107-01-T-D; Manufacturer_Part_Number SSW-107-01-T-D; Mouser Part Number 200-SSW10701TD
J3: SSW-103-06-L-D; SSW-103-XX-YYY-D; Manufacturer_Part_Number SSW-103-06-L-D; Mouser Part Number 200-SSW10306LD

Connections:
-BATT: J1.1; also elsewhere on the board
/Power/3.3_ENOUT: J2.12; also elsewhere on the board
/Power/3_GOOD: J2.9; also elsewhere on the board
/Power/5_GOOD: J2.7; also elsewhere on the board
/Power/+3.3V: J2.1, J2.3; also elsewhere on the board
/Power/+5V: J3.1, J3.2; also elsewhere on the board
/Power/+VIN: J3.3, J3.4; also elsewhere on the board
/Power/FLT: J2.13; also elsewhere on the board
/Power/Ideal Diode Protector/+BATT: J1.2; also elsewhere on the board
/Power/M_SYNC: J2.11; also elsewhere on the board
/Power/SCL: J2.6; also elsewhere on the board
/Power/SDA: J2.10; also elsewhere on the board
/Power/U_SHDN: J2.4; also elsewhere on the board
/Power/VIN_ALERT: J2.5; also elsewhere on the board
GND: H1.1 (1_1), H2.1 (1_1), H3.1 (1_1), H4.1 (1_1), J2.2, J2.8, J2.14, J3.5, J3.6; also elsewhere on the board

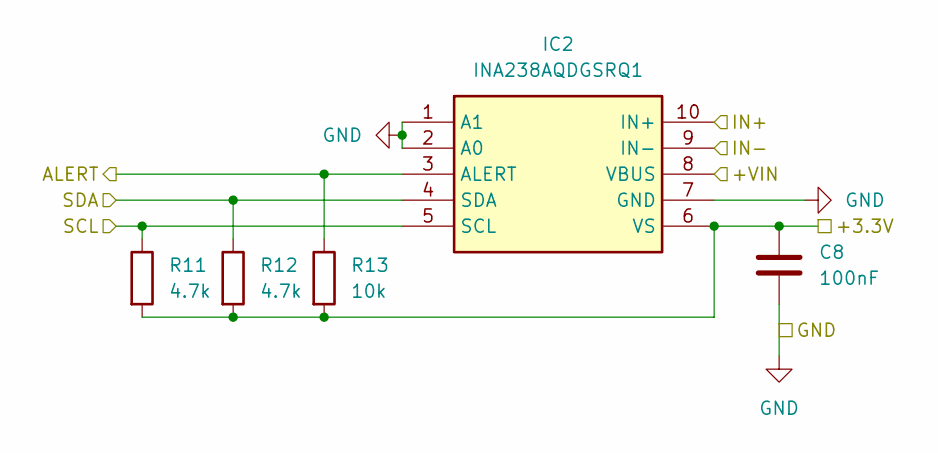
[picture p125: schematic input_volt_cur_mon.kicad_sch]

Parts:
C8: 100nF; C_0402_1005Metric_Pad0.74x0.62mm_HandSolder; Mouser Part Number 963-MASL105SB7104MF
IC2: INA238AQDGSRQ1; SOP50P490X110-10N; Manufacturer_Part_Number INA238AQDGSRQ1; Mouser Part Number 595-INA238AQDGSRQ1
R11, R12: 4.7k; R_0402_1005Metric_Pad0.72x0.64mm_HandSolder; Mouser Part Number 791-RMC1/16S-472JTH
R13: 10k; R_0402_1005Metric_Pad0.72x0.64mm_HandSolder; Mouser Part Number 652-CRT0402BY1002GLF

Connections:
/Power/+3.3V: C8.1, IC2.6 (VS), R11.2, R12.2, R13.2; also elsewhere on the board
/Power/+VIN: IC2.8 (VBUS), IC2.9 (IN-); also elsewhere on the board
/Power/Ideal Diode Protector/IN+: IC2.10 (IN+); also elsewhere on the board
/Power/SCL: IC2.5 (SCL), R11.1; also elsewhere on the board
/Power/SDA: IC2.4 (SDA), R12.1; also elsewhere on the board
/Power/VIN_ALERT: IC2.3 (ALERT), R13.1; also elsewhere on the board
GND: C8.2, IC2.1 (A1), IC2.2 (A0), IC2.7 (GND); also elsewhere on the board

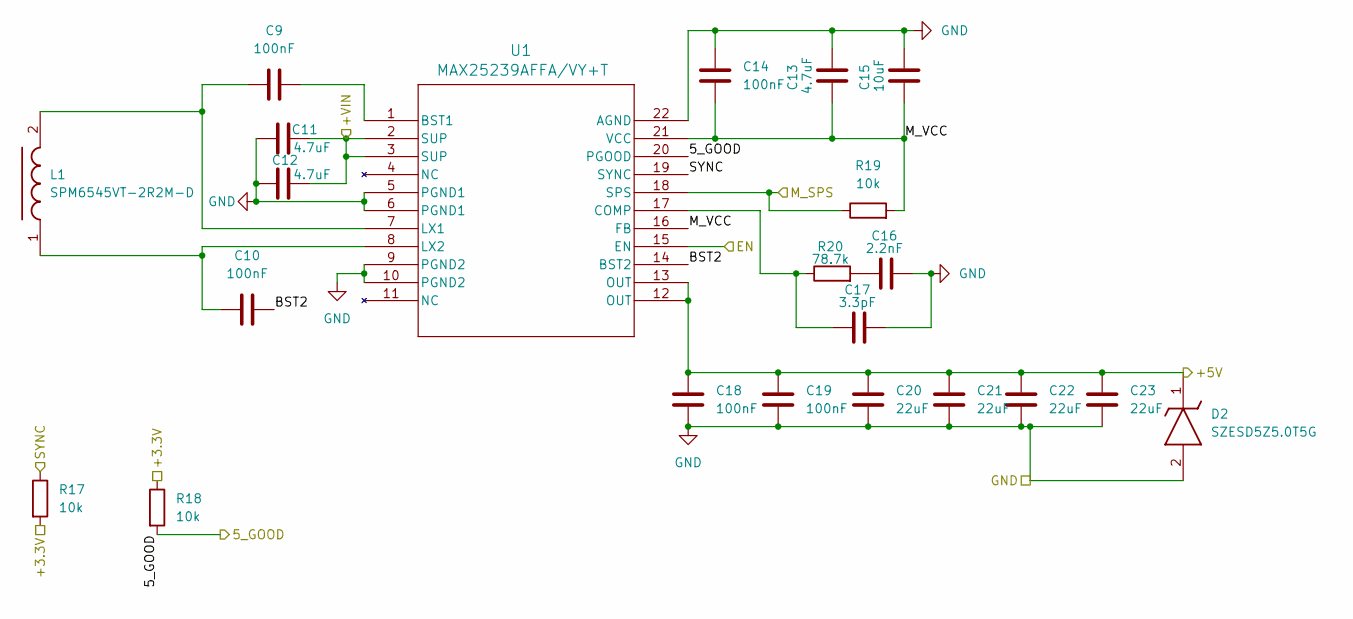
[picture p126: schematic 5vSwitcher.kicad_sch]

Parts:
C9, C10, C14, C18, C19: 100nF; C_0402_1005Metric_Pad0.74x0.62mm_HandSolder; Mouser Part Number 810-CGA2B3X7R1H104BD
C11, C12: 4.7uF; C_0805_2012Metric_Pad1.18x1.45mm_HandSolder; Mouser Part Number 81-GRM21BZ7YA475KE5K
C13: 4.7uF; C_0603_1608Metric_Pad1.08x0.95mm_HandSolder; Mouser Part Number 81-GRM188Z71A475ME5J
C15: 10uF; C_0805_2012Metric_Pad1.18x1.45mm_HandSolder; Mouser Part Number 581-0805YC106MAT2A
C16: 2.2nF; C_0402_1005Metric_Pad0.74x0.62mm_HandSolder; Mouser Part Number 81-GRM1555C1H222J01D
C17: 3.3pF; C_0402_1005Metric_Pad0.74x0.62mm_HandSolder; Mouser Part Number 81-GCM1555C2A3R3BE2D
C20, C21, C22, C23: 22uF; C_1206_3216Metric_Pad1.33x1.80mm_HandSolder; Mouser Part Number 963-EMK316BB7226ML-T
D2: SZESD5Z5.0T5G; SODFL1608X70N; Manufacturer_Part_Number SZESD5Z5.0T5G; Mouser Part Number 863-SZESD5Z5.0T5G
L1: SPM6545VT-2R2M-D; SPM6545VT; Manufacturer_Part_Number SPM6545VT-2R2M-D; Mouser Part Number 810-SPM6545VT-2R2M-D
R17, R18, R19: 10k; R_0402_1005Metric_Pad0.72x0.64mm_HandSolder; Mouser Part Number 652-CRT0402BY1002GLF
R20: 78.7k; R_0402_1005Metric_Pad0.72x0.64mm_HandSolder; Mouser Part Number 754-RG1005P-7872DT10
U1: MAX25239AFFA/VY+T; 21-100399_90-100137_ADI; Mouser Part Number 700-MAX25239AFFA/VY+

Connections:
/Power/5_GOOD: R18.2, U1.20 (PGOOD); also elsewhere on the board
/Power/5vSwitcher/BST2: C10.2, U1.14 (BST2)
/Power/5vSwitcher/M_SPS: R19.1, U1.18 (SPS)
/Power/5vSwitcher/M_VCC: C13.1, C14.1, C15.1, R19.2, U1.16 (FB), U1.21 (VCC)
/Power/+3.3V: R17.2, R18.1; also elsewhere on the board
/Power/+5V: C18.2, C19.2, C20.2, C21.2, C22.2, C23.2, D2.1 (K), U1.12 (OUT), U1.13 (OUT); also elsewhere on the board
/Power/+VIN: C11.2, C12.2, U1.2 (SUP), U1.3 (SUP); also elsewhere on the board
/Power/Ideal Diode Protector/ID_ENOUT: U1.15 (EN); also elsewhere on the board
/Power/M_SYNC: R17.1, U1.19 (SYNC); also elsewhere on the board
GND: C11.1, C12.1, C13.2, C14.2, C15.2, C16.1, C17.1, C18.1, C19.1, C20.1, C21.1, C22.1, C23.1, D2.2 (A), U1.5 (PGND1), U1.6 (PGND1), U1.9 (PGND2), U1.10 (PGND2), U1.22 (AGND); also elsewhere on the board
unnamed: C16.2, R20.2
unnamed: C9.2, U1.1 (BST1)
unnamed: C17.2, R20.1, U1.17 (COMP)
unnamed: C9.1, L1.2, U1.7 (LX1)
unnamed: C10.1, L1.1, U1.8 (LX2)

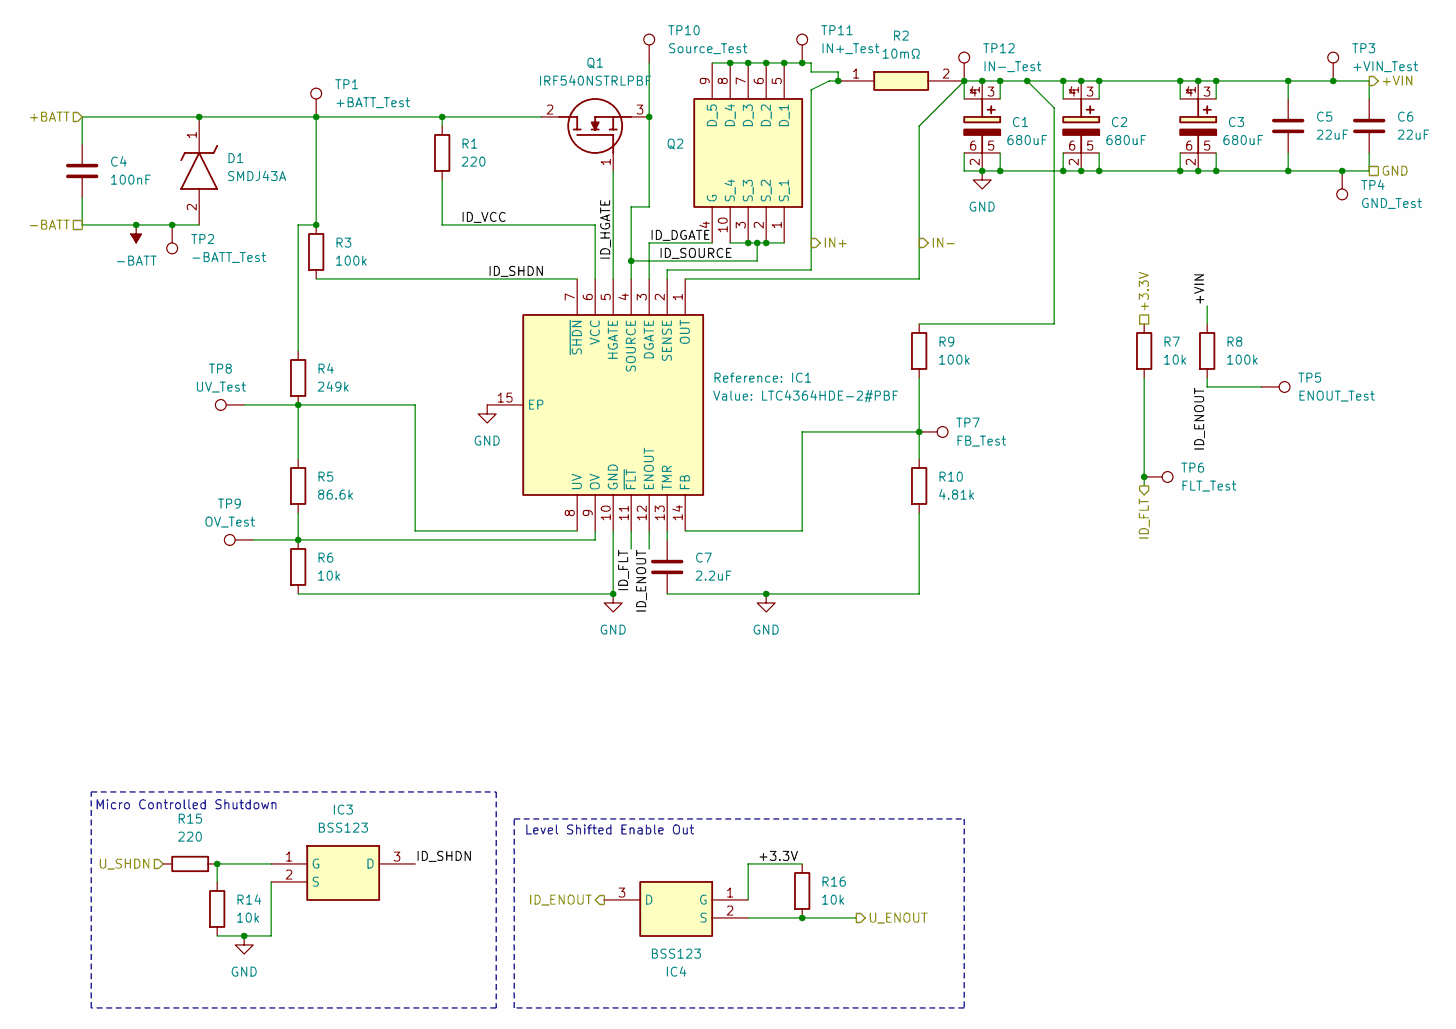
[picture p127: schematic IdealDiodeProctector.kicad_sch]

Parts:
C1, C2, C3: 680uF; EEHZU1E102UV; Mouser Part Number 667-EEH-ZU1V681UV
C4: 100nF; C_1808_4520Metric_Pad1.72x2.30mm_HandSolder; Mouser Part Number 77-VJ1808Y104KXCAT
C5, C6: 22uF; C_1210_3225Metric_Pad1.33x2.70mm_HandSolder; Mouser Part Number 187-CL32B226KLV6PNE
C7: 2.2uF; C_0603_1608Metric_Pad1.08x0.95mm_HandSolder; Mouser Part Number 81-GRM188Z71C225KE3D
D1: SMDJ43A; DIOM7959X262N; Mouser Part Number 652-5.0SMDJ43A
IC1: LTC4364HDE-2#PBF; SON50P300X400X80-15N-D; Mouser Part Number 584-LTC4364HDE-2#PBF
IC3, IC4: BSS123; SOT95P230X110-3N; Manufacturer_Part_Number BSS123; Mouser Part Number 512-BSS123
Q1: IRF540NSTRLPBF; IRF2804STRLPBF; Mouser Part Number 942-IRF540NSTRLPBF
Q2: IAUZ40N10S5N130ATMA1; Mouser Part Number 726-IAUZ40N10S5N130A
R1, R15: 220; R_0402_1005Metric_Pad0.72x0.64mm_HandSolder; Mouser Part Number 603-RT0402BRE07220RL
R2: 10mΩ; RESC6432X90N; Mouser Part Number 279-TLRP3A20WR010FTE
R3, R8, R9: 100k; R_0402_1005Metric_Pad0.72x0.64mm_HandSolder; Mouser Part Number 603-RC0402JR-7D100KL
R4: 249k; R_0402_1005Metric_Pad0.72x0.64mm_HandSolder; Mouser Part Number 279-RP73PF1E249KBTDF
R5: 86.6k; R_0402_1005Metric_Pad0.72x0.64mm_HandSolder; Mouser Part Number 667-ERJ-2RHD8662X
R6, R7, R14, R16: 10k; R_0402_1005Metric_Pad0.72x0.64mm_HandSolder; Mouser Part Number 652-CRT0402BY1002GLF
R10: 4.81k; R_0402_1005Metric_Pad0.72x0.64mm_HandSolder; Mouser Part Number 603-RT0402BRD074K81L
TP1: +BATT_Test; TestPoint_Pad_D1.5mm
TP2: -BATT_Test; TestPoint_Pad_D1.5mm
TP3: +VIN_Test; TestPoint_Pad_D1.5mm
TP4: GND_Test; TestPoint_Pad_D1.5mm
TP5: ENOUT_Test; TestPoint_Pad_D1.5mm
TP6: FLT_Test; TestPoint_Pad_D1.5mm
TP7: FB_Test; TestPoint_Pad_D1.5mm
TP8: UV_Test; TestPoint_Pad_D1.5mm
TP9: OV_Test; TestPoint_Pad_D1.5mm
TP10: Source_Test; TestPoint_Pad_D1.5mm
TP11: IN+_Test; TestPoint_Pad_D1.5mm
TP12: IN-_Test; TestPoint_Pad_D1.5mm

Connections:
-BATT: C4.2, D1.2 (A), TP2.1 (1_1); also elsewhere on the board
/Power/3.3_ENOUT: IC4.2 (S), R16.2; also elsewhere on the board
/Power/+3.3V: IC4.1 (G), R7.1, R16.1; also elsewhere on the board
/Power/+VIN: C1.1 (+_1), C1.3 (+_2), C1.4 (+_3), C2.1 (+_1), C2.3 (+_2), C2.4 (+_3), C3.1 (+_1), C3.3 (+_2), C3.4 (+_3), C5.1, C6.1, IC1.1 (OUT), R2.2, R8.1, R9.1, TP3.1 (1_1), TP12.1 (1_1); also elsewhere on the board
/Power/FLT: IC1.11 (~FLT), R7.2, TP6.1 (1_1); also elsewhere on the board
/Power/Ideal Diode Protector/+BATT: C4.1, D1.1 (K), Q1.2 (D), R1.1, R3.1, R4.1, TP1.1 (1_1); also elsewhere on the board
/Power/Ideal Diode Protector/ID_DGATE: IC1.3 (DGATE), Q2.4 (G)
/Power/Ideal Diode Protector/ID_ENOUT: IC1.12 (ENOUT), IC4.3 (D), R8.2, TP5.1 (1_1); also elsewhere on the board
/Power/Ideal Diode Protector/ID_HGATE: IC1.5 (HGATE), Q1.1 (G)
/Power/Ideal Diode Protector/ID_SHDN: IC1.7 (~SHDN), IC3.3 (D), R3.2
/Power/Ideal Diode Protector/ID_SOURCE: IC1.4 (SOURCE), Q1.3 (S), Q2.1 (S_1), Q2.2 (S_2), Q2.3 (S_3), Q2.10 (S_4), TP10.1 (1_1)
/Power/Ideal Diode Protector/ID_VCC: IC1.6 (VCC), R1.2
/Power/Ideal Diode Protector/IN+: IC1.2 (SENSE), Q2.5 (D_1), Q2.6 (D_2), Q2.7 (D_3), Q2.8 (D_4), Q2.9 (D_5), R2.1, TP11.1 (1_1); also elsewhere on the board
/Power/U_SHDN: R15.1; also elsewhere on the board
GND: C1.2 (-_1), C1.5 (-_2), C1.6 (-_3), C2.2 (-_1), C2.5 (-_2), C2.6 (-_3), C3.2 (-_1), C3.5 (-_2), C3.6 (-_3), C5.2, C6.2, C7.2, IC1.10 (GND), IC1.15 (EP), IC3.2 (S), R6.2, R10.2, R14.2, TP4.1 (1_1); also elsewhere on the board
unnamed: IC1.14 (FB), R9.2, R10.1, TP7.1 (1_1)
unnamed: IC1.9 (OV), R5.2, R6.1, TP9.1 (1_1)
unnamed: C7.1, IC1.13 (TMR)
unnamed: IC1.8 (UV), R4.2, R5.1, TP8.1 (1_1)
unnamed: IC3.1 (G), R14.1, R15.2

Notes on the sheet:
Micro Controlled Shutdown
Level Shifted Enable Out

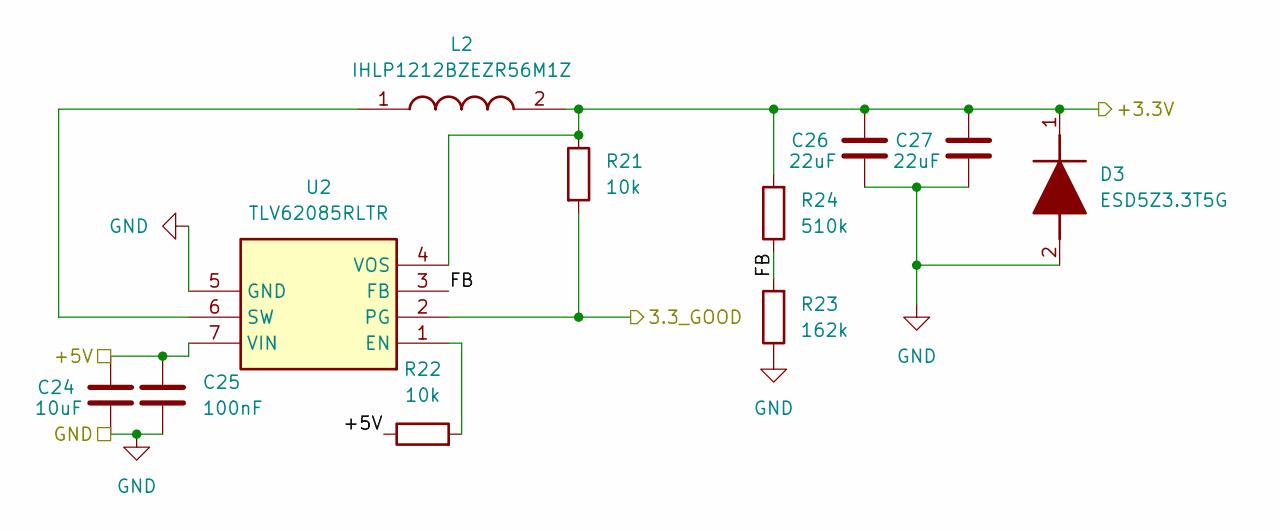
[picture p128: schematic 3voltswitcher.kicad_sch]

Parts:
C24: 10uF; C_0805_2012Metric_Pad1.18x1.45mm_HandSolder; Mouser Part Number 581-0805YC106MAT2A
C25: 100nF; C_0402_1005Metric_Pad0.74x0.62mm_HandSolder; Mouser Part Number 810-CGA2B3X7R1H104BD
C26, C27: 22uF; C_1206_3216Metric_Pad1.33x1.80mm_HandSolder; Mouser Part Number 963-MAASL31LAB7226MT
D3: ESD5Z3.3T5G; SODFL1608X70N; Manufacturer_Part_Number ESD5Z3.3T5G; Mouser Part Number 863-ESD5Z3.3T5G
L2: IHLP1212BZEZR56M1Z; Manufacturer_Part_Number IHLP1212BZEZR56M1Z; Mouser Part Number 70-IHLP1212BZEZR56M
R21, R22: 10k; R_0402_1005Metric_Pad0.72x0.64mm_HandSolder; Mouser Part Number 652-CRT0402BY1002GLF
R23: 162k; R_0402_1005Metric_Pad0.72x0.64mm_HandSolder; Mouser Part Number 603-RC0402DR-07162KL
R24: 510k; R_0402_1005Metric_Pad0.72x0.64mm_HandSolder; Mouser Part Number 667-ERJ-2RKD5103X
U2: TLV62085RLTR; RLT0007A; Manufacturer_Part_Number TLV62085RLTR; Mouser Part Number 595-TLV62085RLTR

Connections:
/Power/3_GOOD: R21.2, U2.2 (PG); also elsewhere on the board
/Power/3vSwitcher/FB: R23.2, R24.1, U2.3 (FB)
/Power/+3.3V: C26.2, C27.2, D3.1 (K), L2.2, R21.1, R24.2, U2.4 (VOS); also elsewhere on the board
/Power/+5V: C24.2, C25.2, R22.1, U2.7 (VIN); also elsewhere on the board
GND: C24.1, C25.1, C26.1, C27.1, D3.2 (A), R23.1, U2.5 (GND); also elsewhere on the board
unnamed: R22.2, U2.1 (EN)
unnamed: L2.1, U2.6 (SW)
