alpauna/TritonECU/docs/Schematics/KiCad/TritonECU/TritonECU.kicad_pcb

## KiCad design docs/Schematics/KiCad/TritonECU/TritonECU.kicad_pcb (continued)

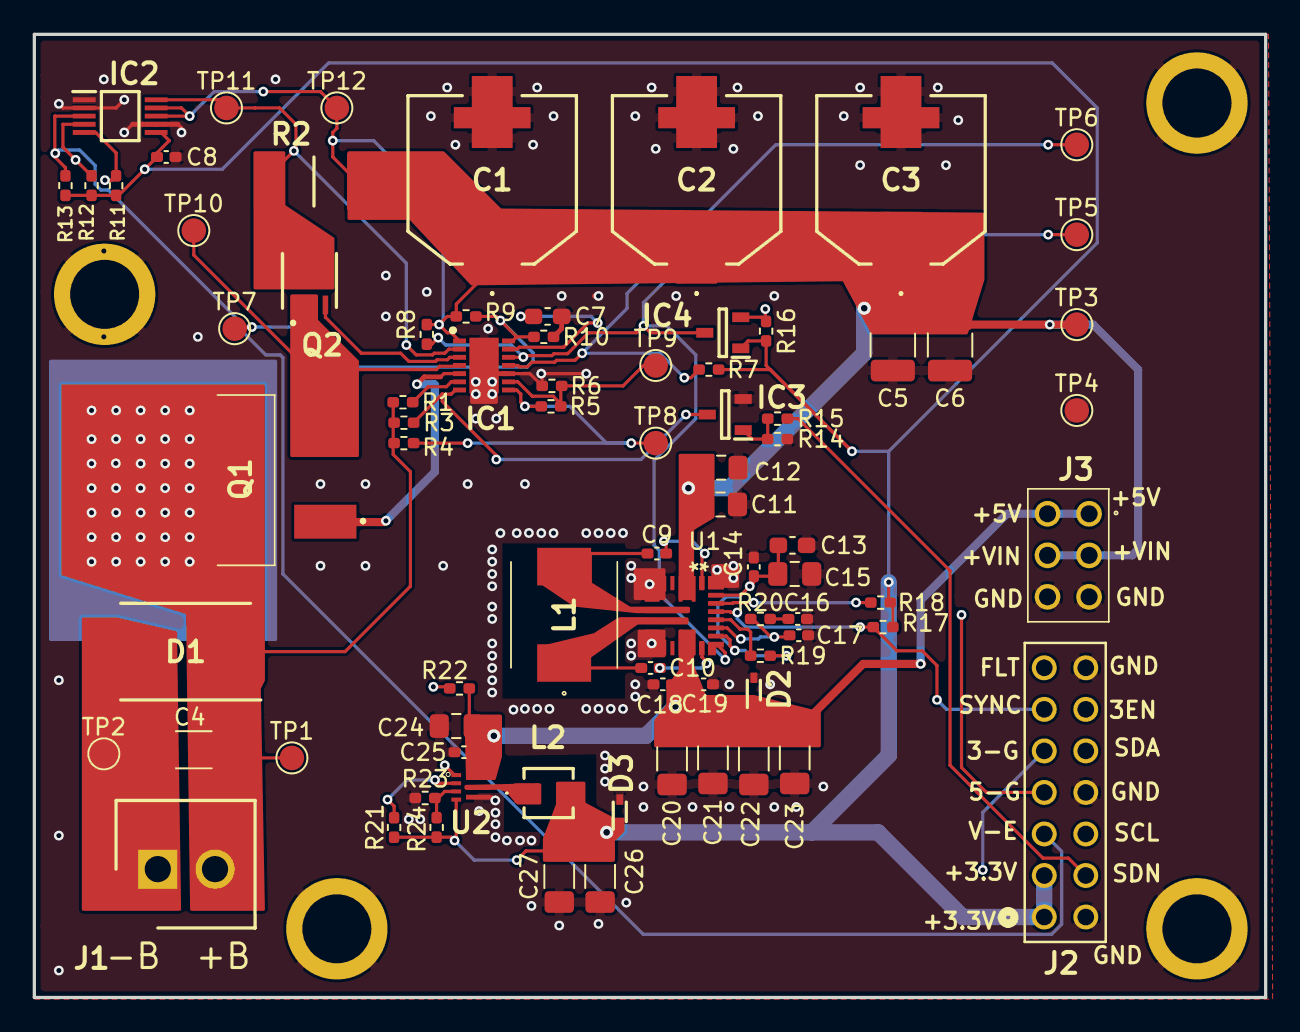
[picture p129: board TritonECU.kicad_pcb from above]

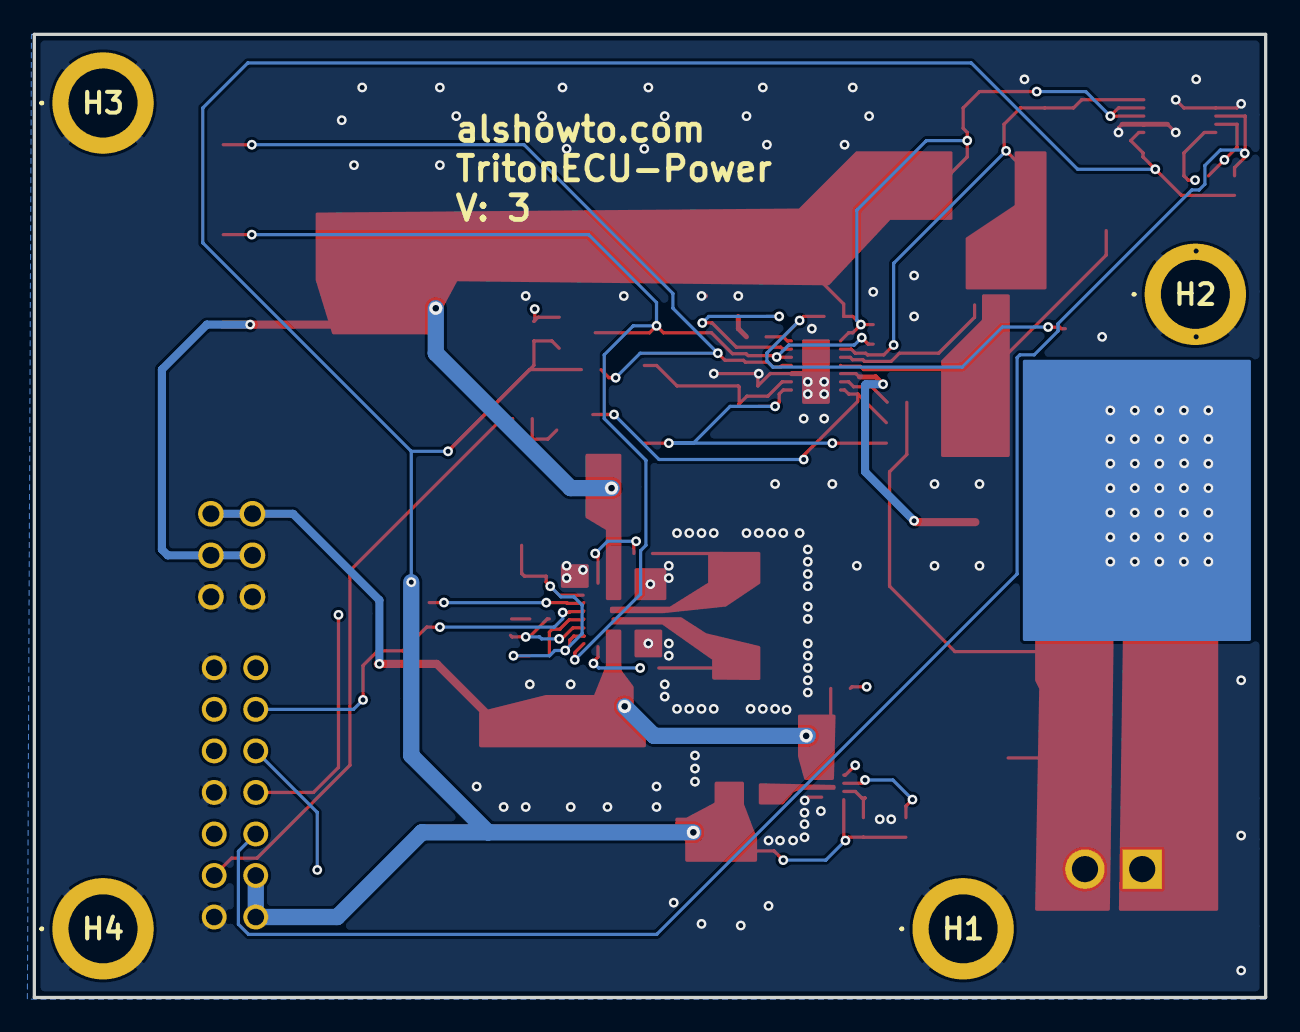
[picture p130: board TritonECU.kicad_pcb from below]

Board: 4 copper layers, 75.3 x 58.9 mm, 83 parts (4 on the bottom side), 38 nets.
