alpauna/TritonECU/firmware/power-diag/src/main.cpp

/* POWER board bring-up diagnostic.
 *
 * Answers one question the slow instruments cannot: WHICH RAIL LET GO FIRST.
 *
 * The board drops out above ~24 V and the protector's UV, OV and FB-clamp
 * inputs have all been cleared by measurement, so either the LTC4364 is
 * faulting on current limit or the MAX25239 is misbehaving as its on-time
 * hits the floor and the protector is merely reacting. Those two look
 * identical from outside - VIN disappears either way.
 *
 * They differ in ORDER, by microseconds:
 *
 *   3.3_ENOUT falls first, then 5_GOOD  -> protector faulted, starved the buck
 *   5_GOOD falls first, then 3.3_ENOUT  -> buck failed, protector reacted
 *
 * So the three status pins are captured on interrupt and timestamped with the
 * DWT cycle counter: at 216 MHz that is 4.63 ns per tick, which is four orders
 * of magnitude finer than the event being resolved. The INA238 cannot do this -
 * at 20 kSa/s it averages straight over the whole transition.
 */

#include <Arduino.h>
#include <Wire.h>

/* Print to BOTH ports, as ../ecu/src/stm32/Console.cpp does and for the same
 * reason: `Serial` is USART3 on PD8/PD9, which belongs to the ON-BOARD ST-Link.
 * With an external STLINK-V3 driving SWD and the Nucleo's own USB unplugged,
 * that port enumerates nowhere and output vanishes silently. USART2 on PD5/PD6
 * goes to the V3's VCP (or any USB-serial adapter). Mirroring costs nothing and
 * removes a failure that looks exactly like a crashed program. */
static HardwareSerial ExtSerial(PD6, PD5);   // RX, TX
#define OUT(...)  do { Serial.printf(__VA_ARGS__); ExtSerial.printf(__VA_ARGS__); } while (0)

static const uint8_t PIN_ENOUT = D7;   // 3.3_ENOUT - LTC4364 enable, level shifted
static const uint8_t PIN_5GOOD = D4;
static const uint8_t PIN_3GOOD = D2;

/* INA238 sits on the same 10 mOhm shunt the LTC4364 uses for current limit, so
 * it reads the current that trips the protector - just far too slowly to see
 * the trip itself. Useful for the trend as VIN is swept, not for the event. */
static const uint8_t REG_CONFIG = 0x00, REG_ADCCFG = 0x01;
static const uint8_t REG_VSHUNT = 0x04, REG_VBUS = 0x05;

/* ADCRANGE = 0: +/-163.84 mV full scale, 5 uV/LSB -> 500 uA/LSB on 10 mOhm,
 * +/-16.384 A. ADCRANGE 1 would resolve finer but clips at 4.1 A, below the
 * 5 A limit we are trying to watch approach. */
/* Scaled to INTEGERS, not floats. newlib-nano's printf drops %f unless float
 * support is linked - and worse, a dropped %f consumes no argument, so every
 * following %s reads a garbage pointer. The first run printed "VBUS  V  I  A"
 * and "  4  aw F" for exactly that reason: one missing linker flag corrupting
 * lines that had nothing to do with floats.
 *
 *   VBUS  3.125 mV/LSB      -> mV = raw * 25 / 8
 *   VSHUNT 5 uV/LSB on 10 mOhm -> 500 uA/LSB, so mA = raw / 2
 *   DWT at 216 MHz          -> 216 cycles per microsecond */
static const uint32_t CYC_PER_US = 216;

static uint8_t ina_addr = 0;

/* 256, not 64. A hiccupping board produced a burst that lapped a 64-entry ring
 * in well under the print interval, and a lapped ring prints stale entries as
 * if they were fresh - deltas that look like real timing and are not. Dropped
 * events are counted so an overflow announces itself rather than lying. */
/* Peak-hold on the shunt. A current limit event is over in half a second and
 * the print loop runs at 2 Hz, so the peak has to be caught in the sampling
 * loop or it is simply not seen. Held until reported, then rearmed. */
static int16_t peak_raw = 0;

struct Event { uint32_t cyc; uint8_t pin; uint8_t level; };
static volatile Event  ring[256];
static volatile uint32_t dropped = 0;
static volatile uint8_t head = 0, tail = 0;

/* Fields written one at a time, not as a struct. A volatile array element
 * cannot be assigned from an aggregate - the implicit copy constructor takes a
 * non-volatile reference - and volatile is not decoration here: the ISR writes
 * what the main loop reads. */
static inline void log_edge(uint8_t pin, uint8_t level) {
    uint8_t h = head & 255;
    ring[h].cyc   = DWT->CYCCNT;
    ring[h].pin   = pin;
    ring[h].level = level;
    head = head + 1;                    // single writer, free-running index
}
static void isr_enout() { log_edge(0, digitalRead(PIN_ENOUT)); }
static void isr_5good() { log_edge(1, digitalRead(PIN_5GOOD)); }
static void isr_3good() { log_edge(2, digitalRead(PIN_3GOOD)); }

static const char* NAME[] = { "3.3_ENOUT", "5_GOOD   ", "3.3_GOOD " };

static bool ina_read(uint8_t reg, int16_t& v) {
    Wire.beginTransmission(ina_addr); Wire.write(reg);
    if (Wire.endTransmission(false) != 0) return false;
    if (Wire.requestFrom((int)ina_addr, 2) != 2) return false;
    v = (int16_t)((Wire.read() << 8) | Wire.read());
    return true;
}
static bool ina_write(uint8_t reg, uint16_t v) {
    Wire.beginTransmission(ina_addr);
    Wire.write(reg); Wire.write(v >> 8); Wire.write(v & 0xFF);
    return Wire.endTransmission() == 0;
}

void setup() {
    Serial.begin(115200);
    ExtSerial.begin(115200);
    delay(300);
    OUT("\n\n=== POWER board diagnostic ===\n");

    // DWT cycle counter - the whole reason this runs on an M7
    CoreDebug->DEMCR |= CoreDebug_DEMCR_TRCENA_Msk;
    DWT->CYCCNT = 0;
    DWT->CTRL  |= DWT_CTRL_CYCCNTENA_Msk;
    OUT("DWT at %lu Hz -> %lu cycles per us\n", (unsigned long)F_CPU, (unsigned long)CYC_PER_US);

    /* Plain INPUT, NOT pulldown. A pulldown here was a mistake that cost a
     * measurement: all three lines already carry a 10k pull-up on the board, so
     * adding the STM32's ~40k internal pulldown turns a firmly driven line into
     * an 8k divider at 2.6 V - noise-susceptible on a flying lead. It produced
     * 10,508 spurious edges in four minutes.
     *
     * The problem it was meant to fix - a dead board reading 111 because those
     * pull-ups sit on ITS rail - is solved below instead, by reporting the pins
     * as unknown when VBUS says there is no board. Do not fight a pull-up with
     * a weaker pull-down; decide from something that is actually true. */
    pinMode(PIN_ENOUT, INPUT);
    pinMode(PIN_5GOOD, INPUT);
    pinMode(PIN_3GOOD, INPUT);
    attachInterrupt(digitalPinToInterrupt(PIN_ENOUT), isr_enout, CHANGE);
    attachInterrupt(digitalPinToInterrupt(PIN_5GOOD), isr_5good, CHANGE);
    attachInterrupt(digitalPinToInterrupt(PIN_3GOOD), isr_3good, CHANGE);
    OUT("initial: ENOUT %d  5_GOOD %d  3.3_GOOD %d\n",
        digitalRead(PIN_ENOUT), digitalRead(PIN_5GOOD), digitalRead(PIN_3GOOD));

    Wire.begin();
    Wire.setClock(400000);
    OUT("I2C scan:");
    for (uint8_t a = 0x40; a <= 0x4F; a++) {       // INA238 strap range
        Wire.beginTransmission(a);
        if (Wire.endTransmission() == 0) { OUT(" 0x%02X", a); if (!ina_addr) ina_addr = a; }
    }
    if (!ina_addr) { OUT("  none found - check SDA/SCL and 3V3\n"); return; }
    OUT("  -> using 0x%02X\n", ina_addr);

    ina_write(REG_CONFIG, 0x8000); delay(5);       // reset
    ina_write(REG_CONFIG, 0x0000);                 // ADCRANGE = 0, see above
    /* 0xB000 = continuous shunt + bus, 50 us each, no averaging -> ~100 us per
     * pair. The default 1052 us setting gives 534 samples across a 594 ms fault,
     * which sees THAT it tripped; this gives ~5400, which reads the limit
     * PLATEAU. Design is 10 mOhm x 50 mV = 5.0 A, about 10000 counts. */
    ina_write(REG_ADCCFG, 0xB000);
    OUT("\ncyc-delta   pin        edge     (deltas are from the previous event)\n");
}

void loop() {
    static uint32_t last = 0, prev_cyc = 0;

    /* Bounded per pass. An edge burst prints faster than the sampling loop can
     * run - 3 ms per line at 115200 - so an unbounded drain starves the INA238
     * poll below and the peak-hold never executes. That is how a short went
     * unmeasured: the flood ate the measurement, not the event. */
    uint8_t budget = 4;
    while (tail != head && budget--) {
        uint8_t t = tail & 255;
        uint32_t cyc = ring[t].cyc; uint8_t pin = ring[t].pin, lvl = ring[t].level;
        tail++;
        uint32_t d = cyc - prev_cyc; prev_cyc = cyc;
        /* The FIRST line after a quiet period is the one that matters - it names
         * the rail that failed. The deltas after it are the cascade. */
        OUT("%8lu.%03lu us  %s  %s\n",
            (unsigned long)(d / CYC_PER_US),
            (unsigned long)((d % CYC_PER_US) * 1000 / CYC_PER_US),
            NAME[pin], lvl ? "RISE" : "FALL");
    }

    /* Poll the shunt as fast as the bus allows, every pass, and keep the peak.
     * This is the measurement; the 2 Hz line below is only the report. */
    if (ina_addr) {
        int16_t vs_fast;
        if (ina_read(REG_VSHUNT, vs_fast) && vs_fast > peak_raw) peak_raw = vs_fast;
    }

    if (millis() - last >= 500) {
        last = millis();
        int16_t vs, vb;
        if (ina_addr && ina_read(REG_VSHUNT, vs) && ina_read(REG_VBUS, vb)) {
            int32_t mv = (int32_t)vb * 25 / 8;
            int32_t ma = (int32_t)vs / 2;
            long peak_ma = (long)peak_raw / 2;
            uint32_t drop = dropped; dropped = 0;
            /* Below 3 V there is no board, so its pull-ups are dead and the pin
             * reads mean nothing. Say so rather than printing a confident 111. */
            if (mv < 3000)
                OUT("[%6lus] VBUS %ld.%03ld V   I %ld mA   PEAK %ld mA   pins --- (no board)\n",
                    millis()/1000, mv/1000, (mv<0?-mv:mv)%1000, (long)ma, peak_ma);
            else
                OUT("[%6lus] VBUS %ld.%03ld V   I %ld mA   PEAK %ld mA   ENOUT %d 5G %d 3G %d%s\n",
                    millis()/1000, mv/1000, (mv<0?-mv:mv)%1000, (long)ma, peak_ma,
                    digitalRead(PIN_ENOUT), digitalRead(PIN_5GOOD), digitalRead(PIN_3GOOD),
                    drop ? "  [edges dropped]" : "");
            peak_raw = 0;                      // rearm for the next window
        }
    }
}
