alpauna/TritonECU/src/WebHandler.cpp

#include "WebHandler.h"
#include "AsyncJson.h"
#include "ArduinoJson.h"
#include "ECU.h"
#include "CrankSensor.h"
#include "AlternatorControl.h"
#include "IgnitionManager.h"
#include "InjectionManager.h"
#include "SensorManager.h"
#include "CJ125Controller.h"
#include "TransmissionManager.h"
#include "FuelManager.h"
#include "TuneTable.h"
#include "PinExpander.h"
#include "ADS1115Reader.h"
#include "MCP3204Reader.h"
#include "CustomPin.h"
#include "OtaUtils.h"
#include <Preferences.h>

extern const char compile_date[];
extern uint8_t getCpuLoadCore0();
extern uint8_t getCpuLoadCore1();
extern bool _apModeActive;
extern bool _safeMode;
extern uint32_t _bootCountExposed;
extern const char* _resetReasonStr;

WebHandler::WebHandler(uint16_t port, Scheduler* ts)
    : _server(port), _ws("/ws"), _ts(ts), _ecu(nullptr),
      _config(nullptr), _shouldReboot(false), _tDelayedReboot(nullptr),
      _ntpSynced(false), _tNtpSync(nullptr) {}

void WebHandler::setFtpControl(FtpEnableCallback enableCb, FtpDisableCallback disableCb, FtpStatusCallback statusCb) {
    _ftpEnableCb = enableCb;
    _ftpDisableCb = disableCb;
    _ftpStatusCb = statusCb;
}

void WebHandler::setFtpState(bool* activePtr, unsigned long* stopTimePtr) {
    _ftpActivePtr = activePtr;
    _ftpStopTimePtr = stopTimePtr;
}

bool WebHandler::checkAuth(AsyncWebServerRequest* request) {
    if (!_config || !_config->hasAdminPassword()) return true;
    String authHeader = request->header("Authorization");
    if (!authHeader.startsWith("Basic ")) {
        request->requestAuthentication(nullptr, false);
        return false;
    }
    String b64 = authHeader.substring(6);
    size_t decodedLen = 0;
    mbedtls_base64_decode(nullptr, 0, &decodedLen, (const uint8_t*)b64.c_str(), b64.length());
    uint8_t* decoded = new uint8_t[decodedLen + 1];
    mbedtls_base64_decode(decoded, decodedLen + 1, &decodedLen, (const uint8_t*)b64.c_str(), b64.length());
    decoded[decodedLen] = '\0';
    String credentials = String((char*)decoded);
    delete[] decoded;
    int colonIdx = credentials.indexOf(':');
    if (colonIdx < 0) { request->requestAuthentication(nullptr, false); return false; }
    String password = credentials.substring(colonIdx + 1);
    if (_config->verifyAdminPassword(password)) return true;
    request->requestAuthentication(nullptr, false);
    return false;
}

void WebHandler::begin() {
    _tNtpSync = new Task(2 * TASK_HOUR, TASK_FOREVER, [this]() { syncNtpTime(); }, _ts, false);

    _server.onNotFound([](AsyncWebServerRequest* request) { request->send(404); });
    _server.onFileUpload([](AsyncWebServerRequest*, String, size_t, uint8_t*, size_t, bool) {});
    _server.onRequestBody([](AsyncWebServerRequest*, uint8_t*, size_t, size_t, size_t) {});

    _ws.onEvent([this](AsyncWebSocket* s, AsyncWebSocketClient* c, AwsEventType t, void* a, uint8_t* d, size_t l) {
        onWsEvent(s, c, t, a, d, l);
    });
    _server.addHandler(&_ws);
    Log.setWebSocket(&_ws);
    Log.enableWebSocket(true);

    setupRoutes();
    _server.begin();
    Log.info("HTTP", "HTTP server started");
}

const char* WebHandler::getWiFiIP() {
    if (!WiFi.isConnected()) return NOT_AVAILABLE;
    _wifiIPStr = WiFi.localIP().toString();
    return _wifiIPStr.length() > 0 ? _wifiIPStr.c_str() : NOT_AVAILABLE;
}

void WebHandler::startNtpSync() { if (_tNtpSync) _tNtpSync->enable(); }

void WebHandler::syncNtpTime() {
    if (WiFi.status() != WL_CONNECTED) return;
    Log.info("NTP", "Syncing time...");
    configTime(_gmtOffsetSec, _daylightOffsetSec, NTP_SERVER1, NTP_SERVER2);
    struct tm timeinfo;
    int retry = 0;
    while (!getLocalTime(&timeinfo) && retry < 10) { vTaskDelay(pdMS_TO_TICKS(1000)); retry++; }
    if (retry < 10) {
        _ntpSynced = true;
        char timeStr[64];
        strftime(timeStr, sizeof(timeStr), "%Y-%m-%d %H:%M:%S", &timeinfo);
        Log.info("NTP", "Time synced: %s", timeStr);
    } else {
        Log.error("NTP", "Failed to sync time");
    }
}

void WebHandler::onWsEvent(AsyncWebSocket*, AsyncWebSocketClient* client,
                           AwsEventType type, void*, uint8_t*, size_t) {
    if (type == WS_EVT_CONNECT) {
        String json = "{\"status\":\"connected\",\"ip\":\"" + WiFi.localIP().toString() + "\"}";
        client->text(json);
    }
}

void WebHandler::setTimezone(int32_t gmtOffset, int32_t daylightOffset) {
    _gmtOffsetSec = gmtOffset;
    _daylightOffsetSec = daylightOffset;
}

const char* WebHandler::getContentType(const String& path) {
    if (path.endsWith(".html")) return "text/html";
    if (path.endsWith(".css")) return "text/css";
    if (path.endsWith(".js")) return "application/javascript";
    if (path.endsWith(".json")) return "application/json";
    if (path.endsWith(".ico")) return "image/x-icon";
    if (path.endsWith(".png")) return "image/png";
    return "text/plain";
}

void WebHandler::serveFile(AsyncWebServerRequest* request, const String& path) {
    if (!_config || !_config->isSDCardInitialized()) {
        request->send(503, "text/plain", "SD card not available");
        return;
    }
    String fullPath = "/www" + path;
    fs::File file = ECU_SD.open(fullPath.c_str(), FILE_READ);
    if (!file) { request->send(404, "text/plain", "Not found: " + path); return; }
    size_t fileSize = file.size();
    if (fileSize == 0) { file.close(); request->send(200, getContentType(path), ""); return; }
    char* buf = (char*)ps_malloc(fileSize + 1);
    if (!buf) { file.close(); request->send(500, "text/plain", "Out of memory"); return; }
    file.read((uint8_t*)buf, fileSize);
    buf[fileSize] = '\0';
    file.close();
    request->send(200, getContentType(path), buf);
    free(buf);
}

void WebHandler::setupRoutes() {
    // Static pages
    _server.on("/theme.css", HTTP_GET, [this](AsyncWebServerRequest* r) { serveFile(r, "/theme.css"); });
    _server.on("/", HTTP_GET, [this](AsyncWebServerRequest* r) { serveFile(r, "/index.html"); });
    _server.on("/dashboard", HTTP_GET, [this](AsyncWebServerRequest* r) { serveFile(r, "/dashboard.html"); });
    _server.on("/sensors", HTTP_GET, [this](AsyncWebServerRequest* r) {
        if (r->hasParam("format") && r->getParam("format")->value() == "json") {
            if (!checkAuth(r)) return;
            if (!_ecu || !_ecu->getSensorManager()) {
                r->send(500, "application/json", "{\"error\":\"ECU not available\"}");
                return;
            }
            SensorManager* sm = _ecu->getSensorManager();
            JsonDocument doc;
            JsonArray sensors = doc["sensors"].to<JsonArray>();
            for (uint8_t i = 0; i < MAX_SENSORS; i++) {
                const SensorDescriptor* d = sm->getDescriptor(i);
                if (!d) continue;
                JsonObject s = sensors.add<JsonObject>();
                s["name"] = d->name;
                s["unit"] = d->unit;
                JsonObject src = s["source"].to<JsonObject>();
                src["type"] = (int)d->sourceType;
                src["device"] = d->sourceDevice;
                src["channel"] = d->sourceChannel;
                src["pin"] = d->sourcePin;
                JsonObject cal = s["cal"].to<JsonObject>();
                cal["type"] = (int)d->calType;
                cal["a"] = d->calA; cal["b"] = d->calB;
                cal["c"] = d->calC; cal["d"] = d->calD;
                JsonObject filt = s["filter"].to<JsonObject>();
                filt["ema"] = d->emaAlpha;
                filt["avg"] = d->avgSamples;
                JsonObject val = s["validate"].to<JsonObject>();
                if (!isnan(d->errorMin)) val["errorMin"] = d->errorMin;
                if (!isnan(d->errorMax)) val["errorMax"] = d->errorMax;
                if (!isnan(d->warnMin)) val["warnMin"] = d->warnMin;
                if (!isnan(d->warnMax)) val["warnMax"] = d->warnMax;
                val["settle"] = d->settleGuard;
                val["settleMs"] = d->settleMs;
                JsonObject fault = s["fault"].to<JsonObject>();
                fault["bit"] = d->faultBit;
                fault["action"] = (int)d->faultAction;
                s["activeStates"] = d->activeStates;
            }
            JsonArray rules = doc["rules"].to<JsonArray>();
            for (uint8_t i = 0; i < MAX_RULES; i++) {
                const FaultRule* rule = sm->getRule(i);
                if (!rule) continue;
                JsonObject ro = rules.add<JsonObject>();
                ro["name"] = rule->name;
                ro["sensor"] = rule->sensorSlot;
                ro["sensorB"] = rule->sensorSlotB;
                ro["op"] = (int)rule->op;
                ro["a"] = rule->thresholdA;
                ro["b"] = rule->thresholdB;
                ro["bit"] = rule->faultBit;
                ro["action"] = (int)rule->faultAction;
                ro["debounce"] = rule->debounceMs;
                ro["running"] = rule->requireRunning;
            }
            String out;
            out.reserve(4096);
            serializeJson(doc, out);
            r->send(200, "application/json", out);
        } else {
            serveFile(r, "/sensors.html");
        }
    });
    _server.on("/tune", HTTP_GET, [this](AsyncWebServerRequest* r) {
        if (!checkAuth(r)) return;
        if (!r->hasParam("table")) { serveFile(r, "/tune.html"); return; }
        if (!_ecu) { r->send(500, "application/json", "{\"error\":\"ECU not available\"}"); return; }
        String tableName = r->getParam("table")->value();
        FuelManager* fuel = _ecu->getFuelManager();
        TuneTable3D* table = nullptr;
        if (tableName == "spark") table = fuel->getSparkTable();
        else if (tableName == "ve") table = fuel->getVeTable();
        else if (tableName == "afr") table = fuel->getAfrTable();
        if (!table || !table->isInitialized()) {
            r->send(404, "application/json", "{\"error\":\"Table not found\"}");
            return;
        }
        JsonDocument doc;
        uint8_t cols = table->getXSize(), rows = table->getYSize();
        JsonArray rpmArr = doc["rpmAxis"].to<JsonArray>();
        for (uint8_t i = 0; i < cols; i++) rpmArr.add(table->getXAxisValue(i));
        JsonArray mapArr = doc["mapAxis"].to<JsonArray>();
        for (uint8_t i = 0; i < rows; i++) mapArr.add(table->getYAxisValue(i));
        JsonArray values = doc["values"].to<JsonArray>();
        for (uint8_t y = 0; y < rows; y++) {
            JsonArray row = values.add<JsonArray>();
            for (uint8_t x = 0; x < cols; x++)
                row.add(table->getValue(x, y));
        }
        String json;
        serializeJson(doc, json);
        r->send(200, "application/json", json);
    });
    auto* tunePostHandler = new AsyncCallbackJsonWebHandler("/tune", [this](AsyncWebServerRequest* request, JsonVariant& json) {
        if (!checkAuth(request)) return;
        if (!_ecu || !_config) { request->send(500, "application/json", "{\"error\":\"Not available\"}"); return; }
        JsonObject data = json.as<JsonObject>();
        String tableName = data["table"] | String("");
        FuelManager* fuel = _ecu->getFuelManager();
        TuneTable3D* table = nullptr;
        if (tableName == "spark") table = fuel->getSparkTable();
        else if (tableName == "ve") table = fuel->getVeTable();
        else if (tableName == "afr") table = fuel->getAfrTable();
        if (!table || !table->isInitialized()) {
            request->send(404, "application/json", "{\"error\":\"Table not found\"}");
            return;
        }
        uint8_t cols = table->getXSize(), rows = table->getYSize();
        JsonArray rpmArr = data["rpmAxis"];
        if (rpmArr) {
            float* xAxis = new float[cols];
            for (uint8_t i = 0; i < cols && i < rpmArr.size(); i++) xAxis[i] = rpmArr[i];
            table->setXAxis(xAxis);
            delete[] xAxis;
        }
        JsonArray mapArr = data["mapAxis"];
        if (mapArr) {
            float* yAxis = new float[rows];
            for (uint8_t i = 0; i < rows && i < mapArr.size(); i++) yAxis[i] = mapArr[i];
            table->setYAxis(yAxis);
            delete[] yAxis;
        }
        JsonArray values = data["values"];
        if (values) {
            for (uint8_t y = 0; y < rows && y < values.size(); y++) {
                JsonArray row = values[y];
                for (uint8_t x = 0; x < cols && x < row.size(); x++)
                    table->setValue(x, y, row[x]);
            }
        }
        // Persist to SD
        float* flatData = new float[rows * cols];
        float* xOut = new float[cols];
        float* yOut = new float[rows];
        for (uint8_t x = 0; x < cols; x++) xOut[x] = table->getXAxisValue(x);
        for (uint8_t y = 0; y < rows; y++) yOut[y] = table->getYAxisValue(y);
        for (uint8_t y = 0; y < rows; y++)
            for (uint8_t x = 0; x < cols; x++)
                flatData[y * cols + x] = table->getValue(x, y);
        bool saved = _config->saveTuneData("/tune.json", tableName.c_str(), flatData, rows, cols, xOut, yOut);
        delete[] flatData; delete[] xOut; delete[] yOut;
        if (saved) request->send(200, "application/json", "{\"status\":\"ok\"}");
        else request->send(500, "application/json", "{\"error\":\"Failed to save\"}");
    });
    _server.addHandler(tunePostHandler);
    _server.on("/log/view", HTTP_GET, [this](AsyncWebServerRequest* r) { serveFile(r, "/log.html"); });
    _server.on("/heap/view", HTTP_GET, [this](AsyncWebServerRequest* r) { serveFile(r, "/heap.html"); });

    // ECU state endpoint
    _server.on("/state", HTTP_GET, [this](AsyncWebServerRequest* request) {
        JsonDocument doc;
        if (_ecu) {
            const EngineState& s = _ecu->getState();
            doc["rpm"] = s.rpm;
            doc["map"] = s.mapKpa;
            doc["tps"] = s.tps;
            JsonArray afr = doc["afr"].to<JsonArray>();
            afr.add(s.afr[0]);
            afr.add(s.afr[1]);
            doc["clt"] = s.coolantTempF;
            doc["iat"] = s.iatTempF;
            doc["vbat"] = s.batteryVoltage;
            doc["advance"] = s.sparkAdvanceDeg;
            doc["pw"] = s.injPulseWidthUs;
            doc["state"] = _ecu->getStateString();
            doc["engineRunning"] = s.engineRunning;
            doc["cranking"] = s.cranking;
            doc["sequential"] = s.sequentialMode;
            doc["cylinders"] = s.numCylinders;
            // Per-cylinder trim
            JsonArray trim = doc["injTrim"].to<JsonArray>();
            for (uint8_t i = 0; i < s.numCylinders; i++) trim.add(s.injTrim[i]);

            // CJ125 wideband O2
            CJ125Controller* cj = _ecu->getCJ125();
            JsonObject cj125 = doc["cj125"].to<JsonObject>();
            cj125["enabled"] = (cj != nullptr);
            if (cj) {
                for (uint8_t b = 0; b < 2; b++) {
                    char key[6]; snprintf(key, sizeof(key), "bank%d", b + 1);
                    JsonObject bk = cj125[key].to<JsonObject>();
                    bk["lambda"] = cj->getLambda(b);
                    bk["afr"] = cj->getAfr(b);
                    bk["o2pct"] = cj->getOxygen(b);
                    bk["heaterState"] = cj->getHeaterStateStr(b);
                    bk["heaterDuty"] = cj->getHeaterDuty(b);
                    bk["ur"] = cj->getUrValue(b);
                    bk["ua"] = cj->getUaValue(b);
                    bk["diag"] = cj->getDiagStatus(b);
                    bk["ready"] = cj->isReady(b);
                }
            }

            // Transmission
            TransmissionManager* trans = _ecu->getTransmission();
            JsonObject transObj = doc["transmission"].to<JsonObject>();
            transObj["enabled"] = (trans != nullptr);
            if (trans) {
                const TransmissionState& ts = trans->getState();
                transObj["type"] = TransmissionManager::typeToString(trans->getType());
                transObj["gear"] = TransmissionManager::gearToString(ts.currentGear);
                transObj["targetGear"] = TransmissionManager::gearToString(ts.targetGear);
                transObj["mlps"] = TransmissionManager::mlpsToString(ts.mlpsPosition);
                transObj["ossRpm"] = ts.ossRpm;
                transObj["tssRpm"] = ts.tssRpm;
                transObj["tftTempF"] = ts.tftTempF;
                transObj["tccDuty"] = ts.tccDuty;
                transObj["epcDuty"] = ts.epcDuty;
                transObj["ssA"] = ts.ssA;
                transObj["ssB"] = ts.ssB;
                transObj["ssC"] = ts.ssC;
                transObj["ssD"] = ts.ssD;
                transObj["tccLocked"] = ts.tccLocked;
                transObj["shifting"] = ts.shifting;
                transObj["slipRpm"] = ts.slipRpm;
                transObj["overTemp"] = ts.overTemp;
            }
        }
        if (_ecu) {
            doc["limpMode"] = _ecu->isLimpActive();
            doc["limpFaults"] = _ecu->getLimpFaults();
            doc["celFaults"] = _ecu->getCelFaults();
            const EngineState& es = _ecu->getState();
            doc["oilPressurePsi"] = es.oilPressurePsi;
            doc["oilPressureLow"] = es.oilPressureLow;
            doc["oilSensorFault"] = es.oilSensorFault;
            doc["prefaultFaults"] = es.prefaultFaults;
            doc["buzzerSilenced"] = es.buzzerSilenced;
            doc["expanderFaults"] = es.expanderFaults;

            // Sensor descriptors array
            SensorManager* sm = _ecu->getSensorManager();
            if (sm) {
                JsonArray sensors = doc["sensors"].to<JsonArray>();
                for (uint8_t i = 0; i < MAX_SENSORS; i++) {
                    const SensorDescriptor* d = sm->getDescriptor(i);
                    if (!d || d->sourceType == SRC_DISABLED) continue;
                    JsonObject so = sensors.add<JsonObject>();
                    so["slot"] = i;
                    so["name"] = d->name;
                    so["value"] = d->value;
                    so["unit"] = d->unit;
                    so["raw"] = d->rawAdc;
                    so["error"] = d->inError;
                    so["warn"] = d->inWarning;
                    so["masked"] = d->masked;      // live but unvalidated
                    so["settling"] = d->settling;  // ditto, post-start grace
                    so["srcType"] = (int)d->sourceType;
                    so["activeStates"] = d->activeStates;
                }
                // Active fault rules
                JsonArray activeRules = doc["activeRules"].to<JsonArray>();
                for (uint8_t i = 0; i < MAX_RULES; i++) {
                    const FaultRule* r = sm->getRule(i);
                    if (r && r->active) activeRules.add(r->name);
                }
            }
            // Output state fields
            if (IgnitionManager* ign = _ecu->getIgnitionManager()) {
                doc["revLimiting"] = ign->isRevLimiting();
                doc["dwellMs"] = ign->getDwellMs();
                doc["overdwellCount"] = ign->getOverdwellCount();
            }
            if (InjectionManager* inj = _ecu->getInjectionManager()) {
                doc["fuelCut"] = inj->isFuelCut();
            }
            if (AlternatorControl* alt = _ecu->getAlternator()) {
                doc["altDuty"] = alt->getDuty();
                doc["altTarget"] = alt->getTargetVoltage();
                doc["altOvervoltage"] = alt->isOvervoltage();
            }
            // Fuel pump, ASE, DFCO
            doc["fuelPumpOn"] = es.fuelPumpOn;
            doc["fuelPumpPriming"] = es.fuelPumpPriming;
            doc["aseActive"] = es.aseActive;
            doc["asePct"] = es.asePct;
            doc["dfcoActive"] = es.dfcoActive;
        }
        doc["cpuLoad0"] = getCpuLoadCore0();
        doc["cpuLoad1"] = getCpuLoadCore1();
        doc["freeHeap"] = ESP.getFreeHeap();
        if (_ecu) {
            doc["updateUs"] = _ecu->getUpdateTimeUs();
            doc["sensorUs"] = _ecu->getSensorTimeUs();
        }
        doc["wifiSSID"] = WiFi.SSID();
        doc["wifiRSSI"] = WiFi.RSSI();
        doc["wifiIP"] = WiFi.localIP().toString();
        doc["apMode"] = _apModeActive;
        doc["safeMode"] = _safeMode;
        doc["bootCount"] = _bootCountExposed;
        doc["resetReason"] = _resetReasonStr;
        doc["buildDate"] = compile_date;
        struct tm ti;
        if (getLocalTime(&ti, 0)) {
            char buf[20];
            strftime(buf, sizeof(buf), "%Y-%m-%d %H:%M:%S", &ti);
            doc["datetime"] = buf;
        }
        String json;
        serializeJson(doc, json);
        request->send(200, "application/json", json);
    });

    // WiFi scan
    _server.on("/scan", HTTP_GET, [](AsyncWebServerRequest* request) {
        String json = "[";
        int n = WiFi.scanComplete();
        if (n == -2) { WiFi.scanNetworks(true); }
        else if (n) {
            for (int i = 0; i < n; ++i) {
                if (i) json += ",";
                json += "{\"rssi\":" + String(WiFi.RSSI(i)) +
                        ",\"ssid\":\"" + WiFi.SSID(i) + "\"" +
                        ",\"channel\":" + String(WiFi.channel(i)) +
                        ",\"secure\":" + String(WiFi.encryptionType(i)) + "}";
            }
            WiFi.scanDelete();
            if (WiFi.scanComplete() == -2) WiFi.scanNetworks(true);
        }
        json += "]";
        request->send(200, "application/json", json);
    });

    // Heap/system
    _server.on("/heap", HTTP_GET, [](AsyncWebServerRequest* request) {
        String json = "{\"free heap\":" + String(ESP.getFreeHeap()) +
                      ",\"free psram MB\":" + String(ESP.getFreePsram() / (1024.0f * 1024.0f)) +
                      ",\"used psram MB\":" + String((ESP.getPsramSize() - ESP.getFreePsram()) / (1024.0f * 1024.0f)) +
                      ",\"cpuLoad0\":" + String(getCpuLoadCore0()) +
                      ",\"cpuLoad1\":" + String(getCpuLoadCore1()) + "}";
        request->send(200, "application/json", json);
    });

    // Preset files from SD card
    _server.on("/presets/engines", HTTP_GET, [](AsyncWebServerRequest* r) {
        if (!ECU_SD.exists("/engines.json")) { r->send(200, "application/json", "{}"); return; }
        r->send(ECU_SD, "/engines.json", "application/json");
    });
    _server.on("/presets/transmissions", HTTP_GET, [](AsyncWebServerRequest* r) {
        if (!ECU_SD.exists("/transmissions.json")) { r->send(200, "application/json", "{}"); return; }
        r->send(ECU_SD, "/transmissions.json", "application/json");
    });

    _server.on("/presets/pins", HTTP_GET, [](AsyncWebServerRequest* r) {
        if (!ECU_SD.exists("/pins.json")) { r->send(200, "application/json", "{}"); return; }
        r->send(ECU_SD, "/pins.json", "application/json");
    });

    // Theme
    _server.on("/theme", HTTP_GET, [this](AsyncWebServerRequest* request) {
        String theme = "dark";
        if (_config && _config->getProjectInfo()) {
            theme = _config->getProjectInfo()->theme;
            if (theme.length() == 0) theme = "dark";
        }
        request->send(200, "application/json", "{\"theme\":\"" + theme + "\"}");
    });

    // Log endpoints
    _server.on("/log/level", HTTP_GET, [](AsyncWebServerRequest* r) {
        r->send(200, "application/json", "{\"level\":" + String(Log.getLevel()) +
                ",\"levelName\":\"" + String(Log.getLevelName(Log.getLevel())) + "\"}");
    });
    _server.on("/log/level", HTTP_POST, [](AsyncWebServerRequest* r) {
        if (r->hasParam("level")) {
            int level = r->getParam("level")->value().toInt();
            if (level >= 0 && level <= 3) { Log.setLevel((Logger::Level)level); r->send(200, "application/json", "{\"status\":\"ok\"}"); }
            else r->send(400, "application/json", "{\"error\":\"level must be 0-3\"}");
        } else r->send(400, "application/json", "{\"error\":\"missing level param\"}");
    });

    _server.on("/log", HTTP_GET, [](AsyncWebServerRequest* request) {
        size_t count = Log.getRingBufferCount();
        size_t limit = count;
        if (request->hasParam("limit")) {
            limit = request->getParam("limit")->value().toInt();
            if (limit > count) limit = count;
        }
        const auto& buffer = Log.getRingBuffer();
        size_t head = Log.getRingBufferHead();
        size_t bufSize = buffer.size();
        size_t startOffset = count - limit;
        String json = "{\"count\":" + String(limit) + ",\"entries\":[";
        for (size_t i = 0; i < limit; i++) {
            size_t idx = (head + bufSize - count + startOffset + i) % bufSize;
            if (i > 0) json += ",";
            json += "\"";
            const String& entry = buffer[idx];
            for (size_t j = 0; j < entry.length(); j++) {
                char c = entry[j];
                switch (c) {
                    case '"': json += "\\\""; break;
                    case '\\': json += "\\\\"; break;
                    case '\n': json += "\\n"; break;
                    default: json += c; break;
                }
            }
            json += "\"";
        }
        json += "]}";
        request->send(200, "application/json", json);
    });

    _server.on("/log/config", HTTP_GET, [](AsyncWebServerRequest* r) {
        String json = "{\"level\":" + String(Log.getLevel()) +
                      ",\"serial\":" + String(Log.isSerialEnabled() ? "true" : "false") +
                      ",\"mqtt\":" + String(Log.isMqttEnabled() ? "true" : "false") +
                      ",\"sdcard\":" + String(Log.isSdCardEnabled() ? "true" : "false") +
                      ",\"websocket\":" + String(Log.isWebSocketEnabled() ? "true" : "false") + "}";
        r->send(200, "application/json", json);
    });
    _server.on("/log/config", HTTP_POST, [](AsyncWebServerRequest* r) {
        if (r->hasParam("serial")) Log.enableSerial(r->getParam("serial")->value() == "true");
        if (r->hasParam("mqtt")) Log.enableMqtt(r->getParam("mqtt")->value() == "true");
        if (r->hasParam("sdcard")) Log.enableSdCard(r->getParam("sdcard")->value() == "true");
        if (r->hasParam("websocket")) Log.enableWebSocket(r->getParam("websocket")->value() == "true");
        r->send(200, "application/json", "{\"status\":\"ok\"}");
    });

    // Admin setup
    _server.on("/admin/setup", HTTP_GET, [this](AsyncWebServerRequest* r) { serveFile(r, "/admin.html"); });
    auto* adminPostHandler = new AsyncCallbackJsonWebHandler("/admin/setup", [this](AsyncWebServerRequest* request, JsonVariant& json) {
        if (!_config) { request->send(500, "application/json", "{\"error\":\"Config not available\"}"); return; }
        if (_config->hasAdminPassword()) { request->send(400, "application/json", "{\"error\":\"Admin password already set.\"}"); return; }
        JsonObject data = json.as<JsonObject>();
        String pw = data["password"] | String("");
        String confirm = data["confirm"] | String("");
        if (pw.length() < 4) { request->send(400, "application/json", "{\"error\":\"Password must be at least 4 characters.\"}"); return; }
        if (pw != confirm) { request->send(400, "application/json", "{\"error\":\"Passwords do not match.\"}"); return; }
        _config->setAdminPassword(pw);
        if (_ftpDisableCb) _ftpDisableCb();
        ProjectInfo* proj = _config->getProjectInfo();
        _config->updateConfig("/config.txt", *proj);
        request->send(200, "application/json", "{\"status\":\"ok\",\"message\":\"Admin password set.\"}");
    });
    _server.addHandler(adminPostHandler);

    // Config page
    _server.on("/config", HTTP_GET, [this](AsyncWebServerRequest* request) {
        bool isJson = request->hasParam("format") && request->getParam("format")->value() == "json";
        if (_config && !_config->hasAdminPassword() && !isJson) { request->redirect("/admin/setup"); return; }
        if (!checkAuth(request)) return;
        if (isJson) {
            if (!_config || !_config->getProjectInfo()) { request->send(500); return; }
            ProjectInfo* proj = _config->getProjectInfo();
            JsonDocument doc;
            doc["wifiSSID"] = _config->getWifiSSID();
            doc["wifiPassword"] = "******";
            doc["mqttHost"] = _config->getMqttHost().toString();
            doc["mqttPort"] = _config->getMqttPort();
            doc["mqttUser"] = _config->getMqttUser();
            doc["mqttPassword"] = "******";
            doc["gmtOffsetHrs"] = proj->gmtOffsetSec / 3600.0f;
            doc["daylightOffsetHrs"] = proj->daylightOffsetSec / 3600.0f;
            doc["apFallbackMinutes"] = proj->apFallbackSeconds / 60;
            doc["maxLogSize"] = proj->maxLogSize;
            doc["maxOldLogCount"] = proj->maxOldLogCount;
            doc["adminPasswordSet"] = _config->hasAdminPassword();
            doc["theme"] = proj->theme.length() > 0 ? proj->theme : "dark";
            // Engine
            doc["cylinders"] = proj->cylinders;
            JsonArray fo = doc["firingOrder"].to<JsonArray>();
            for (uint8_t i = 0; i < proj->cylinders; i++) fo.add(proj->firingOrder[i]);
            doc["crankTeeth"] = proj->crankTeeth;
            doc["crankMissing"] = proj->crankMissing;
            doc["hasCamSensor"] = proj->hasCamSensor;
            doc["displacement"] = proj->displacement;
            doc["injectorFlowCcMin"] = proj->injectorFlowCcMin;
            doc["injectorDeadTimeMs"] = proj->injectorDeadTimeMs;
            doc["revLimitRpm"] = proj->revLimitRpm;
            doc["maxDwellMs"] = proj->maxDwellMs;
            doc["altTargetVoltage"] = proj->altTargetVoltage;
            doc["altPidP"] = proj->altPidP;
            doc["altPidI"] = proj->altPidI;
            doc["altPidD"] = proj->altPidD;
            doc["mapVoltageMin"] = proj->mapVoltageMin;
            doc["mapVoltageMax"] = proj->mapVoltageMax;
            doc["mapPressureMinKpa"] = proj->mapPressureMinKpa;
            doc["mapPressureMaxKpa"] = proj->mapPressureMaxKpa;
            doc["o2AfrAt0v"] = proj->o2AfrAt0v;
            doc["o2AfrAt5v"] = proj->o2AfrAt5v;
            doc["closedLoopMinRpm"] = proj->closedLoopMinRpm;
            doc["closedLoopMaxRpm"] = proj->closedLoopMaxRpm;
            doc["closedLoopMaxMapKpa"] = proj->closedLoopMaxMapKpa;
            doc["cj125Enabled"] = proj->cj125Enabled;
            // Fuel pump / ASE / DFCO
            doc["fuelPumpPrimeMs"] = proj->fuelPumpPrimeMs;
            doc["aseInitialPct"] = proj->aseInitialPct;
            doc["aseDurationMs"] = proj->aseDurationMs;
            doc["aseMinCltF"] = proj->aseMinCltF;
            doc["dfcoRpmThreshold"] = proj->dfcoRpmThreshold;
            doc["dfcoTpsThreshold"] = proj->dfcoTpsThreshold;
            doc["dfcoEntryDelayMs"] = proj->dfcoEntryDelayMs;
            doc["dfcoExitRpm"] = proj->dfcoExitRpm;
            doc["dfcoExitTps"] = proj->dfcoExitTps;
            // CLT rev limit
            {
                JsonArray cltAxis = doc["cltRevLimitAxis"].to<JsonArray>();
                JsonArray cltVals = doc["cltRevLimitValues"].to<JsonArray>();
                for (uint8_t i = 0; i < 6; i++) {
                    cltAxis.add(proj->cltRevLimitAxis[i]);
                    cltVals.add(proj->cltRevLimitValues[i]);
                }
            }
            // Transmission
            doc["transType"] = proj->transType;
            doc["upshift12Rpm"] = proj->upshift12Rpm;
            doc["upshift23Rpm"] = proj->upshift23Rpm;
            doc["upshift34Rpm"] = proj->upshift34Rpm;
            doc["downshift21Rpm"] = proj->downshift21Rpm;
            doc["downshift32Rpm"] = proj->downshift32Rpm;
            doc["downshift43Rpm"] = proj->downshift43Rpm;
            doc["tccLockRpm"] = proj->tccLockRpm;
            doc["tccLockGear"] = proj->tccLockGear;
            doc["tccApplyRate"] = proj->tccApplyRate;
            doc["epcBaseDuty"] = proj->epcBaseDuty;
            doc["epcShiftBoost"] = proj->epcShiftBoost;
            doc["shiftTimeMs"] = proj->shiftTimeMs;
            doc["maxTftTempF"] = proj->maxTftTempF;

            // Pin assignments
            doc["pinO2Bank1"] = proj->pinO2Bank1;
            doc["pinO2Bank2"] = proj->pinO2Bank2;
            doc["pinMap"] = proj->pinMap;
            doc["pinTps"] = proj->pinTps;
            doc["pinClt"] = proj->pinClt;
            doc["pinIat"] = proj->pinIat;
            doc["pinVbat"] = proj->pinVbat;
            doc["pinAlternator"] = proj->pinAlternator;
            doc["pinHeater1"] = proj->pinHeater1;
            doc["pinHeater2"] = proj->pinHeater2;
            doc["pinTcc"] = proj->pinTcc;
            doc["pinEpc"] = proj->pinEpc;
            doc["pinHspiSck"] = proj->pinHspiSck;
            doc["pinHspiMosi"] = proj->pinHspiMosi;
            doc["pinHspiMiso"] = proj->pinHspiMiso;
            doc["pinHspiCs"] = proj->pinHspiCs;
            doc["pinMcp3204Cs"] = proj->pinMcp3204Cs;
            doc["pinI2cSda"] = proj->pinI2cSda;
            doc["pinI2cScl"] = proj->pinI2cScl;
            doc["pinFuelPump"] = proj->pinFuelPump;
            doc["pinTachOut"] = proj->pinTachOut;
            doc["pinCel"] = proj->pinCel;
            doc["pinCj125Ss1"] = proj->pinCj125Ss1;
            doc["pinCj125Ss2"] = proj->pinCj125Ss2;
            doc["pinSsA"] = proj->pinSsA;
            doc["pinSsB"] = proj->pinSsB;
            doc["pinSsC"] = proj->pinSsC;
            doc["pinSsD"] = proj->pinSsD;
            doc["pinSdClk"] = proj->pinSdClk;
            doc["pinSdMiso"] = proj->pinSdMiso;
            doc["pinSdMosi"] = proj->pinSdMosi;
            doc["pinSdCs"] = proj->pinSdCs;
            doc["pinSharedInt"] = proj->pinSharedInt;
            {
                JsonArray ca = doc["coilPins"].to<JsonArray>();
                JsonArray ia = doc["injectorPins"].to<JsonArray>();
                for (int i = 0; i < 12; i++) ca.add(proj->coilPins[i]);
                for (int i = 0; i < 12; i++) ia.add(proj->injectorPins[i]);
            }

            // Peripherals & safe mode
            doc["forceSafeMode"] = proj->forceSafeMode;
            doc["i2cEnabled"] = proj->i2cEnabled;
            doc["spiExpandersEnabled"] = proj->spiExpandersEnabled;
            doc["expander0Enabled"] = proj->expander0Enabled;
            doc["expander1Enabled"] = proj->expander1Enabled;
            doc["expander2Enabled"] = proj->expander2Enabled;
            doc["expander3Enabled"] = proj->expander3Enabled;
            doc["expander4Enabled"] = proj->expander4Enabled;
            doc["expander5Enabled"] = proj->expander5Enabled;
            doc["safeMode"] = _safeMode;
            doc["bootCount"] = _bootCountExposed;
            doc["resetReason"] = _resetReasonStr;

            // Limp mode
            doc["limpRevLimit"] = proj->limpRevLimit;
            doc["limpAdvanceCap"] = proj->limpAdvanceCap;
            doc["limpRecoverySec"] = proj->limpRecoveryMs / 1000;
            doc["limpMapMin"] = proj->limpMapMin;
            doc["limpMapMax"] = proj->limpMapMax;
            doc["limpTpsMin"] = proj->limpTpsMin;
            doc["limpTpsMax"] = proj->limpTpsMax;
            doc["limpCltMax"] = proj->limpCltMax;
            doc["limpIatMax"] = proj->limpIatMax;
            doc["limpVbatMin"] = proj->limpVbatMin;

            // Oil pressure
            doc["oilPressureMode"] = proj->oilPressureMode;
            doc["pinOilPressure"] = proj->pinOilPressure;
            doc["oilPressureActiveLow"] = proj->oilPressureActiveLow;
            doc["oilPressureMinPsi"] = proj->oilPressureMinPsi;
            doc["oilPressureMaxPsi"] = proj->oilPressureMaxPsi;
            doc["oilPressureMcpChannel"] = proj->oilPressureMcpChannel;
            doc["oilPressureStartupSec"] = proj->oilPressureStartupMs / 1000;

            // Sensor descriptors and fault rules
            if (_ecu) {
                SensorManager* sm = _ecu->getSensorManager();
                if (sm) {
                    JsonArray sensors = doc["sensors"].to<JsonArray>();
                    for (uint8_t i = 0; i < MAX_SENSORS; i++) {
                        const SensorDescriptor* d = sm->getDescriptor(i);
                        if (!d) continue;
                        JsonObject s = sensors.add<JsonObject>();
                        s["name"] = d->name;
                        s["unit"] = d->unit;
                        JsonObject src = s["source"].to<JsonObject>();
                        src["type"] = (int)d->sourceType;
                        src["device"] = d->sourceDevice;
                        src["channel"] = d->sourceChannel;
                        src["pin"] = d->sourcePin;
                        JsonObject cal = s["cal"].to<JsonObject>();
                        cal["type"] = (int)d->calType;
                        cal["a"] = d->calA; cal["b"] = d->calB;
                        cal["c"] = d->calC; cal["d"] = d->calD;
                        JsonObject filt = s["filter"].to<JsonObject>();
                        filt["ema"] = d->emaAlpha;
                        filt["avg"] = d->avgSamples;
                        JsonObject val = s["validate"].to<JsonObject>();
                        if (!isnan(d->errorMin)) val["errorMin"] = d->errorMin;
                        if (!isnan(d->errorMax)) val["errorMax"] = d->errorMax;
                        if (!isnan(d->warnMin)) val["warnMin"] = d->warnMin;
                        if (!isnan(d->warnMax)) val["warnMax"] = d->warnMax;
                        val["settle"] = d->settleGuard;
                        val["settleMs"] = d->settleMs;
                        JsonObject fault = s["fault"].to<JsonObject>();
                        fault["bit"] = d->faultBit;
                        fault["action"] = (int)d->faultAction;
                        s["activeStates"] = d->activeStates;
                    }
                    JsonArray rules = doc["rules"].to<JsonArray>();
                    for (uint8_t i = 0; i < MAX_RULES; i++) {
                        const FaultRule* r = sm->getRule(i);
                        if (!r || (r->sensorSlot >= MAX_SENSORS && r->faultBit == 0xFF)) continue;
                        JsonObject ro = rules.add<JsonObject>();
                        ro["name"] = r->name;
                        ro["sensor"] = r->sensorSlot;
                        ro["sensorB"] = r->sensorSlotB;
                        ro["op"] = (int)r->op;
                        ro["a"] = r->thresholdA;
                        ro["b"] = r->thresholdB;
                        ro["bit"] = r->faultBit;
                        ro["action"] = (int)r->faultAction;
                        ro["debounce"] = r->debounceMs;
                        ro["running"] = r->requireRunning;
                    }
                }
            }

            String json;
            serializeJson(doc, json);
            request->send(200, "application/json", json);
            return;
        }
        serveFile(request, "/config.html");
    });

    // POST /sensors — dedicated sensor/rule config endpoint
    auto* sensorsPostHandler = new AsyncCallbackJsonWebHandler("/sensors", [this](AsyncWebServerRequest* request, JsonVariant& json) {
        if (!checkAuth(request)) return;
        if (!_ecu || !_ecu->getSensorManager() || !_config) {
            request->send(500, "application/json", "{\"error\":\"ECU not available\"}");
            return;
        }
        SensorManager* sm = _ecu->getSensorManager();
        JsonObject data = json.as<JsonObject>();
        bool changed = false;

        // Update sensor descriptors
        if (data["sensors"].is<JsonArray>()) {
            JsonArray sensors = data["sensors"];
            for (uint8_t i = 0; i < MAX_SENSORS && i < sensors.size(); i++) {
                JsonObject s = sensors[i];
                SensorDescriptor* d = sm->getDescriptor(i);
                if (!d) continue;
                const char* name = s["name"];
                if (name) strncpy(d->name, name, sizeof(d->name) - 1);
                const char* unit = s["unit"];
                if (unit) strncpy(d->unit, unit, sizeof(d->unit) - 1);
                if (s["source"].is<JsonObject>()) {
                    d->sourceType = (SourceType)(int)(s["source"]["type"] | (int)d->sourceType);
                    d->sourceDevice = s["source"]["device"] | d->sourceDevice;
                    d->sourceChannel = s["source"]["channel"] | d->sourceChannel;
                    d->sourcePin = s["source"]["pin"] | d->sourcePin;
                }
                if (s["cal"].is<JsonObject>()) {
                    d->calType = (CalType)(int)(s["cal"]["type"] | (int)d->calType);
                    d->calA = s["cal"]["a"] | d->calA;
                    d->calB = s["cal"]["b"] | d->calB;
                    d->calC = s["cal"]["c"] | d->calC;
                    d->calD = s["cal"]["d"] | d->calD;
                }
                if (s["filter"].is<JsonObject>()) {
                    d->emaAlpha = s["filter"]["ema"] | d->emaAlpha;
                    d->avgSamples = s["filter"]["avg"] | d->avgSamples;
                    if (d->avgSamples > MAX_AVG_SAMPLES) d->avgSamples = MAX_AVG_SAMPLES;
                }
                if (s["validate"].is<JsonObject>()) {
                    d->errorMin = s["validate"]["errorMin"].is<float>() ? (float)s["validate"]["errorMin"] : NAN;
                    d->errorMax = s["validate"]["errorMax"].is<float>() ? (float)s["validate"]["errorMax"] : NAN;
                    d->warnMin = s["validate"]["warnMin"].is<float>() ? (float)s["validate"]["warnMin"] : NAN;
                    d->warnMax = s["validate"]["warnMax"].is<float>() ? (float)s["validate"]["warnMax"] : NAN;
                    d->settleGuard = s["validate"]["settle"] | d->settleGuard;
                    d->settleMs = s["validate"]["settleMs"] | d->settleMs;
                }
                if (s["fault"].is<JsonObject>()) {
                    d->faultBit = s["fault"]["bit"] | d->faultBit;
                    d->faultAction = (FaultAction)(int)(s["fault"]["action"] | (int)d->faultAction);
                }
                d->activeStates = s["activeStates"] | d->activeStates;
                changed = true;
            }
        }

        // Update fault rules
        if (data["rules"].is<JsonArray>()) {
            JsonArray rulesArr = data["rules"];
            for (uint8_t i = 0; i < MAX_RULES && i < rulesArr.size(); i++) {
                JsonObject ro = rulesArr[i];
                FaultRule* r = sm->getRule(i);
                if (!r) continue;
                const char* rname = ro["name"];
                if (rname) strncpy(r->name, rname, sizeof(r->name) - 1);
                r->sensorSlot = ro["sensor"] | r->sensorSlot;
                r->sensorSlotB = ro["sensorB"] | r->sensorSlotB;
                r->op = (RuleOp)(int)(ro["op"] | (int)r->op);
                r->thresholdA = ro["a"] | r->thresholdA;
                r->thresholdB = ro["b"] | r->thresholdB;
                r->faultBit = ro["bit"] | r->faultBit;
                r->faultAction = (FaultAction)(int)(ro["action"] | (int)r->faultAction);
                r->debounceMs = ro["debounce"] | r->debounceMs;
                r->requireRunning = ro["running"] | r->requireRunning;
                r->debounceStart = 0;
                r->active = false;
                changed = true;
            }
        }

        // Reset defaults
        if (data["resetSensors"] | false) {
            sm->initDefaultDescriptors();
            changed = true;
        }
        if (data["resetRules"] | false) {
            sm->initDefaultRules();
            changed = true;
        }

        if (changed) {
            _config->saveSensorConfig("/config.txt", sm->getDescriptor(0), MAX_SENSORS,
                                       sm->getRule(0), MAX_RULES);
        }
        request->send(200, "application/json", "{\"ok\":true}");
    });
    sensorsPostHandler->setMaxContentLength(8192);
    _server.addHandler(sensorsPostHandler);

    auto* configPostHandler = new AsyncCallbackJsonWebHandler("/config", [this](AsyncWebServerRequest* request, JsonVariant& json) {
        if (!checkAuth(request)) return;
        if (!_config || !_config->getProjectInfo()) { request->send(500); return; }
        ProjectInfo* proj = _config->getProjectInfo();
        JsonObject data = json.as<JsonObject>();
        bool needsReboot = false;
        String errors = "";

        String newSSID = data["wifiSSID"] | _config->getWifiSSID();
        if (newSSID != _config->getWifiSSID()) { _config->setWifiSSID(newSSID); needsReboot = true; }

        String wifiPw = data["wifiPassword"] | String("******");
        if (wifiPw != "******" && wifiPw.length() > 0) {
            String curPw = data["curWifiPw"] | String("");
            if (curPw == _config->getWifiPassword() || _config->verifyAdminPassword(curPw))
                { _config->setWifiPassword(wifiPw); needsReboot = true; }
            else errors += "WiFi password: current password incorrect. ";
        }

        String mqttHost = data["mqttHost"] | _config->getMqttHost().toString();
        IPAddress newMqttHost; newMqttHost.fromString(mqttHost);
        if (newMqttHost != _config->getMqttHost()) { _config->setMqttHost(newMqttHost); needsReboot = true; }
        uint16_t mqttPort = data["mqttPort"] | _config->getMqttPort();
        if (mqttPort != _config->getMqttPort()) { _config->setMqttPort(mqttPort); needsReboot = true; }

        String adminPw = data["adminPassword"] | String("");
        if (adminPw.length() > 0) {
            if (!_config->hasAdminPassword()) {
                _config->setAdminPassword(adminPw);
                if (_ftpDisableCb) _ftpDisableCb();
            } else {
                String curAdminPw = data["curAdminPw"] | String("");
                if (_config->verifyAdminPassword(curAdminPw)) _config->setAdminPassword(adminPw);
                else errors += "Admin password: current password incorrect. ";
            }
        }

        float gmtHrs = data["gmtOffsetHrs"] | (proj->gmtOffsetSec / 3600.0f);
        float dstHrs = data["daylightOffsetHrs"] | (proj->daylightOffsetSec / 3600.0f);
        proj->gmtOffsetSec = (int32_t)(gmtHrs * 3600);
        proj->daylightOffsetSec = (int32_t)(dstHrs * 3600);

        proj->apFallbackSeconds = (data["apFallbackMinutes"] | (proj->apFallbackSeconds / 60)) * 60;
        proj->maxLogSize = data["maxLogSize"] | proj->maxLogSize;
        proj->maxOldLogCount = data["maxOldLogCount"] | proj->maxOldLogCount;

        String theme = data["theme"] | proj->theme;
        if (theme == "dark" || theme == "light") proj->theme = theme;

        // Engine config
        proj->cylinders = data["cylinders"] | proj->cylinders;
        proj->crankTeeth = data["crankTeeth"] | proj->crankTeeth;
        proj->crankMissing = data["crankMissing"] | proj->crankMissing;
        proj->hasCamSensor = data["hasCamSensor"] | proj->hasCamSensor;
        proj->displacement = data["displacement"] | proj->displacement;
        proj->injectorFlowCcMin = data["injectorFlowCcMin"] | proj->injectorFlowCcMin;
        proj->injectorDeadTimeMs = data["injectorDeadTimeMs"] | proj->injectorDeadTimeMs;
        proj->revLimitRpm = data["revLimitRpm"] | proj->revLimitRpm;
        proj->maxDwellMs = data["maxDwellMs"] | proj->maxDwellMs;
        proj->altTargetVoltage = data["altTargetVoltage"] | proj->altTargetVoltage;
        proj->altPidP = data["altPidP"] | proj->altPidP;
        proj->altPidI = data["altPidI"] | proj->altPidI;
        proj->altPidD = data["altPidD"] | proj->altPidD;
        proj->mapVoltageMin = data["mapVoltageMin"] | proj->mapVoltageMin;
        proj->mapVoltageMax = data["mapVoltageMax"] | proj->mapVoltageMax;
        proj->mapPressureMinKpa = data["mapPressureMinKpa"] | proj->mapPressureMinKpa;
        proj->mapPressureMaxKpa = data["mapPressureMaxKpa"] | proj->mapPressureMaxKpa;
        proj->o2AfrAt0v = data["o2AfrAt0v"] | proj->o2AfrAt0v;
        proj->o2AfrAt5v = data["o2AfrAt5v"] | proj->o2AfrAt5v;
        proj->closedLoopMinRpm = data["closedLoopMinRpm"] | proj->closedLoopMinRpm;
        proj->closedLoopMaxRpm = data["closedLoopMaxRpm"] | proj->closedLoopMaxRpm;
        proj->closedLoopMaxMapKpa = data["closedLoopMaxMapKpa"] | proj->closedLoopMaxMapKpa;
        if (data["cj125Enabled"].is<bool>()) proj->cj125Enabled = data["cj125Enabled"].as<bool>();

        // Fuel pump / ASE / DFCO
        proj->fuelPumpPrimeMs = data["fuelPumpPrimeMs"] | proj->fuelPumpPrimeMs;
        proj->aseInitialPct = data["aseInitialPct"] | proj->aseInitialPct;
        proj->aseDurationMs = data["aseDurationMs"] | proj->aseDurationMs;
        proj->aseMinCltF = data["aseMinCltF"] | proj->aseMinCltF;
        proj->dfcoRpmThreshold = data["dfcoRpmThreshold"] | proj->dfcoRpmThreshold;
        proj->dfcoTpsThreshold = data["dfcoTpsThreshold"] | proj->dfcoTpsThreshold;
        proj->dfcoEntryDelayMs = data["dfcoEntryDelayMs"] | proj->dfcoEntryDelayMs;
        proj->dfcoExitRpm = data["dfcoExitRpm"] | proj->dfcoExitRpm;
        proj->dfcoExitTps = data["dfcoExitTps"] | proj->dfcoExitTps;

        // CLT rev limit
        {
            JsonArray cltAxis = data["cltRevLimitAxis"];
            JsonArray cltVals = data["cltRevLimitValues"];
            if (cltAxis && cltVals) {
                for (uint8_t i = 0; i < 6 && i < cltAxis.size(); i++)
                    proj->cltRevLimitAxis[i] = cltAxis[i];
                for (uint8_t i = 0; i < 6 && i < cltVals.size(); i++)
                    proj->cltRevLimitValues[i] = cltVals[i];
            }
        }

        // Transmission config
        {
            uint8_t newTransType = data["transType"] | proj->transType;
            if (newTransType != proj->transType) { proj->transType = newTransType; needsReboot = true; }
        }
        proj->upshift12Rpm = data["upshift12Rpm"] | proj->upshift12Rpm;
        proj->upshift23Rpm = data["upshift23Rpm"] | proj->upshift23Rpm;
        proj->upshift34Rpm = data["upshift34Rpm"] | proj->upshift34Rpm;
        proj->downshift21Rpm = data["downshift21Rpm"] | proj->downshift21Rpm;
        proj->downshift32Rpm = data["downshift32Rpm"] | proj->downshift32Rpm;
        proj->downshift43Rpm = data["downshift43Rpm"] | proj->downshift43Rpm;
        proj->tccLockRpm = data["tccLockRpm"] | proj->tccLockRpm;
        proj->tccLockGear = data["tccLockGear"] | proj->tccLockGear;
        proj->tccApplyRate = data["tccApplyRate"] | proj->tccApplyRate;
        proj->epcBaseDuty = data["epcBaseDuty"] | proj->epcBaseDuty;
        proj->epcShiftBoost = data["epcShiftBoost"] | proj->epcShiftBoost;
        proj->shiftTimeMs = data["shiftTimeMs"] | proj->shiftTimeMs;
        proj->maxTftTempF = data["maxTftTempF"] | proj->maxTftTempF;

        // Peripheral enable flags (all require reboot)
        {
            bool flags[] = {
                data["i2cEnabled"] | proj->i2cEnabled,
                data["spiExpandersEnabled"] | proj->spiExpandersEnabled,
                data["expander0Enabled"] | proj->expander0Enabled,
                data["expander1Enabled"] | proj->expander1Enabled,
                data["expander2Enabled"] | proj->expander2Enabled,
                data["expander3Enabled"] | proj->expander3Enabled,
                data["expander4Enabled"] | proj->expander4Enabled,
                data["expander5Enabled"] | proj->expander5Enabled,
            };
            bool* cur[] = {
                &proj->i2cEnabled, &proj->spiExpandersEnabled,
                &proj->expander0Enabled, &proj->expander1Enabled,
                &proj->expander2Enabled, &proj->expander3Enabled,
                &proj->expander4Enabled, &proj->expander5Enabled,
            };
            for (int i = 0; i < 8; i++) {
                if (flags[i] != *cur[i]) { *cur[i] = flags[i]; needsReboot = true; }
            }
        }
        if (data["forceSafeMode"].is<bool>()) {
            proj->forceSafeMode = data["forceSafeMode"].as<bool>();
            if (proj->forceSafeMode) needsReboot = true;
        }

        // Pin assignments (all require reboot)
        {
            // GPIO-only pins (uint8_t, max 48)
            uint8_t gpioPins[] = {
                data["pinO2Bank1"] | proj->pinO2Bank1,
                data["pinO2Bank2"] | proj->pinO2Bank2,
                data["pinMap"] | proj->pinMap,
                data["pinTps"] | proj->pinTps,
                data["pinClt"] | proj->pinClt,
                data["pinIat"] | proj->pinIat,
                data["pinVbat"] | proj->pinVbat,
                data["pinAlternator"] | proj->pinAlternator,
                data["pinHeater1"] | proj->pinHeater1,
                data["pinHeater2"] | proj->pinHeater2,
                data["pinTcc"] | proj->pinTcc,
                data["pinEpc"] | proj->pinEpc,
                data["pinHspiSck"] | proj->pinHspiSck,
                data["pinHspiMosi"] | proj->pinHspiMosi,
                data["pinHspiMiso"] | proj->pinHspiMiso,
                data["pinHspiCs"] | proj->pinHspiCs,
                data["pinMcp3204Cs"] | proj->pinMcp3204Cs,
                data["pinI2cSda"] | proj->pinI2cSda,
                data["pinI2cScl"] | proj->pinI2cScl,
                data["pinSdClk"] | proj->pinSdClk,
                data["pinSdMiso"] | proj->pinSdMiso,
                data["pinSdMosi"] | proj->pinSdMosi,
                data["pinSdCs"] | proj->pinSdCs,
                (uint8_t)(data["pinSharedInt"] | proj->pinSharedInt)
            };
            uint8_t* gpioCur[] = {
                &proj->pinO2Bank1, &proj->pinO2Bank2, &proj->pinMap, &proj->pinTps,
                &proj->pinClt, &proj->pinIat, &proj->pinVbat, &proj->pinAlternator,
                &proj->pinHeater1, &proj->pinHeater2, &proj->pinTcc, &proj->pinEpc,
                &proj->pinHspiSck, &proj->pinHspiMosi, &proj->pinHspiMiso,
                &proj->pinHspiCs, &proj->pinMcp3204Cs,
                &proj->pinI2cSda, &proj->pinI2cScl,
                &proj->pinSdClk, &proj->pinSdMiso, &proj->pinSdMosi, &proj->pinSdCs,
                &proj->pinSharedInt
            };
            for (int i = 0; i < 24; i++) {
                if (gpioPins[i] != *gpioCur[i]) { *gpioCur[i] = gpioPins[i]; needsReboot = true; }
            }
            // Expander-capable pins (uint16_t, values 200-295)
            uint16_t expPins[] = {
                (uint16_t)(data["pinFuelPump"] | (int)proj->pinFuelPump),
                (uint16_t)(data["pinTachOut"] | (int)proj->pinTachOut),
                (uint16_t)(data["pinCel"] | (int)proj->pinCel),
                (uint16_t)(data["pinCj125Ss1"] | (int)proj->pinCj125Ss1),
                (uint16_t)(data["pinCj125Ss2"] | (int)proj->pinCj125Ss2),
                (uint16_t)(data["pinSsA"] | (int)proj->pinSsA),
                (uint16_t)(data["pinSsB"] | (int)proj->pinSsB),
                (uint16_t)(data["pinSsC"] | (int)proj->pinSsC),
                (uint16_t)(data["pinSsD"] | (int)proj->pinSsD),
            };
            uint16_t* expCur[] = {
                &proj->pinFuelPump, &proj->pinTachOut, &proj->pinCel,
                &proj->pinCj125Ss1, &proj->pinCj125Ss2,
                &proj->pinSsA, &proj->pinSsB, &proj->pinSsC, &proj->pinSsD,
            };
            for (int i = 0; i < 9; i++) {
                if (expPins[i] != *expCur[i]) { *expCur[i] = expPins[i]; needsReboot = true; }
            }
            // Coil/injector arrays (uint16_t)
            if (data["coilPins"].is<JsonArray>()) {
                JsonArray ca = data["coilPins"];
                for (int i = 0; i < min((int)ca.size(), 12); i++) {
                    uint16_t v = (uint16_t)(int)ca[i];
                    if (v != proj->coilPins[i]) { proj->coilPins[i] = v; needsReboot = true; }
                }
            }
            if (data["injectorPins"].is<JsonArray>()) {
                JsonArray ia = data["injectorPins"];
                for (int i = 0; i < min((int)ia.size(), 12); i++) {
                    uint16_t v = (uint16_t)(int)ia[i];
                    if (v != proj->injectorPins[i]) { proj->injectorPins[i] = v; needsReboot = true; }
                }
            }
            // Write SD pin changes to NVS for bootstrap
            if (data["pinSdClk"].is<uint8_t>() || data["pinSdMiso"].is<uint8_t>() ||
                data["pinSdMosi"].is<uint8_t>() || data["pinSdCs"].is<uint8_t>()) {
                Preferences prefs;
                prefs.begin("sdpins", false);
                prefs.putUChar("clk",  proj->pinSdClk);
                prefs.putUChar("miso", proj->pinSdMiso);
                prefs.putUChar("mosi", proj->pinSdMosi);
                prefs.putUChar("cs",   proj->pinSdCs);
                prefs.end();
            }
        }

        // Limp mode (live — no reboot needed)
        proj->limpRevLimit = data["limpRevLimit"] | proj->limpRevLimit;
        proj->limpAdvanceCap = data["limpAdvanceCap"] | proj->limpAdvanceCap;
        {
            uint32_t recSec = data["limpRecoverySec"] | (proj->limpRecoveryMs / 1000);
            proj->limpRecoveryMs = recSec * 1000;
        }
        proj->limpMapMin = data["limpMapMin"] | proj->limpMapMin;
        proj->limpMapMax = data["limpMapMax"] | proj->limpMapMax;
        proj->limpTpsMin = data["limpTpsMin"] | proj->limpTpsMin;
        proj->limpTpsMax = data["limpTpsMax"] | proj->limpTpsMax;
        proj->limpCltMax = data["limpCltMax"] | proj->limpCltMax;
        proj->limpIatMax = data["limpIatMax"] | proj->limpIatMax;
        proj->limpVbatMin = data["limpVbatMin"] | proj->limpVbatMin;

        // Oil pressure (mode/pin require reboot, minPsi is live)
        proj->oilPressureMode = data["oilPressureMode"] | proj->oilPressureMode;
        proj->pinOilPressure = data["pinOilPressure"] | proj->pinOilPressure;
        proj->oilPressureActiveLow = data["oilPressureActiveLow"] | proj->oilPressureActiveLow;
        proj->oilPressureMinPsi = data["oilPressureMinPsi"] | proj->oilPressureMinPsi;
        proj->oilPressureMaxPsi = data["oilPressureMaxPsi"] | proj->oilPressureMaxPsi;
        proj->oilPressureMcpChannel = data["oilPressureMcpChannel"] | proj->oilPressureMcpChannel;
        {
            uint32_t startSec = data["oilPressureStartupSec"] | (proj->oilPressureStartupMs / 1000);
            proj->oilPressureStartupMs = startSec * 1000;
        }

        // Apply live to sensor manager
        if (_ecu && _ecu->getSensorManager()) {
            _ecu->getSensorManager()->setLimpThresholds(
                proj->limpMapMin, proj->limpMapMax, proj->limpTpsMin, proj->limpTpsMax,
                proj->limpCltMax, proj->limpIatMax, proj->limpVbatMin);
        }

        // Update sensor descriptors (live — applies immediately)
        if (_ecu && _ecu->getSensorManager() && data["sensors"].is<JsonArray>()) {
            SensorManager* sm = _ecu->getSensorManager();
            JsonArray sensors = data["sensors"];
            for (uint8_t i = 0; i < MAX_SENSORS && i < sensors.size(); i++) {
                JsonObject s = sensors[i];
                SensorDescriptor* d = sm->getDescriptor(i);
                if (!d) continue;
                const char* name = s["name"];
                if (name) strncpy(d->name, name, sizeof(d->name) - 1);
                const char* unit = s["unit"];
                if (unit) strncpy(d->unit, unit, sizeof(d->unit) - 1);
                if (s["source"].is<JsonObject>()) {
                    d->sourceType = (SourceType)(int)(s["source"]["type"] | (int)d->sourceType);
                    d->sourceDevice = s["source"]["device"] | d->sourceDevice;
                    d->sourceChannel = s["source"]["channel"] | d->sourceChannel;
                    d->sourcePin = s["source"]["pin"] | d->sourcePin;
                }
                if (s["cal"].is<JsonObject>()) {
                    d->calType = (CalType)(int)(s["cal"]["type"] | (int)d->calType);
                    d->calA = s["cal"]["a"] | d->calA;
                    d->calB = s["cal"]["b"] | d->calB;
                    d->calC = s["cal"]["c"] | d->calC;
                    d->calD = s["cal"]["d"] | d->calD;
                }
                if (s["filter"].is<JsonObject>()) {
                    d->emaAlpha = s["filter"]["ema"] | d->emaAlpha;
                    d->avgSamples = s["filter"]["avg"] | d->avgSamples;
                    if (d->avgSamples > MAX_AVG_SAMPLES) d->avgSamples = MAX_AVG_SAMPLES;
                }
                if (s["validate"].is<JsonObject>()) {
                    d->errorMin = s["validate"]["errorMin"].is<float>() ? (float)s["validate"]["errorMin"] : NAN;
                    d->errorMax = s["validate"]["errorMax"].is<float>() ? (float)s["validate"]["errorMax"] : NAN;
                    d->warnMin = s["validate"]["warnMin"].is<float>() ? (float)s["validate"]["warnMin"] : NAN;
                    d->warnMax = s["validate"]["warnMax"].is<float>() ? (float)s["validate"]["warnMax"] : NAN;
                    d->settleGuard = s["validate"]["settle"] | d->settleGuard;
                }
                if (s["fault"].is<JsonObject>()) {
                    d->faultBit = s["fault"]["bit"] | d->faultBit;
                    d->faultAction = (FaultAction)(int)(s["fault"]["action"] | (int)d->faultAction);
                }
                d->activeStates = s["activeStates"] | d->activeStates;
            }
            // Save sensor config to SD
            _config->saveSensorConfig("/config.txt", sm->getDescriptor(0), MAX_SENSORS,
                                       sm->getRule(0), MAX_RULES);
        }

        // Update fault rules (live)
        if (_ecu && _ecu->getSensorManager() && data["rules"].is<JsonArray>()) {
            SensorManager* sm = _ecu->getSensorManager();
            JsonArray rulesArr = data["rules"];
            for (uint8_t i = 0; i < MAX_RULES && i < rulesArr.size(); i++) {
                JsonObject ro = rulesArr[i];
                FaultRule* r = sm->getRule(i);
                if (!r) continue;
                const char* rname = ro["name"];
                if (rname) strncpy(r->name, rname, sizeof(r->name) - 1);
                r->sensorSlot = ro["sensor"] | r->sensorSlot;
                r->sensorSlotB = ro["sensorB"] | r->sensorSlotB;
                r->op = (RuleOp)(int)(ro["op"] | (int)r->op);
                r->thresholdA = ro["a"] | r->thresholdA;
                r->thresholdB = ro["b"] | r->thresholdB;
                r->faultBit = ro["bit"] | r->faultBit;
                r->faultAction = (FaultAction)(int)(ro["action"] | (int)r->faultAction);
                r->debounceMs = ro["debounce"] | r->debounceMs;
                r->requireRunning = ro["running"] | r->requireRunning;
                // Reset runtime state
                r->debounceStart = 0;
                r->active = false;
            }
            _config->saveSensorConfig("/config.txt", sm->getDescriptor(0), MAX_SENSORS,
                                       sm->getRule(0), MAX_RULES);
        }

        bool saved = _config->updateConfig("/config.txt", *proj);

        JsonDocument respDoc;
        if (!saved) respDoc["error"] = "Failed to save config";
        else if (errors.length() > 0) respDoc["error"] = errors;
        else if (needsReboot) { respDoc["message"] = "Settings saved. Rebooting in 2s..."; respDoc["reboot"] = true; }
        else respDoc["message"] = "Settings saved and applied.";
        String response;
        serializeJson(respDoc, response);
        request->send(200, "application/json", response);

        if (needsReboot && saved && errors.length() == 0) {
            if (!_tDelayedReboot)
                _tDelayedReboot = new Task(2 * TASK_SECOND, TASK_ONCE, [this]() { _shouldReboot = true; }, _ts, false);
            _tDelayedReboot->restartDelayed(2 * TASK_SECOND);
        }
    });
    _server.addHandler(configPostHandler);

    // OTA Update
    _server.on("/update", HTTP_GET, [this](AsyncWebServerRequest* r) {
        if (!checkAuth(r)) return;
        serveFile(r, "/update.html");
    });
    _server.on("/update", HTTP_POST, [this](AsyncWebServerRequest* r) {
        if (!checkAuth(r)) return;
        r->send(200, "text/plain", _otaUploadOk ? "OK" : "FAIL");
        _otaUploadOk = false;
    }, nullptr, [this](AsyncWebServerRequest*, uint8_t* data, size_t len, size_t index, size_t total) {
        if (index == 0) {
            _otaUploadOk = false;
            _otaFile = ECU_SD.open("/firmware.new", FILE_WRITE);
            if (!_otaFile) return;
            Log.info("OTA", "Saving firmware to SD (%u bytes)", total);
        }
        if (_otaFile) {
            if (_otaFile.write(data, len) != len) { _otaFile.close(); ECU_SD.remove("/firmware.new"); _otaFile = File(); }
        }
        if (index + len == total && _otaFile) { _otaFile.close(); _otaUploadOk = true; Log.info("OTA", "Firmware saved"); }
    });

    _server.on("/apply", HTTP_GET, [this](AsyncWebServerRequest* r) {
        if (!checkAuth(r)) return;
        bool exists = firmwareBackupExists("/firmware.new");
        size_t size = exists ? firmwareBackupSize("/firmware.new") : 0;
        r->send(200, "application/json", "{\"exists\":" + String(exists ? "true" : "false") + ",\"size\":" + String(size) + "}");
    });
    _server.on("/apply", HTTP_POST, [this](AsyncWebServerRequest* r) {
        if (!checkAuth(r)) return;
        if (!firmwareBackupExists("/firmware.new")) { r->send(400, "text/plain", "FAIL: no firmware"); return; }
        bool ok = applyFirmwareFromSD();
        r->send(200, "text/plain", ok ? "OK" : "FAIL");
        if (ok) {
            if (!_tDelayedReboot) _tDelayedReboot = new Task(2 * TASK_SECOND, TASK_ONCE, [this]() { _shouldReboot = true; }, _ts, false);
            _tDelayedReboot->restartDelayed(2 * TASK_SECOND);
        }
    });

    _server.on("/revert", HTTP_GET, [this](AsyncWebServerRequest* r) {
        if (!checkAuth(r)) return;
        bool exists = firmwareBackupExists();
        size_t size = exists ? firmwareBackupSize() : 0;
        r->send(200, "application/json", "{\"exists\":" + String(exists ? "true" : "false") + ",\"size\":" + String(size) + "}");
    });
    _server.on("/revert", HTTP_POST, [this](AsyncWebServerRequest* r) {
        if (!checkAuth(r)) return;
        if (!firmwareBackupExists()) { r->send(400, "text/plain", "FAIL: no backup"); return; }
        bool ok = revertFirmwareFromSD();
        r->send(200, "text/plain", ok ? "OK" : "FAIL");
        if (ok) {
            if (!_tDelayedReboot) _tDelayedReboot = new Task(2 * TASK_SECOND, TASK_ONCE, [this]() { _shouldReboot = true; }, _ts, false);
            _tDelayedReboot->restartDelayed(2 * TASK_SECOND);
        }
    });

    // Safe mode clear — reset boot counter, clear force flag, reboot
    _server.on("/safemode/clear", HTTP_POST, [this](AsyncWebServerRequest* r) {
        if (!checkAuth(r)) return;
        // Clear the forceSafeMode flag in config
        if (_config && _config->getProjectInfo()) {
            _config->getProjectInfo()->forceSafeMode = false;
            _config->updateConfig("/config.txt", *_config->getProjectInfo());
        }
        r->send(200, "application/json", "{\"status\":\"ok\",\"message\":\"Safe mode cleared. Rebooting...\"}");
        if (!_tDelayedReboot)
            _tDelayedReboot = new Task(2 * TASK_SECOND, TASK_ONCE, [this]() { _shouldReboot = true; }, _ts, false);
        _tDelayedReboot->restartDelayed(2 * TASK_SECOND);
    });

    // Reboot
    // Tooth logging
    _server.on("/teeth", HTTP_POST, [this](AsyncWebServerRequest* r) {
        if (!_ecu || !_ecu->getCrankSensor()) { r->send(503); return; }
        _ecu->getCrankSensor()->startToothLog();
        r->send(200, "text/plain", "Capturing");
    });
    _server.on("/teeth", HTTP_GET, [this](AsyncWebServerRequest* r) {
        if (!_ecu || !_ecu->getCrankSensor()) { r->send(503); return; }
        CrankSensor* cs = _ecu->getCrankSensor();
        if (cs->isToothLogCapturing()) {
            r->send(202, "application/json", "{\"status\":\"capturing\",\"count\":" + String(cs->getToothLogSize()) + "}");
            return;
        }
        uint16_t count = cs->getToothLogSize();
        if (count == 0) {
            r->send(200, "application/json", "{\"status\":\"empty\",\"data\":[]}");
            return;
        }
        const volatile CrankSensor::ToothLogEntry* log = cs->getToothLog();
        // Stream as chunked JSON
        AsyncResponseStream* response = r->beginResponseStream("application/json");
        response->print("{\"status\":\"complete\",\"count\":");
        response->print(count);
        response->print(",\"data\":[");
        for (uint16_t i = 0; i < count; i++) {
            if (i > 0) response->print(',');
            response->printf("{\"p\":%lu,\"t\":%u}", (unsigned long)log[i].periodUs, log[i].toothNum);
        }
        response->print("]}");
        r->send(response);
    });

    _server.on("/reboot", HTTP_POST, [this](AsyncWebServerRequest* r) {
        if (!checkAuth(r)) return;
        r->send(200, "text/plain", "OK");
        if (!_tDelayedReboot) _tDelayedReboot = new Task(2 * TASK_SECOND, TASK_ONCE, [this]() { _shouldReboot = true; }, _ts, false);
        _tDelayedReboot->restartDelayed(2 * TASK_SECOND);
    });

    // Pin map page
    _server.on("/pins", HTTP_GET, [this](AsyncWebServerRequest* r) {
        if (r->hasParam("format") && r->getParam("format")->value() == "json") {
            JsonDocument doc;
            JsonArray inputs = doc["inputs"].to<JsonArray>();
            JsonArray outputs = doc["outputs"].to<JsonArray>();
            JsonArray bus = doc["bus"].to<JsonArray>();

            // Get configurable pin values
            ProjectInfo* proj = _config ? _config->getProjectInfo() : nullptr;

            // Digital inputs
            auto addDigIn = [&](uint8_t pin, const char* name, const char* trigger, const char* desc,
                                const char* range, const char* voltage) {
                JsonObject o = inputs.add<JsonObject>();
                o["pin"] = pin; o["name"] = name; o["type"] = "digital";
                o["mode"] = trigger; o["desc"] = desc;
                o["value"] = digitalRead(pin) ? "HIGH" : "LOW";
                o["range"] = range; o["voltage"] = voltage;
            };
            addDigIn(1, "CRANK", "ISR FALLING", "36-1 trigger wheel, VR sensor. Tooth period ~460us @6000RPM, ~27.8ms @60RPM",
                     "HIGH / LOW", "3.3V");
            addDigIn(2, "CAM", "ISR RISING", "1 pulse per 2 crank revs. Phase detection for sequential mode",
                     "HIGH / LOW", "3.3V");

            // Analog inputs
            SensorManager* sens = _ecu ? _ecu->getSensorManager() : nullptr;
            auto addAnalog = [&](uint8_t pin, const char* name, uint8_t ch, const char* desc,
                                 const char* range, const char* voltage) {
                JsonObject o = inputs.add<JsonObject>();
                o["pin"] = pin; o["name"] = name; o["type"] = "analog"; o["mode"] = "ADC1";
                o["desc"] = desc; o["range"] = range; o["voltage"] = voltage;
                uint16_t raw = sens ? sens->getRawAdc(ch) : analogRead(pin);
                o["raw"] = raw;
                o["mV"] = (int)(raw * 3300.0f / 4095.0f);
            };
            uint8_t pO2b1 = proj ? proj->pinO2Bank1 : 3;
            uint8_t pO2b2 = proj ? proj->pinO2Bank2 : 4;
            uint8_t pMap = proj ? proj->pinMap : 5;
            uint8_t pTps = proj ? proj->pinTps : 6;
            uint8_t pClt = proj ? proj->pinClt : 7;
            uint8_t pIat = proj ? proj->pinIat : 8;
            uint8_t pVbat = proj ? proj->pinVbat : 9;
            addAnalog(pO2b1, "O2_BANK1", 0, "Wideband O2, 0-5V maps to AFR 10.0-20.0. 12-bit ADC, 0.81mV/step",
                      "10.0-20.0 AFR", "5V\xe2\x86\x92" "3.3V");
            addAnalog(pO2b2, "O2_BANK2", 1, "Wideband O2, 0-5V maps to AFR 10.0-20.0. 12-bit ADC, 0.81mV/step",
                      "10.0-20.0 AFR", "5V\xe2\x86\x92" "3.3V");
            bool hasMcp = sens && sens->hasMapTpsMCP3204();
            bool hasAds2 = sens && sens->hasMapTpsADS1115();
            if (hasMcp) {
                JsonObject oMap = inputs.add<JsonObject>();
                oMap["pin"] = "MCP3204@SPI CH0"; oMap["name"] = "MAP"; oMap["type"] = "analog"; oMap["mode"] = "SPI ADC";
                oMap["desc"] = "Manifold pressure via MCP3204, 0.5-4.5V = 10-105 kPa (12-bit, 1MHz SPI)";
                oMap["raw"] = 0; oMap["mV"] = 0; oMap["range"] = "10-105 kPa"; oMap["voltage"] = "5V";
                JsonObject oTps = inputs.add<JsonObject>();
                oTps["pin"] = "MCP3204@SPI CH1"; oTps["name"] = "TPS"; oTps["type"] = "analog"; oTps["mode"] = "SPI ADC";
                oTps["desc"] = "Throttle position via MCP3204, 0.5V=closed, 4.5V=WOT (12-bit, 1MHz SPI)";
                oTps["raw"] = 0; oTps["mV"] = 0; oTps["range"] = "0-100%"; oTps["voltage"] = "5V";
            } else if (hasAds2) {
                JsonObject oMap = inputs.add<JsonObject>();
                oMap["pin"] = "ADS1115@0x49 CH0"; oMap["name"] = "MAP"; oMap["type"] = "analog"; oMap["mode"] = "I2C ADC";
                oMap["desc"] = "Manifold pressure via ADS1115, 0.5-4.5V = 10-105 kPa (GAIN_TWOTHIRDS, 860SPS)";
                oMap["raw"] = 0; oMap["mV"] = 0; oMap["range"] = "10-105 kPa"; oMap["voltage"] = "5V";
                JsonObject oTps = inputs.add<JsonObject>();
                oTps["pin"] = "ADS1115@0x49 CH1"; oTps["name"] = "TPS"; oTps["type"] = "analog"; oTps["mode"] = "I2C ADC";
                oTps["desc"] = "Throttle position via ADS1115, 0.5V=closed, 4.5V=WOT (GAIN_TWOTHIRDS, 860SPS)";
                oTps["raw"] = 0; oTps["mV"] = 0; oTps["range"] = "0-100%"; oTps["voltage"] = "5V";
            } else {
                addAnalog(pMap, "MAP", 2, "Manifold pressure, 0.5-4.5V = 10-105 kPa. ~23.75 kPa/V",
                          "10-105 kPa", "5V\xe2\x86\x92" "3.3V");
                addAnalog(pTps, "TPS", 3, "Throttle position, 0.5V=closed, 4.5V=WOT. 0-100%",
                          "0-100%", "5V\xe2\x86\x92" "3.3V");
            }
            addAnalog(pClt, "CLT", 4, "Coolant NTC thermistor, 2.49k pullup, beta=3380. ~0.1F resolution",
                      "-40-300\xc2\xb0" "F", "5V\xe2\x86\x92" "3.3V");
            addAnalog(pIat, "IAT", 5, "Intake air NTC thermistor, 2.49k pullup, beta=3380. ~0.1F resolution",
                      "-40-300\xc2\xb0" "F", "5V\xe2\x86\x92" "3.3V");
            addAnalog(pVbat, "VBAT", 6, "Battery via 47k/10k divider (5.7:1). 0-3.3V ADC = 0-18.8V actual",
                      "0-18.8V", "5V\xe2\x86\x92" "3.3V");

            // Digital outputs — coils (dynamic count based on cylinders)
            {
                uint8_t cyl = proj ? proj->cylinders : 8;
                for (uint8_t i = 0; i < cyl; i++) {
                    uint16_t pin = proj ? proj->coilPins[i] : (264 + i);
                    if (pin == 0) continue;
                    JsonObject o = outputs.add<JsonObject>();
                    o["pin"] = pin;
                    char nm[8]; snprintf(nm, sizeof(nm), "COIL_%d", i+1);
                    o["name"] = nm; o["type"] = "digital"; o["mode"] = "OUTPUT";
                    o["desc"] = "COP coil driver via MCP23S17. HIGH=charging, LOW=fire. Dwell max 4.0ms";
                    o["value"] = xDigitalRead(pin) ? "ON" : "OFF";
                    o["bus"] = (pin >= 200) ? "SPI" : "GPIO";
                    o["range"] = "HIGH / LOW"; o["voltage"] = (pin >= 200) ? "5V" : "3.3V";
                }
            }

            // Digital outputs — injectors (dynamic count based on cylinders)
            {
                uint8_t cyl = proj ? proj->cylinders : 8;
                for (uint8_t i = 0; i < cyl; i++) {
                    uint16_t pin = proj ? proj->injectorPins[i] : (280 + i);
                    if (pin == 0) continue;
                    JsonObject o = outputs.add<JsonObject>();
                    o["pin"] = pin;
                    char nm[8]; snprintf(nm, sizeof(nm), "INJ_%d", i+1);
                    o["name"] = nm; o["type"] = "digital"; o["mode"] = "OUTPUT";
                    o["desc"] = "High-Z injector via MCP23S17. HIGH=open, LOW=closed. Dead time 1.0ms";
                    o["value"] = xDigitalRead(pin) ? "ON" : "OFF";
                    o["bus"] = (pin >= 200) ? "SPI" : "GPIO";
                    o["range"] = "HIGH / LOW"; o["voltage"] = (pin >= 200) ? "5V" : "3.3V";
                }
            }

            // PWM output — alternator
            {
                AlternatorControl* alt = _ecu ? _ecu->getAlternator() : nullptr;
                JsonObject o = outputs.add<JsonObject>();
                o["pin"] = proj ? proj->pinAlternator : 41; o["name"] = "ALT_FIELD"; o["type"] = "pwm";
                o["mode"] = "LEDC 25kHz";
                o["desc"] = "Alternator field coil. 8-bit PWM (0-255), 0-95% duty. PID target 13.6V";
                o["percent"] = alt ? alt->getDuty() : 0.0f;
                o["range"] = "0-95%"; o["voltage"] = "3.3V";
            }

            // Digital output — fuel pump
            {
                uint16_t pin = proj ? proj->pinFuelPump : 200;
                JsonObject o = outputs.add<JsonObject>();
                o["pin"] = pin; o["name"] = "FUEL_PUMP"; o["type"] = "digital"; o["mode"] = "OUTPUT";
                o["desc"] = "Fuel pump relay. HIGH=pump on. Always on when ECU running";
                o["value"] = xDigitalRead(pin) ? "ON" : "OFF";
                o["bus"] = (pin >= 200) ? "SPI" : "GPIO"; o["range"] = "HIGH / LOW";
                o["voltage"] = (pin >= 200) ? "5V" : "3.3V";
            }

            // Tach output
            {
                uint16_t pin = proj ? proj->pinTachOut : 201;
                JsonObject o = outputs.add<JsonObject>();
                o["pin"] = pin; o["name"] = "TACH_OUT"; o["type"] = "digital"; o["mode"] = "OUTPUT";
                o["desc"] = "Tachometer square wave output";
                o["value"] = xDigitalRead(pin) ? "ON" : "OFF";
                o["bus"] = (pin >= 200) ? "SPI" : "GPIO"; o["range"] = "HIGH / LOW";
                o["voltage"] = (pin >= 200) ? "5V" : "3.3V";
            }

            // CEL / check engine light
            {
                uint16_t pin = proj ? proj->pinCel : 202;
                JsonObject o = outputs.add<JsonObject>();
                o["pin"] = pin; o["name"] = "CEL"; o["type"] = "digital"; o["mode"] = "OUTPUT";
                o["desc"] = "Check engine light. HIGH=fault active";
                o["value"] = xDigitalRead(pin) ? "ON" : "OFF";
                o["bus"] = (pin >= 200) ? "SPI" : "GPIO"; o["range"] = "HIGH / LOW";
                o["voltage"] = (pin >= 200) ? "5V" : "3.3V";
            }

            // SPI bus — FSPI (SD card + CJ125)
            auto addSpi = [&](uint8_t pin, const char* name, const char* mode, const char* voltage) {
                JsonObject o = bus.add<JsonObject>();
                o["pin"] = pin; o["name"] = name; o["type"] = "SPI"; o["mode"] = mode; o["voltage"] = voltage;
            };
            addSpi(proj ? proj->pinSdClk : 47, "SD_CLK", "FSPI \xe2\x80\x94 SD Card", "3.3V");
            addSpi(proj ? proj->pinSdMiso : 48, "SD_MISO", "FSPI \xe2\x80\x94 SD Card", "3.3V");
            addSpi(proj ? proj->pinSdMosi : 38, "SD_MOSI", "FSPI \xe2\x80\x94 SD Card", "3.3V");
            addSpi(proj ? proj->pinSdCs : 39, "SD_CS", "FSPI \xe2\x80\x94 SD Card", "3.3V");
            // SPI bus — HSPI (6x MCP23S17 shared CS + HAEN, 5V via level shifter)
            uint8_t pHspiSck = proj ? proj->pinHspiSck : 10;
            uint8_t pHspiMosi = proj ? proj->pinHspiMosi : 11;
            uint8_t pHspiMiso = proj ? proj->pinHspiMiso : 12;
            uint8_t pHspiCs = proj ? proj->pinHspiCs : 13;
            addSpi(pHspiSck, "HSPI_SCK", "HSPI \xe2\x80\x94 MCP23S17 10MHz", "5V");
            addSpi(pHspiMosi, "HSPI_MOSI", "HSPI \xe2\x80\x94 MCP23S17 10MHz", "5V");
            addSpi(pHspiMiso, "HSPI_MISO", "HSPI \xe2\x80\x94 MCP23S17 10MHz", "5V");
            addSpi(pHspiCs, "HSPI_CS", "HSPI \xe2\x80\x94 shared CS (6 devices, HAEN)", "5V");
            // MCP3204 CS pin (show if configured, even in safe mode)
            {
                uint8_t pMcp3204Cs = proj ? proj->pinMcp3204Cs : 15;
                MCP3204Reader* mcp = _ecu ? _ecu->getMCP3204() : nullptr;
                bool mcpReady = mcp && mcp->isReady();
                bool spiEnabled = proj && proj->spiExpandersEnabled;
                if (mcpReady || spiEnabled) {
                    addSpi(pMcp3204Cs, "HSPI_CS2", "HSPI \xe2\x80\x94 MCP3204 ADC 1MHz", "5V");
                }
            }

            // CJ125 heater PWM outputs
            {
                JsonObject o = outputs.add<JsonObject>();
                o["pin"] = proj ? proj->pinHeater1 : 19; o["name"] = "HEATER_OUT_1"; o["type"] = "pwm";
                o["mode"] = "LEDC 100Hz"; o["desc"] = "CJ125 heater bank 1 via BTS3134. 8-bit PWM";
                o["range"] = "0-100%"; o["voltage"] = "3.3V";
            }
            {
                JsonObject o = outputs.add<JsonObject>();
                o["pin"] = proj ? proj->pinHeater2 : 20; o["name"] = "HEATER_OUT_2"; o["type"] = "pwm";
                o["mode"] = "LEDC 100Hz"; o["desc"] = "CJ125 heater bank 2 via BTS3134. 8-bit PWM";
                o["range"] = "0-100%"; o["voltage"] = "3.3V";
            }

            // I2C bus (ADS1115 only, 5V via TXB0108 level shifter)
            PinExpander& pcf = PinExpander::instance();
            uint8_t pI2cSda = proj ? proj->pinI2cSda : 0;
            uint8_t pI2cScl = proj ? proj->pinI2cScl : 42;
            {
                JsonObject o = bus.add<JsonObject>();
                o["pin"] = pI2cSda; o["name"] = "I2C_SDA"; o["type"] = "I2C";
                o["mode"] = "ADS1115 @ 0x48"; o["voltage"] = "5V";
            }
            {
                JsonObject o = bus.add<JsonObject>();
                o["pin"] = pI2cScl; o["name"] = "I2C_SCL"; o["type"] = "I2C";
                o["mode"] = "ADS1115 @ 0x48"; o["voltage"] = "5V";
            }
            if (sens && sens->hasMapTpsADS1115() && !sens->hasMapTpsMCP3204()) {
                JsonObject o = bus.add<JsonObject>();
                o["pin"] = pI2cSda; o["name"] = "I2C_SDA"; o["type"] = "I2C";
                o["mode"] = "ADS1115 @ 0x49 (MAP/TPS)"; o["voltage"] = "5V";
            }
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
