alpauna/TritonECU/(commit log)

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2026-09-07 Add 1999 F-150 5.4L / 4R70W target design
    Scope: replace the EEC-V PCM and its integrated transmission control.
    Findings that change the hardware design:
    - CKP and CMP on EEC-V are variable-reluctance, not Hall. They produce a
    self-powered sine wave that cannot drive a GPIO, and it is weakest
    exactly when sync matters most (cranking). VR conditioning is a
    hardware gap the current firmware does not account for.
    - The 5.4L 2V uses two 4-tower coil packs, wasted spark, not COP, so
    four coil drivers rather than eight.
    - PATS on this truck is Type C: the logic is in the instrument cluster
    and authorises the PCM over SCP. A replacement ECU never asks, so
    there is nothing to defeat or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
2026-09-07 Note that the MC33390 is the wrong J1850 variant for Ford SCP
    The 33390 is single-wire VPWM at 10.4 kbps, the GM flavour. Ford SCP is
    two-wire differential PWM at 41.6 kbps. The part is on hand and looks
    like an obvious upgrade over a repurposed H-bridge driver, so it is
    worth recording why it cannot work here.
    Claude-Session: https://claude.ai/code/session_01WJEMLvbfNooaLqws5YL8oT
2026-09-07 Add OEM connector catalogue; C141 MAF confirms the differential ADC need
    The MAF has a dedicated signal return (circuit 968) separate from its
    power ground (570). Ford does that because the hot-wire supply current
    varies with airflow and drops millivolts across the power ground on the
    way back; measured single-ended that drop becomes an airflow-dependent
    fuelling error, worst at high flow. Measured differentially it cancels.
    This is the strongest argument yet for the AD7606C-16 over the P4's own
    ADC, which is single-ended against chip ground and cannot use circuit
    968 at all.
    Also confirms IAT is a separate sensor here: C141 pins 1 and 6 are
    unused, so this is a MAF-only unit rather than o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
2026-09-07 Add DLC C228; correct the circuit 570 ground characterisation
    The DLC confirms Ford SCP is two-wire differential J1850 PWM: pin 2 is
    circuit 914 BUS (+), pin 10 is circuit 915 BUS (-). That independently
    confirms the MC33390 rejection, since a single-wire VPWM part would only
    ever touch pin 2.
    Correction: I described circuit 570 at the MAF as its power ground. The
    DLC shows 570 on its own pin alongside chassis ground 57, and the same
    circuit appears at the MAF, which makes it the PCM-sourced signal-return
    network rather than a local ground. The differential argument for the
    AD7606C is unchanged and slightly stronger: 968 carries no current, so
    it is a true Kelvin sense of the sensor referen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
2026-09-07 EEC-V power pins: add the VREF output requirement, resolve DLC pin 13
    Three findings from the PCM power/ground/reference sheet.
    VREF is an output, and the design was missing it. The PCM sources a
    buffered 5 V reference on two pins (A-20, C-20) feeding every three-wire
    sensor. The replacement has to generate it, current-limited and able to
    survive a short to ground, on two independent feeds. It also has to be
    accurate, because those sensors are ratiometric to it.
    That has a knock-on for the AD7606C, which measures against its own
    internal 2.5 V reference and so is not ratiometric to VREF: a 1 % VREF
    error would read as a 1 % TPS error. Fix by spending one ADC channel on
    VREF sense and divid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
2026-09-07 Correct the ignition to coil-on-plug; add the sensor requirement list
    CORRECTION: the target document claimed the '99 5.4L uses two 4-tower
    coil packs firing wasted-spark, needing four coil drivers. That came
    from a parts-catalogue search and was wrong. The factory component
    location sheet shows eight individual coil-on-plug units, C1011-C1018.
    Eight drivers, individually timed, no companion pairing to exploit.
    That breaks the pin budget option I had recommended. The count goes from
    33 to 37 against 25 usable, and option A no longer closes even with
    paired injection and paired ignition stacked on top of each other.
    Recommendation moves to B: bench work on the Waveshare board with a
    reduced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
2026-09-07 Sheet 2: knock sensor is present (C103), correcting an earlier assumption
    CORRECTION: both documents recorded the knock sensor as believed absent
    on the 2V, pending sheet 2. Sheet 2 shows C103, knock sensor. It exists.
    This is a real addition. Knock detection is the input that protects the
    engine from itself, and it is the hardest analog channel on the truck: a
    piezo charge source, small and fast and broadband, ringing around 6-8
    kHz on this bore, and requiring windowed sampling against a rolling
    noise floor rather than a fixed threshold. Documents both routes - a
    dedicated TPIC8101-class IC, or raw sampling with the DSP done on the
    P4 - and leans toward the latter, since the ADC and the co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
2026-09-07 Add VREF supply design note
    Specified: separate supply isolated from internal 5 V, outbound
    resettable fuse, 3 A out. The separation is right and worth keeping. The
    current figure needs revisiting for three reasons.
    Measured load is ~25 mA (TPS, DPFE, the two NTC pull-ups, TR ladder);
    MAF, CKP, CMP, knock and HO2S draw nothing from VREF. Ford's own EEC-V
    VREF is rated around 250 mA across both pins, so 3 A is ~100x the real
    load.
    At 3 A the topology is forced to a buck, which puts switching ripple on
    the one rail that most wants to be quiet - and every sensor on VREF is
    ratiometric, so ripple reads as sensor movement. At 25 mA a linear
    regulator dissipates 0.25 W and is inherently quiet.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
2026-09-07 Add EEC-V 104-pin pinout; switch recommendation to a two-module split
    Transcribes the full pinout from alpauna/MegaSquirt99FordF150, which
    mapped this truck for an MS3Pro PNP install.
    It confirms several things that were inference: CKP is VR (pins 21/22
    are CKP+/CKP-, a two-wire differential coil), OSS is VR too (pin 84 is
    annotated "via LM1850", almost certainly the LM1815 adaptive VR
    amplifier), the MAF return really is separate from sensor ground (pin 36
    vs pin 91), SCP matches the DLC circuits, and CHT is used rather than
    ECT - the MegaSquirt build jumpers its own ECT input across to the CHT
    pin because there is no coolant sensor to connect.
    New I/O that was missing: CSS, the coast clu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
2026-09-07 Add rusEFI EEC-V footprint geometry and VR conditioning reference
    rusEFI publishes a complete 104-pin EEC-V footprint (GPLv3) with two
    boards using it. Extracted the geometry from eecv.kicad_pcb: 104
    through-hole pads in 4 rows of 26, 3.4 mm pitch within a row, 3.0 mm
    between rows, and - important - the rows are staggered by 1.7 mm, half
    the pitch. Drill 1.143 mm, pad 1.778 mm, pin field 101.4 x 9.0 mm. A
    generic 4x26 header will not mate; the stagger is what makes it fit.
    This also resolves the pin numbering question, and not the way I
    expected. rusEFI and the MegaSquirt sheet both number 1-104 flat, and
    4 x 26 accounts for exactly 104, so they agree. But the
    EEC-V-Power-Pins.png sheet con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
2026-09-07 Start the rebuild: M0 passes on hardware; correct the TSS claim
    Rebuild
    -------
    New firmware/ecu tree, deliberately minimal, with a roadmap of twelve
    milestones each ending in a specific bench observation rather than "it
    compiles". The old tree stays untouched at the repo root so both can be
    built and compared.
    Restarting rather than porting because one of the old firmware's core
    decisions is now known to be wrong: coils and injectors are on MCP23S17
    SPI expanders. At 6000 rpm one crank degree is 27.8 us, and an SPI
    transaction is several microseconds at best, non-deterministic, and
    cannot be driven from a hardware timer. Spark timing cannot live behind
    a port expander. That is structural,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
    [Board.h, Version.h, main.cpp]
2026-09-07 Add instrument panel module map; resolve transfer case and PATS questions
    Three sheets covering what the PCM shares the truck with.
    Resolves the open question about the electronic-shift transfer case: it
    has its own shift relay module (C221) in the dash, fed by the 4WD mode
    switch (C230). Self-contained, and not something the replacement ECU has
    to actuate. It may still want to know the range, since low range should
    change shift points and line pressure.
    Confirms the PATS architecture already assumed. C297 is the PATS
    transceiver - the coil around the ignition lock that reads the key - and
    it is only the reader. The logic is in the instrument cluster
    (C236/C237), which is what PATS Type C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
2026-09-07 M1: SDMMC storage and JSON config
    Storage module mounts the card on the P4's native SDMMC controller. The
    Waveshare carrier wires its TF slot to slot 0, whose CLK/CMD/D0-D3 are
    fixed in silicon and declared by the Arduino variant, so mounting needs
    no pin setup. Falls back to 1-bit if the 4-bit bus will not train.
    Config is JSON at /config.json, holding only what a milestone actually
    needs so far: engine geometry (8 cylinders, 5400 cc, 36-1 crank wheel,
    firing order) and a boot counter to prove persistence.
    Two failure behaviours are deliberate. A missing, unopenable or
    unparseable config rewrites defaults and keeps booting - a config that
    will not parse is a reason to fall back, not a rea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
    [Config.cpp, Config.h, Storage.cpp, Storage.h, Version.h, main.cpp]
2026-09-07 Spec the fuel pump monitor: tap downstream of the inertia switch
    Where the monitor is tapped decides what it can detect. Downstream of
    the inertia switch, at the pump feed, relay-on-but-monitor-low catches a
    tripped inertia switch, an open relay contact, a blown fuse or a broken
    wire. Tapped upstream it only proves the relay and fuse are good, which
    is the half that rarely fails - the inertia switch is the component that
    trips silently and produces a no-start indistinguishable from a dead
    relay.
    Recorded honestly what it cannot do: voltage monitoring proves the
    circuit is intact, not that the pump turns. A seized pump with good
    windings still reads battery voltage. Proving flow needs curren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
2026-09-07 Sharpen the SD failure message; card is present but the filesystem is not FAT
    With a card inserted the IDF error changes from an sdmmc_init_ocr
    send_op_cond timeout to mount_to_vfs failed, which means the card
    initialises fine and only the filesystem mount fails. That is almost
    always the wrong filesystem rather than a bad card - anything over 32 GB
    ships as exFAT, and FATFS reads FAT16/FAT32 only.
    Message now says so instead of claiming the slot is empty, and a comment
    records which IDF log line distinguishes the two cases.
    Explicitly not passing format_if_mount_failed. An unmountable card is
    far more often the wrong filesystem than a broken one, and formatting it
    would destroy whatever i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
    [Storage.cpp]
2026-09-07 M2: port the AD7606C-16 driver from the Teensy scope project
    The part is already on hand, wired to the Teensy 4.1 in LxScanner. This
    is a port of that bench-validated code - the CONVST/BUSY/8x16-bit read
    sequence, SPI_MODE0 and the reset timing are carried over unchanged
    because they were proven against a known +/-1.24 V reference. Only the
    surrounding structure differs: sampling on demand for the ECU rather
    than streaming frames over USB.
    Adds a Teensy-to-P4 migration table so moving the chip is mechanical.
    Both run VDRIVE at 3.3 V, so it is wire-for-wire with no level shifting.
    MOSI stays unwired: in hardware mode range and oversampling are set by
    pins rather than registers.
    Records that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
    [Ad7606c.cpp, Ad7606c.h]
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2026-09-07 Settle the ADC part choice: the B-series on hand is right for the ECU
    The part bought for the Teensy scope turned out to be a B-series rather
    than a C. For the scope that is a real setback, since bandwidth is the
    whole point and 200 kSPS against 1 MSPS is a fivefold cut. For this ECU
    it changes nothing - utilisation is around 1 % either way - so the ECU
    should take the B-series part now instead of waiting behind a new
    C-series PCB. The part that disappointed one project is the correct
    choice for the other.
    Documents the naming trap that caused it. The B in AD7606BSTZ is a grade
    letter in the original AD7606's ordering code, not the AD7606B product,
    and ADI warn that all three generations ar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
    [Ad7606c.h]
2026-09-07 Correct the footprint claim: same package, not the same pin functions
    I said one layout serves both projects. Footprint-compatible is right -
    all three generations are LQFP-64 - but pin functions differ, and one of
    them matters for the PCB.
    Pins 9 and 10 are CONVSTA and CONVSTB on the AD7606, and CONVST and WR
    on the AD7606C. Standard AD7606 practice is to short the two CONVST pins
    so all eight channels sample together, which is what the existing
    breakout already does - the Teensy driver notes CONVST also drives WR
    through the breakout's own tie.
    That turns out to be safe rather than a trap: the C's datasheet
    explicitly permits WR to be tied high, tied low, or shorted to CONVST in
    hardware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
    [CrankDecoder.h]
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2026-09-07 Record the ENOB reality: 18-bit is pointless and 16-bit is not 16-bit
    Converting the Tokmas datasheet figures with ENOB = (dB - 1.76)/6.02:
    SNR typ 87 dB gives 14.16 effective bits, and SINAD typ 84.5 dB - which
    includes distortion, so it is the honest number - gives 13.74. A 16-bit
    part delivers under 14 effective bits on a lab bench, before any wire
    runs through an engine bay.
    In a truck the limits are all larger than quantisation: harness pickup
    from eight coil primaries and eight injectors switching inductive loads
    metres away, TPS wiper contact noise, and VREF noise, which caps every
    ratiometric sensor regardless of converter quality. Eleven to twelve
    trustworthy bits is the realistic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
2026-09-07 Fix a false-positive ADC probe found on the bench; slow the SPI default
    The bench caught the driver claiming "AD7606 responding" with nothing
    connected. BUSY floats low, so waiting for it to fall returned
    immediately; MISO floated high, every channel read 0xFFFF, and that
    converts to a plausible-looking -0.0003 V on all eight. This is exactly
    the plausible garbage the earlier documentation claimed the code would
    reject, so the claim is corrected rather than quietly dropped.
    Two checks replace it. BUSY must now be seen to RISE after CONVST rather
    than merely be low, and the probe runs at x64 oversampling so the
    conversion takes ~255 us instead of ~3 us, which makes the high period
    impossible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
    [Ad7606c.cpp, Ad7606c.h, Board.h, main.cpp]
2026-09-07 M2 alive: AD7606 converting on the P4, plus a connection diagnostic
    The part responds and streams all eight channels at 1 MHz SPI. Readings
    are scattered and stable, which is correct for floating inputs: channels
    disagree with each other, and successive samples repeat to about half a
    millivolt.
    Adds a header solder-bridge self-test (env: selftest) and an AD7606
    connection diagnostic, both of which earned their place immediately.
    The self-test's first run reported 50 bridges, every one involving only
    GPIO7 or GPIO8. That was the test's flaw, not the board's: those pins
    carry the carrier's I2C pull-ups, so they read HIGH throughout the bridge
    scan and false-positive against every driver. It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
    [PinSelfTest.cpp, PinSelfTest.h, main.cpp]
2026-09-07 M2 done: AD7606 reads correctly, on SPI_MODE2 rather than MODE0
    Two known signals now read correctly: a +/-1.22 V scope output on V1 and
    a 0-2 V 1 kHz Hantek square on V8, the latter caught at both states.
    The SPI mode did not carry over from the Teensy, and this is the one
    thing in the port that could not have been assumed. The Teensy validated
    SPI_MODE0 against a known reference, having first tried MODE1 and found
    a consistent 2x error. Ported unchanged to the ESP32-P4, MODE0 produced
    exactly that same 2x error. Sweeping all four against two independently
    known signals: modes 0, 1 and 3 all read double, MODE2 reads both
    correctly.
    A wrong CPHA shifts every sampled bit by one clock edge,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
    [Ad7606c.cpp, Ad7606c.h, PinSelfTest.cpp, PinSelfTest.h, main.cpp]
2026-09-07 M3 logic: 36-1 crank decoder with native tests, all passing
    Ten tests, no hardware. The decoder deals only in tooth timestamps,
    which is what lets the software half of M3 be proven before a VR
    conditioner exists - and M3 is the highest-risk milestone in the
    project, so removing half its risk from the bench session is worth the
    effort.
    Coverage: sync at idle, at 6000 rpm, and at 200 rpm cranking speed with
    the gap ratio degraded to 1.7 rather than a clean 2.0. That last case is
    the one that matters and the reason the decoder compares each interval
    against the previous one rather than a fixed threshold - the engine
    decelerates through the gap under compression, so a threshold set at 2.0
    misse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
2026-09-07 M1 done: config round-trips between the ECU and a PC
    Card mounts in 4-bit SDMMC mode, not the 1-bit fallback, so all four
    data lines to the TF slot are good. First boot found no /config.json and
    wrote defaults; the boot counter then incremented 1, 2, 3 across resets,
    proving the temp-file-then-rename write survives power cycles.
    Verified the other direction too, which is what makes the config
    genuinely editable rather than merely persistent: edited the file on a
    PC with two distinctive values and the ECU read both back - a boot count
    of 100 came back as 101 then 102, and an edited displacement came
    through unchanged.
    Corrects the built-in default from 5400 cc to 5408, the true 5.4L Triton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
    [Config.h]
2026-09-07 M4/M5 logic: cam sync and spark scheduling, 28 native tests passing
    Both built Arduino-free so they can be proven before a VR conditioner or
    a coil driver exists.
    Cam sync (EnginePosition). A four-stroke's crank angle is ambiguous -
    every angle occurs twice per cycle, once on compression and once on
    exhaust - so the CMP pulse resolves which revolution the cycle is in.
    Two behaviours matter and are tested. A cam pulse arriving at an
    implausible crank angle is rejected rather than trusted, because acting
    on it would shift the whole cycle 360 degrees and put every cylinder on
    the exhaust stroke. And losing crank sync drops 720 sync with it, since
    the revolution count is derived from counting c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
    [EnginePosition.h, SparkScheduler.h, test_spark.cpp]
2026-09-07 Specify MAX9926 configuration: Mode A2, from the datasheet
    Mode A2 (ZERO_EN=GND, INT_THRS=GND) keeps both zero-crossing and the
    adaptive peak threshold while using the internal 2.5 V reference, which
    removes the external VCC/2 divider and its 0.1 uF + 10 uF bypass on each
    BIAS pin that Mode A1 needs. Same behaviour, fewer parts. Records the
    full strapping table, and that ZERO_EN is internally pulled up to VCC
    through 10k so it must be actively pulled low.
    Two points worth not getting wrong. COUT is open-drain, so the pull-up
    rail alone sets the logic level - pull it to 3.3 V and it connects
    straight to the P4 with no level shifter, which is presumably why the
    part has an open-drain output a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
2026-09-07 VR input resistors: size for working voltage, and split each leg
    Agreed on 0805 minimum, and recording why: the binding constraint is
    maximum working voltage, not dissipation. A VR sensor can exceed 100 V
    peak at engine speed, and almost all of it appears across the series
    resistor because the far end is clamped by the MAX9926's internal ESD
    diodes to a diode drop off the 5 V rail. Typical thick-film ratings are
    50 V for 0402 and 0603, 150 V for 0805, 200 V for 1206 - so 0603 is
    marginal and 0402 is out.
    Better still is two resistors in series per leg, 2 x 4.7k or 2 x 5k in
    0805: double the voltage headroom at 300 V, half the stress and pulse
    energy in each part, for one extra footprint. Th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
2026-09-07 Add a MAX9926 Mode A2 build sheet
    Connection table, BOM and first bench test in one place, so the board can
    be built without cross-referencing three documents. Channel 1 is CKP,
    channel 2 is OSS or CMP. Fifteen passives and one IC - Mode A2 avoids
    the BIAS dividers and their bypass pairs that A1 would need.
    Calls out the two failure modes that are quiet rather than obvious.
    Pulling COUT to 5 V instead of 3.3 V damages the P4 input, and the whole
    point of the open-drain output is that the pull-up rail sets the level.
    And ZERO_EN has an internal 10k pull-up to VCC, so a missing pulldown
    silently selects Mode A1 - which then wants the external BIAS dividers
    that are not fitted, giving a part t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
2026-09-07 Bus topology: the GEM is on ISO 9141, not SCP
    CORRECTION, and a significant one. Earlier documents treated the GEM as
    the main integration risk of the swap, assuming that pulling the PCM
    would starve it of SCP messages it expects. The factory data-line sheet
    shows the SCP bus carries only the PCM and the instrument cluster. The
    GEM is on ISO 9141 (circuit 70) together with the restraints control,
    RAP and 4WABS modules, and shares no bus with the PCM at all.
    The GEM therefore cannot lose SCP messages, because it never received
    any. Anything it needs from the PCM arrives hardwired or not at all,
    which fits the MegaSquirt pinout listing PCM pin 68 as "VSS+ out to
    cruise" - a discrete output ra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
2026-09-07 Work the pin budget for 2x MAX9926 and full ignition/injection
    Short answer: yes, short on the Waveshare board - by 11 - and not short
    on the chip.
    A full single-node ECU needs 36 native pins. Eight coil drivers and
    eight injector drivers dominate and cannot be moved to an expander,
    since both are hardware-timed to sub-degree accuracy. Four VR channels
    from two MAX9926s, five for the AD7606 SPI and control, three for J1850,
    plus PWM, frequency outputs and I2C make up the rest. Everything that
    can live on the MCP23S17 chain is excluded from the count because it
    costs nothing beyond the one chip-select already tallied.
    The Waveshare carrier breaks out 27 GPIOs, of which two are the USB
    pair,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
2026-09-07 Pin assignment for a raw ESP32-P4 ECU board
    Resolves the GPIO0-15 question. SOC_GPIO_VALID_DIGITAL_IO_PAD_MASK
    excludes them, which looked like it might halve the usable pin count,
    but SOC_RTCIO_PIN_COUNT is 16: GPIO0-15 are the RTC/LP IO pins, usable
    as ordinary digital IO through the HP matrix and additionally reachable
    by the LP core. The mask means digital-only pads, so these have an extra
    function rather than a missing one - and the Waveshare board runs an I2S
    codec on GPIO9-13, which settles it empirically.
    Full assignment: 20 pins committed to the C6 link, strapping, UART0 and
    the SD card, leaving 35 plus the USB pair. Eight coils on 46-53 and
    eight injectors on 26-33, both contiguou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
2026-09-07 Specify v3.x silicon and the C6 as a module
    C6 stays a pre-certified module: full P4 pin access without RF layout or
    certification, over the SDIO pins already reserved.
    On chip revision - the bench board is rev v1.3, engineering-sample era,
    and is not representative of what to build with. Production is v3.x. No
    GPIO or pin-function changes between them, so the assignment stands
    either way, and the headline 360 to 400 MHz is the least interesting
    difference.
    The one that matters is the fixed MSPI power-on wake-up fault - a load
    access fault on the memory interface the processor executes from. An ECU
    is close to the worst case for that: it power-cycles every time the key
    turns, and does so t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
2026-09-07 Gate drivers move where the boot-state protection lives
    Gate drivers are right for real power MOSFETs - the P4 cannot supply the
    peak gate current a large FET wants, and slow switching is where the heat
    comes from. But a 10k pulldown at the gate defends against leakage and
    charge injection, not against a driver actively sourcing current into
    that gate, which it will do without noticing. So the gate pulldown stays
    necessary and stops being sufficient on its own.
    Two additions recorded: pull down the driver's input as well, since the
    P4 pin driving it is high-impedance through reset and a floating driver
    input can give an undefined output; and use the driver's enable or
    shutdown pin where it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
2026-09-07 Coils confirmed dumb; record why coil and injector clamping differ
    Resolved on the truck: the COP coils are plain two-wire units, 12 V one
    side, driver grounds the other. Same for the injectors. So the board
    owns the switch, the clamping and the energy for both. Roughly 6-10 A
    peak into a coil primary at the end of dwell against about 1 A for a
    high-impedance injector, which sets the device sizing.
    The flyback strategy is opposite for the two, and this is the part that
    is easy to get backwards, because snubbing every inductive output is the
    right instinct almost everywhere else.
    A coil's flyback is the spark. The collapsing primary field is what
    generates the secondary voltage, so anything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
2026-09-07 Select ignition and injector output devices
    Ignition: onsemi ISL9V3040 EcoSPARK. 400 V integrated clamp, 17 A,
    Vce(sat) 1.58 V, 300 mJ self-clamped inductive switching energy, in
    TO-220/TO-263/TO-252. The integrated clamp is the whole point - an
    ignition primary must be allowed to fly back a few hundred volts and
    then be stopped short of destroying the device. 17 A is comfortable
    against a 6-10 A coil.
    Flagged the number that actually decides survival, which depends on the
    coil rather than the driver: stored energy is half L I squared, so a
    5 mH primary at 8 A is 160 mJ and has 1.9x margin, but 6 mH at 10 A is
    300 mJ and sits exactly at the limit. Dwell is under firmware control,
    so this is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
2026-09-07 Gate drive resolved: no driver ICs needed, one buffer for all eight coils
    Correcting my earlier caution. I flagged that the ignition IGBTs would
    likely need proper gate drivers. The datasheet says otherwise: the
    ISL9V3040 leads with "Logic Level Gate Drive" and carries its own gate
    network - 70 ohm internal series resistance and a 10k-26k internal
    gate-to-emitter resistor. Gate charge is only 17 nC. So a plain 5 V
    logic buffer is sufficient and no driver IC is required.
    Notably the internal gate-to-emitter resistor means the boot-state
    pulldown is already inside the device on the ignition side, so the
    external one is belt-and-braces rather than essential.
    It must not be driven from 3.3 V t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
2026-09-07 Use both 74HCT541 output enables as a two-key ignition interlock
    The '541 has OE1 and OE2, both active-low and ANDed internally, so
    either one high forces all eight outputs high-impedance. Both pulled up
    to 5 V means coils are disabled at power-on, and with the IGBT's own
    internal gate-to-emitter resistor no coil can be energised until
    something actively permits it.
    Using them independently is worth more than tying them together. OE1
    from a firmware GPIO means "engine position known, ignition armed". OE2
    from a hardware watchdog means "firmware is still alive" - and that
    covers a failure the first cannot. If firmware hangs while a coil is
    charging, that coil stays energised: 6-10 A continuo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
2026-09-07 LM5155-Q1 confirmed; 4 A analysis; surge stopper rather than crowbar
    LM5155-Q1 checks out: 3.5-45 V operating with 50 V transient, AEC-Q100
    grade 1 to 125 C, boost/SEPIC/flyback, 93 percent max duty. The 3.5 V
    minimum is the headline - it covers worst-case cranking sag with large
    margin, which is the whole reason for choosing a SEPIC over a buck. It
    is a controller with an external switch, so output current is set by the
    FET, magnetics and thermals rather than by the IC.
    4 A is achievable. At the worst corner of 6 V in and 4 A out, duty is
    45 percent and input current 3.9 A, with switch and diode both carrying
    IL1 + IL2 for a peak near 10 A. The existing 3-30 V design already
    handles compar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
2026-09-07 Harness protection: what helps per pin type, and two things that hurt
    A 27-year-old harness justifies taking output protection seriously, but
    the right protection differs by pin type and two obvious moves are
    actively harmful.
    A PTC in series with a coil or injector output is tempting and wrong.
    The driver is a low-side switch sitting in the load's current path, so a
    PTC lands in the coil primary circuit where its resistance directly
    reduces the current reached in a given dwell - and PTC resistance rises
    with temperature, so ignition would get progressively weaker as the ECU
    warms. They are also seconds-slow against a microsecond failure. The
    drivers' own over-current and over-temperature p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
2026-09-07 Layout guidance for the 2.2 MHz SEPIC
    Recording that the frequency choice cuts both ways. Moving to 2.2 MHz
    clears the AM band, which was the point, but it does not make EMI
    easier - radiated emission scales with loop area times di/dt times
    frequency squared, so raising the fundamental 5.5x makes every harmonic
    worse and small structures radiate more efficiently at high frequency. A
    loop that was acceptable at 400 kHz is not acceptable here. The layout
    becomes the dominant term rather than a detail after the schematic.
    Identifies the SEPIC hot loop - switch, Cs, diode, Cout - as the thing
    to place first, and gives a concrete target. The earlier SEPIC PCB
    review measured hot-loop areas direc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
2026-09-07 Drop to 80 V devices: the surge stopper sets the voltage class
    Smaller parts make a smaller hot loop and 100 V devices are not small -
    but 100 V was chosen against the LM5155-Q1's 45 V maximum rather than
    against what the SEPIC will actually see. The surge stopper is upstream
    and decides that: regulating to about 30 V gives 36.5 V of switch stress
    during a surge and only 20.3 V running, with roughly 44 V including
    ringing overshoot. 80 V carries good margin against that and covers the
    failed-surge-stopper case where the TVS clamps around 40 V.
    80 V is better than 100 V on more than size. At 2.2 MHz switching loss
    goes as frequency times gate charge times drain voltage, so Qg is a
    first-orde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
2026-09-07 Select LTC4364-2 for input protection
    One AEC-Q100 part covers reverse polarity, load-dump clamping,
    overcurrent and brownout holdup. 4-80 V operating, withstands over 80 V
    with its VCC clamp network, reverse input protection to -40 V, adjustable
    output clamp and fault timer. Its own headline application is a 4 A 12 V
    automotive regulator withstanding a 200 V 1 ms transient and clamping a
    92 V surge to 27 V, which is this application.
    It absorbs the reverse-polarity P-FET via its integrated ideal diode
    controller, and the primary overcurrent protection via its timed circuit
    breaker. The fuse stays but is demoted to backstopping the pass FET
    failing short - the one mode nothing downstream ca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
2026-09-07 Use an INA238-Q1 I2C power monitor on the LTC4364 shunt
    Better than an analog current-sense amplifier here, and it costs no ADC
    channel and no GPIO since I2C is already on the board. AEC-Q100, 16-bit,
    -0.3 to 85 V common mode against the 6-30 V this node actually sees, and
    it reports bus voltage as well as shunt voltage, current, power and
    charge.
    Use the +/-163.84 mV range rather than +/-40.96 mV. The narrow range
    resolves better but saturates at 4.1 A across 10 mOhm, and full load at
    cold crank is 3.53 A - uncomfortably close, with the breaker not
    tripping until 5 A. The wide range covers 16.4 A, keeps about 500 uA of
    resolution, and stays linear through the trip point where the data
    matt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
2026-09-07 Battery sensing accuracy, and note the OEM alternator self-regulates
    Checked before designing for it: the EEC-V 104-pin pinout has no
    generator, field or charging pin. The generator's own connectors appear
    in the engine bay component locations but nothing routes to the PCM. So
    the '99 F-150's alternator is self-regulating, as Ford used before
    PCM-controlled smart charging arrived on later platforms, and removing
    the PCM does not affect charging at all.
    ECU charging control is therefore an addition rather than a replacement.
    Worth stating plainly because the implications differ: if the alternator
    keeps self-regulating, battery voltage is still needed for injector
    dead-time and dwell compensa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
2026-09-07 Correct: no separate transmission node, one board does both
    I was inconsistent. Earlier notes proposed a "transmission node" - a
    second board over CAN, mirroring the MegaSquirt build's MS3Pro plus
    MicroSquirt. That was an artifact of the Waveshare carrier exposing only
    25 usable pins, and moving to a raw ESP32-P4 removed the need. My own
    37-pin assignment in custom-board.md already includes the transmission
    I/O.
    Only TCC and EPC cost native pins, and both were already budgeted. OSS
    shares the MAX9926 that CKP and CMP need. SS1, SS2 and CSS are on/off
    solenoids and the transmission range sensor is four digital lines, all
    slow enough for the MCP23S17 chain that is on the board regardless. TFT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
2026-09-07 Verify the pin budget with a script; found a missing SPI MOSI
    Answering whether a second CPU is needed: no. Counted by
    hardware/pinmap.py rather than by hand, which also checks for duplicate
    assignments and clashes with committed pins.
    55 GPIOs, 18 committed to the C6 link, SD card, UART0 and strapping,
    leaving 37. The core build - engine and transmission together - needs
    34, and J1850 fits in the remaining three. One CPU, one board.
    The count found a real omission in the hand-written assignment: SPI MOSI
    was missing entirely. The AD7606 does not need it in hardware mode, but
    the MCP23S17 expander chain cannot be written to without it, and that
    chain carries the shift solenoids, the transm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
    [pinmap.py]
2026-09-07 Adopt 1-bit SDMMC: 3 spare GPIOs
    D1-D3 (GPIO42-44) are freed. The card carries config and logs only, so
    4-bit bandwidth buys nothing, and three spare pins turn a zero-margin
    layout into one that can absorb a mistake found at assembly.
    Final budget: 15 committed, 40 available, 37 assigned, 3 spare.
    Firmware gains an ECU_SD_ONE_BIT flag so the custom board goes straight
    to 1-bit rather than failing a 4-bit attempt first. The Waveshare bench
    board keeps the existing behaviour, which tries 4-bit and falls back.
    Levers still in reserve: semi-sequential injection frees four, and
    moving tach and VSS onto SCP frees two.
    Claude-Session: https: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
    [Storage.cpp, pinmap.py]
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2026-09-07 Target a carrier board for the Nucleo rather than a raw-chip design
    Fastest path to a running truck: the Nucleo plugs into a carrier via its
    morpho headers and the MCU section stops being a risk - no flash,
    crystal, power sequencing or boot straps on a first spin - while
    ST-Link, the USB console and the Ethernet PHY all come for free. The
    carrier can be iterated without touching the MCU, and most first-board
    mistakes live in the analog and driver sections anyway. A raw-F767
    respin later reuses the same schematic blocks.
    One real consequence: the rail tree changes. It previously assumed a
    bare ESP32-P4 fed at 3.3 V, but the Nucleo wants 5 V into E5V and makes
    its own 3.3 V, drawing roughly 1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
2026-09-07 M0 verified on the STM32F767ZI Nucleo
    Reads its own identity registers: device ID 0x451 revision 0x1001, which
    is the STM32F76x/F77x family as expected, 216 MHz confirming the PLL is
    configured rather than running on HSI, and 2048 KB of flash. Heartbeat
    runs.
    Two bench findings worth keeping. The ST-Link needed a udev rule before
    OpenOCD could claim it - LIBUSB_ERROR_ACCESS, with the raw USB device
    owned root:root - though the VCP side worked from the start since the
    user is already in dialout. And the ST-Link's VCP and SWD share one USB
    device, so resetting the target over SWD disconnects the console, which
    makes a boot banner awkward to catch. The firmware now reprints its
    identity on rec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
    [main.cpp]
2026-09-07 Document Nucleo-144 bring-up from scratch
    Written from the actual first-time bring-up so the friction is a
    one-time cost rather than a recurring one.
    The only genuine blocker is the ST-Link udev rule. Out of the box,
    upload fails with LIBUSB_ERROR_ACCESS because the raw USB device is
    root-owned, while the serial port works from the start if the user is in
    dialout - which is exactly what makes the failure confusing. Records the
    fix, and that the board must be replugged afterwards since udev applies
    rules on device add.
    Also documents two quirks that waste time if met unprepared. The VCP and
    SWD share one USB device, so resetting over SWD disconnects the console
    and a boot banner is genuinel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
2026-09-07 Add a setup script for USB debug-probe permissions
    Turns the one genuine first-time blocker into a single command.
    Reports which attached probes are blocked before changing anything,
    writes the rules, reloads udev, and says explicitly whether a replug is
    needed - since udev applies rules on device add, and an already-connected
    probe keeping its old permissions is the most common reason the fix
    appears not to work.
    Covers ST-Link V2/V2.1/V3, CH343 and CH340, CP2102, FT232, Espressif
    USB-Serial-JTAG and Teensy, so it handles every board on this bench
    rather than just the Nucleo.
    A --check mode reports without sudo and without modifying anything,
    which is also a quick way to tell a permissio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
2026-09-07 M1 for STM32: SD on SPI4/Port E, config on SdFat
    Port E carries no fixed function on the Nucleo-144 - no Ethernet, no
    ST-Link, no USB, no LEDs - so taking SPI4 there displaces nothing. It
    also leaves the Arduino-header SPI alone, which matters because PA7 is
    RMII_CRS_DV on this board and the conventional SPI1 trio is already
    broken by Ethernet. SCK on PE2, MISO PE5, MOSI PE6, CS PE4.
    SPI rather than SDMMC keeps it to four signals instead of six, and the
    card holds config and logs where bandwidth is not the constraint. SDMMC1
    on PC8-PC12 plus PD2 stays available if high-rate logging later needs
    it.
    Bus starts at 4 MHz deliberately. Flying leads to an SD module are not a
    controlled-impedance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
    [Board.h, Config.cpp, Config.h, Storage.cpp, StorageStm32.h, main.cpp]
2026-09-07 Add a second console on USART2; the ST-Link VCP is not trustworthy
    This ST-Link's virtual COM port drops characters even on a five-second
    heartbeat with no host traffic, at 115200 and again at 57600. That is an
    ST-Link firmware or hardware issue rather than anything the application
    can fix, and it was costing more time than it was worth.
    USART2 on PD5/PD6 is free - USART3 on PD8/PD9 belongs to the ST-Link -
    and takes an ordinary USB-UART adapter. Output goes to both ports and
    input is read from either, so whichever is connected works and nothing
    needs reconfiguring when the adapter is plugged in.
    Two bugs of mine fixed along the way. The remount command was
    incrementing bootCount, which qu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
    [Board.h, main.cpp]
2026-09-07 Shared Console module; record the VCP and power findings
    Extracts console output into a Console module that mirrors to both the
    ST-Link VCP and USART2. Storage and Config were printing via Serial
    directly, so their output only reached the unreliable port and was
    missing entirely from the USART2 capture - which is why the storage and
    config lines were absent from an otherwise clean banner.
    Two bench findings now recorded rather than theorised.
    The ST-Link VCP is genuinely unreliable on this board: it drops
    characters on a five-second heartbeat with no host traffic, at 115200
    and again at 57600, and flushing and pausing between lines did not help.
    The same firmware over USART2 to a CH340 was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
    [Config.cpp, Console.cpp, Console.h, Storage.cpp, main.cpp]
2026-09-07 Port the AD7606 driver to STM32; assign it SPI2
    Same driver logic, different plumbing: STM32duino takes the SPI pins when
    the SPIClass is constructed rather than in begin(), and console output
    goes through the tee rather than Serial.
    SPI2 on PB10/PC2/PC3 with CS on PB12, deliberately a separate bus from
    the SD card on SPI4. The ADC is sampled at engine rate and must never
    wait behind a card write - sharing a bus would put filesystem latency
    directly into the sampling interval. Avoids PB0/PB7/PB14 (LEDs) and PB13
    (Ethernet RMII_TXD1).
    The inherited SPI_MODE2 default is explicitly marked as a placeholder,
    not a decision. The same AD7606 needed MODE0 on the Teensy and MODE2 on
    the ESP32-P4, s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
    [Ad7606c.cpp, Board.h]
2026-09-08 Programming works via external STLINK-V3; document the three traps
    The on-board ST-Link degraded during bring-up - dropping console
    characters, then refusing to enumerate at all. An external STLINK-V3
    works, but three non-obvious things had to be right.
    Wiring: CN6 with the CN2 jumpers FITTED. CN6 sits on the ST-Link side of
    those jumpers, so removing them isolates the MCU from CN6 as well as
    from the on-board debugger - the opposite of what "disconnect the broken
    debugger" suggests, and the single biggest time sink. VTREF must come
    from a real 3V3 rail: CN6 pin 1 is labelled VDD_TARGET but is a sense
    input for reading an external target's voltage, so it reads 0 V with
    nothing attached, cor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
2026-09-08 M2 on STM32: AD7606 reading correctly, and three silent-failure bugs
    The AD7606 reads both known signals correctly on the first attempt: V1
    swinging -1.2433 to +1.2216 against the +/-1.22 V scope output, and V8
    alternating 0.0107 to 2.0087 against the 0-2 V Hantek square. So
    SPI_MODE2 is correct on the STM32 as well as the P4 - it had been marked
    an unverified placeholder, and two known signals settled it without
    needing a sweep.
    M0, M1 and M2 are now verified on both targets.
    Three bugs found, all of which failed silently:
    program firmware.bin wrote nothing and reported success. A raw .bin
    carries no address information, so without an explicit 0x08000000
    OpenOCD does nothing while printi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
    [Ad7606c.h, main.cpp]
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2026-09-08 Rename to TritonECU; scope to the EEC-V modular family
    "ESP-ECU" stopped being accurate when the target moved from the ESP32 to
    the STM32F767, and the name was describing the processor rather than the
    job.
    TritonECU names the engine family instead, which is the more useful
    boundary: 4.6L and 5.4L 2V share the 36-1 crank trigger, the sensor set,
    the SCP bus and the 104-pin connector, so Mustangs and other EEC-V
    modular applications of the period are the same problem with a different
    calibration rather than a different project.
    Renamed rather than forked so the vehicle documentation, the design
    decisions and the history of what the factory schematics corrected all
    stay in one place. GitHub r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
2026-09-08 File the supercapacitor input idea as preliminary
    Not a decision - the LM5155-Q1 SEPIC remains the current design - but
    worth recording before the reasoning is lost.
    The SEPIC exists almost entirely to survive cranking, and everything
    expensive about it follows from working at low line: the magnetics, the
    Cs bank carrying 3.1 A rms, the 2.2 MHz switching chosen to clear the AM
    band, and the layout discipline that goes with putting that next to a
    16-bit ADC. A supercapacitor bank on the input of an ordinary buck
    removes the requirement rather than engineering around it, and covers
    every brownout source rather than just cranking.
    It also closes an open requirement from dropping the OEM's KAP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
2026-09-08 docs: record DGH504Q5R5 supercap findings, socketed as a wear part
    -40 C operating range confirmed from the datasheet, which resolves the open
    [CONFIRM] and disqualifies the SLA3R8O2060813 LIC (-20 C limit, plus it needs
    an over-discharge cutoff).
    Two findings that change the sizing:
    - 800 mohm DC ESR and a 0.6 A continuous rating make the part ESR-limited, not
    energy-limited. The 63 J / 40 s figure from the 20 F sketch does not scale
    down: a boost pulling from 2.0 V needs 0.75 A, past the rating. This part
    buys graceful shutdown (~1.7 s from 5.5 to 4.5 V), not crank ride-through --
    so it supports the KAPWR requirement but does not retire the SEPIC.
    - Working voltage derates to 4.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
2026-09-08 docs: FXU0H105ZF analysis, and the sizing check that closes the supercap idea
    KEMET FXU0H105ZF is the first properly automotive part looked at -- AEC-Q200
    rev E, IATF plant, PPAP, -40 to +105 C, 1000 h at 105 C and 1000 h 85/85. It
    beats the DGH on every qualification axis.
    It loses on ESR: 10 ohm max at 1 kHz against the DGH's 0.8 ohm DC. That is a
    category difference (memory-backup EDLC vs power EDLC), not a spread. Matched-
    load ceiling is 0.76 W new and 0.38 W aged, so a ~0.5 W shutdown draw has no
    margin; at 100 mA a fresh part drops 1.0 V across its own ESR.
    The useful find is KEMET's temperature-stability spec: at -40 C, capacitance
    falls to >=30% of initial and ESR rises to <=700%,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
2026-09-08 docs: correct the TVS finding -- the clamp does not reach the output
    The LTC4364 regulates OUT to 27 V, so everything past the pass FETs -- SENSE,
    OUT, C3-C7 and all three INA238 inputs -- is behind that. My claim that the
    96.8 V TVS clamp reached the INA238 was wrong; it sits at clamped potential,
    not battery potential, and 27 V against an 85 V common-mode limit is fine.
    For a fast pulse SOURCE is tied through a fully-on Q2 to 1120 uF, which holds
    it down more effectively than the TVS does.
    What is actually wrong with SMCJ60A is protection coordination, not exposure:
    it does nothing below 66.7 V and clamps at 96.8 V, so it only contributes in a
    band where the LTC4364 (80 V max) is already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
2026-09-08 docs: rewrite the POWER review against the LTC4364 datasheet design example
    Retracts the UV/OV finding entirely. The thresholds are 1.25 V, not the 500 mV
    I used. With 309k/162k/10k the divider gives 60.1 V OV and 3.50 V UV, exactly
    as intended, and follows the datasheet's own 10k worked example.
    Also corrects the TVS finding for the second time. The clamping architecture
    protects the IC by itself -- SOURCE, SENSE and OUT all sit at the regulated
    27 V during an overvoltage, and the datasheet states R4/D3 holds VCC below 71 V
    even for a 200 V input transient. The exposed node is Q1's drain, so the TVS
    clamp is set by Q1's VDS rating, not by anything on the LTC4364. 96.8 V against
    a 100 V FET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
2026-09-08 docs: PPTC trip time is the disqualifier, and correct the system input floor
    150 V rating confirmed, which matters upstream of the TVS -- but the 3 s trip
    time makes the position untenable. A PPTC is thermal; it does not interrupt.
    Under reverse battery, D1/D2 forward-conduct and the TVS sees roughly 10,800
    A^2s before the PPTC reacts, against an SMDJ36A's ~166 A^2s forward surge. The
    protector is destroyed 65x over before the protection acts. A 7.5 A blade fuse
    clears at ~20-40 A^2s, so it opens first -- that is the coordination that was
    missing.
    The current rating also fails in ordinary use, not only at fault: 0.6 A hold
    derates to ~0.31 A at 85 C, against 0.33 A of real running current a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
2026-09-08 docs: size the input fuse at 3 A and put it inline, not on the board
    Answers "why not just use the truck's fuse": OEM modules mostly have none, but
    this board differs on three counts. The LTC4364 already covers every sustained
    overcurrent, so the fuse only covers the protection itself failing -- pass FET
    short, and reverse battery where D1/D2 forward-conduct. For those, a 15-20 A
    PDB feed has a melting I^2t of roughly 150-300 A^2s against the SMDJ36A's
    ~166 A^2s forward surge, so relying on it to clear before the TVS dies is a
    coin flip. A 3 A fuse at 15-25 A^2s is not. A large fuse also cannot see a
    soft fault -- 4 A drawn continuously is invisible to a 20 A fuse.
    Corrects the earlier 7.5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
2026-09-08 docs: TVS standoff and OV threshold are one decision; stay unidirectional
    Corrects two earlier revisions that treated the TVS level as free to lower. It
    is not. The LTC4364 linearly clamps everything from 27 V to the OV threshold,
    and a TVS is a transient device -- put it in sustained conduction and it burns.
    With OV at 60 V, an SMCJ60A's 60 V standoff sits just above where the
    controller stops clamping and starts disconnecting, so nothing overlaps. That
    pairing was deliberate and correct. Dropping to 36 V while OV stays at 60 V
    would put the TVS in conduction for a stuck regulator or a 24 V jump start.
    Records the alternative pairing: OV 43 V with an SMCJ43A halves the FET's
    clamping dissi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
2026-09-08 docs: VREF PTC selection -- low-voltage part, and sense downstream of it
    The 150 V devices freed from the input are the right kind of part for the VREF
    backstop but the wrong rating, for the same reason they failed upstream: a
    120-150 V element needs a thick polymer body, and thickness is thermal mass, so
    they all trip in 8-16 s. VREF is a 5 V rail with no use for that rating; a 16 V
    part at ~100-150 mA hold trips in 0.1-0.5 s.
    More important than trip time: a PPTC is a thermistor by construction, so its
    resistance rises with current and ambient and roughly doubles after each trip.
    In series with a ratiometric reference that is not a calibratable offset -- 25
    mA through 3 ohm is 75 mV on 5.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
2026-09-08 docs: evaluate an 8 A thermal breaker -- bench yes, vehicle no
    Good for bring-up: resettable, 48 VDC interrupting is ample against a bench
    supply, and 8 A clears both the 0.33 A running load and the 5.6 A x 2.6 ms
    inrush. The LTC4364 is doing the real protection; the breaker is the recovery
    path when the bench work shorts something.
    Wrong for the vehicle for the same reason the PPTCs were. A bimetallic element
    has thermal mass, so the trip curve runs 0.1-1 s even at 1000% overload. Under
    reverse battery with D1/D2 forward-conducting at a harness-limited ~60 A that is
    roughly 1080 A^2s against the SMDJ36A's ~166 A^2s -- 6.5x over, and the TVS is
    destroyed before the breaker opens. The argume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
2026-09-08 docs: Schurter 3-101-231 (T9-817) -- bench part, disqualified for the vehicle
    Datasheet settles it on one line: allowable operating temperature is -5 C to
    +60 C (-5 to +50 C for the 4 A variant). A truck is outside that at both ends
    of an ordinary year. Schurter also states that automotive requirements to IATF
    16949 are available only by individual agreement, so the catalogue part is not
    automotive-qualified.
    Supporting, though not needed once temperature decides it: UL 1077 makes it a
    supplementary protector rather than branch-circuit protection; the trip curve
    bottoms at ~0.1 s even at 10x rated, so the ~60 A reverse-battery case is still
    roughly 1080 A^2s against the SMDJ36A's ~166 A^2s;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
2026-09-08 docs: decided -- no board fuse, truck PDB fusing is the branch protection
    Matches OEM practice: the EEC-V has no input fuse and neither do most Ford
    modules. A second series element only adds resistance at low line and an
    un-serviceable part inside a sealed box. The decision rests on the LTC4364
    being the actual protection -- 5.6 A limit, 5.4 ms shutdown -- with the series
    element only ever a backstop for the LTC4364 itself failing, which the PDB fuse
    fills.
    Records the consequence: under reverse battery the TVS forward-conducts and a
    20 A PDB fuse gives roughly 200 A^2s against the SMDJ36A's ~166 A^2s, so the
    TVS probably does not survive. Its failure mode is benign though -- a TVS fails
    s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
2026-09-08 docs: YJQ40G10A is 100 V -- validates the 43 V TVS, disqualifies it for Q1
    BVDSS = 100 V, so the SMDJ43A's 69.4 V clamp has 31% margin where the SMCJ60A's
    96.8 V would have had 3%. The TVS change was necessary, not a refinement.
    But the part is wrong for Q1, which runs in linear mode during clamping and
    current limit. Three independent reasons: no SOA curve is published at all, and
    a linear pass element cannot be verified without one; split-gate trench is a
    switching technology whose linear-mode SOA sits well below the thermal limit
    because current concentrates in the lowest-Vth cells, made worse here by a
    1.0-2.5 V threshold spread; and DFN 3.3x3.3 gives 30 C/W even for pulses up to
    10 s.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
2026-09-08 docs: set the current limit at 4 A -- RSNS 11 mohm, C8 300 nF
    Records why lowering the limit helps less than it appears. tOC must exceed the
    inrush time and inrush is C*V/ILIM, so short-circuit energy is 14 V x ILIM x
    tOC = constant at 0.42 J for any limit. Lowering the limit trades power for
    time. That still helps, because peak junction rise is P x Zth(t) and Zth goes
    as sqrt(t), giving dTj proportional to sqrt(ILIM) -- but 4 A only buys 15%, so
    Q1 still needs a published SOA curve in DPAK/D2PAK.
    What 4 A actually decides is the output rating. At the 4.4 V input floor, 12 W
    out needs 3.2 A and 18 W needs 4.8 A, so a 4 A limit is a decision to build a
    2 A supply -- which is what power-suppl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
2026-09-08 docs: decided 2 A at 6.0 V, recompute every dependent number
    Settled by the input side rather than the load. The rail tree already put the
    real internal draw at ~650 mA / 4 W from the 6 V rail, but what decided it is
    that schematic-review-power.md fixes the LTC4364 current limit at 4 A: at the
    4.4 V input floor a 12 W output needs 3.2 A of input current while 18 W needs
    4.8 A. 18 W does not fit behind a 4 A limit at low line. Raising the limit
    instead would have pushed the pass FET's short-circuit stress back up, and that
    is already the hardest part in the chain.
    Reran hardware/calc/sepic_lm5155.py at IOUT = 2.0 and updated every derived
    figure: switch+diode peak 6.96 -> 4.78 A, Cs ripple 3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
2026-09-08 docs: Q1 decided as IRF540NS, and C8 grows to 1.5 uF as a result
    The IRF540NS clears every criterion, starting with the one that disqualified
    the YJQ40G10A: it publishes an SOA curve (Fig 8, 100 us / 1 ms / 10 ms single
    pulse). Planar HEXFET rather than split-gate trench, so linear-mode behaviour is
    well characterised; 100 V against the 69.4 V clamp; D2Pak; Tj 175 C. Against the
    sizing case of 14 V x 4.1 A = 57 W for 10 ms it has more than an order of
    magnitude of margin.
    That headroom changes C8. With Q1 no longer the constraint, the timer can be set
    by the 400 ms ISO 7637 load dump -- the event the LTC4364 was chosen to ride out
    -- rather than by the FET's survival. 1.5 uF gives OV shutdo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
2026-09-08 docs: C8 to 2.2 uF ceramic -- tolerance now decides load-dump survival
    At 56 nF the capacitor's tolerance was irrelevant. At this size it sets whether
    the board rides out a load dump, so it has to be sized worst case. X7R stacks
    +/-10% part tolerance with +/-15% temperature coefficient, about -23%, which
    puts 1.5 uF at 312 ms against a 400 ms requirement. 2.2 uF gives 457 ms worst
    case, and the knock-ons stay comfortable on the IRF540NS: 54 ms OC shutdown
    (15x the inrush), 3.1 J short at 20 C junction rise, 44 ms early warning.
    Records that the part must be X7R or C0G, never tantalum or electrolytic: the
    TMR pin charges at 5 uA and tantalum leakage is specified in microamps, the same
    order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
2026-09-08 docs: gate drive checked -- 16 V maximum is the real constraint
    DGATE drive is 5 V min at VCC = 4 V and 10-16 V from VCC = 8-80 V. The maximum
    is what matters: most logic-level FETs are rated +/-12 or +/-16 V VGS, so a 16 V
    drive leaves zero margin and gate-oxide failure is a dead gate-source short.
    IRF540N is +/-20 V. Adds VGS(max) >= 20 V as an explicit selection criterion,
    since a "better" low-threshold part would have been the wrong answer here.
    The 5 V minimum is fine despite VGS(th) reaching 4.0 V, because the current is
    small: gfs is 21 S, so carrying 0.8 A in saturation needs 38 mV of overdrive and
    1 V is 26x that. Scaling RDS(on) gives roughly 310 mohm at 1 V overdrive, or
    0.5 V ac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
2026-09-08 docs: HGATE/DGATE absolute maximum is a constraint on external parts
    Abs max is SOURCE -0.3 V to SOURCE +10 V while the electrical characteristics
    give 12 V typ / 16 V max of drive. Not an error -- the standard pattern where
    absolute maxima apply to externally applied voltages and the internal charge
    pump is exempt. Flagged Note 3 to confirm the wording.
    Two consequences. The FET rating is still set by the 16 V drive maximum, so
    VGS(max) >= 20 V stands and the IRF540N is fine. And nothing external may force
    these pins: no gate-source Zener (a 12 V clamp fights the charge pump, a 10 V
    one prevents full enhancement), no pull-ups, and any slew capacitor must be
    HGATE-to-SOURCE rather than HGAT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
2026-09-08 docs: Note 3 confirmed -- SOURCE+10 V is the minimum clamp, not a ceiling
    Note 3 reads: internal clamps limit HGATE and DGATE to a minimum of 10 V above
    SOURCE, and driving them beyond the clamp may damage the device. So the
    absolute maximum is the guaranteed minimum clamp level rather than a limit on
    the part's own output; the charge pump runs to 12 V typical and 16 V maximum,
    and the rating restricts what may be applied externally.
    Confirms VGS(max) >= 20 V as the FET criterion, and sharpens why a slew
    capacitor would have to be HGATE-to-SOURCE: a ground-referenced one would hold
    the gate up while SOURCE fell, sourcing current into the internal clamp, which
    is precisely the damage mode th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
2026-09-08 docs: auto-retry confirmed -- copper is the fix, firmware is the supplement
    Retry duty cycle is fixed by the ratio of the two TMR currents, not by C8: both
    tOC and the cooldown scale with it identically, so duty stays at 4.3% and
    average dissipation in Q1 stays at 2.5 W. The only levers are Q1's thermal path
    or stopping the retries.
    Copper is the primary fix. A D2Pak at the datasheet's 40 C/W gives Tj = 185 C at
    85 C ambient, past the 175 C limit; the requirement is RthJA <= 36 C/W, and
    roughly 1 in^2 of 2 oz copper reaches 25-30 C/W for Tj around 147 C. Firmware
    cannot be primary because the motivating fault is a short on the LTC4364 output,
    which discharges Cout through the fault and take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
2026-09-08 docs: retract the FLT# startup-masking finding -- threshold is 1.25 V
    The pin description states FLT# asserts when TMR reaches 1.25 V. The 100 mV in
    the datasheet's CTMR = 1 ms x 5 uA / 100 mV is not a threshold at all -- it is
    the gap between the 1.25 V warning level and the 1.35 V shutdown level. I had
    read it as an absolute threshold and concluded inrush reached 90% of it on every
    key-on.
    Redone: during inrush TMR reaches 1.25 V in 50 ms against 3.6 ms of inrush, 7%
    of the way, 14x margin. No false assertion at boot and no masking required.
    The 44 ms early-warning figure was right, since C x 0.1 V / 5 uA is the correct
    formula for the warning-to-shutdown gap. Adds the overcurrent equiva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
2026-09-08 docs: ENOUT pull-up to VCC, but 100k not 10k
    VCC post-R4 is the better pull-up rail -- stable from power-up, already bounded
    by R4/D3, and not dependent on OUT's ramp the way an OUT-referenced pull-up
    would be. But while ENOUT is asserted low its pull-up current flows through the
    220 ohm R4 feed that section 2 shrank specifically to protect VCC headroom.
    10k, the right value for FLT# into a 3.3 V MCU, is wrong here twice over: it
    sinks 2.7 mA at the 27 V clamp against ENOUT's 2 mA rating, and costs 308 mV
    across R4. 100k sinks 270 uA and costs 31 mV. Worst case on a weak 5 V battery
    leaves VCC at 4.80 V against the 4 V minimum.
    The same resistor is naturally the top of the LM5155 EN divide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
2026-09-08 docs: ENOUT pull-up goes to VIN, not VCC -- corrects the previous revision
    VIN here is the LTC4364 OUT rail, the SEPIC's input. It is the better choice for
    the reason I had raised against my own VCC suggestion: VCC sits behind R4, so a
    pull-up there puts current through the 220 ohm feed that section 2 shrank
    specifically to protect VCC headroom. VIN loads R4 not at all. The argument for
    VCC -- stability from power-up while OUT ramps -- is worth nothing, because
    ENOUT holds the node low until OUT exceeds VCC - 0.7 V, by which point OUT is
    already at full rail.
    100k stands as the value: ENOUT sinks 2 mA maximum and the worst case is a
    key-on during a 27 V clamp, giving a 13.5k floor. 10k, cor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
2026-09-09 docs: always-on MCU domain -- sleeps on constant 3.3 V, 5 V rails on demand
    Records the architecture and what it removes. Graceful shutdown, the KAPWR
    replacement and the whole supercapacitor thread all disappear, since nothing
    collapses and RAM never loses power. It also undoes a conclusion in the power
    review: firmware retry-limiting was written off because the MCU loses its rail
    during the motivating fault, but with an always-on domain the MCU survives,
    counts retries, latches SHDN# and logs it. FLT#'s 44 ms warning likewise stops
    being a race against the MCU's own death.
    Parasitic drain is the deciding number and it works: ~780 uA total, or 0.56
    Ah/month against a ~70 Ah battery, roughl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
2026-09-09 docs: MAX25239AFFA evaluated, and it may replace the SEPIC too
    The part fits the always-on role well: H-bridge buck-boost with a single
    inductor, 2-36 V input, 2100 kHz for AM clearance, 95 uA no-load quiescent in
    skip mode, 5 uA in shutdown, spread spectrum, AEC-Q100 Grade 1.
    Two things to catch. AFFA's fixed output option is 5 V, not 3.3 V -- what makes
    it usable here is the adjustable column, which covers anything below 6.5 V, so
    it must be wired for adjustable mode. And its 42 V transient rating is below the
    SMDJ43A's 69.4 V clamp, so it must sit behind the LTC4364 rather than on raw
    B+; behind it, the 27 V clamp and the part's 2 V minimum both work.
    Drain budget revised to ~853 uA, 0.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
2026-09-09 docs: MAX25239 magnetics -- one 2.2 uH part covers both rails
    Worked the datasheet's Equations 1-3 at VIN_MAX = 27 V (the LTC4364 clamp) and
    VIN_MIN = 3.9 V (the input floor) with 40% ripple. Buck mode dominates both
    rails: 2.30 uH for 3.3 V at 1.5 A and 2.78 uH for 6.0 V at 2.0 A, against 0.22
    and 0.53 uH from the boost equation. Peak currents are 1.8 A and 3.6 A, so
    saturation ratings of 2.2 A and 4.3 A.
    A single 2.2 uH / 5 A part covers both, which is the same value the datasheet
    uses in its own 2.1 MHz application circuit -- roughly 4 x 4 x 3 mm. On the 6 V
    rail that replaces two 3.3 uH inductors above 3.1 A saturation plus the Cs bank
    at 2.1 A rms.
    Records the datasheet's warning not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
2026-09-09 docs: cascade architecture -- MAX25239 main rail, TLV62085 for 3.3 V
    Replaces the two-independent-rails sketch with a cascade: MAX25239 makes the
    main rail and the TLV62085 takes 3.3 V from it. Both stay powered when parked;
    the MCU's Standby mode does the saving.
    TLV62085RLTR is 2.5-6.0 V in, 3 A, 2.4 MHz DCS-Control, 17 uA quiescent, 0.7 uA
    in shutdown, with Power Save Mode, 100% duty capability and hiccup short-circuit
    protection, in a 2x2 mm VSON.
    Its 6.0 V input maximum collides with the 6 V main rail chosen for LDO headroom:
    6.0 V at +2% regulation is 6.12 V, over the rating. Set the main rail at 5.5 V
    instead -- 7% margin for the TLV62085, 0.5 V of headroom for the 5 V LDOs which
    is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
2026-09-09 docs: all-switched rails plus a 2.5 V ADC reference
    Dropping the LDOs removes the constraint that forced 6 V -- power-supply.md
    chose it purely for LDO headroom. So use the MAX25239AFFA's factory-trimmed
    fixed 5.0 V option: no feedback divider, and 18% input margin for the TLV62085
    against 7% at 5.5 V and a violation at 6.0 V.
    But two LDO jobs were not headroom. A harness short on VREF now pulls down the
    same rail feeding the AD7606 and both MAX9926s, so a chafed TPS wire would take
    out crank and cam conditioning and stop the engine -- use a current-limited load
    switch, which keeps the all-switched character while giving an electronic limit
    and a fault flag. And the analog/digital split bec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
2026-09-09 docs: retire the SEPIC, and simplify ENOUT to one resistor
    The MAX25239 plus TLV62085 arrangement leaves the LM5155-Q1 no role, so
    power-supply.md gets a status header marking the SEPIC sections superseded. Its
    input-chain content -- LTC4364, TVS, fusing -- and the reasoning behind the rail
    structure, current budget and EMC choices all carry forward unchanged.
    Retiring it removes the external 80 V MOSFET and Schottky, both 3.3 uH
    inductors, the Cs bank at 2.1 A rms, the SEPIC compensation and most of the
    2.2 MHz hot-loop layout problem, and drops the main rail from 6.0 V to 5.0 V
    since no LDOs need headroom.
    It also simplifies ENOUT. Section 9 of the schematic review specified a
    100k/61.9k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
2026-09-09 docs: defer Cp to the bench, and design in a loop-injection point
    Cp is not a critical value. With 5 pF of expected board stray, fitting 8.2 pF
    puts the second pole at 153 kHz for about 59 degrees of phase margin; 3.3 pF
    puts it at 244 kHz for 66 degrees; omitting it entirely gives 404 kHz and 69
    degrees with less HF rolloff on COMP. Seven degrees between the extremes and
    every option is well clear of 45, because the pole sits 3-8x above crossover in
    all cases. Fit 8.2 pF as the starting value on a 0402 footprint and swap to
    3.3 pF if the measured loop wants the pole back on target.
    Adds a design-for-test note while the board is still being drawn: what settles
    Cp is a Bode plot rather than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
2026-09-09 docs: enable SPS -- and SPS is a 2.2 V pin, tie it to VCC not 5 V
    Absolute maximum for VCC and SPS to AGND is -0.3 V to +2.2 V, and COMP and FB
    are rated to VCC + 0.3 V. So "tie SPS high" means the VCC pin, the internal
    ~1.8 V bias regulator with its 4.7 uF cap, not the 5 V rail. EN is the exception
    in this pinout at 42 V. Strapping SPS to 5 V destroys the part, and there is no
    rework on a flip-chip QFN.
    Enable it. The spread is 1.974-2.226 MHz, entirely above the AM band's 1.710 MHz
    top with 264 kHz to spare, and spread spectrum creates no energy below its lower
    edge -- so it costs nothing on the constraint that pushed the frequency to
    2.1 MHz, while taking 10-20 dB off peak emissions.
    It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
2026-09-09 docs: SYNC to AGND for skip mode -- and it is a 6 V pin, unlike SPS
    SPS and SYNC are adjacent strap pins with completely different ratings: SPS and
    VCC are -0.3 to +2.2 V while SYNC and PGOOD are -0.3 to +6 V. SYNC takes 3.3 V
    logic directly and needs no level shift; SPS must never see it.
    Tie SYNC to AGND, because the 95 uA standby figure the always-on architecture
    rests on is specified with VSYNC = 0 V. Forced PWM would give that up for
    nothing, since the part already runs fixed-frequency PWM under load and only
    skips once inductor current goes discontinuous -- the DCM boundary is 345 mA at
    13.8 V in, so only the key-on-engine-off case at 300-500 mA is ambiguous, and
    skip ripple there sti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
2026-09-09 docs: SYNC polarity is low-for-skip, and use adjustable FB not the fixed option
    Pin table settles SYNC: connect to AGND for skip mode, to VCC for PWM. So it
    starts and stays low, not high. But the startup instinct behind the question is
    right for another reason -- the MCU is powered by this converter, so at power-up
    its GPIO is high-impedance and SYNC would float through the whole startup. Fit a
    pull-down to AGND so skip mode is defined before the MCU exists; a push-pull
    GPIO overrides it later. SPS is the opposite case and must be a hard 0 ohm strap
    to VCC, never a GPIO, since it is a 2.2 V pin and 3.3 V would destroy it.
    The same pin table shows the fixed 5 V option is selected by tying F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
2026-09-09 docs: SYNC fitted as 10k pull-down plus GPIO override
    Records the arrangement and why it works. STM32 GPIOs go high-impedance in
    Standby, so the pull-down holds skip mode through the two states firmware cannot
    cover -- power-up before the MCU boots, and Standby while it sleeps. Those are
    exactly the states where the 95 uA quiescent matters, so the resistor does the
    load-bearing work and the GPIO is only an override for the running case. The
    330 uA the GPIO sources in PWM mode costs nothing in sleep.
    Also confirms 3.3 V is safe on SYNC: the pin is rated to 6 V against AGND rather
    than clamped to VCC, so exceeding the 1.8 V rail forward-biases nothing.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
2026-09-09 docs: ADR431BRZ decided -- COMP network required, and filter drops to 47 ohm
    Good part: 2.500 V at +/-1 mV, 3 ppm/degC, 3.5 uV p-p noise, 30 mA source.
    Answers the open stability question and adds a component I had not accounted
    for. The datasheet says a large output capacitor is not required for stability,
    but that microfarad-range capacitance is the right answer for driving an ADC
    reference input -- which is the AD7606 charge-kick case -- and that it causes
    noise peaking. The fix is an 82k plus 10 nF network on the COMP pin, which is
    easy to omit since the part works without it and the penalty is noise rather
    than oscillation. Fit 10 uF plus 100 nF at REFIN and 82k plus 10 nF on COMP.
    Al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
2026-09-09 docs: ADR4525BRZ-R7 supersedes the ADR431
    The ADR431 is better on tempco (3 vs 5 ppm/degC) and initial accuracy, but the
    ADR4525 wins on the two specs that matter here. Its 300 mV dropout puts VIN at
    2.8 V against the ADR431's 4.5 V, turning the tightest margin in the previous
    selection -- 256 mV against a worst-case 4.836 V rail -- into about 2 V. That in
    turn lets the input filter resistor grow from 47 to 470 ohm for 13 dB more
    rejection, since the drop no longer matters. And the SHDN pin removes the
    external load switch, with 16 uA typ / 33 uA max in sleep.
    Tempco is worse on paper and irrelevant in practice: 0.083% against 0.05% gain
    error over the full range, both far below anything th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
2026-09-09 docs: reference filter resistor 220 ohm, not 470
    Both are safe; 220 is better because 470 buys attenuation nobody needs at a cost
    in three things that are real. The reference's own noise is the floor: 6 ppm p-p
    low frequency, 178 nV/rtHz at 1 kHz, or 26 uV rms over the AD7606's 22 kHz. With
    8 mV of rail ripple at 2.1 MHz and only 20 dB assumed from the reference's own
    HF rejection, 47 ohm already puts the residual 260x below that floor, 220 ohm
    550x and 470 ohm 1200x. The filter stopped being the limiting factor two orders
    of magnitude ago.
    Against that, using the datasheet's real supply current of 580/765/950 uA rather
    than the 715 uA headline: 470 ohm drops 446 mV at max quiescent against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
2026-09-09 docs: MAX6070AAUT25 supersedes both the ADR431 and the ADR4525
    Better on every axis argued over in this section: +/-0.04% initial, 1.5 ppm/degC
    typ, 4.8 uV p-p noise, 130 typ / 260 max uA quiescent, 6 uA shutdown, 200 mV
    dropout, 85 dB ripple rejection, SOT23-6, and AEC-Q100 available.
    It also settles two open concerns outright. Capacitive-load stability is
    specified at 0.1-10 uF, where both previous parts were characterised only at
    0.1 uF and left the 10 uF at REFIN undocumented -- though 10 uF is at the top of
    the range, so 4.7 uF is safer if the AD7606 does not need the full value. And
    quiescent is 5x lower, which changes the sleep arithmetic before gating.
    Power it from 3.3 V rather th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
2026-09-09 docs: MAX6070 output capacitance -- 4.7 uF and 100 nF, both
    0.1 uF is the minimum of the specified stability range rather than a nominal, so
    100 nF alone puts the design on the boundary, and a 100 nF 0603 X7R at 2.5 V
    bias may fall under it. 4.7 uF plus 100 nF gives 4.8 uF, mid-range and well
    under the 10 uF ceiling.
    The two do different jobs: the bulk provides stability margin and the charge
    reservoir for the AD7606's SAR demand, the small cap covers the decade above the
    bulk part's self-resonance. The bulk is needed because a reference must hold
    within half an LSB during a conversion -- 7.6 ppm of 2.5 V, or 19 uV -- which is
    achievable in the microfarad range and not at 100 nF. Same reaso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
2026-09-09 docs: OUTS taps after the output caps -- and what that implies
    Correct use of the force/sense pair: OUTF carries current, OUTS senses at the
    load, and the reference regulates out the OUTF trace drop. Two consequences
    recorded. The OUTF trace is now inside the feedback loop, so the reference has
    to stay physically close to REFIN -- a 30 mm run is roughly 20 nH, which with
    4.8 uF resonates at 514 kHz, potentially inside the reference's own bandwidth.
    Target under 10 mm and tap OUTS at the capacitor node rather than partway along
    a trace carrying load current. The gain is small at ~100 uA of REFIN current,
    microvolts, but costs nothing and earns its keep if REFIN draws milliamps.
    Also notes th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
2026-09-09 docs: ADC daughterboard decided, and the one thing that decides whether it works
    Records the architecture and is honest about which argument carries it.
    Proximity does not -- the MAX6070's ~10 mm constraint to REFIN is solved by
    placement on a single board. What justifies it is analog ground plane control on
    a board that low-side switches eight ignition coils, where physical separation
    beats plane splits and guard traces because it does not depend on getting return
    paths right by inspection; and iteration, which carrier-board.md already argues
    for on the carrier, since the analog front end is where first-board mistakes are
    both most likely and most subtle.
    The trap is that a daughterboard b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
2026-09-09 docs: correct AD7606C to AD7606B throughout the build-facing references
    adc-front-end.md was headed "AD7606C-16" while its own verdict section concludes
    the opposite -- the ECU takes the B-series part at roughly $5.60 against $55,
    with the C-series reserved for the scope project, since the throughput analysis
    shows about 1% utilisation and the C's per-channel range selection is not needed
    in this configuration. The analysis was right and the title was wrong, and I
    propagated the wrong part number into adc-daughterboard.md when writing it up.
    Corrected in adc-front-end.md (title and build-facing references),
    adc-daughterboard.md, vref-supply.md and f150-1999-target.md. The AD7606C
    references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
2026-09-11 docs: English translation of the CH340 manual (v3C)
    Full translation of CH340X-Datasheet.pdf, which is the Chinese CH340 family
    manual (1) version 3C covering the whole CH340G/C/N/K/E/X/T/R/B range rather
    than the CH340X alone. All eight sections translated: overview, features,
    packages, the pin table, functional description including the CH340B EEPROM map
    and the section 5.3 DTR modes, all four parameter tables, and the nine
    application notes.
    Saved as CH340X-Datasheet-EN.pdf with the HTML source alongside so it can be
    re-rendered or corrected.
    Two limitations noted in the document itself. The schematic figures in sections
    7.1-7.9 are images in the original and are not reproduced -- the s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
2026-09-13 docs: review of the 2026-09-13 POWER sheets
    Most of the previous review landed: R1 220 ohm, C1 470 nF, the zener deleted,
    the 249k/86.6k/10k OV-UV divider, IRF540NS for Q2 with the YJQ40G10A kept as Q1,
    PPTCs removed, SPS strapped to VCC rather than 5 V, SYNC pulled down with
    M_SYNC brought out, PGOOD to 3.3 V on both converters, the 4 x 22 uF bank, and
    the BSS123 shutdown path.
    Three blocking findings. U11 is MAX25239AFFB, which is the 400 kHz variant --
    the A suffix is 2100 kHz. That puts the third and fourth harmonics at 1.2 and
    1.6 MHz, inside the AM band the frequency choice exists to avoid, and L2 at
    2.2 uH is the 2.1 MHz value, so at 400 kHz ripple would be 3.6 A pk-pk at 13.8 V
    in a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
2026-09-13 docs: POWER2 revision closes findings 1 and 2; POWER1 unchanged
    U11 is now MAX25239AFFA/VY+ at 2100 kHz, which puts the fundamental and every
    harmonic above the AM band and makes L2 at 2.2 uH the correct value again. R19
    is now 78.7 kohm, putting the error-amp zero back at 919 Hz against the 965 Hz
    power-stage pole.
    POWER1 is byte-identical to the reviewed version, so both findings on that sheet
    remain open: ENOUT still reaches U8 pin 8 at VIN potential on an otherwise 3.3 V
    header, and C7 is still 1.5 uF where 2.2 uF is needed to hold 400 ms of
    load-dump ride-through at worst-case X7R tolerance.
    Claude-Session: https://claude.ai/code/s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
2026-09-13 docs: power schematic passes review; README updated for the new supply
    All findings from schematic-review-power-v2.md are closed. POWER2 already had
    U11 changed to MAX25239AFFA (2100 kHz) and the compensation resistor corrected
    to 78.7 kohm. POWER1 now has C7 at 2.2 uF, and ENOUT reaches the MCU header
    through a BS170 level shifter as 3.3_ENOUT rather than at VIN potential.
    Designators on POWER2 were renumbered to clear the R15 collision the new part
    would have caused.
    The level shifter is the standard gate-to-low-rail topology and is oriented
    correctly: the body diode's anode is on the 3.3 V side, so with ENOUT high the
    FET is off and the MCU sees 3.3 V, and with ENOUT low the diode conduc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
2026-09-13 docs: pre-BOM and pre-layout notes for the power sheets
    Records what the 11 mohm shunt changes and what it does not. The limit becomes
    4.09 A and inrush 3.63 ms, against a 54 ms fault timer, so C7 stays at 2.2 uF --
    it was sized by the 400 ms load dump rather than by inrush. Q1's short-circuit
    case improves to 57 W and about 20 C of junction rise.
    Specifies the shunt itself: 1% tolerance since it sets the current limit
    directly, 100 ppm/degC or better since it also sets the INA238's accuracy,
    0.25 W minimum, and 4-terminal if available. And records that the INA238 needs
    ADCRANGE = 0, since at 11 mohm the narrow range saturates at 3.72 A, below the
    4.09 A limit -- which would break the FLT#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
2026-09-13 docs: shunt sizing -- keep the 1 W part, but not for its wattage
    Power dissipation is not what sizes this resistor: 1.2 mW running, 113 mW at
    2 A out from the 4.4 V floor, and 184 mW at the 4.09 A limit which the LTC4364
    holds for only 54 ms. A 1 W part is about 5x the absolute peak.
    Keep it anyway. Tolerance sets the current limit directly, TCR sets the INA238's
    battery-current accuracy as well as the trip point, and 2512 leaves room to
    bring both sense pairs off the inner pad edges where 4-terminal parts also
    start. TCR is the one worth spending on: a thick-film 1206 at 200 ppm/degC
    drifts 3.3% over the temperature range against 0.25-0.8% for a metal-element
    2512 at 15-50 ppm/degC. Self-h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
2026-09-13 docs: shunt settled at 10 mohm, 1 W, 2512
    The datasheet's own value, moved from 1206 to 2512 for Kelvin routing room.
    Everything downstream holds: 4.50 A limit, 3.3 ms inrush against the 54 ms fault
    timer so C7 stays at 2.2 uF, 63 W of Q1 short-circuit stress for about 22 C of
    junction rise, and 203 mW in the shunt at roughly 20% of a 1 W rating. INA238
    still needs ADCRANGE = 0, giving 16.4 A full scale at 0.50 mA per LSB.
    The package change earns its keep twice over: besides the routing room, thick-
    film 1206 shunts are typically 200 ppm/degC, which would have put 3.3% of drift
    into both the current-limit trip point and the reported battery current across
    the temperature range.
    Co-Authore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
2026-09-13 docs: BOM and Gerber review for POWER V1
    Board is 76.58 x 46.74 mm, 4 layer, 97 vias. Measured from the flying-probe
    netlist and by computing copper polygon areas rather than reading a render.
    Confirmed good: the COMP network is 1.3 mm and 1.9 mm from the pin, which is
    what a 3.3 pF Cp needs; the LTC4364 and INA238 sit 4.1-7.6 mm from the shunt
    with correct polarity. Kelvin trace geometry cannot be seen in Gerbers and needs
    checking in the editor -- at 4.5 A, 1 mohm of shared power copper is 10% of the
    current limit.
    Q2's tab sits in 214.6 mm^2 of top copper, 0.33 in^2, with zero thermal vias
    within 8 mm. Against the unlimited auto-retry case that needs 33 C/W and 0.33
    in^2 gives 40-50. Bu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
    [Triton_ECU_BOM_POWER_Power_V_1.csv]
2026-09-13 docs: V_1 revision check -- footprint finding retracted, Q2 vias still absent
    Retracts the MAX25239 footprint concern. Checking the actual pad geometry rather
    than the footprint name shows 20 pads is correct: PGND1 (5,6) and PGND2 (9,10)
    are each merged into one 1.31 x 1.56 mm pad, which is standard QFN practice for
    adjacent same-net bumps, and the wide pads share rows and vertical extents with
    their neighbours at 0.26 mm clearance. All 20 net assignments verified correct.
    Fixed in this export: Q3 and Q4 are both BSS123, deleting a BOM line, and
    InnerLayer2 is poured where it previously had zero filled regions.
    Routing and placement are otherwise unchanged -- top-layer draws 4543 to 4530,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
    [Triton_ECU_BOM_POWER_Power_V_1.csv]
2026-09-13 docs: datasheet confirms the MAX25239 pin grouping; records the land pattern number
    The pin table groups pins 5,6 as PGND1 and 9,10 as PGND2 -- exactly the pairs
    the footprint merges into single lands -- which supports the retraction. SUP
    (2,3) and OUT (12,13) are grouped the same way but left as separate pads, a
    choice rather than an inconsistency.
    Records the definitive references for anyone wanting certainty before ordering:
    package code F224A4FY+1, outline 21-100399, land pattern 90-100137. Worth
    checking purely because a flip-chip QFN is unrecoverable if the land pattern is
    wrong.
    Also records the part's thermal figures, which had never been checked: 33.3 C/W
    junction-to-ambient on a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
2026-09-13 docs: gerber rev 2 stitched Q1 rather than Q2
    Diffed the exports: 6 vias added and 2 removed, 97 to 101. Four of the new ones
    sit 0.7 mm from Q1's drain pads on net IN+. Q2's tab still has zero vias within
    8 mm and its top-layer B+ copper is unchanged at 214.6 mm^2.
    The designators are easy to transpose but the two FETs do opposite jobs. Q1 is
    the YJQ40G10A ideal-diode FET on DGATE -- fully on or fully off, never linear,
    dissipating about 1.6 mW, so it has no thermal problem to solve. Q2 is the
    IRF540NS on HGATE, which runs in linear mode during clamping and current limit
    and averages 2.74 W under auto-retry. Q1's drain is at (31.68, ~10.6); Q2's tab
    is at (13.93, 32.92), at the far left of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
2026-09-13 docs: BLOCKING -- the shunt datasheet describes a jumper series, not 10 mohm
    FRM252WJR010TN was flagged earlier only for its J tolerance code. The datasheet
    is worse than that: it is the "FRM-Jumper Series -- Zero milli-ohm (Jumper)
    Metal alloy Chip Resistor", and four independent statements put the whole series
    below 0.2 mohm. The electrical characteristics table gives 2512 2 W as
    "Resistance (mOhm) < 0.20"; every performance spec quotes "0603: <=0.3 mOhm,
    Others: <=0.2 mOhm"; and the part-number key defines only "R000 = Below
    0.2 mOhm". There is also no TCR specification anywhere, which is consistent with
    a jumper and disqualifying for a sense element.
    The number decodes as FOJAN / Resist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
2026-09-13 docs: shunt resolved -- FPM series is a real current-sense part
    FPM253WJR010TM replaces FRM252WJR010TN and answers everything the jumper-series
    datasheet raised. The FPM 2512 covers 1-100 mohm so 10 mohm is in range,
    specifies TCR at +-50 ppm/degC where the FRM specified none, uses CuMn manganin
    rather than NiCu, carries 3 W at 70 C with 38 A rated and 86 A overload, runs
    -55 to +170 C, states low inductance, and is AEC-Q200 compliant -- which makes
    it one of the few automotive-qualified parts in the rail chain alongside the
    LTC4364 and MAX25239. The datasheet also has a resistance measurement point
    section, which is the Kelvin-probe guidance the layout item needs.
    One change left: the chos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
    [Triton_ECU_BOM_POWER_Power_V_1.csv]
2026-09-13 docs: output caps resolved -- 1206 X7R 16 V lands on the design assumption
    HGC1206R7226K160NSPJ decodes as 1206, X7R, 22 uF, +-10%, 16 V, Cu/Ni/Sn
    termination, 1.6 mm thick. It fixes both variables at once -- bigger case and
    higher rating -- while keeping X7R at +125 C, which was the thing to protect,
    since 22 uF at 16 V in 0805 would have meant X5R at +85 C.
    Estimated effective capacitance goes from 36-44 uF to 57-66 uF for four parts,
    landing on the 66 uF the compensation assumes, so crossover returns to about
    51 kHz and fZRHP/5. The +-10% tolerance is irrelevant against DC bias, since the
    loop moves only about 7 degrees across a 2x capacitance range.
    Three things to know. Height goes fr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
2026-09-13 docs: add 100 nF at the MAX25239 OUT pins, not 4.7 or 10 uF
    Moving the output bank to 1206 created a gap 0805 did not have. At about 15 uF
    effective and 1.2 nH of ESL the 1206 parts self-resonate near 1.19 MHz, below
    the 2.1 MHz fundamental, so the bank is inductive exactly where the converter
    switches. That costs little in ripple -- 0.34 A rms through 4 mohm is 1.4 mV --
    but matters at the nanosecond edges, where 0.3 nH of bank ESL against a 2 A
    transition in 10 ns is a 60 mV spike. The input side does not share the problem
    because the 4.7 uF 0603 parts resonate near 4.3 MHz, above the fundamental.
    Specifies 100 nF rather than 4.7 or 10 uF because of anti-resonance against the
    bank's ESL: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
2026-09-13 docs: closeout -- L2 confirmed, L1 retracted, TVS reduced to one
    L2 (CYA0650-2R2M) is comfortably specified: 10.0 A saturation against the 4.3 A
    needed, 9.5 A heat rating against a 3.6 A peak, 11.2 mohm DCR for 130 mW at the
    boost corner, and 7.2 x 6.6 mm matching the footprint. The +-20% tolerance costs
    25% more ripple at one end and drops the RHP zero from 255 to 213 kHz at the
    other, worth a couple of degrees of phase margin.
    Retracts the L1 concern. TI's recommended-inductor table for the TLV62085 lists
    0.47 uH twice out of three entries, and CR4015-R50N is 500 nH in the same 4 x 4
    package as the first. The 0.94 A pk-pk ripple is real but normal for
    DCS-Control, which is fixed-on-time r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
    [Triton_ECU_BOM_POWER_Power_V_1.csv]
2026-09-13 docs: power board V1 complete -- README updated
    Schematic, BOM and Gerbers all reviewed with no outstanding board or BOM
    changes. 76.58 x 46.74 mm, 4 layer. Adds a Power board V1 row to the status
    table and points at review-power-v1-bom-gerbers.md, which was measured out of
    the copper polygons and the flying-probe netlist rather than read off a render.
    Fills in the rail table with what actually got built: the IRF540NS pass element
    with 20 tented vias into 1.14 in^2 of B+ copper, the MAX25239AFFA at 2.1 MHz
    with 2.2 uH, the TLV62085 with 500 nH, and the INA238 on a 10 mohm 1% 50 ppm
    shunt.
    Adds a decisions entry for the shunt, since it is the one part whose tolerance
    and TCR set two indepen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
2026-09-13 docs: VR board revision -- 0805 fitted, resistance halved, filter moved
    The blocking item is fixed: input legs are now 0805 (ARG05DTC5001), with 1 uF
    added to each VCC and 470 pF C0G 200 V filter caps, which is a good part choice.
    But the resistance halved too. The recommendation was 2 x 5 kohm in series per
    leg for 10 kohm at 300 V; what was fitted is one 5 kohm per leg, 5 kohm at
    150 V. Electrically that is fine -- the binding spec is the datasheet's +-40 mA
    absolute maximum input current, and 5 kohm gives 18.9 mA at a 100 V peak. The
    0805's 150 V rating runs out first, at about 155 V of VR peak. Lower series
    resistance also raises input gain, which helps cranking sensitivity, and Mode
    A2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
    [TritonECU_VR_Schematic_V_1.csv]
2026-09-13 docs: VR board complete -- 10 nF fitted, BIAS confirmed by datasheet Figure 3
    The 10 nF is in as C2/C7 in 0201, giving each MAX9926 the 10 nF / 100 nF / 1 uF
    trio the datasheet asks for, in ascending package size so the lowest-ESL part is
    the one that sits closest.
    BIAS grounded is confirmed correct by datasheet Figure 3, "MAX9924/MAX9926
    Operating Mode A2", which shows BIAS tied straight to ground alongside ZERO_EN
    and INT_THRS with EXT unconnected. The general pin description about an external
    resistor-divider applies to Modes A1, B and C, as the Bias Reference section
    says explicitly. vr-conditioning.md already had this right and the review
    second-guessed it against the general pin descr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
    [TritonECU_VR_Schematic_V_1.csv]
2026-09-13 docs: VR board V1 complete -- README updated
    Adds a VR board V1 row to the status table: 4 channels from two MAX9926 in Mode
    A2, reviewed clean and ready to fab at 35.43 x 33.91 mm. M3 moves from "needs a
    MAX9926" to "VR board designed, awaiting build".
    Replaces the single-board hardware note with a table covering both boards and
    their reviews, and records that the schematics, BOMs and Gerbers in
    docs/Schematics are the fab outputs under version control rather than pictures
    of them. Notes that both reviews were measured out of the Gerbers -- copper
    polygon areas, via positions, pad geometry and the flying-probe netlist -- which
    is how the MAX25239 footprint, Q2's thermal path and the output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
2026-09-14 docs: CKP/CMP sensor connectors -- 3U2Z145411SMA, and wire CMP return to VR2-
    Records the ordered Motorcraft 3U2Z145411SMA pigtail. One part number covering
    both sensors confirms that CKP and CMP share a 2-cavity connector, which means
    both are two-wire VR sensors.
    That resolves the "single-ended CMP" question usefully. Pin 85 being a lone CMP+
    with no matching CMP- does not mean the sensor has one wire -- it means the
    second wire lands on the PCM's shared sensor ground rather than a dedicated pin,
    a compromise made to save a PCM pin. There is no reason to inherit it: route the
    CMP return to VR2- rather than board ground, and the MAX9926's differential
    input works on both channels instead o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
2026-09-14 docs: EEC-V terminal part numbers and wedgelock handling
    Records E7EB-14487-AA female and E6DZ-14487-AA male, with 33088-0009 flagged for
    confirmation. The female is what repinning the truck's harness needs, since the
    PCM presents a male header and the harness carries sockets. The male matters
    more than it appears: it is the terminal for the mating side, which is the
    unsolved 104-pin sourcing problem at the top of this document, so if the
    board-side connector ends up built rather than bought, E6DZ is what populates it.
    Warns that wedgelock is a secondary lock and nothing extracts while it is
    seated. Forcing it damages the tangs or the cavity, and a damaged cavity does not
    reliably retain a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
2026-09-14 docs: can the board-side EEC-V connector be printed?
    Assesses printing the 104-pin housing now that male terminals are in hand.
    Harder than it looks: terminal-to-cavity clearance is around +-0.1 mm, and every
    filament overshoots that across a ~100 mm body -- PETG at 0.4 mm, ABS at
    0.5-0.8, and nylon, the one with the right service temperature, at 1-2 mm while
    also being hygroscopic and warp-prone. Scale compensation fixes the systematic
    part but not repeatability, and FDM does not hold +-0.1 mm over 100 mm. Primary
    lock ledges would also land on layer boundaries, weak in exactly the direction
    the tang loads them, and a terminal backing out under vibration is the
    intermittent this project can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
2026-09-14 docs: connector sourcing resolved -- Ranger EEC-V donor
    A damaged Ranger EEC-V is the donor. The 104-pin shell spans the EEC-V
    generation, and the pinout differing does not matter since what is reused is the
    shell and pin field rather than the application's circuit assignment.
    Flags the one real risk: Ford varies the polarising key between applications
    specifically so a PCM from one vehicle cannot be plugged into another. Same
    shell, different key. Offer the donor up to the F-150 harness connector before
    spending any effort on it -- that is worth knowing on day one rather than after
    it has been desoldered and a footprint built around it. Keys can usually be
    removed, at the cost of the anti-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
2026-09-14 docs: TE controlled drawing 770750-1 -- the board-side connector, with footprint
    ENG_CD_770750_C.pdf is Tyco/TE customer drawing C-770750 rev C, 26 AUG 2009,
    "SLEEVE ASSEMBLY, WIRE CONNECTOR FEMALE", part 770750-1. It is the board-side
    connector and it changes two things.
    First, a TE part number on a drawing revised in 2009 is a catalogue part rather
    than a discontinued Ford service item, so 770750-1 should be checked at TE,
    DigiKey and Mouser before committing to salvage. If orderable, the sourcing
    problem disappears and the Ranger donor becomes a spare and fit-check.
    Second, the drawing carries a complete recommended PCB layout: 104 positions as
    four rows of 26, Ø1.40 +-0.05 pin holes,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
2026-09-14 docs: 770750-1 is EOL -- stockpile donors, do not add an interface board
    EOL does not touch the drawing: geometry, tolerances and the recommended PCB
    layout are properties of the part rather than its availability, so the footprint
    still comes from C-770750 and the donor matches it. What changes is that salvage
    is now the supply rather than a fallback, which makes the Ranger purchase the
    right call.
    Records two practical responses. Buy two or three spare donors now, since dead
    EEC-V PCMs are cheap and plentiful and that curve only goes one way. And get a
    desoldering gun before the first extraction -- a 104-pin through-hole part is
    routine and repeatable with one, perhaps an hour, where braid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
2026-09-14 docs: retract the CMP repin -- both VR channels already reach the connector
    Design principle decided: keep the factory harness unmodified and reference
    everything the way we want inside the ECU. That makes the earlier repinning
    recommendation unnecessary, and it was based on a wrong assumption.
    Checked against eec-v-pinout.md: CKP arrives as a dedicated pair on cavities 21
    (DK BLU) and 22 (GRY), and CMP arrives as signal on 85 (DK GRN) with its return
    on 91, the shared SGND sensor ground (GRY/RED). The CMP return was never
    missing; it simply lands in a shared cavity rather than a dedicated CMP- pin. So
    VR1+/- take 21/22 and VR2+/- take 85/91 with no terminal moved, since pin 91 can
    feed bot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
2026-09-14 hardware: add the cam channel to the VR rig -- gear driven, adjustable phase
    Yes to including CMP, because the crank/cam relationship is the thing that
    cannot be tested any other way. Crank sync gives position within a revolution;
    cam sync gives which revolution, and everything sequential depends on that.
    Two signal generators can each produce a correct waveform but not one
    mechanically phase-locked to the other with real jitter and drift. Building the
    rig crank-only means building it twice, since sensors-to-run.md already records
    CMP as mandatory with coil-on-plug and sequential injection.
    Gears are the right call, but for a better reason than slippage: a properly
    tensioned GT2 belt does n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
    [vr_rig.scad]
2026-09-14 docs: CMP is VR -- the two-cavity connector settles it, plus bench notes
    The open [CONFIRM] on whether CMP is Hall or VR is effectively resolved by the
    connector. Motorcraft 3U2Z145411SMA covers both sensors and has two cavities; a
    three-wire Hall cannot fit in two, and the same connector serves CKP, which is
    unambiguously VR on pins 21/22. The lone "CMP+" at pin 85 reflects the PCM
    sharing sensor ground rather than the sensor having one wire.
    Records the thirty-second confirmation for when the sensor arrives: resistance
    across the two pins, where a VR coil reads a few hundred ohms to about 2 kohm
    and a Hall device does not present a sensible resistance. That value is also the
    source impeda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
2026-09-14 docs: README -- VR rig, sensors ordered, connector sourcing resolved
    Status table updated: the VR board is fabricating, CKP and CMP sensors and both
    pigtails are ordered, the VR test rig is designed, and EEC-V connector sourcing
    is solved via the Ranger donor plus the TE controlled drawing. M3 and M4 both
    move from waiting on parts to waiting on delivery.
    Adds two decisions worth knowing. Leave the factory harness alone -- every
    referencing question is answered by PCB routing rather than by moving wires,
    since the board defines what each of the 104 cavities connects to, and an
    unmodified harness stays diagnosable by anyone with a Ford wiring diagram while
    the PCB is the half that can be rev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
2026-09-14 hardware: keyway is inline with the gap, and the offset that must not leak
    The ordered wheel has its keyway inline with the missing tooth, so the rig's
    gap-to-TDC offset is zero by construction and needs no measurement. key_to_gap
    records it, and wheel_hub() cuts an index flute in the flange OD at that angle --
    once the wheel is on, the teeth all look alike and the gap is hard to find by
    eye, so the flute gives the assembled rig a visible angular zero to home the
    stepper against. The stepper drives 1:1, so commanded steps are then known crank
    angles and the decoder can be checked on absolute position.
    Records the trap that follows. The wheel is made gap-at-TDC because that is the
    convention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
    [vr_rig.scad]
2026-09-14 hardware: truck timed to the same datum -- the rig becomes a calibration bench
    Measured on the engine: the factory 5.4L also puts the gap at TDC #1, so rig and
    truck share one datum and CKP_GAP_TO_TDC_DEG is zero for both. Replaces the
    earlier section warning that the truck's offset was non-zero and unmeasured.
    The constant stays named rather than folded away, because the decoder needs
    somewhere to carry the sensor and conditioner offsets, which are not zero.
    The consequence is larger than a skipped calibration step: because the rig's
    absolute angle now is the engine's absolute angle, bench measurements transfer
    directly, so the rig calibrates the truck's timing without an engine running.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
2026-09-14 hardware: involute spur gears, stepper selection, and a rig BOM
    Adds spur_gear(z) generating real involute teeth with no library, so the rig can
    start on printed gears and move to bought steel later without changing anything.
    The flank is inv(acos(rb/r)) offset to cross the pitch circle at half a tooth,
    running radially below the base circle -- correct here because at 20 degrees PA
    the root is inside the base circle for z < 41 and both gears qualify. Verified
    20T clears the undercut limit of 17.1 teeth so no profile shift is needed, and
    tip thicknesses are 1.39 and 1.52 mm rather than knife edges. The clamp slit
    stops at the gear face so it never cuts a tooth.
    Module is 2, not 1: at module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
    [vr_rig.scad]
2026-09-14 hardware: STLs, a real key, and a counterweight for the cam trigger bolt
    Renders all eight parts on OpenSCAD 2021.01, clean, and commits binary STLs plus
    render.sh. Gear geometry verified numerically rather than by eye: tip radii
    22.000 and 42.000 mm, 20 and 40 teeth, 18.000 and 9.000 degree pitch, bounding
    boxes matching intent to 0.02 mm.
    Fixes a bug the render check caught: the hub key was not a key. It spanned
    wheel_bore/2 - key_d to wheel_bore/2, which is inside the spigot, so it stood
    proud by 0.13 mm and would have engaged nothing. A key runs outward from the
    spigot surface into the slot cut in the wheel's bore. Now 3.33 mm proud as DIN
    6885 wants on a 24 mm bore.
    Adds a counterweig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
    [base.stl, bearing_block.stl, cam_gear.stl, cam_target.stl, crank_gear.stl, motor_mount.stl, sensor_mount.stl, vr_rig.scad]
2026-09-14 hardware: size the counterweight pocket to real rod stock, not to its own volume
    Corrects a sizing error. The pocket bore was 14 mm and the BOM called for 13 mm
    rod, which would rattle on a 0.5 mm annular gap, and the "fills it exactly, 101%"
    figure came from the pocket's own volume rather than from any rod that fits in
    it. A rod can never reach that number.
    Pocket is now 14.4 mm bore, a slip fit on 14 mm rod stock, and 21 mm deep --
    deliberately deeper than needed so the rod is cut to length to balance rather
    than trusted to arithmetic. Capacity is 29 g brass or 39 g lead against a job
    needing about 20 g, so both materials reach balance and the choice is free on
    capacity. Brass is the reco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
    [base.stl, cam_gear.stl, cam_target.stl, crank_gear.stl, motor_mount.stl, sensor_mount.stl, vr_rig.scad, wheel_hub.stl]
2026-09-14 hardware: fit the counterweight pocket to 13 mm rod, and use the spare as a gauge
    The bore follows the rod rather than the other way round: a printed pocket is a
    one-line parameter and bought stock is bought. Pocket goes to 13.4 mm bore with a
    19.4 mm boss, spanning r 9.8 to 29.2 inside the 30 mm rim, verified at 30.00 mm
    max radius so it still cannot reach across the air gap. Capacity is 25 g brass or
    34 g lead against a job needing about 20 g, so both materials still reach
    balance. Expected rod length is about 18 mm of 13 mm stock, with the printed boss
    contributing 88 g.mm of the 480 on its own.
    Records the swap back to 14 mm as a two-parameter change for anyone starting from
    different s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
    [base.stl, cam_gear.stl, cam_target.stl, crank_gear.stl, sensor_mount.stl, vr_rig.scad, wheel_hub.stl]
2026-09-14 hardware: 12 mm shafts, and stiffen the part that was actually limiting
    Shaft goes 8 to 12 mm on 6001-2RS bearings, which is 5.1x the bending stiffness
    since EI goes as d^4. But the shaft was never the soft part: the printed bearing
    upright measured EI 24.6 N.m^2 against the 8 mm shaft's 40.2, so the bracket was
    below even the old shaft and eight times below a 12 mm one. Stiffening the shaft
    alone would have moved almost nothing.
    Three changes to the bracket, all free. shaft_h was wheel_od/2 + 12 = 87, which
    lifted the wheel clear of the base and left the wheel slot doing nothing; at 60
    the wheel runs through the slot as intended and tip stiffness goes as 1/h^3, so
    2.4x for nothing but a nu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
    [TritonECU_VR_Schematic_V_1.csv, TritonECU_VR_Schematic_V_1.xlsx, base.stl, bearing_block.stl, cam_gear.stl, cam_target.stl, crank_gear.stl, motor_mount.stl]
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2026-09-14 docs: correct the LM1815 assessment against its datasheet
    Retracts an unfounded claim. The previous revision listed likely obsolescence as
    a reason against the LM1815; TI publishes it as PRODUCTION DATA, SNOSBU8F revised
    March 2013, with a live product folder. Lifecycle should be confirmed as for any
    part, but obsolescence was wrong to assert and is removed from the list.
    Corrects an understatement. The LM1815 arms on an adaptive 80 percent peak
    threshold but triggers on the negative-going zero crossing, specified at 0 mV
    typical and plus or minus 25 mV worst case. That is the true tooth reference,
    since a VR sensor outputs dPhi/dt and crosses zero with the tooth centred on the
    pole, and it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
2026-09-14 docs: correct the MAX9926 trigger mechanism -- Mode A2 does use zero crossing
    Resolves the VERIFY flag with the datasheet now in the repo. Table 1: Mode A2 is
    ZERO_EN = GND, INT_THRS = GND, giving zero crossing ENABLED and adaptive peak
    threshold ENABLED. Both blocks are live.
    Corrects a mistake repeated in three places. This repo stated the Mode A2
    comparator switched at one third of the previous peak. It does not: 33 percent is
    the ARMING threshold, and the output edge comes from the zero-crossing detector at
    -6.5 / +10 mV. The consequence matters, because it is the opposite of what was
    recorded: the trigger point is the tooth centre and nothing moves it, so there is
    no amplitude- or acce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
2026-09-14 docs: README — VR trigger mechanism, LM1815 comparison, rig status
    Updates the VR test rig status to designed, rendered and costed, linking the STLs
    and BOM now in the repo.
    Adds four decisions worth knowing. That the VR trigger point needs no calibration
    term, since Mode A2 arms on 33 percent of previous peak but triggers on the zero
    crossing, which is the tooth centre and cannot be moved by amplitude, rpm or
    acceleration -- noting this repo had it wrong in three places. That the MAX9926 is
    chosen over the LM1815 on arming margin, 33 against 80 percent, tolerating a 3:1
    amplitude collapse between teeth where the LM1815 tolerates 1.25:1, which is what
    cranking does. That keyway to missing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
2026-09-14 docs: knock channel — the differential front end is common to both routes
    Refreshes a section that had gone stale, referring to "the P4" and the AD7606C
    when the design is an STM32F767ZI and an AD7606B.
    Records the constraint that decides the architecture: the knock sensor on this
    truck is a two-wire differential piezo on pins 57 and 32, while HIP9011 and
    TPIC8101 class ICs present single-ended ground-referenced inputs. That is the
    same mismatch the MAX9926 solved for the VR channels -- grounding one leg of a
    floating source puts sensor-ground to board-ground noise into the signal, on a
    charge source looking for microvolts of ringing with eight coils firing nearby.
    A differential charge a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
2026-09-14 docs: knock front end -- differential charge amp, TLV9064-Q1, and why not to share it
    Adds docs/knock-front-end.md for the build following the VR board.
    Records why charge mode rather than voltage mode: the piezo is a roughly 1 nF
    source, 26.5 kOhm at 6 kHz, at the end of a metre or two of harness. Read as a
    voltage, cable capacitance divides the signal and the error changes if the loom is
    rerouted; read as charge, both terminals sit at virtual ground so cable
    capacitance sees no swing and contributes nothing.
    Answers the quad question in both directions. Yes to a quad, because the chain
    needs exactly four amplifiers -- two charge amps, a difference stage, and a buffer
    for the existing 2.5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
2026-09-14 docs: knock front end schematic, net list and BOM
    Adds docs/Schematics/knock-front-end-schematic.md -- an ASCII schematic, a full
    net list by reference designator, a BOM with dielectrics and tolerances, and
    layout notes, ready to transcribe into the main board.
    Takes up the decision to give this block its own 2.5 V reference rather than
    sharing the ADC's, and records that it does not free the fourth amplifier. The
    buffer was never only about loading: A3's reference leg is one arm of a resistor
    bridge and CMRR depends on that bridge staying balanced, so driving R8 from the
    reference IC directly would put its output impedance in series with one arm and
    unbalance it.
    Carries forward the MAX60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
2026-09-14 docs: README — knock front end status and decisions
    Adds the knock front end to the status table as the next build after the VR
    board, linking the schematic, net list and BOM.
    Extends the knock decision entry to record that one TLV9064-Q1 quad holds the
    whole chain, and adds two more. That charge mode is chosen because the harness
    moves: read as a voltage, 100 pF of loom against a 1 nF sensor is a 10 percent
    error that changes if the harness is rerouted, while read as charge both
    terminals sit at virtual ground and the cable sees no swing -- which also makes
    the feedback caps the calibration, hence C0G rather than X7R. And that analog
    blocks get their own references, with the note that a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
2026-09-14 docs: ECU location confirmed -- cabin, behind the glovebox
    Resolves the open CONFIRM carried in the ADC notes and consolidated into
    enclosure.md. The ECU mounts in the cabin on the upper right-hand side behind the
    glovebox, matching the OEM PCM, confirmed by the owner.
    The temperature constraint lifts: the 200 kSPS ADC option at -40 to +85 C is no
    longer ruled out. The AD7606B already specified reaches 125 C and is a
    populate-different-part change either way, so there is no reason to move, but the
    constraint no longer applies. The barometric choice was never constrained since
    the KP497 reaches 105 C.
    The vent siting concern is satisfied by the location, which sees no ram air and
    nothing a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
2026-09-14 docs: the enclosure straddles the firewall -- vent belongs on the cabin side
    Corrects an assumption from the previous commit. Confirming the cabin location
    did not settle vent siting, because the 104-pin connector is accessed from the
    engine bay: the housing sits in the cabin but its connector face passes through
    the firewall. The enclosure therefore has two environments rather than one, with
    cabin ambient on the body and under-hood spray, salt and washing on the connector
    face. A membrane fitted to the connector face would sit in exactly the ram air and
    wash path the siting rule exists to avoid, so it goes on the cabin side where the
    glovebox shelters it.
    Records that the firewall seal is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
2026-09-14 docs: ADS8588S verified pin-for-pin with the AD7606 -- a real second source
    Compared TI's ADS8588S against the Tokmas AD7606-class datasheet on file, pin by
    pin across all 64. They are identical, with the only differences being naming:
    REF_SELECT against REFSEL, and V1 through V8 against AIN_1P through AIN_8P. Pins
    9 and 10 are CONVSTA and CONVSTB, matching the original AD7606 rather than the
    AD7606C's CONVST and WR, so the existing advice to short them applies unchanged
    and the WR hazard does not arise.
    An initial automated comparison came out shifted by one pin and was discarded:
    the Tokmas datasheet is in Chinese with a different table layout, and the parse
    disagreed with this file's own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
2026-09-14 docs: ADS8588H is also pin-identical; the ADS9324 is not a drop-in
    Checked both parts against the verified AD7606 pinout. The ADS8588H matches --
    CONVSTA 9, CONVSTB 10, FRSTDATA 15, REFSEL 34, REGCAP2 39, AGND 40, LQFP-64 at
    10 by 10 mm -- and improves on the ADS8588S with 500 kSPS and a 9 kV input clamp
    against 7 kV. The speed is irrelevant to the ECU at about 1 percent utilisation,
    but the clamp is not, since those pins run to a 104-pin harness in a vehicle.
    Corrects the suggestion that the ADS9324 shares the pinout. It does not, and the
    difference is structural: 16 differential channels rather than 8 single-ended, a
    VQFN-64 at 8 by 8 mm rather than an LQFP-64 at 10 by 10, an AVDD_1V8 rai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
2026-09-15 hardware: re-render STLs, and record that OpenSCAD output is not deterministic
    Re-renders the committed STLs, which had fallen behind the SCAD. Geometry
    verified against design intent rather than by hash, since a determinism test
    showed OpenSCAD 2021.01 produces different bytes from two identical runs of an
    unchanged file. That means a git diff on stl/ carries no information and
    currency cannot be checked by hash, so vr_rig.scad is the source of truth and the
    STLs are a convenience for printing without installing OpenSCAD.
    Adds a short pre-arrival section covering the four things that need no bought
    parts: printing the twelve pieces, ordering the drive and hardware sections of
    the BOM, writ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
    [base.stl, base_a.stl, base_b.stl, bearing_block.stl, cam_gear.stl, cam_target.stl, crank_gear.stl, motor_mount.stl]
2026-09-15 hardware: size the base to a 300 mm spine rod, bought in 304 stainless
    Base grows 280 to 300 mm so the rod is used uncut. That puts a one-piece base
    past a 300 mm bed, making base_a and base_b the default print path at 90 and 210
    mm, both comfortable with room for a brim. The alternative is recorded: set
    base_l back to 280 and cut 20 mm off each rod, which is a trade of one seam
    against cutting stainless twice.
    Avoiding the cut is worth something specific -- 304 work-hardens, so a hacksaw
    that rubs rather than cuts glazes the surface and stops progressing.
    Records that 304 costs nothing structurally. Its modulus is 193 GPa against mild
    steel's 200, giving 819 N.m^2 rather than 826, still 4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
    [base.stl, base_a.stl, base_b.stl, bearing_block.stl, cam_gear.stl, cam_target.stl, crank_gear.stl, motor_mount.stl]
2026-09-15 hardware: a 320 mm bed reopens the one-piece base, and the spine frees the infill
    Records that a 320 mm bed leaves 10 mm clear each side of the 300 x 240 base, so
    the one-piece print becomes available again and is worth taking, since a seam that
    does not exist needs no argument. Flags that the printer's usable area should be
    checked rather than its nominal size, which differ by bed clips, purge lines or
    nozzle reach. Keeps base_a and base_b as a fallback rather than a downgrade,
    since the seam lands where the coupling absorbs misalignment and the spine rods
    splice it.
    Records a consequence of the spine that had not been drawn out. A printed plate
    is a sandwich whose solid skins carry the be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
2026-09-16 hardware: 36 V 360 W supply -- fuse it, and ramp the decelerations
    Records that the 360 W brick is fine for the load but needs a fuse. The stepper
    draws about 2.2 A worst case, so a 10 A supply is roughly four times the load,
    which is harmless since a supply delivers what is drawn. The risk is what it
    delivers into a fault: 360 W into a pinched wire or a failed driver on a rig made
    largely of printed plastic. A 4 A slow-blow fuse in the supply lead protects the
    wiring at 1.8 times the real draw, slow-blow because the driver's input
    capacitance draws an inrush spike.
    Records that regenerative energy cannot be solved with capacitance. A decelerating
    stepper pushes energy back and a switching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
2026-09-16 hardware: record why a 2.4 N.m NEMA 23 is the wrong direction for the rig
    Torque is not the binding axis. The rig needs 82 mN.m and the specified NEMA 17
    already supplies seven times that, so a 2.4 N.m NEMA 23 supplies twenty-nine times
    more of something already in surplus.
    Records the figure of merit as I times L rather than torque. To reach setpoint
    inside a 250 microsecond step at 36 V a motor needs I times L at or below 9.0
    mA.H; the 17HS19 at 2.0 A and 2.8 mH gives 5.6 and a 156 microsecond rise, while a
    4.0 A NEMA 23 would need inductance at or below 2.25 mH. A 2.4 N.m NEMA 23
    typically runs 2.5 to 3.8 mH, so it is marginal at best and likely too slow --
    worse at the speed the rig car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
2026-09-16 hardware: quantify the NEMA 23 against top speed rather than torque
    Replaces the rise-time framing with top speed, which is what the comparison
    actually turns on: current must reach setpoint within one step period, so top
    speed is V divided by I times L, and doubling the current halves the top speed at
    the same inductance.
    Records the candidate's quoted specs -- 2.4 N.m holding, 4.0 A per phase, 0.65
    ohm, 1.8 degrees, 8 mm shaft, 24 to 48 V -- and that inductance was not quoted
    while being the only number that decides it. Tabulates top speed against
    plausible inductances: 1350 rpm at 2.0 mH, 1080 at 2.5, 900 at 3.0 and 771 at
    3.5, against the 17HS19's 1929 rpm. The NEMA 23 clears the 1200 r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
2026-09-16 hardware: verify the motor mount against the 17HS19 drawing
    Checks every dimension the mount depends on rather than assuming them. Frame 42.3
    MAX matches nema = 42.3; the bolt holes computed at plus or minus 15.5 mm in both
    axes give the drawing's 31 plus or minus 0.2 square; the Ø22 minus 0.05 pilot boss
    sits in a 23 mm clearance cut; the Ø5 minus 0.012 shaft matches the 5 to 12 mm
    coupling; and the 48 MAX body reaches x = -147 against a base edge at -150.
    Records that the M3 screws must not be substituted longer, which is the opposite
    of the usual instinct. The drawing specifies 4-M3 DEPTH 4.5 MIN, a shallow blind
    hole, so through a 4 mm plate an M3 x 8 needs 4 mm of thread and clamps w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
2026-09-16 hardware: buffer the Pico to 5 V for the DM542, and cap microstepping by pulse rate
    The DM542's PUL, DIR and ENA terminals are marked 5V-24V and are optoisolated with
    an internal resistor sized for 5 V, giving 14 mA. A 3.3 V Pico drives them at 7.8
    mA, which would probably work and that is the problem: marginal opto drive turns
    on slowly with temperature-dependent delay, and on this rig the step edge is the
    angular datum, so it converts directly into position error at the moment the rig
    is meant to be the trustworthy reference.
    Specifies a 74HCT125 or 74HCT541 at 5 V, since the HCT input threshold of 2.0 V
    accepts a 3.3 V GPIO while its 5 V output drives the opto at full current -- the
    same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
2026-09-16 hardware: record why bidirectional level shifter modules cannot drive the DM542
    The common BSS138 plus 10 kOhm boards, the NXP AN10441 I2C design, cannot drive
    the driver's opto inputs, and the reason is structural rather than marginal: their
    HIGH state is driven only by a 10 kOhm pull-up, supplying 0.38 mA against the 14
    mA the opto needs, which is 37 times short. The rising edge is an RC through 10
    kOhm at 0.5 to 1 microsecond, against 11 nanoseconds for the specced discrete on a
    15.6 microsecond step period.
    Also records that the BSS138 on such a module cannot be repurposed, since its gate
    is tied to the LV supply rather than to a GPIO -- it is a passive bidirectional
    translator rather t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
2026-09-16 hardware: record why IRF520 modules cannot drive the DM542 either
    The MOSFET concept is right but the IRF520 is not a logic-level part. Its gate
    threshold spans 2.0 to 4.0 V and its on-resistance is specified at Vgs = 10 V, so
    a 3.3 V gate can sit below threshold on a high-threshold device, where the
    logic-level 2N7002 and BSS138 are fully enhanced at 3.3 V.
    Records that the failure mode is the intermittent kind. Gate threshold carries
    roughly minus 5 mV per degree C, so a part at the high end of the spread conducts
    warm and stops cold, passing a bench test in a heated room and failing in a cold
    garage -- which on a rig meant to be a trustworthy datum is worse than not working
    at all.
    Reco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
2026-09-16 hardware: add the 2N7002 driver board and record its review
    Adds the purpose-built single-channel driver board to the repo and to the rig BOM,
    replacing the loose discrete FET and resistor lines. It is 10.9 by 17.1 mm with M2
    mounting holes and two 2.54 mm headers, and three are needed for PUL, DIR and ENA,
    though ENA may be omitted since the DM542 enables when that input is open.
    Verified from the Gerbers rather than the schematic: IN through a 220 ohm resistor
    to the gate, the gate node carrying the 10 kOhm pulldown, source grounded and
    drain open to LOAD, with the 2N7002's SOT-23 pin order correct throughout. The
    gate pulldown is the part that matters, holding the gate defined while the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
    [2N7002 Driver BOM.csv]
2026-09-16 firmware: RP2040 step generator for the VR rig
    Adds the PIO step generator. Each FIFO word is a half-period in PIO cycles at the
    full 125 MHz system clock, giving 8 ns resolution with no divider to quantise it,
    and a 50 percent duty that satisfies the DM542's 2.5 microsecond minimum pulse
    automatically for any period down to its own 200 kHz ceiling. Core 1 paces steps
    while core 0 takes commands over USB CDC.
    The crank profile is the reason the firmware exists. A V8 fires eight times per
    720 degrees so crank speed dips four times per revolution, with the dips landing
    at TDC where this wheel's gap is, and that irregularity is the regime where sync
    acquisition fails. It is precomputed into a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
    [main.c]
2026-09-16 firmware: port the step generator to PlatformIO, one source for both toolchains
    Builds clean under PlatformIO with the maxgerhardt raspberrypi fork and the
    earlephilhower core -- no warnings at -Wall -Wextra, 9.8 kB RAM and 54 kB flash.
    The official platformio raspberrypi platform carries only the Arduino Mbed core;
    the earlephilhower core is built on the Pico SDK, so the hardware headers are
    reachable directly and core 1 arrives as setup1 and loop1 rather than
    multicore_launch_core1.
    src/main.cpp now serves both toolchains behind ifdef ARDUINO, which picks the
    entry points and the console while everything between is shared. Two copies of a
    control loop would have drifted apart within a wee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
    [main.cpp, stepgen.pio.h]
2026-09-16 hardware: measure the wheel from its photo -- 36-1 confirmed, keyway was wrong
    Measured the Dorman 917-060 product photo, square-on at aspect 1.000 so the
    ratios are trustworthy. An earlier angled photo gave bore/OD 0.201 and unusable
    tooth counts; that measurement is discarded in favour of this one.
    Confirms the wheel is genuinely 36-1: tooth pitch measures 10.00 degrees giving 36
    positions, with exactly one wide space at 2.00 times pitch. More importantly it
    confirms the datum -- the missing tooth centres near 102.7 degrees and the keyway
    near 105.0, which is 2.3 degrees apart and inside the measurement's own precision.
    The keyway really is on the gap, which is what makes CKP_GAP_TO_TDC_D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
    [base.stl, base_a.stl, base_b.stl, bearing_block.stl, cam_gear.stl, cam_target.stl, crank_gear.stl, motor_mount.stl]
2026-09-16 hardware: neither wheel dimension was measured -- pick the pairing on physics
    Both the 150 mm OD and the 24 mm bore were guesses. The measured ratio of 0.253
    says they cannot both be right, but the ratio itself is solid, so any
    self-consistent pairing is admissible and one caliper reading fixes the rest.
    Chooses 150 by 38 on a physical argument rather than a numerical one: this wheel
    mounts on a crankshaft nose and carries four bolt holes, and while 24 mm is far
    too small for a Ford modular snout, 38 mm is an ordinary one -- and 38 divided by
    0.253 lands on 150. That also restores the geometry everything was designed
    around, with the wheel dipping 15 mm through a 73 mm slot.
    Records that t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
    [base.stl, base_a.stl, base_b.stl, bearing_block.stl, cam_gear.stl, cam_target.stl, crank_gear.stl, motor_mount.stl]
2026-09-16 hardware: real wheel dimensions from the vendor listing -- 6-3/4in x .120in
    Replaces guessed dimensions with the vendor's published figures: 171.45 mm OD
    against the assumed 150, and 3.05 mm thick against the assumed 5.0. It is a Small
    Block Ford 36-1 sitting between the balancer and the crank pulley, which makes the
    earlier Ford modular crank-snout reasoning wrong about the engine family, though
    irrelevant on a bench. Only the bore remains derived, at 43.4 mm from the photo's
    0.253 ratio, and it is now the single figure still worth a caliper.
    The larger wheel dips deeper: an 85.7 mm radius against a 60 mm shaft height puts
    the rim 25.7 mm below the base top, leaving barely 6 mm to the grou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
    [base.stl, base_a.stl, base_b.stl, cam_gear.stl, cam_target.stl, crank_gear.stl, motor_mount.stl, sensor_mount.stl]
2026-09-16 hardware: real sensor barrel diameter -- 14.3 mm, one mount serves both
    Replaces the guessed 19 mm sensor barrel with the measured 14.3 mm, shared by
    both sensors, and records their lengths: 57 mm for the crank and 38.1 mm for the
    cam. The mount is a through-bore clamp so one printed part takes either, with the
    sensor sitting further in or out.
    The mount body shrinks from 31.0 to 26.3 mm across and the crank sensor station
    moves in slightly. Envelope re-checked: everything still sits on the 300 by 260
    plate.
    Records an asymmetry that follows from the lengths. Reaching a 1 mm air gap needs
    7 mm of protrusion past the mount's near face, which leaves the crank sensor 23.7
    mm behind the mount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
    [base.stl, base_b.stl, cam_gear.stl, cam_target.stl, crank_gear.stl, motor_mount.stl, sensor_mount.stl, vr_rig.scad]
2026-09-16 hardware: the VR sensors are flange-mounted -- rebuild sensor_mount
    The product photos show these are not plain barrels: an O-ring'd barrel drops
    into a bore and a single bolt passes through an ear beside it. sensor_mount was a
    pinch clamp, which is the wrong object entirely.
    The consequence is structural rather than cosmetic. Insertion depth is fixed by
    the flange face bottoming on the mounting surface, so the sensor cannot be slid in
    or out to set the air gap. The mount becomes a plate normal to the sensor axis
    carrying a barrel bore and a slotted bolt hole parallel to it, with the flange
    seating on the outboard face exactly as it does on an engine, and gap_slot widens
    from 14 to 30 mm be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
    [base.stl, base_a.stl, base_b.stl, bearing_block.stl, cam_gear.stl, cam_target.stl, crank_gear.stl, motor_mount.stl]
2026-09-16 hardware: sensor bolt is crosswise to the barrel, and the offsets are measured
    Corrects the mount again. The retaining bolt is perpendicular to the barrel, not
    parallel to it, which is how these bolt to a cover: sensor pointing radially at
    the wheel with the bolt running parallel to the crank axis. The previous pass had
    it parallel, which would have put the bolt where the sensor body is.
    Takes the measured offsets. From the barrel's edge to the bolt centre is 14.0 mm
    on the crank sensor and 12.7 on the cam; adding the 7.15 mm barrel radius gives
    21.15 and 19.85 mm from the barrel axis. They differ by only 1.3 mm, so a single
    slotted mount takes both with room either side, and the bolt diame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
    [base.stl, base_a.stl, base_b.stl, bearing_block.stl, cam_gear.stl, cam_target.stl, crank_gear.stl, motor_mount.stl]
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2026-09-16 hardware: size the sensor seating pad from the ear rather than from its bolt
    Both flanges are 19 mm wide with a rounded tip, reaching 25.4 mm past the barrel
    edge on the crank and 19.1 on the cam, so 32.55 and 26.25 mm from the barrel axis.
    The seating pad is now sized to the larger of the two and the plate widened to
    suit, giving a mount of 47.0 by 46.0 by 99.6 mm. Previously the plate was sized to
    reach the bolt, which left it 0.4 mm short of seating the whole crank ear.
    Records why the pad could not be inferred from the bolt position: the bolt is not
    centred on the tip radius on either sensor, with the ear running 11.4 mm past it
    on the crank and 6.4 on the cam.
    Flags the cam figures fo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
    [base.stl, base_a.stl, base_b.stl, bearing_block.stl, cam_gear.stl, cam_target.stl, crank_gear.stl, motor_mount.stl]
2026-09-16 hardware: cross-check the crank flange from a second measurement
    A later figure of 6 mm from the bolt hole's outer edge to the flange's outer
    radius gives an independent route to the ear's reach. On the crank sensor it
    lands: bolt centre 21.15 plus the M8 hole radius plus 6 gives 31.15 mm from the
    barrel axis, against 32.55 from the separately stated 25.4 mm reach -- agreeing to
    1.4 mm. The pad is sized to 32.55 and covers either, so no change is needed.
    The cam's figures still disagree with themselves by 3.6 mm, in the same direction
    as the earlier tip-radius check: its stated reach is shorter than its own bolt
    position implies. It changes nothing, since the pad is sized to the larger ear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
2026-09-16 hardware: printable check models of both VR sensors
    Adds part = "sensor_ckp" and "sensor_cmp", modelling the two sensors from the same
    parameters the mount reads. That sharing is the point: if a printed model does not
    match the real sensor, the mount is wrong in the same way, so a 20 g print tests
    every dimension in the file at once.
    Models carry the measured figures -- 14.3 mm barrel, 57.0 and 38.1 mm barrel
    lengths, 32.55 and 26.25 mm flange reach from the barrel axis, 21.15 and 19.85 mm
    bolt centres, 19 mm flange width, M8 -- and come out 70.5 by 20.3 by 63.0 mm and
    64.2 by 20.3 by 44.1 mm. Flange thickness and the connector arm are eyeballed from
    photographs and marked as guesses; they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
    [sensor_ckp.stl, sensor_cmp.stl, vr_rig.scad]
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2026-09-16 hardware: correct the sensor check models -- flange outline and connector tails
    Three errors found by comparing the render to the real part before printing.
    The flange does not stop at the barrel: it carries on past it with the same
    radius as the bolt end, so the paddle is rounded at both ends. Measured from the
    barrel's outer surface to the flange's far edge it is 6 mm on the crank and 3 mm
    on the cam. The first model hulled from a circle at the barrel, cutting that off.
    Nothing projects behind the flange face. The first model stood a connector block
    proud of the back, which neither sensor has; both tails now lie flush in the
    flange's own plane.
    The tails leave in different directions. T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
    [base.stl, base_a.stl, base_b.stl, bearing_block.stl, cam_gear.stl, cam_target.stl, crank_gear.stl, motor_mount.stl]
2026-09-16 hardware: crank sensor tail is one straight leg, and the other way round
    The crank's L is formed by the ear and a single leg at 90 degrees to it, not by a
    leg that bends again -- the previous model added a second leg off the first, which
    was a misreading of the description. It also pointed 180 degrees the wrong way.
    The tail now leaves at plus Y with the ear at plus X, both reaching 32.5 mm, so
    the L is square and symmetric about the barrel. Envelope drops from 61.0 by 42.0
    to 45.7 by 42.0 by 63.0 mm.
    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
    [sensor_ckp.stl, vr_rig.scad]
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2026-09-17 hardware: printed enclosure for the bench power supply
    Screw-down lid, 40 mm intake fan at one end, diamond exhaust grid at the
    other, fused IEC C14 inlet on a long side. External 285 x 201 x 106, clear
    inside 279 x 156 x 79 for a 266 x 153 x 77 supply.
    The lid screws cannot land in corner posts - with 3 mm of clearance beside
    the supply there is nowhere to put one - so they go into a band that
    thickens the wall inward around the top rim, above the supply where the
    volume is free. Its underside is a 45 degree taper so it prints unsupported,
    and its inner face is the rabbet the lid locates in.
    The 39 mm wiring bay exists because the IEC module's rear flange stands
    19 mm proud and the termin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
    [lid.stl, psu_enclosure.scad, tub.stl]
2026-09-17 Electric cooling fans, and the drivers the slow outputs needed
    Two staged electric fans replace the clutch fan, with A/C fan-on and an
    optional highway cutoff. Design in docs/cooling-fans.md; the cooling config
    block is live in firmware now, the control logic is not - it needs CHT (M7)
    and an expander output layer that does not exist yet.
    Found: the EEC-V sheet annotates pins 19 and 46 "Electric Fan 1/2", but pin
    46 is IMCC (BRN, C118) on this truck, which the design keeps. The MegaSquirt
    mapping was free to reuse it because that build dropped IMCC. Fan 2 goes to
    pin 18 instead - no wire in this harness, adjacent to 19.
    Thresholds are cylinder head temperature, not coolant. Pin 66 is Cyl H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
    [Config.cpp, Config.h]
2026-09-17 VREF: settle the output stage on TPS2H160B-Q1, and close a blind spot
    The protection scheme only ever considered short-to-ground. On a short to
    BATTERY - a chafed VREF wire finding a 12 V circuit, at least as common -
    almost no current flows, so the PTC never trips and contributes nothing. The
    output node simply sits at 14 V and any ordinary 5 V load switch dies: the
    TPS2052B considered for this is rated 6 V absolute maximum on its output.
    That sharpens the requirement to one line - the VREF output stage must be
    rated to battery voltage, not 5.5 V - and that line selects the part.
    TPS2H160B-Q1, dual-channel 40 V smart high-side switch from the 5 V rail:
    - 40 V output rating, and it DETECT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
2026-09-17 VREF: correct the regulator dissipation - it is fed from 6 V, not battery
    The previous commit put the fault-case dissipation at 2.5 W by assuming a
    14 V input. The 5 V rails are LDOs off the 6.0 V SEPIC, so the drop is 1 V
    and the real figure is 0.275 W - an order of magnitude out, and it was the
    number said to drive package and copper sizing.
    Also notes that v1-scope.md still lists the SEPIC at 3 A where
    power-supply.md settled on 2 A.
2026-09-17 VREF: feed it from the LTC4364 protected rail, and unstale v1-scope
    The 5 V rail is a MAX25239AFFA buck-boost with spread spectrum, so it cannot
    source VREF for two reasons: a linear regulator cannot make 5.00 V from 5 V,
    and running one near dropout is worse than it looks because PSRR collapses
    approaching dropout - it would stop rejecting the ripple it exists to reject.
    Spread spectrum makes that ripple broadband rather than a single tone, so it
    cannot be notched or synchronised to either.
    VREF now comes off the LTC4364's protected output: ~14 V nominal, clamped at
    27-30 V, reverse-protected, with the 4.47 V UV holdoff and the brownout
    holdup already there. Completely independent of the s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
2026-09-17 VREF: state the regulator requirement properly - 40 V was overstated
    The open item said the regulator must be rated >= 40 V. That is a convenient
    bucket, not a requirement. The constraint is the clamped rail's maximum,
    which power-supply.md puts at 30 V (27 V design), so >30 V is the floor. A
    36 V part clears it by 20 percent, and if one has better dropout, PSRR or
    thermals it is the better choice - the voltage bucket is the least binding
    constraint of the three.
    Reordered the open item by what will actually narrow the search: thermals
    first, since carrying 2.5 W will eliminate more candidates than anything
    else; then placement downstream of the pass FET, which matters more than any
    rating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
2026-09-17 VREF: the 2.5 W fault case is a pulse, not a steady state
    Sizing the regulator for 2.5 W continuous was wrong. The TPS2H160B already
    carries per-channel enable, per-channel current sense and a fault flag, for
    diagnostic reasons - which together make the fault transient:
    short -> channel clamps at 250 mA
    80-180 us -> FAULT asserts (t_CL(deg))
    read CS -> identify the channel
    drop INx -> channel off, back to 0.22 W
    So the package has to survive an energy pulse and a retry policy, not 2.5 W
    until someone fixes the harness. Continuous dissipation is 0.22 W.
    That makes channel shedding a firmware requirement rather than a nicety - the
    thermal design no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
2026-09-17 VREF: settle the regulator on NCV8772CDT504RKG, and write the BOM
    onsemi NCV8772C, 5.0 V, DPAK-5. Rjc = 12.6 C/W decided it: the fault is a
    pulse and junction-to-case governs a pulse, so 2.5 W x 12.6 = 32 C rise to
    the case is a non-event. It also means most of the 47.1 C/W Rja lives in the
    board, so copper pour buys real margin - which matters because at 5 V the
    DPAK-5 is the only package offered, the D2PAK variant being 3.3 V only.
    Reverse output current protection earns its place now that the part is
    EN-gated: VREF bulk plus sensor capacitance can hold the output up while Vin
    falls. 350 mA rated with a 400 mA limit minimum clears the 275 mA fault case
    without limiting. AEC-Q100 Grade 1,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
2026-09-17 Put a second supply in the PSU box - and it becomes the weakest part on the bus
    A two-rail DC-DC joins the bay: fixed 5 V for the VR rig's Pico and the
    DM542's opto commons, plus an LCD-set adjustable rail. It is fed from the
    36 V supply already in the box, so there is no second inlet and no more live
    terminals in a box that already has a set.
    Mechanically it is a panel cutout held by the module's own snap locks, and
    two numbers drove the shape:
    - The locks grip a 1-4 mm panel, and a 3 mm wall sits at the very end of that
    taper. The panel is thinned to 2 mm from the INSIDE, so the lock bites
    mid-taper and the outside stays flat under the bezel.
    - The bay is 39 and the module is 25.4 de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
    [lid.stl, psu_enclosure.scad, tub.stl]
2026-09-18 Enclosure: mains to the back wall, and 6.6 mm more LCD width
    Two fixes, and they turned out to depend on each other.
    1. The 120 V inlet moves off the front wall onto the BACK. That wall was the
    only surface with nothing on it, and it was blank precisely because it had
    no depth - the supply sat 3 mm behind it while the inlet's flange intrudes
    12 mm with 12 mm of booted terminals behind that. clr_side 3 -> 28 buys the
    room and leaves 4 mm to the supply.
    The fan side was the alternative and does not work: the pad overhangs the
    corner by 1.5 mm, the flange comes within 2 mm of the supply, and the LV
    gland already occupies that bay corner. Three tight spots at once, against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
    [lid.stl, psu_enclosure.scad, tub.stl]
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2026-09-19 Split the label for multi-material - and the split found a real bug
    Three STLs now share an origin - plate, text, warn - so the slicer can load
    them as one object and give the warning its own filament. warn is the three
    lines that are the reason the label exists; the rules stay with text so they
    bracket the warning rather than joining it. label.stl is unchanged in intent:
    one piece for a single colour or a filament change at 2.4 mm.
    AND SPLITTING IT EXPOSED A BUG THE SINGLE PART HAD BEEN HIDING. warn.stl
    measured 94.4 mm wide on a 98 mm plate: the warning overran the 84 mm text
    column and reached x +/-47.4, INTO THE ZIP-TIE SLOTS at +/-43.4. Two other
    rows overran too. label.stl could never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
    [harness_label.scad, label.stl, plate.stl, text.stl, warn.stl]
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2026-09-19 BOM rev 2 checked against the placement - and the OLD BOM was the wrong one
    Cross-checked designator by designator against FlyingProbeTesting.json: 71
    BOM designators, 71 real placements, nothing in the BOM that is not on the
    board and nothing on the board that is not in the BOM. A clean match both
    ways, which the previous BOM was not.
    Fixed by this revision:
    D2 REMOVED - it has no footprint, so the old BOM had you ordering a part
    with nowhere to go. That closes what the PGND review flagged an hour ago.
    D4 ADDED (ESD5Z5.0T1G) - it was ON THE BOARD and MISSING FROM THE BOM.
    That is the worse direction of the two: one part short at assembly.
    The phantom "C1206" designator is gone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
    [Triton_ECU_BOM_POWER_Power_V_1.csv]
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2026-09-19 Carrier template: a measurement jig, plus the DonorECU spelling fix
    The template is deliberately NOT a check of a finished layout - there is no
    layout yet. It is the instrument that captures the number everything is
    waiting on: where the case's mounting bosses sit relative to the board
    outline. Drop it in, read the boss centres off the grid, and the carrier can
    be drawn.
    Two parts. ring.stl is a 16 mm perimeter frame and should be printed FIRST -
    if the centre pan or the bosses foul a full plate, the ring still sits on the
    rails and still gives the outline and the connector check. template.stl is
    the full plate with the complete grid, more useful if it sits flat.
    Both 157 x 173 x 2, delibe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
    [carrier_template.scad, ring.stl, template.stl]
2026-09-19 Bearing blocks split: the modelled fit was never the printed fit
    All but one cracked in PETG within an hour of the bearings going in.
    brg_press was -0.05, which reads as 0.05 mm of interference and is harmless -
    2.8 MPa of hoop stress. IT WAS NEVER THE REAL INTERFERENCE. An FDM bore
    prints UNDERSIZE: extrusion overlaps on the inside of a curve, and a
    horizontal bore also sags at its crown, so 0.2-0.4 mm on diameter is routine.
    That turns 0.05 into 0.25-0.45:
    0.05 interference -> 2.8 MPa fine
    0.35 -> 19.3 MPa marginal
    0.45 -> 24.9 MPa past PETG's ~22 MPa INTERLAYER
    AND INTERLAYER IS THE NUMBER THAT MATTERS, which is the part that makes thi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
    [bearing_block.stl, fit_gauge.stl, vr_rig.scad]
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2026-09-19 Add a connector footprint gauge - go/no-go for the sanded post
    The heat gun mushroomed one of the connector's posts. Sanding it back needs a
    gauge, and the same gauge validates the footprint that was corrected two
    commits ago.
    conn_gauge is built from TE 770750-1's Recommended P.C. Board Layout:
    two 3.60 post holes at 110.00 centres, the 3.70 centre hole at 55.00 from
    each, the pin field as a 101.4 x 9.0 slot, and the board-edge line at 5.20.
    134 x 27 x 3 mm, about twenty minutes to print.
    Two jobs at once. Go/no-go for the post - sand the DIAMETER, not the length,
    until it enters the 3.60 hole cleanly. And it proves the footprint against
    the physical part before it reaches a PCB, which ma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
    [carrier_template.scad, conn_gauge.stl]
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2026-09-19 Z-bracket platform for the PSU module - 74.5 x 92 x 51
    Built from the hand drawing. The two dimensions on the side view run flange
    tip to web, with the web counted INSIDE the 44.5 - the only reading that
    satisfies both views, since the top view shows two rectangles meeting at one
    line and 44.5 + 30 = 74.5 leaves nothing over. Only the 44.5 flange can hold
    the holes; 34.9 does not fit inside 30.
    The rendered STL is measured back: 74.500 x 92.000 x 51.000, all four bore
    centres on nominal to 0.001 mm.
    Two things the drawing could not say. Thickness is set to 3 mm, and the web
    is the loaded member - 138 mm^3 section modulus at a 22.25 mm offset is 124 N,
    about 12 kg, so gussets stay off by de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
    [platform.stl, psu_platform.scad]
2026-09-20 The keyway is NOT on the gap - the part falsifies the product photo
    key_to_gap = 0 came from a Dorman 917-060 listing photo. Measured on the
    physical wheel the keyway lines up with the rear edge of the tooth just
    forward of the missing tooth - which is the SAME FEATURE as the forward edge
    of the gap, and saying it that way removes the tooth-width assumption from
    the observation entirely.
    One pitch less half a tooth: 7.5 deg at 50 % duty. The scad now carries it as
    10 - tooth_w_deg/2 so measuring the tooth propagates by itself, and the whole
    40-60 % duty range spans only 1 deg.
    The old photo said 2.3 deg and the difference is 5.2 - half a pitch, one whole
    tooth width. A disagreement landing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
    [vr_rig.scad]
2026-09-20 Keyway is half a pitch from the missing tooth - 5.00 deg, and duty-free
    The first reading was taken from the BACK of the wheel. Corrected: the keyway
    lines up with the gap between the missing tooth and the next tooth.
    That is a better datum than the one it replaces, not just a different one. The
    gap's centre is the midpoint of two tooth centres - one at the missing
    position, one a pitch away - so the tooth width cancels:
    gap spans w/2 .. pitch-w/2 -> centre = pitch/2 = 5.00 deg, for any w
    5.00 deg is therefore exact. The earlier 7.5 was the far edge of this same gap
    and needed the duty assumption to state it. Tooth width is demoted from setting
    the answer to bounding it at +/-2.5 de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
    [vr_rig.scad]
2026-09-20 It IS the Dorman - the part is cast 917-060, and that reverses two claims
    The front face reads FRONT 917-060 53025 TAIWAN. Two corrections follow.
    First, the wheel identification. I argued that a keyway landing on the crank's
    TDC datum had to mean a factory part, because an aftermarket 36-1 is broached
    to fit a shaft and its teeth fall arbitrarily. The premise was wrong: it
    equated aftermarket with universal. The 917-060 is an OE-REPLACEMENT reluctor
    for a named application, so its keyway is cut to put the gap where that
    engine's ECU expects it. The keyway relating to TDC is exactly what a
    direct-fit part does and needed no Ford casting to explain.
    Second, and this reverses last commit's c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
    [vr_rig.scad]
2026-09-20 Wheel OD is ~135 mm, not 171.45 - and the bore and keyway move with it
    The third photo put the WHOLE template in frame, which is what the first two
    were missing. Two independent scales then sit in the same image: the 157 x 173
    plate outline and the 101.4 mm pin-field slot, which is local to the plate
    rather than at its edges. The wheel reads about 13.5 grid squares, so 128-141
    mm. The vendor's 6-3/4" would be 17.1 squares. The listing is out by 25 %.
    Both earlier attempts at this are struck, and they were wrong in opposite
    directions - one assumed a plate width that ran off frame, the other leaned on
    a pixel estimate of that same bad frame. The fix was not better arithmetic, it
    was a better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
    [base.stl, base_a.stl, base_b.stl, bearing_block.stl, cam_gear.stl, cam_target.stl, crank_gear.stl, fit_gauge.stl]
2026-09-20 The wheel is modular after all - and a review may describe the 5.00 deg
    Dorman's catalogue settles the application: 917-060, steel, 35 teeth, OE cross
    XW1Z-12A227-AC, fitting 2001-2010 F-150 4.6 and 2002-2010 F-150 5.4 among
    others. It is a modular V8 reluctor, not a Small Block Ford one, and the ~135 mm
    measured off the template grid corroborates the catalogue against the reseller
    listing - which had the OD and the engine family both wrong. My previous
    retraction used the wrong reason and is withdrawn.
    But the calibration-bench claim still does not come back, for two better
    reasons.
    The applications all start at 2001 and the truck is a 1999. 2001 is exactly
    where a crank-trigger revision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
    [base.stl, base_a.stl, base_b.stl, bearing_block.stl, cam_gear.stl, cam_target.stl, crank_gear.stl, fit_gauge.stl]
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2026-09-20 Print order before the first run - and the base cut no wheel slot
    Rig is close, but not "print everything". Three things found on the way.
    THE BUG. slot_y tested (shaft_h + base_t < wheel_od/2) - "does the wheel punch
    out the BOTTOM of the plate" - and sized the slot on the chord at that bottom
    face. Both are the wrong question. A slot is needed the moment the wheel reaches
    below the base TOP, and it must be as long as the chord there, which is the
    widest section of the intersection rather than the narrowest.
    At the nominal OD 135 the old form cut NO SLOT while the wheel buried 7.5 mm
    into an 8 mm plate - a hard collision, wheel cannot turn. Where it did fire
    (OD >= 138) it was short by ab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
    [vr_rig.scad]
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2026-09-20 L bracket: 30 x 50 x 50, four standoffs up top and a pair of Ø3.5 in the upright
    New part from the hand drawing of 2026-09-20. A module bolts onto the short leg
    through four Ø2.30 bores on Ø5 x 3 standoffs; the tall leg is the upright and
    carries two Ø3.5 holes on its midline. 3 mm plate throughout, the same as the
    PSU platform. Measured back off the STL: 30.000 x 50.000 x 53.000, both side
    bores at r 1.9000, all four top bores at 1.150, all four bosses at 2.500.
    Three of the sketch's numbers needed work.
    The Ø3.5 pair is labelled 25.4 and 8.5 with no statement of which is which. The
    two leaders land on the upright 88 px apart in a 175 px leg, which scales to
    25.1 against the 50 - so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
    [bracket.stl, l_bracket.scad]
2026-09-20 Fit gauge: the labels were inside the bores - only the bottom 0.4 mm existed
    Reported from the bench: only the very bottom of the number was visible on the
    printed coupon. It is not a printing problem, it is the model. The text sat at
    baseline z 3.5 with size 5, so the digits ran to about z 7.0 - and with the
    bore centred at z 18, a Ø28.15 pocket opens at z 3.93 directly above them. At
    3 mm either side of centre the mouth is still only at 4.25, at 5 mm at 4.84.
    Everything above that was hole. All three labels went the same way, which is
    why it read as a print defect rather than a modelling one.
    The fix is an 8 mm plain label band under the bores. The coupon is 44 tall
    instead of 36, the bo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
    [fit_gauge.stl, vr_rig.scad]
2026-09-20 brg_press calibrated: 0.15 shrink measured, and the pocket that felt best is wrong
    Gauge result from the bench: the +0.15 pocket took a 6001 with no play, and
    +0.30 and +0.45 were both loose. That is the measurement the coupon exists for.
    A pocket modelled at 28.15 that finishes snug on a 28.00 bearing means this
    printer shrinks a horizontal bore by about 0.15 mm on diameter - mid-range of
    the 0.2-0.4 the README predicted, and now a number rather than a guess.
    The conclusion runs against the feel, which is the whole point of the page it
    sits on. The bearing is not held by the bore, it is held by the compound, and
    the compound needs a gap:
    +0.15 finishes ~28.00, gap ~0.00 - felt perfec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
    [vr_rig.scad]
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2026-09-20 PSU pad: a flat 164.4 x 71.5 plate, four standoffs and two Ø3.5 fixings
    New part from the hand drawing of 2026-09-20. Not a bracket - nothing bends. A
    full-width body with a raised centre section, four Ø5 x 3 standoffs for the
    module and two Ø3.5 holes at the bottom corners to fix the pad down. Measured
    back off the STL: 164.400 x 71.500 x 6.000, step at y 50.800 either side of the
    raised part, fixing bores at r 1.9000, standoff bores at 1.150, bosses at 2.500.
    The width closes exactly and that is what fixed the reading: 45 + 108 + 11.4 =
    164.4, to the decimal. So those three are a decomposition of the width - 45 to
    the step, 108 of raised section, 11.4 to the right edge - and the raised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
    [pad.stl, psu_pad.scad]
2026-09-20 PSU platform: the L bracket's Ø3.5 pair, in the web, 15 from the y=0 end
    Same fixing holes hardware/l-bracket carries in its upright, same 25.4 between
    centres, modelled at 3.80 with the same 0.30 compensation. Verified off the STL:
    both bores at r 1.9000 exactly, cutting x 41.5 to 44.5 - the web and nothing
    else - at z 8.5 and 33.9, with the Ø14 foot cut still intact at r 7.000.
    Two things had to be reinterpreted rather than copied. The L bracket measures
    8.5 from the upright's free end; this web has no free end, it lands on the foot.
    Taken from the underside of the foot, which is the same plane in both parts, so
    the z numbers come across unchanged. And the pair is off the midline this t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
    [platform.stl, psu_platform.scad]
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2026-09-21 Latching relay: two single-gate chips instead of the CD4013, 99 -> 26 mm2
    Same circuit, smaller footprint. SN74LVC1G74 single D flip-flop replaces the
    CD4013, and a SN74LVC1G14 single Schmitt inverter goes between the debounce RC
    and the clock. Both run 1.65-5.5 V, so they sit on the 5 V coil rail directly.
    Land-pattern arithmetic, which is what the change is for:
    CD4013 SOIC-14 + 1G14 + 8 x 0805 99 mm2
    1G74 + 1G14 + 7 x 0402 26 mm2 <- this
    ATtiny202 SOT-23-6 + 3 x 0402 12 mm2
    Half the SOIC-14 was an unused second flip-flop. But the honest headline is that
    the relay is 80-90% of the board no matter what the logic does: a sugar cube is
    295 mm2, a G6K sig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
    [BOM.csv]
2026-09-21 Latching relay: driver-only board, and the IRF7319 read off its datasheet
    The relay and the button are both headers now, so this PCB is the latch, the FET
    and the flyback diode - nothing that switches the load. BOM drops K1 and SW1 and
    gains a third 2-pin header: H1 power in, H2 button, H3 coil. 12 line items, 16
    placed parts. D1 moves to sit across H3 so the coil's kick is clamped at the
    connector rather than travelling back down the wires.
    That inverts the area argument. With the relay gone the connectors are the
    biggest block on the board:
    3 x 2-pin 2.54 headers 40 mm2
    1G74 + 1G14 16
    AO3400A + 1N4148W 11
    7 x 0402 11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
    [BOM.csv]
2026-09-21 Latching relay: rebuilt around the real job - 5V standby, mains relay, 36V PSU
    The application finally landed, and it moves most of the design. A 5 V module
    that is always live; a button toggles a 5 V LATCHING relay; the relay switches
    mains ahead of a 36 V supply. Not the truck, not a 12 V rail - 12 V constant was
    deliberately avoided, and the first relay sourced turned out to be 12 V only,
    which is what started this whole thread.
    Three consequences.
    The board is SELV end to end. The relay lives in the PSU enclosure with the
    mains; this board carries 5 V, button contacts and two coil wires. That is the
    real reason the relay is on a header, and it is now stated as a rule rather than
    an acc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
    [BOM.csv]
2026-09-21 Latching relay firmware: ATtiny202, 30 ms pulses, fail-safe off, host test
    Programmers are already on hand, so the ATtiny route is settled and this is the
    firmware. It never holds anything - the relay is the memory - it just emits a
    30 ms pulse on one coil to set and the other to reset.
    Two compile-time switches cover the unknown relay: DUAL_COIL picks between two
    low-side FETs and the H-bridge, where each leg is a CMOS pair with its gates
    tied and is therefore inverting, so idle is both pins LOW, both midpoints high,
    and no differential across the coil. SENSE_FITTED picks between tracking state
    in RAM and reading it back off the relay's spare pole.
    Two behaviours are the reason for buildi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
    [main.cpp]
2026-09-21 Latching relay: LATCHING 0 builds it with an ordinary 5 V relay from the drawer
    There are plain 5 V relays on hand, so the firmware now covers them: LATCHING 0
    holds the coil instead of pulsing it, populates one FET instead of two or four,
    and ignores DUAL_COIL because an ordinary relay has one coil.
    The trade is clean in both directions. A latching relay costs zero holding
    current but holds through a blackout, so setup() has to fire a reset pulse to
    define what "off" means. An ordinary relay costs 70-90 mA and about 0.4 W for as
    long as the supply runs, and is fail-safe off by construction - no power, no
    coil, no contact - so the boot pulse and the paragraph of reasoning behind it
    simply d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
    [main.cpp]
2026-09-21 Latching relay firmware: ATtiny85 is a real target now, and the harness was lying
    The oil pressure board's U1 reads ATMEL / TINY85 / 20U, lot 2233 - an
    ATtiny85-20SU, week 33 of 2022, which sits just before that board's 230106 date
    code. So there are ISP-programmable tiny85s and a programmer for them already on
    hand, and the README's claim that porting was "five pin defines" should be a
    build target rather than a promise.
    src/main.cpp now switches its own pin map on __AVR_ATtiny85__ - PB1, PB4, PB3,
    PB0, PB2 - and platformio.ini carries [env:attiny85] on atmelavr at 8 MHz
    internal. PB5 stays RESET: claiming it costs the reset-disable fuse and then HV
    programming to recover, which is never w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
    [main.cpp]
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2026-09-21 SensorManager: masked means unvalidated, not zero - and validation now runs
    Two defects, and the second is why the first mattered so little.
    The state gate wrote d.value = 0.0f and skipped the read entirely. Zero is a
    value rather than an absence: a masked oil pressure sensor read 0.0 - the one
    number that means danger - and the dashboard, /state, MQTT, the logger and any
    rule sourcing that slot saw a plausible, alarming, false reading with no way to
    tell masked from failing. Skipping the read also meant nothing was captured
    during cranking, which is the window where rail sag and pressure rise time are
    visible.
    Masked now means "do not BELIEVE this reading", not "do not TAKE it". Every
    des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
    [SensorDescriptor.h, SensorManager.cpp, SensorManager.h, WebHandler.cpp]
2026-09-21 Oil: isOilPressureLow() asks the rule, and oilSensorFault carries plausibility
    The getter returned _desc[SLOT_OIL].inError, which is the descriptor's
    PLAUSIBILITY flag, while low oil pressure is the OIL_LOW FaultRule - OP_LT on an
    RPM curve with a 3 s debounce, requireRunning and an 800 rpm gate. Two different
    questions sharing one flag, and the wrong one feeding EngineState.oilPressureLow.
    isOilPressureLow() now finds the rule on SLOT_OIL and returns its active state.
    Cranking and masking need no special handling here: a masked sensor cannot fire a
    rule, which evaluateRules() now enforces.
    Plausibility gets its own channel rather than being discarded. isOilSensorFault()
    returns the descri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
    [ECU.cpp, ECU.h, MQTTHandler.cpp, SensorManager.cpp, SensorManager.h, WebHandler.cpp]
2026-09-21 Add settleMs, and stop VBAT_LOW tripping limp mode on every start
    settleMs is the post-start grace period the crank-masking plan called for: a
    per-descriptor window, timed from the CRANKING -> RUNNING transition and reset on
    a stall, during which the sensor is read and published as usual but neither
    validated nor allowed to drive a rule. SensorManager tracks _runningSinceMs
    across the transition, the subtraction is overflow-safe, and descriptors carry a
    settling flag alongside masked so the two reasons for "live but unvalidated" stay
    distinguishable in /state. Persisted as validate.settleMs, editable through the
    web API. Oil pressure defaults to 3000 ms, because pressure takes a second or tw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
    [Config.cpp, SensorDescriptor.h, SensorManager.cpp, SensorManager.h, WebHandler.cpp]
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2026-09-21 LampDriver gains BURST, and the buzzer plan says not to borrow the chime
    Audible annunciation for fault and critical, critical especially. Do NOT hijack
    the seatbelt chime: gem-module.md shows it is a GEM/CTM function driven by its
    own inputs - pin 10 key-in-ignition 158 BK/PK, the safety-belt switch, the
    door-ajar switches - with pin 12 driving the belt indicator out to the cluster.
    There is no "sound the chime" input, so making it chime means asserting one of
    those, and none is a private wire: the belt switch says the belt is unbuckled and
    is shared with restraint logic, key-in-ignition affects courtesy lighting and
    theft logic, door-ajar lights the interior lamps. Same shape as the oil la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
    [LampDriver.h]
2026-09-21 Buzzer on MCP23S17 #0 P4, driven from the fault tiers
    DEF_PIN_BUZZER 204, driven alongside the CEL in checkLimpMode(): critical gets
    3 x 150 ms every 10 s, full fault 2 x 150 ms every 60 s, pre-fault stays silent.
    begin() chirps once for 150 ms as a key-on self-test, because a buzzer that has
    failed silent is indistinguishable from one with nothing to say, and the lamps
    already prove out.
    It reads the fault MASKS rather than raw sensor values, so cranking and settleMs
    windows suppress it for free - the faults themselves are already masked there,
    which was the point of doing that work first.
    Worth recording why P4 needed checking: CLAUDE.md still describes an I2C MCP23017
    at 0x20 with injec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
    [BoardPins.h, ECU.cpp, ECU.h]
2026-09-21 Buzzer auto-silences after 5 minutes and re-arms on anything new
    An alarm that cannot be silenced gets disconnected, and then nothing annunciates
    again; one that silences permanently is no better than none. AlarmPolicy sounds
    for five minutes, goes quiet, and speaks up again the moment something new is
    wrong. The lamp never silences - only the noise does - and buzzerSilenced is
    published in /state so the UI can explain the quiet.
    "New" means a fault bit that has not been part of this episode, or an escalation
    from full fault to critical on the same bits. A bit that FLAPS in and out
    deliberately does not re-arm, because that is exactly the behaviour that makes
    real alarms unsilenceable in pr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
    [AlarmPolicy.h, ECU.cpp, ECU.h, WebHandler.cpp]
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2026-09-21 Oil sender plausibility: +/-5% of full scale, and it lights the lamp not limp
    configureOilPressure() now sets errorMin/errorMax from maxPsi, so the band scales
    with the transducer: +/-5% of full scale, which is +/-0.2 V either side of the
    sensor's own 0.5-4.5 V. On a 100 PSI unit that is -5 and 105 PSI, tripping below
    0.3 V or above 4.7 V. An open sender wire reads ~0 V and lands at -12.5 PSI, so
    it is caught immediately - where on V1.0 it looked exactly like no oil pressure.
    Switch mode leaves the limits NAN, since a switch cannot be implausible.
    Two supporting changes, because setting the limits alone would have been half a
    feature.
    The descriptor's faultBit and faultAction were persiste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
    [SensorManager.cpp]
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2026-09-21 SCP rig: lock-free frame ring so a card stall cannot eat the capture
    The piece that has to be right before any of the rest matters. Single-producer,
    single-consumer ring between the PIO capture side and the SD writer, neither
    blocking the other.
    Two decisions worth recording. Indices are free-running and masked only on
    access, so fullness is (head - tail) >= SLOTS: the classic ring bug is wrapping
    the indices themselves, which makes head == tail mean both empty and full. And
    overflow drops the NEWEST and counts it, because a silently dropped frame is
    worse than no capture - nothing in the file says the gap is there - so callers
    write dropped() into the capture and emit a gap marker.
    Tested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
    [FrameRing.h]
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2026-09-21 SCP rig: edge-capture PIO and a histogram, so the bit timings are measured
    The decoder needs J1850 PWM tp values in nanoseconds, and taking those from a
    half-remembered datasheet produces a decoder that fails like broken hardware -
    the most expensive way to be wrong here. So the first firmware knows nothing
    about the protocol: it times edges and reports what it saw, and the constants
    come from the bus that actually has to be decoded.
    edge_capture.pio pushes one word per edge, (count << 1) | level, with a two-cycle
    loop so 16 MHz gives 125 ns per count and a 24 us bit lands at ~192 counts. The
    level rides in the LSB deliberately: a stream of bare intervals is one lost FIFO
    word away from sil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
    [PulseHistogram.h]
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2026-09-22 L bracket: mark M2 and M3 on the part, because memory is what failed
    A standoff split when an M3 went into it. The part is M2 there - bore modelled
    2.30, finishing about 2.0 - while the pair in the upright is M3 clearance at 3.80
    modelled. One bracket, two thread sizes, and an M3's 3.0 mm major driven into a
    2.0 mm hole against a 1.35 mm boss wall acts as a wedge. Nothing about the print
    was wrong; the information was in a README and not on the object.
    So the object now carries it: "M2" debossed 0.6 mm into the short leg's top face
    between the hole columns, "M3" into the upright's inner face between the two
    bores. Verified in the STL - M2 floor at z 49.40 and M3 floor at x 27.60 - with
    bore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
    [bracket.stl, l_bracket.scad]
2026-09-22 L bracket: self-tapping mode - a pilot hole, which is the opposite of clearance
    Self-tapping screws want a hole SMALLER than the screw so there is material to
    form a thread from; a clearance hole is bigger than the screw by definition. A
    thread-former driven into a clearance hole has nothing to bite and everything to
    wedge, and splits a boss exactly as an oversized machine screw does. The hole
    looks right in both cases and only the number differs, which is why this is now a
    mode rather than a comment.
    top_mode picks it. "selftap" sets the bore from the SCREW's major diameter -
    pilot = selftap_ratio x major, default 0.80, which suits PETG and PLA, dropping
    to 0.75 in stiffer material and ris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
    [bracket.stl, l_bracket.scad]
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2026-09-22 SCP rig: read the console with DTR asserted, because cat cannot
    `cat /dev/ttyACM0` returns nothing from a healthy rig. The arduino-pico USB-CDC
    stack discards writes until the host raises DTR, and cat never raises it, so the
    firmware looks dead when it is running perfectly. `stty` is worse -- it can
    bounce DTR and reset the board part-way through a read.
    Both failure modes are indistinguishable from broken firmware by eye, and both
    cost real time on the first bring-up. So the fix is a script that asserts DTR,
    plus a README section saying why the obvious command is the wrong one.
    The script's no-data path says where to look: the rig reports every 5 s with no
    bus activity required, so silenc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
    [read-rig.py]
2026-09-22 SCP rig: correct the edge-timing bias the loopback found
    Loopback of a known 8 us / 16 us wave read 7.749 and 15.687 -- 3.1% and 2.0%
    short. Different percentages, so not a clock error; different absolute offsets,
    so not a constant one either. The cause is in the PIO: the counter cannot time
    the cycles spent detecting an edge and pushing the word, and the two service
    paths are NOT the same length.
    `jmp pin` only branches when the pin is high, so the falling-edge path spends an
    extra instruction inverting the sense (`jmp pin, still_high` / `jmp fell`) where
    the rising path branches straight to `rose`. One cycle, and it accounts for the
    entire discrepancy: 4 cycles lost from an interval that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
    [main.cpp]
2026-09-22 Wheel measured: OD 126.2, thickness 3.175 - and the base gate lifts
    Caliper on the Dorman wheel. OD is 126.2, not the 135 the photo grid gave, and
    that is 8.8 mm out - OUTSIDE the +/-7 the estimate was quoted with, so the grid
    read was wrong rather than merely imprecise. Thickness is 3.175, a clean 0.125",
    against the listing's .120"/3.05. Wrong again, same direction.
    The OD lands the rig on the wrong side of the slot_y bug, which is worth
    recording because it was nearly missed twice. At 126.2 the wheel dips 3.1 mm
    below the base top, so a slot is required - and the OLD test asked whether the
    wheel punched out the BOTTOM of the plate: 68 < 63.1 is false, so it would have
    cut no slot and bur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
    [base.stl, base_a.stl, base_b.stl, bearing_block.stl, cam_gear.stl, cam_target.stl, crank_gear.stl, fit_gauge.stl]
2026-09-22 Retract the base gate: 3.175 is the centre, and the teeth are bent
    Granted the base gate this morning on a measured 3.175 thickness. Wrong feature.
    That reading is at the CENTRE of the wheel, and the base slot does not pass the
    centre - it passes the teeth. The teeth are bent, so the rim is thicker than the
    0.125" sheet they are formed from.
    ONE VARIABLE WAS DOING TWO JOBS:
    wheel_thk -> spigot length (how far the hub reaches through the bore)
    -> base slot width (what the tooth ring has to pass through)
    Those are different features that differ routinely on a stamped reluctor, and
    nothing in the model said so, so a measurement of one was spent silently on the
    other. Spli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
    [base.stl, base_a.stl, base_b.stl, bearing_block.stl, cam_gear.stl, cam_target.stl, crank_gear.stl, fit_gauge.stl]
2026-09-22 Rim envelope 3.97 measured - base gate lifts, and the offset stays bounded
    Caliper at the outer edge: 3.97 mm, against 3.175 at the centre. Both are clean
    imperial - 1/8" sheet, 5/32" envelope - so the bent teeth add exactly 1/32" and
    that is a formed lip rather than a measurement artifact.
    wheel_thk_rim is now a caliper reading AT THE TEETH, which is what the base slot
    actually has to pass, so the gate lifts properly this time. Slot 49.07 x 9.97 mm.
    The axial offset is BOUNDED rather than measured, and deliberately so. The bend
    contributes only 0.794 mm, so even with every tooth bent the same way the
    envelope centre cannot sit more than 0.397 mm off the disc plane. Both consumers
    swallow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
    [base.stl, base_a.stl, base_b.stl, bearing_block.stl, cam_gear.stl, cam_target.stl, crank_gear.stl, fit_gauge.stl]
2026-09-22 Bore and keyway measured - every gate is down, whole rig prints
    Caliper: bore 31.75 (1.25"), keyway 9.525 wide (0.375") x 3.175 deep (0.125").
    Clean imperial throughout, like the OD and both thicknesses before it.
    These split the verdict on the photo ratios, and the split is the point.
    wheel_bore 0.253 predicted 31.93 vs 31.75 measured 0.18 mm - vindicated
    key_d 0.19 predicted 3.03 vs 3.175 measured 0.15 mm - fine
    key_w 0.15 predicted 4.79 vs 9.525 measured TWO TO ONE
    The photo was almost certainly read across half the keyway. And a half-width key
    is the worst shape an error can take here, because it does not announce itself:
    it still enters the slot, still cl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
    [base.stl, base_a.stl, base_b.stl, bearing_block.stl, cam_gear.stl, cam_target.stl, crank_gear.stl, fit_gauge.stl]
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2026-09-22 Hole jig: round pin, because the hole is round - so it becomes a ladder
    Overruled on the obround pin, correctly: the hole is round and a gauge for a
    round hole should be round. Reverted to a plain 6.10.
    That trade is real and is recorded rather than glossed. A round 6.10 pin in a
    6.35 hole has 0.12 mm of radial slop, which is +/-0.24 deg of angle. The angle
    is known to about +/-3. So one jig at nominal has roughly one chance in twelve
    of seating on a flawless wheel - the looseness in the obround version was what
    tolerated that uncertainty, and taking it out has to put something in its place.
    The ladder is that something, and it is strictly better. jig_ladder.sh renders
    one jig per degree a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
    [base.stl, base_a.stl, base_b.stl, bearing_block.stl, cam_gear.stl, cam_target.stl, fit_gauge.stl, hole_jig.stl]
2026-09-22 Fan controller: DHT22 reading, and every failure ends with air moving
    ESP32-D0WD-V3 on the bench reading 27.6 C / 53 %RH through a DHT22, switching
    the 40 mm enclosure fan through the low-side FET.
    FAIL-SAFE IS THE DESIGN, not a feature of it. This box's airflow depends
    entirely on this fan and it holds a warm supply and a mains connection, so "off"
    is the expensive way to be wrong. The gate carries a pull-up so a floating pin
    runs the fan; setup() drives it on before serial and before the sensor; a crash
    floats the pin through reset; and repeated sensor failures force it on rather
    than holding the last state. Boot also exercises the fan for 3 s, because a
    controller that has never proven t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
    [DHT22.h, main.cpp]
2026-09-22 Driver board: fit an SS8050, and the pull-up moves off the board
    The board is named for a part that should not go in it.
    THE 2N7002 IS WRONG FOR A 3.3 V GATE, and its own datasheet says so by
    omission: it characterises Rds(on) at Vgs = 10 V and 5.0 V and nothing below
    5 V. Vgs(th) is 1.0/1.6/2.0, so at 3.3 V a worst-case part has 1.3 V of
    overdrive and sits on the knee of its Rds(on)-vs-Vgs curve, which goes vertical
    just under 3 V. The manufacturer will not put a number there.
    Worse is the current rating, which is not the headline number: Id is 115 mA at
    25 C but 75 mA at Tc = 100 C, against a fan drawing ~100 mA. The derating and
    the demand are coupled the wrong way round - the transisto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
    [2N7002 Driver BOM.csv]
2026-09-22 Fan bench mode: read the pad back, not the output register
    First bring-up gave a fan that did nothing and a meter reading 0 V at the pin.
    That reading is ambiguous in the worst way - it looks identical whether the
    firmware never commanded the pin or commanded it and lost.
    FAN_TEST resolves it without a meter. It drives the output directly, ignoring
    the sensor, and reads the PAD back via GPIO_MODE_INPUT_OUTPUT rather than the
    output register, so the log says what the pin IS instead of what was asked for:
    GPIO4 driven HIGH pad reads LOW *** DISAGREES - pin is loaded or shorted ***
    One line, and the search space halves. It cannot be fooled by probe timing
    either, which the plain toggl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
    [main.cpp]
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2026-09-22 Keyway is 3/16, not 3/8 - and the lesson drawn from that was wrong too
    key_w was recorded as 9.525 (3/8"). It is 4.7625 (3/16"). Every printed jig is
    scrap: the plug's key came out 9.275 wide trying to enter a 4.7625 keyway, 195%
    oversize, so nothing could seat whatever the angle was. That is why the
    templates did not fit, and it is not the angle.
    THE RETRACTION MATTERS MORE THAN THE NUMBER. The bad reading made the photo
    ratio look wrong by two to one, and a lesson was committed on the strength of
    it: "a ratio being right about one feature says nothing about the next." That
    was drawn from a misread, and it argued for distrusting the one source that had
    by then been right three times out of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
    [base.stl, base_a.stl, base_b.stl, bearing_block.stl, cam_gear.stl, cam_target.stl, crank_gear.stl, fit_gauge.stl]
2026-09-22 Aux hole is at 93 deg - measured, not estimated
    The 93 rung of the jig ladder seats; 92 and 94 do not. A round 6.10 pin in a
    6.35 hole only enters within +/-0.24 deg, so seating IS the measurement - there
    is nothing to read off a scale and nothing to judge by eye.
    That tolerance was the objection to a round pin, and the ladder turned it into
    the feature. An obround pin would have seated across +/-3.3 deg and reported
    only that the hole was roughly where expected.
    Four values to get here, which is the case for the ladder rather than for any
    one of them:
    ~95 by eye
    ~85 revised, the wheel had been held upside down
    92-98 pixels off the photo
    93 MEASURED, +/-0.24
    The eye estima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
    [base.stl, base_a.stl, base_b.stl, bearing_block.stl, cam_gear.stl, cam_target.stl, crank_gear.stl, fit_gauge.stl]
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2026-09-23 Setpoint pot: compare it against the sensor, do not convert it
    Was about to map the pot into NTC counts through constants. There is nothing to
    map. The pot is another divider on the same ADC against the same reference, so
    the two readings are compared directly and the fan trips where they cross:
    ntc >= pot -> on
    ntc <= pot - HYST -> off
    No conversion, no calibration, no LUT anywhere in the control path. The LUT now
    exists only to make the display legible, which is what it was for.
    It is also supply-immune in a way the mapped version would not have been. BOTH
    dividers are ratiometric off VCC, so a sagging rail moves the sensor and the
    setpoint together and the crossing d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
    [BOM.csv]
2026-09-23 Pot is a rheostat, and that is the better circuit
    Measured on the bench: 3.73 V at 0 ohms, 2.72 V at 10k. Those are exactly a
    rheostat in the top leg - wiper tied to one end - not the 3-terminal divider
    this was written for. 556..763 counts, about 29..51 C.
    THE RHEOSTAT IS BETTER, and not by a little. If the wiper contact fails, the
    track is still intact, so the resistance goes to FULL scale and the node lands
    at 556 - the lowest setpoint, fan earliest. It degrades toward cooling by
    construction, with nothing to detect and no firmware involved. The 3-terminal
    version leaves the node floating and the reading is anyone's guess, which is why
    it needed a detection window to be safe at all.
    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
    [BOM.csv]
2026-09-23 RK09K11300DR: 10k linear as assumed, but +/-20% moves the fault window
    Datasheet confirms the part: ALPS RK09K, 9 mm vertical, 10k, taper 1B linear,
    280 deg, 3 x 1 mm pins on 10.6 x 7, 5,000 cycles, -10 to +70 C. All of that
    suits a set-and-forget trim in a box running near 50 C.
    THE TOLERANCE IS +/-20% AND IT IS ASYMMETRIC HERE. Only the bottom of the span
    moves - 26.4 C on a +20% part against 31.9 C on a -20% one - because at 0 ohm
    the pot contributes nothing to the divider, so the 51.4 C top end is
    tolerance-free.
    For setting it that is irrelevant, and deliberately so: the knob is turned while
    watching the display, not read off a dial. That is the dividend from putting the
    setpoint thro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
    [BOM.csv]
2026-09-23 Sync the fan controller to the board as fabricated
    Schematic, gerbers and BOM added. 54.86 x 16.13 mm, 3 x M2. Docs now describe
    the board that exists rather than the one that was sketched.
    ONE NET IS WRONG AND IT IS THE FAIL-SAFE. R2 10k runs from the gate to GND, so
    a floating PA7 - reset, boot, watchdog trip - holds the gate low and STOPS the
    fan. Backwards. The box's airflow depends entirely on this fan and it holds a
    warm supply and a mains connection, so a floating pin has to RUN it. R2's lower
    end goes to +5V. One net in EasyEDA; on a made board, lift that end to the +5V
    pour. Flagged in the README, in the schematic block, and on the BOM line, since
    it is the kind of thing that gets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
    [BOM.csv, FanTempController-BOM.csv]
2026-09-23 V1.1: R2 is a pull-up, and the schematic carries the reason
    R2 now runs gate to +5V. A floating PA7 - reset, boot, watchdog trip - pulls the
    gate high and runs the fan, which is the behaviour the whole fail-safe chain
    depends on and the opposite of what V1.0 did.
    The schematic annotates it in place: "Pull up not pull down - fan runs if
    something wrong". That note matters more than the change. A gate resistor is
    normally a pulldown, so the correct version is the one that looks like a
    mistake, and without the reason written beside the part this gets tidied back
    at the next revision by someone being helpful. V1.0 would also have passed any
    review that only asked whether a 10k gate resistor was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
    [BOM.csv]
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2026-09-23 Braces span over their own bolts - you could not fit a washer
    The gussets sat on top of the holes that hold the parts down. On the bearing
    block the gusset's outer face lands exactly on the bolt centreline; on the motor
    mount the bolt is mid-gusset. An M4 washer is 9 mm across and the brace was
    straight through the middle of where it has to sit, on both parts.
    Moving the brace only fixes one of them - on the motor mount there is nowhere to
    move it to - so the brace spans over the bolt instead.
    THE OPENING IS PEAKED, NOT ROUND, and that is not decoration. These print with
    the foot on the bed, so a flat-topped hole would bridge its full width in the
    middle of a structural brace. An apex is s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
    [base.stl, base_a.stl, base_b.stl, bearing_block.stl, cam_gear.stl, cam_target.stl, clamp_plate.stl, crank_gear.stl]
2026-09-23 Move the braces off the bolts instead of letting the relief eat them
    The bolt reliefs went through the gussets, which is the thing they were supposed
    to span over. Both parts, and worse than it looked.
    motor mount bolt is MID-gusset in y, so the relief left two 1.5 mm slivers
    bearing block relief ate y -12..-5.5, the TALL end of the triangle - the half
    that carries the load. 7.5 mm of 14 survived, all of it the tip.
    Different fixes, because the geometry differs:
    MOTOR MOUNT moves inboard in X, from 25.15..29.15 to 19.65..23.65, keeping the
    full 14 mm base and full height. Trimming y was not available - the bolt sits in
    the middle of it. It now stands on the wall's ba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
    [base.stl, base_a.stl, base_b.stl, bearing_block.stl, cam_gear.stl, cam_target.stl, clamp_plate.stl, crank_gear.stl]
2026-09-23 Front wall: banana jacks, and the "gland" was always a button
    The 12.5 hole was drawn for a PG7 gland carrying the 36 V output. In the build
    it took the latching relay's power button, and the 36 V now leaves on banana
    jacks - so the model and the README both described a part that does not exist.
    Corrected, and a second identical button added to wake the fan controller's
    display.
    THE TWO BUTTONS STACK VERTICALLY. Side by side they cost 40 mm of a wall with
    145 to share between them and six jacks; stacked they cost 20. That 20 mm is
    exactly what lets the jack pairs sit far enough apart to read as pairs.
    19.05 (0.75") WITHIN A PAIR IS A STANDARD, not a preference - it is what lets a
    dual bana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
    [lid.stl, psu_enclosure.scad, tub.stl]
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2026-09-23 One fan, and it is the thick one - the exhaust decides
    A single 40x40x20 rather than two 40x40x10. The grid settles it: the 20 mm fan
    uses the same 38 mm bore, so the exhaust stays at 2.19x and nothing in the
    enclosure changes. Two fans take it to 1.10x, where the exhaust is as
    restrictive as the intake - so the second fan does not buy double airflow, it
    buys perhaps a third more, for two fans of noise and a second hole in the tub.
    The model never knew the fan's thickness. It provides a pad, a bore and four
    screw pilots, and a 20 mm fan mounts on the same pad. The only change on the
    bench is screw length: M3 x 25 minimum against 15.
    ONE CHANGE, FROM THIS PROJECT'S OWN RULE. fan_pad_t 5 ->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
    [lid.stl, psu_enclosure.scad, tub.stl]
2026-09-23 Fan holes were pilots, not clearance - and add nut traps
    fan_screw was 2.6, a pilot for an M3 self-tapper to cut its own thread in. The
    build used M3 through-bolts, which went through it but tightly - because the
    hole was never meant to pass a fastener, only to be threaded by one. Now 3.6:
    M3 clearance, opened past the nominal 3.4 because an FDM hole finishes undersize
    and a fan bolt should drop in rather than be driven.
    Nothing structural needed changing. fan_cuts already drilled the full
    fan_pad_t + wall, so the bolt reaches the bay and takes a nut with 10 mm of
    plenum behind it.
    fan_pad_t reverted 6 -> 5. It went to 6 an hour ago to give M3 self-tappers the
    2x major engagement this proj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
    [lid.stl, psu_enclosure.scad, tub.stl]
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2026-09-24 The bearing bore was 90 degrees off the shaft
    Caught during assembly. The base says the shaft is on X in three independent
    ways - blocks at x -30 and +30 both at y 0, a wheel slot narrow in x and long in
    y, and the wheel disc placed with rotate([0,90,0]) - and the bearing block bored
    itself on Y.
    The block was not internally wrong. blk_t is sized to the bearing's WIDTH and
    blk_w to its DIAMETER, so its body is correct for a Y bore; what never matched
    was its orientation on the base. Nothing in the model compared the two, so both
    halves rendered cleanly and looked right for as long as nobody tried to put a
    shaft through them.
    Fixed by rotating the part rather than rebuilding it, which keeps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
    [base.stl, base_a.stl, base_b.stl, bearing_block.stl, bore_probe.scad, cam_gear.stl, cam_target.stl, clamp_plate.stl]
2026-09-24 The motor mount had the same 90 degree error, and an audit found no others
    Asked whether the bore fix reached the motor mount. It did. The gears are placed
    rotate([0,-90,0]) so their axes are on X, spur gears will not mesh unless the
    motor is parallel to them, and the motor mount bored on Y exactly like the
    bearing block. It would have driven at 90 degrees to the gears it turns.
    It is worse than parallel, in fact: the motor couples DIRECTLY to the crank
    shaft - x_motor -95 against gears at x_gear 70 - so its bore has to be coaxial,
    not merely parallel.
    Same fix and the same consequence: printed mounts are fine because the part did
    not change, only its orientation, and the base's two motor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
    [base.stl, base_a.stl, base_b.stl, bearing_block.stl, bore_probe.scad, cam_gear.stl, cam_target.stl, clamp_plate.stl]
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2026-09-24 Sensor bore is sized by the lip, not the barrel
    There is a step just ahead of the o-ring, wider than the 14.3 barrel, and it
    will not pass a bore cut to the barrel. Measured on the part: +1.5 mm on radius,
    so the bore goes 14.55 -> 17.55.
    OPENING IT STOPS THE BORE LOCATING THE SENSOR, which is worth checking rather
    than assuming, and it turns out not to matter. The air gap is set along Y by the
    mount's slotted feet - that is what the slots are for - and the bore only fixes
    X and Z. Both are second order:
    1.5 mm of Z sag moves the sensor 0.011 mm further from the wheel centre
    (slop^2 / 2y at y_ck = 106)
    1.5 mm of X shift still leaves a 14.3 mm pole fully covering a 3.97 mm tooth,
    wi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
    [base.stl, base_a.stl, base_b.stl, bearing_block.3mf, bearing_block.stl, cam_gear.stl, cam_target.stl, clamp_plate.stl]
2026-09-24 The o-ring centres the sensor - so the bore has a ceiling too
    Corrects the reasoning in the previous commit, not the number. I argued the
    opened bore was harmless because the slop is second order, and concluded "the
    bore was never carrying the alignment it appeared to". That is wrong: the
    o-ring is compressed against the bore wall and holds the sensor concentric, so
    the bore does carry alignment - through the o-ring rather than the barrel.
    Which makes it a FIT rather than a clearance hole, and gives it two bounds:
    floor 17.55 - below it the lip will not pass
    ceiling the o-ring's free OD - above it the o-ring loses contact
    A radial o-ring wants 15-25% squeeze on its cord, so a 2-3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
    [vr_rig.scad]
2026-09-24 Lip and bore are two numbers: 16.5 measured, 17.55 chosen
    The lip is +1.1 on radius, not +1.5. The bore went to +1.5 deliberately, and the
    0.4 difference is not slop - the o-ring stands PROUD of the lip, so it, not the
    lip, is the widest thing that has to enter. Cut the bore to the lip and the
    o-ring shears its way past on every insertion.
    barrel 14.30
    lip 16.50 +1.1 r MEASURED - the thing that would not pass
    bore 17.55 +1.5 r CHOSEN - 0.4 more so the o-ring enters
    Both are now named. The previous commit folded them into one sensor_lip = 16.5
    that was really a bore, which loses the measurement and makes the 0.4 look like
    a clearance allowance someone could reasonab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
    [base.stl, base_a.stl, base_b.stl, bearing_block.stl, cam_gear.stl, cam_target.stl, clamp_plate.stl, crank_gear.stl]
2026-09-24 Record why the sensor bore is straight through, not counterbored
    A counterbore would keep a tight barrel fit deeper in the plate, and would be
    MANDATORY if the bore were what located the sensor - you cannot open a locating
    fit by 3 mm on diameter. But the sensor hangs on its mounting tang, bolted flat
    to the plate, so the bore never carried that job.
    Straight through is one feature instead of two, needs no guess at how deep the
    lip sits, and cannot be got wrong by a millimetre. Recorded because a 17.55 bore
    on a 14.3 barrel looks like an oversight to anyone who has not read why, and the
    obvious "fix" is exactly the counterbore that was already turned down.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
    [vr_rig.scad]
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2026-09-25 M2 mounting holes are 2.00 mm on BOTH boards - an M2 will not pass
    Found reviewing the SCP gerbers, checked against the fan controller, and it is
    systematic: EasyEDA's stock Screw-Hole-M2 footprint drills 2.00 mm.
    M2 major diameter 1.98 mm
    2.00 drill, plated finishes ~1.90
    ISO 273 clearance 2.2 close / 2.4 normal
    Read 2.00 as the finished size instead and it is 0.02 mm of clearance on a 1.98
    screw, which is an interference fit and not a clearance hole either way.
    FLAGGED URGENTLY ON THE FAN CONTROLLER because that one is about to be ordered
    five up. Fifteen holes drilled by hand afterwards, in a 54 mm board that is
    awkward to clamp, against one parameter changed before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
    [Drill_PTH_Through.DRL, Drill_PTH_Through_Via.DRL, Gerber_BoardOutlineLayer.GKO, Gerber_BottomLayer.GBL, Gerber_BottomSilkscreenLayer.GBO, Gerber_BottomSolderMaskLayer.GBS, Gerber_TopLayer.GTL, Gerber_TopPasteMaskLayer.GTP]
2026-09-25 SCP mounting holes now 2.2 - verified the re-export changed nothing else
    2.000 -> 2.200 on the four corner holes. Drill table compared line by line
    against the previous export: every other tool and count is identical, and the
    outline is still 90.55 x 37.34. A single-parameter change that did what it was
    supposed to and nothing more, which is worth confirming rather than assuming
    after a re-export.
    SCP gerber is clean. The fan controller still carries 2.00 from the same stock
    footprint and is the board about to be ordered five up - noted in both places,
    and the library part is the better place to fix it than each board.
    [Drill_PTH_Through.DRL, Drill_PTH_Through_Via.DRL, Gerber_BoardOutlineLayer.GKO, Gerber_BottomLayer.GBL, Gerber_BottomSilkscreenLayer.GBO, Gerber_BottomSolderMaskLayer.GBS, Gerber_TopLayer.GTL, Gerber_TopPasteMaskLayer.GTP]
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2026-09-26 Power diag running: INA238 validated at 22.909 V against a 22.92 setting
    Three things had to be fixed before it said anything true.
    THE NUCLEO WAS POWERED FROM THE BOARD UNDER TEST. Target voltage read 0.0016 V
    over SWD - not a serial problem, no power at all. An instrument fed from the
    thing it is measuring dies at exactly the moment it is meant to record: the
    LTC4364 faults, VIN collapses, the 3.3 V rail goes, and the M7 loses its supply
    mid-capture. Now on its own USB with only GND shared.
    WHICH ALSO FIXED THE SERIAL. `Serial` is USART3 on PD8/PD9, which belongs to the
    ON-BOARD ST-Link - and only the external STLINK-V3 was enumerated. Plugging the
    Nucleo's own USB brought up ttyACM1 and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
    [main.cpp]
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2026-09-26 Board survived a dead short; two diagnostic bugs fixed on the way
    An accidental short on VIN took minutes to recover, which is the LTC4364-2
    behaving correctly - current limit engages, the timer runs, it shuts down and
    cools down rather than retrying hard into a persistent fault. The board came
    back stable at 24.003-24.009 V drawing 12-19 mA with all three status pins high
    and no transitions. Undamaged, and the last untested protection path exercised
    by accident.
    TWO DIAGNOSTIC BUGS, both of which made a healthy board look broken.
    Status pins were read with plain INPUT. All three pull-ups live on the BOARD's
    3.3 V rail, so an unpowered board leaves them floating and a high-impedance
    input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
    [main.cpp]
2026-09-26 Revert the pulldown - it cost a measurement, and bound the edge drain
    The short was not captured, and the instrument was at fault rather than the
    board. Two mistakes compounding, both mine.
    THE PULLDOWN WAS WRONG. All three status lines already carry a 10k pull-up on
    the board, so the STM32's ~40k internal pulldown turned a firmly driven line
    into an 8k divider sitting at 2.6 V - noise-susceptible on a flying lead. It
    produced 10,508 spurious edges in four minutes. Reverting to plain INPUT: zero
    edges in twelve seconds.
    Do not fight a pull-up with a weaker pull-down. The problem it was meant to fix
    - a dead board reading 111 because those pull-ups sit on ITS rail - is now
    solved by decidin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
    [main.cpp]
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2026-09-27 v3 netlist review: R5 must be 10k not 100k, and the U8 note was backwards
    Checked FlyingProbeTesting.json from the v3 gerbers. Most of it confirms.
    Confirmed: the Fault shifter is gone, with FLT running U1_13 through R5 to +3.3V
    and out on U7_13 with no BSS123; ENOUT keeps Q4 with the correct gate/source/drain
    topology; U7 is 2x7 with grounds on 2, 8 and 14, so both +3.3V pins have a
    neighbour at 2, pin 8 lands in the I2C and status group and 14 anchors the FLT end;
    PGND is still just C1_1, CN1_2 and D1_2 against 128 GND nodes, so the fault plane
    survived; five header grounds total with U6 doubling GND, VIN and +5V; and C29 is
    the third 560 uF.
    One change needed. R5, the FLT# pull-up, came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
    [Triton_ECU_BOM_POWER_Power_V_3.csv]
2026-09-27 v3 gerber: standoff hole and pad both under the Sinhoo minimum
    R5 is fixed to 10k with R4 and R7 correctly left at 100k. Drill counts reconcile
    exactly - 20 x 1.0 mm for U6's six plus U7's fourteen pins, and 2 x 1.7 mm at CN1
    - and the board is about 76 x 45 mm.
    The four 4.2 mm holes sit exactly at U2 to U5, delta 0.000 mm, so they are the
    standoffs' locating bosses rather than separate mounting holes. Both dimensions
    are under spec: hole 4.20 against a 4.22 minimum with +0.08 tolerance, and pad
    6.00 against a 6.2 minimum. Small individually, but this joint is at once the
    primary ground return, the mechanical mount, and uninspectable after assembly.
    The hole matters more. If it lands small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
    [Triton_ECU_BOM_POWER_Power_V_3.csv]
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2026-09-27 VR rig: cam gear gets a real pinch lock, the rest go through-bolt into the shaft
    Every clamp bolt sat at y = 0, on the bore axis, so it passed through the middle
    of the shaft. The slit beside it did nothing, and the only way the parts could
    work was a cross-drilled shaft - which fixes cam phase at drill time, the one
    dimension this rig exists to reproduce. The comments claimed "split-clamp boss"
    while the geometry was through-bolt.
    Cam gear now pinches properly. The bolt is sized from the WEB rather than the
    centre distance, because the bolt's edge is what the material has to survive - a
    first pass offset the centre by 3.4 mm and left only 1.2 mm of web, which the
    echo caught before it reac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
    [vr_rig.scad]
2026-09-27 Export the updated STLs, and add hub to render.sh which never listed it
    The pinch-lock change was only in the .scad - no STL had been regenerated, so
    stl/cam_gear.stl still carried the old on-axis bolt. Re-ran render.sh.
    render.sh was also missing "hub" from its part list, so stl/hub.stl had never
    existed despite hub() being dispatchable and the echo gate declaring it clear to
    print. Added, and it exports at 43 kB.
    Verified the geometry on the exported meshes rather than trusting the source,
    using the two gears as each other's control:
    crank_gear 0 slit-wall vertices at x=+/-0.9 slit REMOVED
    boss-region y at x~0: -13.5, -6.12, 6.12, 13.5 (continuous ring)
    cam_gear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
    [base.stl, base_a.stl, base_b.stl, bearing_block.stl, cam_gear.stl, cam_target.stl, clamp_plate.stl, crank_gear.stl]
2026-09-27 cam_target: rotate the through-bolt to Y - on X it cut the counterweight pocket
    Not merely crowded, intersected. Everything else on this part lives on the X axis
    - the M8 trigger at +X, the counterweight boss and pocket at -X, and the
    counterweight grub screw - and the through-bolt overlapped the pocket in all
    three axes at once:
    counterweight pocket x -26.2..-12.8 y -6.7..6.7 z 2..24
    bolt on X x -24.9.. 24.9 y -2.2..2.2 z 8.8..13.2
    so drilling it broke into the lead. On Y at x = 0 the pocket is not present at all,
    starting at x -12.8, and the trigger bolt clears in Z, -1.7..6.7 against 8.8..13.2.
    It also puts the driver on a free face instead of behind the trigger b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
    [base.stl, base_a.stl, base_b.stl, bearing_block.stl, cam_gear.stl, cam_target.stl, clamp_plate.stl, crank_gear.stl]
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2026-09-29 Kick the hardware watchdog from loop(), with a bounded guard for SD init
    TPS3823A-33 WDI on PF13 (D7). Toggled every 10 ms from loop() - 90x margin
    on the 0.9 s worst-case window - and first thing in setup(), before the
    console's 200 ms delay, because the window opens when NRST is released.
    Moves into the engine task at M6.
    SdFat's card-init timeout is 2 s and cannot kick from inside, so with no
    card fitted the mount alone would reset-loop the board. Shortening the
    timeout was rejected: it is a library const, and the SD spec allows a card
    1 s to initialise. Instead a BlockingGuard(maxMs) has TIM14 kick every
    20 ms until its deadline and then stop, so a real hang in the guarded call
    is still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
    [Board.h, Watchdog.cpp, Watchdog.h, main.cpp]
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2026-10-01 fan-controller: comments still described the SS8050 build
    The board as built switches the fan with an AO3400A, gate pulled up by R2
    through R1. main.cpp and the README's fail-safe list still said R4 pulled
    an SS8050's base high; R4 is the NTC divider's bottom leg. Comments only -
    the firmware builds to the same 6153 bytes, so the flashed board is
    current.
    [main.cpp]
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2026-10-01 fan-controller: active-low status LED; run headless instead of hanging
    Two faults found bringing up the second v1 board.
    The status LED on both boards is wired +5V -> R -> LED -> PA6, so it is
    active-low, but the firmware drove it active-high: lit nearly all the
    time, with each "flash" a 10 ms dark blink. The firmware now sinks it,
    and the pin floats dark through reset.
    The board then sat with its fan on and the loop never running. With no
    OLED fitted, oled.begin() waits forever - the bus pull-ups live on the
    OLED module - and the watchdog was only armed at the end of setup(), so
    the hang was permanent. setup() now arms the watchdog straight after
    turning the fan on, checks SDA/SCL for a p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
    [main.cpp]
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2026-10-02 fan-controller v2: gerbers and BOM, reviewed and ready to order
    56.26 x 20.45 mm, 3 x M2 at 2.20 mm. Reviewed from the gerbers by
    tracing copper, not from the symbol: CN2 pad 1 -> Q1 drain (Load), pad 2
    -> H1 pin 2 (FAN+), pad 3 -> R8/R9, pad 4 -> Q2 drain - the pinout the
    first schematic draft had reversed is right on the board. Both
    fan-current paths were widened from 0.5 to 1.0 mm, ~2.5 A at a 10 C rise
    on 1 oz; the return is the ground pour.
    BOM matches the schematic part for part with LCSC numbers throughout.
    The interactive BOM HTML stays out of git, as v1's did.
    [FanTempController-BOM-V2.csv]
2026-10-02 fan-controller v2: ATtiny1616-MNR, serial status out, re-laid out
    MCU: ATtiny1616-MNR (VQFN-20, 3x3 mm) replaces the 1614 - cheaper and
    smaller, same die family; datasheet Table 5-1 gives every pin the same
    functions. Exposed pad to GND with four vias into the pour. Pin-number
    table v1 vs v2 in the README.
    Serial: the spare pins bought a port. PWM moves to PB5, TCA0 WO2's
    alternate pin (PORTMUX.CTRLC TCA02, valid in normal mode), handing USART0
    its default PB2 (TX) / PB3 (RX). Transmit-only firmware: a boot line with
    the fan-detection evidence, then one status line per pass in counts and
    degrees, 115200 on H3 pin 8. RX is wired to H3 pin 9 with its internal
    pull-up on and never read. R13/R1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
    [FanTempController-BOM-V2.csv]
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
