alpauna/TritonECU/docs/1999-Ford-F150-4wd-5.42v/36-1Wheel-Front.jpg

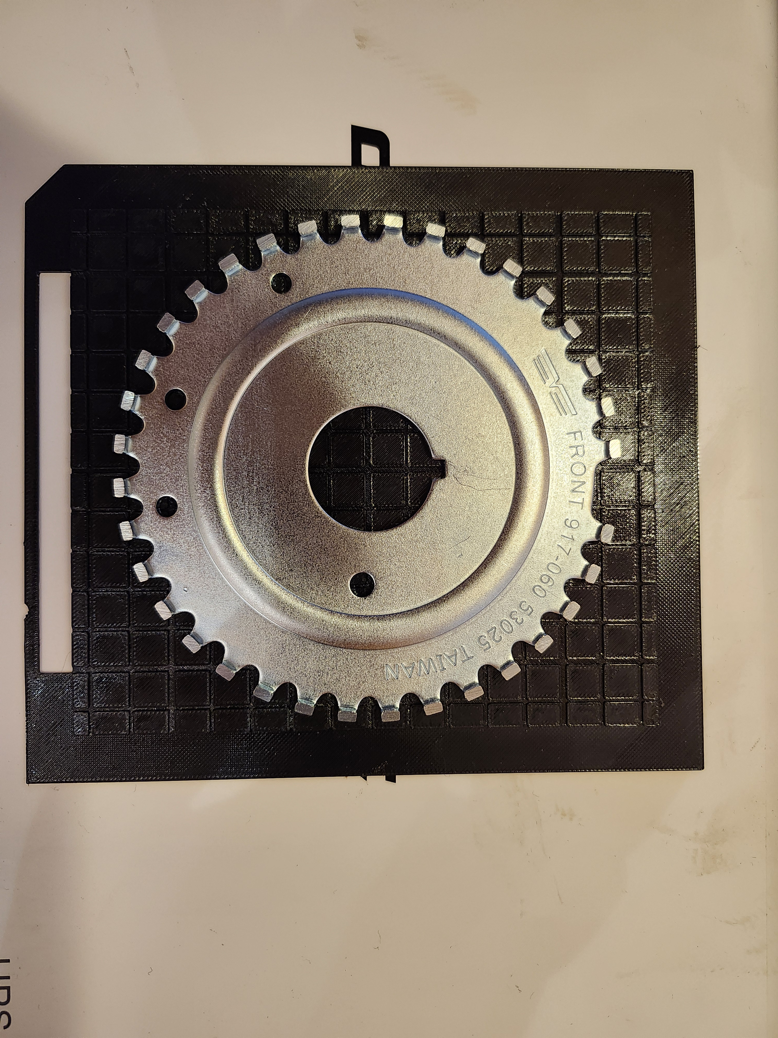
docs/1999-Ford-F150-4wd-5.42v/36-1Wheel-Front.jpg
